MSTKMAD/battery-pack/02.HARDWARE/V2-ROVER R-1/04.PRODUCCION/SETI-BATCH-5_OCT2024/Release note Batch 5 Oct2024.docx

CAMBIOS EN LOS PCBs

DCDC

Se añaden las resistencias R21 y R22 que son las resistencias en serie para las líneas de SCLK Y SWDIO que en esta versión tienen función de comunicación con la máquina

Se añade C11 de 100nF en paralelo con la salida para tener un poco de capacidad de filtrado en alta frecuencia. El condensador entra perfectamente, por eso se incluye (no había ningún problema que solucionar).

U2 (driver MOSFET P de salida) se cambia por uno que tiene la misma capacidad que el anterior pero que en el evento de UVLO da un “1” en vez de un “0”, de forma que ya no tendremos el problema de que la salida se quede conectada cuando la batería se apaga.

CONECTORES

Se añaden las líneas de ID y DAT en la parte inferior de la placa.

Estas líneas están conectadas a SWDIO y SCLK (test points de la parte superior).

Se hace un cleanup general de la placa para quitar planos innecesarios.

Se eliminan (no entran) los pads suplentes de la salida que no se usaban

CPU

Se crean las líneas de comunicación DAT e ID con la máquina que se unen a las de SWCLK y SWDIO.

Se modifica el valor de R11 de 8k2 a 11k para bajar el umbral del LOW VOLTAGE de 3.1v a 2.4v.

Esta modificación se ha estado haciendo a mano en todas las placas durante la producción anterior.

El comparador prácticamente no se dispara nunca, pero al menos no da problemas.

Su uso queda un poco en entredicho ahora mismo pero lo mantenemos pq pensamos que “no molesta” y puede ser de ayuda.
