MSTKMAD/battery-pack/01.Documentation/01.Diseño/Documentacion Software/B2/Diagramas/B2/Troubleshotting Rover R-1.pdf

Contacto del Cliente

"Al dar salida, salta un error" | "No da salida" | "No se Enciende" | La tapa no cierra bien

"al dar salida, la bateria se reinicia"

Problemas

Fallo Mecanico

Cambio de la tapa por posible golpe o fallo de fabrica

Posibles: Conectores, Fallo Software, Watchdog Si no hay fallo por Undervoltage

Posible fallo Hardware: Faja Cables de Connectores

Mete la pila, hay carga de capacidad, pero no se enciende pulsando botones | Al meter la pila no se
| enciende la pantalla

Pedir Video

Fallo de Supervisor

Quitar supervisor de la placa CPU

Fallo relacionado
con la salida

Corriente o Potencia

UnderVoltage

Hay corto

Revisar cortocirucito
en el conector RCA

Todo Bien

Fallo detectado

Revisar la placa de conectores:
- Lineas de Vout+ y Vout-, por posible corto en la faja
- Comprobar que al cerrar el conector RCA no hace corto con los pines del transistor.
- Revisar ambos lados de la faja por fallos en el montaje.

Revisar DCDC:
- Posible fallo en el conector entre placas en la linea de sensado de corriente.

Alguna de las placas presenta problemas en el testeo

Todo parece
estar bien

Revisar las placas por separado en el

tester de placas

Solucionar el Error presente

Todo Bien

Todo bien

Encendar la salida y comprobar con el multimetro el RCA y las

lineas de la placa de conectores

Revision intensa
sin guia

Watchdog

Reprogramación | No | Si

Tiene Muelle?

Connectores Antiguos Planos

Poner Muelle

Posible fallo en
el Pin del cobre o
fallo en la faja.

No llega

Si llega

Abrir placa conectores. Meter pila Medir con el multimetro si la tension llega a la

placa de conectores

Fallo en el Pin

Cambiar Barril

Sin continuidad

Buena continuidad

Comprobar continuidad en la Faja

Fallo en la Faja

Cambiar Faja

Fallo en los testeos | Sin fallos en los testeos

Revisar las placas por separado en el

tester de placas

Solucionar el Error presente | Revision intensa sin guia
