MSTKMAD/battery-pack/01.Documentation/03. Produccion/RECONOCIMIENTO DE PRODUCCIONES HARDWARE DE FORMA VISUAL.docx

# RECONOCIMIENTO DE PRODUCCIONES HARDWARE DE FORMA VISUAL

## DCDC

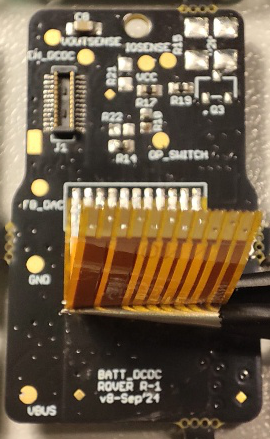
[picture p22: figure]
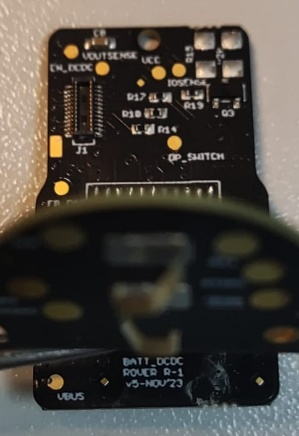
[picture p23: figure]
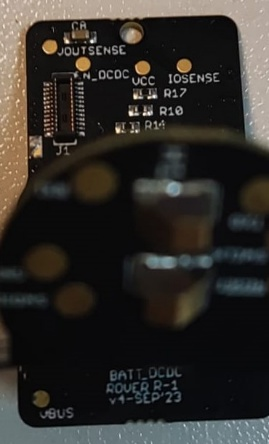
[picture p24: figure]
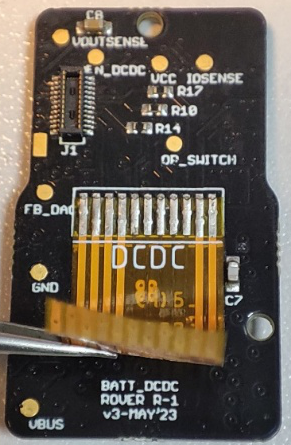
[picture p25: figure]
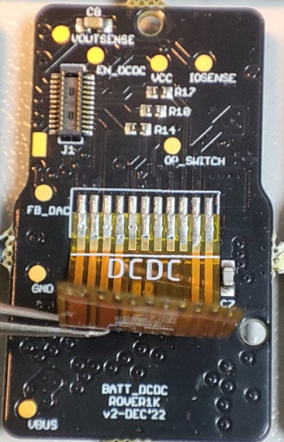
[picture p26: figure]

1. Comprobar serigrafia debajo de la faja:

PROD 1:

v2-DEC’22

PROD 2:

V3-MAY’23

PROD 3:

V4-SEP’23

PROD 4:

V5-NOV’23

PROD 5:

V8-Sep’24

## CPU

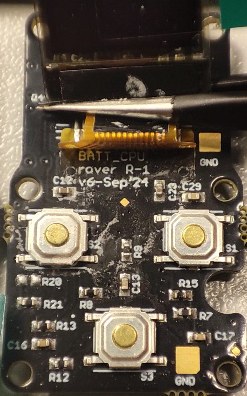
[picture p27: figure]
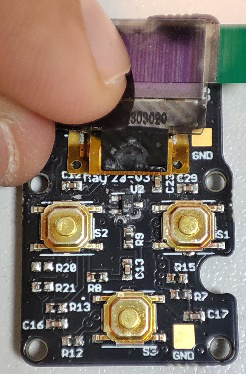
[picture p28: figure]
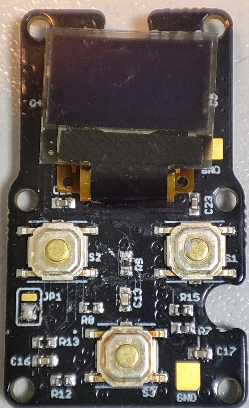
[picture p29: figure]

1. Mirar si tiene la serigrafia de v6-sep’24: a. Si tiene: Producción 5 V6-sep24 | 2. Mirar si tiene supervisor o no. a. Si tiene: Producción 2. May’23-v3 | 3. Si no tiene, Mirar si tiene SMD Superficial: a. Si tiene: Producción 1 Dec’22-v2

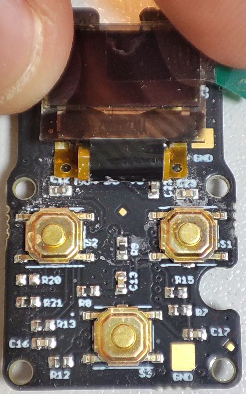
[picture p30: figure]
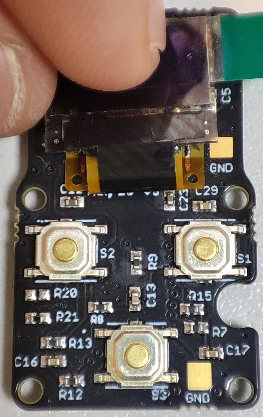
[picture p31: figure]

4. Si no tiene, mirar si tiene fiducidial rombo: Si tiene: Producción 4 Nov23-v5 | a. Si no tiene: Producción 3 May23-v3

# PRODUCCION 1

## DCDC

2º Serigrafia:

v2-DEC’22

1º Componente Q5:

3 patillas

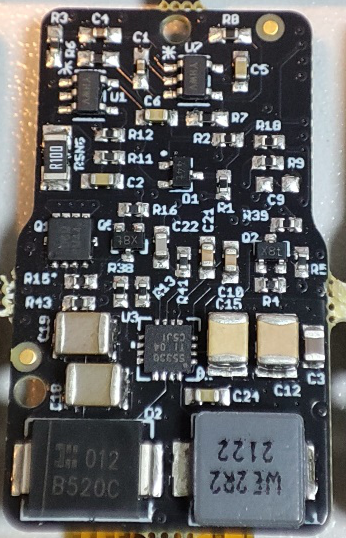
[picture p32: figure]
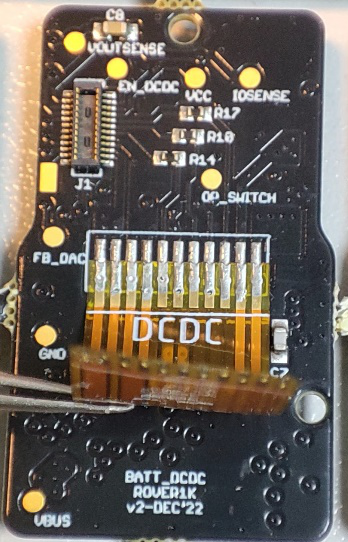
[picture p33: figure]

## CPU

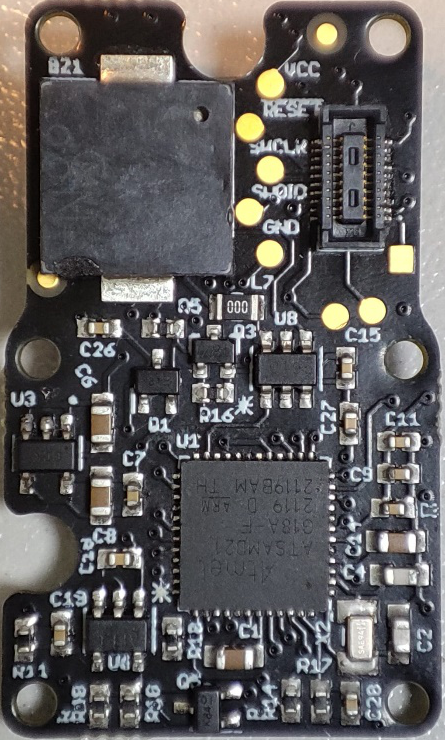
[picture p34: figure]
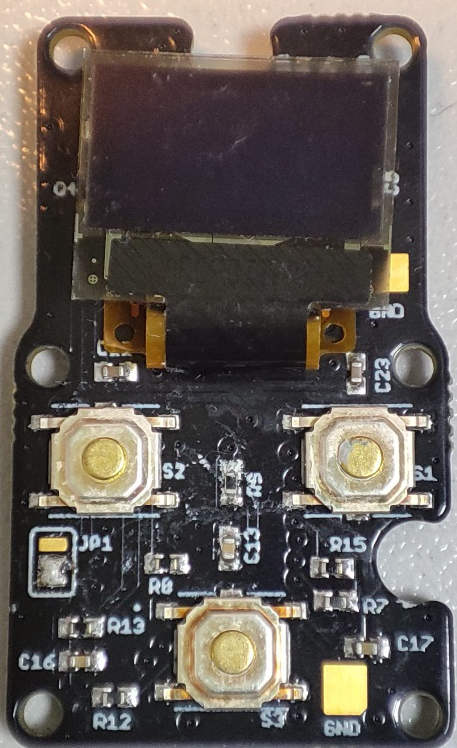
[picture p35: figure]

Ausencia de Jumper SMD

Q1 y Q3 vertical.

1º Jumpers SMD.

# PRODUCCION 2

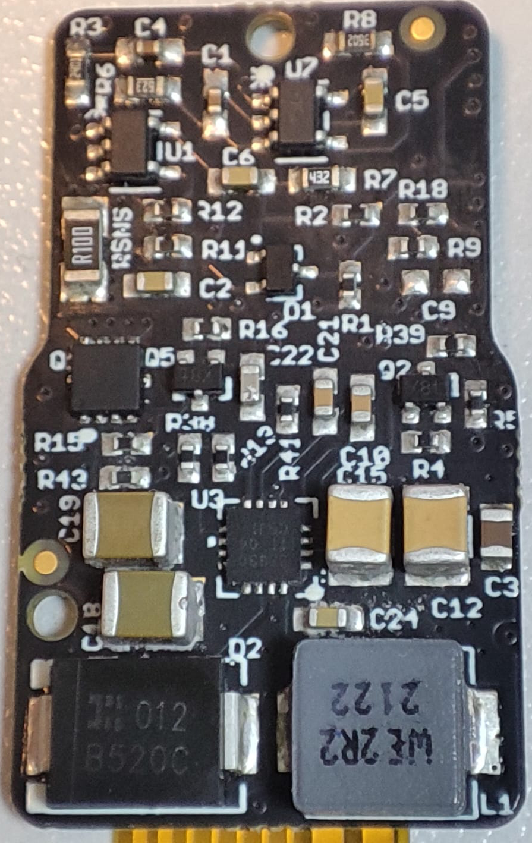
[picture p36: figure]
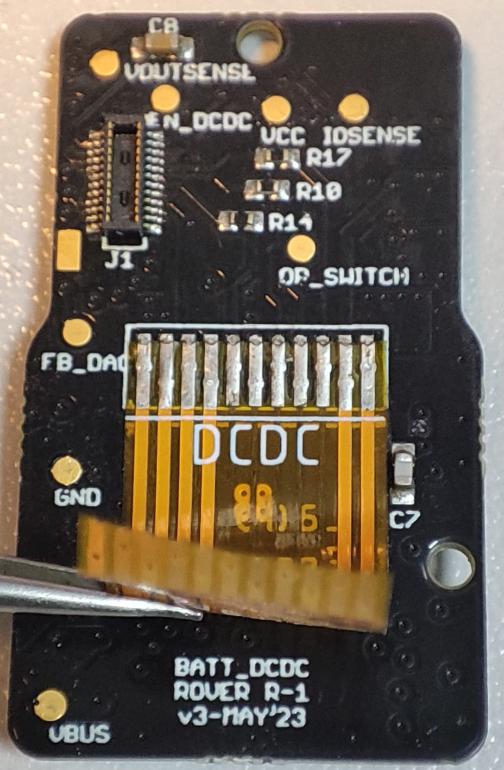
[picture p37: figure]

## DCDC

2º Serigrafia:

V3-MAY’23

1º Componente Q5:

3 patillas

## CPU

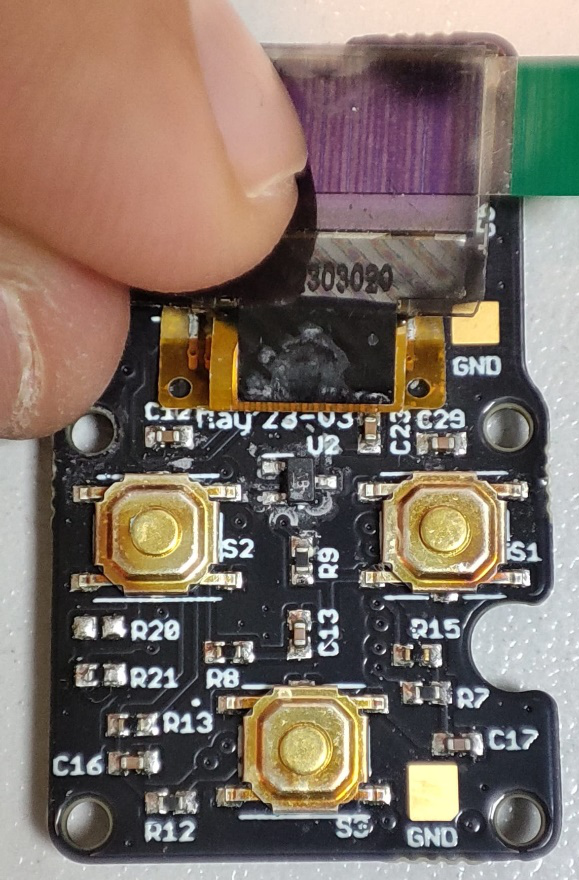
[picture p38: figure]
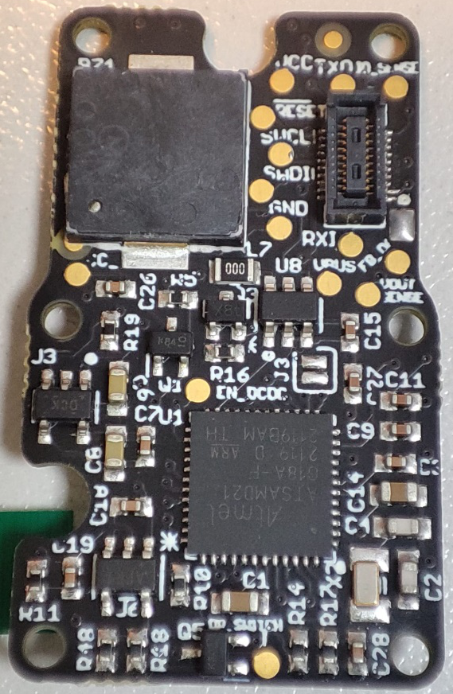
[picture p39: figure]

Supervisor

R20 y R21

Q1 y Q3 vertical.

JUMPER J3

# PRODUCCION 3

## DCDC

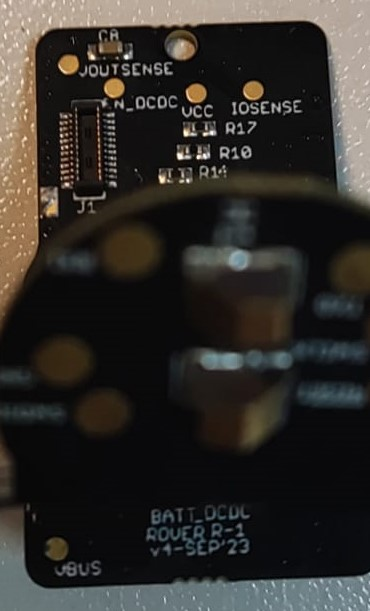
[picture p40: figure]
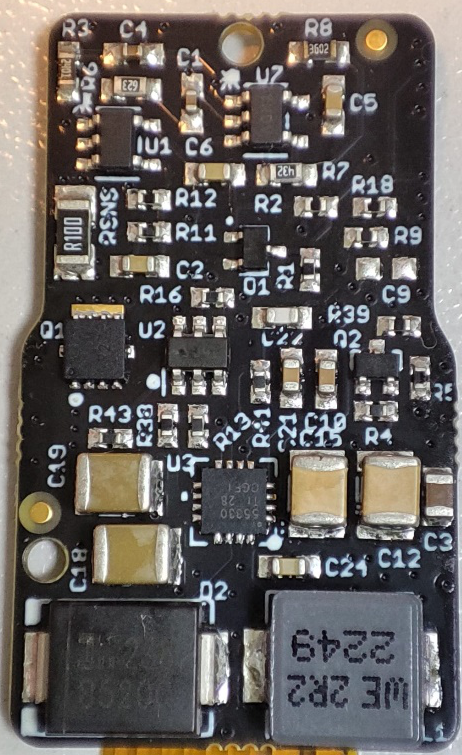
[picture p41: figure]

2º Serigrafia:

V4-SEP’23

1º Componente U2:

6 patillas

## CPU

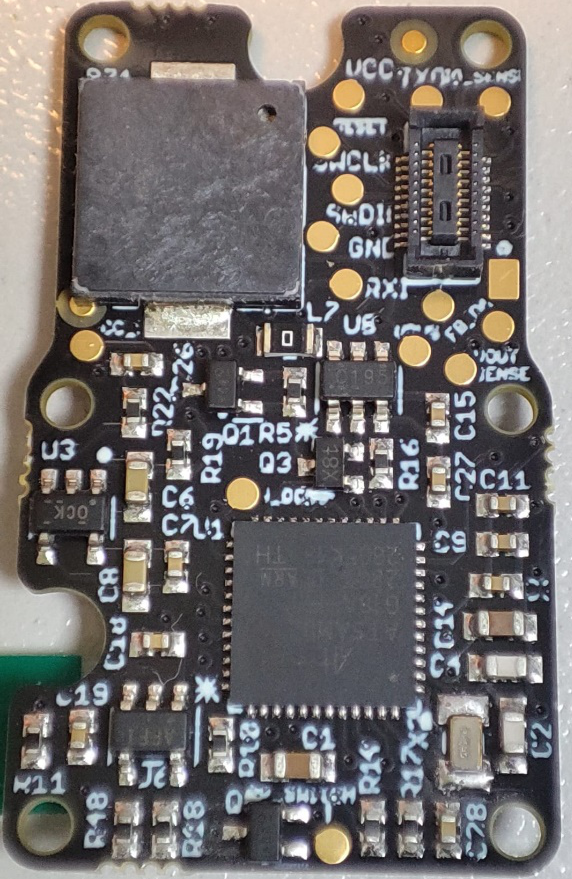
[picture p42: figure]
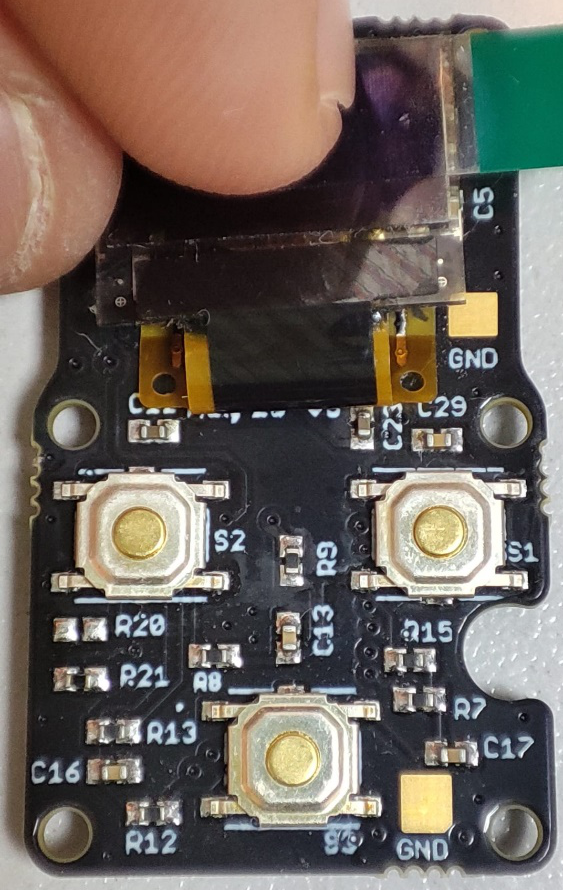
[picture p43: figure]

Q1 y Q3 Horizontal y Jumper J3 Ausente

Sin fiducial rombo

Ausencia de Supervisor

R20 y R21

# PRODUCCION 4

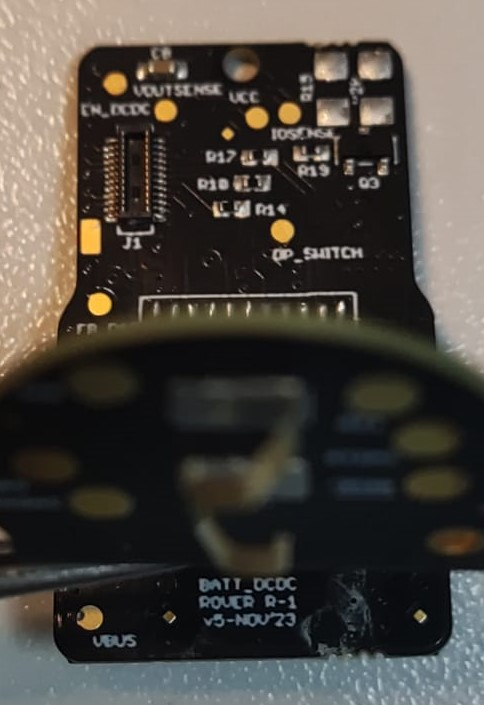
[picture p44: figure]
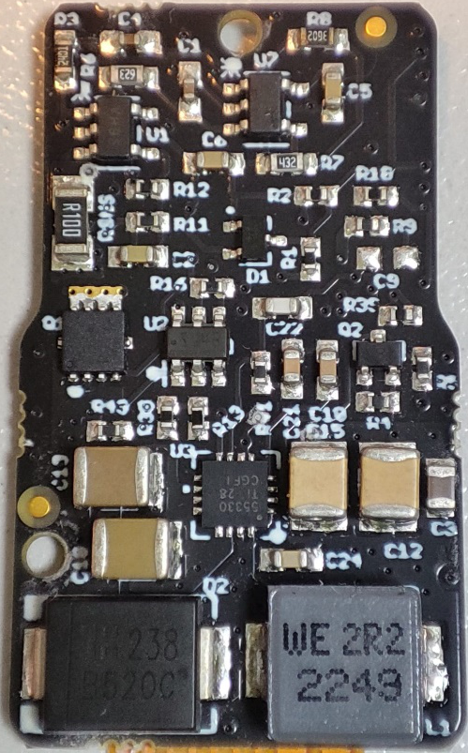
[picture p45: figure]

## DCDC

1º Resistencias R15 y R20 y Q3.

3º Serigrafia:

V5-NOV’23

2º Componente U2:

6 patillas

## CPU

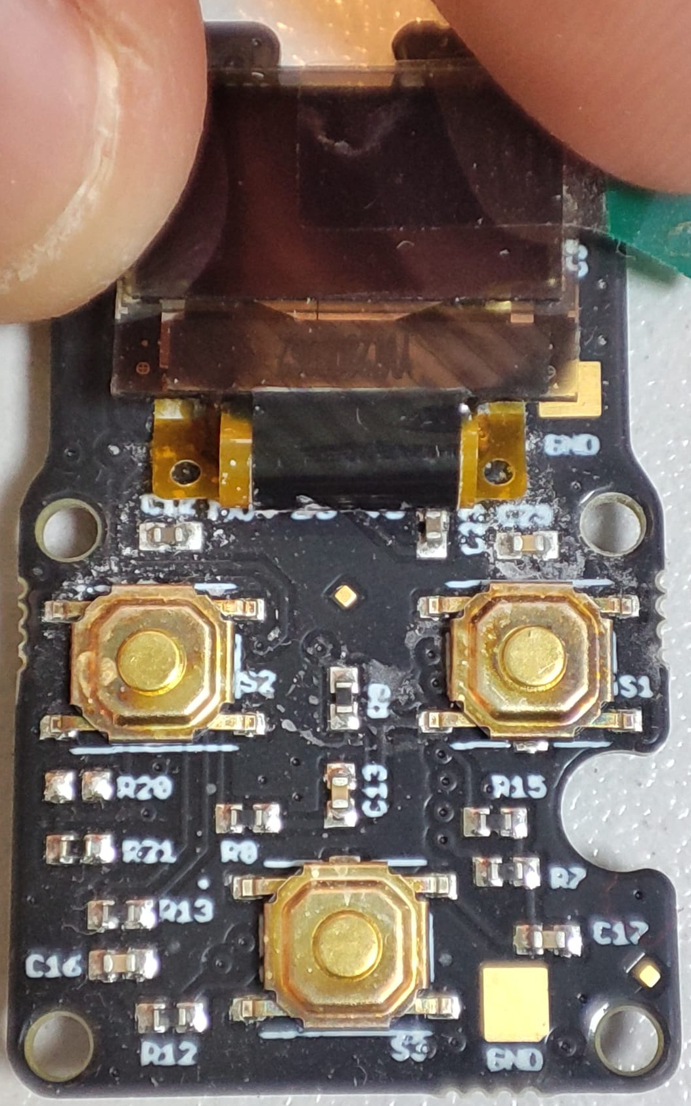
[picture p46: figure]
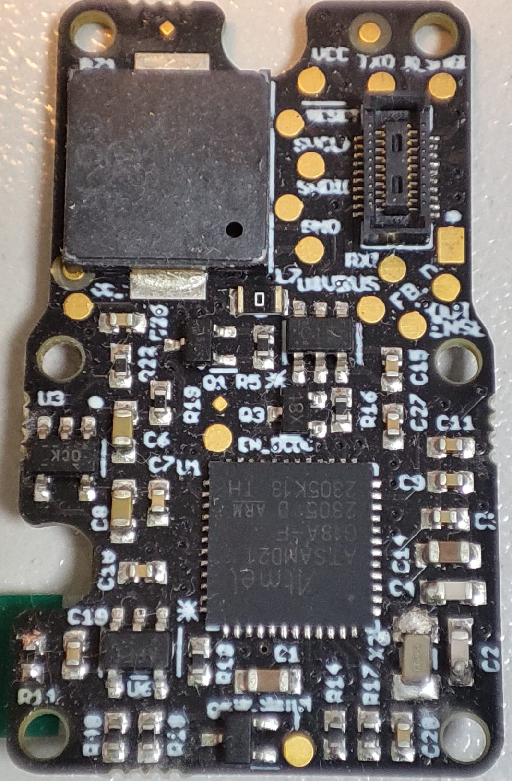
[picture p47: figure]

Q1 y Q3 Horizontal y Jumper J3 Ausente

CON fiducial rombo

Fiducial Rombo

R20 y R21

# PRODUCCION 4

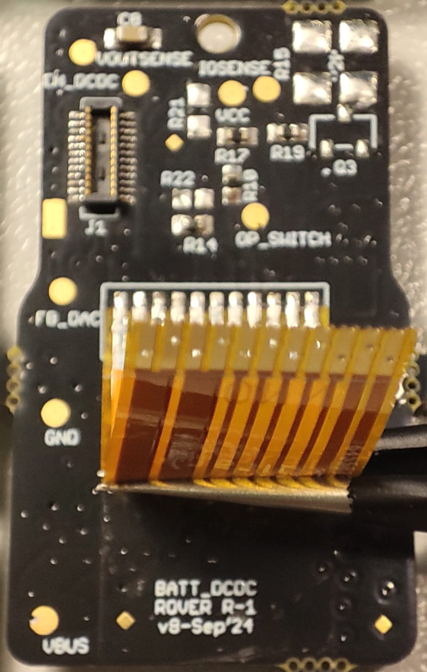
[picture p48: figure]
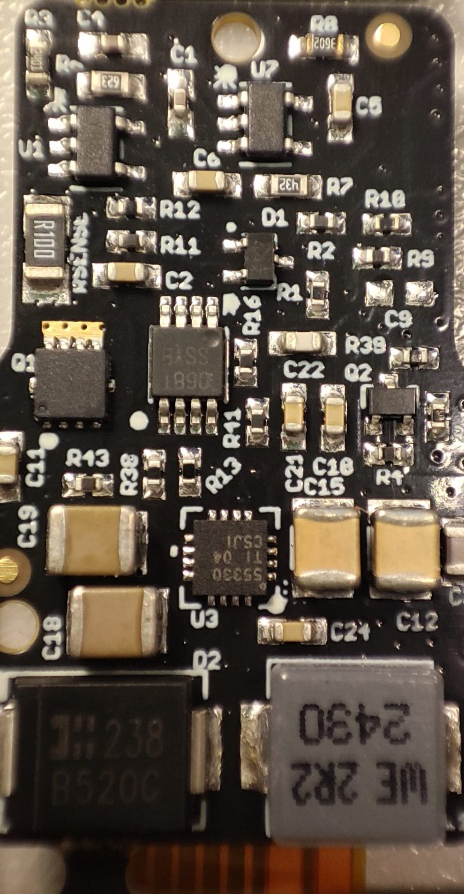
[picture p49: figure]

## DCDC

2º Nuevo componente

3º Serigrafia:

V8-Sep’24

1º Resistencias R21 y R22

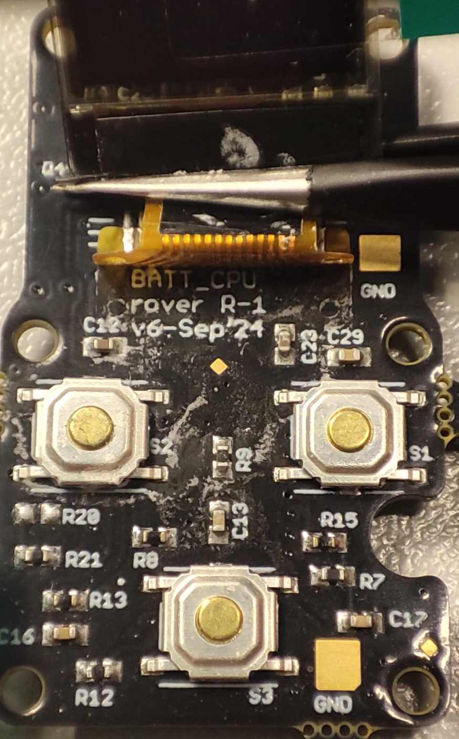
[picture p50: figure]

## CPU

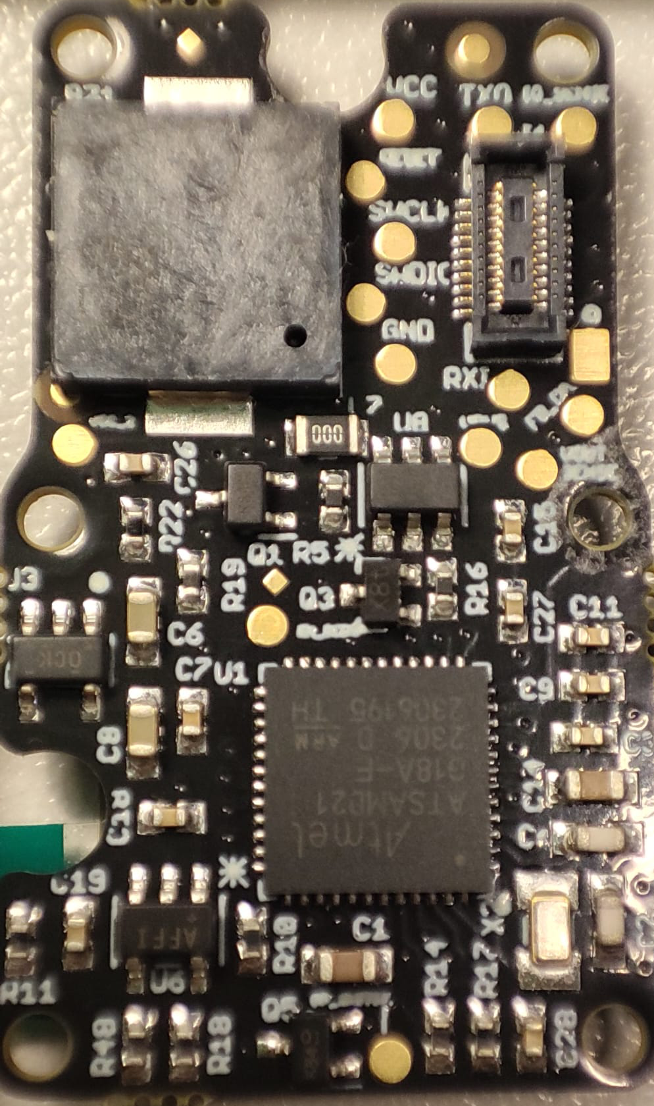
[picture p51: figure]

Serigrafia:

V6-Sep’24
