MSTKMAD/battery-pack/01.Documentation/03.Venus/PCB diana 3pin.pdf

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

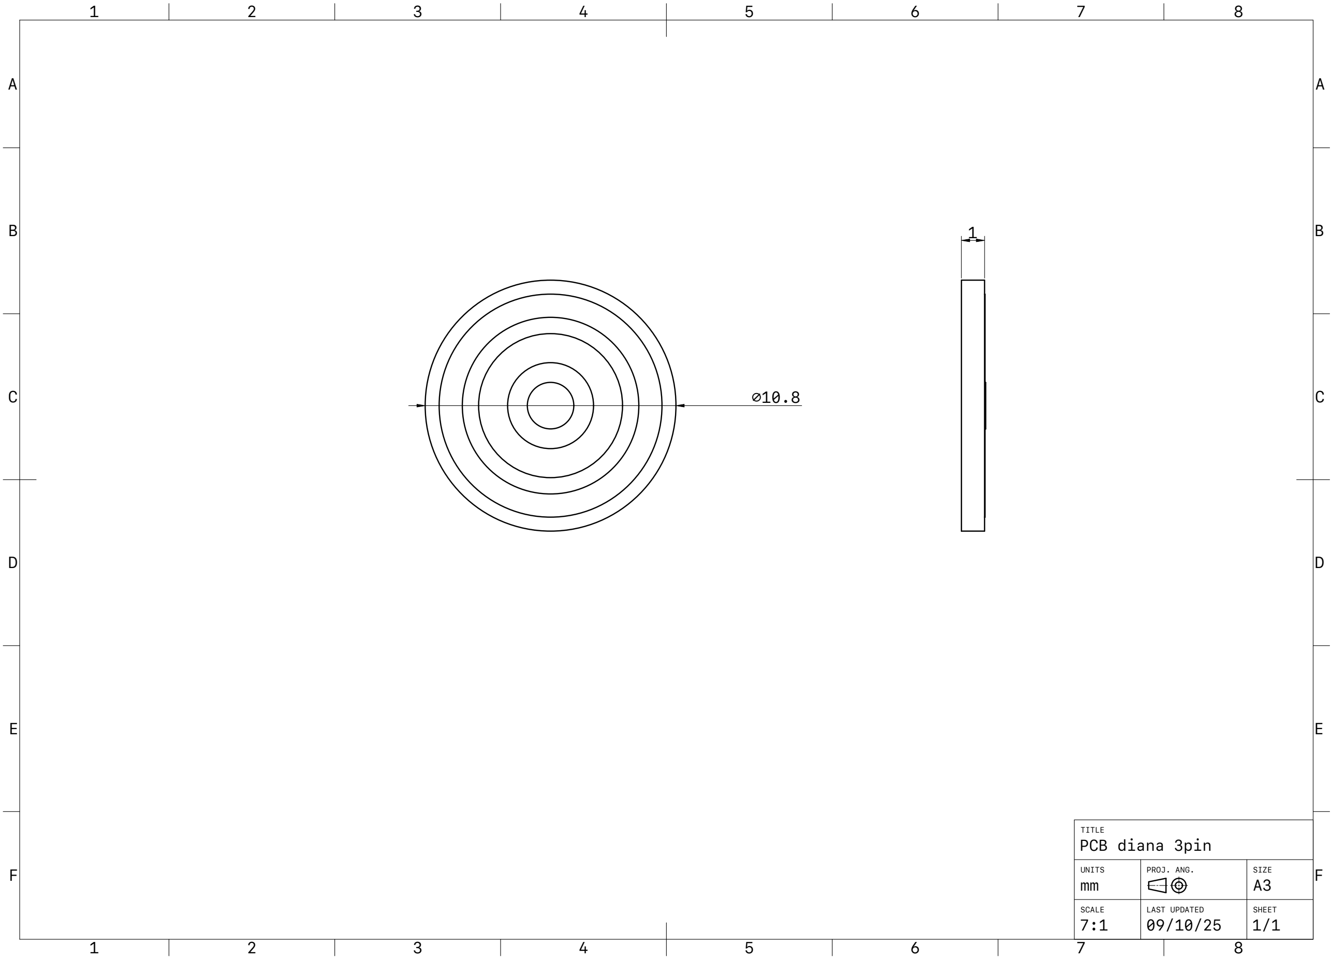
[picture p52: figure]
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
