MSTKMAD/battery-pack/01.Documentation/03. Produccion/Compatibilidad Producciones.pdf

Version | 1
Fecha | 08/02/2024
Modelo | Produccion 1 | Produccion 2 | Produccion 3 | Produccion 4
CPU | DCDC | CONECTORES | CPU | DCDC | CONECTORES | CPU | DCDC | CONECTORES | CPU | DCDC | CONECTORES

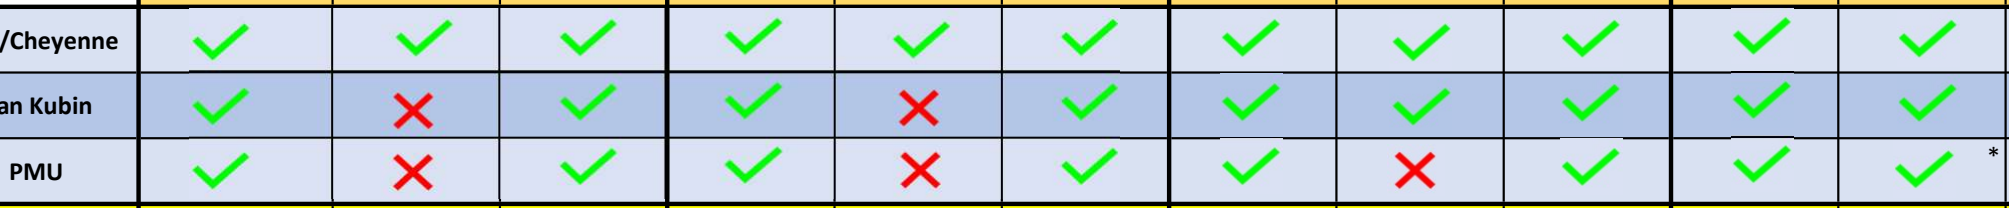
[picture p53: figure]
PMU

RCA/Cheyenne

Dan Kubin

Antes de Usar | - | - | - | Quitar Supervisor. R11 = 11k | - | - | R11 = 11k | | | R11 = 11k | * Res. Balastro R19,R20 = 20R
