MSTKMAD/battery-pack/01.Documentation/01.Diseño/DCDC Digital control DAC.xlsx

Sheet: Sheet1
r1 | 78000 | ohms
r2 | 8888 | ohms
vo | 12.01455356 | volts

Sheet: Sheet2
Vdac = (Vrer(1+(r1/R2))+Vref(R1/R3)-Vout))/R1/R3
 | OPCION 1 | OPCION 2 | OPCION 3
R1 | 27000 | 30000 | 20000
R2 | 7777 | 7500 | 3300
R3 | 4700 | 5600 | 4700
VREF | 1.229 | 1.229 | 1.229
VDAC | VOUT1 | VOUT2 | VOUT3
0 | 12.56 | 12.73 | 13.91 | 0
0.01 | 12.50 | 12.68 | 13.86
0.02 | 12.44 | 12.62 | 13.82
0.03 | 12.38 | 12.57 | 13.78
0.04 | 12.33 | 12.51 | 13.74
0.05 | 12.27 | 12.46 | 13.69
0.06 | 12.21 | 12.41 | 13.65
0.07 | 12.15 | 12.35 | 13.61 |  | POTENCIA MEDIA | 2 | W
0.08 | 12.10 | 12.30 | 13.57
0.09 | 12.04 | 12.25 | 13.52
0.1 | 11.98 | 12.19 | 13.48 |  | VOUT | RLOAD (Ohms)
0.11 | 11.92 | 12.14 | 13.44 |  | 5 | 12.5 | 5.5 | 12
0.12 | 11.87 | 12.09 | 13.40 |  | 6 | 18 | 6.5
0.13 | 11.81 | 12.03 | 13.35 |  | 7 | 24.5 | 7.5 | 25
0.14 | 11.75 | 11.98 | 13.31 |  | 8 | 32 | 8.5
0.15 | 11.69 | 11.93 | 13.27 |  | 9 | 40.5 | 9.5
0.16 | 11.64 | 11.87 | 13.23 |  | 10 | 50 | 10.5 | 50
0.17 | 11.58 | 11.82 | 13.18 |  | 11 | 60.5 | 11.5
0.18 | 11.52 | 11.76 | 13.14 |  | 12 | 72 | 12.5 | 75
0.19 | 11.46 | 11.71 | 13.10 |  | 13 | 84.5
0.2 | 11.41 | 11.66 | 13.06
0.21 | 11.35 | 11.60 | 13.01
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
