MSTKMAD/battery-pack/01.Documentation/01.Diseño/Tabla potencia-tiempo.xlsx

Sheet: Hoja1
 | Tamaño bateria | 750
 |  |  |  |  | Voltios
 |  |  |  |  | 5 | 6 | 7 | 8 | 9 | 10 | 11 | 12
Potencia |  |  | Puntos | 2 | 22.6 | 27.1 | 31.6 | 36.1 | 40.7 | 45.2 | 49.7 | 54.2
166 |  |  |  | 3 | 11.3 | 13.6 | 15.8 | 18.1 | 20.3 | 22.6 | 24.8 | 27.1
332 |  |  |  | 4 | 7.5 | 9.0 | 10.5 | 12.0 | 13.6 | 15.1 | 16.6 | 18.1
498 |  |  |  | 5 | 5.6 | 6.8 | 7.9 | 9.0 | 10.2 | 11.3 | 12.4 | 13.6
664 |  |  |  | 6 | 4.5 | 5.4 | 6.3 | 7.2 | 8.1 | 9.0 | 9.9 | 10.8
830 |  |  |  | 7 | 3.8 | 4.5 | 5.3 | 6.0 | 6.8 | 7.5 | 8.3 | 9.0
996 |  |  |  | 8 | 3.2 | 3.9 | 4.5 | 5.2 | 5.8 | 6.5 | 7.1 | 7.7
1162 |  |  |  | 9 | 2.8 | 3.4 | 4.0 | 4.5 | 5.1 | 5.6 | 6.2 | 6.8
1328 |  |  |  | 10 | 2.5 | 3.0 | 3.5 | 4.0 | 4.5 | 5.0 | 5.5 | 6.0
1494 |  |  |  | 11 | 2.3 | 2.7 | 3.2 | 3.6 | 4.1 | 4.5 | 5.0 | 5.4
1660 |  |  |  | 12 | 2.1 | 2.5 | 2.9 | 3.3 | 3.7 | 4.1 | 4.5 | 4.9
1826 |  |  |  | 13 | 1.9 | 2.3 | 2.6 | 3.0 | 3.4 | 3.8 | 4.1 | 4.5
1992 |  |  |  | 14 | 1.7 | 2.1 | 2.4 | 2.8 | 3.1 | 3.5 | 3.8 | 4.2
2158 |  |  |  | 15 | 1.6 | 1.9 | 2.3 | 2.6 | 2.9 | 3.2 | 3.5 | 3.9
2324 |  |  |  | 16 | 1.5 | 1.8 | 2.1 | 2.4 | 2.7 | 3.0 | 3.3 | 3.6
2490
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
