MSTKMAD/battery-pack/02.Hardware/V1-ROVER-2K/Cystals Oscillators Comparrations.xlsx

 | Device | Link
Pricipal | ECS-.327-12.5-12RR-TR | https://www.mouser.es/ProductDetail/ECS/ECS-327-125-12RR-TR?qs=9r4v7xj2Lnlp2XtvX%2FZgxw%3D%3D
Compatibles | ECS-.327-12.5-34R-TR | https://www.mouser.es/ProductDetail/ECS/ECS-327-125-34R-TR?qs=ROqe5v2kY6q0wRLiiEDEFg%3D%3D
 | ABS07L-32.768KHZ-T | https://www.digikey.es/product-detail/en/abracon-llc/ABS07L-32-768KHZ-T/535-12058-1-ND/3915230
 | ECS-.327-12.5-34R-C-TR | https://www.mouser.es/ProductDetail/ECS/ECS-327-125-34R-C-TR?qs=wYonFgBYHKkYEyAmetYxSA%3D%3D
 | ECS-.327-12.5-34RR-TR | https://www.mouser.es/ProductDetail/ECS/ECS-327-125-34RR-TR?qs=Mv7BduZupUjGc44CjLqHeQ%3D%3D
 | FC-135R 32.7680KF-A3 | https://www.mouser.es/ProductDetail/Epson-Timing/FC-135R-327680KF-A3?qs=%252B6g0mu59x7Ikj2WJHJ1dXg%3D%3D
 | FC-135R 32.7680KA-A3 | https://www.mouser.es/ProductDetail/Epson-Timing/FC-135R-327680KA-A3?qs=f9yNj16SXrIR19rZDPQCyw%3D%3D
 | FC-135R 32.7680KA-A5 | https://www.mouser.es/ProductDetail/Epson-Timing/FC-135R-327680KA-A5?qs=f9yNj16SXrIpmTWWgmodkw%3D%3D
 | FC-135R 32.7680KA-A | https://www.mouser.es/ProductDetail/Epson-Timing/FC-135R-327680KA-A?qs=f9yNj16SXrLC%2F%2FIy7zu66w%3D%3D
 | FC-135R 32.7680KA-A0 | https://www.mouser.es/ProductDetail/Epson-Timing/FC-135R-327680KA-A0?qs=f9yNj16SXrJRNSRyvSQAPQ%3D%3D
 | FC-135R 32.7680KA-AX | https://www.mouser.es/ProductDetail/Epson-Timing/FC-135R-327680KA-AX?qs=%252B6g0mu59x7KaFx%252BBZAnR4Q%3D%3D
 | FC-135R 32.7680KF-AX | https://www.mouser.es/ProductDetail/Epson-Timing/FC-135R-327680KF-AX?qs=%252B6g0mu59x7I1sVcj4Bjehg%3D%3D
 | FC-135R 32.7680KF-A0 | https://www.mouser.es/ProductDetail/Epson-Timing/FC-135R-327680KF-A0?qs=%252B6g0mu59x7JxJHKsPrDQmQ%3D%3D
