MSTKMAD/battery-pack/02.HARDWARE/V3-Rover Venus/01-PCB/CRADLE/Cradle v1/cradle_venus.pdf

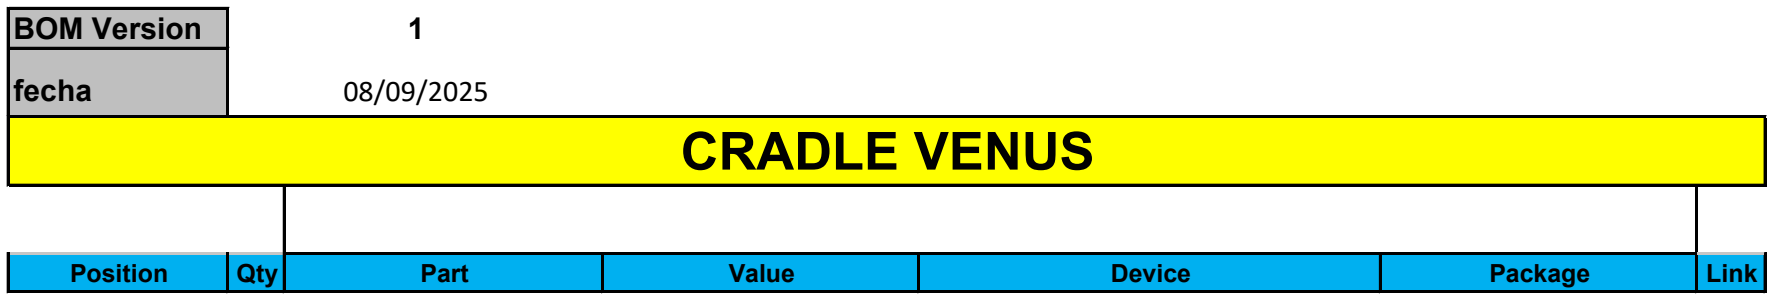
[picture p54: figure]
BOM Version; fecha; CRADLE VENUS

Position | Qty | Part | Value | Device | Package | Link
1 2 C1, C2 | 4.7u | C-EUC0805 | CAP-0805
2 3 C3, C4, C5 | 100n | C-EUC0805 | CAP-0805
3 1 C56 | 1uF 50V X7R | CAP0805 | CAP-0805
4 1 C57 | 100n 50v X7R/X5R | CAP0805 | CAP-0805
5 1 C6 | 47uF 6.3V | 4.7UF-6.3V-10%(0603)0603 | CAP-0603
6 1 C7 | 2.2u | 4.7UF-6.3V-10%(0603)0603 | CAP-0603
7 1 D1 | SMAJ24A | 3SMAJ5934B | DIOM4325X244N
| 8 1 IC1 | | MCP73831T-2ACI_OT | MCP73831T-2ACI_OT | SOT95P270X145-5N
9 6 IC2, IC4, IC5, IC6, IC7, IC8 WS2812B | WS2812B | WS2812B
| 10 1 IC3 | | ATTINY1616-SNR | ATTINY1616-SNR | SOIC127P1030X265-20N
| 11 1 J1 | | DX07S016JA1R1500 | DX07S016JA1R1500 | JAE_DX07S016JA1R1500
12 1 JP1 | JUMPER-SMT_3_NO_SILK JUMPER-SMT_3_NO_SILK | SMT-JUMPER_3_NO_SILK
13 1 Q5 | DMG3415U-7 | SSM3J338R,LF | SSM3J332RLFT
14 1 Q6 | 2N7002PW | MOSFET-NCHANNEL2N7002PW | SOT323
15 2 R1, R2 | 10K | RESISTOR0805 | CAP-0805
16 1 R18 | 100k | RESISTOR0805 | CAP-0805
17 1 R20 | 100R | RESISTOR0805 | CAP-0805
18 1 R21 | 100K | RESISTOR0805 | CAP-0805
19 2 R55, R56 | 5K1 | RESISTOR0805 | CAP-0805
20 1 U7 | AP2205-33W5-7 | AP2205-W5-7 | SOT95P282X145-5N
