MSTKMAD/battery-pack/04.MECHANICS/01.ROVER1K-MECH/VERSIONES/V3/faja12.pdf

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

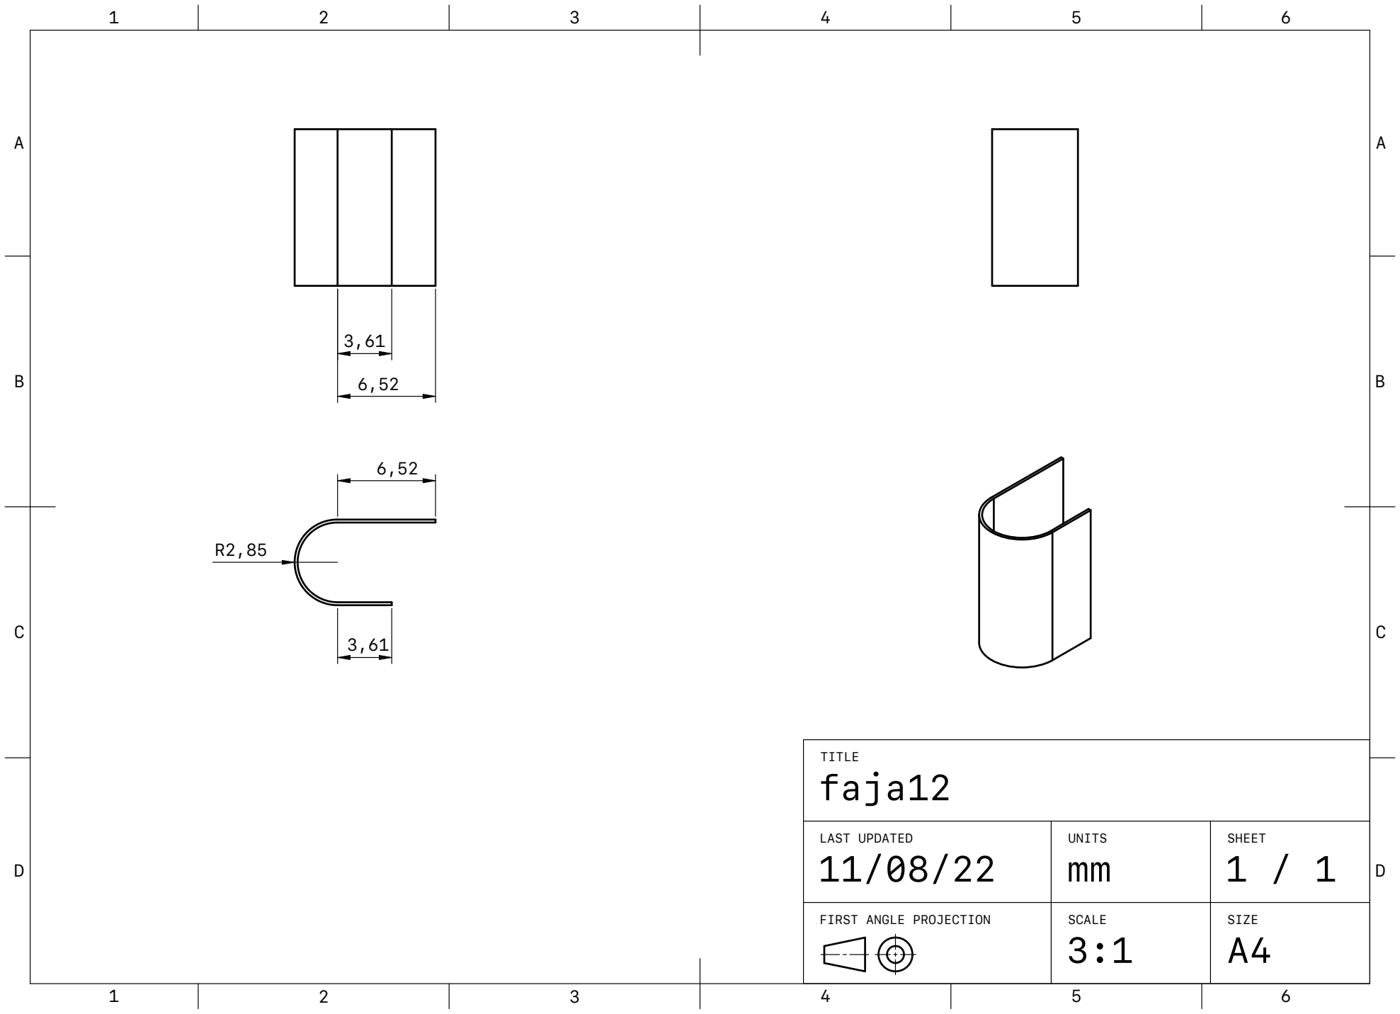
[picture p55: figure]
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
