MSTKMAD/battery-pack/01.Documentation/01.Diseño/Documentacion Software/B1/Diagrams/Battery/Diagrama de Contexto-Page-3.png

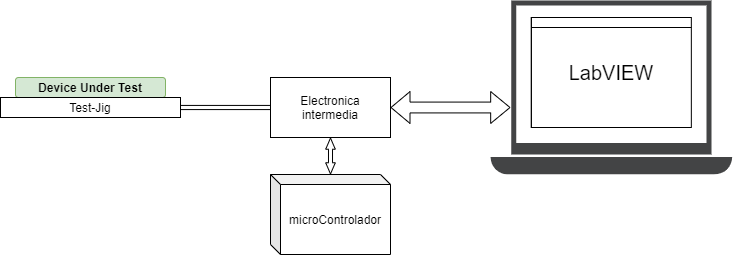
01.Documentation/01.Diseño/Documentacion Software/B1/Diagrams/Battery/Diagrama de Contexto-Page-3.png
