MSTKMAD/battery-pack/01.Documentation/01.Diseño/Documentacion Software/B1/Diagrams/Battery/Display/DisplayCap.png

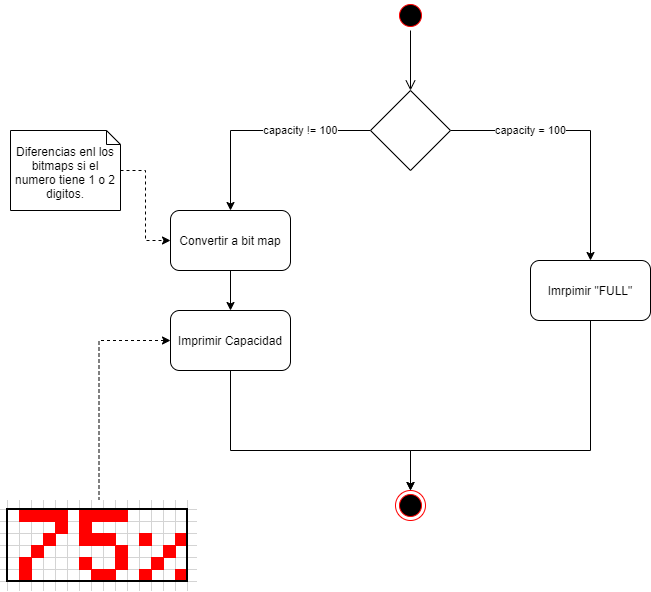
01.Documentation/01.Diseño/Documentacion Software/B1/Diagrams/Battery/Display/DisplayCap.png
