MSTKMAD/battery-pack/01.Documentation/01.Diseño/Documentacion Software/B1/Diagrams/Battery/Dpad images/Dpad.jpg

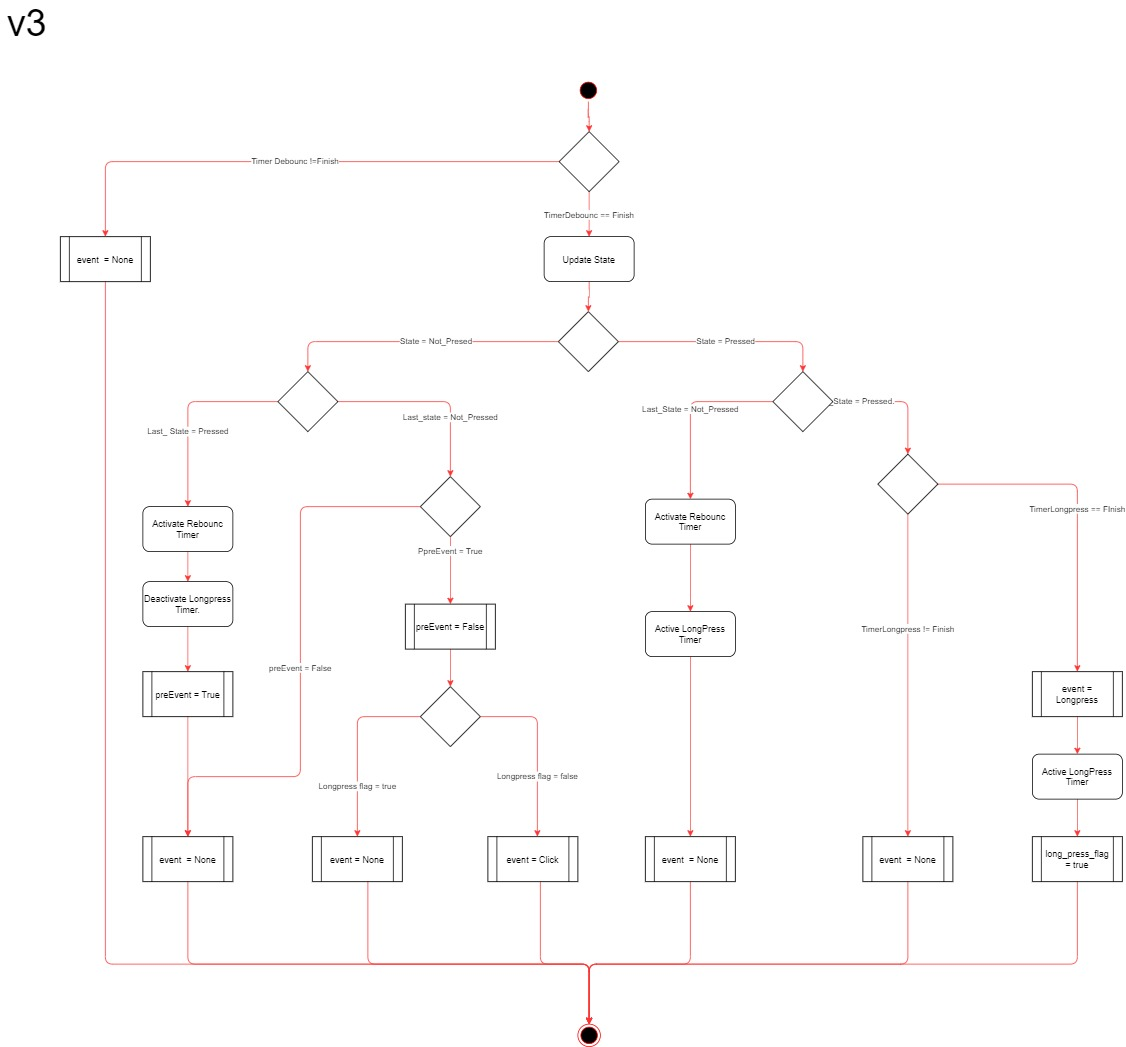
01.Documentation/01.Diseño/Documentacion Software/B1/Diagrams/Battery/Dpad images/Dpad.jpg
