MSTKMAD/battery-pack/01.Documentation/01.Diseño/Documentacion Software/B1/Diagrams/Battery/Dpad images/Dpad.png

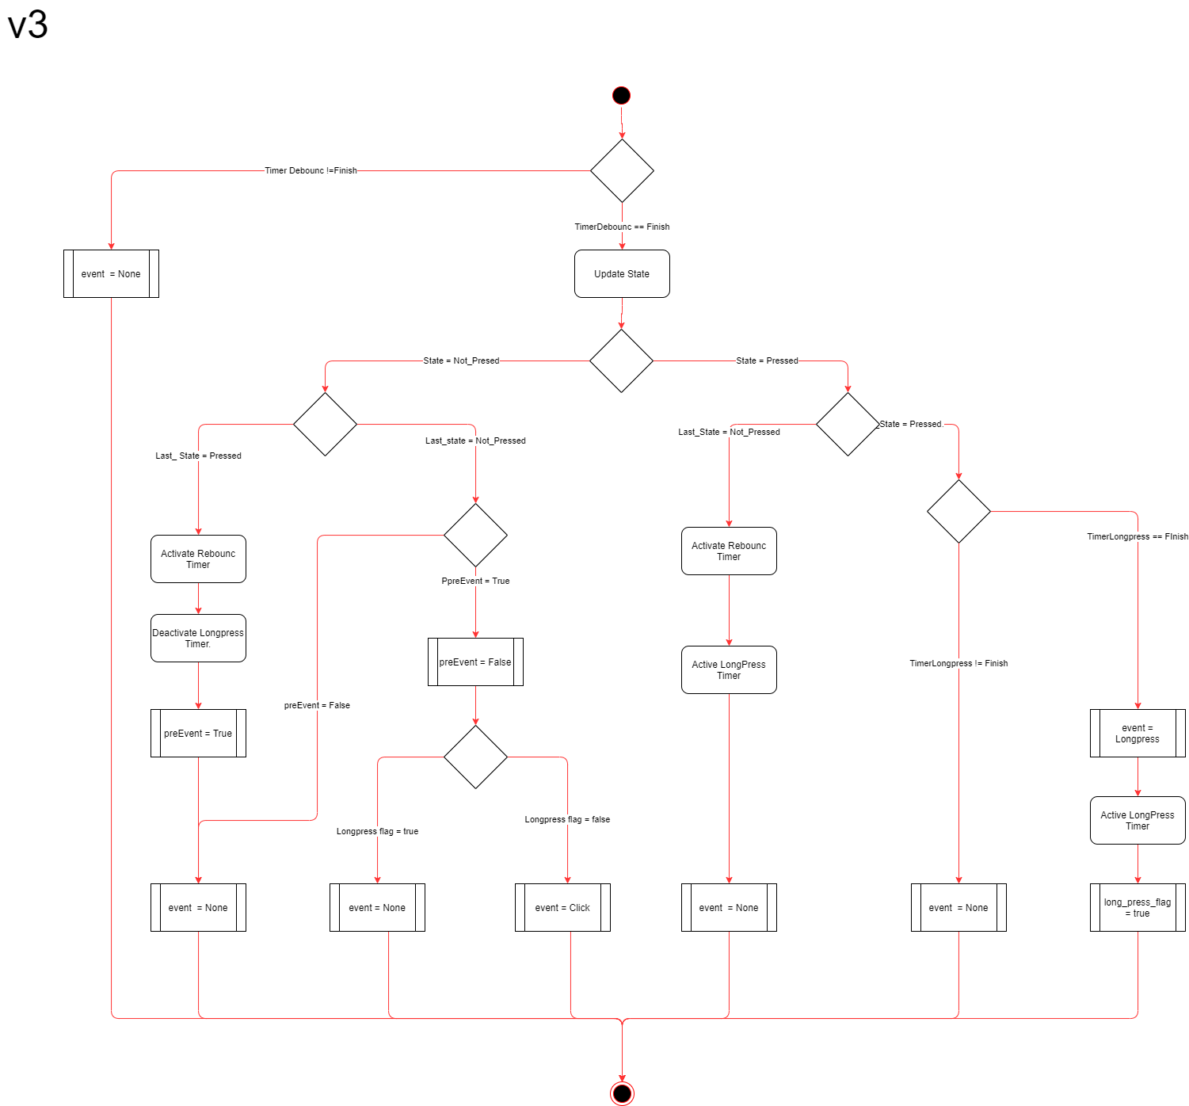
01.Documentation/01.Diseño/Documentacion Software/B1/Diagrams/Battery/Dpad images/Dpad.png
