MSTKMAD/battery-pack/01.Documentation/01.Diseño/Documentacion Software/B1/Diagrams/Battery/Integrations/B1-V15/B1-V15-BoostMonitor.jpg

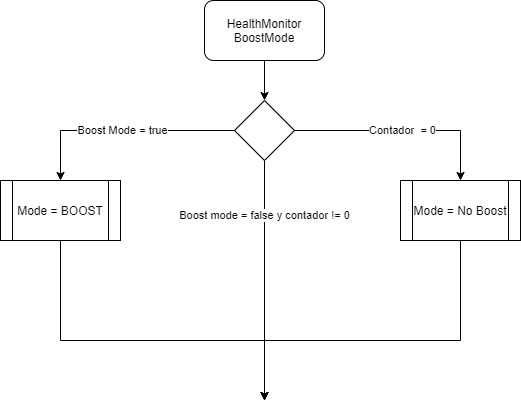
01.Documentation/01.Diseño/Documentacion Software/B1/Diagrams/Battery/Integrations/B1-V15/B1-V15-BoostMonitor.jpg
