MSTKMAD/battery-pack/01.Documentation/01.Diseño/Documentacion Software/B1/Resources/Imagenes/WhatsApp Image 2022-01-12 at 13.49.11.jpeg

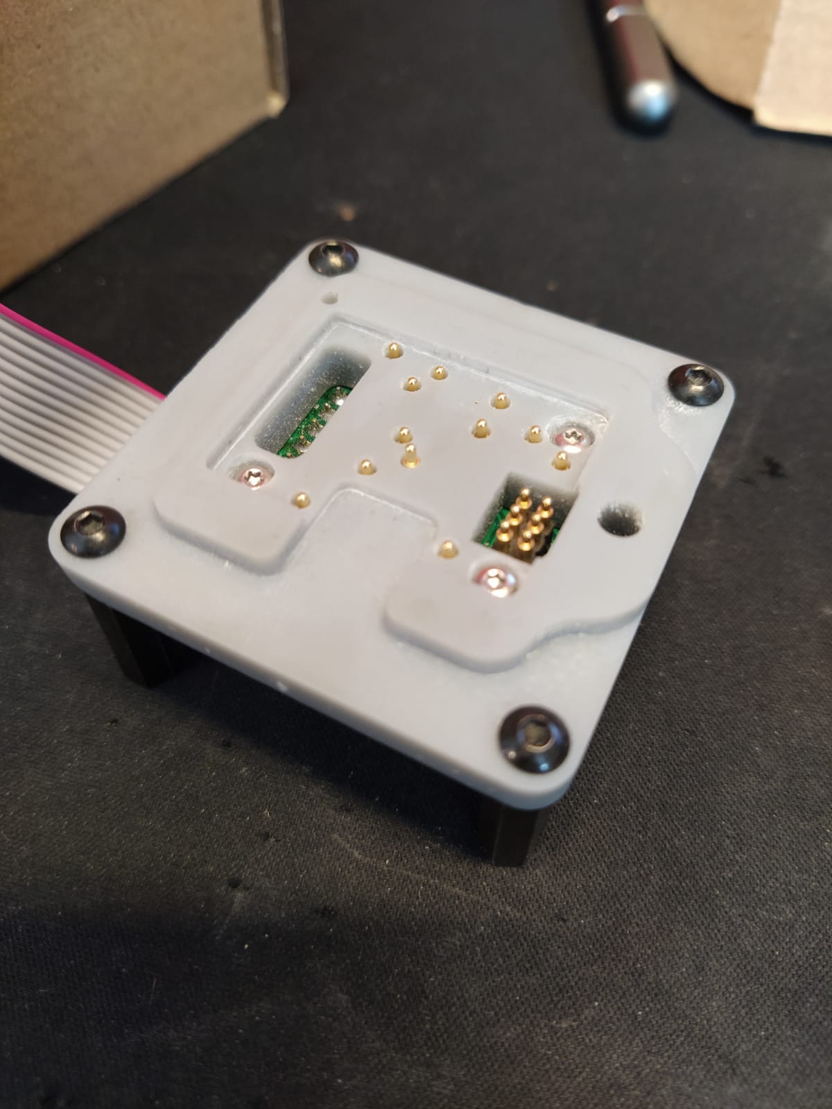
01.Documentation/01.Diseño/Documentacion Software/B1/Resources/Imagenes/WhatsApp Image 2022-01-12 at 13.49.11.jpeg
