MSTKMAD/battery-pack/01.Documentation/02.Averias/2023-Junio Trendy/Percetn Use.png

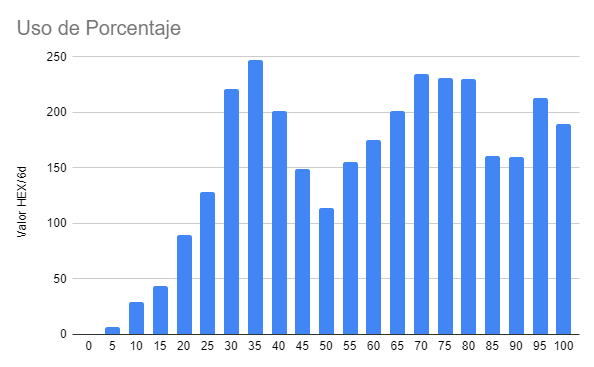
01.Documentation/02.Averias/2023-Junio Trendy/Percetn Use.png
