MSTKMAD/battery-pack/01.Documentation/03.Venus/adafruit_products_QTPy_sch.png

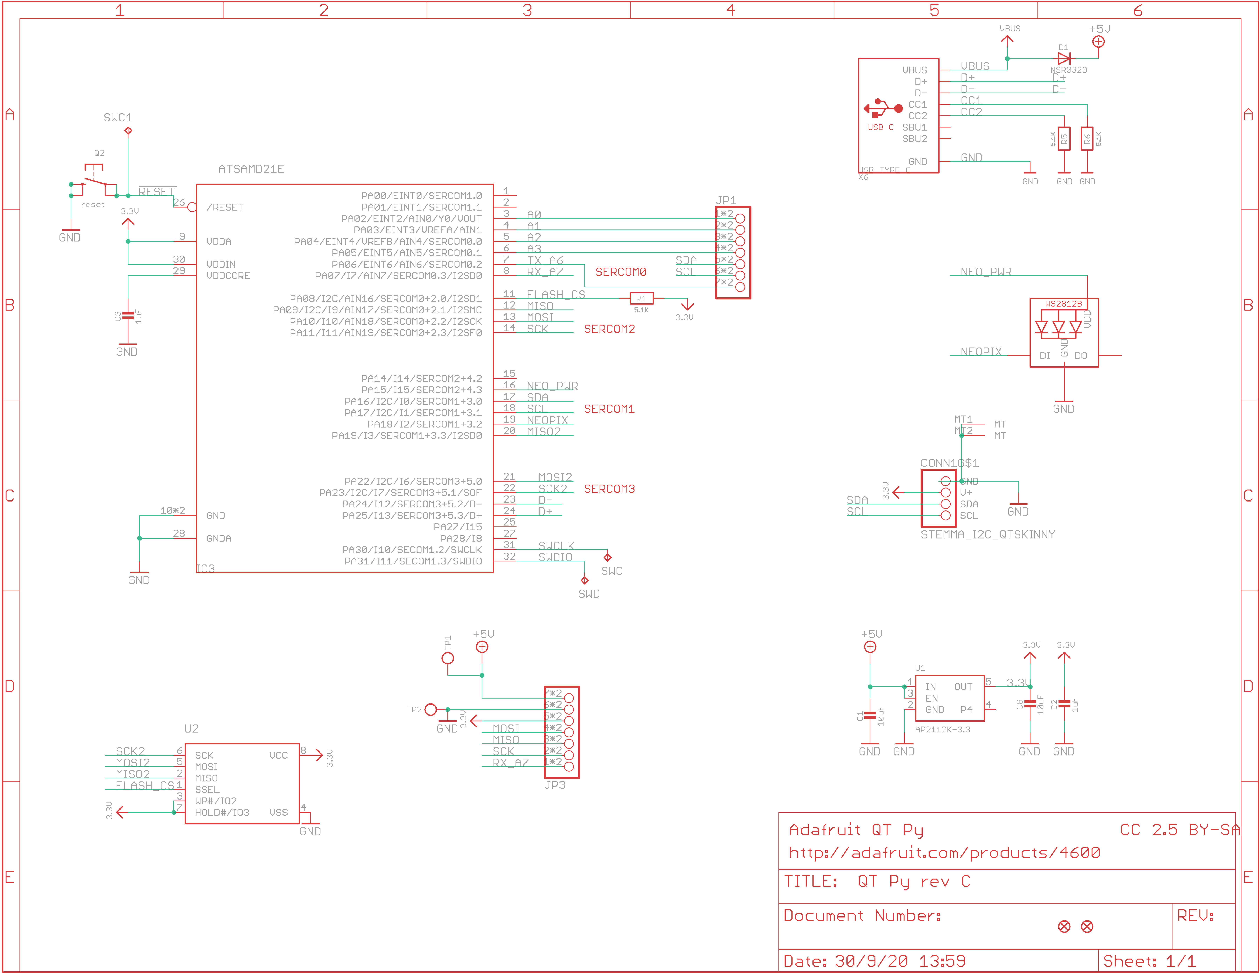
01.Documentation/03.Venus/adafruit_products_QTPy_sch.png
