MSTKMAD/battery-pack/01.Documentation/03.Venus/FB32989F000B773208DCBF2DFA11AB42.jpg

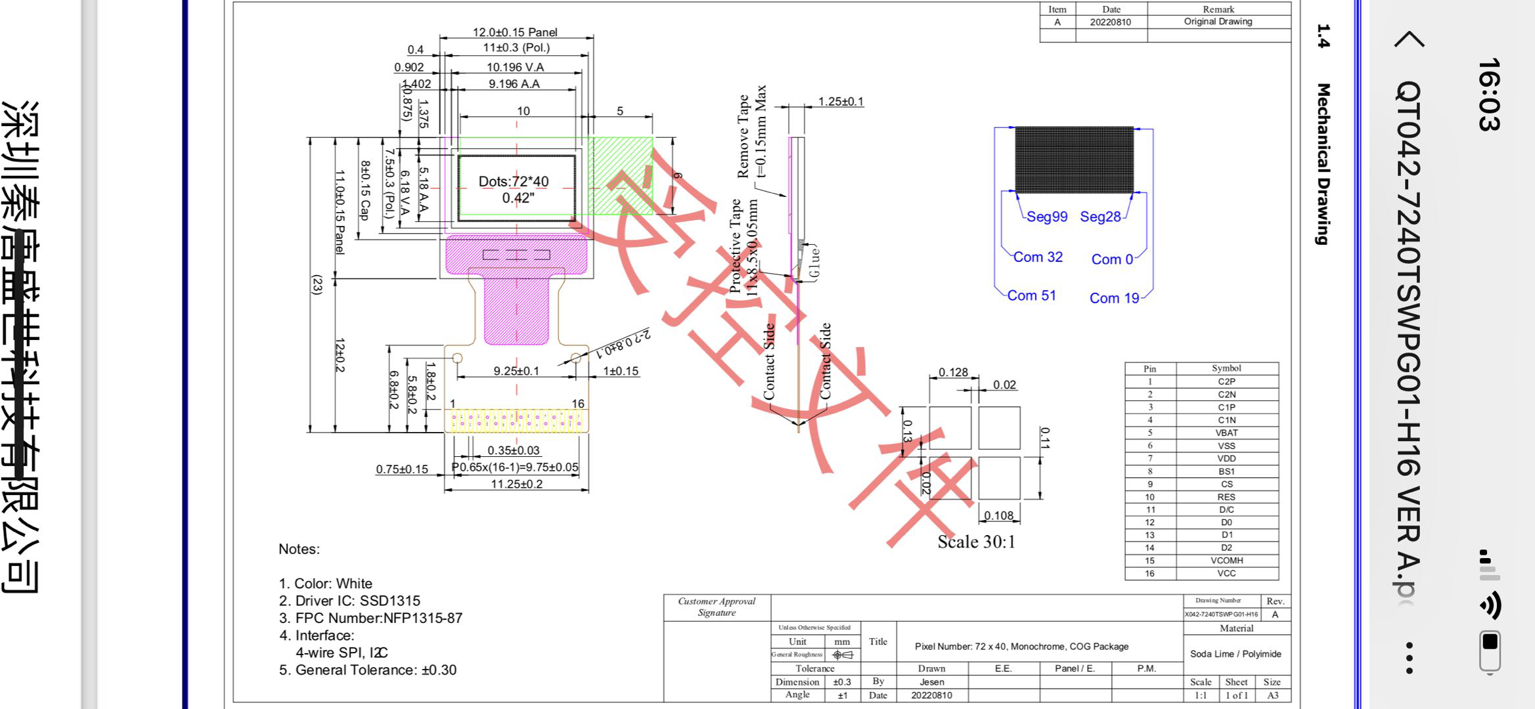
01.Documentation/03.Venus/FB32989F000B773208DCBF2DFA11AB42.jpg
