MSTKMAD/battery-pack/01.Documentation/03.Venus/SAMD21E_DevBoard_sch.png

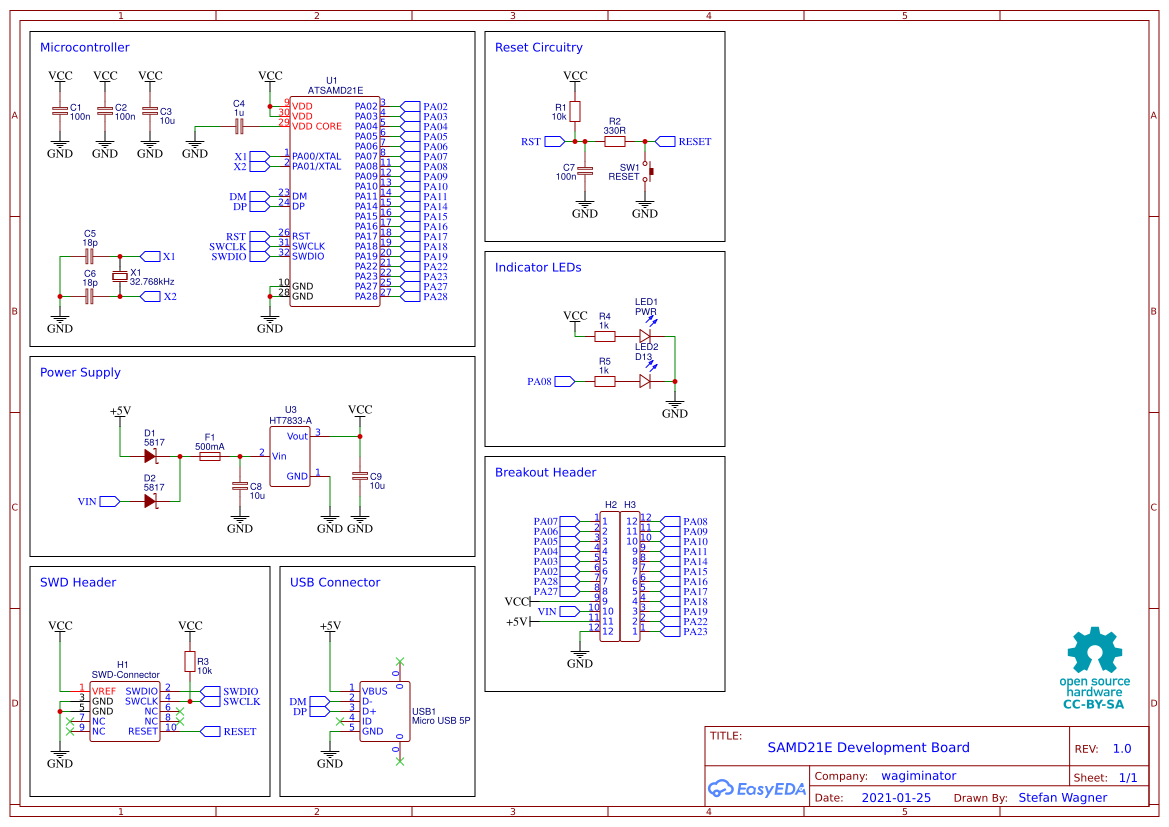
01.Documentation/03.Venus/SAMD21E_DevBoard_sch.png
