MSTKMAD/battery-pack/02.HARDWARE/V2-ROVER R-1/01.PCB/BATT_CPU/BATT_CPU.png

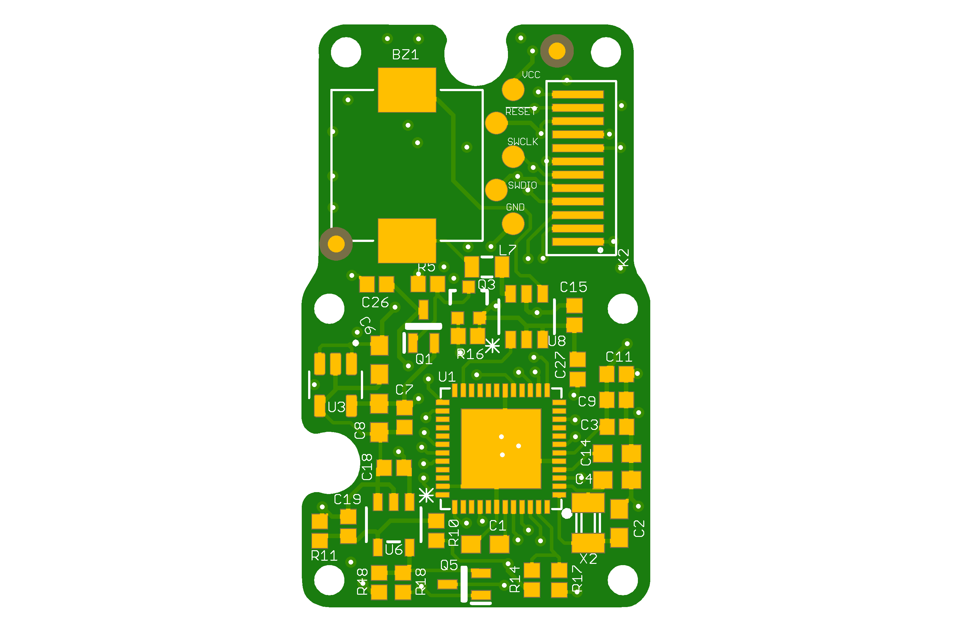
02.HARDWARE/V2-ROVER R-1/01.PCB/BATT_CPU/BATT_CPU.png
