MSTKMAD/battery-pack/02.HARDWARE/V2-ROVER R-1/01.PCB/BATT_DCDC/BATT_DCDC.png

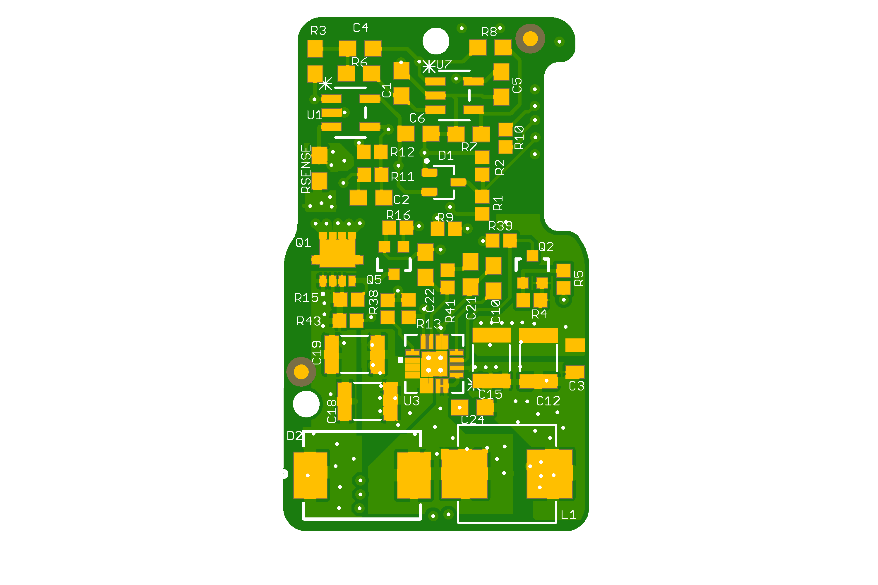
02.HARDWARE/V2-ROVER R-1/01.PCB/BATT_DCDC/BATT_DCDC.png
