MSTKMAD/battery-pack/02.HARDWARE/V2-ROVER R-1/01.PCB/BATT_FLEX8/BATT_FLEX8.png

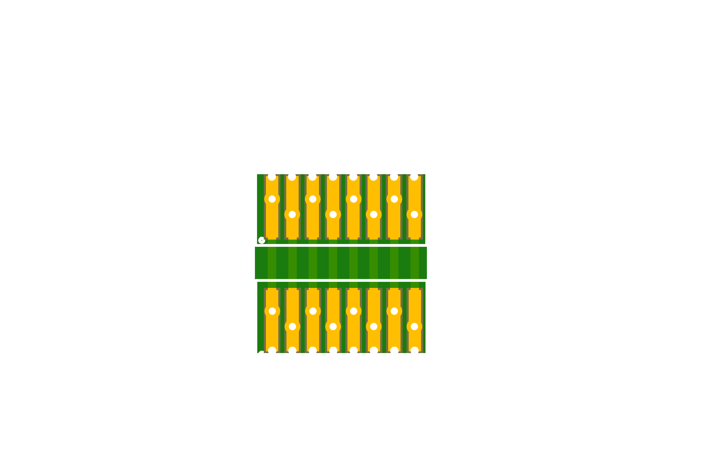
02.HARDWARE/V2-ROVER R-1/01.PCB/BATT_FLEX8/BATT_FLEX8.png
