MSTKMAD/battery-pack/02.HARDWARE/V2-ROVER R-1/01.PCB/BATT_FLEX12/BATT_FLEX12.png

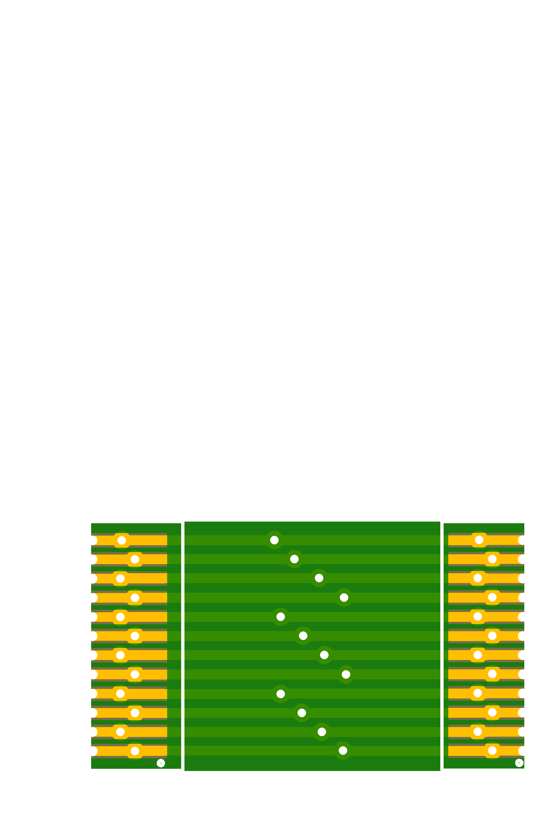
02.HARDWARE/V2-ROVER R-1/01.PCB/BATT_FLEX12/BATT_FLEX12.png
