MSTKMAD/battery-pack/02.Hardware/V1-ROVER-2K/BOMs/Cambios a la BOM.docx

Cambios a la BOM. v6-v8.

- La posición 5 cambia su cantidad de 2 a 1.
- La posición 11 cambia su valor de 10mR a 100mR.
- La posición 17 cambia su cantidad de 3 a 2.
- La posición 19 aumenta su cantidad de 4 a 6.
- La posición 25 cambia su cantidad de 3 a 0.
- La posición 31 cambia su cantidad de 4 a 2.
- La posición 33 cambia su cantidad de 1 a 2.
- Se añade la posición 67: Memoria EEPROM(AT24MAC602-STUM-T) SOT23-5, cantidad 2.
- Se añade la posición 68: Resistencia SMD-0402 de 150k, cantidad 2.
- Se añade la posición 69: Resistencia SMD-0402 de 47k, cantidad 1.
