MSTKMAD/battery-pack/02.Hardware/V1-ROVER-2K/BOMs/Battery/v8/CPU/CPU-MD.docx

Rover 2K CPU Card

DOCUMENT | : | Rover 2K. CPU card manufacturing documentation
SUMMARY | : | This document includes the manufacturing documentation for the Rover 2k CPU Card
REFERENCE | : | CPU
STATUS | : | Pending revision
DATE | : | 18/04/2022
LOCATION | : | \\01.Documentation\02.Fabricacion\CPU\CPU-MD.docx
FILE | : | CPU-MD.Docx

| AUTHOR | CHECKED BY | APPROVED BY
NAME | Javier Rodriguez
SIGNATURE
DATE

# Index

# Document History

Issue | Date | Change | Author
0.1 | 18/04/2022 | Creation | Javier Rodriguez

# Abbreviations

BOM | Bill Of Materials
PCB | Printed Circuit Board

# References

# 1 Introduction

This document describes the manufacturing documentation required to produce the CPU Card for the Rover 2k battery pack.

# 2 Current modification state

Current board modification state is: A.

The associated manufacturing documentation is indicated in following table:

Manufacturing document | Issue | File name | Location
Bill of materials | 6 | BATT_PCBS_BOM.xlsx | 01.Documentation\02.Fabricacion\CPU\BATT_PCBS_BOM.xlsx
PCB electric diagram | 5 | BATT_CPU.brd/.sch | 01.Documentation\02.Fabricacion\CPU\ BATT_CPU.brd/.sch
Assembly instructions | - | - | -
Test procedure

Printed copies of these documents are included in annexes in Acrobat Reader PDF format.

# 3 Previous modification states

Mod. state | Bill of materials | PCB | Assembly instructions | Test procedure

# 4 History of changes

Mod. state | Date | Changes

# 5 Annexes

Here are Included the printed copies of the manufacturing documents in file F0001-FILES.zip [1] for latest modification state:

- Bill of materials
- PCB Electric diagram and component layout
- Test procedure
- Test record sheet
- Assembly instructions

PROJECT: Rover 2K REF. : CPU PAGE : 3 of 6 DATE : 18/04/2022
