MSTKMAD/battery-pack/02.HARDWARE/V2-ROVER R-1/02.BOM/BATT_DCDC.xlsx

Sheet: BATT_DCDC
BOM Version | 15
fecha | 2025-09-24
 | BATT_DCDC_BOOM
Position | NEW | Assembly | Qty | Part | Value | Device | Package | Unit Price | Extended Price | Sustituto | Link
1 | NO |  | 2 | C1, C4 | 1.0uF, 16V, X7R | CAPACITOR | SMD 0402
2 | NO |  | 2 | C10,C21 | 47nF | CAPACITOR | SMD 0603
3 | NO |  | 2 | C12, C15 | 47uF 16V | CAPACITOR | SMD 1210
4 | NO |  | 2 | C18, C19 | 47uF 25V | CAPACITOR | SMD 1210
5 | NO |  | 6 | C2, C5, C6,C8 C24,C11 | 100nF, 25V, X7R o X5R | CAPACITOR | SMD 0603
6 | NO |  | DELETED | DELETED | DELETED | DELETED | DELETED | DELETED | DELETED |  | DELETED
7 | NO |  | 1 | C22 | 100pF, 25V, C0G | CAPACITOR | SMD 0603
8 | NO |  | DELETED | DELETED | DELETED | DELETED | DELETED | DELETED | DELETED |  | DELETED
9 | NO |  | 1 | C3 | 10uF, 12V, X7R | CAPACITOR | SMD 0805
10 | NO |  | 1 | D1 | BAT54SW,115 | DIODE | SOT323 |  |  |  | https://www.digikey.es/en/products/detail/nexperia-usa-inc/BAT54SW-115/763219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
11 | NO |  | 1 | D2 | B520C-13-F | DIODE | DO214 |  |  |  | https://www.digikey.es/en/products/detail/diodes-incorporated/B520C-13-F/806535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
12 | NO |  | 1 | L1 | 2.2uH - 74437346022 | INDUCTOR | 7.3 x 6.6 x 3.1mm |  |  |  | https://www.digikey.es/en/products/detail/würth-elektronik/74437346022/2790921?s=N4IgTCBcDaIOwBYEGY7IQNgAxggXQF8g
13 | NO |  | 1 | Q1 | NVTFS9D6P04M8LTAG | TRANSISTOR | 8-powerWDFN |  |  | RQ3G110ATTB | https://www.digikey.es/en/products/detail/onsemi/NVTFS9D6P04M8LTAG/11592842
14 | NO |  | 1 | Q2 | 2N7002PW | TRANSISTOR | SOT323
15 | NO |  | 1 | R1 | 169k | RESISTOR | SMD 0402
16 | NO |  | DELETED | DELETED | DELETED | DELETED | DELETED | DELETED | DELETED |  | DELETED
17 | NO |  | 1 | R11 | 5k1 | RESISTOR | SMD 0402
18 | NO |  | 1 | R12 | 8k2 | RESISTOR | SMD 0402
19 | NO |  | 1 | R13 | 7k5 | RESISTOR | SMD 0402
20 | NO |  | 1 | R2 | 39k | RESISTOR | SMD 0402
21 | NO |  | 1 | R3 | 2k4 | RESISTOR | SMD 0603
22 | NO |  | 2 | R38, R39 | 78k7 | RESISTOR | SMD 0402
23 | NO |  | 1 | R4 | 100k | RESISTOR | SMD 0402
24 | NO |  | 1 | R41 | 15k | RESISTOR | SMD 0402
25 | NO |  | 1 | R43 | 30k | RESISTOR | SMD 0402
26 | NO |  | 2 | R5, R19 | 33R | RESISTOR | SMD 0402
27 | NO |  | 1 | R6 | 62k | RESISTOR | SMD 0603
28 | NO |  | 1 | R8 | 36k | RESISTOR | SMD 0603
29 | NO |  | 1 | R9 | 5k6 | RESISTOR | SMD 0402
30 | NO |  | 1 | RSENSE | 100mR, 1%, 1/2W, 100ppm - KDV12FR100ET | RESISTOR | SMD 1206 |  |  |  | https://www.digikey.es/en/products/detail/ohmite/KDV12FR100ET/10476508
31 | NO |  | 2 | U1, U7 | MCP6071T-E/OT | INTEGRATED CIRCUIT | SOT-23-5 |  |  |  | https://www.digikey.es/en/products/detail/microchip-technology/MCP6071T-E-OT/2614948
32 | NO |  | 1 | U3 | TPS55330RTET | INTEGRATED CIRCUIT | 16-WFQFN |  |  |  | https://www.digikey.es/en/products/detail/texas-instruments/TPS55330RTET/4212800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
33 | NO |  | 1 | C7 | 220pF, 16V, C0G | CAPACITOR | SMD 0603
34 | NO |  | 1 | C9 | N.A | CAPACITOR | SMD 0603
35 | NO |  | 1 | R7 | 4k3 | RESISTOR | SMD 0603
36 | NO |  | 3 | R14,R17,R10 | 100R | RESISTOR | SMD 0402
37 | NO |  | 1 | R18 | 0R | RESISTOR | SMD 0402
38 | NO |  | 1 | J1 | DF40C-20DP-0.4V_51_ | CONNECTOR | DF40C-20DPA |  |  |  | https://www.digikey.es/es/products/detail/hirose-electric-co-ltd/DF40C-20DP-0-4V-51/1969479
39 | NO |  | 1 | U2 | LM5111-4MY/NOPB | INTEGRATED CIRCUIT | TSSOP, 8-MSOP |  |  |  | https://www.digikey.com/en/products/detail/texas-instruments/lm5111-4my-nopb/1836028
40 | NO |  | 1 | R16 | 10k | RESISTOR | SMD 0402
41 | YES |  | 1 | Q3 | DMN3023L-7 | DMN3023L-7 | SOT23-TO-236AB_NEX-L |  |  |  | https://www.digikey.es/en/products/detail/diodes-incorporated/DMN3023L-7/5453119
42 | NO | NO MONTAR | 0 | R15, R20 | 20R | RESISTOR | SMD 1206
43 | NO | NO MONTAR | 2 | R21,R22 | 4k3 | RESISTOR | SMD 0603

Sheet: _HISTORY
HISTORY
version | fecha | autor | cambios
1 | 2022-11-09 | JRC | Creacion
2 | 2022-11-15 | DGB | Añadida posicion Borrada pos8 y pasada a pos5 Corregido encapsulado de Q1 Encapsulado pos30 rsense corregido (antes 0402)
3 | 2022-12-27 | JRC | Se borra posicion 6 y se pasa a la posicion 2 Se añade el part C8 a la posicion 5. Se elimina el part R7 de la posicion 21. Se Cambia el valor de la posicion 24 de 56k2 a 15k. Se crea la posicion 33 con el part C7 y valor 220pF Se crea la poscion 34 con el part C9 y valor N.A Se crea la posicion 35 con el part R7 y valor 4k3 Se crea la posicion 36 con los part R14 y R17, y valor 100R Se crea la posicion 37 con los part R18 y valor 0R.
4 | 2023-01-05 | DGB | Corregido valor de C22 (100pf. antes 220pf). Corregido package D1
5 | 2023-02-01 | JRC | Se añade la posicion 38.
6 | 2023-05-16 | JRC | Las posiciones 21,27,28 y 35 cambian su Package a SMD 0603
7 | 2023-09-11 | JRC | Se crea la posicion 39 con el part U2. Se cambia el valor de R16 de 100k a 10k. Se disminuye la posicion 22 y se crea la posicion 40 con el part R16. Se elimina el part R15 de la posicion 22.
8 | 2023-09-25 | JRC | Se elimina el part Q5 de la posicion 14
9 | 2023-09-26 | DGB | Se actuliza la columna NEW
10 | 2023-11-09 | JRC | Se crea la posicion 41 con el part Q3 con el valor PMV20XNER Se crea la posicion 42 con los parts R15 y R20 con el valor 20R Se añade el part R19 a la posicion 26
11 | 2024-05-28 | JRC | Se cambia el part Q3 del PMV20XNER a DMN3023L-7
12 | 2024-09-10 | JRC | Se cambia el part U2, pos 39, del LM5114 al LM5111-4MY Se cambia el montaje del part Q3, pos 41, ya no se monta. Se añade a la posicion 35 el part R21 se cambia la cantidad de 1 a 2 Se elimina la posicion 8 con el part R10. Se añade a la posicion 36 el part R10. Aumenta la cantidad de 2 a 3.
13 | 2024-09-18 | JRC | Se añade a la posicion 35 el part R22 se cambia la cantidad de 2 a 3 Se añade a la posicion 5 el part C11 se cambia la cantidad de 5 a 6
14 | 2025-02-12 | JRC | Se añade la posicion 43 con los part 21 y R22 de valor 4k2 con NO MONTAR Se eliminan de la posicion 35 los par R21 y R22, se cambia la cantidad de 3 a 1
15 | 2025-09-24 | JRC | Se cambia el ensamblado de NO MONTAR a MONTAR del part Q3 de la posicion 41

Sheet: CONTACT INFO
Document property of:
EXINOM CORE SL
Calle Aranjuez, 513
28805
Alcala de Henares
Spain
mail | david@exinom.com
mobile | +34 603486681
