MSTKMAD/battery-pack/02.HARDWARE/V2-ROVER R-1/02.BOM/BATT_CPU.xlsx

Sheet: BATT_CPU
BOM Version
fecha | 1970-01-01
 |  | BATT_CPU_BOOM
Position | NEW | Qty | Part | Value | Device | Package | Link
1 | NO | 1 | BZ1 | PKMCS0909E4000-R1 | BUZZER | PKMCS0909 | https://www.digikey.es/es/products/detail/murata-electronics/PKMCS0909E4000-R1/4878400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
2 | NO | 3 | C1, C14, C20 | 2.2uF, 16V, X7R | CAPACITOR | SMD 0603
3 | NO | 2 | C12, C23 | 1.0uF, 16V, X7R | CAPACITOR | SMD 0402
4 | NO | 2 | C2, C4 | 22pF, 16V, C0G | CAPACITOR | SMD 0603
5 | NO | 2 | C21, C22 | 4.7uF, 16V, X7R | CAPACITOR | SMD 0603
6 | NO | 18 | C3, C5, C7, C9, C10, C11, C13, C15, C16, C17, C18, C19, C24, C25, C26, C27,C28,C29 | 100nF, 25V, X7R o X5R | CAPACITOR | SMD 0402
7 | NO | 1 | L7 | 0R | RESISTOR | SMD 0805
8 | NO | 3 | Q1, Q2, Q5 | BSS84W-7-F | TRANSISTOR | SOT323 | https://www.digikey.es/es/products/detail/diodes-incorporated/BSS84W-7-F/806539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
9 | NO | 2 | Q3, Q4 | 2N7002PW | TRANSISTOR | SOT323 | https://www.digikey.es/es/products/detail/nexperia-usa-inc/2N7002PW-115/2296328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
10 | NO | 3 | R1, R2, R6 | 4k7 | RESISTOR | SMD 0402
11 | NO | 1 | R10 | 120k | RESISTOR | SMD 0402
12 | YES | 1 | R11 | 11k | RESISTOR | SMD 0402
13 | NO | 1 | R17 | 150k | RESISTOR | SMD 0402
14 | NO | 1 | R3 | 560k | RESISTOR | SMD 0402
15 | NO | 4 | R4, R5, R14, R16 | 100k | RESISTOR | SMD 0402
16 | NO | 2 | R19,R18 | 10k | RESISTOR | SMD 0402
17 | NO | 0 | deleted | deleted
18 | NO | 3 | R7, R9, R12 | 2k2 | RESISTOR | SMD 0402
19 | NO | 3 | R8, R13, R15 | 100R | RESISTOR | SMD 0402
20 | NO | 3 | S1, S2, S3 | PTS526_SKG15_SMTR2_LFS | MOMENTARY SWITCH | PTS526SKG15SMTR2LFS | https://www.digikey.es/es/products/detail/c-k/PTS526-SKG15-SMTR2-LFS/10056628
21 | NO | 1 | U1 | ATSAMD21G18_QFN | INTEGRATED CIRCUIT | TQFN48_7MM
22 | NO | 1 | U3 | TPS78230DDCR | INTEGRATED CIRCUIT | SOT95P280X110-5N
23 | NO | 1 | U6 | MAX9062EUK+T | INTEGRATED CIRCUIT | SOT-753 | https://www.digikey.es/es/products/detail/analog-devices-inc-maxim-integrated/MAX9062EUK-T/1937837
24 | NO | 1 | U8 | SN74LVC1G19DBVR | INTEGRATED CIRCUIT | SOT23-6 | https://www.digikey.es/es/products/detail/texas-instruments/SN74LVC1G19DBVR/654738
25 | NO | 1 | X2 | 32768 HZ | CRYSTAL | XTAL3215
26 | NO | 1 | J1 | DF40C_2.0_-20DS-0.4V_51_ | CONNECTOR | DF40C2020DS04V51 | https://www.digikey.es/es/products/detail/hirose-electric-co-ltd/DF40C-2-0-20DS-0-4V-51/1967923
27 | NO | 0 | deleted | deleted | deleted | deleted | deleted
28 | NO | 2 | C6,C8 | 10uF, 10V, X5R | CAPACITOR | SMD 0603 | https://www.digikey.es/en/products/detail/samsung-electro-mechanics/CL10A106MP8NNNC/3887529
29 | NO | 1 | R21 | 0R | RESISTOR | SMD 0402
30 | NO | 1 | R20 | N.C | RESISTOR | SMD 0402
31 | NO | 1 | R48 | 1k | RESISTOR | SMD 0402
32 | YES | 1 | R22 | 7k5 | RESISTOR | SMD 0402

Sheet: _HISTORY
HISTORY
version | fecha | autor | cambios
1 | 2022-11-09 | JRC | Creacion
2 | 2022-11-15 | DGB | Añadida descripcion de componentes y numero de posicion
3 | 2022-12-23 | JRC | Se añade en la posicion 12 el part C28 aumentando la cantidad a 17
4 | 2023-01-05 | DGB | Se cambia L7 a resistencia 0R. Se añade voltaje y dielectrico de los condensadores. Se corrige encapsulado de pos14. Borrada pos17 se añade 1 a pos15
5 | 2023-02-01 | JRC | Se añade la posicion 26
6 | 2023-05-16 | JRC | Se añade R19 a la posicion 16. Se crea la poscion 27 añadiendo IC1.
7 | 2023-05-17 | JRC | Se crea la posicion 28 C6 y C8 cambian su valor de 2u2 a 10u se crea la posicion 29 con el part R20 Se crea la posicion 30 con el part R21 La posicion 6 aumenta en 1 con el part C29
8 | 2023-09-11 | JRC | Se cambia el valor de R48 de 10k a 1k. Se decrementa en 1 la cantidad de la posicion 15 a 4 y se aumenta en una la posicion 16 a 3 Se cambia el valor de R18 de 100k a 10k. Se crea la posicion 31 y se disminuye la poscion 16 a 2.
9 | 2023-09-25 | JRC | Se elimina el part U2 y por tanto, se elimina la posicion 27
 | 2023-09-26 | DGB | Se actualiza la columna de NEW para que SETI tenga los cambios actualizados contra la version anterior (7)
10 | 2024-09-05 | JRC | Se cambia el valor de R11 de 8k2 a 11k.
11 | 2024-11-15 | JRC | Se añade la posicion 32 con el part R22 de 7k5 con cantidad 1.

Sheet: CONTACT INFO
Document property of:
EXINOM CORE SL
Calle Aranjuez, 513
28805
Alcala de Henares
Spain
mail | david@exinom.com
mobile | +34 603486681
