MSTKMAD/battery-pack/02.HARDWARE/V2-ROVER R-1/02.BOM/CIRULO_PANEL.xlsx

Sheet: CIRULO PANEL
BOM VERSION | 2
 | CIRULO PANEL
Position | NEW | Qty | Part | Value | Device | Package | Unit Price | Extended Price | Link
1 |  | 1 | C1 | 100uF | CAPACITOR | CPOL-RADIAL-2.5MM-6.5MM
2 |  | 1 | C13 | 100n | CAPACITOR | SMD 0805
3 |  | 1 | D3 |  | DIODE | LED_3MM
4 |  | 1 | FUSE |  | FUSE | SMD 0805
5 |  | 1 | J1 | 302-S201 | CONNECTOR | SHDR20W66P254_2X10_3300X905X90
6 |  | 1 | J2 |  | CONNECTOR | 1X06
7 |  | 1 | JP1 |  | CONNECTOR | JP1
8 |  | 2 | JP2, JP4 |  | CONNECTOR | JP1
9 |  | 1 | Q1 | PJA3416AE_R1_00001 | TRANSISTOR | SOT23
10 |  | 1 | R40 | 220 | RESISTOR | SMD 0805
11 |  | 1 | U3 | ATE1D-5M3-10-Z | INTEGRATED CIRCUIT | SPDT05_ATE1D_9P5X8_NDC
12 |  | 1 | Z1 | MMSZ5231B-7-F | INTEGRATED CIRCUIT | SOD3716X145N

Sheet: _HISTORY
HISTORY
version | fecha | autor | cambios
1 | 2023-01-17 | JRC | Creacion
2 | 2023-01-24 | JRC | Valor de Condensadores
