MSTKMAD/battery-pack/02.Hardware/V1-ROVER-2K/BOMs/Tornilleria Bateria.xlsx

ID | Qty | Name | PCB DISPLAY | Chasis trasera | PCB Carcasa Inferior | PCB Input | Carcasa Inferior Bateria
1 | 8 | DIN 7985 M1.6x3 | 4 |  | 4
2 | 8 | Tornillo Avellanado DIN 965 A4 M1.6x8 |  | 4 |  |  | 4
3 | 4 | Tornillo Alomada DIN 7985 A4 M1.6x4 |  |  |  | 4
