MSTKMAD/battery-pack/02.Hardware/BOMs/History/BATT_PCBS_BOM.xlsx

Sheet: CPU BOOM
BOM Version | 1
 | BATT_CPU_BOOM
Position | Qty | Part | Value | Device | Package | Unit Price | Extended Price | Link | Assembly
1 | 1 | BZ1 | KMCS0909E4000-R1 | BUZZER | PKMCS0909 | 0.43965 | 0.43965 | https://www.digikey.es/product-detail/en/murata-electronics/PKMCS0909E4000-R1/490-9647-1-ND/4878401
2 | 9 | C3, C5, C7, C9, C11, C13, C15, C18, C19 | 0.1UF 25V X7R | CAPACITOR | SMD 0603 | 0.00457 | 0.04113 | https://www.digikey.es/product-detail/en/samsung-electro-mechanics/CL10B104KA8NNNC/1276-1006-1-ND/3889092
3 | 2 | C16, C17 | 1UF 25V X5R 0603 | CAPACITOR | SMD-0603 | 0.00719 | 0.01438 | https://www.digikey.es/product-detail/en/samsung-electro-mechanics/CL10A105KA8NNNC/1276-1102-1-ND/3889188
4 | 6 | C1, C14, C6, C8, C10, C12 | 2.2UF 25V X7R 0805 | CAPACITOR | SMD 0805 | 0.03526 | 0.21156 | https://www.digikey.es/product-detail/en/samsung-electro-mechanics/CL21B225KAFNFNE/1276-2953-1-ND/3891039
5 | 2 | C2, C4 | 22PF 50V C0G/NP0 0603 | CAPACITOR | SMD 0603 | 0.00876 | 0.01752 | https://www.digikey.es/product-detail/en/samsung-electro-mechanics/CL10C220JB81PNC/1276-2226-1-ND/3890312
6 | 4 | R6, R7, R8, R10 | 120k | RESISTOR | SMD 0402 |  | 0
7 | 1 | R9 | 5.6k | RESISTOR | SMD 0402 |  | 0
8 | 2 | R12, R15 | 2.4k | RESISTOR | SMD 0402 |  | 0
9 | 2 | R3, R4 | 100R | RESISTOR | SMD 0402 |  | 0
10 | 1 | R5 | 100k | RESISTOR | SMD 0402 |  | 0
11 | 2 | R1, R2 | 2k2 | RESISTOR | SMD 0402 |  | 0
12 | 1 | R45 | 330 | RESISTOR | SMD 0402 |  | 0
13 | 1 | R16 | 36k | RESISTOR | SMD 0402 |  | 0
14 | 1 | R13 | 62k | RESISTOR | SMD 0402 |  | 0
15 | 1 | R11 | 8.2k | RESISTOR | SMD 0402 |  | 0
16 | 1 | U1 | ATSAMD21G18_QFN | INTEGRATED CIRCUIT | TQFN48_7MM | 2.6408 | 2.6408 | https://www.digikey.es/product-detail/en/microchip-technology/ATSAMD21G18A-MFT/ATSAMD21G18A-MFTCT-ND/5119077
17 | 2 | U5,U6 | MAX9062EUK+T | INTEGRATED CIRCUIT | 21-0057F_MXM | 0.39683 | 0.79366 | https://www.digikey.es/product-detail/en/maxim-integrated/MAX9062EUK-T/MAX9062EUK-TCT-ND/2234693
18 | 1 | U7 | MCP6071T-E/OT | INTEGRATED CIRCUIT | SOT-23-5 | 0.3878 | 0.3878 | https://www.digikey.es/product-detail/en/microchip-technology/MCP6071T-E-OT/MCP6071T-E-OTCT-ND/2618481
19 | 1 | L7 | MMZ2012Y202BT000 | INDUCTOR | SMD 0603 | 0.02112 | 0.02112 | https://www.digikey.es/product-detail/en/tdk-corporation/MMZ2012Y202BT000/445-1561-1-ND/571891
20 | 1 | U8 | SN74LVC1G19DBVR | INTEGRATED CIRCUIT | DBV6 | 0.08784 | 0.08784 | https://www.digikey.es/product-detail/en/texas-instruments/SN74LVC1G19DBVR/296-16982-1-ND/654766
21 | 2 | U2,U3 | TPS78230DDCR | INTEGRATED CIRCUIT | SOT95P280X110-5N | 0.30223 | 0.60446 | https://www.digikey.es/product-detail/en/texas-instruments/TPS78230DDCR/296-24372-1-ND/2051750
22 | 1 | U4 | TS3USB221A | INTEGRATED CIRCUIT | QFN-10-RSE | 0.56488 | 0.56488 | https://www.digikey.es/product-detail/en/texas-instruments/TS3USB221AQRSERQ1/296-27719-1-ND/2356140
23 | 1 | X2 | XTAL-3.2X1.5 | OSCILLATOR | XTAL3215 | 0.57 | 0.57 | https://www.mouser.es/ProductDetail/ECS/ECS-327-125-12RR-TR?qs=9r4v7xj2Lnlp2XtvX%2FZgxw%3D%3D
Total |  |  |  |  |  |  | 6.3948

Sheet: DCDC_BOM
BOM Version | 1
 | BATT_DCDC_BOOM
Position | Qty | Part | Value | Device | Package | Unit Price | Extended Price | Link | Assembly
1 | 3 | C1,C2, C24 | 0.1UF 25V X7R | CAPACITOR | SMD 0603 | 0.00457 | 0.01371 | https://www.digikey.es/product-detail/en/samsung-electro-mechanics/CL10B104KA8NNNC/1276-1006-1-ND/3889092
2 | 2 | C10, C20 | 0.47UF 25V X7R | CAPACITOR | SMD 0603 | 0.001739 | 0.003478 | https://www.digikey.es/product-detail/en/samsung-electro-mechanics/CL10B474KA8NFNC/1276-2082-1-ND/3890168
3 | 3 | C11, C12, C15 | 47UF 16V X6S | CAPACITOR | SMD 1210 | 0.1906 | 0.5718 | https://www.digikey.es/product-detail/en/GRM32EC81C476KE15L/490-10531-2-ND/5027615/?itemSeq=358253695
4 | 4 | C16, C17, C18, C19 | 47UF 25V X5R | CAPACITOR | SMD 1210 | 0.38568 | 1.54272 | https://www.digikey.es/product-detail/en/C3216X5R1E476M160AC/445-8047-1-ND/2792164/?itemSeq=358252465
5 | 1 | C21 | 2.2nF | CAPACITOR | SMD 0603 | 0.00694 | 0.00694 | https://www.digikey.es/product-detail/en/CL10B222KB8NNNC/1276-1110-6-ND/3891624/?itemSeq=358255759
6 | 1 | C22 | 270PF | CAPACITOR | SMD 0603 | 0.00928 | 0.00928 | https://www.digikey.es/product-detail/en/CC0603KRX7R9BB271/311-1185-1-ND/372898/?itemSeq=358257069
7 | 1 | D2 | B520C-13-F | DIODE | DIOM7959X250N | 0.17315 | 0.17315 | https://www.digikey.es/product-detail/en/B520C-13-F/B520C-FDICT-ND/806565/?itemSeq=358257331
8 | 1 | K3 | FLEX8 | CONNECTOR | FLEX8 | - | - | -
9 | 1 | L1 | 2.2uH - 74437346022 | INDUCTOR | INDM7366X500 | 1.47 | 1.47 | https://www.digikey.es/product-detail/en/w%C3%BCrth-elektronik/74437346022/732-3372-1-ND/2790967
10 | 1 | Q1 | NVTFS9D6P04M8LTAG | TRANSISTOR | NVTFS5124PLTWG | 0.47992 | 0.47992 | https://www.digikey.es/product-detail/en/on-semiconductor/NVTFS9D6P04M8LTAG/488-NVTFS9D6P04M8LTAGCT-ND/11593208
11 | 2 | Q2, Q5 | 2N7002PW | TRANSISTOR | SOT323 | 0.03597 | 0.07194 | https://www.digikey.es/product-detail/en/2N7002PW%2c115/1727-4793-2-ND/2296328/?itemSeq=358257941
12 | 1 | R1 | 39k | RESISTOR | SMD 0402 | - | - | -
13 | 1 | R10 | 82k | RESISTOR | SMD 0402 | - | - | -
14 | 3 | R11, R13, R14 | 15k | RESISTOR | SMD 0402 | - | - | -
15 | 1 | R12 | 1k | RESISTOR | SMD 0402 | - | - | -
16 | 1 | R2 | 20k | RESISTOR | SMD 0402 | - | - | -
17 | 1 | R3 | 10k | RESISTOR | SMD 0402 | - | - | -
18 | 1 | R38 | 78k7 | RESISTOR | SMD 0402 | - | - | -
19 | 2 | R39, R40 | 78.7k | RESISTOR | SMD 0402 | - | - | -
20 | 3 | R4, R15, R16 | 470k | RESISTOR | SMD 0402 | - | - | -
21 | 1 | R41 | 56k2 | RESISTOR | SMD 0402 | - | - | -
22 | 1 | R43 | 78.7k | RESISTOR | SMD 0402 | - | - | -
23 | 2 | R5, R17 | 33 | RESISTOR | SMD 0402 | - | - | -
24 | 1 | R6 | 5k1 | RESISTOR | SMD 0402 | - | - | -
25 | 1 | R7 | 680k | RESISTOR | SMD 0402 | - | - | -
26 | 1 | R8 | 330k | RESISTOR | SMD 0402 | - | - | -
27 | 1 | R9 | 160k | RESISTOR | SMD 0402 | - | - | -
28 | 1 | RSENSE | 10mR | RESISTOR | SMD 0603 | 0.05544 | 0.05544
29 | 4 | TP1, TP2, TP3, TP4 | TESTPAD_TPSQTP15SQ | TESTPAD_TPSQTP15SQ | TESTPAD_TP15SQ | - | - | -
30 | 2 | U$34, U$35 | FIDUCIAL" | FIDUCIAL" | FIDUCIAL_1MM | - | - | -
31 | 1 | U1 | MCP6071T-E/OT | INTEGRATED CIRCUIT | SOT-23-5 | 0.3878 | 0.3878 | https://www.digikey.es/product-detail/en/MCP6071T-E%2fOT/MCP6071T-E%2fOTDKR-ND/2618488/?itemSeq=358258033
32 | 1 | U3 | TPS55330RTET | INTEGRATED CIRCUIT | RTE16_1P66X1P66_TEX | 1.7275 | 1.7275 | https://www.digikey.es/product-detail/en/texas-instruments/TPS55330RTET/296-36219-2-ND/4212800
33 | 1 | U7 | TPIC2810D | INTEGRATED CIRCUIT | SO16 | 0.54507 | 0.54507 | https://www.digikey.es/product-detail/en/texas-instruments/TPIC2810DR/296-46367-2-ND/1670586
Total |  |  |  |  |  |  | 7.058748

Sheet: INPUT BOOM
BOM Version | 1
 | BATT_INPUT_BOOM
Position | Qty | Part | Value | Device | Package | Unit Price | Extended Price | Link | Assembly
1 | 1 | C1 | 1UF 25V X5R 0603 | CAPACITOR | SMD-0603 | 0.00719 | 0.00719 | https://www.digikey.es/product-detail/en/samsung-electro-mechanics/CL10A105KA8NNNC/1276-1102-1-ND/3889188
2 | 2 | C2,C5 | 0.1UF 25V X7R 0603 | CAPACITOR | SMD-0603 | 0.00549 | 0.01098 | https://www.digikey.es/product-detail/en/CL10B104KA8NNNC/1276-1006-2-ND/3886664/?itemSeq=358395414
3 | 2 | C3,C23 | 10UF 16V X5R 0805 | CAPACITOR | SMD-0805 | 0.01677 | 0.03354 | https://www.digikey.es/product-detail/en/samsung-electro-mechanics/CL21A106KOQNNNG/1276-6455-1-ND/5958083
4 | 1 | D1 | GREEN | DIODE LED | 2-SMD, No Lead | 0.19017 | 0.19017 | https://www.digikey.es/product-detail/en/kingbright/APA3010ZGC-GX/754-1575-1-ND/2757964
5 | 2 | RAWBATT+,RAWBATT- | - | PAD-CONECTOR | SMD2,54-5,08 | - | - | -
6 | 5 | R6,R7,R11,R12,R17 | 10K | RESISTOR | SMD-0402 | - | - | -
7 | 1 | R5 | 1K | RESISTOR | SMD-0402 | - | - | -
8 | 1 | R1 | 1K1 | RESISTOR | SMD-0402 | - | - | -
9 | 1 | R2 | 220 | RESISTOR | SMD-0402 | - | - | -
10 | 1 | R4 | 2K2 | RESISTOR | SMD-0402 | - | - | -
11 | 1 | R20 | 330 | RESISTOR | SMD-0402 | - | - | -
12 | 2 | R8,R9 | 5K1 | RESISTOR | SMD-0402 | - | - | -
13 | 1 | R3 | 590 | RESISTOR | SMD-0402 | - | - | -
14 | 1 | J1 | 70AAJ-4-M0 | CONECTOR | SMD-0402 | 0.66451 | 0.66451 | https://www.digikey.es/product-detail/en/bourns-inc/70AAJ-4-M0G/70AAJ-4-M0GTR-ND/761020
15 | 1 | U5 | BQ24075 | INTEGRATED CIRCUIT | PVQFN-N16 | 0.88762 | 0.88762 | https://www.digikey.es/product-detail/en/texas-instruments/BQ24075TRGTR/296-25609-1-ND/2202275
16 | 2 | QD,QC | CSD16406Q3 | TRANSISTOR | DQG008A | 0.42502 | 0.85004 | https://www.digikey.es/product-detail/en/texas-instruments/CSD16406Q3/296-24251-1-ND/2038321
17 | 1 | J4 | DX07S016JA1R1500 | CONECTOR | JAE_DX07S016JA1R1500 | 0.8085 | 0.8085 | https://www.digikey.es/product-detail/en/jae-electronics/DX07S016JA1R1500/670-DX07S016JA1R1500CT-ND/11586676
18 | 1 | U9 | BQ29700DSER | INTEGRATED CIRCUIT | DSE006A | 0.1902 | 0.1902 | https://www.digikey.es/product-detail/en/texas-instruments/BQ29700DSER/296-43985-1-ND/5973209
Total |  |  |  |  |  |  | 3.64275

Sheet: DISPLAY BOOM
BOM Version | 1
 | BATT_DISPLAY_BOOM
Position | Qty | Part | Value | Device | Package | Unit Price | Extended Price | Link | Assembly
1 | 3 | C2, C3, C5 | 0.1UF 25V X7R 0603 | CAPACITOR | SMD-0603 | 0.00549 | 0.01647 | https://www.digikey.es/product-detail/en/CL10B104KA8NNNC/1276-1006-2-ND/3886664/?itemSeq=358395414
2 | 2 | C1, C4 | 10UF 16V X5R 0805 | CAPACITOR | SMD-0805 | 0.01677 | 0.03354 | https://www.digikey.es/product-detail/en/samsung-electro-mechanics/CL21A106KOQNNNG/1276-6455-1-ND/5958083
3 | 6 | R1, R2, R4, R6, R7, R8 | 10k | RESISTOR | SMD-0402 |  | 0
4 | 1 | U1 | IS31FL3731-SALS2 | INTEGRATED CIRCUIT | QFN28_4MM_0.4MM | 0.84575 | 0.84575 | https://www.digikey.es/products/en?keywords=IS31FL3731-SALS2
5 | 2 | S1, S2 | KXT311LHS | SWITCH | KXT311LHS | 0.09724 | 0.19448 | https://www.digikey.es/product-detail/en/c-k/KXT-311-LHS/CKN10777CT-ND/6599755
Total |  |  |  |  |  |  | 1.09024

Sheet: History
 | HISTORY
BOM version | PCB version | PBA version | Date | Author | Description
1 | 1 | 1 | 2020-03-10 | JRC | Creation

Sheet: CONTACT
Document property of:
EXINOM CORE SL
Calle Aranjuez, 513
28805
Alcala de Henares
Spain
mail | david@exinom.com
mobile | +34 603486681
