MSTKMAD/battery-pack/02.Hardware/BOMs/History/BATT_PCBS_BOM_V4.xlsx

Sheet: PANELs
 | BATT_BOM |  |  |  |  |  | CHASIS |  |  |  |  |  |  | Chasis/Panel: |  | 1 | BATTERY |  |  |  | Batteries/Panel: |  | 2 | Production Price (€/Panel): | 26.84 €
 |  |  |  |  |  |  |  |  |  |  |  |  |  | Total Cost (€/Chasis): |  | 18.96826 € |  |  |  |  | Total Cost (€/Battery): |  | 3.93384 €
 |  |  |  |  |  |  | CPU |  |  | DCDC |  |  | DISPLAY |  |  |  | INPUT |  |  | PUSHBUTTON
Position | Total Qty | Value | Device | Package | Unit Price | Links | Qty | Part | Pos | Qty2 | Part3 | Pos4 | Qty5 | Part6 | Pos7 | Part Price | Qty9 | Part10 | Pos11 | Qty12 | Part13 | Pos14 | Part Price2
1 | 2 | 22PF 50V C0G/NP0 | CAPACITOR | SMD 0603 | 0.00876 € | https://www.digikey.es/product-detail/en/samsung-electro-mechanics/CL10C220JB81PNC/1276-2226-1-ND/3890312 | 2 | C2, C4 | 5 | 0 | - | - | 0 | - | - | 0.01752 € | 0 | - | - | 0 | - | - | 0.00000 €
2 | 1 | 270PF | CAPACITOR | SMD 0603 | 0.00928 € | https://www.digikey.es/product-detail/en/CC0603KRX7R9BB271/311-1185-1-ND/372898/?itemSeq=358257069 | 0 | - | - | 1 | C22 | 6 | 0 | - | - | 0.00928 € | 0 | - | - | 0 | - | - | 0.00000 €
3 | 1 | 2.2nF | CAPACITOR | SMD 0603 | 0.00694 € | https://www.digikey.es/product-detail/en/CL10B222KB8NNNC/1276-1110-6-ND/3891624/?itemSeq=358255759 | 0 | - | - | 1 | C21 | 5 | 0 | - | - | 0.00694 € | 0 | - | - | 0 | - | - | 0.00000 €
4 | 21 | 0.1UF 25V X7R | CAPACITOR | SMD 0603 | 0.00457 € | https://www.digikey.es/product-detail/en/samsung-electro-mechanics/CL10B104KA8NNNC/1276-1006-1-ND/3889092 | 9 | C3, C5, C7, C9, C11, C13, C15, C18, C19 | 2 | 3 | C1,C2, C24 | 1 | 3 | C2, C3, C5 | 1 | 0.06855 € | 3 | C2,C5,C6 | 2 | 0 | - | - | 0.01371 €
5 | 2 | 0.47UF 25V X7R | CAPACITOR | SMD 0603 | 0.00174 € | https://www.digikey.es/product-detail/en/samsung-electro-mechanics/CL10B474KA8NFNC/1276-2082-1-ND/3890168 | 0 | - | - | 2 | C10, C20 | 2 | 0 | - | - | 0.00348 € | 0 | - | - | 0 | - | - | 0.00000 €
6 | 4 | 1UF 25V X5R | CAPACITOR | SMD-0603 | 0.00719 € | https://www.digikey.es/product-detail/en/samsung-electro-mechanics/CL10A105KA8NNNC/1276-1102-1-ND/3889188 | 2 | C16, C17 | 3 | 0 | - | - | 0 | - | - | 0.01438 € | 1 | C1 | 1 | 0 | - | - | 0.00719 €
7 | 6 | 2.2UF 25V X7R | CAPACITOR | SMD 0805 | 0.03526 € | https://www.digikey.es/product-detail/en/samsung-electro-mechanics/CL21B225KAFNFNE/1276-2953-1-ND/3891039 | 6 | C1, C14, C6, C8, C10, C12 | 4 | 0 | - | - | 0 | - | - | 0.21156 € | 0 | - | - | 0 | - | - | 0.00000 €
8 | 6 | 10UF 16V X5R | CAPACITOR | SMD-0805 | 0.01677 € | https://www.digikey.es/product-detail/en/samsung-electro-mechanics/CL21A106KOQNNNG/1276-6455-1-ND/5958083 | 0 | - | - | 0 | - | - | 2 | C1, C4 | 2 | 0.03354 € | 2 | C3,C23 | 3 | 0 | - | - | 0.03354 €
9 | 3 | 47UF 16V X6S | CAPACITOR | SMD 1210 | 0.15300 € | https://www.digikey.es/product-detail/en/GRM32EC81C476KE15L/490-10531-2-ND/5027615/?itemSeq=358253695 | 0 | - | - | 3 | C11, C12, C15 | 3 | 0 | - | - | 0.45900 € | 0 | - | - | 0 | - | - | 0.00000 €
10 | 4 | 47UF 25V X5R | CAPACITOR | SMD 1210 | 0.36700 € | https://www.digikey.es/product-detail/en/C3216X5R1E476M160AC/445-8047-1-ND/2792164/?itemSeq=358252465 | 0 | - | - | 4 | C16, C17, C18, C19 | 4 | 0 | - | - | 1.46800 € | 0 | - | - | 0 | - | - | 0.00000 €
11 | 1 | 10mR | RESISTOR | SMD 0603 | 0.05544 € |  | 0 | - | - | 1 | RSENSE | 26 | 0 | - | - | 0.05544 € | 0 | - | - | 0 | - | - | 0.00000 €
12 | 2 | 33 | RESISTOR | SMD 0402 |  | - | 0 | - | - | 2 | R5, R17 | 21 | 0 | - | - | 0.00000 € | 0 | - | - | 0 | - | - | 0.00000 €
13 | 2 | 100R | RESISTOR | SMD 0402 |  | - | 2 | R3, R4 | 9 | 0 | - | - | 0 | - | - | 0.00000 € | 0 | - | - | 0 | - | - | 0.00000 €
14 | 2 | 220 | RESISTOR | SMD-0402 |  | - | 0 | - | - | 0 | - | - | 0 | - | - | 0.00000 € | 1 | R2 | 8 | 0 | - | - | 0.00000 €
15 | 3 | 330 | RESISTOR | SMD 0402 |  | - | 1 | R45 | 12 | 0 | - | - | 0 | - | - | 0.00000 € | 1 | R20 | 10 | 0 | - | - | 0.00000 €
16 | 2 | 590 | RESISTOR | SMD-0402 |  | - | 0 | - | - | 0 | - | - | 0 | - | - | 0.00000 € | 1 | R3 | 12 | 0 | - | - | 0.00000 €
17 | 3 | 1k | RESISTOR | SMD-0402 |  | - | 0 | - | - | 1 | R12 | 15 | 0 | - | - | 0.00000 € | 1 | R5 | 6 | 0 | - | - | 0.00000 €
18 | 2 | 1k1 | RESISTOR | SMD-0402 |  | - | 0 | - | - | 0 | - | - | 0 | - | - | 0.00000 € | 1 | R1 | 7 | 0 | - | - | 0.00000 €
19 | 4 | 2k2 | RESISTOR | SMD-0402 |  | - | 2 | R1, R2 | 11 | 0 | - | - | 0 | - | - | 0.00000 € | 1 | R4 | 9 | 0 | - | - | 0.00000 €
20 | 2 | 2k4 | RESISTOR | SMD 0402 |  | - | 2 | R12, R15 | 8 | 0 | - | - | 0 | - | - | 0.00000 € | 0 | - | - | 0 | - | - | 0.00000 €
21 | 5 | 5k1 | RESISTOR | SMD 0402 |  | - | 0 | - | - | 1 | R6 | 22 | 0 | - | - | 0.00000 € | 2 | R8,R9 | 11 | 0 | - | - | 0.00000 €
22 | 1 | 5k6 | RESISTOR | SMD 0402 |  | - | 1 | R9 | 7 | 0 | - | - | 0 | - | - | 0.00000 € | 0 | - | - | 0 | - | - | 0.00000 €
23 | 1 | 8k2 | RESISTOR | SMD 0402 |  | - | 1 | R11 | 15 | 0 | - | - | 0 | - | - | 0.00000 € | 0 | - | - | 0 | - | - | 0.00000 €
24 | 19 | 10k | RESISTOR | SMD 0402 |  | - | 0 | - | - | 1 | R3 | 17 | 6 | R1, R2, R4, R6, R7, R8 | 3 | 0.00000 € | 5 | R6,R7,R11,R12,R17 | 5 | 1 | R1 | 2 | 0.00000 €
25 | 3 | 15k | RESISTOR | SMD 0402 |  | - | 0 | - | - | 3 | R11, R13, R14 | 14 | 0 | - | - | 0.00000 € | 0 | - | - | 0 | - | - | 0.00000 €
26 | 1 | 20k | RESISTOR | SMD 0402 |  | - | 0 | - | - | 1 | R2 | 16 | 0 | - | - | 0.00000 € | 0 | - | - | 0 | - | - | 0.00000 €
27 | 1 | 36k | RESISTOR | SMD 0402 |  | - | 1 | R16 | 13 | 0 | - | - | 0 | - | - | 0.00000 € | 0 | - | - | 0 | - | - | 0.00000 €
28 | 1 | 39k | RESISTOR | SMD 0402 |  | - | 0 | - | - | 1 | R1 | 12 | 0 | - | - | 0.00000 € | 0 | - | - | 0 | - | - | 0.00000 €
29 | 1 | 56k2 | RESISTOR | SMD 0402 |  | - | 0 | - | - | 1 | R41 | 20 | 0 | - | - | 0.00000 € | 0 | - | - | 0 | - | - | 0.00000 €
30 | 1 | 62k | RESISTOR | SMD 0402 |  | - | 1 | R13 | 14 | 0 | - | - | 0 | - | - | 0.00000 € | 0 | - | - | 0 | - | - | 0.00000 €
31 | 4 | 78k7 | RESISTOR | SMD 0402 |  | - | 0 | - | - | 4 | R39, R40,R43,R38 | 18 | 0 | - | - | 0.00000 € | 0 | - | - | 0 | - | - | 0.00000 €
32 | 1 | 82k | RESISTOR | SMD 0402 |  | - | 0 | - | - | 1 | R10 | 13 | 0 | - | - | 0.00000 € | 0 | - | - | 0 | - | - | 0.00000 €
33 | 1 | 100k | RESISTOR | SMD 0402 |  | - | 1 | R5 | 10 | 0 | - | - | 0 | - | - | 0.00000 € | 0 | - | - | 0 | - | - | 0.00000 €
34 | 4 | 120k | RESISTOR | SMD 0402 |  | - | 4 | R6, R7, R8, R10 | 6 | 0 | - | - | 0 | - | - | 0.00000 € | 0 | - | - | 0 | - | - | 0.00000 €
35 | 1 | 160k | RESISTOR | SMD 0402 |  | - | 0 | - | - | 1 | R9 | 25 | 0 | - | - | 0.00000 € | 0 | - | - | 0 | - | - | 0.00000 €
36 | 1 | 330k | RESISTOR | SMD 0402 |  | - | 0 | - | - | 1 | R8 | 24 | 0 | - | - | 0.00000 € | 0 | - | - | 0 | - | - | 0.00000 €
37 | 3 | 470k | RESISTOR | SMD 0402 |  | - | 0 | - | - | 3 | R4, R15, R16 | 19 | 0 | - | - | 0.00000 € | 0 | - | - | 0 | - | - | 0.00000 €
38 | 1 | 680k | RESISTOR | SMD 0402 |  | - | 0 | - | - | 1 | R7 | 23 | 0 | - | - | 0.00000 € | 0 | - | - | 0 | - | - | 0.00000 €
39 | 1 | KMCS0909E4000-R1 | BUZZER | PKMCS0909 | 0.43965 € | https://www.digikey.es/product-detail/en/murata-electronics/PKMCS0909E4000-R1/490-9647-1-ND/4878401 | 1 | BZ1 | 1 | 0 | - | - | 0 | - | - | 0.43965 € | 0 | - | - | 0 | - | - | 0.00000 €
40 | 1 | ATSAMD21G18_QFN | INTEGRATED CIRCUIT | TQFN48_7MM | 2.68000 € | https://www.digikey.es/product-detail/en/microchip-technology/ATSAMD21G18A-MFT/ATSAMD21G18A-MFTCT-ND/5119077 | 1 | U1 | 16 | 0 | - | - | 0 | - | - | 2.68000 € | 0 | - | - | 0 | - | - | 0.00000 €
41 | 2 | MAX9062EUK+T | INTEGRATED CIRCUIT | 21-0057F_MXM | 0.39683 € | https://www.digikey.es/product-detail/en/maxim-integrated/MAX9062EUK-T/MAX9062EUK-TCT-ND/2234693 | 2 | U5,U6 | 17 | 0 | - | - | 0 | - | - | 0.79366 € | 0 | - | - | 0 | - | - | 0.00000 €
42 | 1 | MCP6071T-E/OT | INTEGRATED CIRCUIT | SOT23-5 | 0.38780 € | https://www.digikey.es/product-detail/en/microchip-technology/MCP6071T-E-OT/MCP6071T-E-OTCT-ND/2618481 | 1 | U7 | 18 | 0 | - | - | 0 | - | - | 0.38780 € | 0 | - | - | 0 | - | - | 0.00000 €
43 | 3 | MMZ2012Y202BT000 | INDUCTOR | SMD 0603 | 0.02112 € | https://www.digikey.es/product-detail/en/tdk-corporation/MMZ2012Y202BT000/445-1561-1-ND/571891 | 1 | L7 | 19 | 0 | - | - | 0 | - | - | 0.02112 € | 1 | L1 | 18 | 0 | - | - | 0.02112 €
44 | 1 | SN74LVC1G19DBVR | INTEGRATED CIRCUIT | SOT23-6 | 0.08784 € | https://www.digikey.es/product-detail/en/texas-instruments/SN74LVC1G19DBVR/296-16982-1-ND/654766 | 1 | U8 | 20 | 0 | - | - | 0 | - | - | 0.08784 € | 0 | - | - | 0 | - | - | 0.00000 €
45 | 2 | TPS78230DDCR | INTEGRATED CIRCUIT | SOT23-5 | 0.30223 € | https://www.digikey.es/product-detail/en/texas-instruments/TPS78230DDCR/296-24372-1-ND/2051750 | 2 | U2,U3 | 21 | 0 | - | - | 0 | - | - | 0.60446 € | 0 | - | - | 0 | - | - | 0.00000 €
46 | 1 | TS3USB221A | INTEGRATED CIRCUIT | 10-UFQFN | 0.56488 € | https://www.digikey.es/product-detail/en/texas-instruments/TS3USB221AQRSERQ1/296-27719-1-ND/2356140 | 1 | U4 | 22 | 0 | - | - | 0 | - | - | 0.56488 € | 0 | - | - | 0 | - | - | 0.00000 €
47 | 1 | XTAL-3.2X1.5 | OSCILLATOR | XTAL3215 | 0.57000 € | https://www.mouser.es/ProductDetail/ECS/ECS-327-125-12RR-TR?qs=9r4v7xj2Lnlp2XtvX%2FZgxw%3D%3D | 1 | X2 | 23 | 0 | - | - | 0 | - | - | 0.57000 € | 0 | - | - | 0 | - | - | 0.00000 €
48 | 1 | B520C-13-F | DIODE | DIOM7959X250N | 0.17315 € | https://www.digikey.es/product-detail/en/B520C-13-F/B520C-FDICT-ND/806565/?itemSeq=358257331 | 0 | - | - | 1 | D2 | 7 | 0 | - | - | 0.17315 € | 0 | - | - | 0 | - | - | 0.00000 €
49 | 1 | 2.2uH - 74437346022 | INDUCTOR | INDM7366X500 | 1.13000 € | https://www.mouser.es/ProductDetail/Wurth-Elektronik/74437346022 | 0 | - | - | 1 | L1 | 9 | 0 | - | - | 1.13000 € | 0 | - | - | 0 | - | - | 0.00000 €
50 | 1 | NVTFS9D6P04M8LTAG | TRANSISTOR | 8-PowerWDFN | 0.47992 € | https://www.digikey.es/product-detail/en/on-semiconductor/NVTFS9D6P04M8LTAG/488-NVTFS9D6P04M8LTAGCT-ND/11593208 | 0 | - | - | 1 | Q1 | 10 | 0 | - | - | 0.47992 € | 0 | - | - | 0 | - | - | 0.00000 €
51 | 2 | 2N7002PW | TRANSISTOR | SOT323 | 0.03597 € | https://www.digikey.es/product-detail/en/2N7002PW%2c115/1727-4793-2-ND/2296328/?itemSeq=358257941 | 0 | - | - | 2 | Q2, Q5 | 11 | 0 | - | - | 0.07194 € | 0 | - | - | 0 | - | - | 0.00000 €
52 | 1 | MCP6071T-E/OT | INTEGRATED CIRCUIT | SOT-23-5 | 0.38780 € | https://www.digikey.es/product-detail/en/MCP6071T-E%2fOT/MCP6071T-E%2fOTDKR-ND/2618488/?itemSeq=358258033 | 0 | - | - | 1 | U1 | 29 | 0 | - | - | 0.38780 € | 0 | - | - | 0 | - | - | 0.00000 €
53 | 1 | TPS55330RTET | INTEGRATED CIRCUIT | RTE16_1P66X1P66_TEX | 1.72750 € | https://www.digikey.es/product-detail/en/texas-instruments/TPS55330RTET/296-36219-2-ND/4212800 | 0 | - | - | 1 | U3 | 30 | 0 | - | - | 1.72750 € | 0 | - | - | 0 | - | - | 0.00000 €
54 | 1 | TPIC2810D | INTEGRATED CIRCUIT | SO16 | 0.54507 € | https://www.digikey.es/product-detail/en/texas-instruments/TPIC2810DR/296-46367-2-ND/1670586 | 0 | - | - | 1 | U7 | 31 | 0 | - | - | 0.54507 € | 0 | - | - | 0 | - | - | 0.00000 €
55 | 1 | IS31FL3731-QFLS2-TR | INTEGRATED CIRCUIT | 28-WFQFN Exposed Pad | 0.67000 € | https://www.digikey.es/product-detail/en/lumissil-microsystems/IS31FL3731-QFLS2-TR/706-1219-1-ND/4286442 | 0 | - | - | 0 | - | - | 1 | U1 | 4 | 0.67000 € | 0 | - | - | 0 | - | - | 0.00000 €
56 | 4 | KXT311LHS | SWITCH | KXT311LHS | 0.09724 € | https://www.digikey.es/product-detail/en/c-k/KXT-311-LHS/CKN10777CT-ND/6599755 | 0 | - | - | 0 | - | - | 2 | S1, S2 | 5 | 0.19448 € | 0 | - | - | 1 | S1 | 3 | 0.09724 €
57 | 90 | LED WHITE CLEAR | DIODE LED | CHIPLED_0402_NOOUTLINE | 0.03197 € | https://www.tme.eu/es/details/rf-wu0402ds-dd-b/leds-smd-blancos/refond/ | 0 | - | - | 0 | - | - | 90 | C1-3, C1-4, C1-5, C1-6, C1-7, C1-8,C2-3, C2-4, C2-5, C2-6, C2-7, C2-8, C2-9, C2-10, C2-11, C2-12, C2-13, C2-14, C3-3, C3-4, C3-5, C3-6, C3-7, C3-8, C3-9, C3-10, C3-11, C3-12, C3-13, C3-14, C4-3, C4-4, C4-5, C4-6, C4-7, C4-8, C4-9, C4-10, C4-11, C4-12, C4-13, C4-14, C5-3, C5-4, C5-5, C5-6, C5-7, C5-8, C5-9, C5-10, C5-11, C5-12, C5-13, C5-14, C6-3, C6-4, C6-5, C6-6, C6-7, C6-8, C6-9, C6-10, C6-11, C6-12, C6-13, C6-14, C7-3, C7-4, C7-5, C7-6, C7-7, C7-8, C7-9, C7-10, C7-11, C7-12, C7-13, C7-14,C8-3, C8-4, C8-5, C8-6, C8-7, C8-8, C8-9, C8-10, C8-11, C8-12, C8-13, C8-14 | 6 | 2.87730 € | 0 | - | - | 0 | - | - | 0.00000 €
58 | 2 | 70AAJ-4-M0 | CONECTOR | SMD-0402 | 0.66451 € | https://www.digikey.es/product-detail/en/bourns-inc/70AAJ-4-M0G/70AAJ-4-M0GTR-ND/761020 | 0 | - | - | 0 | - | - | 0 | - | - | 0.00000 € | 1 | J1 | 13 | 0 | - | - | 0.66451 €
59 | 2 | BQ24075 | INTEGRATED CIRCUIT | PVQFN-N16 | 0.88762 € | https://www.digikey.es/product-detail/en/texas-instruments/BQ24075TRGTR/296-25609-1-ND/2202275 | 0 | - | - | 0 | - | - | 0 | - | - | 0.00000 € | 1 | U5 | 14 | 0 | - | - | 0.88762 €
60 | 4 | CSD16406Q3 | TRANSISTOR | 8-PowerTDFN | 0.42502 € | https://www.digikey.es/product-detail/en/texas-instruments/CSD16406Q3/296-24251-1-ND/2038321 | 0 | - | - | 0 | - | - | 0 | - | - | 0.00000 € | 2 | QD,QC | 15 | 0 | - | - | 0.85004 €
61 | 2 | DX07S016JA1R1500 | CONECTOR | JAE_DX07S016JA1R1500 | 0.80850 € | https://www.digikey.es/product-detail/en/jae-electronics/DX07S016JA1R1500/670-DX07S016JA1R1500CT-ND/11586676 | 0 | - | - | 0 | - | - | 0 | - | - | 0.00000 € | 1 | J4 | 16 | 0 | - | - | 0.80850 €
62 | 2 | BQ29700DSER | INTEGRATED CIRCUIT | 6-WFDFN | 0.19020 € | https://www.digikey.es/product-detail/en/texas-instruments/BQ29700DSER/296-43985-1-ND/5973209 | 0 | - | - | 0 | - | - | 0 | - | - | 0.00000 € | 1 | U9 | 17 | 0 | - | - | 0.19020 €
63 | 5 | LED YELLOW CLEAR | DIODE LED | CHIPLED_0402_NOOUTLINE | 0.15200 € | https://eu.mouser.com/ProductDetail/Wurth-Elektronik/150040YS73240?qs=8Aam6%252B7C6HFi%252BY4Pboxj6w%3D%3D | 0 | - | - | 0 | - | - | 5 | C8-2,C8-15,C7-15,C6-15,C2-15,C7-2 | 8 | 0.76000 € | 0 | - | - | 0 | - | - | 0.00000 €
64 | 3 | LED RED CLEAR | DIODE LED | CHIPLED_0402_NOOUTLINE | 0.13000 € | https://eu.mouser.com/ProductDetail/Wurth-Elektronik/150040RS73240?qs=8Aam6%252B7C6HGMiInmnlrBiw%3D%3D | 0 | - | - | 0 | - | - | 3 | C5-15,C4-15,C3-15, | 9 | 0.39000 € | 0 | - | - | 0 | - | - | 0.00000 €
65 | 7 | LED GREEN CLEAR | DIODE LED | CHIPLED_0402_NOOUTLINE | 0.15200 € | https://eu.mouser.com/ProductDetail/Wurth-Elektronik/150040VS73240?qs=8Aam6%252B7C6HEhyesRm%252BQyFQ%3D%3D | 0 | - | - | 0 | - | - | 7 | C1-2,C2-2,C3-2,C4-2,C5-2,C6-2, | 7 | 1.06400 € | 0 | - | - | 0 | - | - | 0.00000 €
66 | 2 | APA3010ZGC-GX | DIODE LED | 2-SMD, No Lead | 0.19017 € | https://www.digikey.es/product-detail/en/kingbright/APA3010ZGC-GX/754-1575-1-ND/2757964 | 0 | - | - | 0 | - | - | 0 | - | - | 0.00000 € | 0 | - | - | 1 | D1 | 1 | 0.19017 €
67 | 2 | AT24C16D-STUM-T | FLASH MEMORY | SOT23-5 | 0.17000 € | https://www.digikey.es/product-detail/en/microchip-technology/AT24C16D-STUM-T/AT24C16D-STUM-TCT-ND/5055821 | 0 | - | - | 0 | - | - | 0 | - | - | 0.00000 € | 1 | 0 | 19 | 0 | - | - | 0.17000 €
68 | 0 |  |  |  |  |  | 0 | - | - | 0 | - | - | 0 | - | - | 0.00000 € | 0 | - | - | 0 | - | - | 0.00000 €
69 | 0 |  |  |  |  |  | 0 | - | - | 0 | - | - | 0 | - | - | 0.00000 € | 0 | - | - | 0 | - | - | 0.00000 €
70 | 0 |  |  |  |  |  | 0 | - | - | 0 | - | - | 0 | - | - | 0.00000 € | 0 | - | - | 0 | - | - | 0.00000 €
71 | 0 |  |  |  |  |  | 0 | - | - | 0 | - | - | 0 | - | - | 0.00000 € | 0 | - | - | 0 | - | - | 0.00000 €
72 | 0 |  |  |  |  |  | 0 | - | - | 0 | - | - | 0 | - | - | 0.00000 € | 0 | - | - | 0 | - | - | 0.00000 €
73 | 0 |  |  |  |  |  | 0 | - | - | 0 | - | - | 0 | - | - | 0.00000 € | 0 | - | - | 0 | - | - | 0.00000 €
74 | 0 |  |  |  |  |  | 0 | - | - | 0 | - | - | 0 | - | - | 0.00000 € | 0 | - | - | 0 | - | - | 0.00000 €
75 | 0 |  |  |  |  |  | 0 | - | - | 0 | - | - | 0 | - | - | 0.00000 € | 0 | - | - | 0 | - | - | 0.00000 €
76 | 0 |  |  |  |  |  | 0 | - | - | 0 | - | - | 0 | - | - | 0.00000 € | 0 | - | - | 0 | - | - | 0.00000 €
77 | 0 |  |  |  |  |  | 0 | - | - | 0 | - | - | 0 | - | - | 0.00000 € | 0 | - | - | 0 | - | - | 0.00000 €
78 | 0 |  |  |  |  |  | 0 | - | - | 0 | - | - | 0 | - | - | 0.00000 € | 0 | - | - | 0 | - | - | 0.00000 €
79 | 0 |  |  |  |  |  | 0 | - | - | 0 | - | - | 0 | - | - | 0.00000 € | 0 | - | - | 0 | - | - | 0.00000 €
80 | 0 |  |  |  |  |  | 0 | - | - | 0 | - | - | 0 | - | - | 0.00000 € | 0 | - | - | 0 | - | - | 0.00000 €
81 | 0 |  |  |  |  |  | 0 | - | - | 0 | - | - | 0 | - | - | 0.00000 € | 0 | - | - | 0 | - | - | 0.00000 €
82 | 0 |  |  |  |  |  | 0 | - | - | 0 | - | - | 0 | - | - | 0.00000 € | 0 | - | - | 0 | - | - | 0.00000 €
83 | 0 |  |  |  |  |  | 0 | - | - | 0 | - | - | 0 | - | - | 0.00000 € | 0 | - | - | 0 | - | - | 0.00000 €
84 | 0 |  |  |  |  |  | 0 | - | - | 0 | - | - | 0 | - | - | 0.00000 € | 0 | - | - | 0 | - | - | 0.00000 €
85 | 0 |  |  |  |  |  | 0 | - | - | 0 | - | - | 0 | - | - | 0.00000 € | 0 | - | - | 0 | - | - | 0.00000 €
86 | 0 |  |  |  |  |  | 0 | - | - | 0 | - | - | 0 | - | - | 0.00000 € | 0 | - | - | 0 | - | - | 0.00000 €
87 | 0 |  |  |  |  |  | 0 | - | - | 0 | - | - | 0 | - | - | 0.00000 € | 0 | - | - | 0 | - | - | 0.00000 €
88 | 0 |  |  |  |  |  | 0 | - | - | 0 | - | - | 0 | - | - | 0.00000 € | 0 | - | - | 0 | - | - | 0.00000 €
89 | 0 |  |  |  |  |  | 0 | - | - | 0 | - | - | 0 | - | - | 0.00000 € | 0 | - | - | 0 | - | - | 0.00000 €
90 | 0 |  |  |  |  |  | 0 | - | - | 0 | - | - | 0 | - | - | 0.00000 € | 0 | - | - | 0 | - | - | 0.00000 €
91 | 0 |  |  |  |  |  | 0 | - | - | 0 | - | - | 0 | - | - | 0.00000 € | 0 | - | - | 0 | - | - | 0.00000 €
92 | 0 |  |  |  |  |  | 0 | - | - | 0 | - | - | 0 | - | - | 0.00000 € | 0 | - | - | 0 | - | - | 0.00000 €
93 | 0 |  |  |  |  |  | 0 | - | - | 0 | - | - | 0 | - | - | 0.00000 € | 0 | - | - | 0 | - | - | 0.00000 €
94 | 0 |  |  |  |  |  | 0 | - | - | 0 | - | - | 0 | - | - | 0.00000 € | 0 | - | - | 0 | - | - | 0.00000 €

Sheet: CPU BOM
BOM Version | 1
 | BATT_CPU_BOOM
Position | Qty | Part | Value | Device | Package | Unit Price | Extended Price | Link | Assembly
1 | 1 | BZ1 | KMCS0909E4000-R1 | BUZZER | PKMCS0909 | 0.43965 | 0.43965 | https://www.digikey.es/product-detail/en/murata-electronics/PKMCS0909E4000-R1/490-9647-1-ND/4878401
2 | 9 | C3, C5, C7, C9, C11, C13, C15, C18, C19 | 0.1UF 25V X7R | CAPACITOR | SMD 0603 | 0.00457 | 0.04113 | https://www.digikey.es/product-detail/en/samsung-electro-mechanics/CL10B104KA8NNNC/1276-1006-1-ND/3889092
3 | 2 | C16, C17 | 1UF 25V X5R | CAPACITOR | SMD-0603 | 0.00719 | 0.01438 | https://www.digikey.es/product-detail/en/samsung-electro-mechanics/CL10A105KA8NNNC/1276-1102-1-ND/3889188
4 | 6 | C1, C14, C6, C8, C10, C12 | 2.2UF 25V X7R | CAPACITOR | SMD 0805 | 0.03526 | 0.21156 | https://www.digikey.es/product-detail/en/samsung-electro-mechanics/CL21B225KAFNFNE/1276-2953-1-ND/3891039
5 | 2 | C2, C4 | 22PF 50V C0G/NP0 | CAPACITOR | SMD 0603 | 0.00876 | 0.01752 | https://www.digikey.es/product-detail/en/samsung-electro-mechanics/CL10C220JB81PNC/1276-2226-1-ND/3890312
6 | 4 | R6, R7, R8, R10 | 120k | RESISTOR | SMD 0402 |  | 0 | -
7 | 1 | R9 | 5k6 | RESISTOR | SMD 0402 |  | 0 | -
8 | 2 | R12, R15 | 2k4 | RESISTOR | SMD 0402 |  | 0 | -
9 | 2 | R3, R4 | 100R | RESISTOR | SMD 0402 |  | 0 | -
10 | 1 | R5 | 100k | RESISTOR | SMD 0402 |  | 0 | -
11 | 2 | R1, R2 | 2k2 | RESISTOR | SMD 0402 |  | 0 | -
12 | 1 | R45 | 330 | RESISTOR | SMD 0402 |  | 0 | -
13 | 1 | R16 | 36k | RESISTOR | SMD 0402 |  | 0 | -
14 | 1 | R13 | 62k | RESISTOR | SMD 0402 |  | 0 | -
15 | 1 | R11 | 8k2 | RESISTOR | SMD 0402 |  | 0 | -
16 | 1 | U1 | ATSAMD21G18_QFN | INTEGRATED CIRCUIT | TQFN48_7MM | 2.68 | 2.68 | https://www.digikey.es/product-detail/en/microchip-technology/ATSAMD21G18A-MFT/ATSAMD21G18A-MFTCT-ND/5119077
17 | 2 | U5,U6 | MAX9062EUK+T | INTEGRATED CIRCUIT | 21-0057F_MXM | 0.39683 | 0.79366 | https://www.digikey.es/product-detail/en/maxim-integrated/MAX9062EUK-T/MAX9062EUK-TCT-ND/2234693
18 | 1 | U7 | MCP6071T-E/OT | INTEGRATED CIRCUIT | SOT23-5 | 0.3878 | 0.3878 | https://www.digikey.es/product-detail/en/microchip-technology/MCP6071T-E-OT/MCP6071T-E-OTCT-ND/2618481
19 | 1 | L7 | MMZ2012Y202BT000 | INDUCTOR | SMD 0603 | 0.02112 | 0.02112 | https://www.digikey.es/product-detail/en/tdk-corporation/MMZ2012Y202BT000/445-1561-1-ND/571891
20 | 1 | U8 | SN74LVC1G19DBVR | INTEGRATED CIRCUIT | SOT23-6 | 0.08784 | 0.08784 | https://www.digikey.es/product-detail/en/texas-instruments/SN74LVC1G19DBVR/296-16982-1-ND/654766
21 | 2 | U2,U3 | TPS78230DDCR | INTEGRATED CIRCUIT | SOT23-5 | 0.30223 | 0.60446 | https://www.digikey.es/product-detail/en/texas-instruments/TPS78230DDCR/296-24372-1-ND/2051750
22 | 1 | U4 | TS3USB221A | INTEGRATED CIRCUIT | 10-UFQFN | 0.56488 | 0.56488 | https://www.digikey.es/product-detail/en/texas-instruments/TS3USB221AQRSERQ1/296-27719-1-ND/2356140
23 | 1 | X2 | XTAL-3.2X1.5 | OSCILLATOR | XTAL3215 | 0.57 | 0.57 | https://www.mouser.es/ProductDetail/ECS/ECS-327-125-12RR-TR?qs=9r4v7xj2Lnlp2XtvX%2FZgxw%3D%3D
Total |  |  |  |  |  |  | 6.434

Sheet: DCDC_BOM
BOM Version | 1
 | BATT_DCDC_BOOM
Position | Qty | Part | Value | Device | Package | Unit Price | Extended Price | Link | Assembly
1 | 3 | C1,C2, C24 | 0.1UF 25V X7R | CAPACITOR | SMD 0603 | 0.00457 | 0.01371 | https://www.digikey.es/product-detail/en/samsung-electro-mechanics/CL10B104KA8NNNC/1276-1006-1-ND/3889092
2 | 2 | C10, C20 | 0.47UF 25V X7R | CAPACITOR | SMD 0603 | 0.001739 | 0.003478 | https://www.digikey.es/product-detail/en/samsung-electro-mechanics/CL10B474KA8NFNC/1276-2082-1-ND/3890168
3 | 3 | C11, C12, C15 | 47UF 16V X6S | CAPACITOR | SMD 1210 | 0.153 | 0.459 | https://www.digikey.es/product-detail/en/GRM32EC81C476KE15L/490-10531-2-ND/5027615/?itemSeq=358253695
4 | 4 | C16, C17, C18, C19 | 47UF 25V X5R | CAPACITOR | SMD 1210 | 0.367 | 1.468 | https://www.digikey.es/product-detail/en/C3216X5R1E476M160AC/445-8047-1-ND/2792164/?itemSeq=358252465
5 | 1 | C21 | 2.2nF | CAPACITOR | SMD 0603 | 0.00694 | 0.00694 | https://www.digikey.es/product-detail/en/CL10B222KB8NNNC/1276-1110-6-ND/3891624/?itemSeq=358255759
6 | 1 | C22 | 270PF | CAPACITOR | SMD 0603 | 0.00928 | 0.00928 | https://www.digikey.es/product-detail/en/CC0603KRX7R9BB271/311-1185-1-ND/372898/?itemSeq=358257069
7 | 1 | D2 | B520C-13-F | DIODE | DIOM7959X250N | 0.17315 | 0.17315 | https://www.digikey.es/product-detail/en/B520C-13-F/B520C-FDICT-ND/806565/?itemSeq=358257331
8 | 1 | K3 | FLEX8 | CONNECTOR | FLEX8 | - | - | - | NO
9 | 1 | L1 | 2.2uH - 74437346022 | INDUCTOR | INDM7366X500 | 1.13 | 1.13 | https://www.mouser.es/ProductDetail/Wurth-Elektronik/74437346022
10 | 1 | Q1 | NVTFS9D6P04M8LTAG | TRANSISTOR | 8-PowerWDFN | 0.47992 | 0.47992 | https://www.digikey.es/product-detail/en/on-semiconductor/NVTFS9D6P04M8LTAG/488-NVTFS9D6P04M8LTAGCT-ND/11593208
11 | 2 | Q2, Q5 | 2N7002PW | TRANSISTOR | SOT323 | 0.03597 | 0.07194 | https://www.digikey.es/product-detail/en/2N7002PW%2c115/1727-4793-2-ND/2296328/?itemSeq=358257941
12 | 1 | R1 | 39k | RESISTOR | SMD 0402 | - | - | -
13 | 1 | R10 | 82k | RESISTOR | SMD 0402 | - | - | -
14 | 3 | R11, R13, R14 | 15k | RESISTOR | SMD 0402 | - | - | -
15 | 1 | R12 | 1k | RESISTOR | SMD 0402 | - | - | -
16 | 1 | R2 | 20k | RESISTOR | SMD 0402 | - | - | -
17 | 1 | R3 | 10k | RESISTOR | SMD 0402 | - | - | -
18 | 4 | R39, R40,R43,R38 | 78k7 | RESISTOR | SMD 0402 | - | - | -
19 | 3 | R4, R15, R16 | 470k | RESISTOR | SMD 0402 | - | - | -
20 | 1 | R41 | 56k2 | RESISTOR | SMD 0402 | - | - | -
21 | 2 | R5, R17 | 33 | RESISTOR | SMD 0402 | - | - | -
22 | 1 | R6 | 5k1 | RESISTOR | SMD 0402 | - | - | -
23 | 1 | R7 | 680k | RESISTOR | SMD 0402 | - | - | -
24 | 1 | R8 | 330k | RESISTOR | SMD 0402 | - | - | -
25 | 1 | R9 | 160k | RESISTOR | SMD 0402 | - | - | -
26 | 1 | RSENSE | 10mR | RESISTOR | SMD 0603 | 0.05544 | 0.05544 | 0
27 | 4 | TP1, TP2, TP3, TP4 | TESTPAD_TPSQTP15SQ | TESTPAD_TPSQTP15SQ | TESTPAD_TP15SQ | - | - | - | NO
28 | 2 | U$34, U$35 | FIDUCIAL" | FIDUCIAL" | FIDUCIAL_1MM | - | - | - | NO
29 | 1 | U1 | MCP6071T-E/OT | INTEGRATED CIRCUIT | SOT-23-5 | 0.3878 | 0.3878 | https://www.digikey.es/product-detail/en/MCP6071T-E%2fOT/MCP6071T-E%2fOTDKR-ND/2618488/?itemSeq=358258033
30 | 1 | U3 | TPS55330RTET | INTEGRATED CIRCUIT | RTE16_1P66X1P66_TEX | 1.7275 | 1.7275 | https://www.digikey.es/product-detail/en/texas-instruments/TPS55330RTET/296-36219-2-ND/4212800
31 | 1 | U7 | TPIC2810D | INTEGRATED CIRCUIT | SO16 | 0.54507 | 0.54507 | https://www.digikey.es/product-detail/en/texas-instruments/TPIC2810DR/296-46367-2-ND/1670586
Total |  |  |  |  |  |  | 6.531228

Sheet: DISPLAY BOM
BOM Version | 1
 | BATT_DISPLAY_BOOM
Position | Qty | Part | Value | Device | Package | Unit Price | Extended Price | Link | Assembly
1 | 3 | C2, C3, C5 | 0.1UF 25V X7R | CAPACITOR | SMD-0603 | 0.00457 | 0.01371 | https://www.digikey.es/product-detail/en/samsung-electro-mechanics/CL10B104KA8NNNC/1276-1006-1-ND/3889092
2 | 2 | C1, C4 | 10UF 16V X5R | CAPACITOR | SMD-0805 | 0.01677 | 0.03354 | https://www.digikey.es/product-detail/en/samsung-electro-mechanics/CL21A106KOQNNNG/1276-6455-1-ND/5958083
3 | 6 | R1, R2, R4, R6, R7, R8 | 10k | RESISTOR | SMD-0402 |  | 0 | -
4 | 1 | U1 | IS31FL3731-QFLS2-TR | INTEGRATED CIRCUIT | 28-WFQFN Exposed Pad | 0.67 | 0.67 | https://www.digikey.es/product-detail/en/lumissil-microsystems/IS31FL3731-QFLS2-TR/706-1219-1-ND/4286442
5 | 2 | S1, S2 | KXT311LHS | SWITCH | KXT311LHS | 0.09724 | 0.19448 | https://www.digikey.es/product-detail/en/c-k/KXT-311-LHS/CKN10777CT-ND/6599755
6 | 90 | C1-3, C1-4, C1-5, C1-6, C1-7, C1-8,C2-3, C2-4, C2-5, C2-6, C2-7, C2-8, C2-9, C2-10, C2-11, C2-12, C2-13, C2-14, C3-3, C3-4, C3-5, C3-6, C3-7, C3-8, C3-9, C3-10, C3-11, C3-12, C3-13, C3-14, C4-3, C4-4, C4-5, C4-6, C4-7, C4-8, C4-9, C4-10, C4-11, C4-12, C4-13, C4-14, C5-3, C5-4, C5-5, C5-6, C5-7, C5-8, C5-9, C5-10, C5-11, C5-12, C5-13, C5-14, C6-3, C6-4, C6-5, C6-6, C6-7, C6-8, C6-9, C6-10, C6-11, C6-12, C6-13, C6-14, C7-3, C7-4, C7-5, C7-6, C7-7, C7-8, C7-9, C7-10, C7-11, C7-12, C7-13, C7-14,C8-3, C8-4, C8-5, C8-6, C8-7, C8-8, C8-9, C8-10, C8-11, C8-12, C8-13, C8-14 | LED WHITE CLEAR | DIODE LED | CHIPLED_0402_NOOUTLINE | 0.03197 | 2.8773 | https://www.tme.eu/es/details/rf-wu0402ds-dd-b/leds-smd-blancos/refond/
7 | 7 | C1-2,C2-2,C3-2,C4-2,C5-2,C6-2, | LED GREEN CLEAR | DIODE LED | CHIPLED_0402_NOOUTLINE | 0.152 | 1.064 | https://eu.mouser.com/ProductDetail/Wurth-Elektronik/150040VS73240?qs=8Aam6%252B7C6HEhyesRm%252BQyFQ%3D%3D
8 | 5 | C8-2,C8-15,C7-15,C6-15,C2-15,C7-2 | LED YELLOW CLEAR | DIODE LED | CHIPLED_0402_NOOUTLINE | 0.152 | 0.76 | https://eu.mouser.com/ProductDetail/Wurth-Elektronik/150040YS73240?qs=8Aam6%252B7C6HFi%252BY4Pboxj6w%3D%3D
9 | 3 | C5-15,C4-15,C3-15, | LED RED CLEAR | DIODE LED | CHIPLED_0402_NOOUTLINE | 0.13 | 0.39 | https://eu.mouser.com/ProductDetail/Wurth-Elektronik/150040RS73240?qs=8Aam6%252B7C6HGMiInmnlrBiw%3D%3D
Total |  |  |  |  |  |  | 6.00303

Sheet: INPUT BOM
BOM Version | 1
 | BATT_INPUT_BOOM
Position | Qty | Part | Value | Device | Package | Unit Price | Extended Price | Link | Assembly
1 | 1 | C1 | 1UF 25V X5R | CAPACITOR | SMD-0603 | 0.00719 | 0.00719 | https://www.digikey.es/product-detail/en/samsung-electro-mechanics/CL10A105KA8NNNC/1276-1102-1-ND/3889188
2 | 3 | C2,C5,C6 | 0.1UF 25V X7R | CAPACITOR | SMD-0603 | 0.00457 | 0.01371 | https://www.digikey.es/product-detail/en/samsung-electro-mechanics/CL10B104KA8NNNC/1276-1006-1-ND/3889092
3 | 2 | C3,C23 | 10UF 16V X5R | CAPACITOR | SMD-0805 | 0.01677 | 0.03354 | https://www.digikey.es/product-detail/en/samsung-electro-mechanics/CL21A106KOQNNNG/1276-6455-1-ND/5958083
4 | 2 | RAWBATT+,RAWBATT- | - | PAD-CONECTOR | SMD2,54-5,08 |  | 0 | - | NO
5 | 5 | R6,R7,R11,R12,R17 | 10k | RESISTOR | SMD-0402 |  | 0 | -
6 | 1 | R5 | 1k | RESISTOR | SMD-0402 |  | 0 | -
7 | 1 | R1 | 1k1 | RESISTOR | SMD-0402 |  | 0 | -
8 | 1 | R2 | 220 | RESISTOR | SMD-0402 |  | 0 | -
9 | 1 | R4 | 2k2 | RESISTOR | SMD-0402 |  | 0 | -
10 | 1 | R20 | 330 | RESISTOR | SMD-0402 |  | 0 | -
11 | 2 | R8,R9 | 5k1 | RESISTOR | SMD-0402 |  | 0 | -
12 | 1 | R3 | 590 | RESISTOR | SMD-0402 |  | 0 | -
13 | 1 | J1 | 70AAJ-4-M0 | CONECTOR | SMD-0402 | 0.66451 | 0.66451 | https://www.digikey.es/product-detail/en/bourns-inc/70AAJ-4-M0G/70AAJ-4-M0GTR-ND/761020
14 | 1 | U5 | BQ24075 | INTEGRATED CIRCUIT | PVQFN-N16 | 0.88762 | 0.88762 | https://www.digikey.es/product-detail/en/texas-instruments/BQ24075TRGTR/296-25609-1-ND/2202275
15 | 2 | QD,QC | CSD16406Q3 | TRANSISTOR | 8-PowerTDFN | 0.42502 | 0.85004 | https://www.digikey.es/product-detail/en/texas-instruments/CSD16406Q3/296-24251-1-ND/2038321
16 | 1 | J4 | DX07S016JA1R1500 | CONECTOR | JAE_DX07S016JA1R1500 | 0.8085 | 0.8085 | https://www.digikey.es/product-detail/en/jae-electronics/DX07S016JA1R1500/670-DX07S016JA1R1500CT-ND/11586676
17 | 1 | U9 | BQ29700DSER | INTEGRATED CIRCUIT | 6-WFDFN | 0.1902 | 0.1902 | https://www.digikey.es/product-detail/en/texas-instruments/BQ29700DSER/296-43985-1-ND/5973209
18 | 1 | L1 | MMZ2012Y202BT000 | INDUCTOR | SMD 0603 | 0.02112 | 0.02112 | https://www.digikey.es/product-detail/en/tdk-corporation/MMZ2012Y202BT000/445-1561-1-ND/571891
19 | 1 |  | AT24C16D-STUM-T | FLASH MEMORY | SOT23-5 | 0.17 | 0.17 | https://www.digikey.es/product-detail/en/microchip-technology/AT24C16D-STUM-T/AT24C16D-STUM-TCT-ND/5055821
Total |  |  |  |  |  |  | 3.64643

Sheet: PUSHBUTTON
BOM Version | 1
 | BATT_PUSHBUTTON_BOOM
Position | Qty | Part | Value | Device | Package | Unit Price | Extended Price | Link | Assembly
1 | 1 | D1 | APA3010ZGC-GX | DIODE LED | 2-SMD, No Lead | 0.19017 | 0.19017 | https://www.digikey.es/product-detail/en/kingbright/APA3010ZGC-GX/754-1575-1-ND/2757964
2 | 1 | R1 | 10k | RESISTOR | SMD-0402 |  | 0 | -
3 | 1 | S1 | KXT311LHS | SWITCH | KXT311LHS | 0.09724 | 0.09724 | https://www.digikey.es/product-detail/en/c-k/KXT-311-LHS/CKN10777CT-ND/6599755
Total |  |  |  |  |  |  | 0.28741

Sheet: History
 | HISTORY
BOM version | PCB version | PBA version | Date | Author | Description
1 | 1 | 1 | 2020-03-10 | JRC | Creation
2 | 1 | 1 | 5 abr | DGB | Corrections
3 | 1 | 1 | 2021-04-06 | JRC | PANELs sheet
4 | 1 | 1 | 2021-04-07 | JRC | Componentes en imput y en pushbutton. Corregido cantidades por PCB

Sheet: CONTACT
Document property of:
EXINOM CORE SL
Calle Aranjuez, 513
28805
Alcala de Henares
Spain
mail | david@exinom.com
mobile | +34 603486681
