MSTKMAD/battery-pack/02.Hardware/BOMs/History/Battery_BOM_Components(DISTRIBUTORS)_v6.xlsx

 | BATT_BOM
Position | Total Qty | Value | Device | Package | Unit Price | Links
1 | 2 | 22PF 50V C0G/NP0 | CAPACITOR | SMD 0603 | 0.00876 € | https://www.digikey.es/product-detail/en/samsung-electro-mechanics/CL10C220JB81PNC/1276-2226-1-ND/3890312
2 | 1 | 270PF | CAPACITOR | SMD 0603 | 0.00928 € | https://www.digikey.es/product-detail/en/CC0603KRX7R9BB271/311-1185-1-ND/372898/?itemSeq=358257069
3 | 1 | 2.2nF | CAPACITOR | SMD 0603 | 0.00694 € | https://www.digikey.es/product-detail/en/CL10B222KB8NNNC/1276-1110-6-ND/3891624/?itemSeq=358255759
4 | 21 | 0.1UF 25V X7R | CAPACITOR | SMD 0603 | 0.00457 € | https://www.digikey.es/product-detail/en/samsung-electro-mechanics/CL10B104KA8NNNC/1276-1006-1-ND/3889092
5 | 2 | 0.47UF 25V X7R | CAPACITOR | SMD 0603 | 0.00174 € | https://www.digikey.es/product-detail/en/samsung-electro-mechanics/CL10B474KA8NFNC/1276-2082-1-ND/3890168
6 | 4 | 1UF 25V X5R | CAPACITOR | SMD-0603 | 0.00719 € | https://www.digikey.es/product-detail/en/samsung-electro-mechanics/CL10A105KA8NNNC/1276-1102-1-ND/3889188
7 | 6 | 2.2UF 25V X7R | CAPACITOR | SMD 0805 | 0.03526 € | https://www.digikey.es/product-detail/en/samsung-electro-mechanics/CL21B225KAFNFNE/1276-2953-1-ND/3891039
8 | 6 | 10UF 16V X5R | CAPACITOR | SMD-0805 | 0.01677 € | https://www.digikey.es/product-detail/en/samsung-electro-mechanics/CL21A106KOQNNNG/1276-6455-1-ND/5958083
9 | 3 | 47UF 16V X6S | CAPACITOR | SMD 1210 | 0.15300 € | https://www.digikey.es/product-detail/en/GRM32EC81C476KE15L/490-10531-2-ND/5027615/?itemSeq=358253695
10 | 4 | 47UF 25V X5R | CAPACITOR | SMD 1210 | 0.36700 € | https://www.digikey.es/product-detail/en/C3216X5R1E476M160AC/445-8047-1-ND/2792164/?itemSeq=358252465
11 | 1 | 10mR | RESISTOR | SMD 0603 |  | -
12 | 2 | 33 | RESISTOR | SMD 0402 |  | -
13 | 2 | 100R | RESISTOR | SMD 0402 |  | -
14 | 2 | 220 | RESISTOR | SMD-0402 |  | -
15 | 3 | 330 | RESISTOR | SMD 0402 |  | -
16 | 2 | 590 | RESISTOR | SMD-0402 |  | -
17 | 3 | 1k | RESISTOR | SMD-0402 |  | -
18 | 2 | 1k1 | RESISTOR | SMD-0402 |  | -
19 | 4 | 2k2 | RESISTOR | SMD-0402 |  | -
20 | 2 | 2k4 | RESISTOR | SMD 0402 |  | -
21 | 5 | 5k1 | RESISTOR | SMD 0402 |  | -
22 | 1 | 5k6 | RESISTOR | SMD 0402 |  | -
23 | 1 | 8k2 | RESISTOR | SMD 0402 |  | -
24 | 19 | 10k | RESISTOR | SMD 0402 |  | -
25 | 3 | 15k | RESISTOR | SMD 0402 |  | -
26 | 1 | 20k | RESISTOR | SMD 0402 |  | -
27 | 1 | 36k | RESISTOR | SMD 0402 |  | -
28 | 1 | 39k | RESISTOR | SMD 0402 |  | -
29 | 1 | 56k2 | RESISTOR | SMD 0402 |  | -
30 | 1 | 62k | RESISTOR | SMD 0402 |  | -
31 | 4 | 78k7 | RESISTOR | SMD 0402 |  | -
32 | 1 | 82k | RESISTOR | SMD 0402 |  | -
33 | 1 | 100k | RESISTOR | SMD 0402 |  | -
34 | 4 | 120k | RESISTOR | SMD 0402 |  | -
35 | 1 | 160k | RESISTOR | SMD 0402 |  | -
36 | 1 | 330k | RESISTOR | SMD 0402 |  | -
37 | 3 | 470k | RESISTOR | SMD 0402 |  | -
38 | 1 | 680k | RESISTOR | SMD 0402 |  | -
39 | 1 | KMCS0909E4000-R1 | BUZZER | PKMCS0909 | 0.43965 € | https://www.digikey.es/product-detail/en/murata-electronics/PKMCS0909E4000-R1/490-9647-1-ND/4878401
40 | 1 | ATSAMD21G18_QFN | INTEGRATED CIRCUIT | TQFN48_7MM | 2.68000 € | https://www.digikey.es/product-detail/en/microchip-technology/ATSAMD21G18A-MFT/ATSAMD21G18A-MFTCT-ND/5119077
41 | 2 | MAX9062EUK+T | INTEGRATED CIRCUIT | 21-0057F_MXM | 0.39683 € | https://www.digikey.es/product-detail/en/maxim-integrated/MAX9062EUK-T/MAX9062EUK-TCT-ND/2234693
42 | 1 | MCP6071T-E/OT | INTEGRATED CIRCUIT | SOT23-5 | 0.38780 € | https://www.digikey.es/product-detail/en/microchip-technology/MCP6071T-E-OT/MCP6071T-E-OTCT-ND/2618481
43 | 3 | MMZ2012Y202BT000 | INDUCTOR | SMD 0603 | 0.02112 € | https://www.digikey.es/product-detail/en/tdk-corporation/MMZ2012Y202BT000/445-1561-1-ND/571891
44 | 1 | SN74LVC1G19DBVR | INTEGRATED CIRCUIT | SOT23-6 | 0.08784 € | https://www.digikey.es/product-detail/en/texas-instruments/SN74LVC1G19DBVR/296-16982-1-ND/654766
45 | 2 | TPS78230DDCR | INTEGRATED CIRCUIT | SOT23-5 | 0.30223 € | https://www.digikey.es/product-detail/en/texas-instruments/TPS78230DDCR/296-24372-1-ND/2051750
46 | 1 | TS3USB221A | INTEGRATED CIRCUIT | 10-UFQFN | 0.56488 € | https://www.digikey.es/product-detail/en/texas-instruments/TS3USB221AQRSERQ1/296-27719-1-ND/2356140
47 | 1 | XTAL-3.2X1.5 | OSCILLATOR | XTAL3215 | 0.57000 € | https://www.mouser.es/ProductDetail/ECS/ECS-327-125-12RR-TR?qs=9r4v7xj2Lnlp2XtvX%2FZgxw%3D%3D
48 | 1 | B520C-13-F | DIODE | DIOM7959X250N | 0.17315 € | https://www.digikey.es/product-detail/en/B520C-13-F/B520C-FDICT-ND/806565/?itemSeq=358257331
49 | 1 | 2.2uH - 74437346022 | INDUCTOR | INDM7366X500 | 1.13000 € | https://www.mouser.es/ProductDetail/Wurth-Elektronik/74437346022
50 | 1 | NVTFS9D6P04M8LTAG | TRANSISTOR | 8-PowerWDFN | 0.47992 € | https://www.digikey.es/product-detail/en/on-semiconductor/NVTFS9D6P04M8LTAG/488-NVTFS9D6P04M8LTAGCT-ND/11593208
51 | 2 | 2N7002PW | TRANSISTOR | SOT323 | 0.03597 € | https://www.digikey.es/product-detail/en/2N7002PW%2c115/1727-4793-2-ND/2296328/?itemSeq=358257941
52 | 1 | MCP6071T-E/OT | INTEGRATED CIRCUIT | SOT-23-5 | 0.38780 € | https://www.digikey.es/product-detail/en/MCP6071T-E%2fOT/MCP6071T-E%2fOTDKR-ND/2618488/?itemSeq=358258033
53 | 1 | TPS55330RTET | INTEGRATED CIRCUIT | RTE16_1P66X1P66_TEX | 1.72750 € | https://www.digikey.es/product-detail/en/texas-instruments/TPS55330RTET/296-36219-2-ND/4212800
54 | 1 | TPIC2810D | INTEGRATED CIRCUIT | SO16 | 0.54507 € | https://www.digikey.es/product-detail/en/texas-instruments/TPIC2810DR/296-46367-2-ND/1670586
55 | 1 | IS31FL3731-QFLS2-TR | INTEGRATED CIRCUIT | 28-WFQFN Exposed Pad | 0.67000 € | https://www.digikey.es/product-detail/en/lumissil-microsystems/IS31FL3731-QFLS2-TR/706-1219-1-ND/4286442
56 | 4 | KXT311LHS | SWITCH | KXT311LHS | 0.09724 € | https://www.digikey.es/product-detail/en/c-k/KXT-311-LHS/CKN10777CT-ND/6599755
57 | 90 | LED WHITE CLEAR | DIODE LED | CHIPLED_0402_NOOUTLINE | 0.03197 € | https://www.tme.eu/es/details/rf-wu0402ds-dd-b/leds-smd-blancos/refond/
58 | 2 | 70AAJ-4-M0 | CONECTOR | SMD-0402 | 0.66451 € | https://www.digikey.es/product-detail/en/bourns-inc/70AAJ-4-M0G/70AAJ-4-M0GTR-ND/761020
59 | 2 | BQ24075 | INTEGRATED CIRCUIT | PVQFN-N16 | 0.88762 € | https://www.digikey.es/product-detail/en/texas-instruments/BQ24075TRGTR/296-25609-1-ND/2202275
60 | 4 | CSD16406Q3 | TRANSISTOR | 8-PowerTDFN | 0.42502 € | https://www.digikey.es/product-detail/en/texas-instruments/CSD16406Q3/296-24251-1-ND/2038321
61 | 2 | DX07S016JA1R1500 | CONECTOR | JAE_DX07S016JA1R1500 | 0.80850 € | https://www.digikey.es/product-detail/en/jae-electronics/DX07S016JA1R1500/670-DX07S016JA1R1500CT-ND/11586676
62 | 2 | BQ29700DSER | INTEGRATED CIRCUIT | 6-WFDFN | 0.19020 € | https://www.digikey.es/product-detail/en/texas-instruments/BQ29700DSER/296-43985-1-ND/5973209
63 | 5 | LED YELLOW CLEAR | DIODE LED | CHIPLED_0402_NOOUTLINE | 0.15200 € | https://eu.mouser.com/ProductDetail/Wurth-Elektronik/150040YS73240?qs=8Aam6%252B7C6HFi%252BY4Pboxj6w%3D%3D
64 | 3 | LED RED CLEAR | DIODE LED | CHIPLED_0402_NOOUTLINE | 0.13000 € | https://eu.mouser.com/ProductDetail/Wurth-Elektronik/150040RS73240?qs=8Aam6%252B7C6HGMiInmnlrBiw%3D%3D
65 | 7 | LED GREEN CLEAR | DIODE LED | CHIPLED_0402_NOOUTLINE | 0.15200 € | https://eu.mouser.com/ProductDetail/Wurth-Elektronik/150040VS73240?qs=8Aam6%252B7C6HEhyesRm%252BQyFQ%3D%3D
66 | 2 | APA3010ZGC-GX | DIODE LED | 2-SMD, No Lead | 0.19017 € | https://www.digikey.es/product-detail/en/kingbright/APA3010ZGC-GX/754-1575-1-ND/2757964
67 | 2 | AT24C16D-STUM-T | FLASH MEMORY | SOT23-5 | 0.17000 € | https://www.digikey.es/product-detail/en/microchip-technology/AT24C16D-STUM-T/AT24C16D-STUM-TCT-ND/5055821
