MSTKMAD/battery-pack/02.Hardware/V1-ROVER-2K/BOMs/BOOSTDCDC_BATT_BOM_v4.xlsx

Sheet: BOM
BOM Version | 4
 | BOOST DCDC BATTERY
Position | Qty | Part | Value | Device | Package | Assembly
1 | 1 | L1 | 2.2uH | INDUCTOR | INDM7366X500 | YES
2 | 1 | C12 | 1.0uF - 25 V - 10% | CAPACITOR | 1206-CAP | YES
3 | 3 | C5, C11, C25 | 100n - 25V - 10% | CAPACITOR | SMD 0805 | YES
4 | 2 | C21, C24 | 100n -25V - 10% | CAPACITOR | SMD 0805 | YES
5 | 1 | C6 | 1uF - 25 V - 10% | CAPACITOR | SMD 0805 | YES
6 | 1 | C22 | 270p - 25 V - 10% | CAPACITOR | SMD 0805 | YES
7 | 1 | C9 | 470n - 25 V - 10% | CAPACITOR | SMD 0805 | YES
8 | 2 | C10, C20 | 47n - 25 V - 10% | CAPACITOR | SMD 0805 | YES
9 | 3 | C3, C13, C23 | 10uF - 25 V - 10 % | CAPACITOR | SMD 0805 | YES
10 | 1 | U4 | AP2205-W5-33Y | INTEGRATED CIRCUIT | SOT95P282X145-5N | YES
11 | 1 | D2 | B520C-13-F | DIODE | DIOM7959X250N | YES
12 | 1 | U5 | BQ24075 | INTEGRATED CIRCUIT | PVQFN-N16 | YES
13 | 1 | U3 | BQ27441-G1 | INTEGRATED CIRCUIT | PDSO-N12 | YES
14 | 3 | C1, C27, C44 | 100n - 25 V - 10 % | CAPACITOR | SMD 0805 | YES
15 | 2 | C4, C72 | N.C. | CAPACITOR | SMD 0805 | NO
16 | 2 | C7, C8 | 4.7uF - 25 V - 10% | CAPACITOR | SMD 0805 | YES
17 | 1 | D3 | GREEN | DIODE | LED_3MM | NO
18 | 1 | D1 | BLUE | DIODE | LED-0603 | YES
19 | 1 | D4 | RED | DIODE | LED-0603 | YES
20 | 2 | U2, U6 | MAX9938TEUK+T (G=25) | INTEGRATED CIRCUIT | SOT95P280X145-5N | YES
21 | 1 | U11 | MCP6L02SN | INTEGRATED CIRCUIT | SOIC 8 | YES
22 | 2 | Q2, Q4 | 2N7002PW | TRANSISTOR | SOT323 | YES
23 | 1 | J3 | PJRAN1X1U01X | CONNECTOR | PJRAN1X1U01X | NO
24 | 1 | BZ1 | PKMCS0909E4000-R1 | BUZZER | PKMCS0909 | YES
25 | 1 | R41 | 1.87k | RESISTOR | SMD 0805 | YES
26 | 3 | R29, R31, R46 | 10k | RESISTOR | SMD 0805 | YES
27 | 1 | R9 | 150k | RESISTOR | SMD 0805 | YES
28 | 3 | R3, R11, R12 | 1M | RESISTOR | SMD 0805 | YES
29 | 2 | R17, R45 | 330R | RESISTOR | SMD 0805 | YES
30 | 2 | R5, R33 | 33R | RESISTOR | SMD 0805 | YES
31 | 2 | R8, R27 | 39k | RESISTOR | SMD 0805 | YES
32 | 2 | R4, R32 | 470k | RESISTOR | SMD 0805 | YES
33 | 2 | R21, R22 | 4k7 | RESISTOR | SMD 0805 | YES
34 | 1 | R26 | 75k | RESISTOR | SMD 0805 | YES
35 | 4 | R38, R39, R40, R43 | 78.7k | RESISTOR | SMD 0805 | YES
36 | 4 | RTMR, R_ILIM, R_ISET, R_TS | N.C | RESISTOR | SMD 0805 | NO
37 | 1 | R51 | 1.1k | RESISTOR | SMD 0805 | YES
38 | 1 | R71 | 100k | RESISTOR | SMD 0805 | YES
39 | 4 | R1, R2, R53, R70 | 10k | RESISTOR | SMD 0805 | YES
40 | 1 | R20 | 11k | RESISTOR | SMD 0805 | YES
41 | 2 | R10, R47 | 180R | RESISTOR | SMD 0805 | YES
42 | 1 | R34 | 180k | RESISTOR | SMD 0805 | YES
43 | 1 | R30 | 1k4 | RESISTOR | SMD 0805 | YES
44 | 1 | R48 | 1k | RESISTOR | SMD 0805 | YES
45 | 1 | R24 | 200R | RESISTOR | SMD 0805 | YES
46 | 1 | R37 | 22k | RESISTOR | SMD 0805 | YES
47 | 1 | R25 | 2k8 | RESISTOR | SMD 0805 | YES
48 | 1 | R7 | 330k | RESISTOR | SMD 0805 | YES
49 | 1 | R42 | 3k3 | RESISTOR | SMD 0805 | YES
50 | 1 | R36 | 43k | RESISTOR | SMD 0805 | YES
51 | 1 | R49 | 590R | RESISTOR | SMD 0805 | YES
52 | 1 | R23 | 5k6 | RESISTOR | SMD 0805 | YES
53 | 1 | R6 | 82k | RESISTOR | SMD 0805 | YES
54 | 1 | R35 | 91k | RESISTOR | SMD 0805 | YES
55 | 1 | L7 | MMZ2012Y202BT000 | INDUCTOR | SMD 0805 | NO
56 | 1 | U8 | SN74LVC1G19DBVR | INTEGRATED CIRCUIT | DBV6 | YES
57 | 1 | U7 | TPIC2810D | INTEGRATED CIRCUIT | SOIC 16 | YES
58 | 1 | U1 | TPS55330RTET | INTEGRATED CIRCUIT | RTE16_1P66X1P66_TEX | YES
59 | 3 | C2, C14, C15, | 47uF - 16 V - 10% | CAPACITOR | SMD 1210 | YES
60 | 2 | R15, R16 | 0.01R | RESISTOR | SMD 1206 | YES
61 | 4 | C16, C17, C18, C19 | 47uF - 25 V - 10% | CAPACITOR | SMD 1210 | YES

Sheet: History
 | HISTORY
BOM version | PCB version | PBA version | Date | Author | Description
1 | 1 | 1 | 2020-09-16 | JRC | Creation
2 | 1 | 1 | 2020-09-16 | DGB | Review
3 | 1 | 1 | 2020-09-18 | JRC | Modification: Added pos61 with new voltage value for capacitors C16, C17, C18, C19

Sheet: Contact Info
Document property of:
EXINOM CORE SL
Calle Aranjuez, 513
28805
Alcala de Henares
Spain
mail | david@exinom.com
mobile | +34 603486681
