MSTKMAD/battery-pack/02.HARDWARE/V2-ROVER R-1/04.PRODUCCION/SETI-BATCH-5_OCT2024/02-BOM/BATT_CONNECTOR.xlsx

Sheet: BATT_CONNECTOR
BOM Version | VERSION | 5
 | BATT_CONNECTOR_BOOM
Position | NEW | Qty | Part | Value | Device | Package | Sustitutive | Link
1 | NO | 1 | Q1 | DMG3415U-7 | Transistor | SOT23-3 |  | https://www.digikey.es/en/products/detail/diodes-incorporated/DMG3415U-7/2052768
2 | NO | 2 | H1, H2 | S1761-42R | Contact |  |  | https://www.digikey.es/es/products/detail/harwin-inc/S1761-42R/2264460?s=N4IgTCBcDaIMoEYDsA2BBaALGASiAugL5A
3 | NO | 1 | D1 | SM2T18A | Transil | DO-216AA | SMF16A (https://www.digikey.es/en/products/detail/littelfuse-inc/SMF16A/3672398) | https://www.digikey.es/es/products/detail/stmicroelectronics/SM2T18A/1039058?s=N4IgTCBcDaIMoFkwBUCMAOAgiAugXyA

Sheet: _HISTORY
HISTORY
version | fecha | autor | cambios
1 | 2022-11-09 | JRC | Creacion
2 | 2022-11-15 | DGB | Añadida descripcion de componentes y numero de posicion
3 | 5-ENE-23 | DGB | Se cambia Q1. Actualizado package de D1
4 | 2023-09-26 | DGB | Se actualiza columna NEW para nueva produccion SETI
5 | 2023-11-15 | DGB | Se añade sustitutivo en pos 3

Sheet: CONTACT INFO
Document property of:
EXINOM CORE SL
Calle Aranjuez, 513
28805
Alcala de Henares
Spain
mail | david@exinom.com
mobile | +34 603486681
