MSTKMAD/battery-pack/02.HARDWARE/V2-ROVER R-1/02.BOM/TEST_CPU.xlsx

Sheet: TEST_CPU
BOM VERSION | 2
 | TEST CPU
Position | NEW | Qty | Part | Value | Device | Package | Unit Price | Extended Price | Link
1 |  | 9 | C1, C2, C3, C4, C5, C8, C9, C10, C11 | 100n | CAPACITOR | SMD-0805
2 |  | 1 | C13 | 10u | CAPACITOR | SMD-0805
3 |  | 1 | C6 | 1.0uF | CAPACITOR | SMD-0805
4 |  | 1 | C7 | 4.7uF | CAPACITOR | SMD-0805
5 |  | 1 | D3 |  | DIODE LED | LED_3MM
6 |  | 1 | DISPLAY | Display | OLED_LCD | OLED_LCD
7 |  | 1 | J1 |  | CONNECTOR | 2X10
8 |  | 1 | J2 | 302-S201 | CONNECTOR | SHDR20W66P254_2X10_3300X905X90
9 |  | 1 | J3 | DF40C-20DP-0.4V_51_ | CONNECTOR | DF40C-20DPA
10 |  | 2 | JP1, JP2 | JUMPER-SMT_2_NC_PASTE_SILK | JUMPER-SMT_2_NC_PASTE_SILK | SMT-JUMPER_2_NC_PASTE_SILK
11 |  | 2 | Q4, Q5 | 2N7002PW | TRANSISTOR | SOT323
12 |  | 2 | R1, R3 | 1k2 | RESISTOR | SMD-0805
13 |  | 7 | R11, R12, R13, R14, R16, R28, R30 | 51k | RESISTOR | SMD-0805
14 |  | 1 | R15 | 120 | RESISTOR | SMD-0805
15 |  | 2 | R17, R18 | 51 | RESISTOR | SMD-0805
16 |  | 1 | R19 | 910k | RESISTOR | SMD-0805
17 |  | 2 | R2, R4 | 1k | RESISTOR | SMD-0805
18 |  | 5 | R20, R21, R22, R24, R29 | 33 | RESISTOR | SMD-0805
19 |  | 1 | R23 | 180k | RESISTOR | SMD-0805
20 |  | 1 | R25 | 68k | RESISTOR | SMD-0805
21 |  | 1 | R26 | 430k | RESISTOR | SMD-0805
22 |  | 1 | R27 | N:C | RESISTOR | SMD-0805
23 |  | 1 | R40 | 360 | RESISTOR | SMD-0805
24 |  | 3 | R5, R7, R9 | 2k2 | RESISTOR | SMD-0805
25 |  | 3 | R6, R8, R10 | 150 | RESISTOR | SMD-0805
26 |  | 1 | R66 | 10k | RESISTOR | SMD-0805
27 |  | 3 | S3, S4, S5 | MOMENTARY-SWITCH-SPST-SMD-5.2MM | SWITCH | TACTILE_SWITCH_SMD_5.2MM
28 |  | 1 | U1 | MCP1825T-ADJE/DCSOT-223_5MC_MCH-M | INTEGRATED CIRCUIT | SOT-223_5MC_MCH-M
29 |  | 1 | U3 | ATE1D-5M3-10-Z | INTEGRATED CIRCUIT | SPDT05_ATE1D_9P5X8_NDC
30 |  | 1 | U4 |  | INTEGRATED CIRCUIT | RPI_PICO_TH

Sheet: _HISTORY
HISTORY
version | fecha | autor | cambios
1 | 2023-01-17 | JRC | Creacion
2 | 2023-01-24 | JRC | Asiganacion de valores a componentes pasivos
