MSTKMAD/battery-pack/02.HARDWARE/V2-ROVER R-1/02.BOM/TEST_DCDC.xlsx

Sheet: TEST_DCDC
BOM VERSION | 2
 | TEST DCDC
Position | NEW | Qty | Part | Value | Device | Package | Unit Price | Extended Price | Link
1 |  | 6 | C1, C2, C3, C4, C5, C13 | 100n | CAPACITOR | SMD-0805
2 |  | 3 | D1, D2, D4 | 250mA/100V | DIODE | SOD-323
3 |  | 2 | D3, D5 |  | DIODE LED | LED_3MM
4 |  | 1 | DISPLAY | Display | DISPLAY | OLED_LCD
5 |  | 1 | J1 | FEMALE 2x3 | CONNECTOR | 2X3
6 |  | 3 | J2, J3, J4 | OSTVN03A150 | CONNECTOR | OSTVN03A150
7 |  | 1 | J5 | ACJS-MHDR | CONNECTOR | CONN_MHDR_AMP
8 |  | 4 | J6, J7, J8, J9 |  | CONNECTOR | 1X02
9 |  | 1 | JP1 | JUMPER-SMT_3_1-NC_PASTE_SILK | JUMPER-SMT_3_1-NC_PASTE_SILK | SMT-JUMPER_3_1-NC_PASTE_SILK
10 |  | 3 | Q1, Q2, Q3 | PJA3416AE_R1_00001 | TRANSISTOR | SOT23_PJA3416_PNJ
11 |  | 1 | Q4 | 310mA/60V/1.6Î© | TRANSISTOR | SOT323
12 |  | 2 | R1, R66 | 10k | RESISTOR | SMD-0805
13 |  | 3 | R11, R13, R15 | 47 | RESISTOR | SMD-0805
14 |  | 3 | R12, R14, R16 | 51k | RESISTOR | SMD-0805
15 |  | 5 | R2, R3, R5, R7, R9 | 2k2 | RESISTOR | SMD-0805
16 |  | 5 | R20, R21, R22, R24, R29 | 33 | RESISTOR | SMD-0805
17 |  | 2 | R4, R40 | 360 | RESISTOR | SMD-0805
18 |  | 3 | R6, R8, R10 | 150 | RESISTOR | SMD-0805
19 |  | 3 | S3, S4, S5 | MOMENTARY-SWITCH-SPST-SMD-5.2MM | SWITCH | TACTILE_SWITCH_SMD_5.2MM
 |  | 1 | U1 | MCP4725 | INTEGRATED CIRCUIT | SOT23-6
 |  | 1 | U3 | ATE1D-5M3-10-Z | INTEGRATED CIRCUIT | SPDT05_ATE1D_9P5X8_NDC
 |  | 1 | U4 |  | INTEGRATED CIRCUIT | RPI_PICO_TH
 |  | 1 | Z1 | BZT52C3V6-7-F | DIODE | SOD3716X135N

Sheet: _HISTORY
HISTORY
version | fecha | autor | cambios
1 | 2023-01-17 | JRC | Creacion
2 | 2023-01-24 | JRC | Asignacion de valores de componentes pasivos

Sheet: CONTACT INFO
Document property of:
EXINOM CORE SL
Calle Aranjuez, 513
28805
Alcala de Henares
Spain
mail | david@exinom.com
mobile | +34 603486681
