MSTKMAD/battery-pack/02.Hardware/V1-ROVER-2K/Battery PCBs/SHIELD_TEST_INPUT/BOM/SHIELD_TEST_INPUT.xlsx

Qty | Value | Device | Package | Parts
1 |  | CONN_04 | 1X04 | J1
2 |  | LED0603 | LED-0603 | D1, D4
1 | 0.010 | RESISTOR1206 | 1206 | R12
1 | 0.1uF | 0.1UF-0603-25V-(+80/-20%) | 603 | C5
1 | 100 | RESISTOR0805 | 805 | R1
1 | 10K | RESISTOR0805-RES | 805 | R4
2 | 10k | RESISTOR0805 | 805 | R7, R10
1 | 10uF | CAP1206 | 1206 | C43
4 | 1N4148WSF-7 | 1N4148WSF-7 | SOD323F_DIO | CR1, CR2, CR3, CR4
2 | 250mA/100V | DIODE-BAS16J | SOD-323 | D2, D3
2 | 2N7002PW | MOSFET-NCHANNEL2N7002PW | SOT323 | Q2, Q5
2 | 330 | RESISTOR0805 | 805 | R5, R6
1 | 470 | RESISTOR0805 | 805 | R2
2 | 5k1 | RESISTOR0805 | 805 | R8, R9
1 | ARDUINO_UNO_R3_SHIELDBASIC | ARDUINO_UNO_R3_SHIELDBASIC | UNO_R3_SHIELD | B1
1 | DX07S016JA1R1500 | DX07S016JA1R1500 | JAE_DX07S016JA1R1500 | J2
2 | G5V-1-T90_DC5 | G5V-1-T90_DC5 | RELAY_G5V-1_OMR | K1, K3
1 | MAX9938FEUK+T | MAX9938FEUK+T | SOT95P280X145-5N | U4
2 | TEST-POINT2 | TEST-POINT2 | PAD.02X.02 | BATT+, BATT-
