MSTKMAD/battery-pack/02.HARDWARE/V2-ROVER R-1/01.PCB/BATT_PCB_CHEYENNE_JACK/GERBER/pcbway order 4-11.png

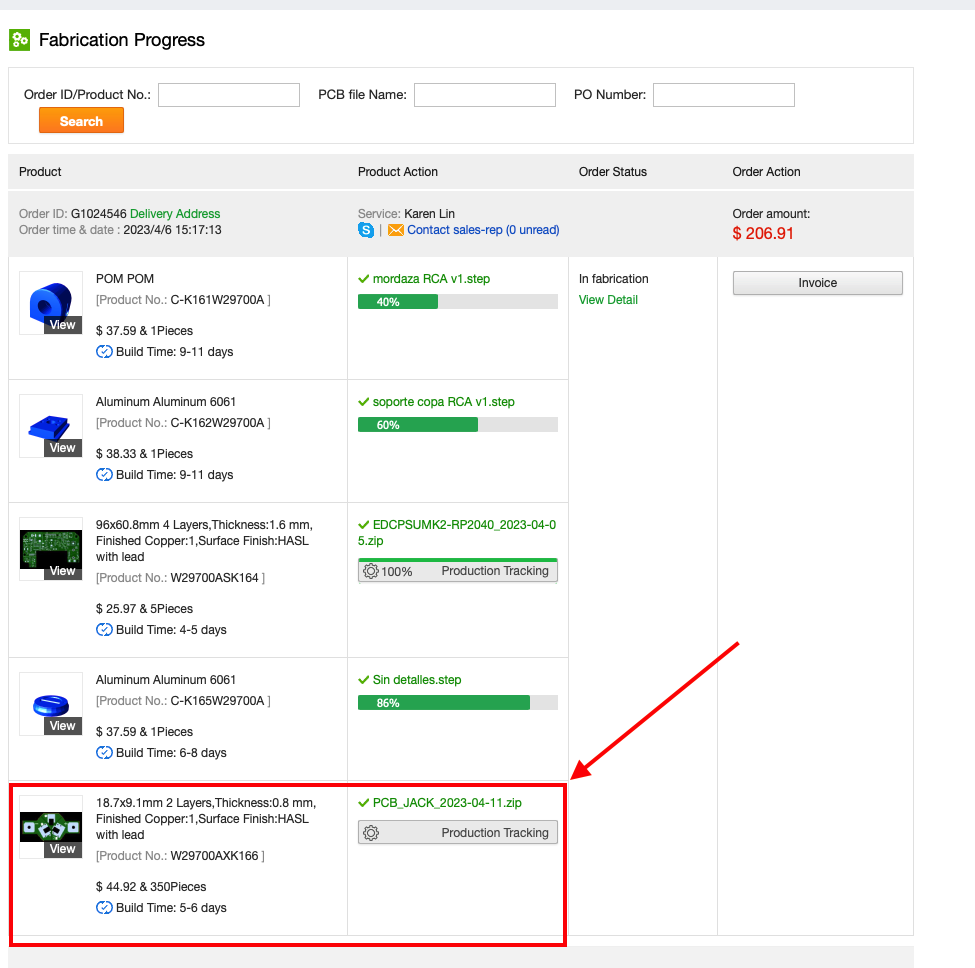
02.HARDWARE/V2-ROVER R-1/01.PCB/BATT_PCB_CHEYENNE_JACK/GERBER/pcbway order 4-11.png
