MSTKMAD/battery-pack/01.Documentation/03.Venus/PCB diana 3pin.dxf

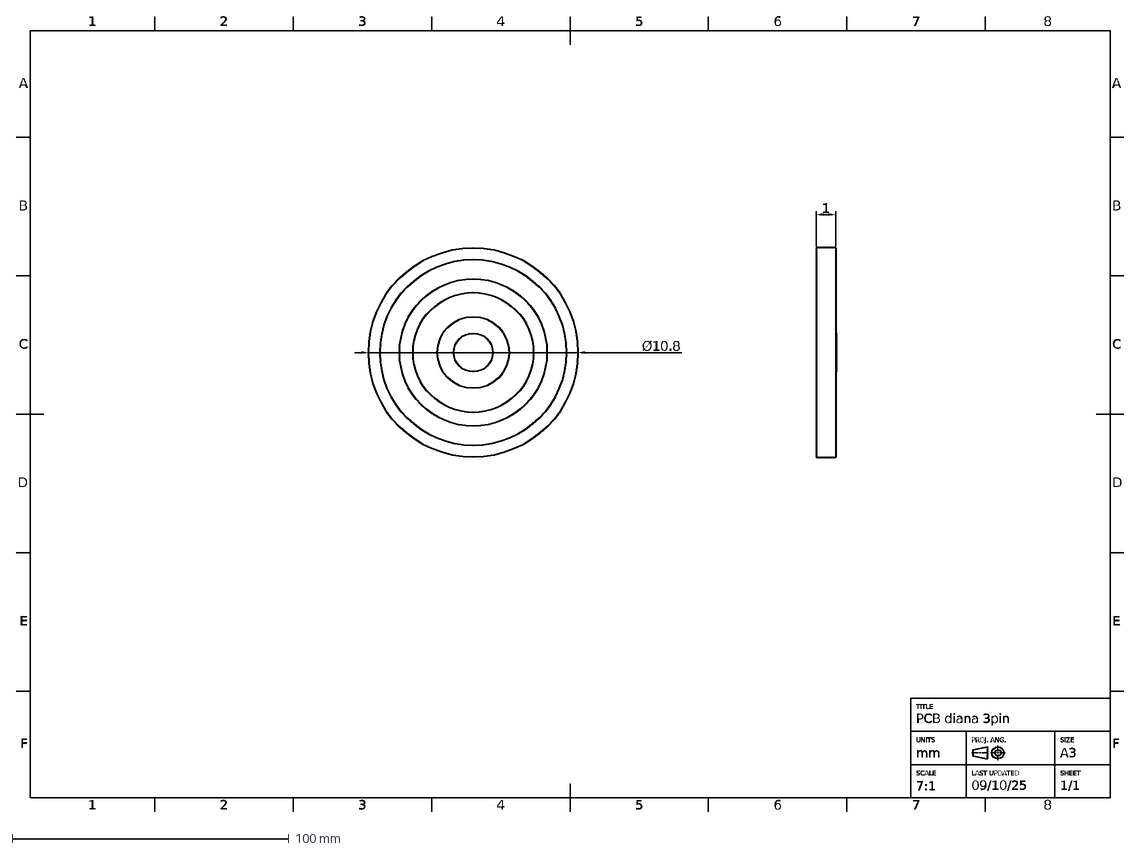
[picture p133: CAD file, 2025-09-29]
01.Documentation/03.Venus/PCB diana 3pin.dxf
1
Ø10.8
2
3
4
5
6
7
8
F
E
D
C
B
A
TITLE
PCB diana 3pin
UNITS
mm
PROJ. ANG.
SIZE
A3
SCALE
7:1
LAST UPDATED
09/10/25
SHEET
1/1
