MSTKMAD/battery-pack/02.Hardware/V1-ROVER-2K/DXF/faja bateria_des.dxf

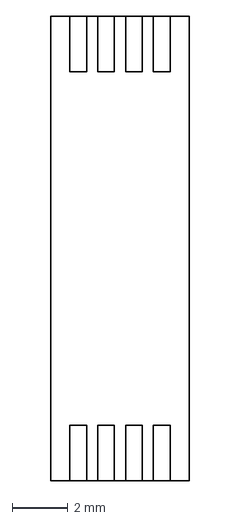
[picture p134: CAD file, 2022-04-11]
02.Hardware/V1-ROVER-2K/DXF/faja bateria_des.dxf
5.00 x 16.7 mm
