MSTKMAD/battery-pack/02.HARDWARE/V2-ROVER R-1/01.PCB/DANKUBIN_MODEL/BATT_CONNECTOR_INVERSOR/clipcord finger v3.dxf

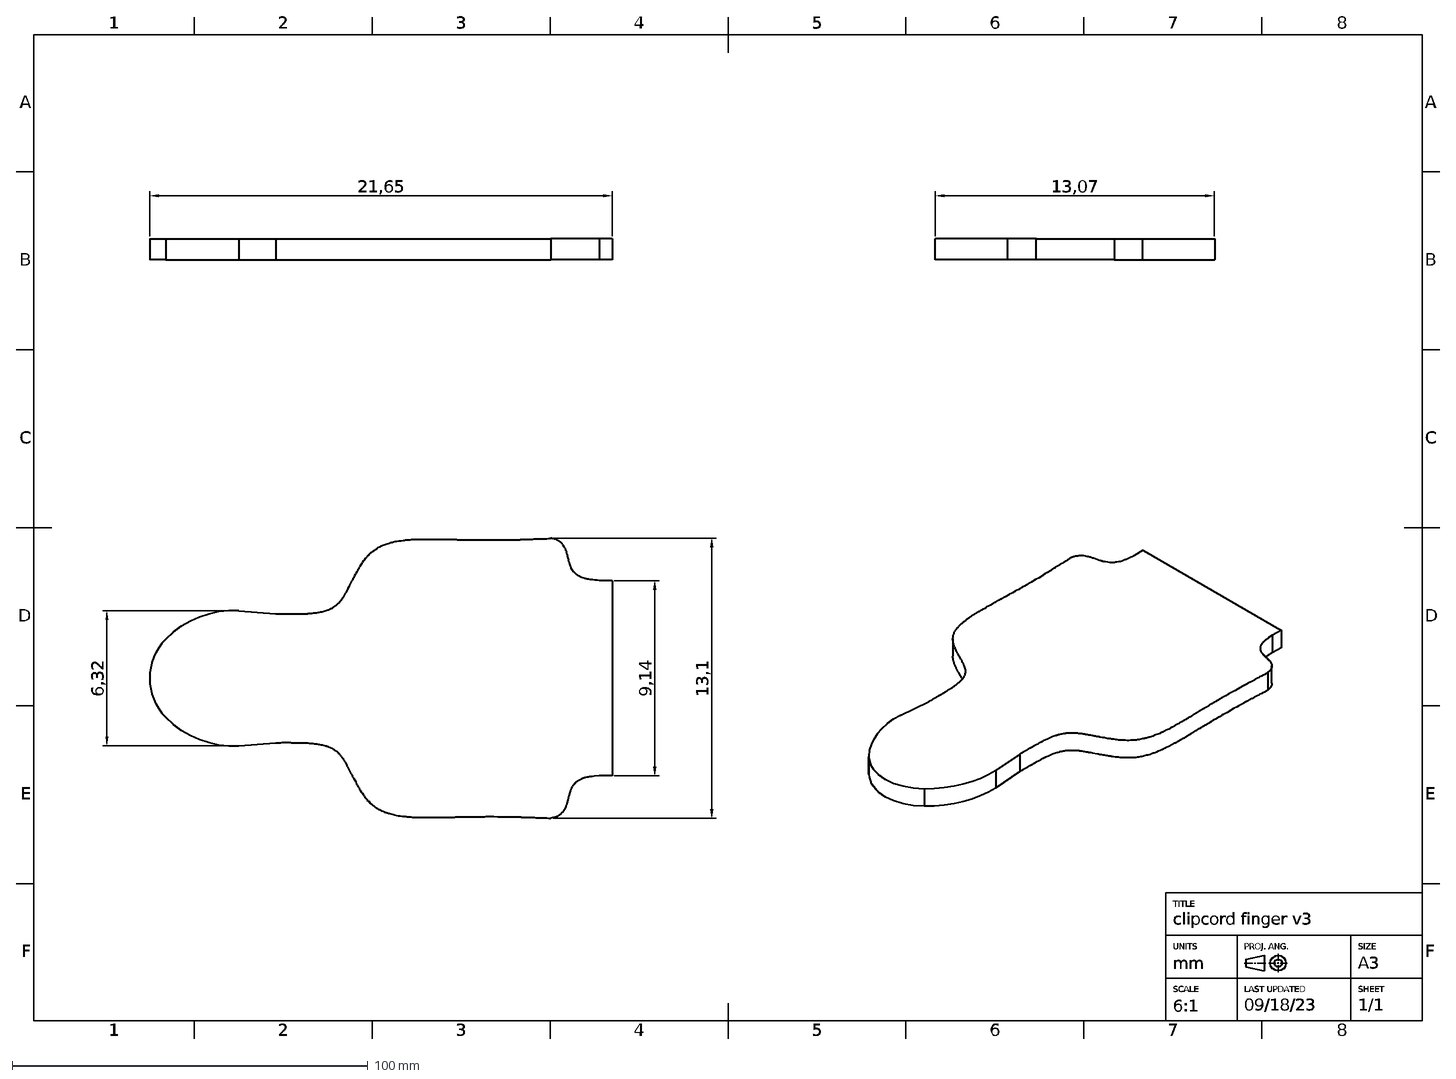
[picture p135: CAD file, 2023-09-19]
02.HARDWARE/V2-ROVER R-1/01.PCB/DANKUBIN_MODEL/BATT_CONNECTOR_INVERSOR/clipcord finger v3.dxf
21,65
13,07
6,32
13,1
9,14
1
2
3
4
5
6
7
8
F
E
D
C
B
A
TITLE
clipcord finger v3
UNITS
mm
PROJ. ANG.
SIZE
A3
SCALE
6:1
LAST UPDATED
09/18/23
SHEET
1/1
