MSTKMAD/battery-pack/02.HARDWARE/V2-ROVER R-1/01.PCB/UNIVERSAL_MODEL/PCB FK CONN/PCB FK v5.dxf

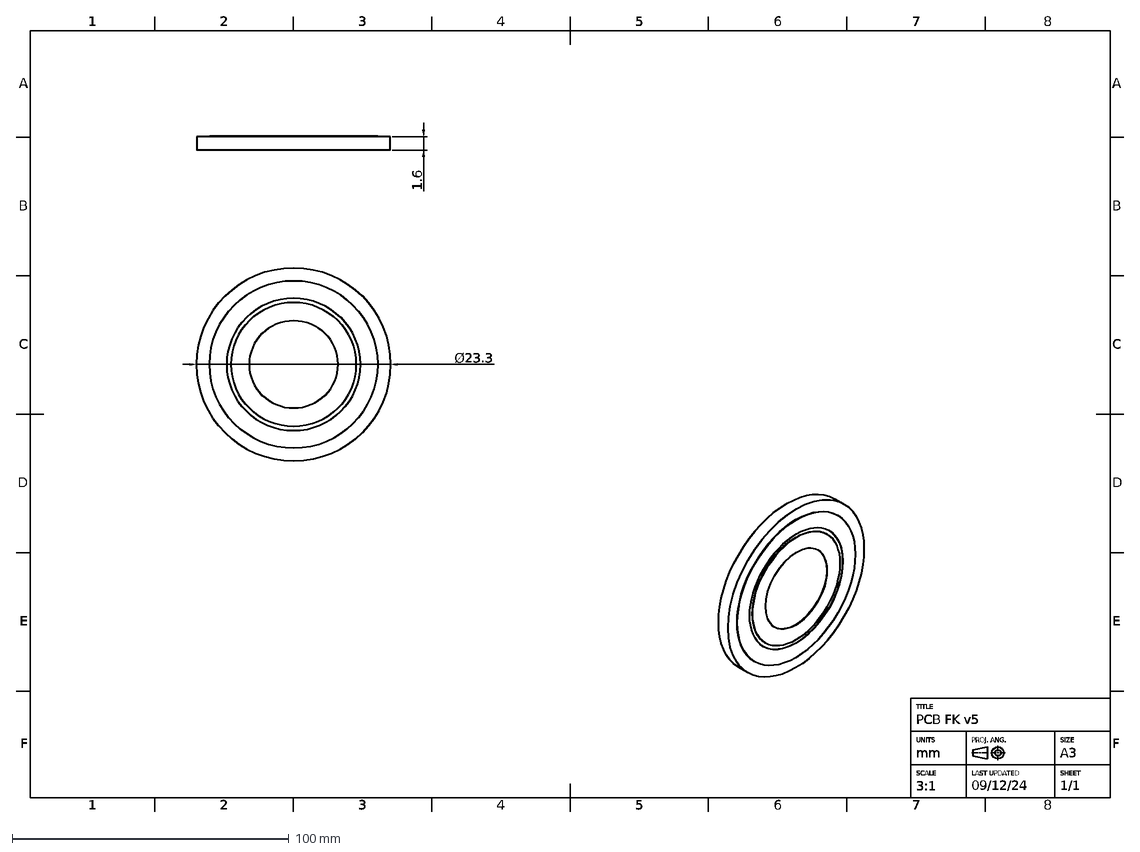
[picture p136: CAD file, 2025-02-12]
02.HARDWARE/V2-ROVER R-1/01.PCB/UNIVERSAL_MODEL/PCB FK CONN/PCB FK v5.dxf
Ø23.3
1.6
1
2
3
4
5
6
7
8
F
E
D
C
B
A
TITLE
PCB FK v5
UNITS
mm
PROJ. ANG.
SIZE
A3
SCALE
3:1
LAST UPDATED
09/12/24
SHEET
1/1
