MSTKMAD/battery-pack/02.HARDWARE/V2-ROVER R-1/01.PCB/UNIVERSAL_MODEL/PCB POGO/pcb pogo.dxf

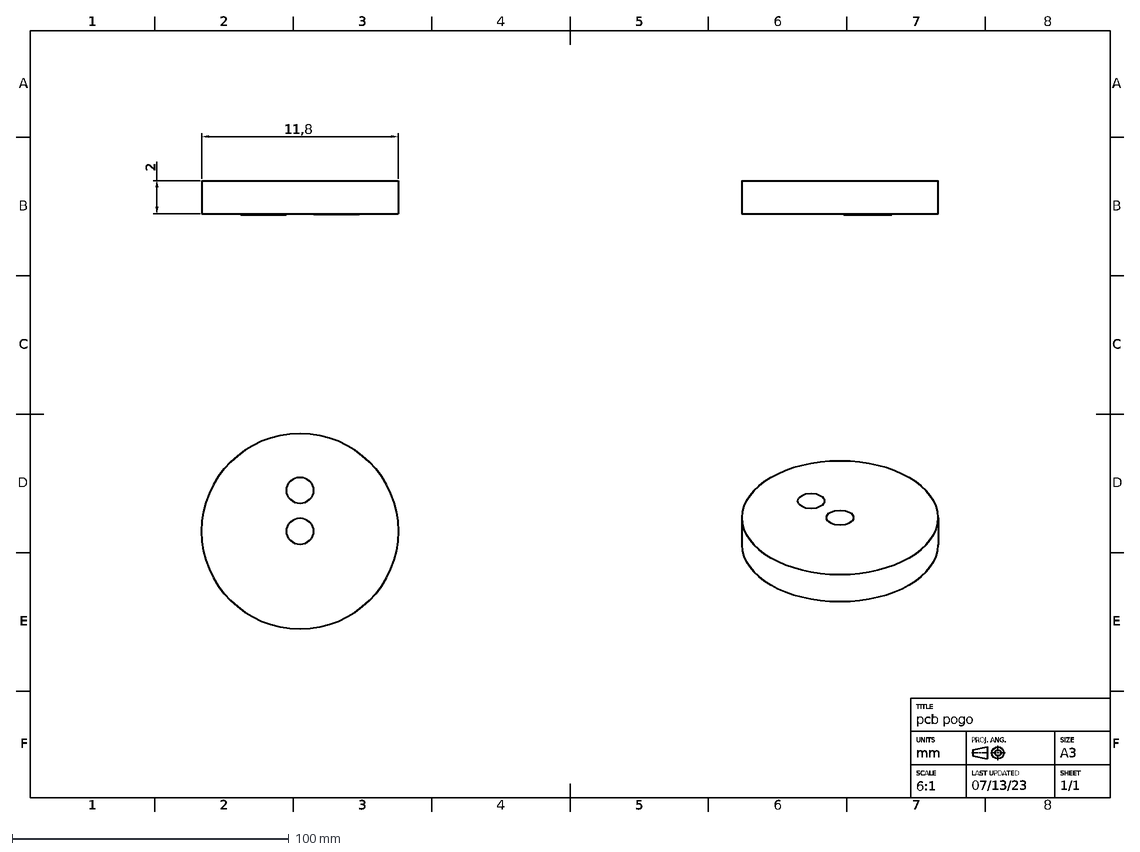
[picture p137: CAD file, 2023-08-21]
02.HARDWARE/V2-ROVER R-1/01.PCB/UNIVERSAL_MODEL/PCB POGO/pcb pogo.dxf
2
11,8
1
3
4
5
6
7
8
F
E
D
C
B
A
TITLE
pcb pogo
UNITS
mm
PROJ. ANG.
SIZE
A3
SCALE
6:1
LAST UPDATED
07/13/23
SHEET
1/1
