MSTKMAD/battery-pack/02.HARDWARE/V2-ROVER R-1/03.TESTBOARDS/BATT_PINZA_DCDC/BATT_PINZA_DCDC_bot.dxf

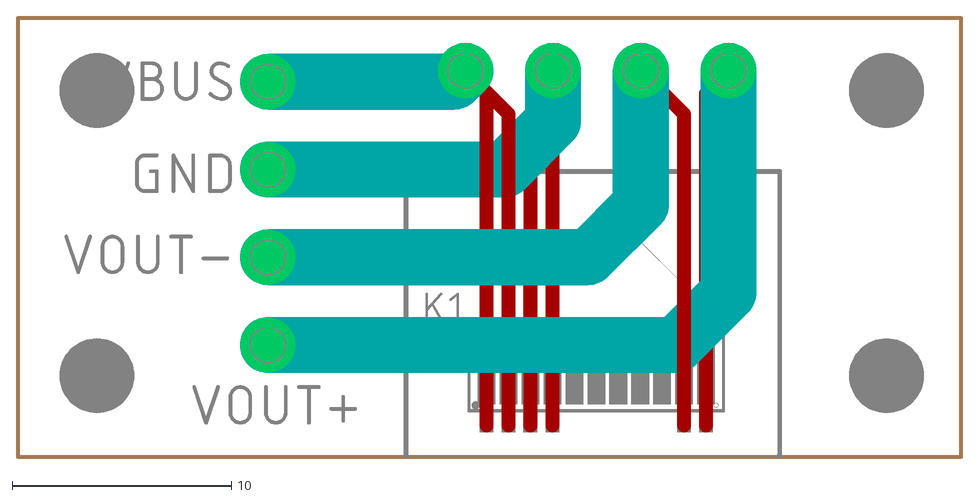
[picture p138: CAD file, 2023-08-25]
02.HARDWARE/V2-ROVER R-1/03.TESTBOARDS/BATT_PINZA_DCDC/BATT_PINZA_DCDC_bot.dxf
43.2 x 20.2
