MSTKMAD/battery-pack/02.HARDWARE/V3-Rover Venus/01-PCB/BATT_CPU/Venus.dxf

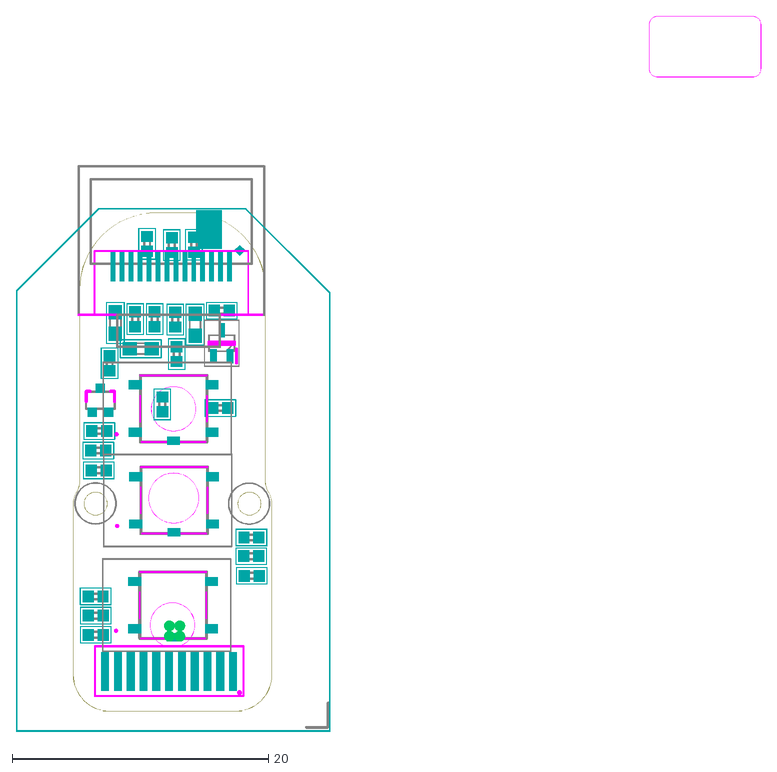
[picture p139: CAD file, 2025-09-29]
02.HARDWARE/V3-Rover Venus/01-PCB/BATT_CPU/Venus.dxf
58.2 x 55.9
