MSTKMAD/battery-pack/04.MECHANICS/01.ROVER1K-MECH/CLIPS/THUNDER/CLIP THUNDER INCL-3.stp

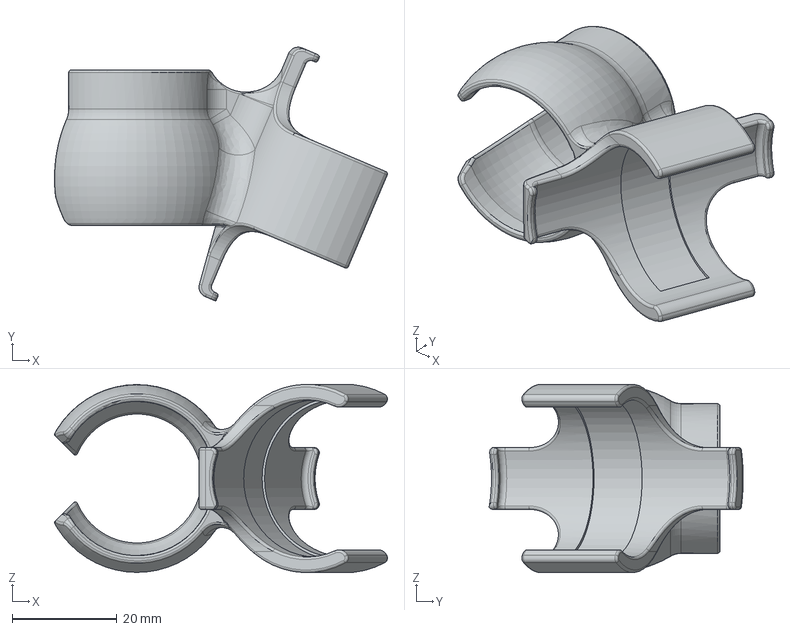
[picture p140: CAD file, 2023-05-17]
04.MECHANICS/01.ROVER1K-MECH/CLIPS/THUNDER/CLIP THUNDER INCL-3.stp
63.6 x 48.5 x 36.0 mm
