MSTKMAD/battery-pack/04.MECHANICS/01.ROVER1K-MECH/ROVER_U-1/anillo acero.dxf

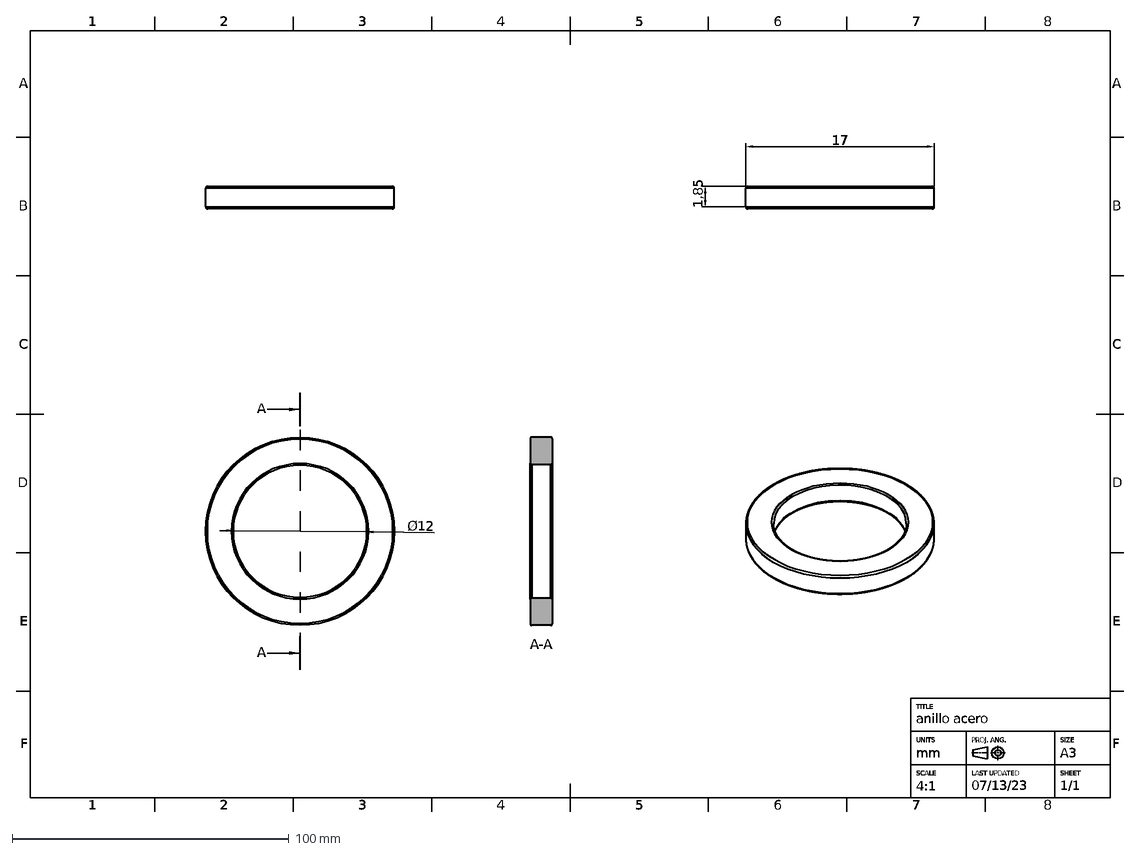
[picture p141: CAD file, 2023-08-21]
04.MECHANICS/01.ROVER1K-MECH/ROVER_U-1/anillo acero.dxf
17
1,85
Ø12
A
A-A
1
2
3
4
5
6
7
8
F
E
D
C
B
TITLE
anillo acero
UNITS
mm
PROJ. ANG.
SIZE
A3
SCALE
4:1
LAST UPDATED
07/13/23
SHEET
1/1
