MSTKMAD/battery-pack/04.MECHANICS/01.ROVER1K-MECH/UTILES FABRICACION/UTIL-GRABADO TAPA/V2.2/Util tapa v2.2.stl

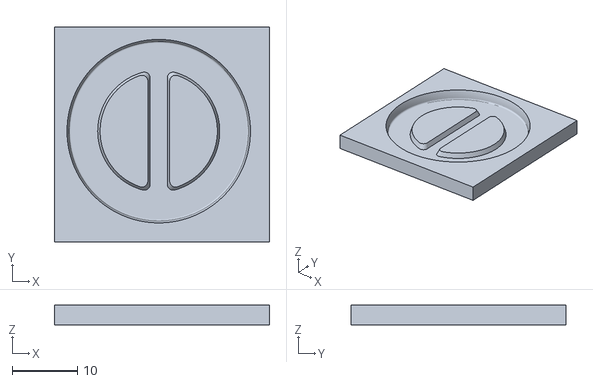
[picture p142: CAD file, 2023-08-21]
04.MECHANICS/01.ROVER1K-MECH/UTILES FABRICACION/UTIL-GRABADO TAPA/V2.2/Util tapa v2.2.stl
33.0 x 33.0 x 3.00
