MSTKMAD/battery-pack/04.MECHANICS/01.ROVER1K-MECH/VERSIONES/V6.2/Barril v6.2(ERRONEO).step

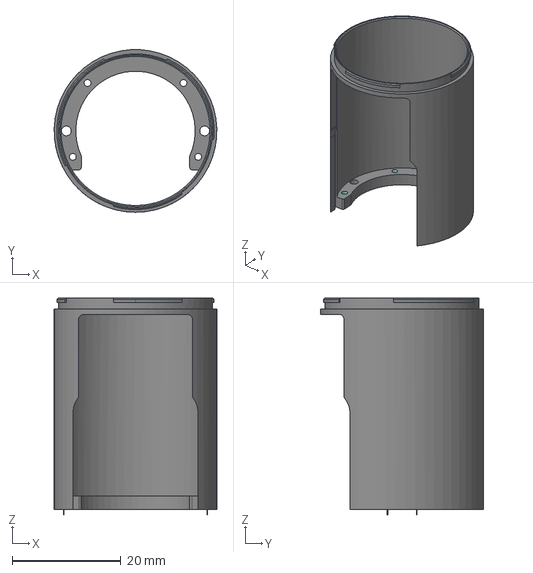
[picture p143: CAD file, 2025-02-12]
04.MECHANICS/01.ROVER1K-MECH/VERSIONES/V6.2/Barril v6.2(ERRONEO).step
30.0 x 30.0 x 40.0 mm
