MSTKMAD/battery-pack/04.MECHANICS/02.CLIP_THUNDER/HISTORY/V1/Clip Thunder solid 2.step

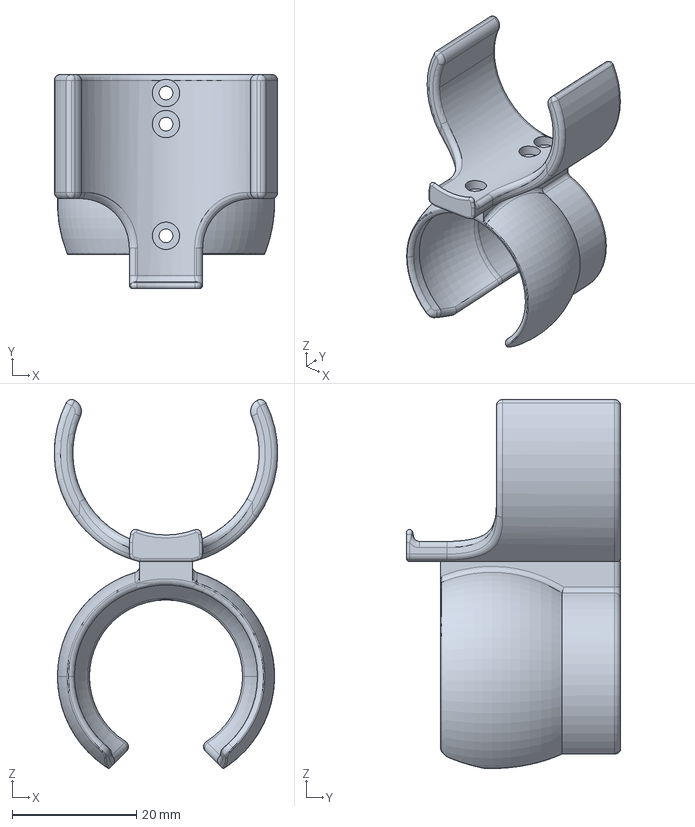
[picture p144: CAD file, 2023-02-09]
04.MECHANICS/02.CLIP_THUNDER/HISTORY/V1/Clip Thunder solid 2.step
36.0 x 34.5 x 59.4 mm
CLIP ROVER
CLIP THUNDER
