MSTKMAD/battery-pack/04.MECHANICS/03.POGOPIN_BED_DCDC/TEST DC-DC ROVER R1.stp

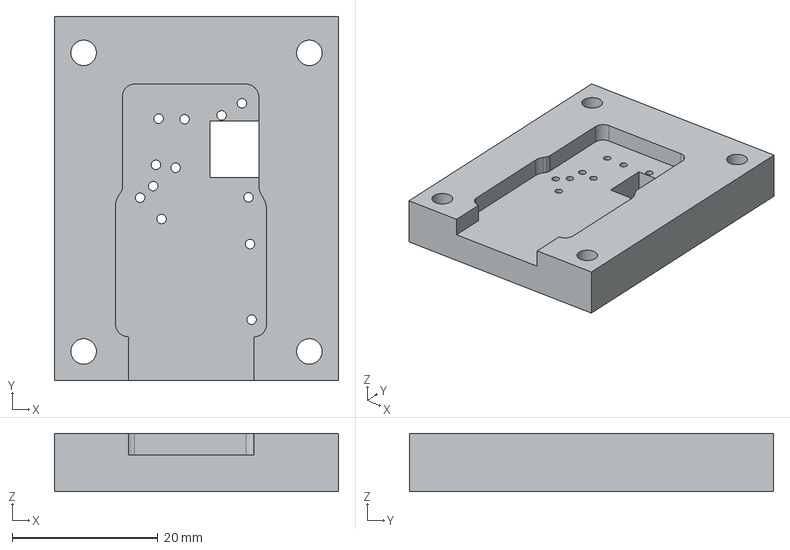
[picture p145: CAD file, 2023-02-09]
04.MECHANICS/03.POGOPIN_BED_DCDC/TEST DC-DC ROVER R1.stp
39.0 x 50.0 x 8.00 mm
