MSTKMAD/battery-pack/02.Hardware/V1-ROVER-2K/DXF/BATT_CPU_V2.dxf

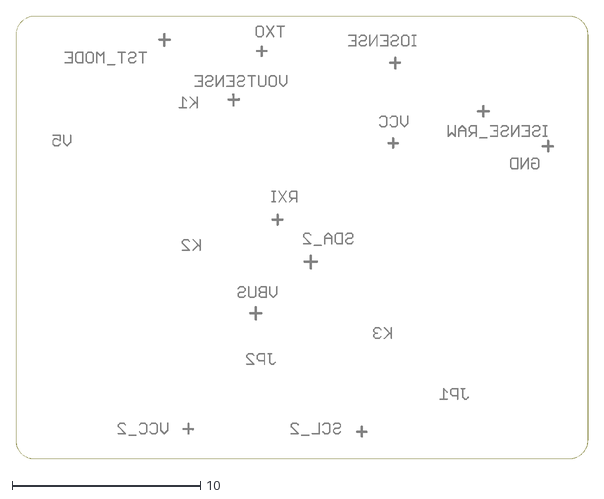
[picture p146: CAD file, 2022-04-11]
02.Hardware/V1-ROVER-2K/DXF/BATT_CPU_V2.dxf
30.4 x 23.5
