MSTKMAD/battery-pack/02.HARDWARE/V2-ROVER R-1/03.TESTBOARDS/BATT_PINZA_DCDC/BATT_PINZA_DCDC_top.dxf

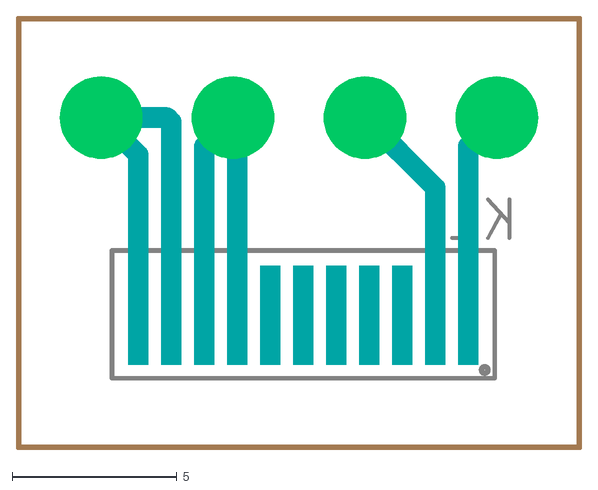
[picture p147: CAD file, 2023-08-25]
02.HARDWARE/V2-ROVER R-1/03.TESTBOARDS/BATT_PINZA_DCDC/BATT_PINZA_DCDC_top.dxf
17.2 x 13.2
