MSTKMAD/battery-pack/02.HARDWARE/V2-ROVER R-1/05.CLIPCORD/Clipcord BOT/Clipcord BOT.dxf

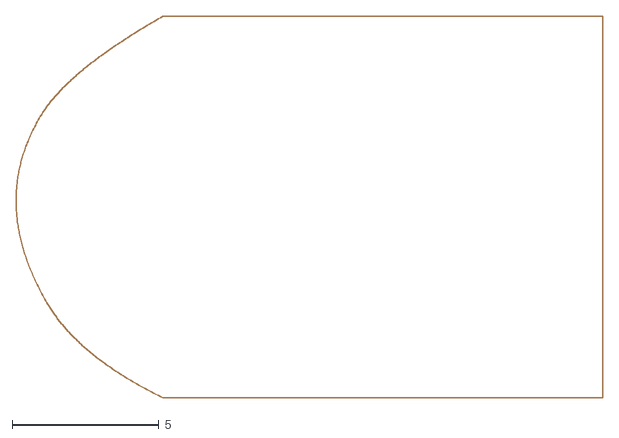
[picture p148: CAD file, 2023-08-24]
02.HARDWARE/V2-ROVER R-1/05.CLIPCORD/Clipcord BOT/Clipcord BOT.dxf
20.0 x 13.0
