MSTKMAD/battery-pack/04.MECHANICS/01.ROVER1K-MECH/CLIPS/THUNDER/CLIP THUNDER INCL-2.stp

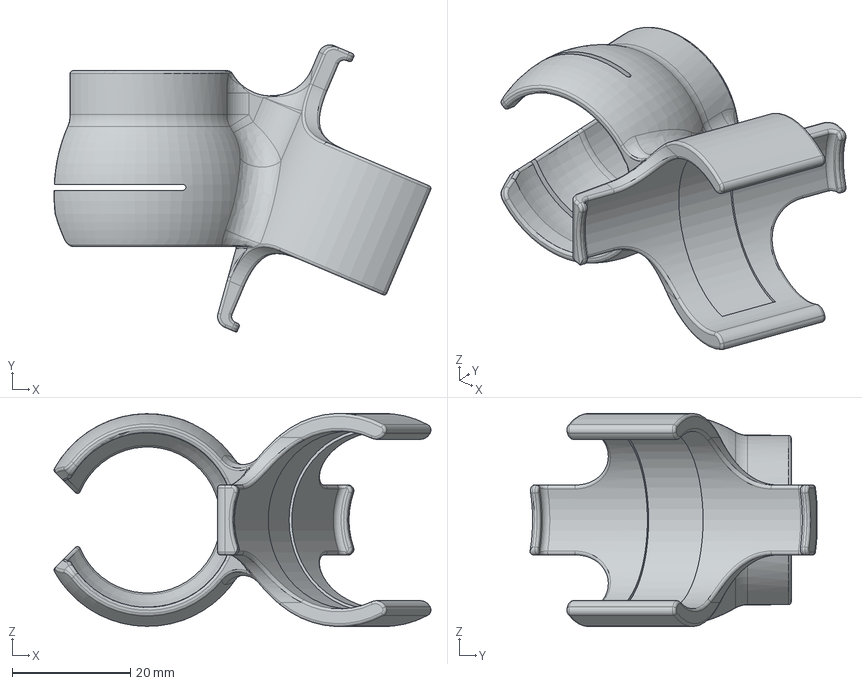
[picture p150: CAD file, 2023-05-17]
04.MECHANICS/01.ROVER1K-MECH/CLIPS/THUNDER/CLIP THUNDER INCL-2.stp
63.7 x 48.5 x 36.0 mm
