MSTKMAD/battery-pack/04.MECHANICS/01.ROVER1K-MECH/ROVER_U-1/copa RCA universal v1.step

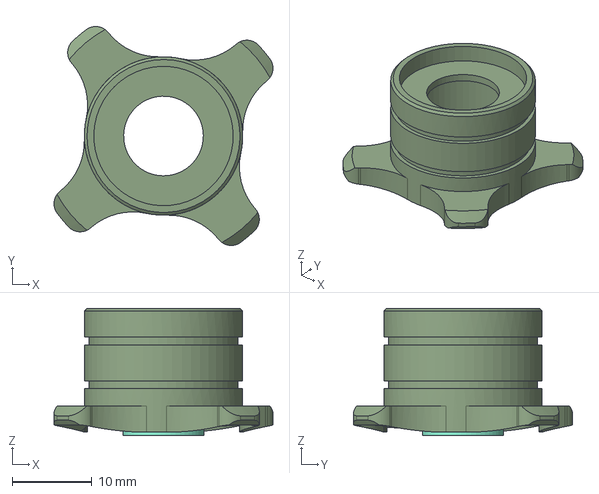
[picture p151: CAD file, 2023-08-21]
04.MECHANICS/01.ROVER1K-MECH/ROVER_U-1/copa RCA universal v1.step
27.5 x 27.5 x 16.0 mm
