MSTKMAD/battery-pack/02.Hardware/V1-ROVER-2K/DXF/Faja pequeña_des.dxf

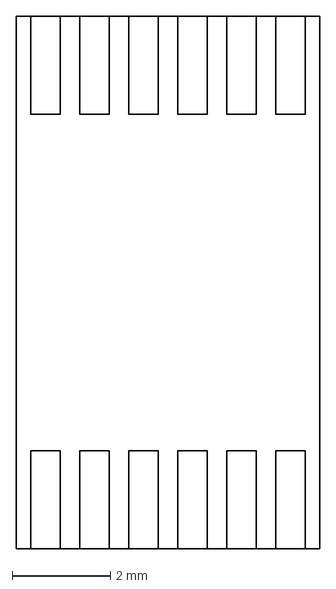
[picture p152: CAD file, 2022-04-11]
02.Hardware/V1-ROVER-2K/DXF/Faja pequeña_des.dxf
6.20 x 10.9 mm
