MSTKMAD/battery-pack/02.HARDWARE/V2-ROVER R-1/05.CLIPCORD/Clipcord BOT/clipcord.dxf

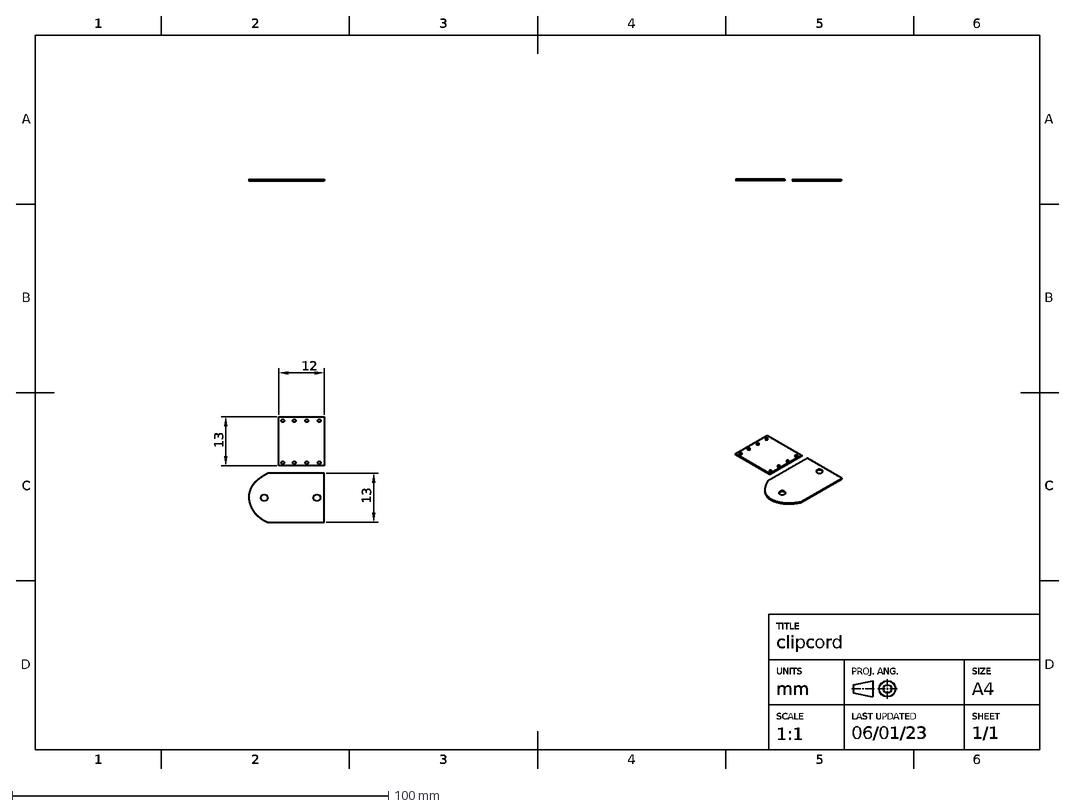
[picture p153: CAD file, 2023-06-01]
02.HARDWARE/V2-ROVER R-1/05.CLIPCORD/Clipcord BOT/clipcord.dxf
12
13
TITLE
clipcord
UNITS
mm
PROJ. ANG.
SIZE
A4
SCALE
1:1
LAST UPDATED
06/01/23
SHEET
1/1
1
2
3
4
5
6
D
C
B
A
