MSTKMAD/battery-pack/04.MECHANICS/01.ROVER1K-MECH/CLIPS/THUNDER/CLIP THUNDER INCL-1.stp

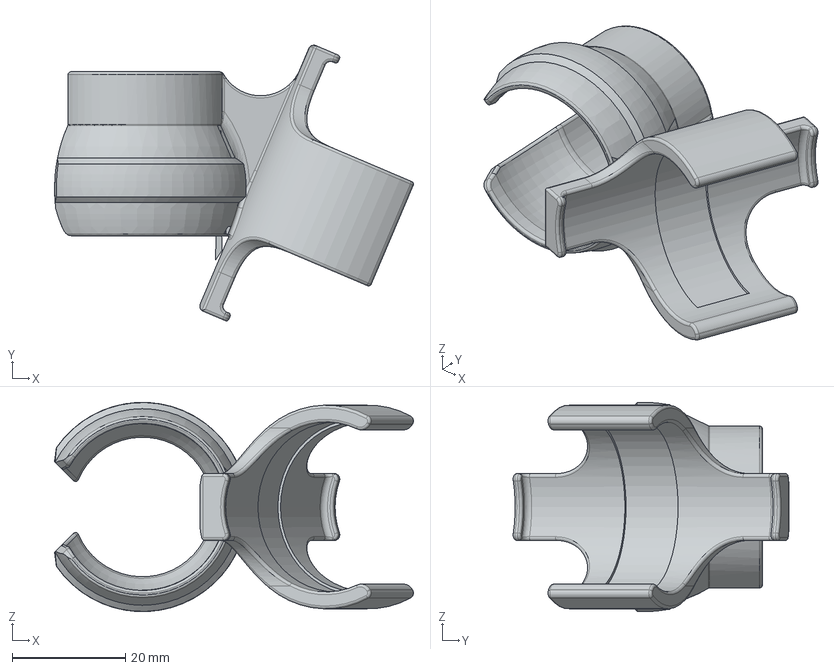
[picture p154: CAD file, 2023-02-09]
04.MECHANICS/01.ROVER1K-MECH/CLIPS/THUNDER/CLIP THUNDER INCL-1.stp
63.4 x 48.7 x 36.9 mm
