MSTKMAD/battery-pack/04.MECHANICS/01.ROVER1K-MECH/ROVER_U-1/tapa v7.step

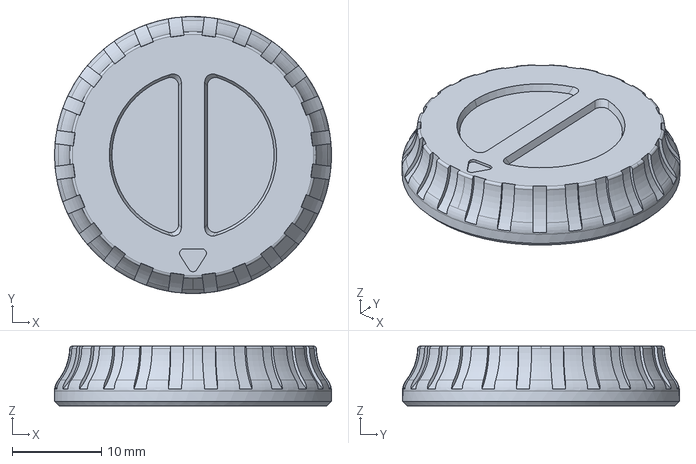
[picture p155: CAD file, 2023-08-21]
04.MECHANICS/01.ROVER1K-MECH/ROVER_U-1/tapa v7.step
31.0 x 31.0 x 6.70 mm
