MSTKMAD/battery-pack/02.Hardware/V1-ROVER-2K/DXF/banda grande_des.dxf

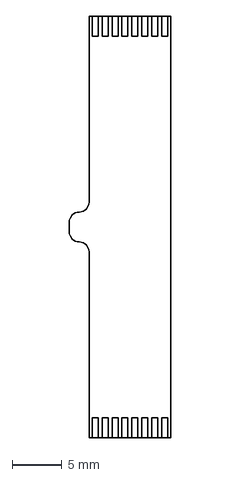
[picture p156: CAD file, 2022-04-11]
02.Hardware/V1-ROVER-2K/DXF/banda grande_des.dxf
10.2 x 42.3 mm
