MSTKMAD/battery-pack/04.MECHANICS/01.ROVER1K-MECH/ROVER_U-1/ring pcb.dxf

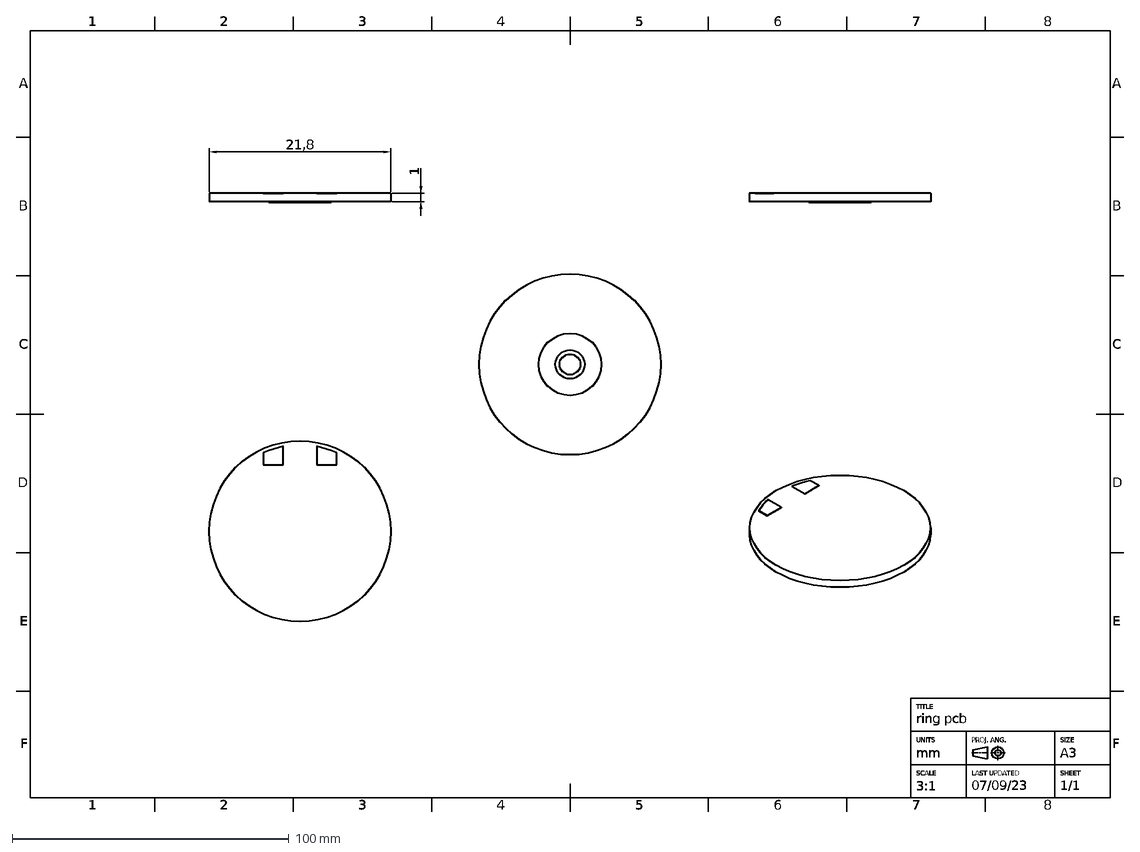
[picture p157: CAD file, 2023-08-21]
04.MECHANICS/01.ROVER1K-MECH/ROVER_U-1/ring pcb.dxf
1
21,8
2
3
4
5
6
7
8
F
E
D
C
B
A
TITLE
ring pcb
UNITS
mm
PROJ. ANG.
SIZE
A3
SCALE
3:1
LAST UPDATED
07/09/23
SHEET
1/1
