MSTKMAD/battery-pack/02.Hardware/V1-ROVER-2K/DXF/ft231x-breakout-v11.dxf

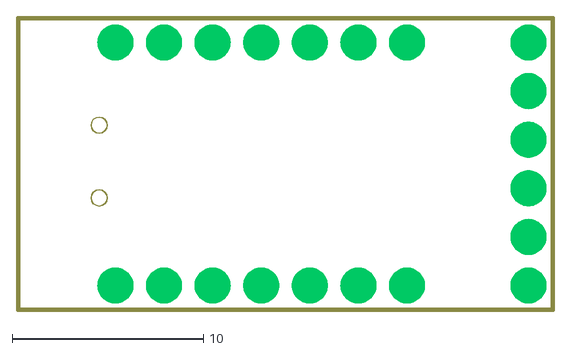
[picture p158: CAD file, 2022-04-11]
02.Hardware/V1-ROVER-2K/DXF/ft231x-breakout-v11.dxf
28.1 x 15.4
