MSTKMAD/battery-pack/04.MECHANICS/01.ROVER1K-MECH/ROVER_U-1/copa bishop v1.step

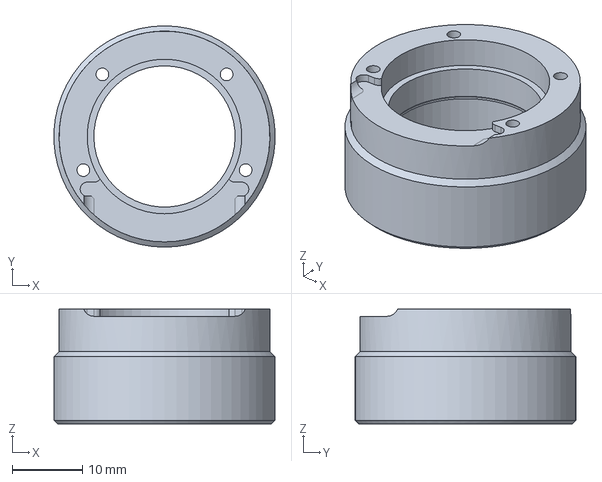
[picture p159: CAD file, 2023-08-21]
04.MECHANICS/01.ROVER1K-MECH/ROVER_U-1/copa bishop v1.step
31.5 x 31.5 x 16.3 mm
