MSTKMAD/battery-pack/04.MECHANICS/01.ROVER1K-MECH/ROVER_U-1/copa 3.5 universal v1.step

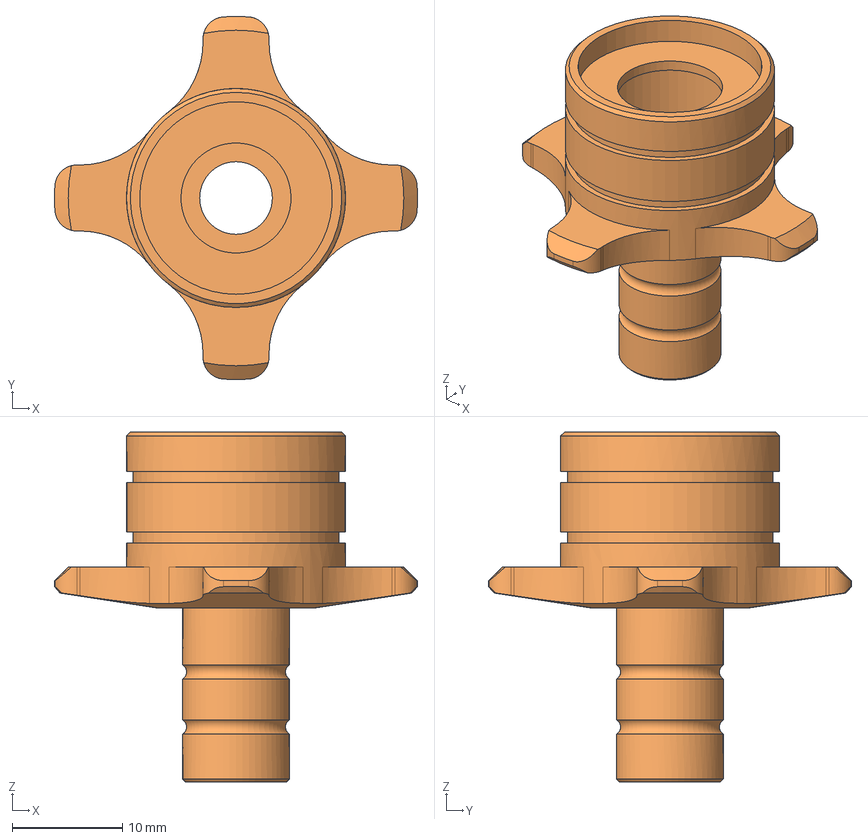
[picture p160: CAD file, 2023-08-21]
04.MECHANICS/01.ROVER1K-MECH/ROVER_U-1/copa 3.5 universal v1.step
33.0 x 33.0 x 31.8 mm
