MSTKMAD/battery-pack/(list of files, cad)

Other CAD files:
02.HARDWARE/V2-ROVER R-1/01.PCB/UNIVERSAL_MODEL/PCB FK CONN/pcb fk v1.dxf
02.HARDWARE/V3-Rover Venus/01-PCB/CRADLE/Cradle v1/PCB con leds CRADLE VENUS.dxf
04.MECHANICS/01.ROVER1K-MECH/CLIPS/DANKUBIN/Clip dankubin v1.step
04.MECHANICS/01.ROVER1K-MECH/VERSIONES/V2/0. ROVER-1K_v2.stp
04.MECHANICS/01.ROVER1K-MECH/VERSIONES/V2/DCDC board.dxf
04.MECHANICS/01.ROVER1K-MECH/VERSIONES/V2/panel v2.stl
04.MECHANICS/01.ROVER1K-MECH/VERSIONES/V2/pcb cpu.dxf
04.MECHANICS/01.ROVER1K-MECH/VERSIONES/V2/porta v2.stl
04.MECHANICS/01.ROVER1K-MECH/VERSIONES/V2/tapabot v2.stl
04.MECHANICS/01.ROVER1K-MECH/VERSIONES/V2/tapatop v2.stl
04.MECHANICS/01.ROVER1K-MECH/VERSIONES/V3/0. ROVER-1K_v2_MINI JACK.stp
04.MECHANICS/01.ROVER1K-MECH/VERSIONES/V3/0. ROVER-1K_v2_RCA-3.stp
04.MECHANICS/01.ROVER1K-MECH/VERSIONES/V3/EX-RV1K-02 BASTIDOR DE ELECTRONICA_31-10.stp
04.MECHANICS/01.ROVER1K-MECH/VERSIONES/V3/EX-RV1K-16 FAJA CPU.dxf
04.MECHANICS/01.ROVER1K-MECH/VERSIONES/V3/PCB DCDC v3 2.dxf
04.MECHANICS/01.ROVER1K-MECH/VERSIONES/V3/barril v3.step
04.MECHANICS/01.ROVER1K-MECH/VERSIONES/V3/boton v3.step
04.MECHANICS/01.ROVER1K-MECH/VERSIONES/V3/copper contact.step
04.MECHANICS/01.ROVER1K-MECH/VERSIONES/V3/overlay v3.dxf
04.MECHANICS/01.ROVER1K-MECH/VERSIONES/V3/panel v3.step
04.MECHANICS/01.ROVER1K-MECH/VERSIONES/V3/porta v3.step
04.MECHANICS/01.ROVER1K-MECH/VERSIONES/V3/tapabot v3.step
04.MECHANICS/01.ROVER1K-MECH/VERSIONES/V3/tapabotjack v3.step
04.MECHANICS/01.ROVER1K-MECH/VERSIONES/V3/tapatop v3.step
04.MECHANICS/01.ROVER1K-MECH/VERSIONES/V4/Entrega joseluis/Lunes 5 diciembre v4/ASM TEST_BATT.stp
04.MECHANICS/01.ROVER1K-MECH/VERSIONES/V4/Entrega joseluis/Lunes 5 diciembre v4/EX-RV1K-14 TAPA CONECTOR 3.5.stp
04.MECHANICS/01.ROVER1K-MECH/VERSIONES/V4/barril v4.step
04.MECHANICS/01.ROVER1K-MECH/VERSIONES/V4/copper contact v4.step
04.MECHANICS/01.ROVER1K-MECH/VERSIONES/V4/overlay v4.dxf
04.MECHANICS/01.ROVER1K-MECH/VERSIONES/V4/overlay v4.step
04.MECHANICS/01.ROVER1K-MECH/VERSIONES/V4/panel v4.step
04.MECHANICS/01.ROVER1K-MECH/VERSIONES/V4/porta v4.1.2.step
04.MECHANICS/01.ROVER1K-MECH/VERSIONES/V4/porta v4.step
04.MECHANICS/01.ROVER1K-MECH/VERSIONES/V4/tapa v4.step
04.MECHANICS/01.ROVER1K-MECH/VERSIONES/V4/tapabot v4.step
04.MECHANICS/01.ROVER1K-MECH/VERSIONES/V4/tapabotjack v4.step
04.MECHANICS/01.ROVER1K-MECH/VERSIONES/V5/panel v4.12.5.step
04.MECHANICS/01.ROVER1K-MECH/VERSIONES/V6.1/Barril v6.step
04.MECHANICS/01.ROVER1K-MECH/VERSIONES/V6.1/Copa rca v5.step
04.MECHANICS/01.ROVER1K-MECH/VERSIONES/V6.1/Entrega Joseluis/EX-RV1K-14_v6 COPA 3.5.stp
04.MECHANICS/01.ROVER1K-MECH/VERSIONES/V6.1/Entrega Joseluis/tapa V6.step
04.MECHANICS/01.ROVER1K-MECH/VERSIONES/V6.1/Overlay v6.step
04.MECHANICS/01.ROVER1K-MECH/VERSIONES/V6.1/boton rojo bateria v1.stp
04.MECHANICS/01.ROVER1K-MECH/VERSIONES/V6.1/boton v4.step
04.MECHANICS/01.ROVER1K-MECH/VERSIONES/V6.1/copa 3.5 v6.step
04.MECHANICS/01.ROVER1K-MECH/VERSIONES/V6.1/copa 3.5 v6.stp
04.MECHANICS/01.ROVER1K-MECH/VERSIONES/V6.1/overlay v6.dxf
04.MECHANICS/01.ROVER1K-MECH/VERSIONES/V6.1/panel v4.12.5.step
04.MECHANICS/01.ROVER1K-MECH/VERSIONES/V6.1/porta V6.step
04.MECHANICS/01.ROVER1K-MECH/VERSIONES/V6.1/tapa v6.1.step
