MSTKMAD/battery-pack/01.Documentation/03. Produccion/Tutoriales/Tutorial programación CPU.docx

# Tutorial Programación

# Y

# Testeo placa PCB CPU ROVER R-1

# 1 Preparacion Entrono JFlash

## 1.1 Project

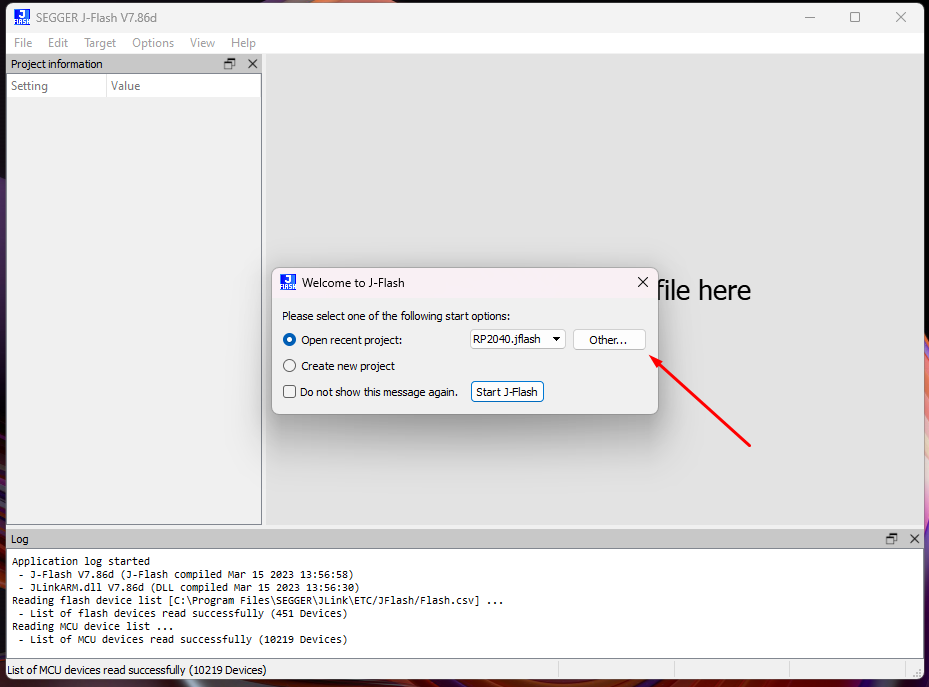
[picture p179: figure]

se abre el programa:

Seleccionamos el archivo en la carpeta de producción con la estension .jflash correspondiente al proyecto a programar en este caso SAMD21.jflash

## 1.2 Settings

En la pantalla vamos a Options>Project Settings.

En la ventana que se nos abre la configuración debe ser la siguiente:

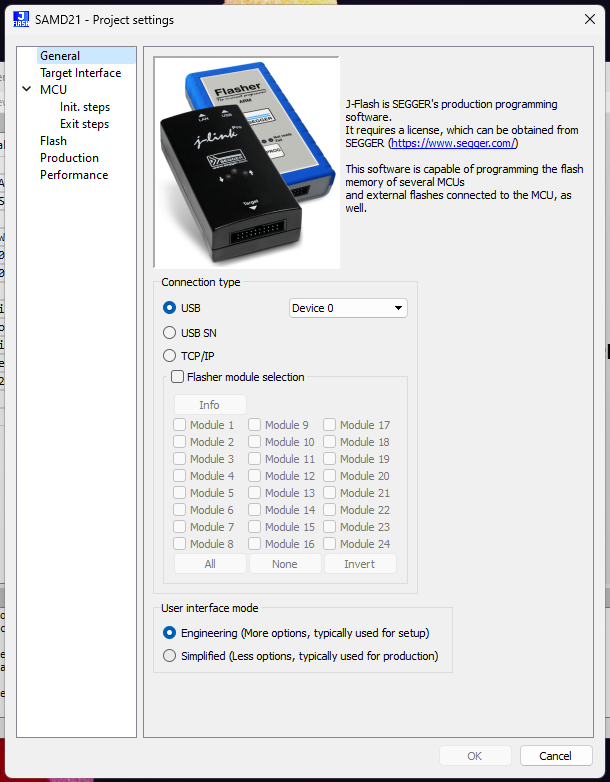
[picture p180: figure]

- General:

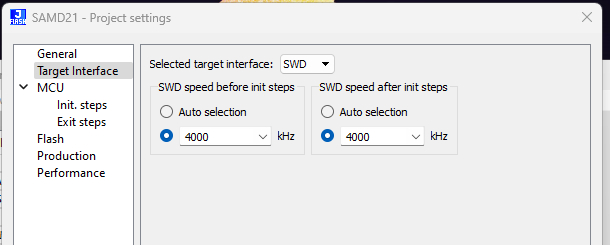
[picture p181: figure]

- Target Interface:

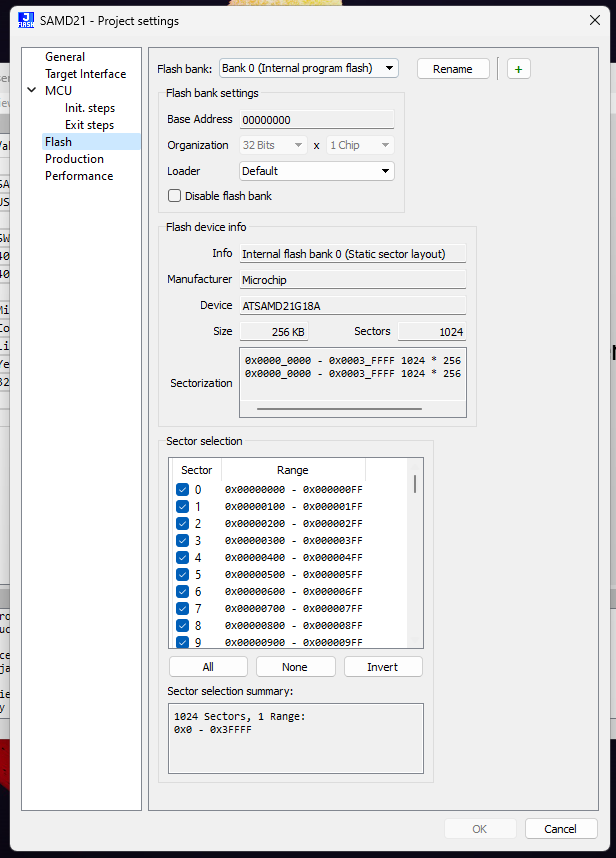
[picture p182: figure]

- Flash:

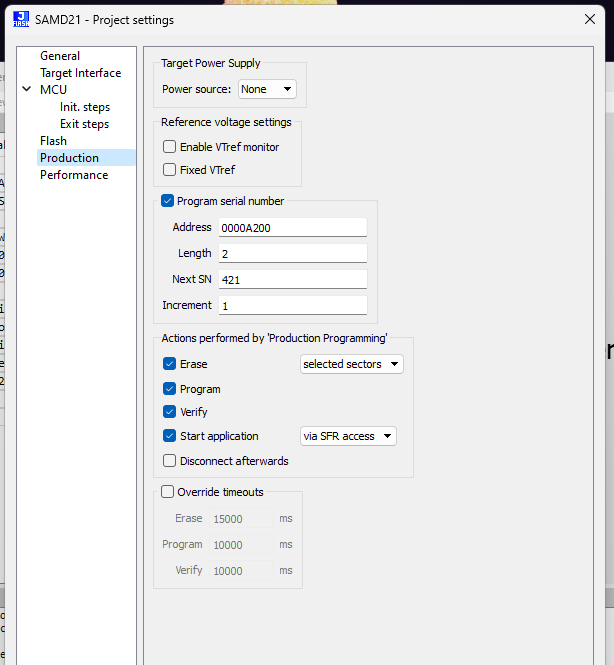
[picture p183: figure]

- Production:

Aquí es importante que:

1. Address sea el valor “0x0000AB00”.(A día de 31/05/23)
2. En la carpeta de producción se encuentren 2 archivos :

Estos archivos almacenan los números de serie y el índice del numero de serie a grabar.

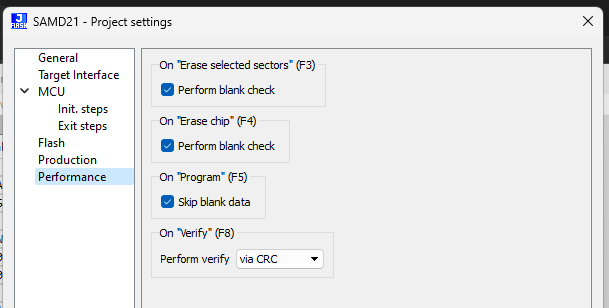
[picture p184: figure]

- Performance:

## 1.3 HEX File.

Desde la pantalla principal Seleccionamos el fichero a programar, File>Open Data File y seleccionamos el archivo de la carpeta de producción con terminación .hex.

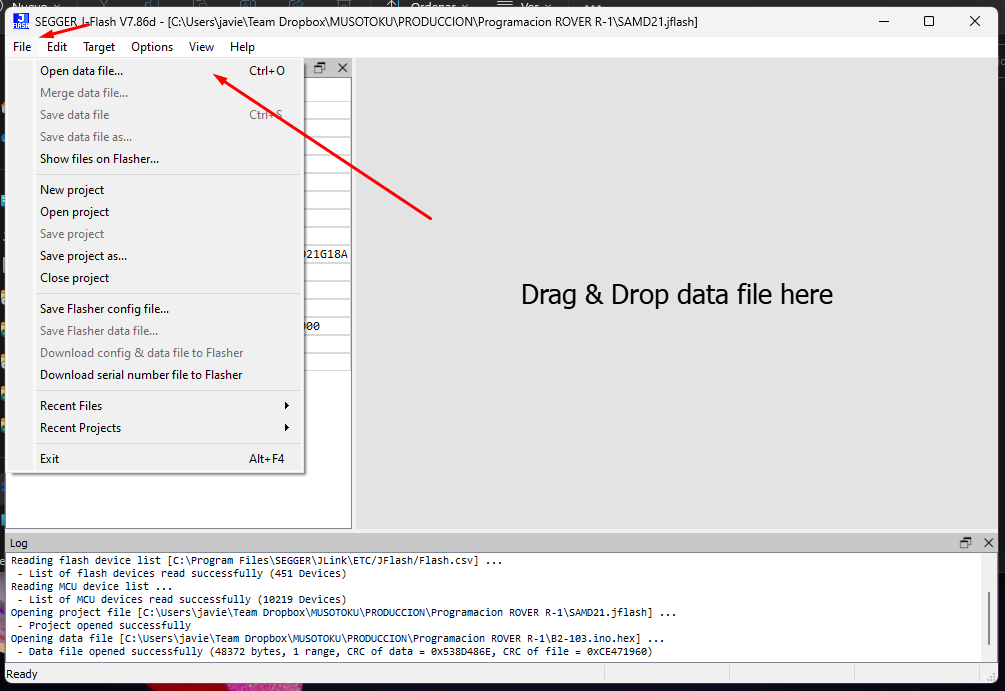
[picture p185: figure]

# 2 Preparación Equipo de Pruebas

## 2.1 Materiales:

- Jlink

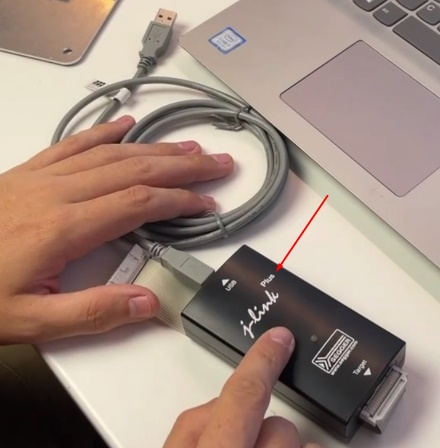
[picture p186: figure]

Es importante que el Jlink sea Plus o Ultra. Ya que son los que tienen las funciones de Programación Industrial necesaria.

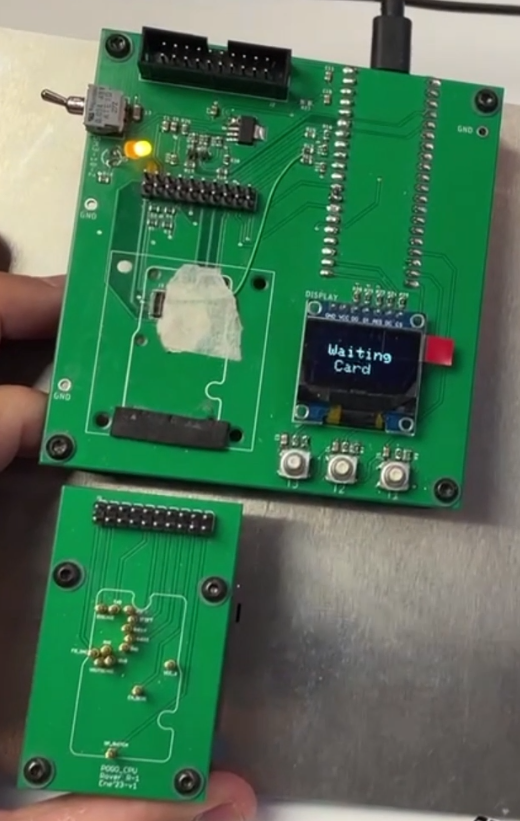
[picture p187: figure]

- Placa de testeo CPU y cable de alimentación micro-USB.
- Ordenador con acceso a internet y al excel de logeo y el programa JFlash (v7.86d o superior) instalado.

## 2.2 Montaje:

1. Conectamos el cable de micro USB a la placa de testo por la parte superior. Deberemos ver como se enciende el led de la placa y la pantalla.

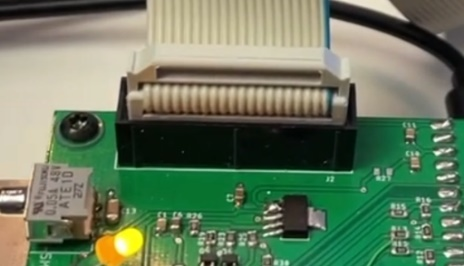
[picture p188: figure]

2. Conectamos el Jlink a la placa de testeo con el conector JTAG cuadrado.

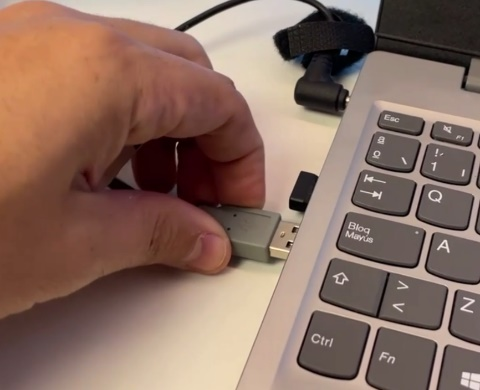
[picture p189: figure]

3. Conectamos el Jlink al ordenador por el USB.
4. Abrir JFlash y seleccionar el proyecto SAMD21.jflash de la carpeta de producción.

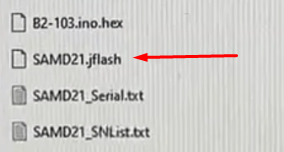
[picture p190: figure]

5. Abrir Excel de producción.

https://docs.google.com/spreadsheets/d/1nmxFNNJF1sEjIJP-lsE_f3bz0QkjVBnmdywyW32gJZo/edit?usp=sharing

## 2.3 Excel Logeo:

El Excel de Logeo esta formado por 5 columnas:

- Nº Serie: Numero de serie de la placa.
- I: Valor del sensado de corriente.
- V: Valor del sensado de Voltage
- EN/OUT: Error en alguno punto del T2
- DAC: Error en el T3

En cada test que se realice a la placa será imprescindible rellenar las casillas de Nº Serie, I y V.

- En caso de que en alguno de los test haya un error, se indicara en la casilla correspondiente. Si no hay error se dejará en blanco.

# 3 Proceso de Testeo

## 3.1 Conexión de la placa.

Existen 2 posibilidad de conexión de las placas CPU a la placa de testeo.

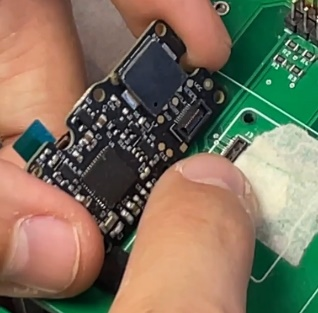
[picture p191: figure]
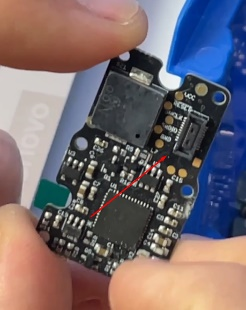
[picture p192: figure]

1. Conector integrado.

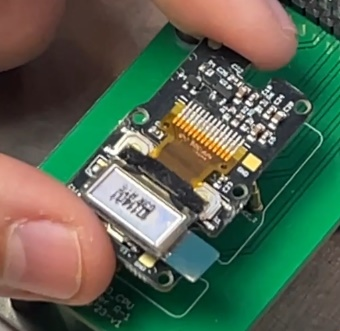
[picture p193: figure]
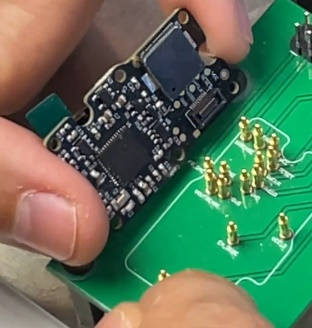
[picture p194: figure]

2. Pogo pines.

Por defecto se usará la opción 1.

## 3.2 Programación

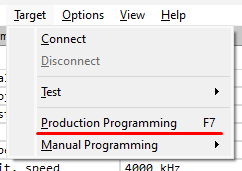
[picture p195: figure]

1. Con la placa conectada y el fichero .hex seleccionado en el JFlash. Buscamos la opción de Production Programming o se puede usar el atajo de F7 (dependiendo del ordenador a lo mejor es necesario pulsar las teclas Fn+F7).

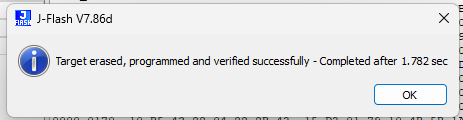
[picture p196: figure]

- Si la programación va BIEN saldrá el mensaje:

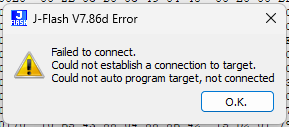
[picture p197: figure]

- Si la programación va MAL saldrá el mensaje:

*En este caso, consultar la sección de Troubleshotting.

## 3.3 Test 1. Número de Serie.

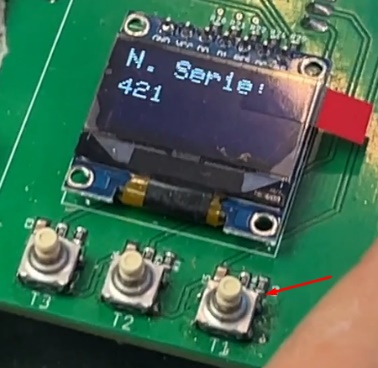
[picture p198: figure]

1. Pulsamos el botón T1.
2. Esperamos a que aparezca el Nº Serie.
3. Este valor tiene que ser consecutivo al que se encuentra en el Excel de testeo.

## 3.4 Test 2. En/Op

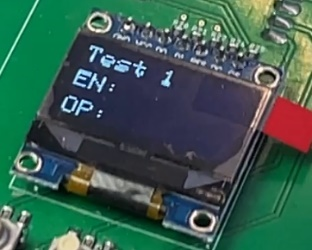
[picture p199: figure]

1. Pulsar el botón T2.

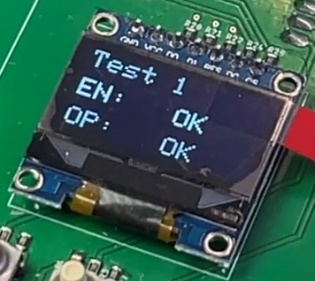
[picture p200: figure]

2. Esperar entorno a 30 segundos a que aparezca en ambos valores “OK”.

## 3.5 Test 3.DAC

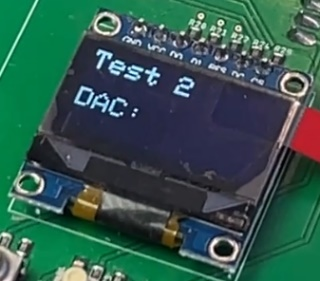
[picture p201: figure]

1. Pulsar el pulsador T3.

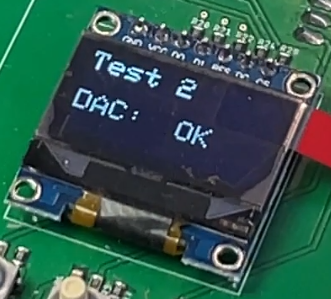
[picture p202: figure]

2. Esperar entorno a 30 segundos a que aparezca “OK”.

## 3.6 Valores de Sensado.

En la pantalla de la placa de la cpu aparecerán 2 valores: I e V.

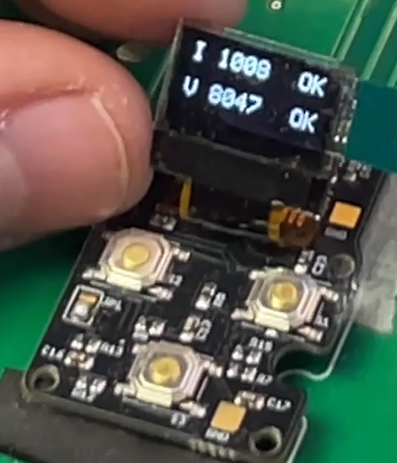
[picture p203: figure]

Si los valores se encuentran dentro de los márgenes esperados, aparecerá un “OK” al lado de cada valor.

## 3.7 Validación/Marcaje de Errores

Al terminar la prueba es necesario apuntar 3 valores en el excel Test CPU.

# Anexo 1: Número de Serie.

El guardar el numero de serie va ligado a la posición de memoria donde se aloja y se consulta ese dato. Ese dato es necesario para la configuración del JFlash.

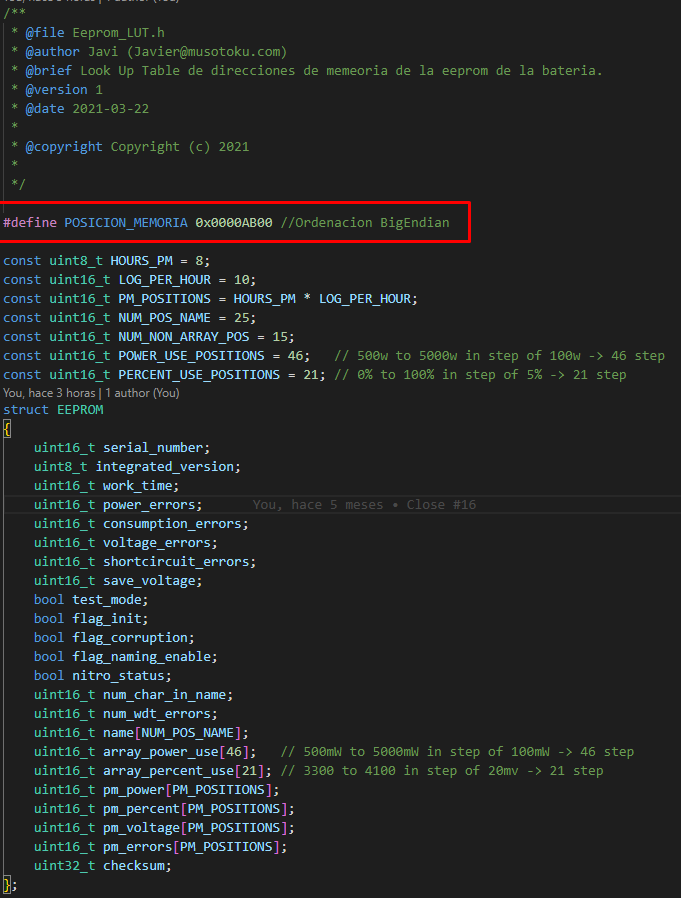
[picture p204: figure]

El valor de posición se encuentra en el archivo “EEPROM_LUT.h” con el Path “..\01.Rover\03.Firmware\LIBRARIES\0010-LOGGING\Eeprom_LUT.h”

En este caso del ejemplo seria 0x0000AB00.

Este dato se coloca en los Project Settings del programa JFlash:

# 1 Listado de Numero de Serie.

Para el grabado del numero de serie el JFlash necesita 2 archivos.

- SAMD21_SNList.txt: Listado de los números de serie a grabar. Este listado tiene un formato concreto y es que es un formato Hexadecimal BigEndian. Hexademical quiere decir que los dígitos van del 0 al F (0 al 15). Van en parejas de dígitos, y las posiciones con mayor carga se escriben a la derecha, al contrario que de normal.

Un ejemplo de esto serian los siguientes:

Valor Hexadecimal BiggEndian | Valor Decimal.
05 | 5
0A | 10
19 | 25
6701 | 361

(Bigg Endiand) 0x6701 = 0x01 67 (Little Endiand) = 361 Decimal

- SAMD21_Serial.txt: Este archivo almacena un valor que indica el índice de la lista de números de serie próximo que va a ser grabado. El dato está en formato decimal.

# 4 Troubleshotting

## 4.1 Fallo en el Test 1. No sale el Nº de Serie.

Realizamos la programación, el JFLASH me indica que se realizo correctamente, pero en la pantalla de la tarjeta de testeo, no aparece el numero de serie.

Este problema indica un fallo en la tarjeta CPU que se esta programando.

1. Desacoplar la tarjeta CPU.
2. Volver a colocarla poniendo mucha atención a que este bien colocada.
3. Probar a programar de nuevo.
4. En caso de que aparezca el numero de serie, es posible que no se el correspondiente a la lista. (Consultar Fallo “Numero de Serie No consecutivo. No se corresponde con el del Excel.”)

En caso de que no aparezca, separar la tarjeta indicando el fallo ( Ej: 2.1) En una etiqueta pegada a la tarjeta.

## 4.2 Fallo en el Test 2. Ambas o algún valor no aparece OK.

En caso de que no aparezca, separar la tarjeta indicando el fallo en una etiqueta pegada a la tarjeta. Indicando el Nº de serie y el fallo.

2.2.a Si es la señal EN la que no aparece el OK.

2.2.b Si es la señal OP la que no aparece el OK.

2.2.c Si no aparece en ninguna de las señales el OK.

EJ: 456-2.2c

Adicionalmente se toma nota en el excel de logeo, indicando el error en la casilla correspondiente. Ejemplo:

Se continua con el test 3 por comprobar si también da fallo o no.

## 4.3 Fallo en el Test 3. No aparece OK.

En caso de que no aparezca, separar la tarjeta indicando el fallo en una etiqueta pegada a la tarjeta. (2.3)

Adicionalmente se toma nota en el Excel de logeo, indicando el error en la casilla correspondiente. Ejemplo:

## 4.4 Fallo en los valores del display de la CPU.

Alguno de los valores se sale de los márgenes de tolerancia y en la pantalla aparece la palabra BAD.

En este caso, se apuntan lo valores en el excel y se separa la tarjeta indicando el error:

2.4.a Si es la señal I la que aparece con el BAD.

2.4.b Si es la señal V la que aparece con el BAD.

2.4.c Si es en ambas señales que aparecen con el BAD.

## 4.5 Fallo en JFLASH al programar.

- Le doy a programar y me salta el error de programación en el JFlash y no programa la placa.

El fallo puede deberse a varios factores.

  - El JTAG no esta conectado al ordenador o a la placa de test.
  - La placa de test no está alimentada. El cable de alimentación micro USB no esta enchufado o no alimenta correctamente. Revisar el led dela placa que asegura que la placa esta alimentada.
  - La tarjeta CPU tiene algún error. Para esto, lo mejor es probar con otra tarjeta, si con esta funciona, volver a probar con la que daba error inicialmente y si continua sin programarse se separa para una reparación o supervisión mas exhaustiva.

## 4.6 Numero de Serie No consecutivo. No se corresponde con el del Excel.

- El numero de serie grabado, no se corresponde con el que debería ser según el Excel.

Posiblemente se hayan hecho más de una grabación para una misma tarjeta. Para solucionarlo:

1. Buscamos el archivo que almacena el índice de los números de serie

“…\Team Dropbox\MUSOTOKU\PRODUCCION\Programacion ROVER R-1\SAMD21_Serial.txt”

2. Abrimos el archivo y sustituimos el numero que aparece en el archivo por el número de serie que continua a la lista de Excel.
3. Cerramos el archivo, guardando los cambios efectuamos.

## 4.7 Error de Numero de serie

- En el Jflash me salta un error relacionado con el número de serie como este:

Este error nos indica que es posible que los numero de serie se hayan acabado. Nos apuntamos el numero que aparece al comienzo del mensaje (En el ejemplo, SN = 555)

1. Abrir el archivo:

“…\Team Dropbox\MUSOTOKU\PRODUCCION\Programacion ROVER R-1\SAMD21_Serial.txt”

2. En el nos encontraremos todos los numero se serie usados hasta ahora, nos desplazaremos hasta abajo del todo.
3. Miraremos cual es el último número de serie y lo comparemos con el numero obtenido en el error. Normalmente, el número del error será superior o igual al ultimo número del archivo (Recordar que tenemos que pasar el numero del archivo que esta codificado en Hexadecimal BiggEndian, a Decimal. Consultar el Anexo 1 en caso de duda).
4. Abriremos el archivo :

“…\Team Dropbox\MUSOTOKU\PRODUCCION\Programacion ROVER R-1\SAMD21_Serial.txt”

5. Sustituiremos el numero que aparece, por el ultimo numero del numero de serie de la lista y le sumaremos 1.
6. Añadiremos números de serie.
  a. Abrimos el excel de Generación de números de Serie (https://docs.google.com/spreadsheets/d/1xAZUIYiMgajz9gN9YHIjz4N_0fOC8txkc5JpDvOxcPs/edit?usp=sharing).
  b. Introducimos en la consulta, el ultimo numero de serie del listado, en la consulta de número de serie:

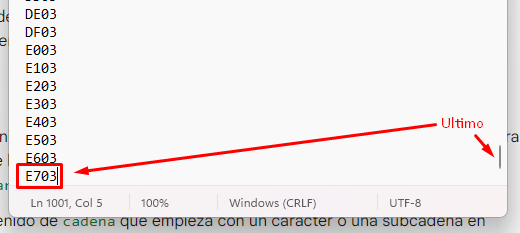
[picture p205: figure]

  c. Miramos el Decimal que nos arroja, en este caso el 999.
  d. Buscamos en la lista el numero Decimal +1, en este caso 1000.

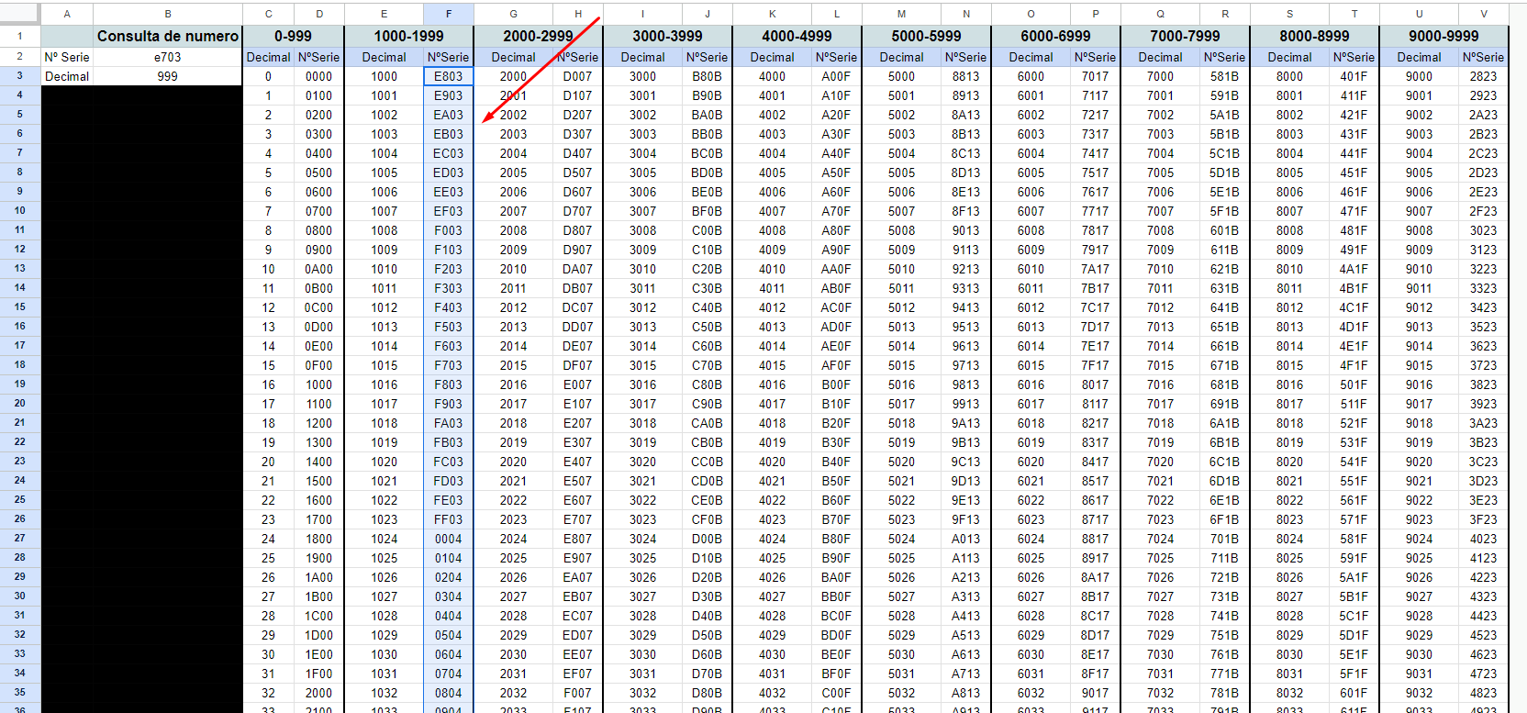
[picture p206: figure]

  e. Seleccionamos la columna Nº Serie, desde el numero hasta el final de la columna.
  f. Pulsamos Ctrl+V, o click derecho copiar.
  g. Abrimos el archivo del listado de números de serie, SAMD21_SN_list.
  h. Nos vamos al final del archivo y clickamos a la derecha del ultimo numero y pulsamos Enter para generar un salto de linea.
  i. Pulsamos Ctrl+C, o click derecho Pegar.
  j. Con esto abremos pegado los números de serie.
  k. Salimos del archivo guardando los cambios efectuados.
