MSTKMAD/battery-pack/01.Documentation/01.Diseño/Documentacion Software/B1/Diagrams/Battery/Logging/Diagnostic-PrintDiagnosticData.jpg

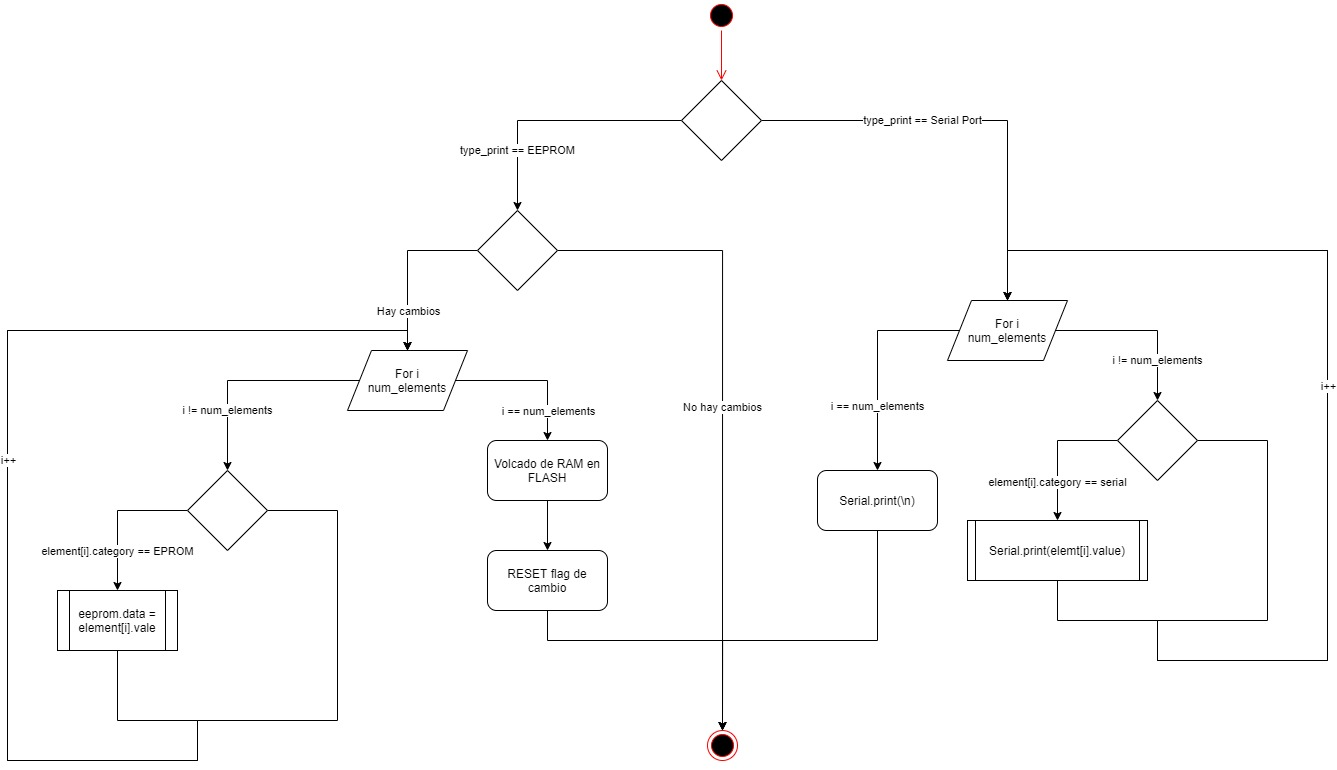
01.Documentation/01.Diseño/Documentacion Software/B1/Diagrams/Battery/Logging/Diagnostic-PrintDiagnosticData.jpg
