MSTKMAD/battery-pack/01.Documentation/04.Tests/Test 500 primeras placas DCDC.docx

8 de marzo de 2023

# Test Placa DCDC.

Testeo de 480 unidades del pcb “DCDC”.

ERRORES:

1. Fallo en el soldado de R3 → Efecto Manhatan (la resistencia solo esta soldada en un extremo, el otro extremo flota)

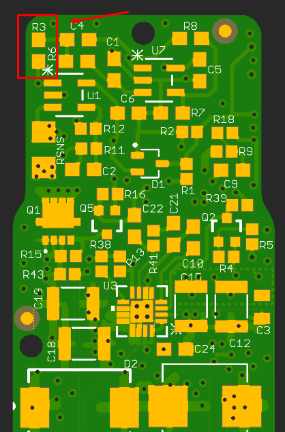
[picture p209: figure]

- Ubicación:

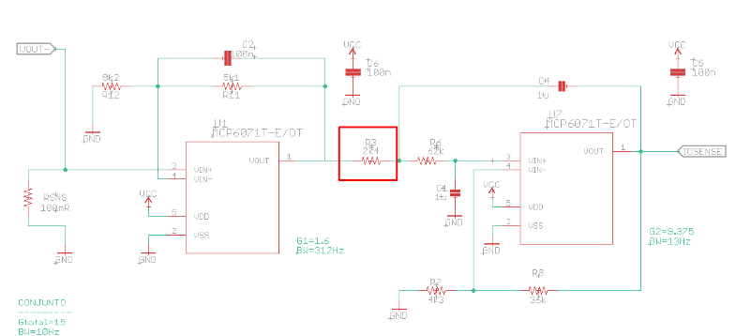
[picture p210: figure]

- Detección:
- inspección visual: Se detecta que R3 no se encuentra correctamente soldado.

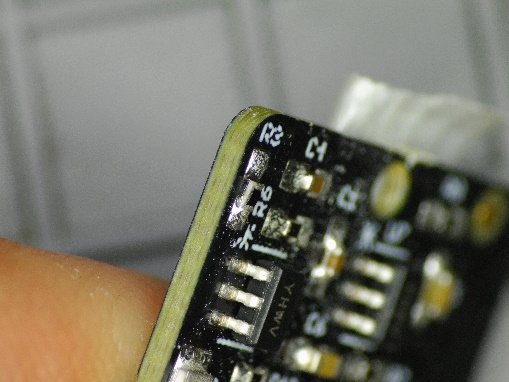
[picture p211: figure]
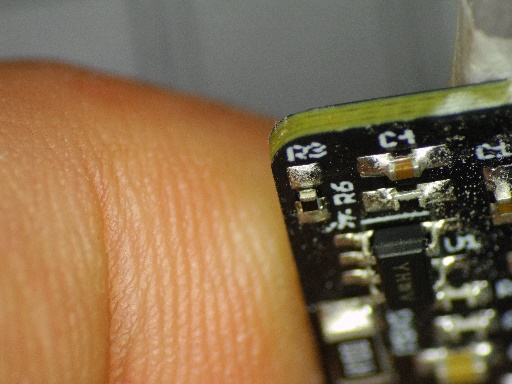
[picture p212: figure]

#116

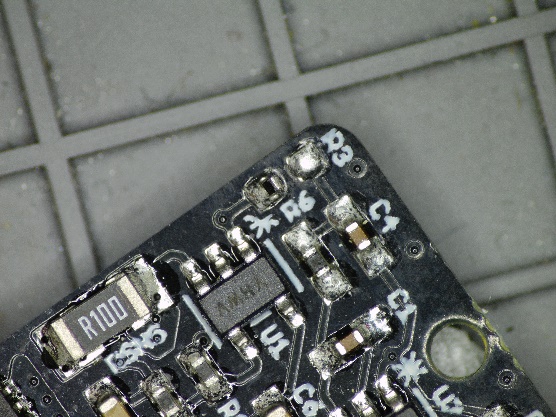
[picture p213: figure]
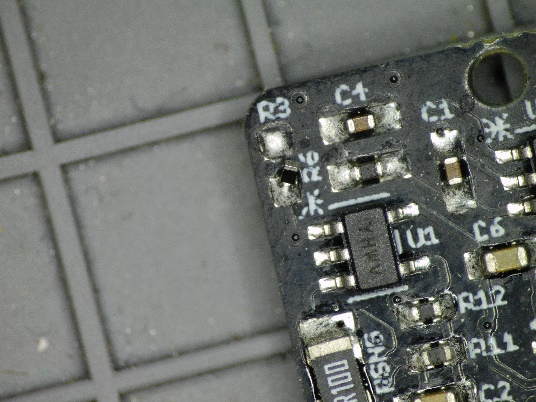
[picture p214: figure]

#122

#124

- Valores en el Test 3:

El fallo no conlleva riesgo para la placa.
Al estar rota la cadena del sensado de corriente. Los valores arrojados oscilan alrededor de 1090.

- Fallo en el soldado de C1. Efecto Manhatan (un extremo soldado y el otro flota)

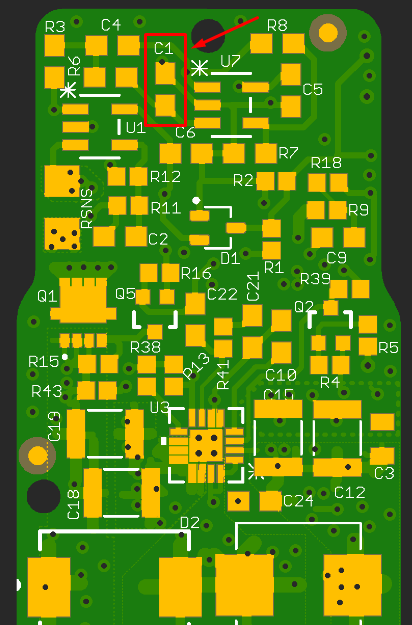
[picture p215: figure]
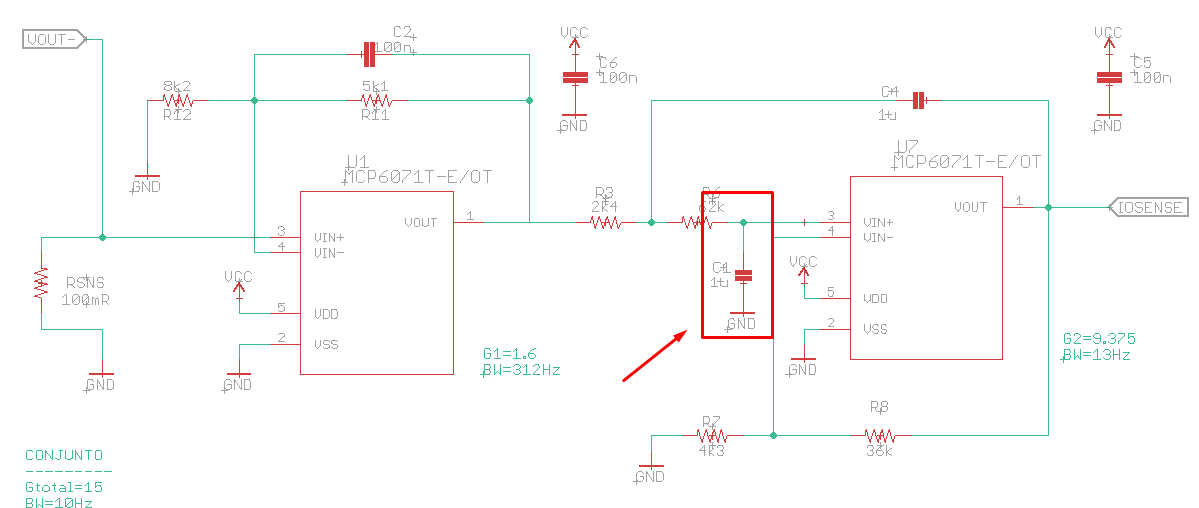
[picture p216: figure]

- ubicación:
- Detección:

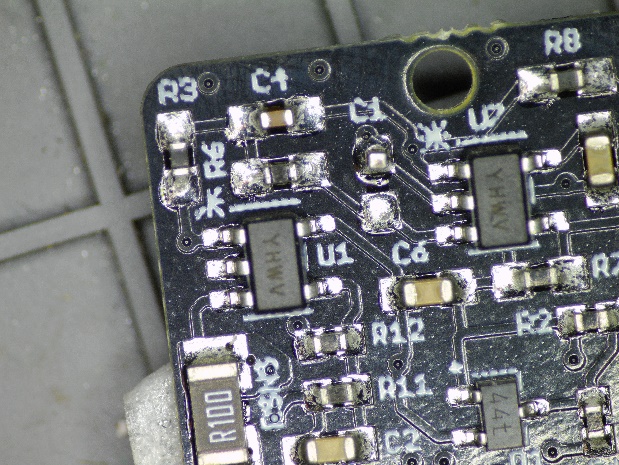
[picture p217: figure]

  - Inspeccion Visual:

#140

  - Valores en el Test 3:

El fallo no conlleva riesgo para la placa
Al estar en presente en el filtrado de corriente, interfiere en la medida de corriente. En el test de 1W presenta una medida entorno a los 700mA (200 es lo esperado)

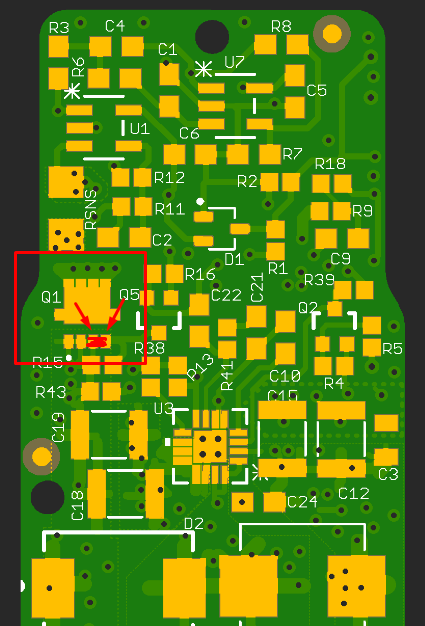
[picture p218: figure]

- Fallo en el soldado del Transistor de Salida. Corto-circuito entre los pines del puerta y fuente.

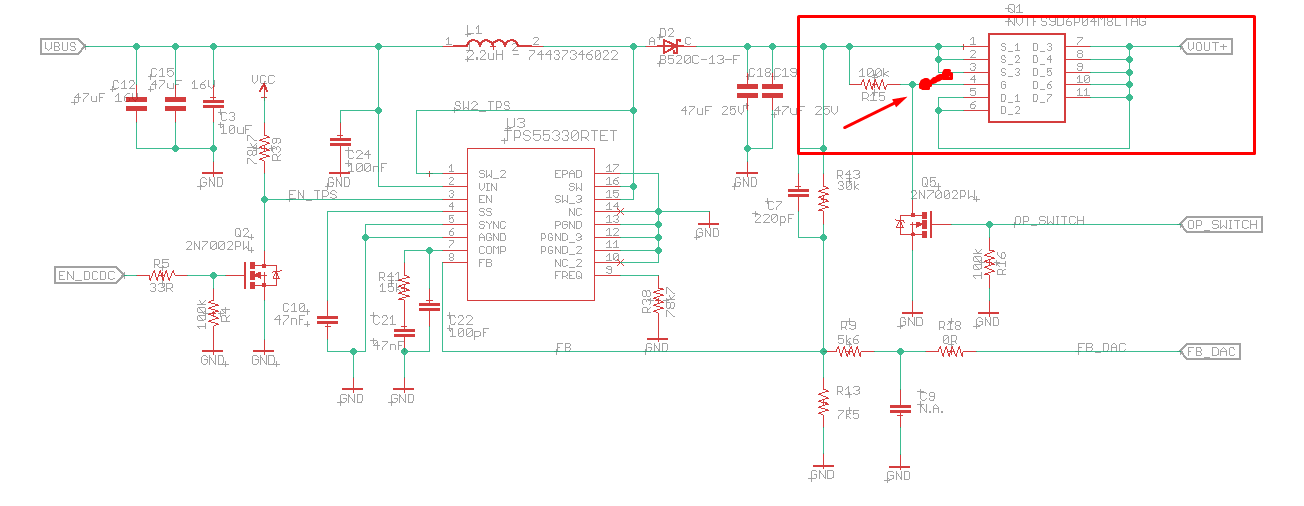
[picture p219: figure]

- Ubicación:
- Detección:

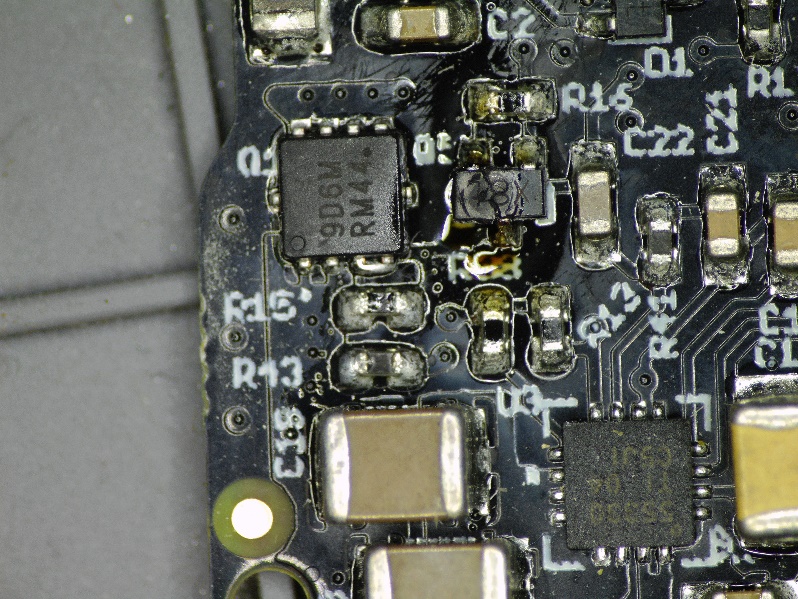
[picture p220: figure]

  - inspección Visual:

#111

  - Efectos:

El fallo conlleva riesgo para la placa.
El cortocircuito provoca que toda la tensión cae sobre el transistor de la señal de OP_SWITCH, provocando que se queme y se destruya, provocando calor y humo.

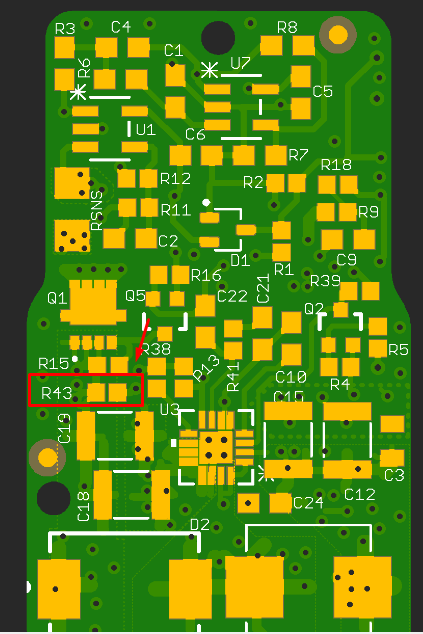
[picture p221: figure]

- Ausencia de R43:

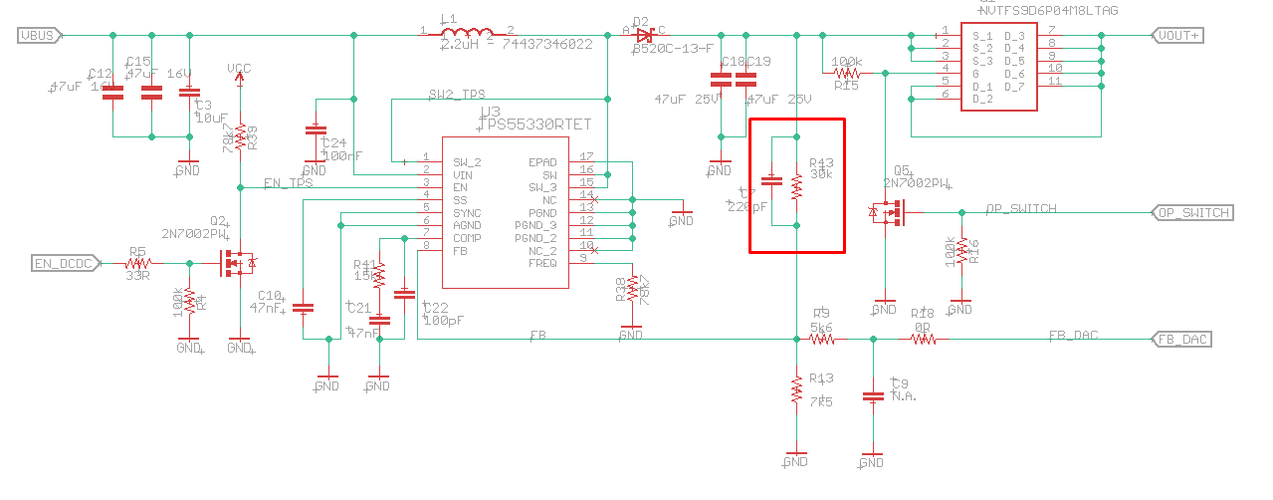
[picture p222: figure]

- Ubicación:
- Detección:

El fallo conlleva riesgo para la placa

  - Por Inspección Visual
  - Test 1. No pasa el test porque se fija una tensión para probar el OPSWITCH y el ENABLE. Además se puede detectar una subida de temperatura ya que el DCDC está en lazo abierto y la bobina se calienta.

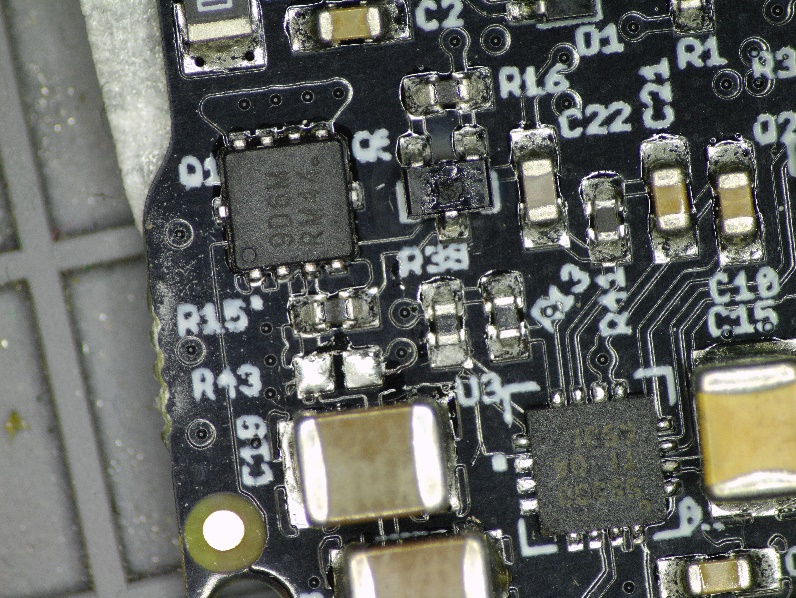
[picture p223: figure]

#40

- Ausencia de Rsense:

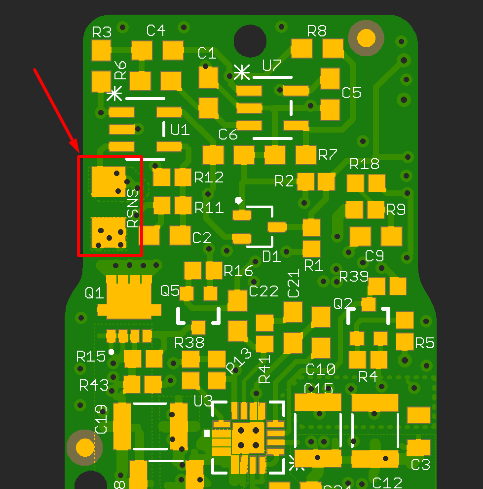
[picture p224: figure]
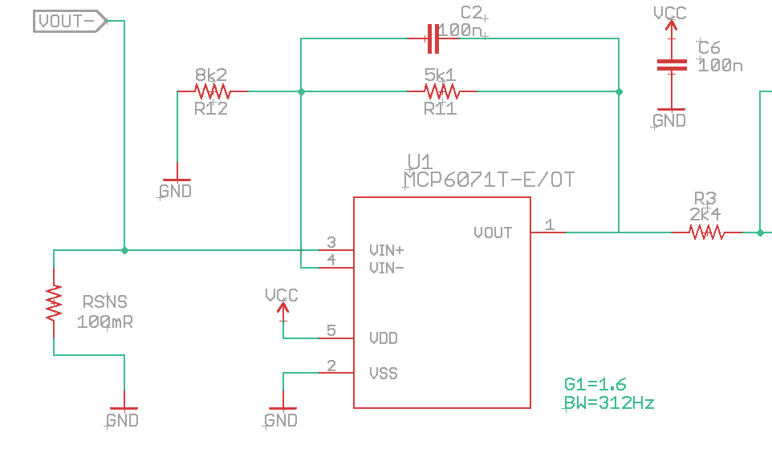
[picture p225: figure]

- Ubicacion:
- Detección:

El fallo conlleva riesgo para la placa

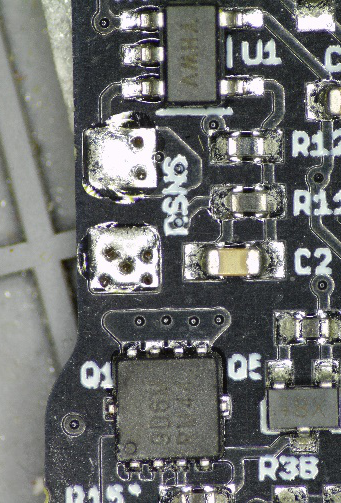
[picture p226: figure]
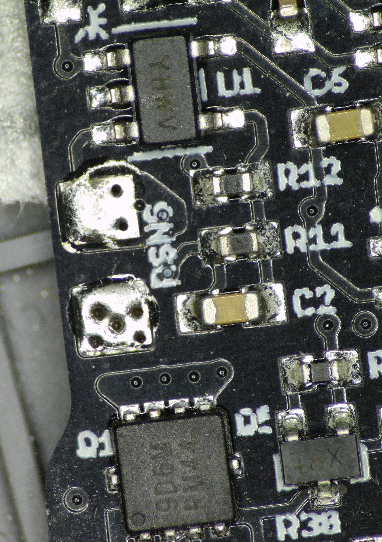
[picture p227: figure]
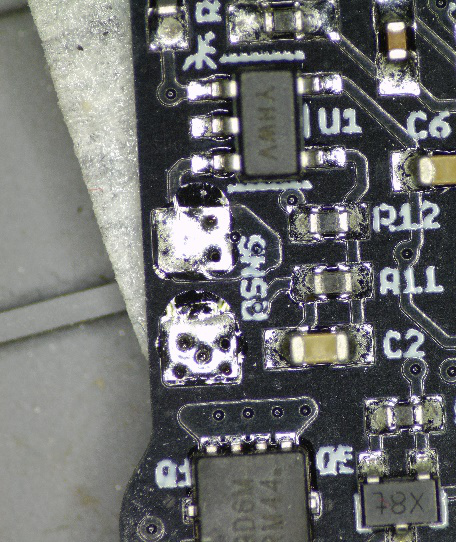
[picture p228: figure]
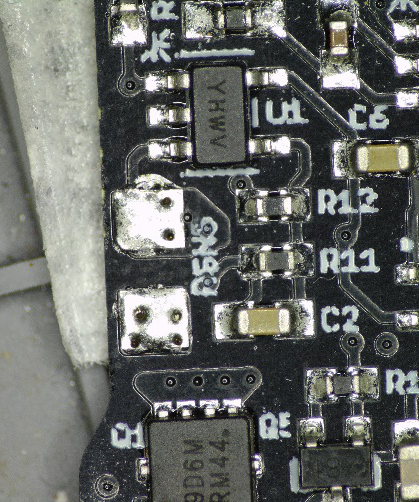
[picture p229: figure]
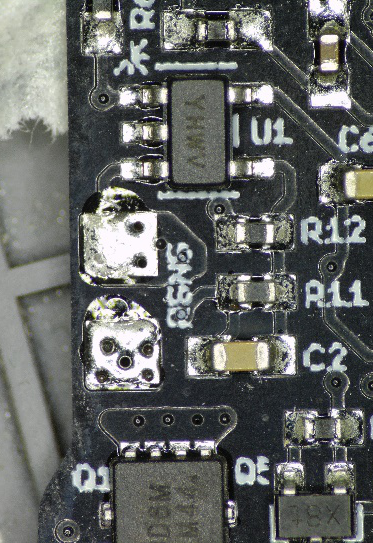
[picture p230: figure]

- inspección visual.

# 379, 381, 383, 384, 391

- Ausencia de U1:

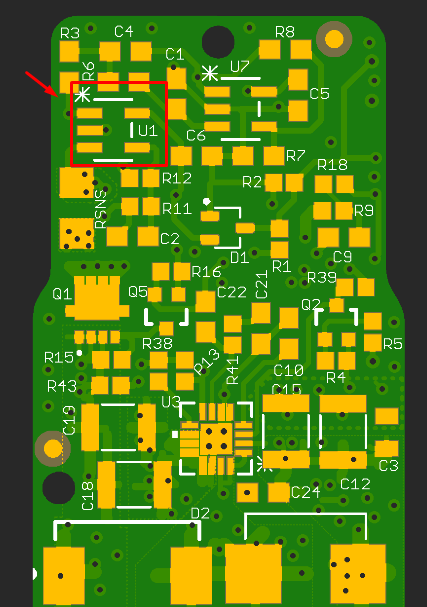
[picture p231: figure]
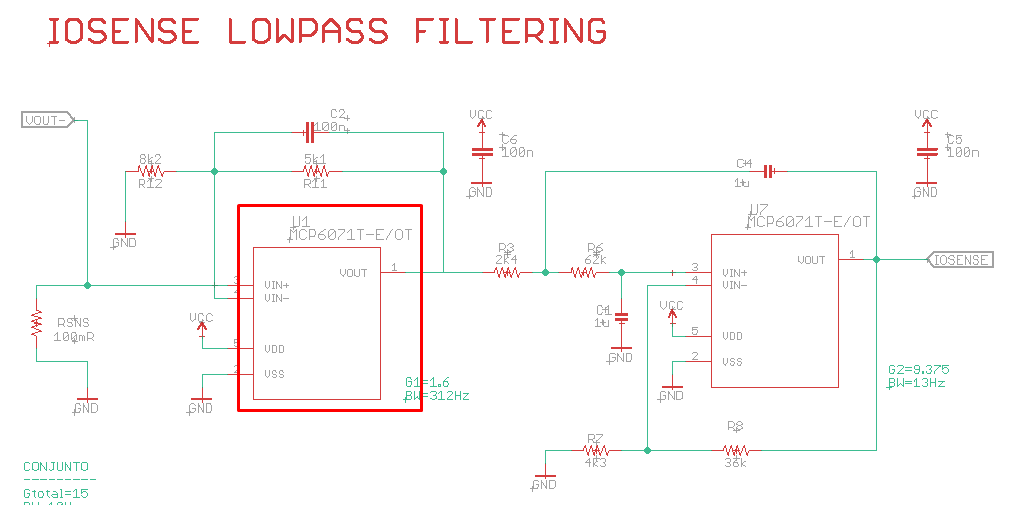
[picture p232: figure]

- Ubicación:
- Detección:

El fallo No conlleva riesgo para la placa

- Inspección visual.

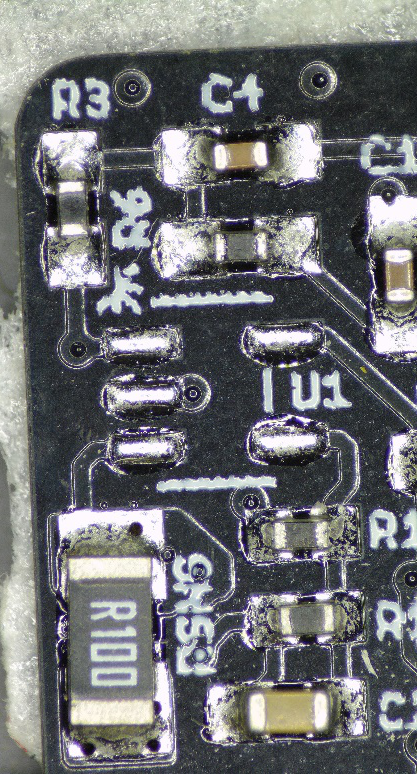
[picture p233: figure]

# 440

# Conclusiones.

Para prevenir los fallos destructivos se decide incluir un criterio adicional en el test 1 (op switch, enable) y test 2 (escalera de voltaje).

Durante ambos tests la corriente deberá permanecer por debajo de un umbral de protección ya que es son pruebas que se realiza sin carga. De esta manera, si se detecta una subida de la corriente, indicaría un error en el circuito de la tarjeta.
