MSTKMAD/battery-pack/01.Documentation/03. Produccion/Tutoriales/Test Procedure Batt Connector.docx

# Test Procedure Batt Connector.

# 1 Materiales necesarios:

- Multímetro con capacidad para diodo.

# 2 Funcionalidades que testear:

- Control de polaridad:

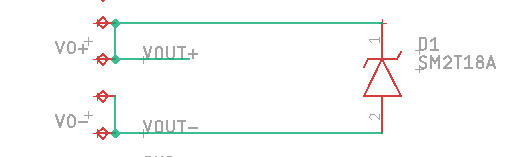
[picture p235: figure]

  - Entrada:

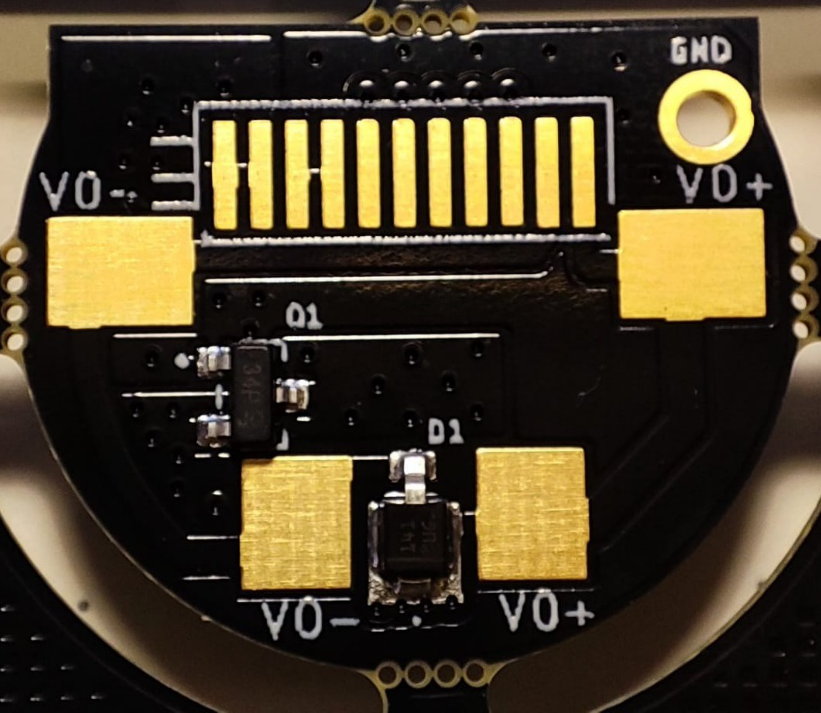
[picture p236: figure]

En el multímetro tiene que aparecer:

0.6v

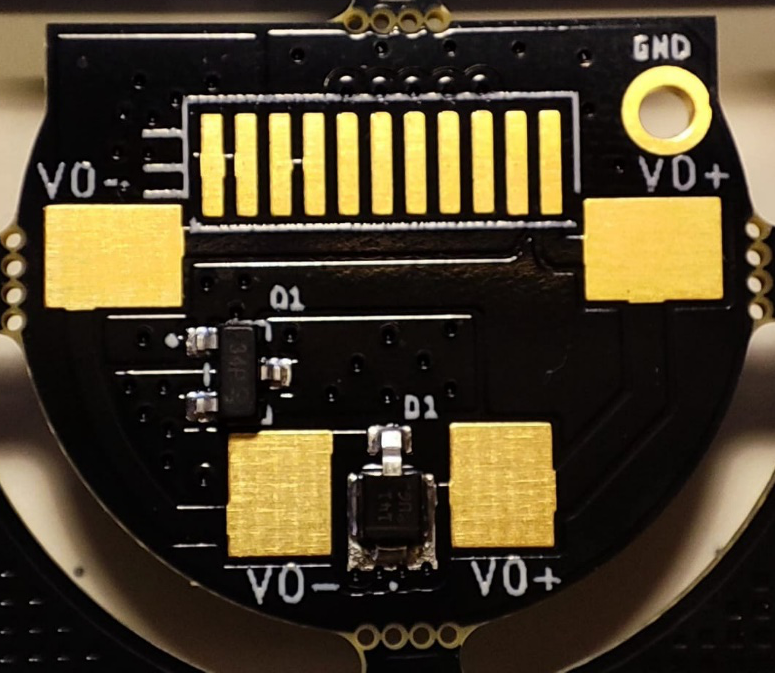
[picture p237: figure]
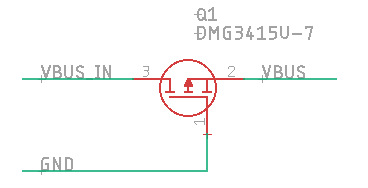
[picture p238: figure]

  - Salida:

En el multímetro tiene que aparecer:

0.3-0.4v
