MSTKMAD/battery-pack/04.MECHANICS/03.POGOPIN_BED_DCDC/TEST DC-DC ROVER R1_3D.pdf

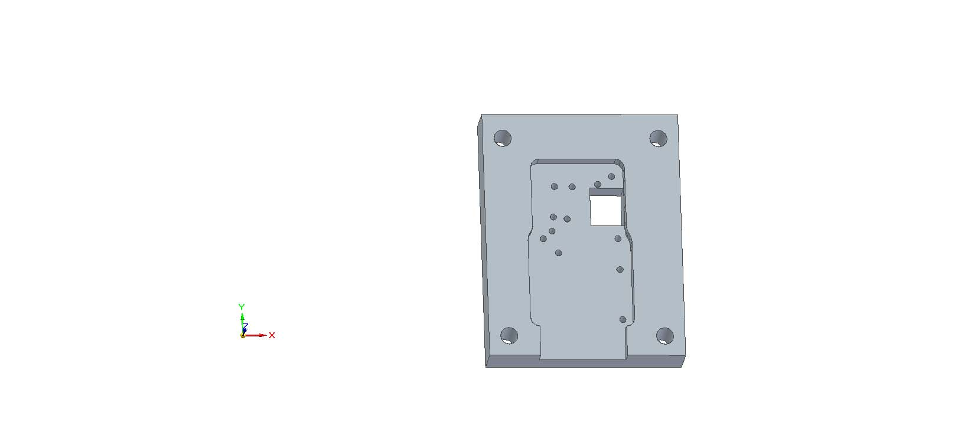
[picture p239: figure]
