MSTKMAD/battery-pack/01.Documentation/01.Diseño/Calibracion DAC.xlsx

Sheet: 120-1420
Vout Max | 120 |  | DAC FS | 3000 | V
Vout Min | 50 |  | DAC resolution | 1024 | bits
Vdac Vmax | 120 | mV | DAC Vmax | 41
Vdac Vmin | 1420 | mV | DAC Vmin | 485
Vout teorica | DAC count | Voltaje DAC Teorico | Vout teorico (mV) | Vout medido (mV) | Diff
50 | 485 | 1420.898438 | 5000 | 5092 | 92
51 | 479 | 1403.320312 | 5100 | 5190 | 90
52 | 472 | 1382.8125 | 5200 | 5283 | 83
53 | 466 | 1365.234375 | 5300 | 5393 | 93
54 | 460 | 1347.65625 | 5400 | 5488 | 88
55 | 453 | 1327.148438 | 5500 | 5582 | 82
56 | 447 | 1309.570312 | 5600 | 5694 | 94
57 | 441 | 1291.992188 | 5700 | 5788 | 88
58 | 434 | 1271.484375 | 5800 | 5882 | 82
59 | 428 | 1253.90625 | 5900 | 5995 | 95
60 | 422 | 1236.328125 | 6000 | 6088 | 88
61 | 415 | 1215.820312 | 6100 | 6184 | 84
62 | 409 | 1198.242188 | 6200 | 6294 | 94
63 | 403 | 1180.664062 | 6300 | 6388 | 88
64 | 396 | 1160.15625 | 6400 | 6483 | 83
65 | 390 | 1142.578125 | 6500 | 6594 | 94
66 | 384 | 1125 | 6600 | 6689 | 89
67 | 377 | 1104.492188 | 6700 | 6783 | 83
68 | 371 | 1086.914062 | 6800 | 6894 | 94
69 | 364 | 1066.40625 | 6900 | 6989 | 89
70 | 358 | 1048.828125 | 7000 | 7085 | 85
71 | 352 | 1031.25 | 7100 | 7197 | 97
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
