MSTKMAD/battery-pack/01.Documentation/04.Tests/TESTBATTERYEXFAN.xlsx

Column1 | Column2 | Column3 | Column4 | Column5 | Column6 | Column7
4093 | -608 | 199 | 0 | 608 | 4102 | 94
4091 | -608 | 199 | 0 | 608 | 4086 | 92 | Seg | 7438
4089 | -609 | 199 | 0 | 609 | 4072 | 91 | Horas | 2.066111111
4087 | -612 | 199 | 0 | 612 | 4063 | 90 | Current Avg | 518.6597204
4085 | -615 | 199 | 0 | 615 | 4048 | 88 | Capacidad | 1071.608611
4084 | -615 | 199 | 0 | 615 | 4037 | 87
4082 | -615 | 199 | 0 | 615 | 4026 | 85
4081 | -615 | 199 | 0 | 615 | 4018 | 85
4080 | -613 | 199 | 0 | 613 | 4008 | 83
4078 | -614 | 199 | 0 | 614 | 3998 | 82
4078 | -615 | 199 | 0 | 615 | 3991 | 81
4076 | -615 | 199 | 0 | 615 | 3981 | 80
4075 | -615 | 199 | 0 | 615 | 3971 | 79
4075 | -615 | 199 | 0 | 615 | 3963 | 78
4073 | -615 | 199 | 0 | 615 | 3953 | 77
4073 | -615 | 199 | 0 | 615 | 3943 | 76
4072 | -615 | 199 | 0 | 615 | 3932 | 75
4071 | -615 | 199 | 0 | 615 | 3925 | 74
4070 | -615 | 199 | 0 | 615 | 3915 | 73
4069 | -616 | 199 | 0 | 616 | 3906 | 72
4069 | -615 | 199 | 0 | 615 | 3899 | 71
4068 | -615 | 199 | 0 | 615 | 3889 | 70
4067 | -616 | 199 | 0 | 616 | 3880 | 69
4066 | -616 | 199 | 0 | 616 | 3873 | 68
4066 | -616 | 199 | 0 | 616 | 3864 | 67
4065 | -616 | 199 | 0 | 616 | 3854 | 66
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
