MSTKMAD/battery-pack/02.Hardware/V1-ROVER-2K/TEST/Chargers and Gauge/0ohm CC retries.png

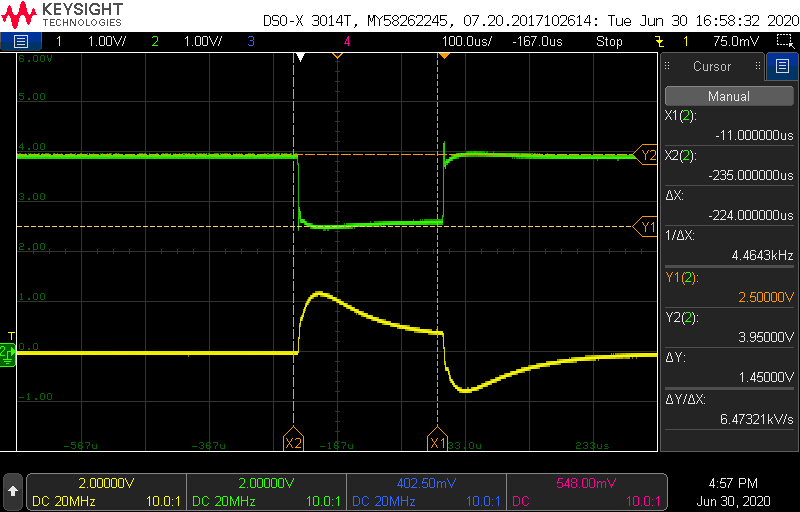
02.Hardware/V1-ROVER-2K/TEST/Chargers and Gauge/0ohm CC retries.png
