MSTKMAD/battery-pack/02.Hardware/V1-ROVER-2K/TEST/Chargers and Gauge/reintento 0.5ohm CC.png

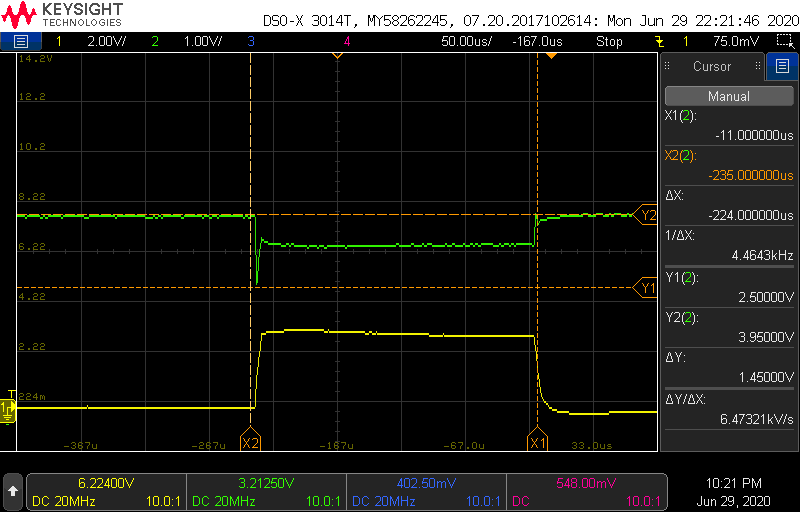
02.Hardware/V1-ROVER-2K/TEST/Chargers and Gauge/reintento 0.5ohm CC.png
