MSTKMAD/battery-pack/02.Hardware/V1-ROVER-2K/TEST/Chargers and Gauge/reintentos 0.5ohm cc.png

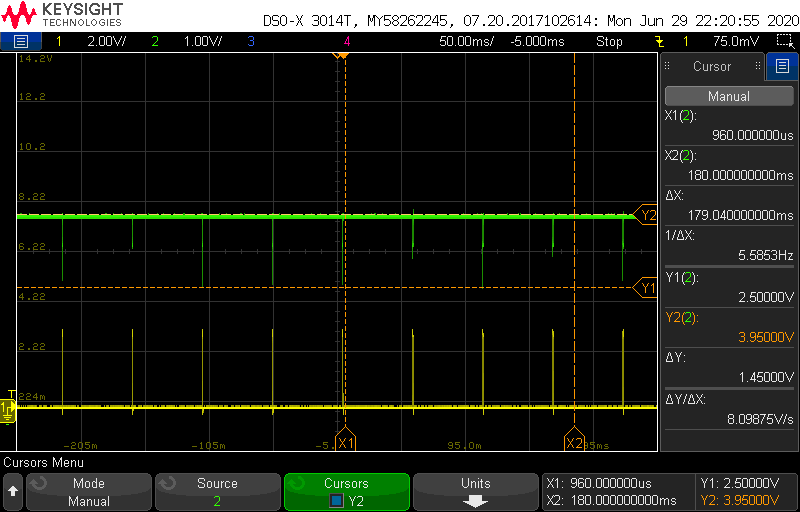
02.Hardware/V1-ROVER-2K/TEST/Chargers and Gauge/reintentos 0.5ohm cc.png
