MSTKMAD/battery-pack/01.Documentation/01.Diseño/Documentacion Software/B2/Diagnostico de los cambios ocasionados en la versión 201 de la Dan Kubin Rover R-1.docx

Diagnostico de los cambios ocasionados en la versión 201 de la Dan Kubin Rover R-1. Dichos cambios son extrapolables a la versión 121 de la Rover R-1 RCA y Cheyenne.

El objetivo es diseñar un protocolo de arranque SIN NITRO que sea funcional con porcentajes de batería bajos (<20%) con máquinas brushless como la Bishop Wand.

Escenario BASE:

Arranque abrupto, se pasa de 0 al voltaje objetivo:

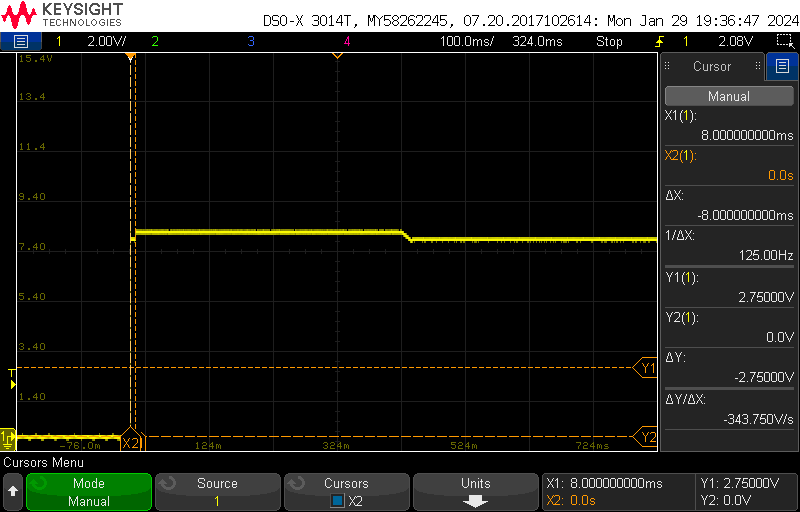
[picture p253: figure]

A) Se observa un ligera caída a mitad de imagen debido a que la foto se captura con la batería en vacio, y por tanto el modo boost se desactiva pasado un tiempo.
B) Hay 8 ms inciiales en los que el voltaje es algo menos.(parece que el modo boost estuviera desasctivado.

Escenario 1:

Rampa de 10 etapas desde 5v al voltaje objetivo.

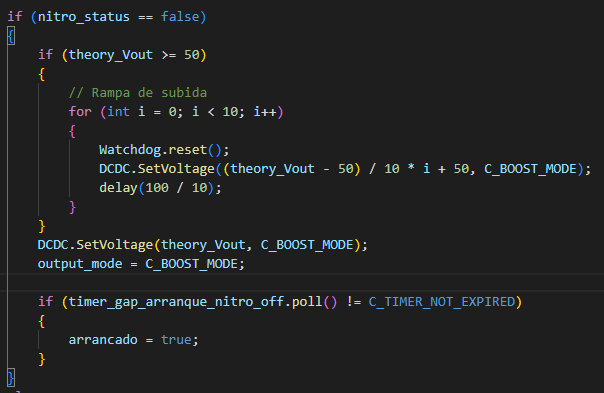
[picture p254: figure]

Se obtiene la siguiente imagen:

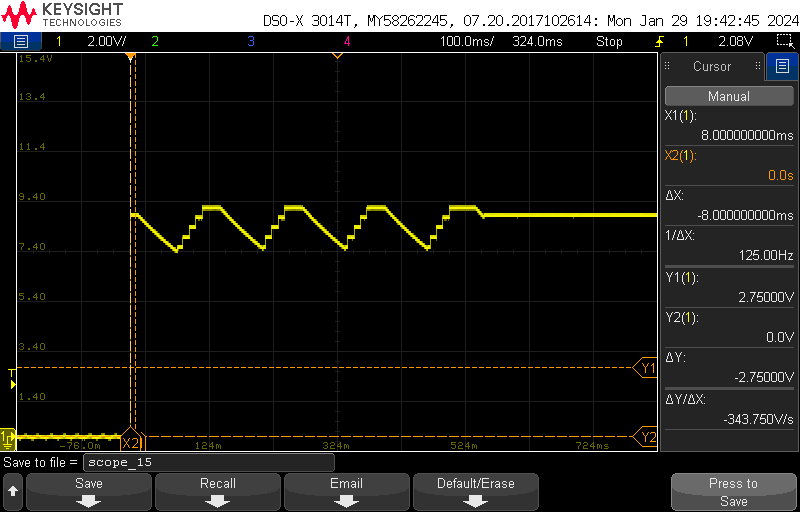
[picture p255: figure]

a) El voltaje comienza en el voltaje objetivo en vez de 5 voltios.
b) Lo mas preocupante es la repetición de la rampa durante aproximadamente 550 ms.

Se revisa el código buscando suprimir la repetición de 500ms.

Esta espera se debe a esta espera activa:

El “timer_gap_arranque_nitro_off”, surge como una espera análoga a la generada en el arranque de NITRO, para dejar el motor libre de las protecciones deurante un tiempo suponinedo algún pico extraño de corriente o algúna fluctuación del voltaje y evitar así, posibles activaciones en falso de las protecciones.

Sin embargo, esta espera activa junto con la pendiente provoca una situación indeseada, asique se decide suprimir dicha espera y esta es la curva obtenida

8v de salida

Carga: Power Wand.

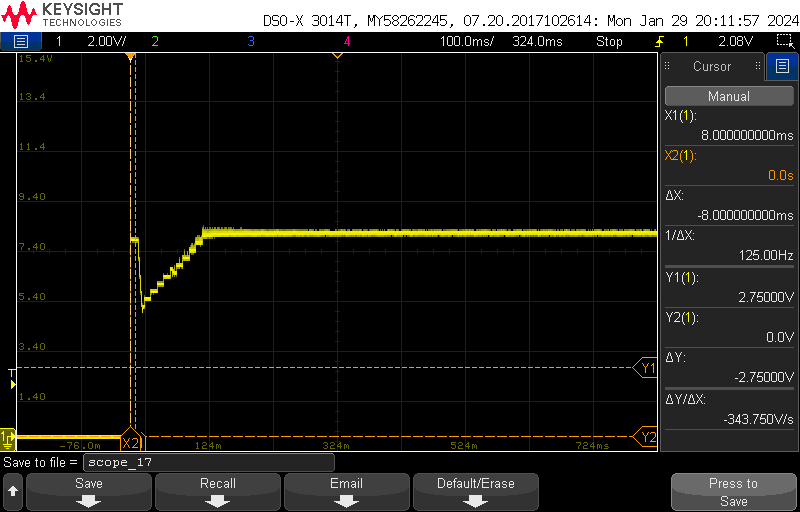
[picture p256: figure]

A) Se consigue solucionar la repetición de la escalera.
B) Continuamos observando que la escalera no comienza en 5v. Sino que empieza en el voltaje objetivo (8v en este caso) y baja para realizar la escalera.

Es posible que el ciclo de programa provoque la siguiente casuistica:

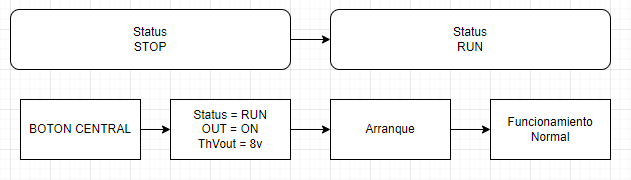
[picture p257: figure]
Diagrama

En el momento que se Activa la Salida y antes de que empiece el Arranque, el voltaje de salida es del Voltaje teórico. Esto podría parecer que serian pocas instrucciones hasta que empiece el arranque y por lo tanto no fuese perceptible, pero la realidad esque tiene un efecto negativo en el protocolo de arranque obejetivo.

Se supedita la activación de la salida a que el arranque haya tenido lugar:

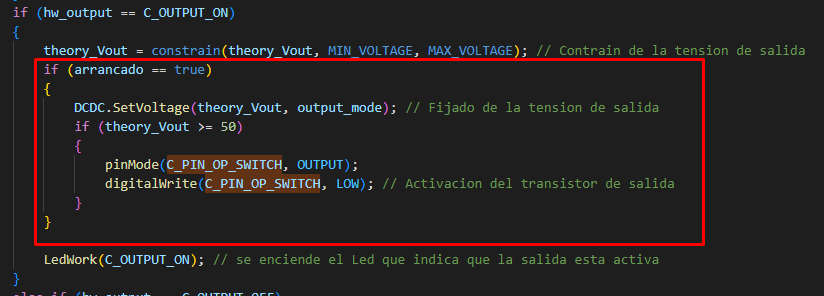
[picture p258: figure]

Esta es la forma de onda de la salida obtenida:

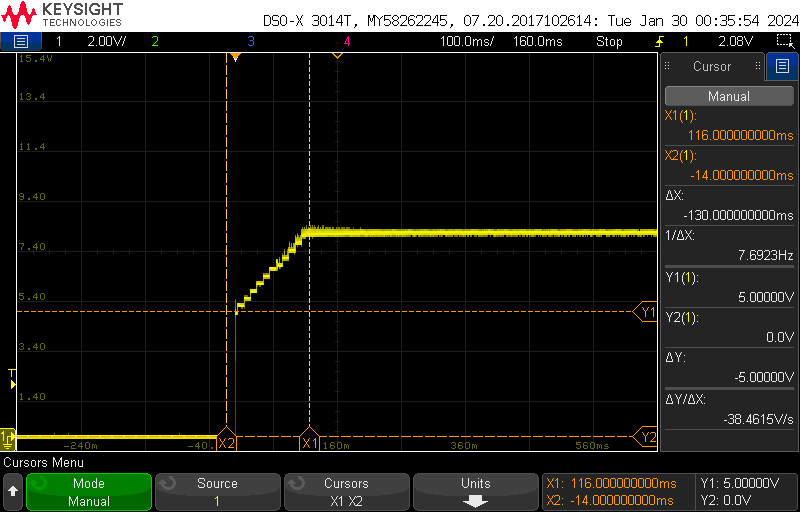
[picture p259: figure]

La Salida cumple con la forma deseada.

Escenario 2:

Fase inicial de Vout = Vbus durante 130ms, + Rampa de 10 etapas desde 5v al voltaje objetivo.

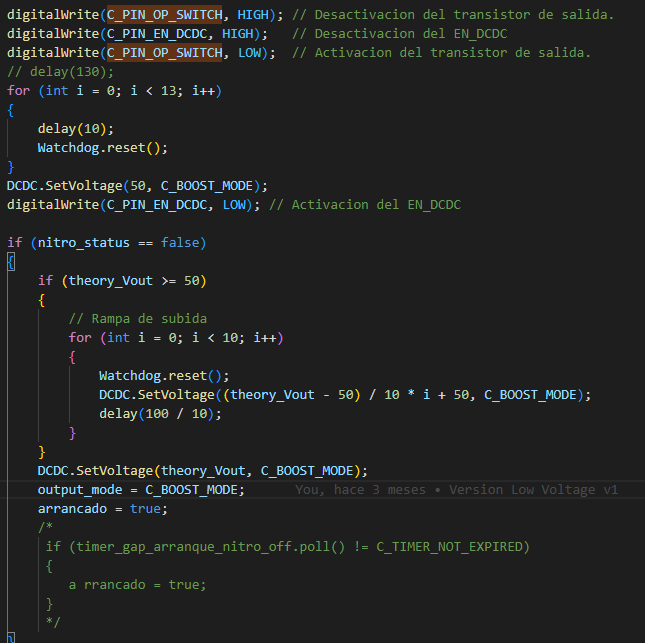
[picture p260: figure]

La salida Obtenida es la siguiente:

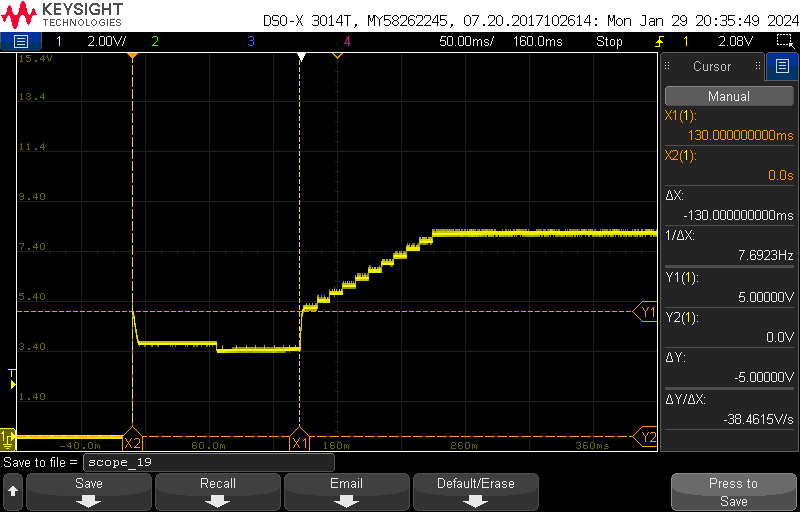
[picture p261: figure]
