MSTKMAD/battery-pack/02.HARDWARE/V2-ROVER R-1/04.PRODUCCION/SETI-BATCH-4_NOV2023/CAMBIOS EN LOS PCBs.docx

CAMBIOS EN LOS PCBs

Nuevas aperturas BOTTOM

- R15, R20 → SMD1206
- Q3 → SOT23

Añadidos fiduciles en ROMBO

3 en total en la parte inferior (no tenía antes)

Cara TOP

No hay cambios en cara TOP

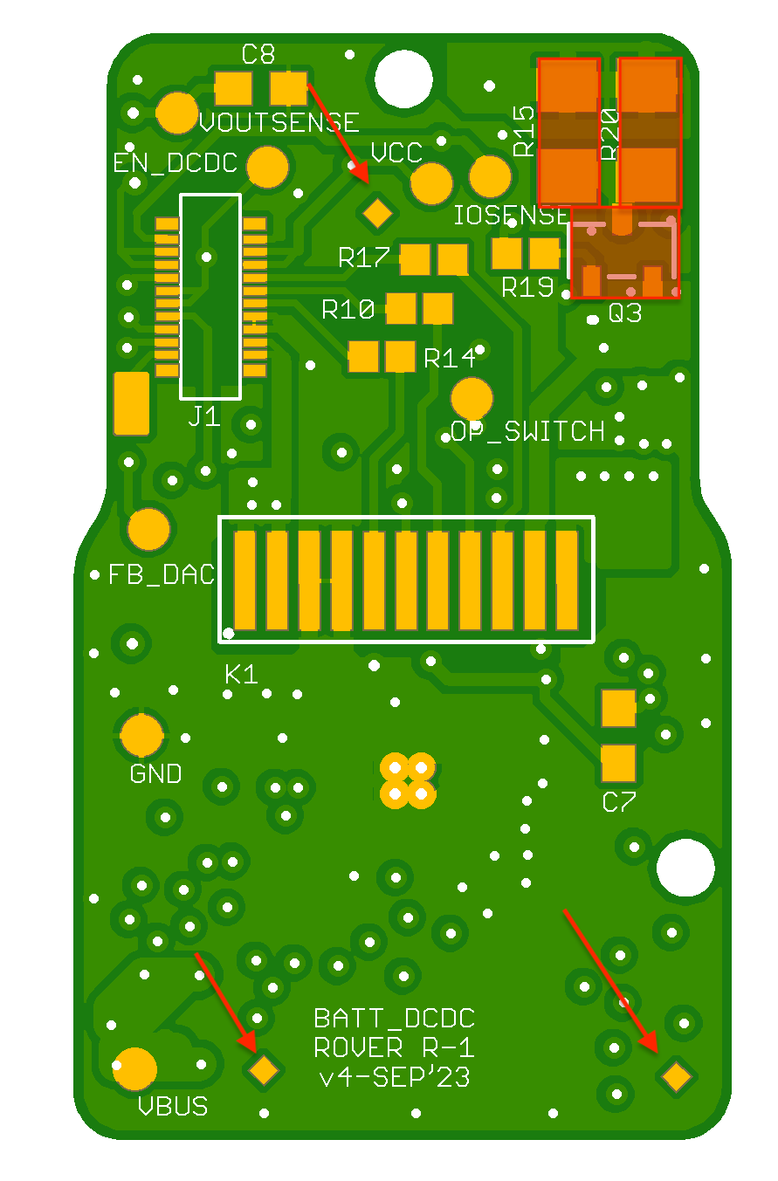
[picture p262: figure]

Nuevas aperturas

- D1 en cara BOTTOM → se abre un poco el landing de uno de los pads para que entre mejor el nuevo diodo que habéis encontrado para sustituir al anterior.

Añadidos fiduciles en ROMBO

2+2 en total en la parte superior e inferior (no tenía antes)

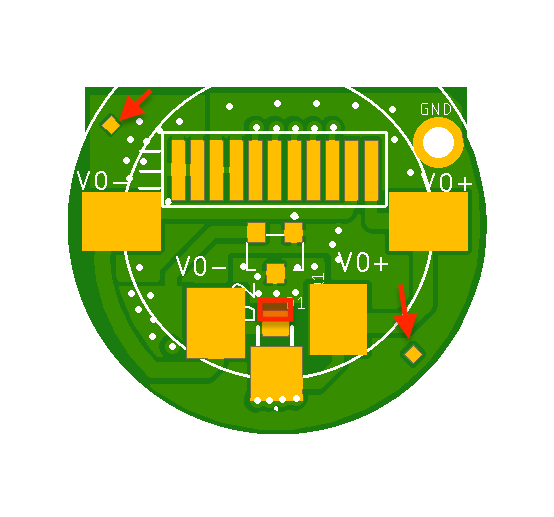
[picture p263: figure]
