MSTKMAD/battery-pack/02.Hardware/V1-ROVER-2K/Battery PCBs/BATT_CPU/Changes/Cambios CPU v4-v5.docx

# Cambios CPU.

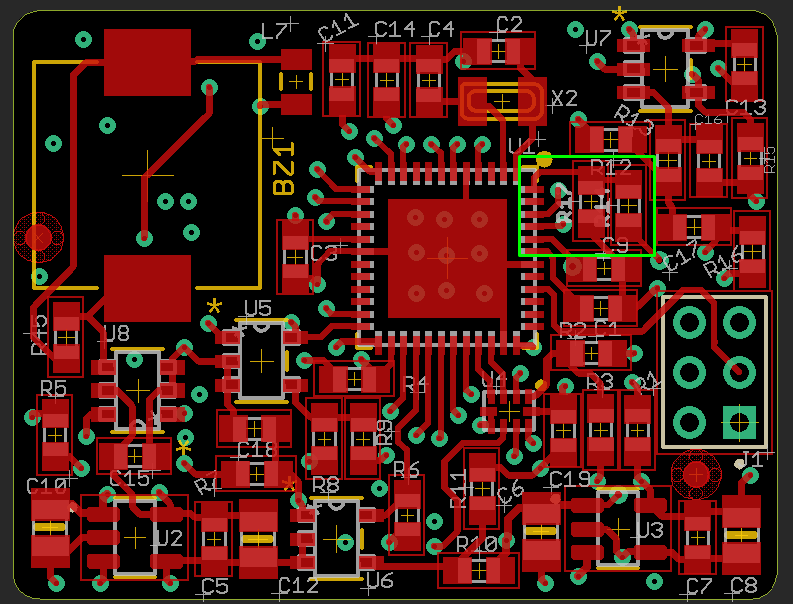
[picture p264: figure]

- Soldar divisor resistivo

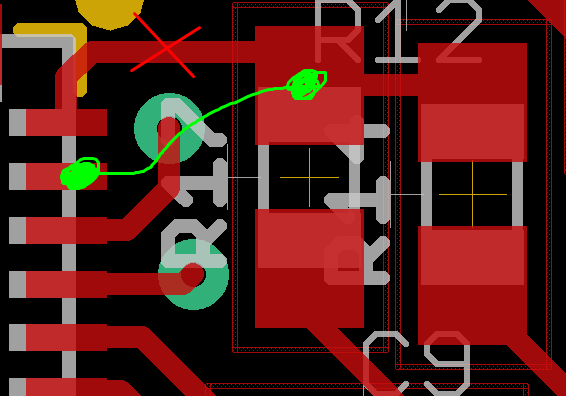
[picture p265: figure]

R14 = 100 k

R17 = 150 k

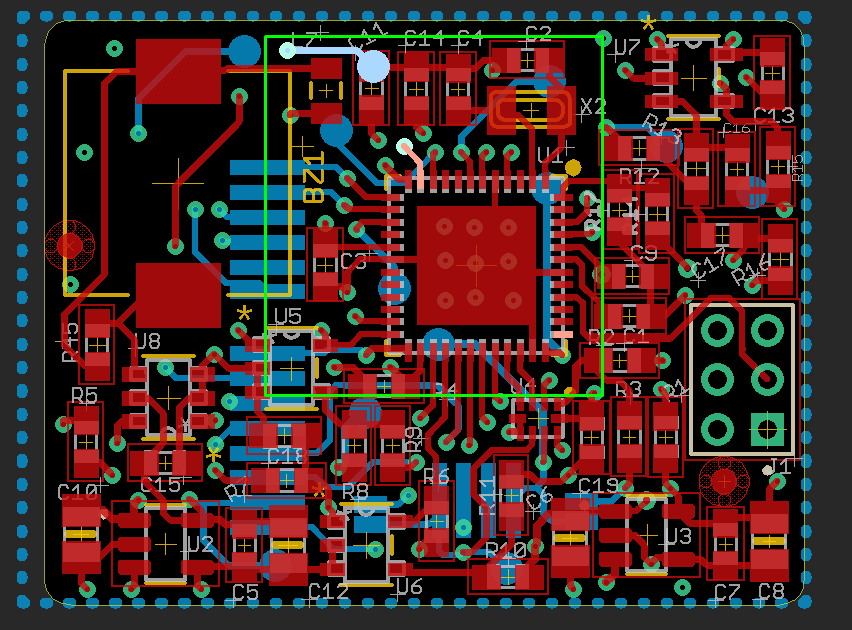
[picture p266: figure]

- Cambio del serial port

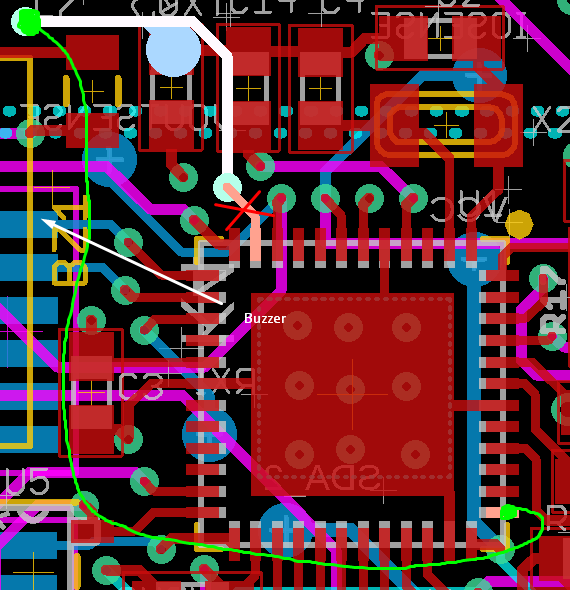
[picture p267: figure]
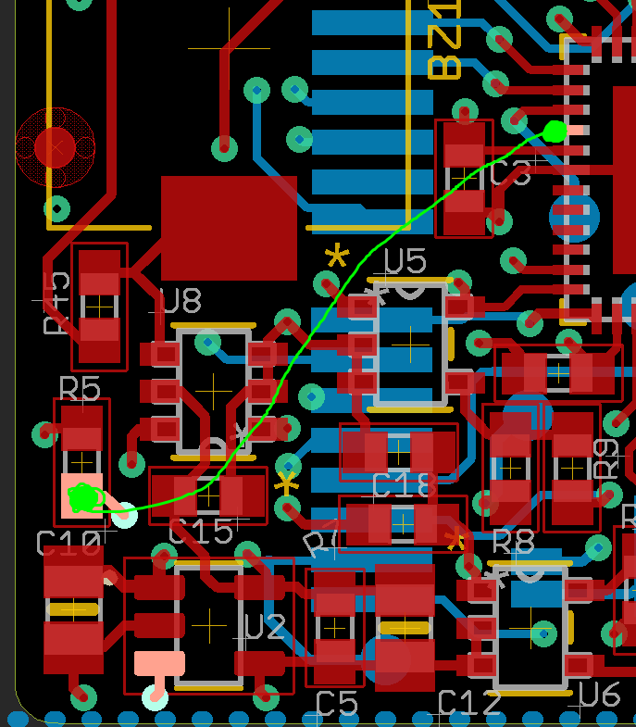
[picture p268: figure]
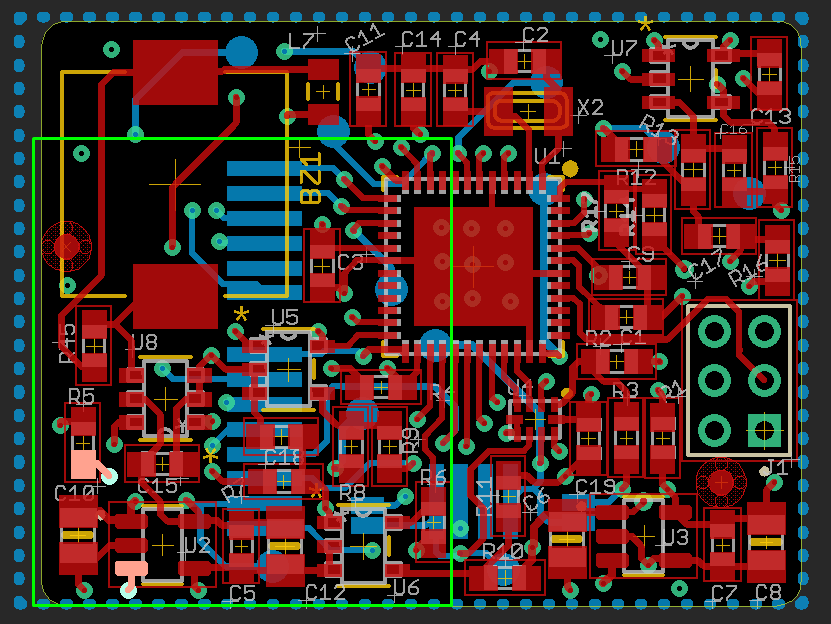
[picture p269: figure]

- Conectar el enable Vcc_2
