MSTKMAD/battery-pack/02.HARDWARE/V3-Rover Venus/01-PCB/BATT_CPU/HISTORY/V2/BATT_CPU_History.rtf

BATT_DCDC

VERSION | DATE | CHANGE | AUTHOR
1 | 16 nov 2022 | 1er prototipo montado por SETI Noviembre | DGB
2 | 28 dic 2022 | 1 producción 500 uds SETI | DGB
