MSTKMAD/battery-pack/02.HARDWARE/V3-Rover Venus/01-PCB/BATT_DCDC/HISTORY/V2/BATT_DCDC_History.rtf

BATT_DCDC

VERSION | DATE | CHANGE | AUTHOR
1 | 16 nov 2022 | 1er prototipo montado por SETI Noviembre | DGB
2 | 28 dic 2022 | 1ra produccion enviada a SETI | DGB
