MSTKMAD/battery-pack/04.MECHANICS/01.ROVER1K-MECH/VERSIONES/V5/V5-History.rtf

ROVER R1 RCA
———————————

———————
VERSION 5
———————
8 Feb 2023
———————

CAMBIOS
———————
- Se cambia la copa (tapabot) para que sea compatible con el conector de amphenol en vez de con el de
switchcraft. Ahora va roscado en vez de llevar la tuerca
- Se modifican los taladros del panel a 1.25 para que vayan roscados los tornillos de 1.6
- Se añaden la tornillería de todo el modelo
