MSTKMAD/battery-pack/04.MECHANICS/01.ROVER1K-MECH/VERSIONES/V6.1/V6-History.rtf

ROVER R1 - V6
———————————

———————
VERSION 5
———————
8 Feb 2023
———————

CAMBIOS
———————

- TAPA: Se cambia el sistema a giro de 90º y superior con dibujo de raya en vez de Y. En un ppio lleva dos imanes y lleva un rayado especial, pero quitamos el rayado porque con la silicona no hace falta y de los dos imanes volvemos a pasar al iman inicial de .5x.1” (v6.1)
- BARRIL: Se adecuan las pestañas para la nueva tapa
- COPA RCA: Ya estaba modificada en la V5. Tiene rosca para ser compatible con el conector de amphenol
- COPA 3.5: Se aumenta la profundidad del hueco para las juntas tóricas (mejora para que no se salgan). Tb se baja un poco la altura del tope del conector para que el PCB baje un poco más y pueda soldarse mejor
- PORTA: se aumenta el espacio para manipular el pogopin y se elimina el roscado de 1.6mm inferior. Se le quita el iman
