MSTKMAD/battery-pack/01.Documentation/02.Averias/2023-Junio Trendy/Post Mortem.png

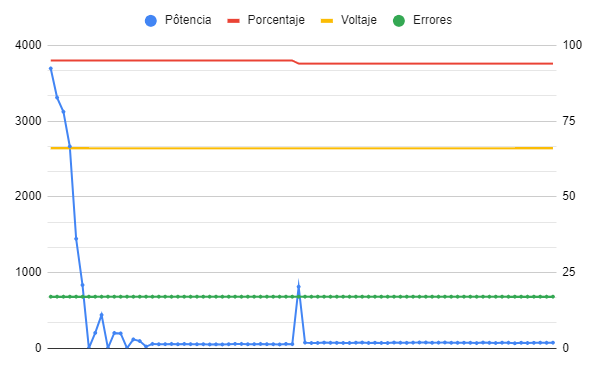
01.Documentation/02.Averias/2023-Junio Trendy/Post Mortem.png
