MSTKMAD/battery-pack/(threads)

Thread 13 (2023-01-11):

deteccion de Modo test a traves del puerto Serie.

Jmusotoku, 2023-01-11:
Para el proceso de testeo durante la produccion, es necesario que el dispositivo entre en modo Test donde se comprueben las distintas fncionalidades.

Ante la ausencia de una entrada hardware, se requiere que se haga por medio del puerto serie, de manera que el codigo una vez se ejecute se quede esperando un comando por el puerto serie que haga que entre en ese modo Test.

Una vez pasado el conjunto de test, se registrara en una variable eeprom que impida que el dispositivo se quede esperando nunca mas.

Closed 2023-05-02.

Thread 24 (2023-01-24):

Colocar ubicacion en JFLASH del numero de serie.

Jmusotoku, 2023-01-24:
Durante la programación la posición del numero de serie ira cambiando por eso antes del reléase es necesario modificar dicha posición y ajustar ala tamaño del fichero generado.

Closed 2023-04-25.

Thread 26 (2023-01-27):

Botones UP/DOWN no deben chorrearse

david-reo, 2023-01-27:
El primer lote de Wenext viene con los botones chorreados.
En la hoja de EXCEL se indicaba que  no debían de chorrearse, pero en la documentacion (drawing PDF) no está especificado que no deba de hacerse.
Se añadirá en la documentación como nota aclaratoria ya que el resto de piezas van todas chorreadas

Closed 2023-05-16.

Thread 27 (2023-01-27):

Imán de Cierre de la tapa superior

david-reo, 2023-01-27:
El imán de la tapa es muy grande en diámetro
Esto tiene el inconveniente de que la zona de "tapa cerrada" no tiene una posición completamente fija, sino que hay al menos 5º de variación en su estado de reposo.

**solucion**
Usar un imán del mismo espesor pero de un diámetro similar al que se encuentra en el barril, de esta manera se logrará colimar mucho mas el haz magnético de forma que no va a quedar tanto margen de colocación

Closed 2023-05-16.

Thread 28 (2023-01-27):

Tapa de cierre roza al girar

david-reo, 2023-01-27:
La tapa de cierre, por su diseño, roza en sus pestañas con el labio del barril.
Este efecto se aprecia cuando hay algo de presión hacia arriba (lo cual estará siempre presente que haya una batería insertada).
Hay que buscar una forma de minimizar este efecto con algún ángulo o bien otra forma en las pestañas.

david-reo, 2023-05-16:
no hay posibilidad de cambiar el diseño del labio.
se cierra por no tener solucion

Closed 2023-05-16.

Thread 30 (2023-01-30):

Fallo en el Enable del LDO Ajustable del Tester CPU.

Jmusotoku, 2023-01-30:
El enable del LDO Ajustable se encuentra conectado a las raspberry pi y es independiente de la tensión de entrada.
de tal manera que si durante el funcionamiento cortamos la tensión de entrada con el switch, la salida no va a 0.
Esto se debe a que internamente el integrado MCP1825 realiza un "by-pass" entre el pin de SHDWN y la tensión de entrada, es decir los 3,3v que hay en el enable son transferidos al pin de entrada con una pequeña caida, provocando que el LDO siga funcionando.

Closed 2024-04-23.

Thread 40 (2023-03-03):

En el arranque de la bateria se produce un escalon de voltaje despues del NITRO (booster)

david-reo, 2023-03-03:
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

### **Problema**
En algunos (no todos) los arranques de la Wand se nota que después del NITRO hay otra subida de voltaje.
Sucede sobre todo a voltajes bajos, aunque no siempre. Por ejemplo, a 6.8V y por debajo sucede muy a menudo.
### Explicación
Este escalón se corresponde con el booster de 0.5V que se inyecta cuando hay más de 50mA medidos a la salida
Seguramente este retraso se debe a un "lag" producido por un filtrado muy fuerte de la corriente.
### Solución
El filtrado de la corriente debe de ser más ágil para no producir problemas como este.

Closed 2023-03-21.

Thread 41 (2023-03-09):

Tolerancia en los test de la testboard-dcdc

Jmusotoku, 2023-03-09:
Tras realizar el testeo de 150 tarjetas DCDC (aprox).
Se obtienen las siguientes medidas de tension y corriente:
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

Por lo tento se decide, de manera cautelar, aumentar la tolerancia de las medidas buenas a  -10% y 20%.

Closed 2023-04-25.

Thread 44 (2023-03-17):

Ajuste del ciclo de programa a las protecciones.

Jmusotoku, 2023-03-17:
Es necesario revisar el ciclo de programa  y modificar las protecciones.
las protecciones van a en función del ciclo de programa ya que es este tiempo en el que se sensa y compara.

Closed 2023-04-25.

Thread 45 (2023-03-21):

El  sistema no se "despeirta" tras 2 rutinas de apagado por idle.

Jmusotoku, 2023-03-21:
Problema.
El sistema no responde en el estado Sleep tras 2 ciclos de apagado pro IDLE.

Recrear.

1. Se deja el sistema encendendido hasta que se apague por el contador de IDLE.
2. Una vez apagado se vuelve a encender.
3. Y se deja que se apague nuevamente por inactividad por el timer de IDLE. SIN INTERACCIONAR NADA MAS.
4. En este momento no es posible encenderlo de nuevo.

Closed 2023-03-21.

Thread 47 (2023-04-17):

Quitar imán pequeño del porta-bateria

david-reo, 2023-04-17:
En el nuevo modelo de tapa solo se giran 90º con lo cual la idea del iman retenedor ya no tiene sentido, no hace falta.
Hay que quitar el imán del diseño mecánico.

Closed 2023-05-16.

Thread 48 (2023-04-17):

Quitar roscado del porta al barril

david-reo, 2023-04-17:
Se ha visto que el roscado en el porta que lo une al barril no resulta efectivo.
Resulta más fuerte el hacer un taladro sin roscar de 1.2mm y hacer la rosca sobre el plastico segun se mete el tornillo.

david-reo, 2023-05-16:
Cerrado con commit dc5d60225a26ce1635df0b334700edb19ba699da
version v6.1 de mecanica para segunda produccion

Thread 49 (2023-04-23):

La Flash de usuario del SAMD se borra si el arranque (colocacion de la pila) tiene rebotes

david-reo, 2023-04-23:
El problema se detecta al programar el ROVER con el cirulo. Los contactos "falsos" que va haciendo el pogopin de alimentacion provocan la generacion de un ciclo de brown-out (BOD) y por tanto la memoria flash se borra automaticamente.
Al borrarse la memoria flash se pierden los datos de datalogging además del naming.
Inicialmente también se perdía la configuración del modo test, es decir, la CPU arrancaba en el modo de test puesto que el flag de test pasado también se borraba al estar en flash.
Esto esta solucionado con una rutina de atención al BOD donde se "setea" este flag artificialmente. Pero el resto de memoria flash queda perdida.
**Propuesta 1 (SW)**
Para solucionarlo habrá que buscar alguna forma de atender la excepción que  se produce en el programa que probablemente sea el acceso a alguna posición de memoria prohibida.
**Propuesta 2 (HW)**
Otra forma de hacer más resiliente a la aplicación sería poniendo un filtrado en el ENABLE del LDO de entrada que tirase la alimentación si la entrada no cumple con un rango mínimo.

_Posible solución_
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

Jmusotoku, 2023-05-05:
Se investigado la opcion de modificar los registros relaacionados con el BOD33, ya sea la accion que se lleva a cabo (interrupcion, reset o nada) pero no se ve manera loable de realizarlo por codigo.

A nivel de HW se ha desarrollado un par de propuestas que, utilizando la entrada del enable del LDO, conseguiríamos mitigar parte de los rebotes. Sin embargo no se solucionaría el error.

De momento, se decide continuar sin modificar ni el codigo ni el HW. Queda pendiente para futuras versiones el introducir el circuito en el enable.

Jmusotoku, 2023-05-17:
Vamos a utilizar un supervisor de tension que permita tirar y mantener el RESET cuando se produzca una variacion de la tension de entrada.

Se decide utilizar el supervisor [MIC803-26D3VC3-TR](https://www.digikey.es/es/products/detail/microchip-technology/MIC803-26D3VC3-TR/2566974). Umbral de deteccion a 2,63v ya que el umbral del BOD es 1,7v

david-reo, 2023-05-18:
cerrado con 488914ff1120286cc4a865663586fdd4ac63ae6d

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
Captura del test con supervisor de 2.6V y treset = 100ms. El que se ha elegido es de 200ms

david-reo, 2023-05-18:
Documento con toda la explicacion y solucion
[Problema de Flash borrado con inserciones de bateria - BOD - Brown….pdf](https://github.com/MSTKMAD/battery-pack/files/11509909/Problema.de.Flash.borrado.con.inserciones.de.bateria.-.BOD.-.Brown.pdf)

Thread 51 (2023-04-25):

Eliminacion de la Calibracion del ADC

Jmusotoku, 2023-04-25:
Por hereancia, se produce un ajuste de la calibracion del ADC.

Tras revisarlo hemos descubierto que la calibracion es muy leve y que eliminarla no deberia suponer ningun cambio en el sensado.

Correcion aplicada previamente:

_analogReadCorrection(12, 2055);_

Si se establece el valor de GAINCORR en 2055, el valor se convertiría a binario como 100000000011 (12 bits). El bit más significativo es 1, lo que indica un valor negativo, y los bits restantes representan la parte fraccional de la corrección de ganancia. El valor de 2055 en binario representa una corrección de ganancia de -0.125 (en decimal), ya que los bits fraccionales corresponden al valor 1/8 (0.125 en decimal).

Por otro lado, si se establece el valor de OFFSETCORR en 12 (decimal), el valor se convertiría a binario como 000000000110 (12 bits), lo que representa un valor positivo en formato de complemento a dos. Este valor representa la cantidad que se suma o resta al valor de la conversión del ADC para corregir el error de offset. En este caso, se restaría 12 del valor de conversión.

Closed 2023-04-25.

Thread 52 (2023-04-26):

El canal del cable del porta para  el pogo pin es complejo de manipular

david-reo, 2023-04-26:
Introducir el pogopin con el cable soldado y el loctite es una tarea que requiere demasiada manipulación y es proclive a un error de montaje (sobre todo con el loctite).

**Solucion propuesta**
Agrandar la parte de más despejada del canal donde tiene que entrar el pin.
Esta modificacion no empeora el enrutado del cable y tampoco encarece el mecanizado.

david-reo, 2023-05-16:
Cerrado con commit dc5d60225a26ce1635df0b334700edb19ba699da
version v6.1 de mecanica para segunda produccion

Closed 2023-05-16.

Thread 53 (2023-05-02):

La salida es continua de 3.9 nada mas montarse.

Jmusotoku, 2023-05-02:
DESCRIPCION:
La salida de una batería nada mas salir del modo test de programación es permanentemente 3.9v (posiblemente el valor del voltaje de la pila que este introducida.
Al retirar la pila y volverla a introducir, se soluciona el problema.

Jmusotoku, 2023-05-02:
Al analizar el código se descubre que tras salir del modo test inicial, no hay ninguna sentencia que controla el estado en el que los pines de OP_:SWITCH, EN_DCDC o el DAC se quedan.
Debido a esto, hay un 50% de posibilidades que las señales se queden a nivel bajo/alto.,
Además, en todo el programa no se vuelve a actuar sobre el pin del enable de DCDC. El control de desactivación del dcdc se realiza mediante la desconexión de la alimentacion de Vcc2, ya que a la entrada del DCDC sirve de pull up.
Por ello, si a la salida del modo test el enable se queda a nivel alto, el dcdc se queda permanentemente desactivado hasta que se quita y pone la bateria provocando una reinicializacion de los pines.

Jmusotoku, 2023-05-02:
Finalmente se decide controlar el estado del que se sale del test para que evitar que  las señales salgan en un estado no controlado que pueda producir mas errores

Closed 2023-05-02.

Thread 54 (2023-05-02):

El sistema de cerrado de tapa es complicado y no funciona como se esperaba

david-reo, 2023-05-02:
**Problema 1**
La idea de que los imanes conseguían que la tapa girase casi sola al cerrarse y además quedara fijada en el punto en el que los imanes se enfrentan NO ha funcionado.
El motivo es que el rozamiento del pogopin y el muelle de los contactos de batería inferiores hace que la tapa quede muy rígida.
**Problema 2**
Si giramos la tapa en el sentido horario para cerrar (que sería el natural) al pasar por las pestañas que están a las 3:00 la tapa se levanta. La sensación es muy mala.
**Problema 3**
Cada vez que las pestañas macho pasan por un canal hembra la tapa se atranca.

**Solución**
Hay que cambiar el sistema de tapa para  que tenga las siguientes características
1. debe de cerrar a 90º de giro
2. las pestañas tienen que ser más grandes para  permitir un mejor "enhebrado" de tapa-barril
3. el cierre debe de tener un tope a los 90º que no permita girar mas
4. el sentido de cierre debe de ser horario. el sentido de apertura antihorario
5. La tapa debe de tener una flecha para  ver el punto de apertura-cierre

david-reo, 2023-05-16:
Cerrado con commit dc5d60225a26ce1635df0b334700edb19ba699da
version v6.1 de mecanica para segunda produccion

Thread 56 (2023-05-10):

Cambio del pogo-pin de GND en el portapilas

david-reo, 2023-05-10:
Buscamos una alternativa más económica al pogo-pin que se está usando actualmente.
Encontramos una alternativa en ALIEXPRESS a 24 céntimos con mucha similitud.
Habría que cambiar no obstante la mecánica para  que fuera posible utilizarlo.

### Comparativa de dimensiones entre el nuevo y el original
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

Closed 2024-04-23.

Thread 57 (2023-05-12):

Calibracion del Fondo de escala de la medida de Tension de entrada

Jmusotoku, 2023-05-12:
ras comprobar que el cargador solo carga a 4,1v (por algún error). al introducir las baterías nos fijamos que únicamente alcanza el 97%.

Para subsanar este fallo es necesario bajar el umbral del 100% a una tensión por debajo de 4,1v. De tal manera que al introducir la celda completamente cargada, la batería marque un 100%, correspondiéndose con lo que en usuario cabria esperar ver.

Closed 2023-05-12.

Thread 58 (2023-05-15):

Fallo de prioridad en la activacion de alarmas ante un error.

Jmusotoku, 2023-05-15:
Al producirse un consumo elevado, la tension de entrada cae por debajo del umbral de aviso de Low batterie con la asalida activada.

Actualemente, no esta controlado la determiacion del orden de avisos que se deben atender al no reconocer la causa de esa caida de tension.
Durante la fase de testeo de produccion se somete a la bateria a situacion de estres  que validen las protecciones de corriente y de potencia. En algunos casos antes de que salte el error se activa la alarma por bateria baja. Este hecho puede producir un error de comprension en el usuario. Que la bateria este baja es una falsa imagen ya que el hecho es que el voltaje cae debido a alas altas cargas a las que se somete la bateria durante estas pruebas.

El comortamiento deseado, seri que cuando se producen situacion de Sobrepotencia/Sobre corriente, no salte el aviso por bateria baja.

Closed 2023-05-16.

Thread 59 (2023-05-16):

JUMPER JP1 no se suelda bien en produccion

david-reo, 2023-05-16:
El jumper JP1 es un jumper de gota de estaño.
Como la capa de stencil que dejan en producción es muy pequeña este jumper no se suelda y tienen que hacerlo a mano.

***Solucion***
Pasar el jumper a dos resistencias de 0R.
Solo se montara una de ellas, la que va al DAC (este es el diseño actual)

david-reo, 2023-05-18:
cerrado con 488914ff1120286cc4a865663586fdd4ac63ae6d

Thread 62 (2023-05-17):

Montaje de CPU mal en la primera produccion de SETI por serigrafia dudosa

david-reo, 2023-05-17:
El punto que marca el pin 1 en la serigrafia de la CPU (U1) queda tapado por la CPU y además da la mala suerte de que el pin 1 de U6 tiene la marca justo coincidiendo con una esquina de U1 lo que hace parecer que ese es el pin 1.
Toda la producción de SETI se ha montado mal.
Hay que poner un punto MAS claro para  que no haya duda de cual es el pin 1 de U1

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
_aqui se ve como el pin 1 de U6 se confunde con el de U1_

david-reo, 2023-05-18:
cerrado con 488914ff1120286cc4a865663586fdd4ac63ae6d

Closed 2023-05-18.

Thread 63 (2023-05-17):

La tension VCC cae unos 200mV cuando se activa VCC_2

david-reo, 2023-05-17:
Hemos visto durante las pruebas del BOD que la tensión VCC cae en un pico de 500us cuando activa la pantalla, es decir, cuando activa VCC_2.
La panatalla tiene unos 10uF de capacidad, lo que hace un pequeño "cortocircuito" al LDO.

**Solucion**
La propuesta es cambiar los condensadores  C2 y C8 de 2.2 uF a 10uF.
Con estos condensadores hemos visto que efectivamente baja unas 10 veces el efecto.
Lo hemos hecho en dos fases: 1º el de salida y luego el de entrada. Ambos tienen efecto positivo y apreciable.
Se ha comprobado que el LDO (ambas opciones) son compatibles con condensadores en la salida de mayor valor.

david-reo, 2023-05-18:
cerrado con 488914ff1120286cc4a865663586fdd4ac63ae6d

Closed 2023-05-18.

Thread 64 (2023-05-17):

Resistencias de DCDC board tubmstoning (o efecto Manhatan) R3,R6,R7,R8 salen volando en produccion SETI

david-reo, 2023-05-17:
Se descubre que el footprint es de 0603 pero estamos montando 0402.
Esta es la causa del problema.
Hay que cambiar la BOM para pasarlos a 0603

Closed 2024-04-23.

Thread 65 (2023-05-17):

RSENSE de board DCDC NO se suelda en produccion SETI

david-reo, 2023-05-17:
Alguans unidades tienen la resistencia sin soldar bien y otras directamente no esta la resistencia.
El problema es que hay vias en el pad de soldadura que hace que el estaño fluya hacia abajo dejando el pad sin estaño para  que se suelde la resistencia

Closed 2023-05-18.

Thread 66 (2023-06-01):

Transistor MOSFET-P Q1 Fuera de stock

david-reo, 2023-06-01:
Q1 es el transistor de "switch" de salida que está fuera de stock.

Solución
Encontramos un sustitutivo que encaja perfectamente con todos los requisitos
packaging
pinout

- VGS
- VDS
- IDS
- RDS

**original --> NVTFS9D6P04M8L**
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

**susititutivo --> RQ3G110AT**
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

Thread 67 (2023-06-20):

Post Mortem con valores 0 en presencia de error.

Jmusotoku, 2023-06-20:
Ahora mismo el post mortem por error, se logea en el estado ERROR esto supone que la salida ha sido cortada y el dato de potencia/voltaje/corriente causante del fallo se sobrescribe y se pierde.

Se recoloca este logeo de post mortem al momento en el cual el error es detectado, almacenando así el valor causante de dicho error

Thread 68 (2023-07-28):

Modificacion Panel -- Mejor ajuste en al barril

david-reo, 2023-07-28:
El nuevo pedido de Jim Tarsmetal esta mostrando que queda espacio entre el panel y el barril de aluminio.
He comprobado los valores con el pie de rey y están bien.
He comprobado los valores del antiguo panel, que  hicimos por alibaba y resulta que es más grande, por eso ajustaba mejor.

### La propuesta
Aumentar las paredes en 75um por cada lado (dcha e izq, visto en vertical).
Este espacio podría ganarse extra dentro para  que los PCBs fueran más sueltos
O también podría ser simplemente un engrosamiento de pared sin modificar nada en el interior

Closed 2024-04-23.

Thread 69 (2023-07-28):

Modificacion Panel - Mejor acoplamiento conectores de PCBs

david-reo, 2023-07-28:
Se han encontrado fallos en la producción en las que no funcionaba la batería una vez montada.
Al desmontar el PCB superior del PCB inferior se ha solucionado el problema.

Esto puede ser debido a que el conector que hay entre ambas placas no encaje perfectamente o quede un poco alto y por eso no hay un contacto perfecto.

Una posibilidad para solucionar este problema es bajar la distancia que hay entre ambos PCBs por debajo del espacio que necesita el conector que hay entre ambas.
Este conector tiene 2 mm y actualmente el espacio que se deja entre ambos PCBs es de 1,9 mm
En teoría ya hay un margen suficiente, pero podríamos dejar 100 micras menos para asegurarlo más todavía.

Esto no debería causar ningún problema al montaje.

Closed 2024-04-23.

Thread 70 (2023-08-01):

Ausencia de Pads de Pogopins de la señal de VOUT +/- en la placa DCDC

Jmusotoku, 2023-08-01:
Debido a un fallo de organización. Los pads para pogopins de las señales de VOUT+ y VOUT - no están en la placa DCDC.

Es necesario implementar una forma de asegurar una conexión limpia y estable con esas señales durante el proceso de testeo de la placa DCDC.

Jmusotoku, 2023-09-19:
Se cierrra por obsolescencia al no usarse lo pads y quitarse en las proximas versiones

Closed 2023-09-19.

Thread 71 (2023-08-02):

PCB DCDC - Mejorar footprint de Q1

david-reo, 2023-08-02:
Aquí queda poco estaño y tengo dudas de que esté bien soldado.
Quizás convendría alargar el pad para  que cogiera mejor el estaño
Revisarlo de nuevo en placas DCDC de esta última producción

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

Closed 2024-04-23.

Thread 72 (2023-09-11):

Modificacion para modelo Low Voltaje/Dan Kubin/PMU

Jmusotoku, 2023-09-11:
Los requisitos de diseño requieren del uso de una señal PWM.
El diseño actual no responde correctamente y es necesario sustituir el transistor Q5 por un driver de Mosfet. (LM5114).
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

Dicho cambio viene con una modificación de los valores de las resistencias del circuito:
- DCDC : R16 100k -> 10k
- CPU: R18 100k -> 10k ,  R48 10k -> 1k

Closed 2024-04-23.

Thread 73 (2023-09-19):

Eliminacion de supervisor e inclusion de un divisor de tension a modod de proteccion en el Enable del LDO de VCC

Jmusotoku, 2023-09-19:
Los resultados de los test con el Supervisor de tensión y con el secuenciador no son óptimos, por lo tanto se deciden retirar del diseño y en su lugar se decide colocar un divisor de tensión resistivo a la entra da del LDO de VCC.

De esta manera cunado la tensión caiga mucho ( valor en torno a los 1,5v) el LDO se desactive protegiendo al  micro de un posible reset por BOD.

Closed 2024-04-23.

Thread 74 (2024-02-13):

PCB Anillo se llena de estaño en cara vista

david-reo, 2024-02-13:
Al soldar el anillo a la arandela fluye el estaño por las vías y contamina la cara de oro vista.

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

david-reo, 2024-02-13:
Cerrado en a257e74eff8393339f62e7080bbf62ae3094b7e3

Thread 75 (2024-02-27):

PCB pogo necesita cambios de tamaño y mejoras para montaje

david-reo, 2024-02-27:
En PCBWAY nos indican que para hacer la copa FK hay que hacer cambios de tamaño.
Esto afecta al tamaño del PCB pogo que ahora tiene que ser 1mm más pequeño en diámetro.

Durante el montaje también nos damos cuenta de que hay dos mejoras importantes que hacer:

1. disminuir el diámetro del taladro de los pines para  que queden mas justos
2. añadir una zona de cobre en bottom para poder soldar los pines desde atrás aplicando el soldador a una buena zona de cobre.

Hay que tener cuidado con el imán de anillo para que no toque esta zona.

Thread 76 (2024-02-29):

Jack connector choca con labio de la mecanica en Universal

david-reo, 2024-02-29:
El labio de la copa en la ROVER universal choca con los pines de los cables por debajo.
Hay que moverlos hacia el borde exterior para  que no toquen.
Tambien hay un problema termico porque  al soldar los pines del conector se calienta el cobre y se desueldan los cables.
Habría que crear un thermal relief para  evitar que esto suceda.

Thread 77 (2024-03-14):

Cambio del diametro de la placa Pogo Universal

Jmusotoku, 2024-03-14:
Fue necesario el cambio del diámetro inicial por temas de l diseño de José Luis.

Tras reparar el error que cometió Jose Luis, se vuelve al tamaño original

Thread 78 (2024-04-10):

Fallo del Naming con nombres de masiado largos.

Jmusotoku, 2024-04-10:
Observación:

Cuando el nombre guardado en el naming es demasiado largo, se observa que la batería se reinicia por WTD.

Diagnostico:

En la revisión de la librería, en la función ShowName() se interactúa con el array donde se almacena localmente el nombre. Esta manipulación incluye la inserción de espacio antes y después del nombre. Esto provoca un desbordamiento de la longitud del array en los caso en los que el nombre almacenado sea mayor de 8 caracteres. En el desbordamiento el puntero de programa se pierde y termina saltando el WTD.

Solución:
Se aumenta el tamaño del array de almacenamiento del naming y se fija un limite de caracteres máximo para el nombre almacenado. Este limite se fija en 15 y el array se hace de 50 posiciones.

Closed 2024-04-23.

Thread 79 (2024-04-17):

Sonido agudo proveniente de la ROVER PMU

Jmusotoku, 2024-04-17:
OBSERVACIONES:
Tras realizar la golden unit de la Rover PMU se la enviamos a una clienta y el feedback recibido es que la maquina funciona bien pero el ruido que proviene de la maquina es demasiado incomodo y que seria necesario quitarlo para poder trabajar adecuadamente con la bateria.

DIAGNOSTICO:
El ruido se debe a que la PWM esta genera a una frecuencia audible. Para poder quitar el sonido es necesario aumentar la PWM a frecuencias pro encima del rango audible (20KHz aprox).

Thread 80 (2024-05-10):

La solnova 2.0 tiene un sistem que hace que las cheyenne no funcionen.

Jmusotoku, 2024-05-10:
OBSERVACIONES
Cheyenne saca un modelo de la solnova 2.0. Este modelo lleva un tipo de mecanica entorno al motor distinto debido a que tiene como 2 modes de funcionamiento. Continuo y "power". En uno de los dos modos, la ROVER R-1 no es capaz de encenderla y entra como en una realimentacion continua que no termina estabilizandose. Adicionalemnte, si el voltaje se sube y baja de voltio en voltio entorno a los 7-8 voltios vuelve a desestabilizarse.

DIAGNOSTICO
Es posible que l PID montado entorno al motor para ese modo, es muy sensible a cambios bruscos de voltaje y esto produce que durante el encendido del nitro o el cambio de voltio en voltio.

Jmusotoku, 2024-06-05:
Tras recibir una reparacion de un cliente es necesario re abrir el issue.
Se percibe que se ha solucionado el problema frente al cambio rapido de voltio en voltio.
Sin embargo, el arranque siue siendo un problema. Entorno a los 7-8v casi cualquier arranque produce que la maquina se desestabilice.

Actualmente, la salida sin nitro es una subida vertical sin rampas ni esperas. El nitro es el mismo que en el resto de modelos.

Jmusotoku, 2024-06-05:
SOLUCION:
Se decide modificar el NITRO para el modelo de Cheyenne.
Se observa que el efecto de esta desestabilizcion se produce menos o casi nada cuanto mas subes el voltaje.
Por lo tanto se establece una forma de NITRO de la siguiente forma.
- Subida rapida a 12v.
- Espera activa entorno a 500 ms.
- Rampa de bajada hasta el valor deseado, respetando el Slew Rate que presenta la maquina.

Closed 2024-05-13.

Thread 81 (2024-05-13):

El modelo cheyenne aun tiene incorporado el WatchDog en su codigo

Jmusotoku, 2024-05-13:
OBSERVACION:
Al revisar el codigo de la Cheyenne en el momento de su release, se detecta que el watchdog aun sigue presente en el codigo.

DIAGNOSTICO:
Hay que quitar todas las lineas de codigo correspondiente al watchdog para prevenir cualquier mal funcionamiento.

Thread 82 (2024-05-28):

Explosión y quemado de resistencia R9 y Q3

Jmusotoku, 2024-05-28:
OBSERVACION
Una reparación de una Rover Dan Kubin llega con los síntomas siguientes: Descarga excesiva cuando la batería esta apagada con la pila introducida y con la batería encendida pero sin dar salida.

DIAGNOSTICO
Se conecta la batería a una fuente de alimentación y se comprueba que efectivamente el consumo de la batería es bastante superior (150mA) al esperado (20mA).
Se debugea hasta aislar el problema en la tarjeta DCDC.
A través de la placa de testeo de producción se identifica el problema con el circuito de salda, concretamente con la señal del OP_SWITCH.
Se plantea la posibilidad de que la resistencia R9 este mal. Se comprueba que no, aunque tiene un valor un tanto superior.
Lo siguiente en comprobar es el transistor Q3, el cual presenta cortocircuito entre la Gate y el Source.
Se comprueba que el transistor tiene una Vgs Max de 12v. Esto produce que en algunas ocasiones estemos operando el transistor por encima de sus limites ya que a 12v la salida es de 12,3v.

Se determina como fallo de diseño.

SOLUCION
Sustituir el transistor por otro con una Vgs mayor pero con características parecidas.
Elección:  [DMN3023L-7](https://www.digikey.es/en/products/detail/diodes-incorporated/DMN3023L-7/5453119)

Alternativas:
[DMN3028LQ-7](https://www.digikey.es/en/products/detail/diodes-incorporated/DMN3028LQ-7/14563115)
[DMN3404L-7](https://www.digikey.es/en/products/detail/diodes-incorporated/DMN3404L-7/2052774)

Closed 2024-05-28.

Thread 83 (2024-05-29):

La bateria da salida estando apagada.

Jmusotoku, 2024-05-29:
OBSERVACION
Un cliente se queda de que su batería "se enciende" cuando la tiene apagada y activa su maquina bishop.

DIAGNOSTICO
Al recibirla comprobamos que es cierto, una vez apagada la batería al cabo de unos segundos comienza a dar salida (3,3v aprox) posiblemente el valor de la tensión de la celda de litio.

Tras comprobar el circuito, comprobamos que el controlador del mosfet tiene un protocolo de Undervoltage Lock Out a 3,4 v aproximadamente. Esto provoca que cuando el VDD (tensión de salida, Vout) esta por debajo de dicho umbral, el controlador de mosfet fija su salida a 0 v y por lo tanto dispara el mosfet de salida.

SOLUCION 1:
Sustituir el controlador por un circuito push-pull que permita la conmutación y no conlleve dicho problema.
NO FUNCIONA: El diseño tiene errores a la hora de conmutar el transistor superior P.
Se descarta la solución.

SOLUCION 2:
El momento en el que se produce el error, es durante el apagado o "Sleep" de la batería. En este momento, se desconecta la alimentación de Vcc2, alimentación que sirve de pullup del DCDC y lo mantiene encendido. Al desconectarse la alimentación, el DCDC se apaga y provoca que la tensión de la celda sea la que se observa en Vout. Cuando la tensión de la celda es baja, es decir se encuentra descargada, es cuando se produce el UVLO del controlador de Mosfet y se cierra el transistor de salida, provocando el encendido de una maquina como la bishop si esta se encuentra conectada. Por lo tanto se decide suprimir la desactivación de la alimentación Vcc2 siempre que en el momento del apagado, se detecte que la tensión de la batería es baja. Solo se hace en este punto para evitar que la batería se descargue debido al consumo pasivo del sistema en el momento de "Sleep" con Vcc2 activada.

Closed 2024-09-17.

Thread 85 (2024-09-03):

Conflicto en la atención a error con el aviso de low battery,

Jmusotoku, 2024-09-03:
OBSERVACION:
Durante las pruebas de detección de cortocircuito franco, se observa que el aviso por la caída de la tensión de entrada se ejecuta antes de la atención al error y por tanto se introduce un delay indeseado durante el cual el error persiste.

DIAGNOSTICO:
Se observa que la alarma solo muestra el aviso de LOW Battery sin mostrar el porcentaje, lo que deja claro que parte del código esta involucrada. La correspondiente al medidor de batería cunado la salida esta activa por si acaso la tensión de entrada cayese por debajo de las 3,2v, dar un aviso de batería baja. El error al tardar 0.5s en activarse, es posible que el timer de 1000ms terminase en algún punto intermedio y por lo tanto saltase antes el aviso que la atención al error.

SOLUCION:
Se decide implementar un Monitor de la tensión de entrada, con rampa de subida igual a rampa de bajada, con un tiempo de activación mínimo de 60s.

Closed 2024-09-17.

Thread 86 (2024-09-05):

Salto del compardor en arranques de alguna maquinas.

Jmusotoku, 2024-09-05:
OBSERVACION:
Al iniciar algunas maquinas, se percibe como el voltaje oscila al comienzo.

DIAGNOSTICO:
Al medir la variacion de la tension de entrada al encender determinadas maquinas se observa que la tension chopea.
Este chopeo se observa que viene del transistor de salida. Siguiendo la señal, se descarta un efecto software.
Debido a la carga que supone, la tension de entrada cae por debajo de 3,1v y por lo tanto el comparador salta tirando el transistor de salida, produciendo un chopeo hasta que se estabiliza la tension de entrada.

SOLUCION:
Se decide cambiar el umbral del comparador de 3,1v a 2,4v. R11= 8k2 -> R11= 11k

Closed 2024-09-17.

Thread 88 (2025-02-06):

No tenemos Corte de la salida por tension de entrada.

Jmusotoku, 2025-02-06:
Hemos detectado que mientras la batria este dando salida, y el comportamiento sea normal (sin sobre corrientes ni undervoltage), la logica no cortará la salida aunque la tension de entrada (debida a la descarga de la bateria) baje por debajo de 3v.

El comportamiento real, es que la bateria continuara funcionando (con los avisos pertienentes de bateria baja) hasta que la tension de entrada no sea suficiente para manter el sistema. Los posible escenarios son los siguientes:
* La tension de entrada ce por debajo de un umbral de funcionamiento de la CPU normal, provocando algun fallo en el hardware (ENABLE DEL DCDC, OP SWITICH, etc) provocando el corte de la salida y por tanto un UNDERVOLTAJE, que cortaria la salida, permitiendo entrar ala rutina de EMPTY BATTERY e impidiendo el funcioanmiento,.
* La tension de entrada cae por debajo del umbral de funcioanmiento de la CPU y esta se apaga directamente.
* El DCDC no es capaz de entregar suficiene potencia y por tanto la aguja se queda encasquillada. El consumo sube mucho pero no lo suficiente como para hacer saltar una proteccion, y la descarga de la pila se aceelera pero el sistema se mantiene en este punto hasta que una de las opciones anteriores salte.
