MSTKMAD/battery-pack/01.Documentation/01.Diseño/Documentacion Software/B1/Diagrams/Battery/Diagrama de Distribucion.pdf

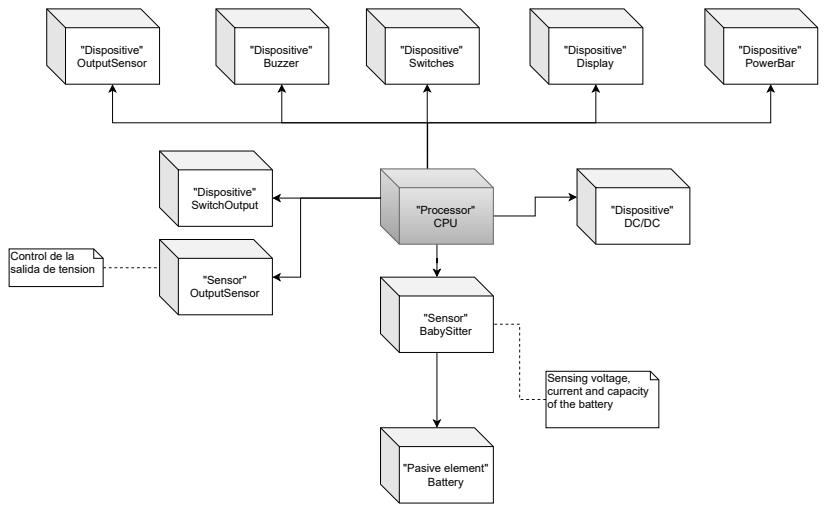
[picture p271: page 1]
"Processor" CPU; "Dispositive" Switches; "Sensor" BabySitter; "Sensor" OutputSensor; "Pasive element" Battery; "Dispositive" DC/DC; "Dispositive" Display; "Dispositive" Buzzer; "Dispositive" OutputSensor; "Dispositive" PowerBar; "Dispositive" SwitchOutput

Control de la
salida de tension

Sensing voltage,
current and capacity
of the battery
