MSTKMAD/battery-pack/04.MECHANICS/01.ROVER1K-MECH/ROVER_U-1/copa 3.5 universal.pdf

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

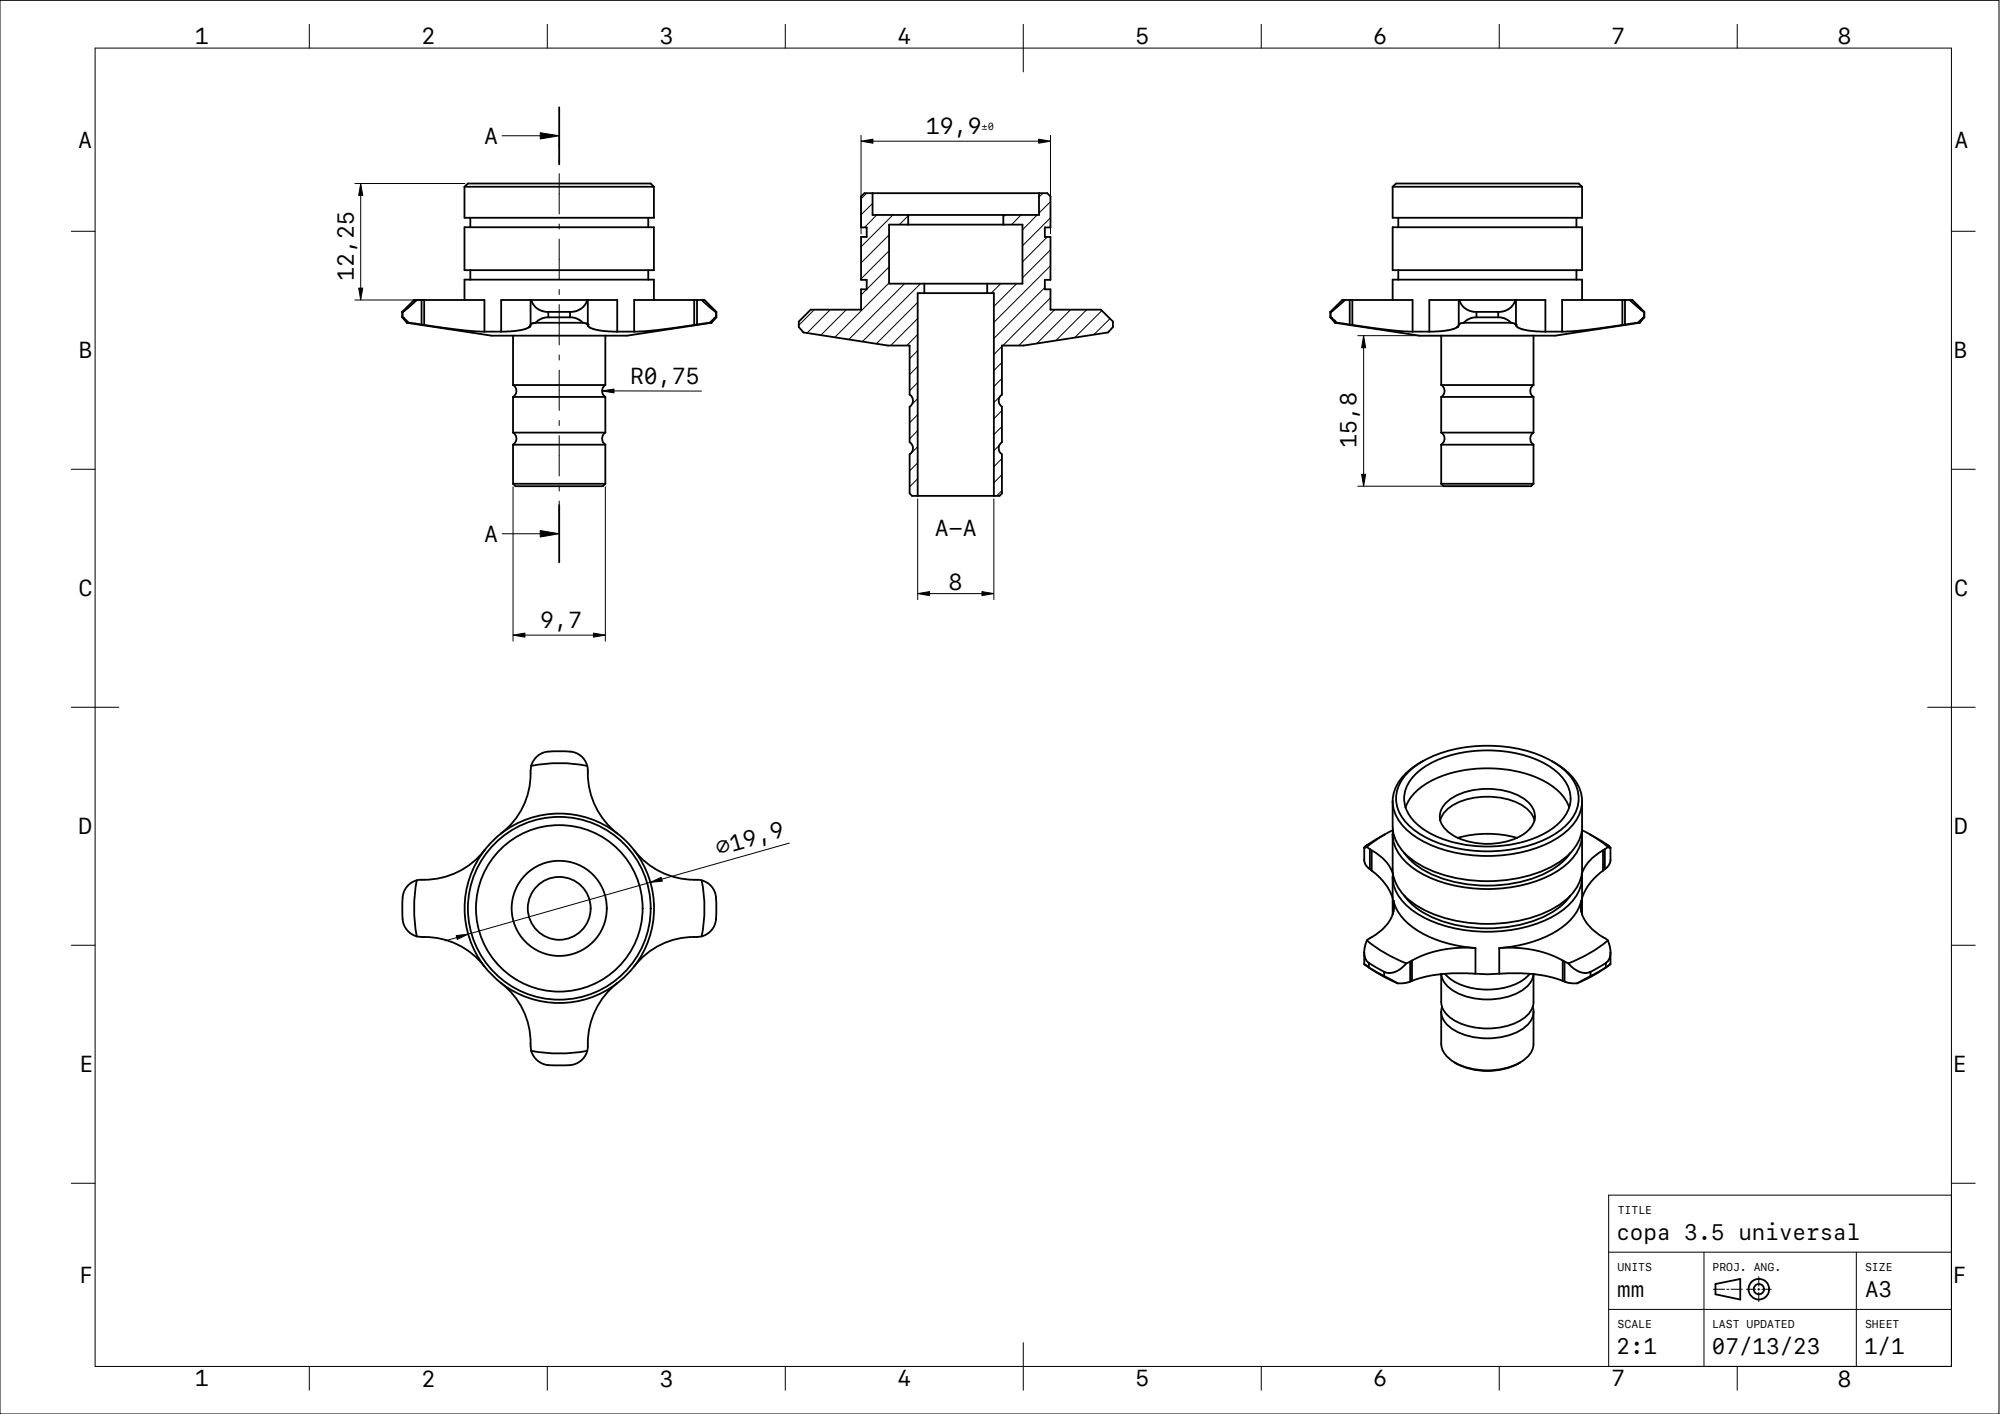
[picture p272: page 1]
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
