MSTKMAD/battery-pack/04.MECHANICS/01.ROVER1K-MECH/VERSIONES/V5/Copa rca v5 Amphenol.pdf

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

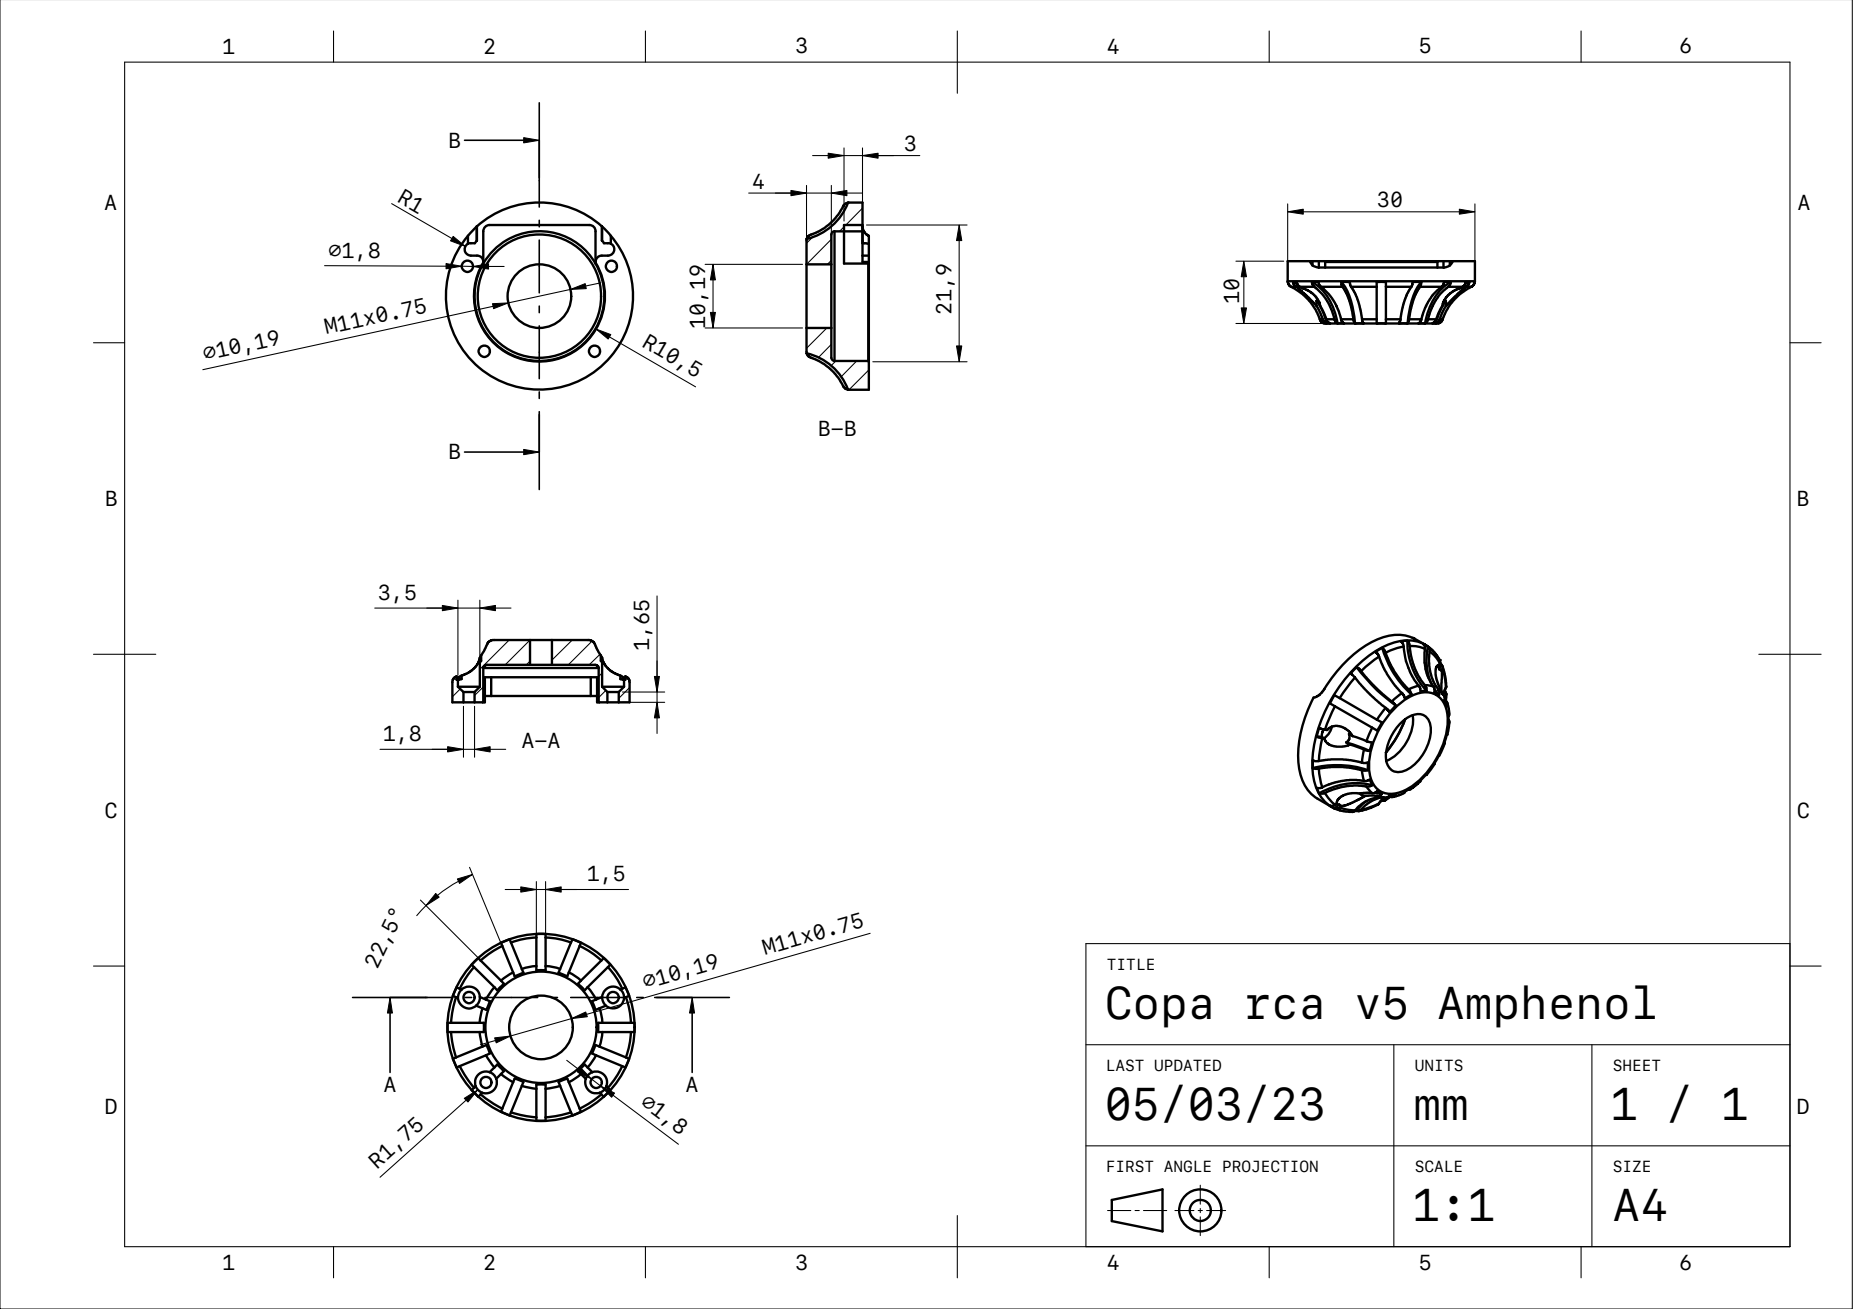
[picture p278: page 1]
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
