MSTKMAD/battery-pack/04.MECHANICS/01.ROVER1K-MECH/VERSIONES/V5/panel v4.12.5.pdf

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

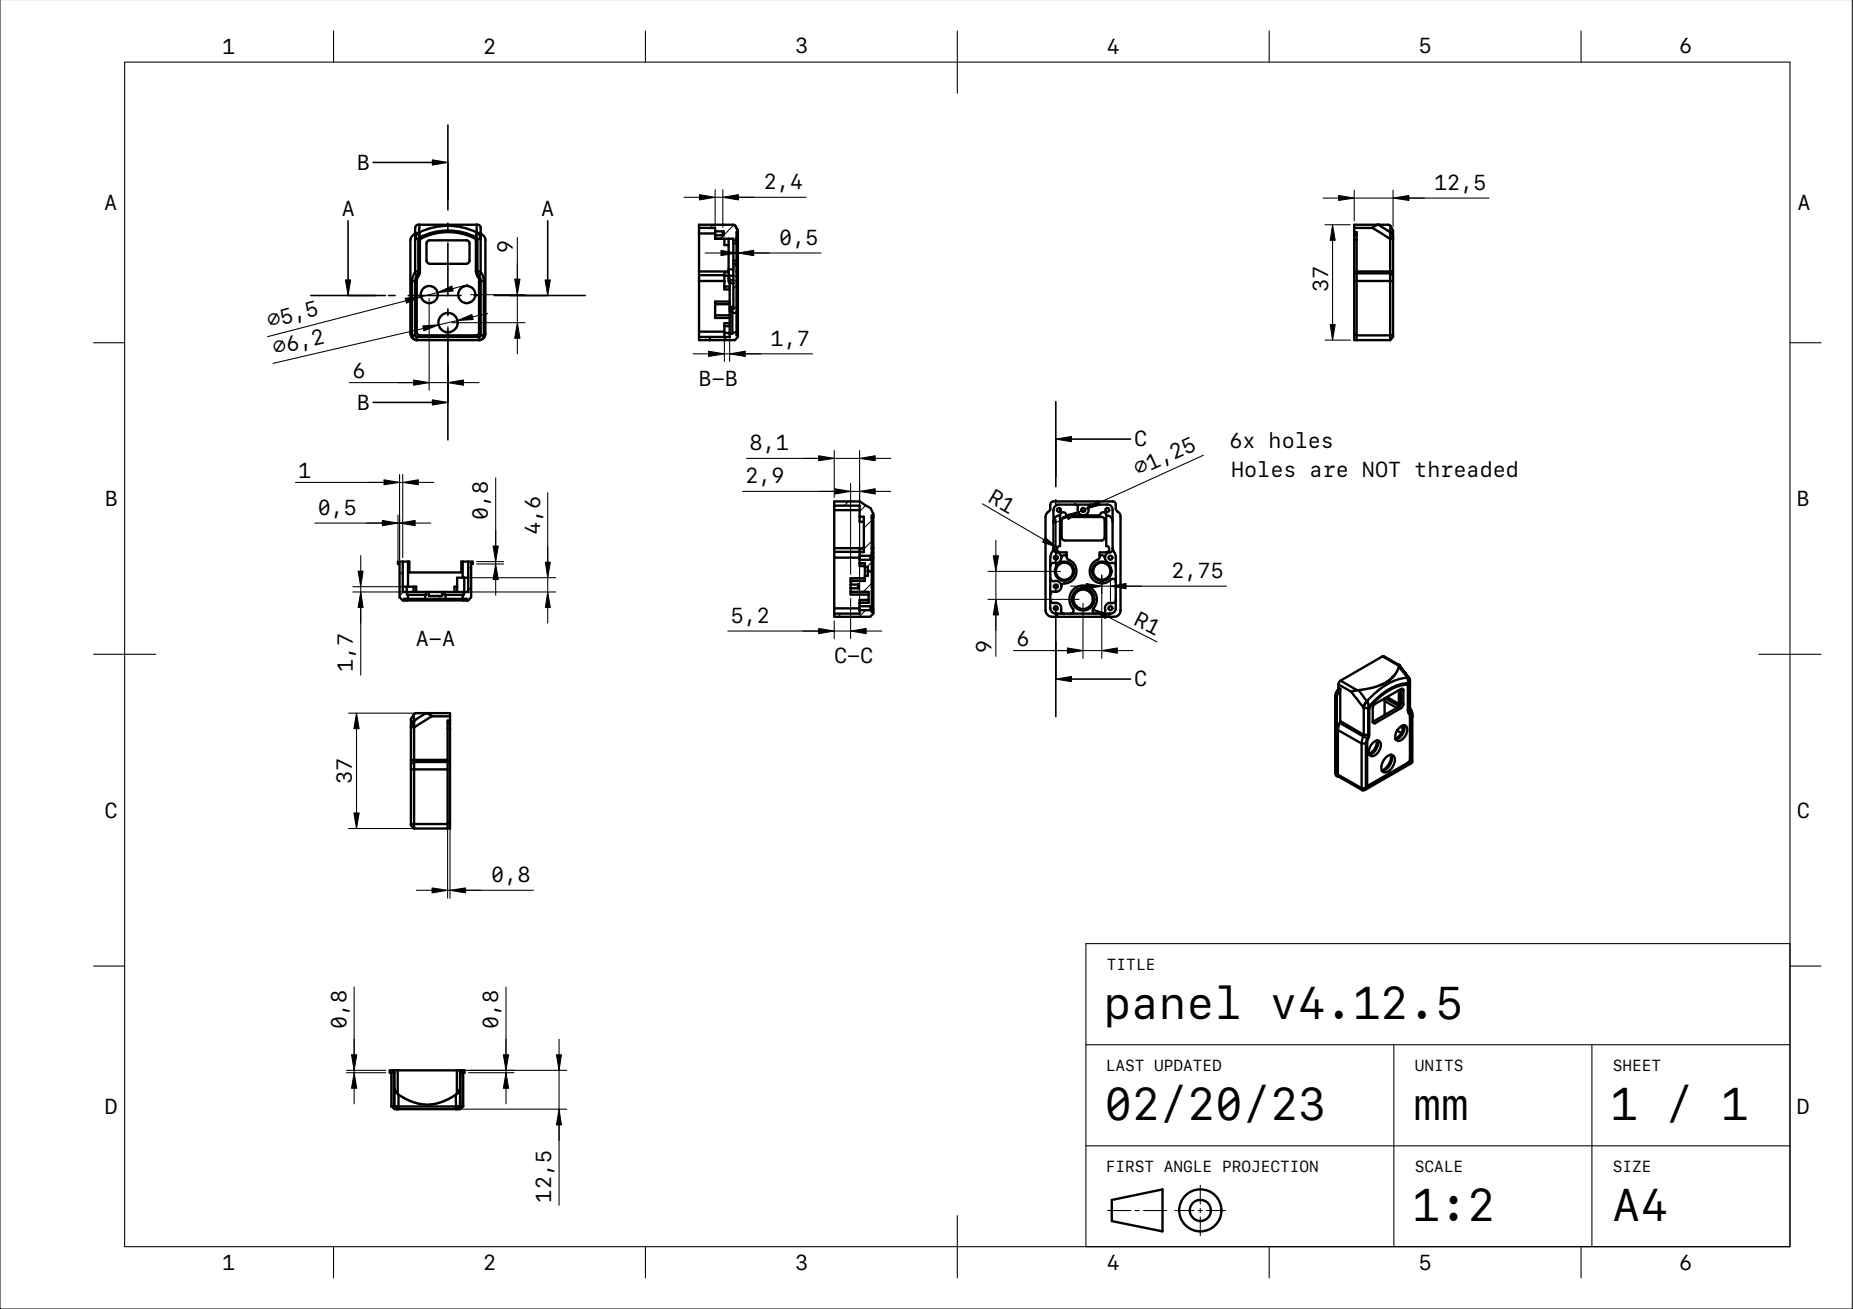
[picture p279: page 1]
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
