MSTKMAD/battery-pack/04.MECHANICS/01.ROVER1K-MECH/VERSIONES/V6.1/boton rojo bateria v1.pdf

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

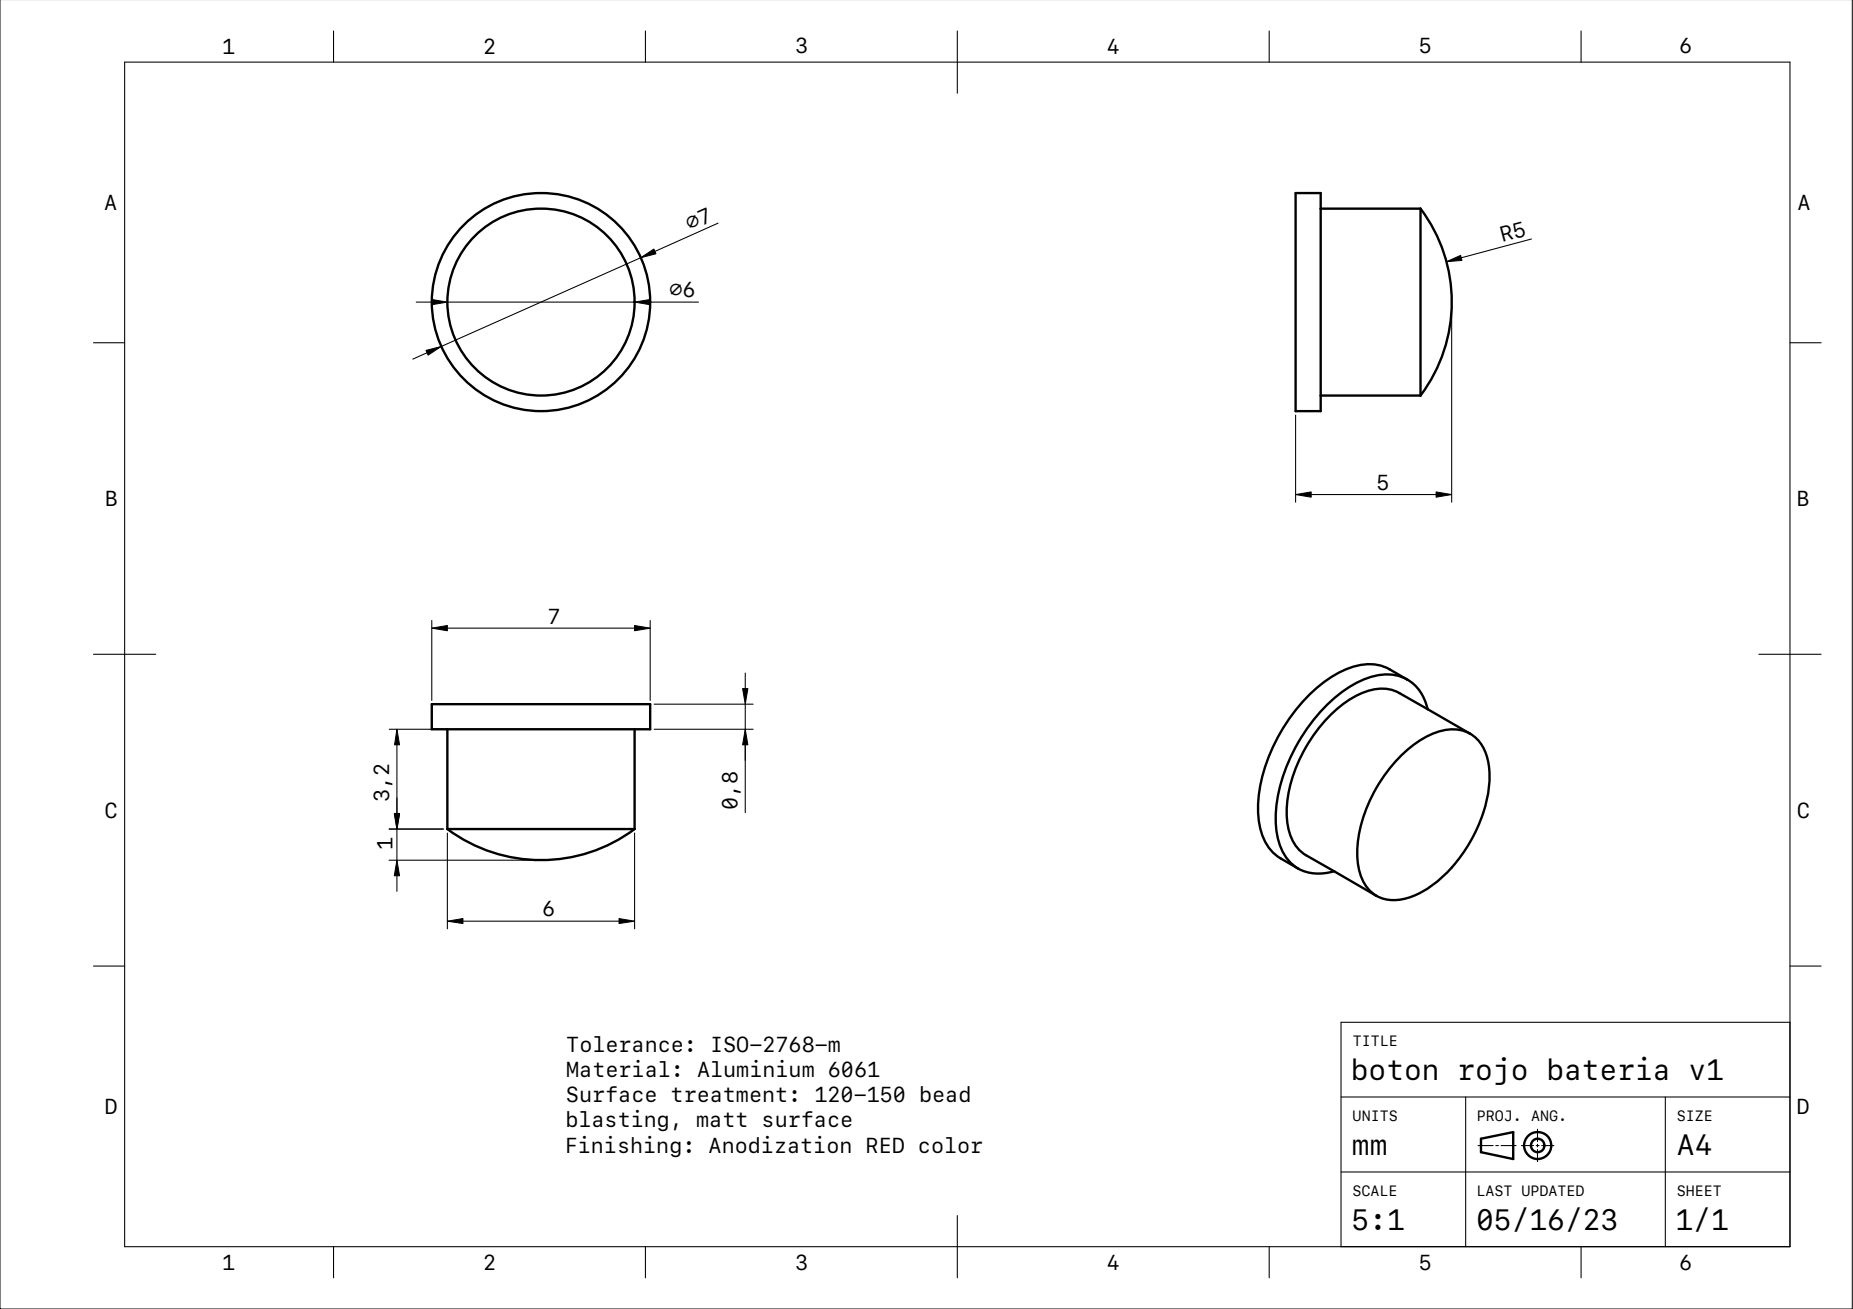
[picture p281: page 1]

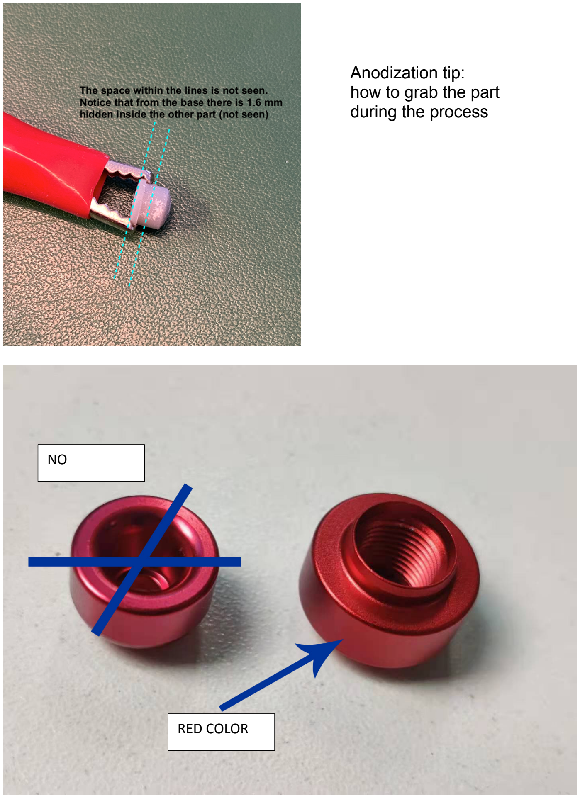
[picture p282: page 2]

RED COLOR

NO
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
