MSTKMAD/battery-pack/04.MECHANICS/01.ROVER1K-MECH/VERSIONES/V3/PCB CPU.pdf

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

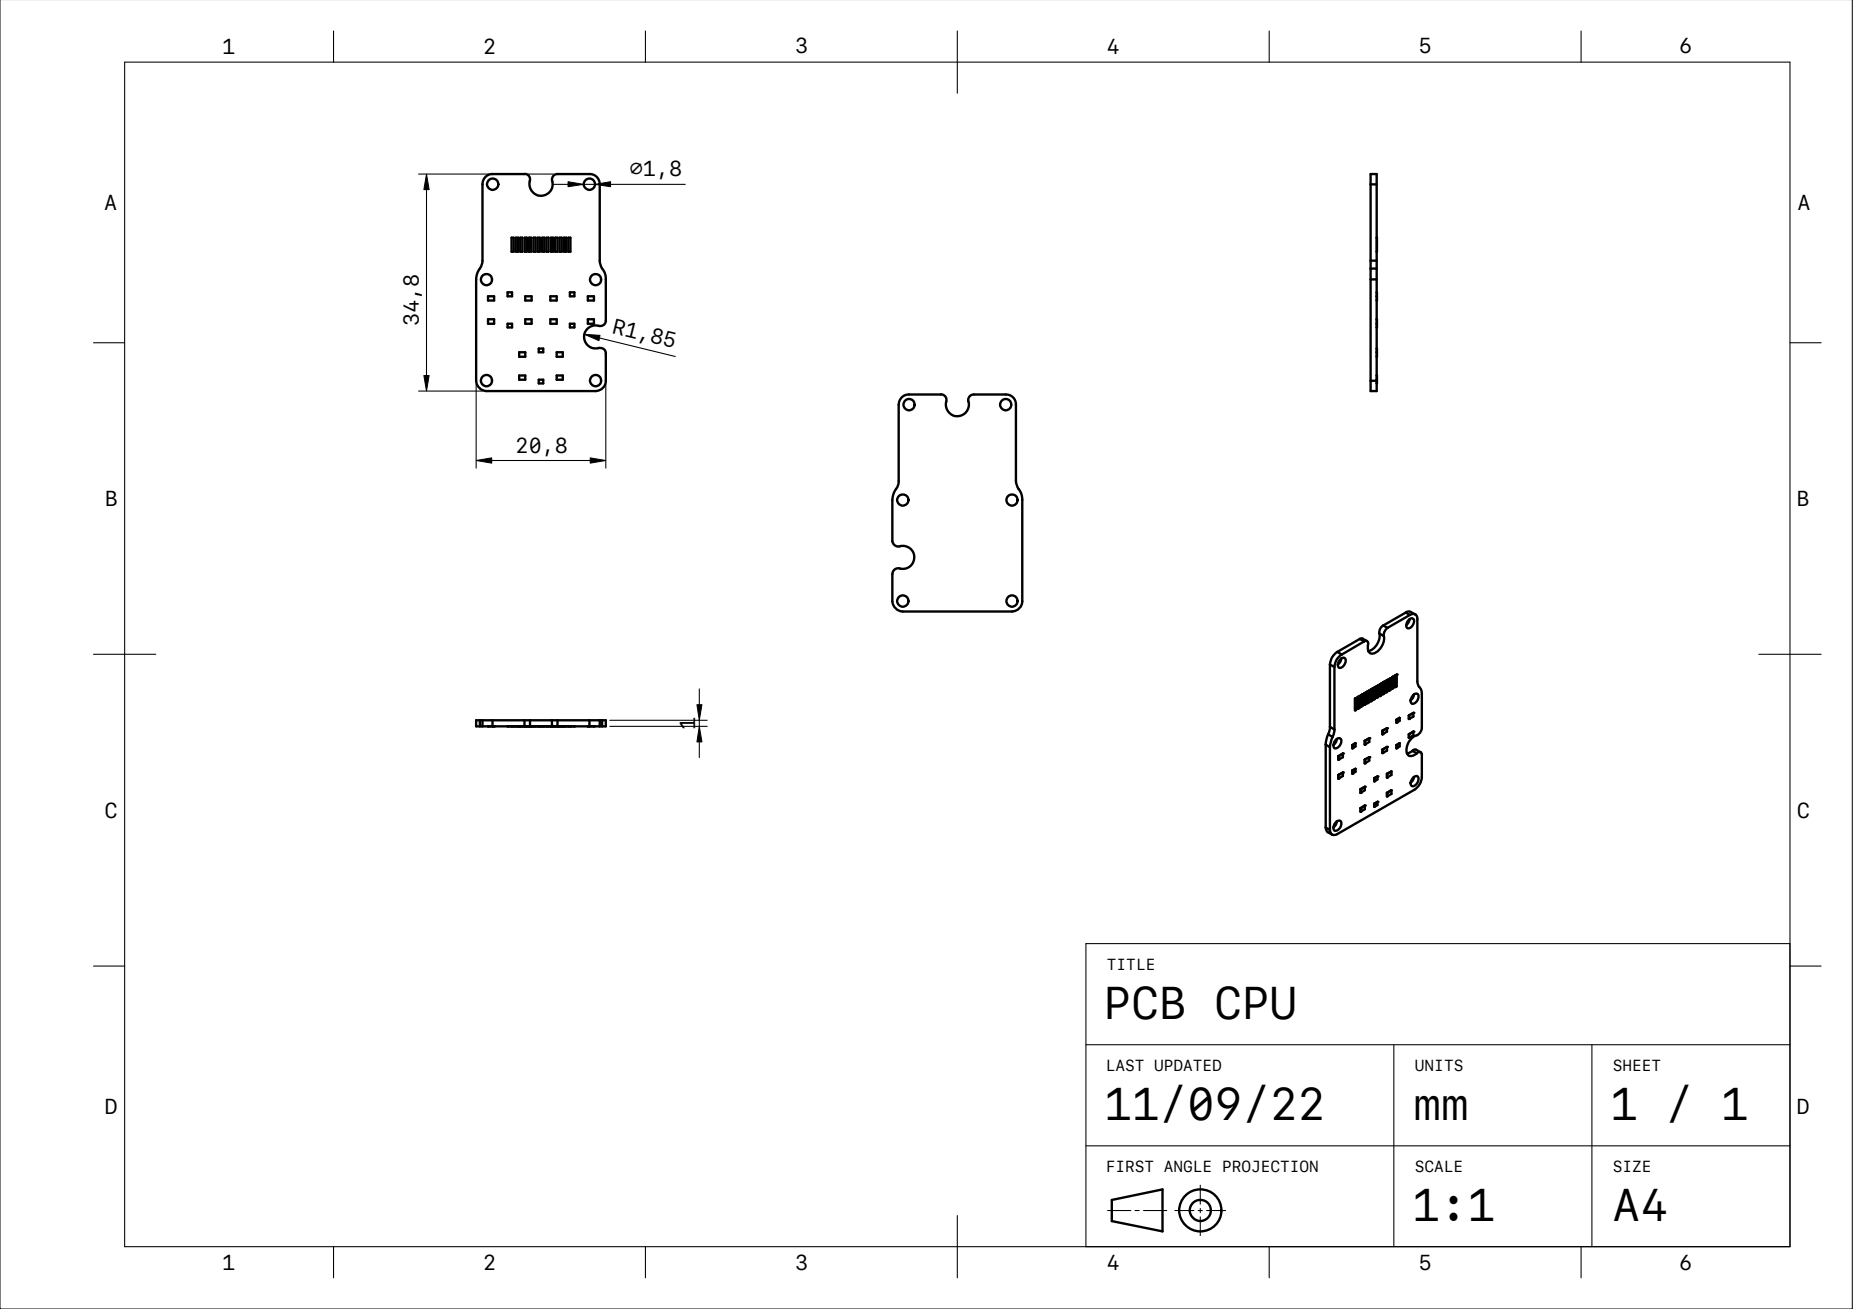
[picture p299: page 1]
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
