MSTKMAD/battery-pack/04.MECHANICS/01.ROVER1K-MECH/VERSIONES/V2/tapatop v2.pdf

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

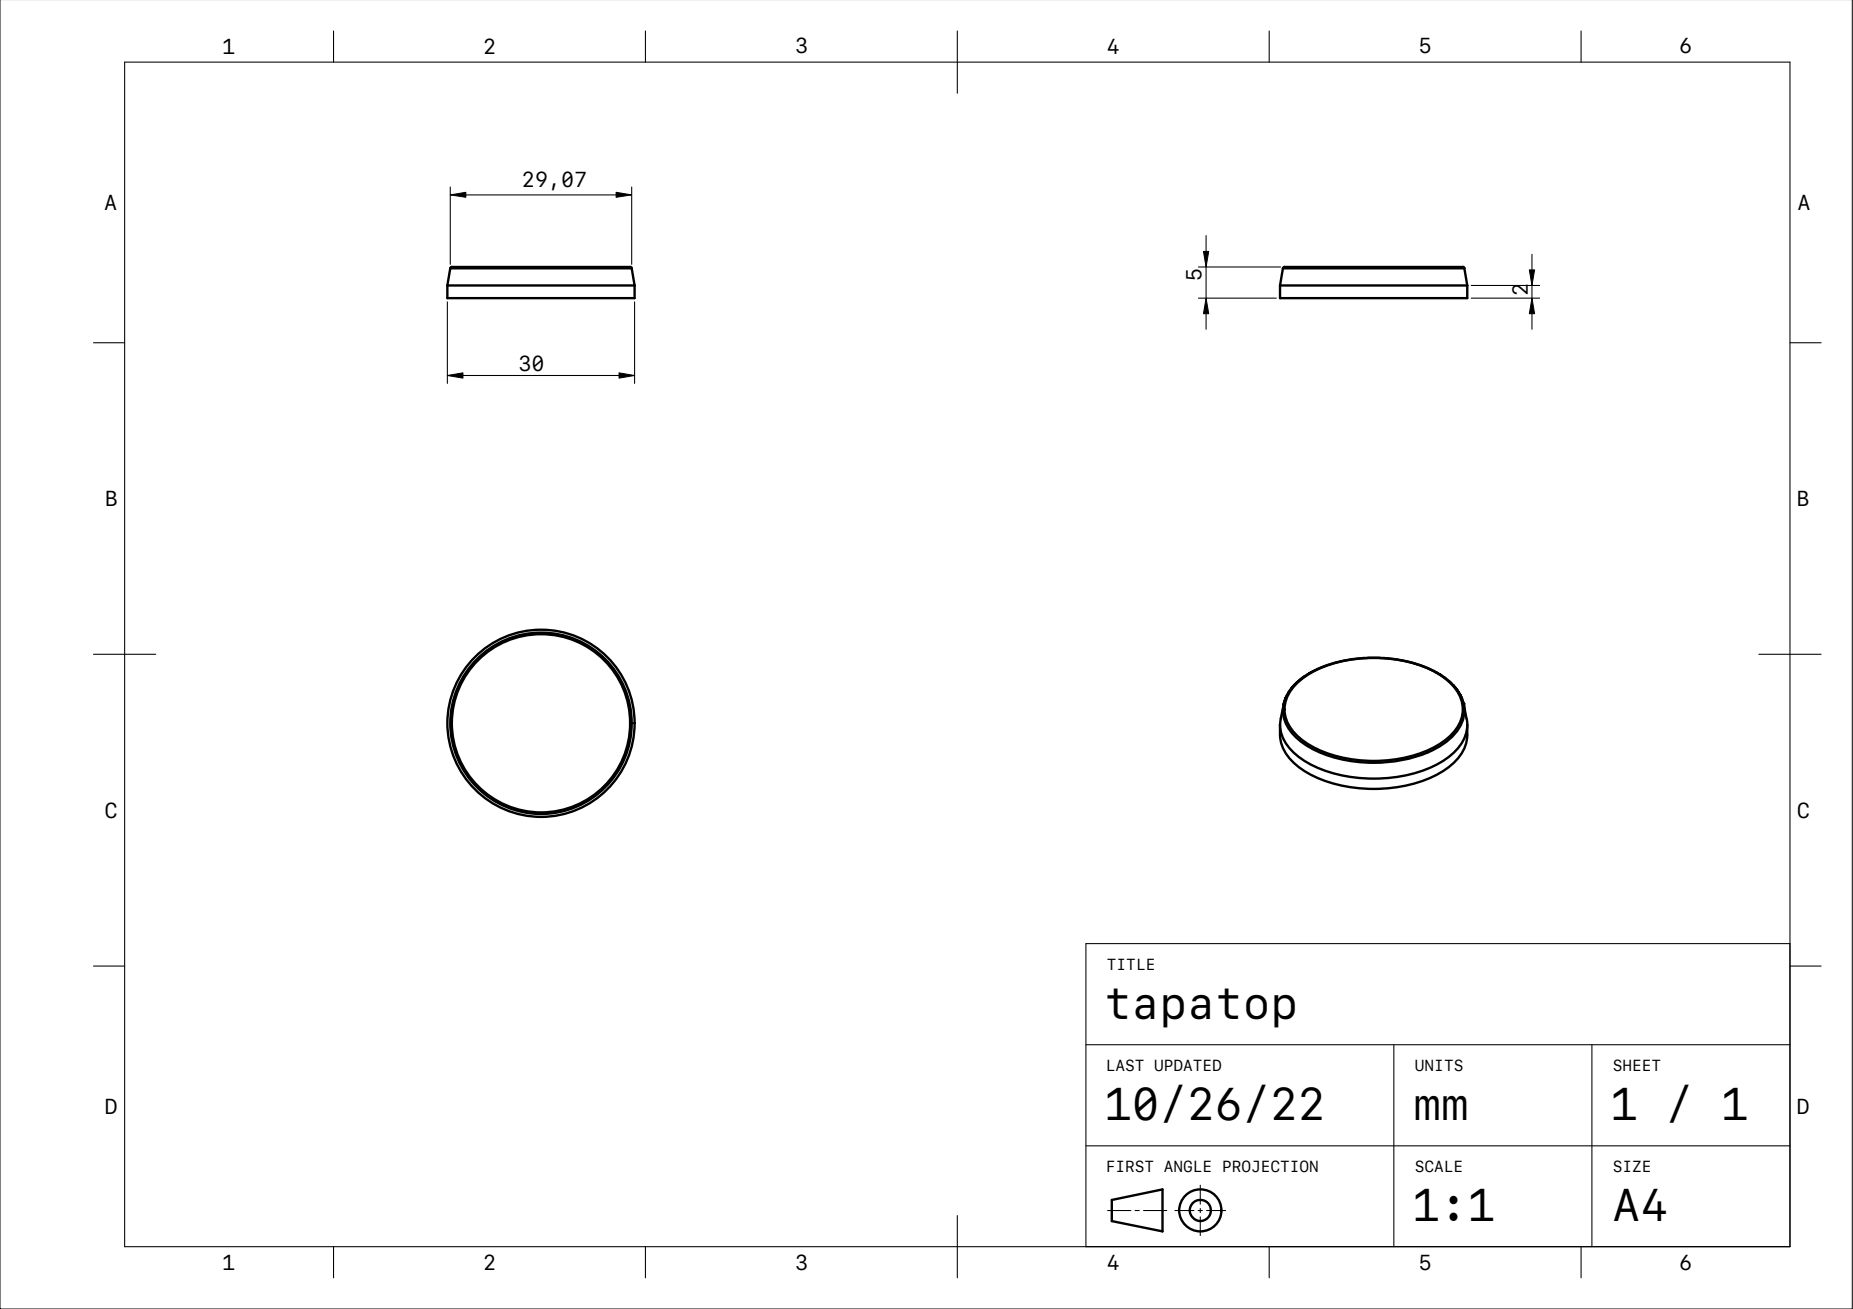
[picture p313: page 1]
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
