MSTKMAD/battery-pack/02.HARDWARE/V3-Rover Venus/01-PCB/CRADLE/Cradle v1/PCB con leds CRADLE VENUS.pdf

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

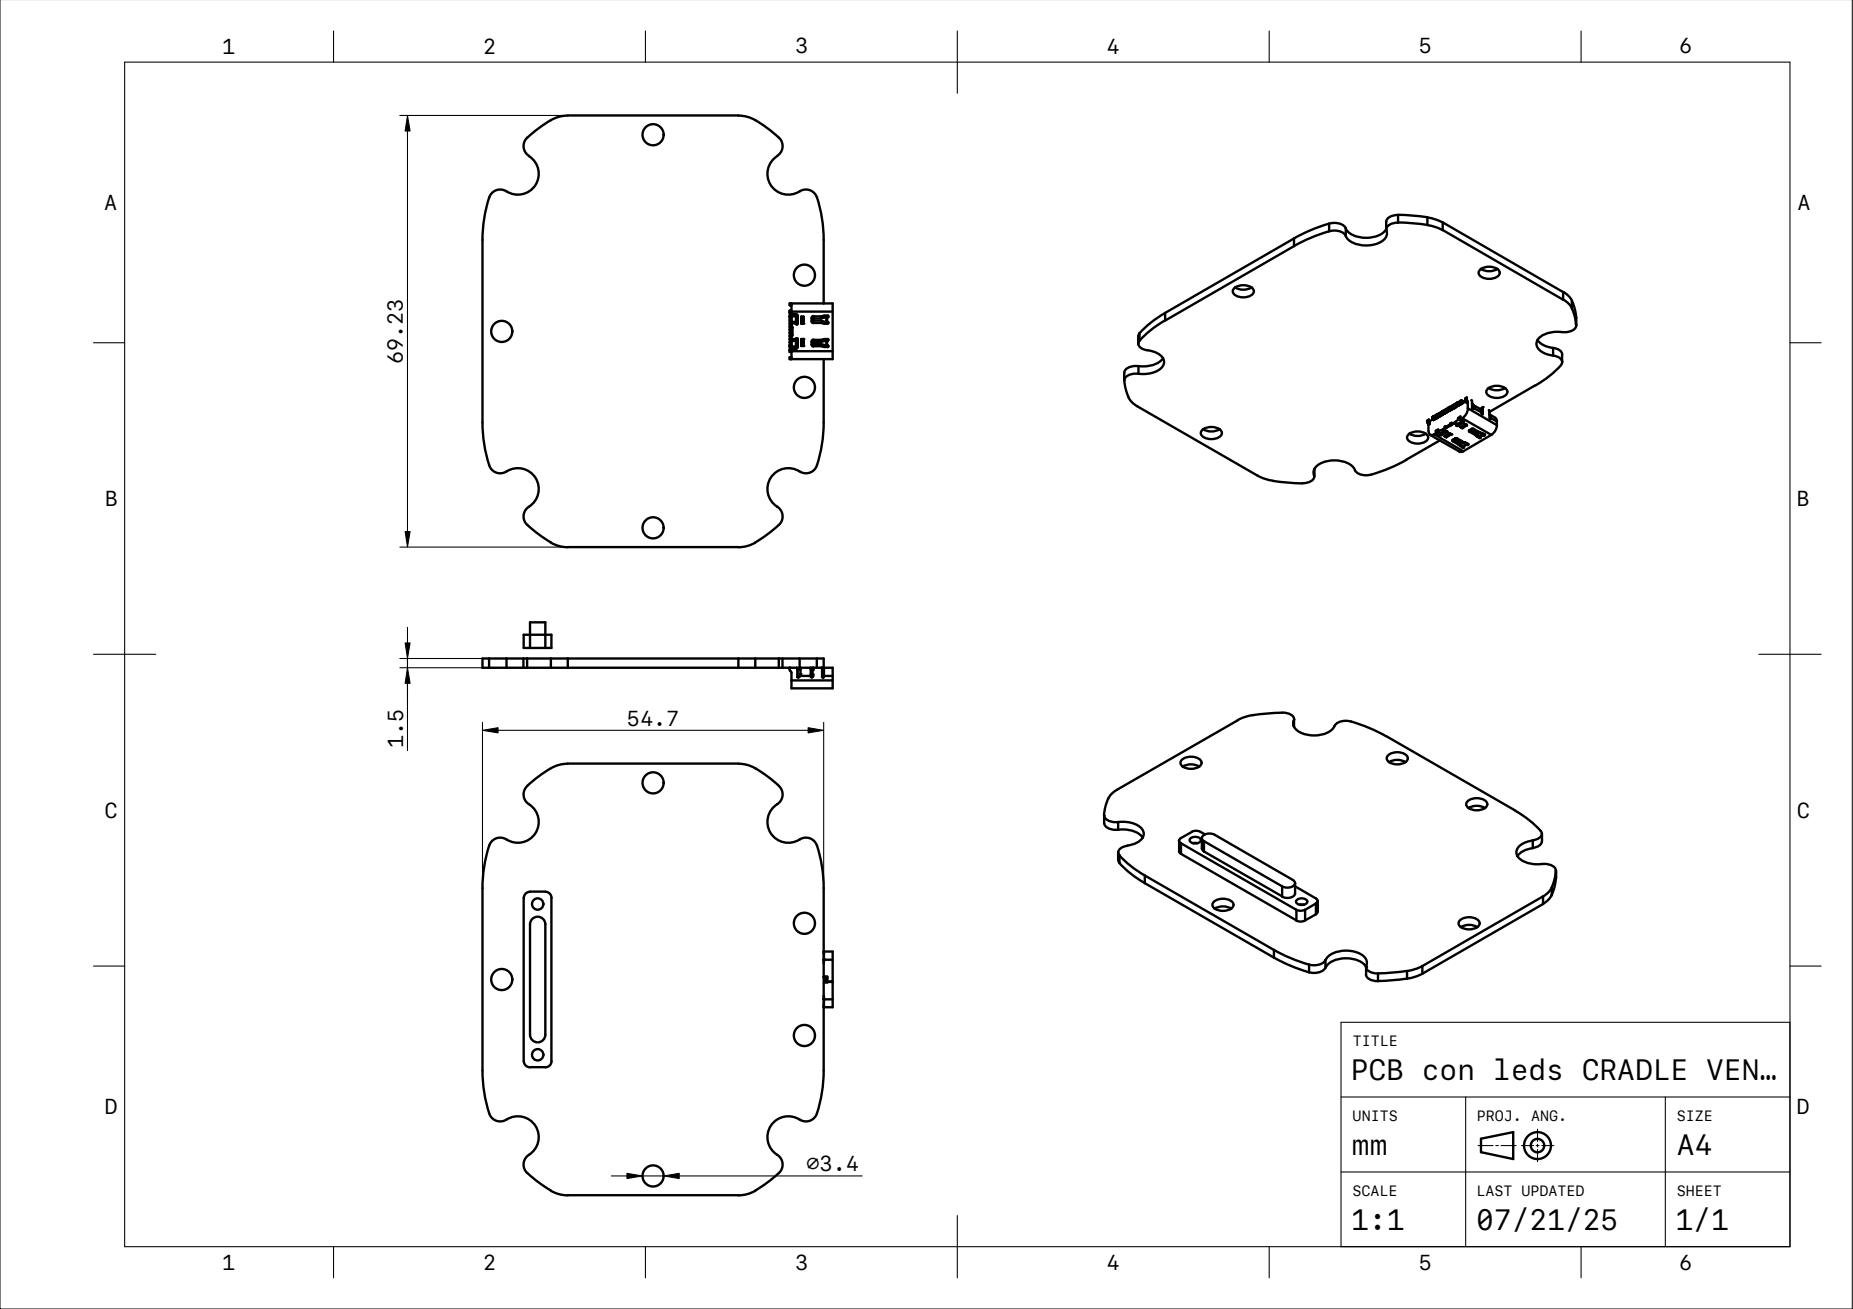
[picture p314: page 1]
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
