MSTKMAD/battery-pack/02.HARDWARE/V3-Rover Venus/01-PCB/CRADLE/Cradle v2/cradle_venus.brd

## EAGLE design 02.HARDWARE/V3-Rover Venus/01-PCB/CRADLE/Cradle v2/cradle_venus.brd (2026-01-16)

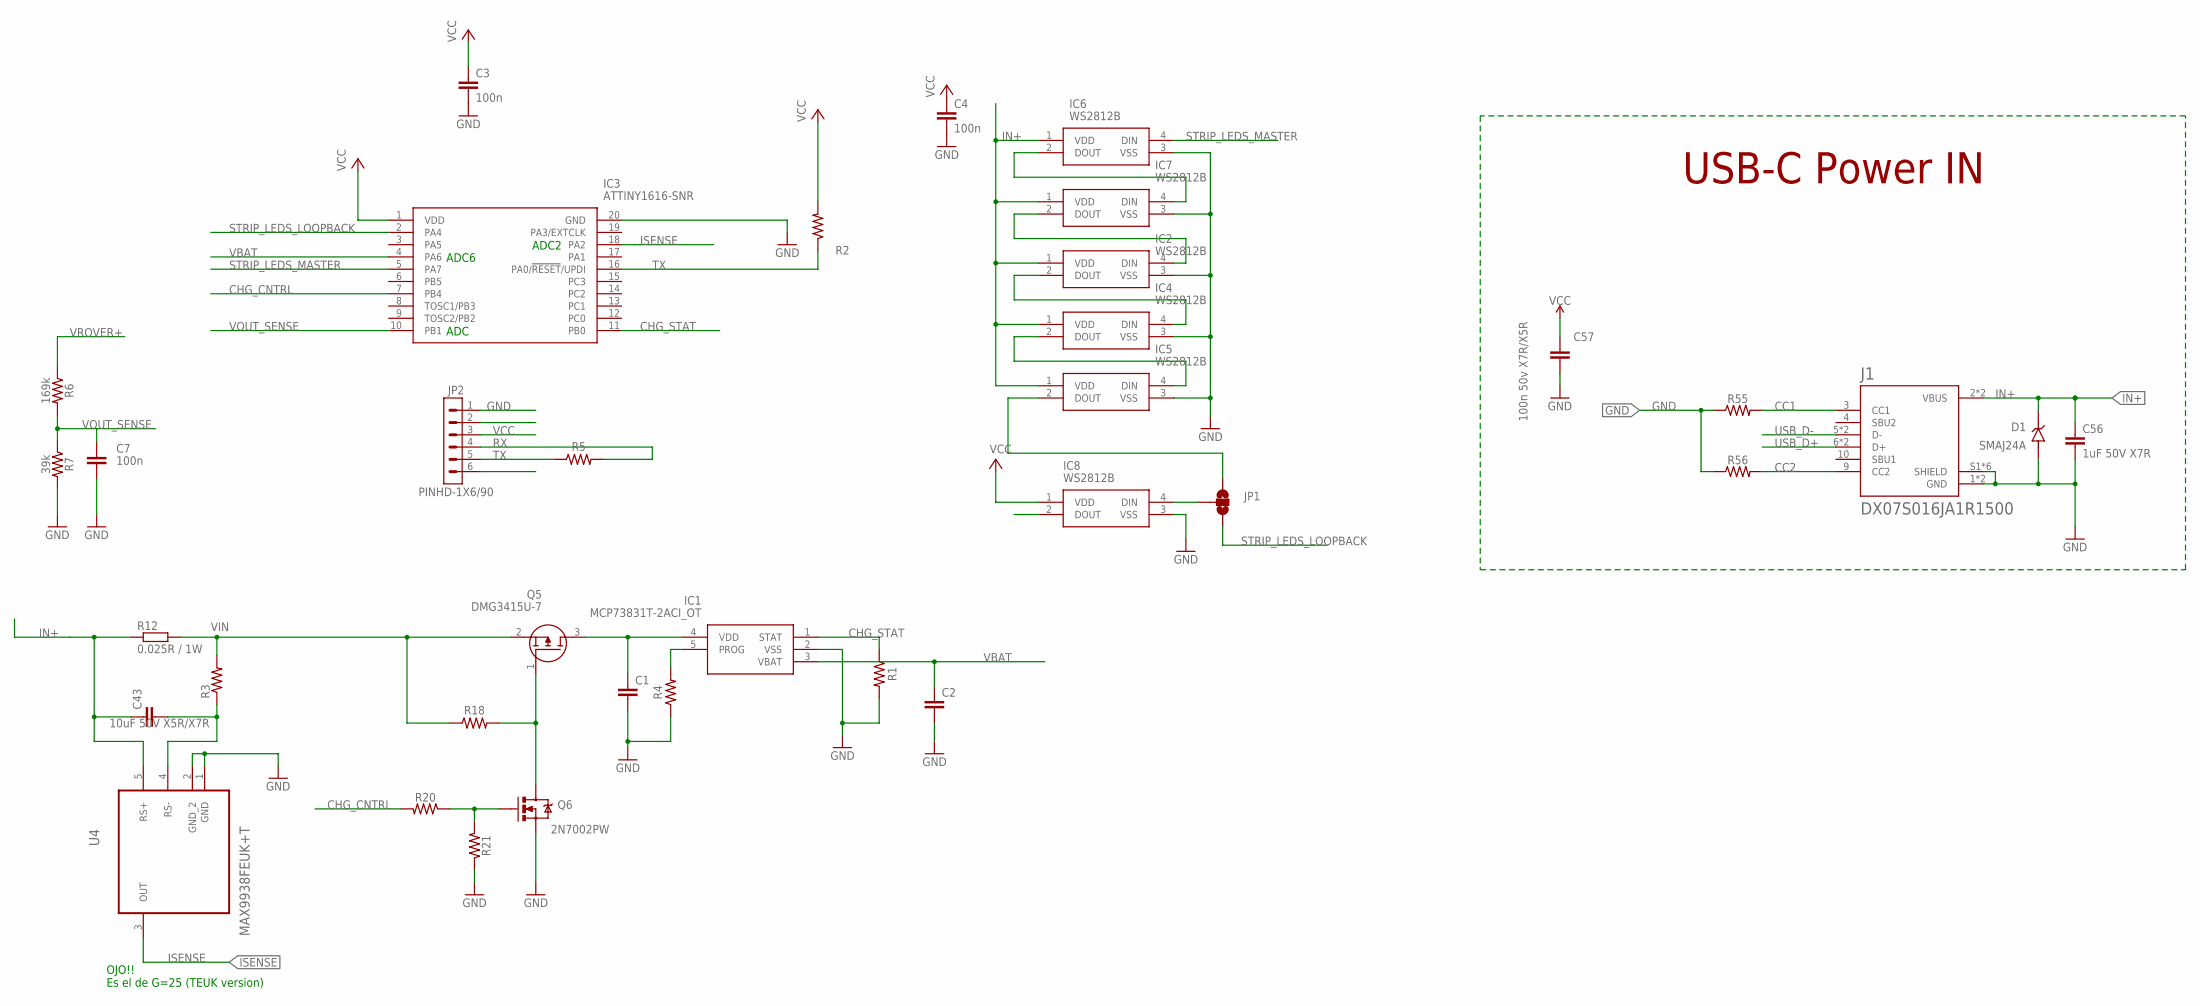
[picture p316: schematic cradle_venus.sch]

Parts:
C1, C2: C-EUC0805; C0805
C3, C4: 100n; C0805
C7: 100n; 0603
C43: 10uF 50V X5R/X7R; 1206
C56: 1uF 50V X7R; 0805
C57: 100n 50v X7R/X5R; 0805
D1: SMAJ24A; DIOM4325X244N
IC1: MCP73831T-2ACI_OT; SOT95P270X145-5N
IC2, IC4, IC5, IC6, IC7, IC8: WS2812B
IC3: ATTINY1616-SNR; SOIC127P1030X265-20N
J1: DX07S016JA1R1500; JAE_DX07S016JA1R1500
JP1: JUMPER-SMT_3_NO_SILK; SMT-JUMPER_3_NO_SILK
JP2: PINHD-1X6/90; 1X06/90
Q5: DMG3415U-7; SSM3J332RLFT
Q6: 2N7002PW; SOT323
R1, R2, R3, R4, R5, R18, R20, R21, R55, R56: 0805
R6: 169k; 0603
R7: 39k; 0603
R12: 0.025R / 1W; R2512
U4: MAX9938FEUK+T; SOT95P280X145-5N

Connections:
CC1: J1.3 (CC1), R55.2
CC2: J1.9 (CC2), R56.2
CHG_CNTRL: IC3.7 (PB4), R20.2
CHG_STAT: IC1.1 (STAT), IC3.11 (PB0), R1.1
GND: C1.2, C2.2, C3.2, C4.2, C7.2, C56.2, C57.2, D1.A, IC1.2 (VSS), IC2.3 (VSS), IC3.20 (GND), IC4.3 (VSS), IC5.3 (VSS), IC6.3 (VSS), IC7.3 (VSS), IC8.3 (VSS), J1.1 (GND), J1.12 (GND), J1.S1 (SHIELD), J1.S2 (SHIELD), J1.S3 (SHIELD), J1.S4 (SHIELD), J1.S5 (SHIELD), J1.S6 (SHIELD), JP2.1, Q6.2 (S), R1.2, R4.1, R7.2, R21.1, R55.1, R56.1, U4.1 (GND), U4.2 (GND_2)
IN+: C3.1, C4.1, C43.1, C56.1, C57.1, D1.C (K), IC2.1 (VDD), IC3.1 (VDD), IC4.1 (VDD), IC5.1 (VDD), IC6.1 (VDD), IC7.1 (VDD), IC8.1 (VDD), J1.2 (VBUS), J1.11 (VBUS), R2.2, R12.1, U4.5 (RS+)
ISENSE: IC3.18 (PA2), U4.3 (OUT)
unnamed: C1.1, IC1.4 (VDD), Q5.3 (D)
unnamed: IC6.2 (DOUT), IC7.4 (DIN)
unnamed: C43.2, R3.1, U4.4 (RS-)
unnamed: IC2.2 (DOUT), IC4.4 (DIN)
unnamed: IC4.2 (DOUT), IC5.4 (DIN)
unnamed: Q6.1 (G), R20.1, R21.2
unnamed: IC2.4 (DIN), IC7.2 (DOUT)
unnamed: IC8.4 (DIN), JP1.2
unnamed: IC5.2 (DOUT), JP1.1
unnamed: Q5.1 (G), Q6.3 (D), R18.2
unnamed: IC1.5 (PROG), R4.2
RX: JP2.4, R5.2
STRIP_LEDS_LOOPBACK: IC3.2 (PA4), JP1.3
STRIP_LEDS_MASTER: IC3.5 (PA7), IC6.4 (DIN)
TX: IC3.16 (PA0/!RESET!/UPDI), JP2.5, R2.1, R5.1
USB_D+: J1.6 (D+), J1.7 (D+)
USB_D-: J1.5 (D-), J1.8 (D-)
VBAT: C2.1, IC1.3 (VBAT), IC3.4 (PA6)
VCC: JP2.3
VIN: Q5.2 (S), R3.2, R12.2, R18.1
VOUT_SENSE: C7.1, IC3.10 (PB1), R6.2, R7.1
VROVER+: R6.1

Notes on the sheet:
USB-C Power IN
OJO!! Es el de G=25 (TEUK version)
ADC2
ADC
ADC6

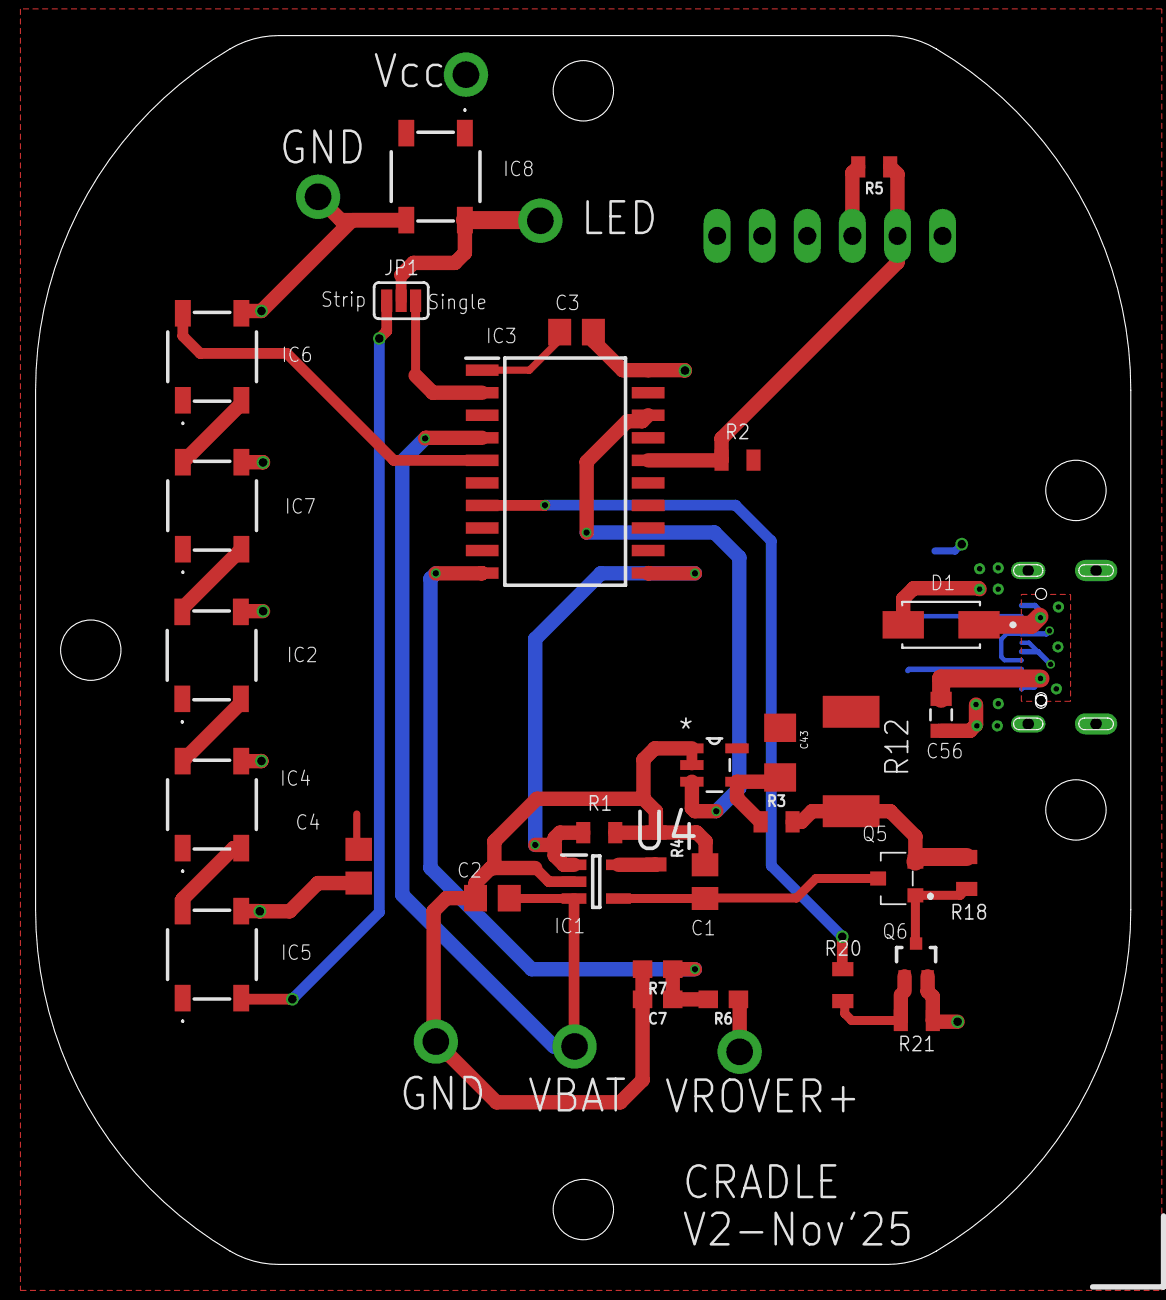
[picture p317: board cradle_venus.brd from above]

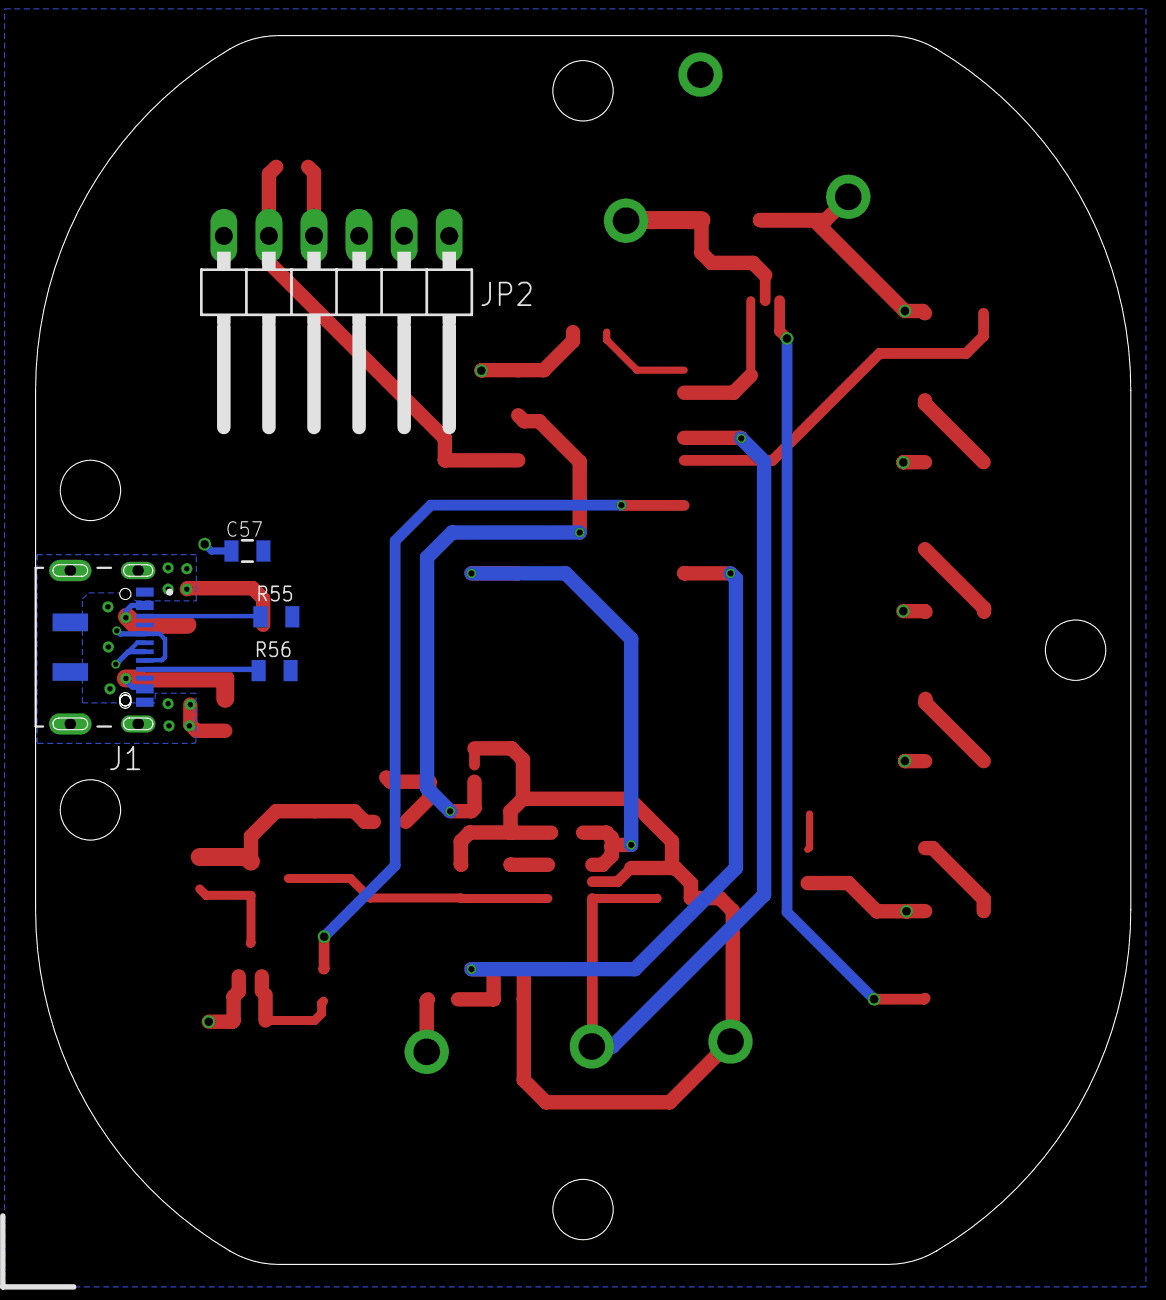
[picture p318: board cradle_venus.brd from below]

Board: 2 copper layers, 61.7 x 69.2 mm, 36 parts (5 on the bottom side), 27 nets.
