MSTKMAD/battery-pack/02.HARDWARE/V4-Grip/GRIP-MOTHER/Grip-Mother.brd

## EAGLE design 02.HARDWARE/V4-Grip/GRIP-MOTHER/Grip-Mother.brd (2026-01-16)

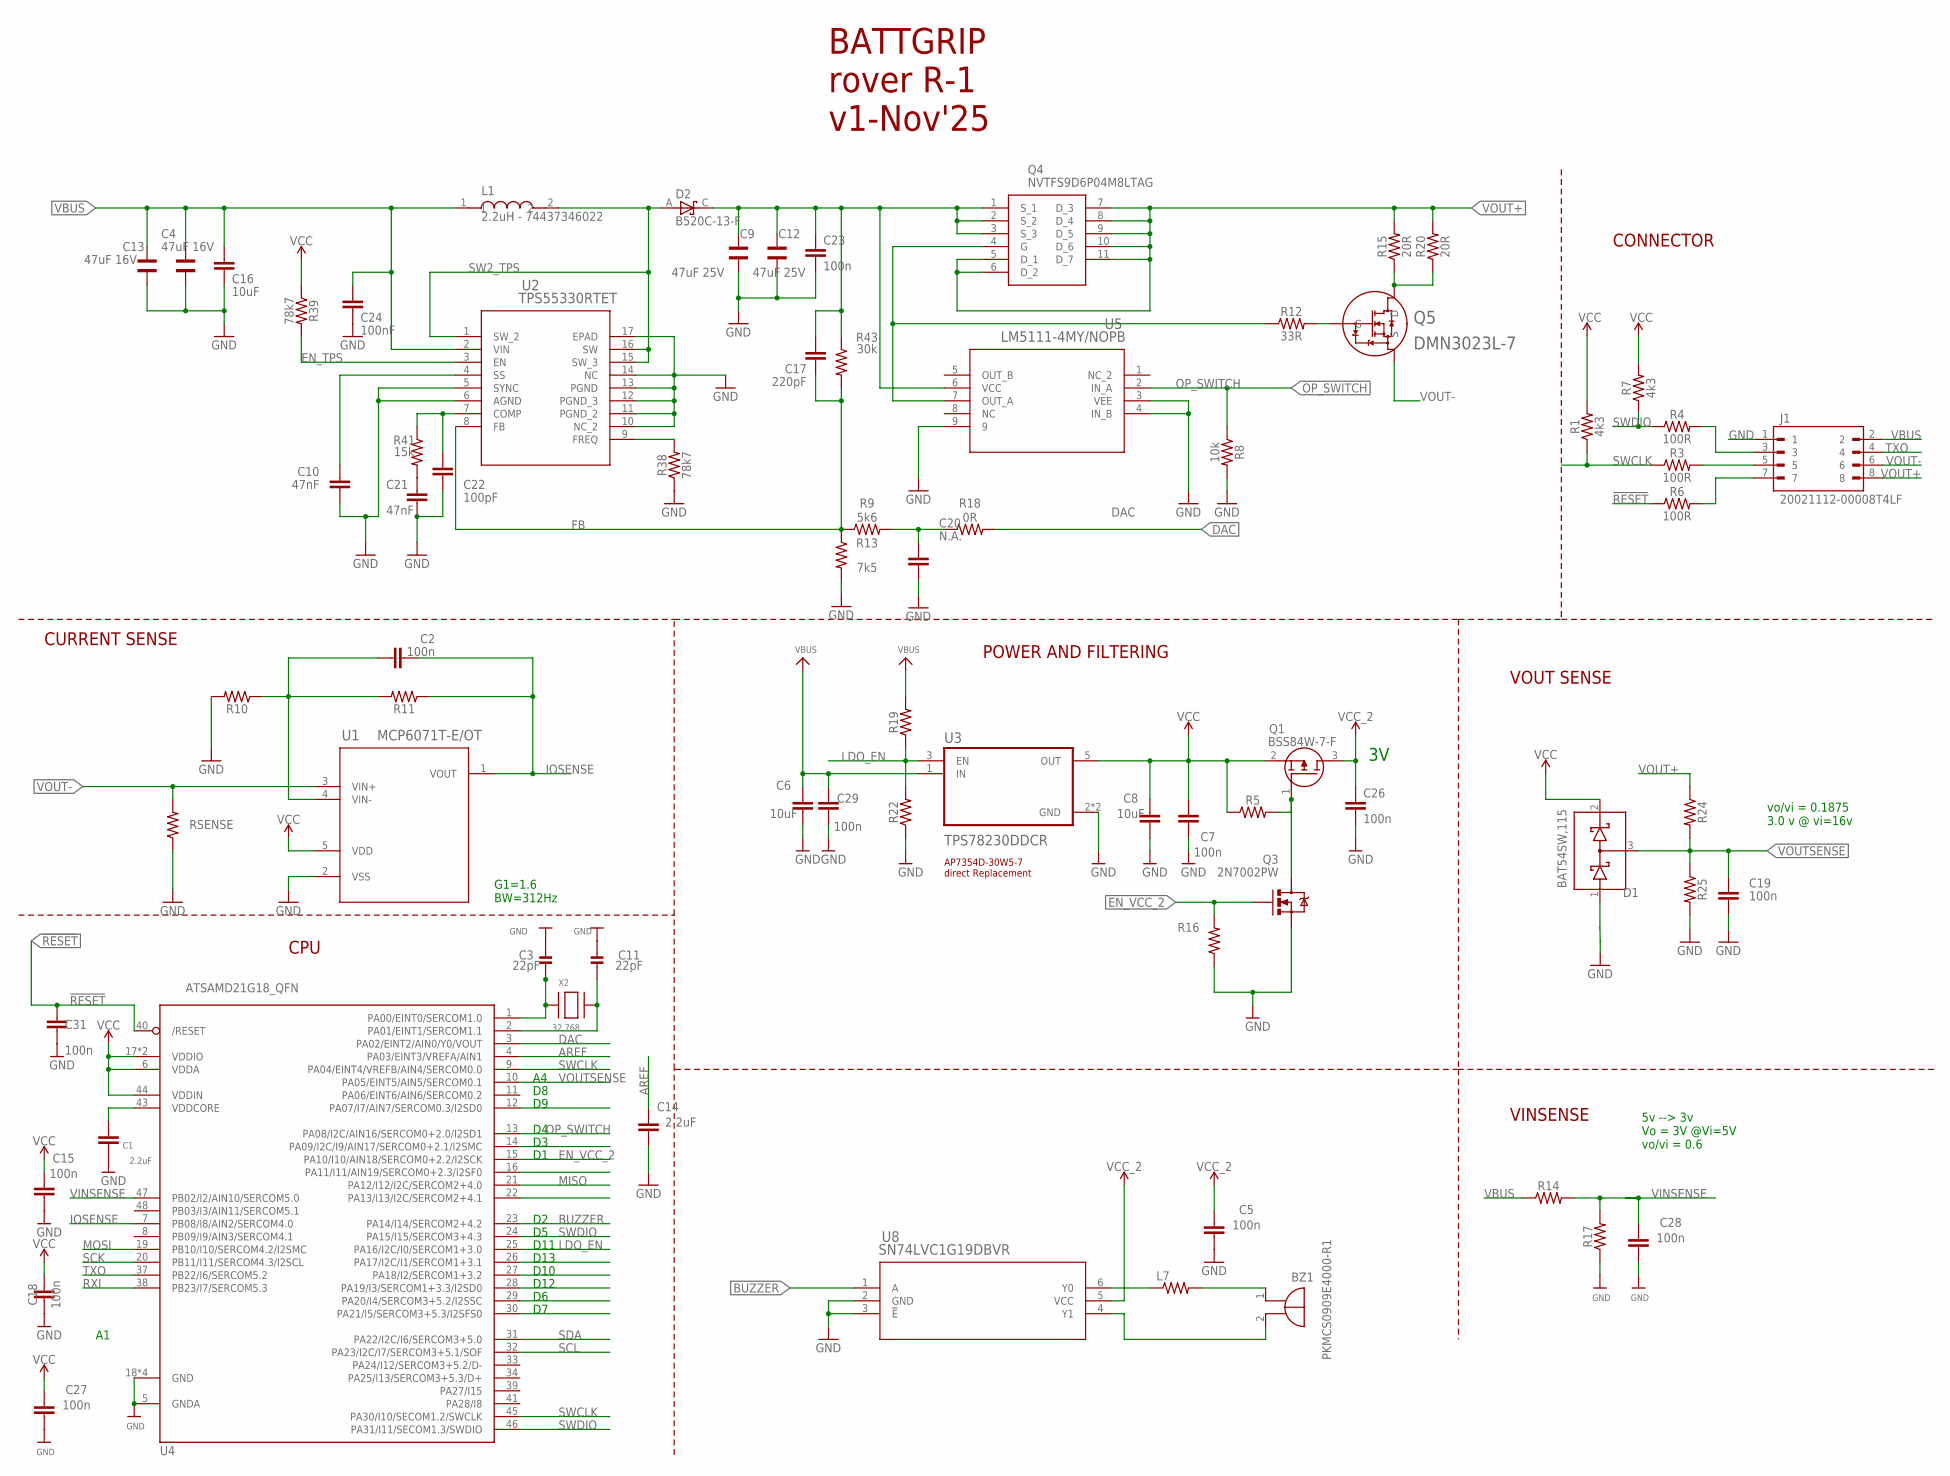
[picture p319: schematic Grip-Mother.sch]

Parts:
BZ1: PKMCS0909E4000-R1; PKMCS0909
C1, C14: 2.2uF; 0603
C2, C19, C23: 100n; 0603
C3, C11: 22pF; 0603-NO
C4, C13: 47uF 16V; WCAP-CSGP_1210
C5, C7, C15, C18, C26, C27, C28, C29, C31: 100n; 0402
C6, C8: 10uF; 0603
C9, C12: 47uF 25V; WCAP-CSGP_1210
C10, C21: 47nF; 0603
C16: 10uF; 0805
C17: 220pF; 0603
C20: N.A.; 0603
C22: 100pF; 0603
C24: 100nF; 0603
D1: BAT54SW,115; SOT65P210X110-3N
D2: B520C-13-F; DIOM7959X250N
J1: 20021112-00008T4LF; AMPHENOL_20021112-00008T4LF
L1: 2.2uH - 74437346022; INDM7366X500
L7: MMZ2012Y202BT000; 0805
Q1: BSS84W-7-F; SOT65P222X110-3N
Q3: 2N7002PW; SOT323
Q4: NVTFS9D6P04M8LTAG; NVTFS5124PLTWG
Q5: DMN3023L-7; SOT23-TO-236AB_NEX-L
R1, R7: 4k3; 0402
R3, R4, R6: 100R; 0402
R5, R10, R11, R14, R16, R17, R19, R22, R24, R25: 0402
R8: 10k; 0402
R9: 5k6; 0402
R12: 33R; 0402
R13: 7k5; 0402
R15, R20: 20R; 1206
R18: 0R; 0402
R38, R39: 78k7; 0402
R41: 15k; 0402
R43: 30k; 0402
RSENSE: 1206
U1: MCP6071T-E/OT; SOT-23-5_MC_MCH
U2: TPS55330RTET; RTE16_1P66X1P66_TEX
U3: TPS78230DDCR; SOT95P280X110-5N
U4: ATSAMD21G18_QFN; TQFN48_7MM
U5: LM5111-4MY/NOPB; MUY08A
U8: SN74LVC1G19DBVR; DBV6
X2: 32.768; XTAL3215

Connections:
!RESET: C31.1, R6.1, U4.40 (/RESET)
AREF: C14.1, U4.4 (PA03/EINT3/VREFA/AIN1)
BUZZER: U4.23 (PA14/I14/SERCOM2+4.2), U8.1 (A)
COMP_TPS: C22.2, R41.1, U2.7 (COMP)
DAC: R18.2, U4.3 (PA02/EINT2/AIN0/Y0/VOUT)
EN_TPS: R39.2, U2.3 (EN)
EN_VCC_2: Q3.1 (G), R16.2, U4.15 (PA10/I10/AIN18/SERCOM0+2.2/I2SCK)
FB: C17.1, R9.1, R13.1, R43.2, U2.8 (FB)
FREQ_TPS: R38.2, U2.9 (FREQ)
GND: C1.2, C3.2, C4.1, C5.2, C6.2, C7.2, C8.2, C9.1, C10.2, C11.2, C12.1, C13.1, C14.2, C15.2, C16.1, C18.2, C19.2, C20.2, C21.1, C22.1, C23.2, C24.1, C26.2, C27.2, C28.2, C29.2, C31.2, D1.1 (A), J1.1, Q3.2 (S), R8.2, R10.2, R13.2, R16.1, R17.1, R22.1, R25.2, R38.1, RSENSE.1, U1.2 (VSS), U2.5 (SYNC), U2.6 (AGND), U2.10 (NC_2), U2.11 (PGND_2), U2.12 (PGND_3), U2.13 (PGND), U2.14 (NC), U2.17 (EPAD), U3.2 (GND), U3.4 (GND), U4.5 (GNDA), U4.18 (GND), U4.35 (GND), U4.42 (GND), U4.THERMAL (GND), U5.3 (VEE), U5.4 (IN_B), U5.9, U8.2 (GND), U8.3 (!E)
IOSENSE: C2.1, R11.1, U1.1 (VOUT), U4.7 (PB08/I8/AIN2/SERCOM4.0)
LDO_EN: R19.1, R22.2, U3.3 (EN), U4.25 (PA16/I2C/I0/SERCOM1+3.0)
MISO: U4.21 (PA12/I12/I2C/SERCOM2+4.0)
MOSI: U4.19 (PB10/I10/SERCOM4.2/I2SMC)
unnamed: Q4.4 (G), R12.1, U5.7 (OUT_A)
unnamed: J1.7, R6.2
unnamed: J1.5, R3.2
unnamed: C2.2, R10.1, R11.2, U1.4 (VIN-)
unnamed: Q1.1 (G), Q3.3 (D), R5.2
unnamed: Q5.3 (D), R15.1, R20.1
unnamed: C3.1, U4.1 (PA00/EINT0/SERCOM1.0), X2.P$1
unnamed: C11.1, U4.2 (PA01/EINT1/SERCOM1.1), X2.P$2
unnamed: J1.3, R4.2
unnamed: C20.1, R9.2, R18.1
unnamed: Q5.1 (G), R12.2
unnamed: L7.1, U8.6 (Y0)
unnamed: BZ1.1 (+), L7.2
unnamed: BZ1.2 (-), U8.4 (Y1)
unnamed: C10.1, U2.4 (SS)
unnamed: C21.2, R41.2
OP_SWITCH: R8.1, U4.13 (PA08/I2C/AIN16/SERCOM0+2.0/I2SD1), U5.2 (IN_A)
RXI: U4.38 (PB23/I7/SERCOM5.3)
SCK: U4.20 (PB11/I11/SERCOM4.3/I2SCL)
SCL: U4.32 (PA23/I2C/I7/SERCOM3+5.1/SOF)
SDA: U4.31 (PA22/I2C/I6/SERCOM3+5.0)
SW2_TPS: D2.A, L1.2, U2.1 (SW_2), U2.15 (SW_3), U2.16 (SW)
SWCLK: R1.1, R3.1, U4.9 (PA04/EINT4/VREFB/AIN4/SERCOM0.0), U4.45 (PA30/I10/SECOM1.2/SWCLK)
SWDIO: R4.1, R7.1, U4.24 (PA15/I15/SERCOM3+4.3), U4.46 (PA31/I11/SECOM1.3/SWDIO)
TXO: J1.4, U4.37 (PB22/I6/SERCOM5.2)
VBUS: C4.2, C6.1, C13.2, C16.2, C24.2, C29.1, J1.2, L1.1, R14.1, R19.2, U2.2 (VIN), U3.1 (IN)
VCC: C7.1, C8.1, C15.1, C18.1, C27.1, D1.2 (C), Q1.2 (S), R1.2, R5.1, R7.2, R39.1, U1.5 (VDD), U3.5 (OUT), U4.6 (VDDA), U4.17 (VDDIO), U4.36 (VDDIO), U4.44 (VDDIN)
VCC_2: C5.1, C26.1, Q1.3 (D), U8.5 (VCC)
VDDCORE1: C1.1, U4.43 (VDDCORE)
VINSENSE: C28.1, R14.2, R17.2, U4.47 (PB02/I2/AIN10/SERCOM5.0)
VOUT+: J1.8, Q4.5 (D_1), Q4.6 (D_2), Q4.7 (D_3), Q4.8 (D_4), Q4.9 (D_5), Q4.10 (D_6), Q4.11 (D_7), R15.2, R20.2, R24.1
VOUT-: J1.6, Q5.2 (S), RSENSE.2, U1.3 (VIN+)
VOUTSENSE: C19.1, D1.3 (A-C), R24.2, R25.1, U4.10 (PA05/EINT5/AIN5/SERCOM0.1)
VSOURCE: C9.2, C12.2, C17.2, C23.1, D2.C, Q4.1 (S_1), Q4.2 (S_2), Q4.3 (S_3), R43.1, U5.6 (VCC)

Notes on the sheet:
POWER AND FILTERING
AP7354D-30W5-7 direct Replacement
CURRENT SENSE
5v --> 3v Vo = 3V @Vi=5V vo/vi = 0.6
BATTGRIP rover R-1 v1-Nov'25
VINSENSE
G1=1.6 BW=312Hz
vo/vi = 0.1875 3.0 v @ vi=16v
CONNECTOR
D10
CPU
D13
D11
D12
VOUT SENSE

Board: 4 copper layers, 73 parts (43 on the bottom side), 42 nets, no tracks yet.
