MSTKMAD/battery-pack/02.HARDWARE/V3-Rover Venus/01-PCB/BATT_DCDC/ForVenus.brd

## EAGLE design 02.HARDWARE/V3-Rover Venus/01-PCB/BATT_DCDC/ForVenus.brd (2025-02-12)

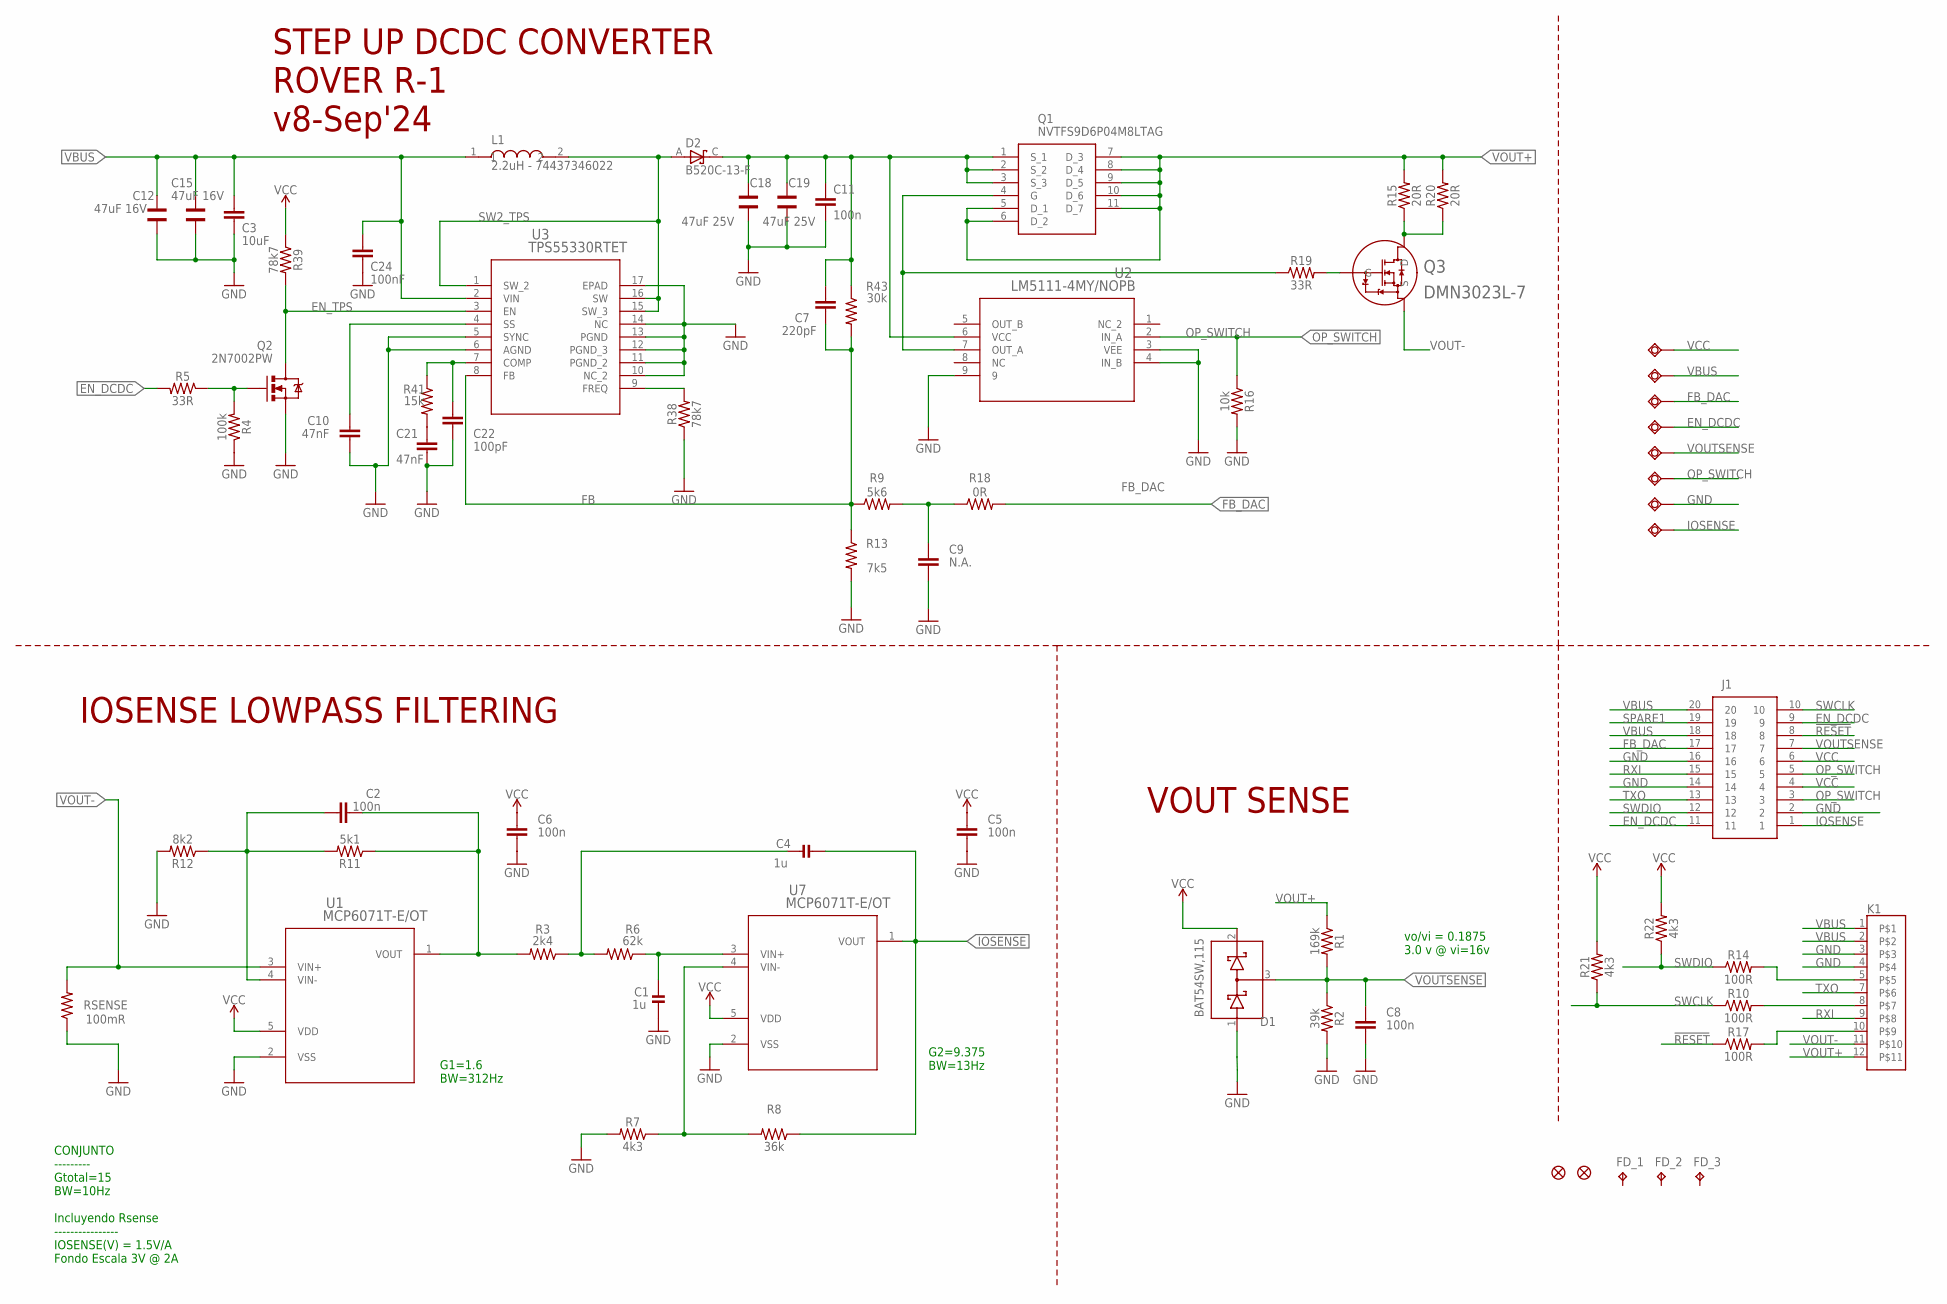
[picture p320: schematic ForVenus.sch]

Parts:
C1, C4: 1u; 0603-NO
C2, C5, C6, C8, C11: 100n; 0603
C3: 10uF; 0805
C7: 220pF; 0603
C9: N.A.; 0603
C10, C21: 47nF; 0603
C12, C15: 47uF 16V; WCAP-CSGP_1210
C18, C19: 47uF 25V; WCAP-CSGP_1210
C22: 100pF; 0603
C24: 100nF; 0603
D1: BAT54SW,115; SOT65P210X110-3N
D2: B520C-13-F; DIOM7959X250N
EN_DCDC: TESTPAD_TPSQB1,27; TESTPAD_B1,27
FB_DAC: TESTPAD_TPSQB1,27; TESTPAD_B1,27
FD_1, FD_2, FD_3: FD_1; TP06SQ
GND: TESTPAD_TPSQB1,27; TESTPAD_B1,27
IOSENSE: TESTPAD_TPSQB1,27; TESTPAD_B1,27
J1: DF40C-20DP-0.4V_51_; DF40C-20DPA
K1: FLEX11
L1: 2.2uH - 74437346022; INDM7366X500
OP_SWITCH: TESTPAD_TPSQB1,27; TESTPAD_B1,27
Q1: NVTFS9D6P04M8LTAG; NVTFS5124PLTWG
Q2: 2N7002PW; SOT323
Q3: DMN3023L-7; SOT23-TO-236AB_NEX-L
R1: 169k; 0402
R2: 39k; 0402
R3: 2k4; 0603
R4: 100k; 0402
R5, R19: 33R; 0402
R6: 62k; 0603
R7, R21: 4k3; 0603
R8: 36k; 0603
R9: 5k6; 0402
R10, R14, R17: 100R; 0402
R11: 5k1; 0402
R12: 8k2; 0402
R13: 7k5; 0402
R15, R20: 20R; 1206
R16: 10k; 0402
R18: 0R; 0402
R22: 4k3; 0402
R38, R39: 78k7; 0402
R41: 15k; 0402
R43: 30k; 0402
RSENSE: 100mR; 1206
U1, U7: MCP6071T-E/OT; SOT-23-5_MC_MCH
U2: LM5111-4MY/NOPB; MUY08A
U3: TPS55330RTET; RTE16_1P66X1P66_TEX
U$1, U$2: FIDUCIAL""; FIDUCIAL_1MM
VBUS: TESTPAD_TPSQB1,27; TESTPAD_B1,27
VCC: TESTPAD_TPSQB1,27; TESTPAD_B1,27
VOUTSENSE: TESTPAD_TPSQB1,27; TESTPAD_B1,27

Connections:
!RESET: J1.8, R17.1
COMP_TPS: C22.2, R41.1, U3.7 (COMP)
EN_DCDC: EN_DCDC.TP, J1.9, J1.11, R5.2
EN_TPS: Q2.3 (D), R39.2, U3.3 (EN)
FB: C7.1, R9.1, R13.1, R43.2, U3.8 (FB)
FB_DAC: FB_DAC.TP, J1.17, R18.2
FREQ_TPS: R38.2, U3.9 (FREQ)
GND: C1.2, C3.1, C5.2, C6.2, C8.2, C9.2, C10.2, C11.2, C12.1, C15.1, C18.1, C19.1, C21.1, C22.1, C24.1, D1.1 (A), GND.TP, J1.2, J1.14, J1.16, K1.3, K1.4, Q2.2 (S), R2.2, R4.1, R7.2, R12.2, R13.2, R16.2, R38.1, RSENSE.1, U1.2 (VSS), U2.3 (VEE), U2.4 (IN_B), U2.9, U3.5 (SYNC), U3.6 (AGND), U3.10 (NC_2), U3.11 (PGND_2), U3.12 (PGND_3), U3.13 (PGND), U3.14 (NC), U3.17 (EPAD), U7.2 (VSS)
IOSENSE: C4.2, IOSENSE.TP, J1.1, R8.1, U7.1 (VOUT)
ISENSE_RAW: C2.1, R3.2, R11.1, U1.1 (VOUT)
unnamed: C2.2, R11.2, R12.1, U1.4 (VIN-)
unnamed: R7.1, R8.2, U7.4 (VIN-)
unnamed: C4.1, R3.1, R6.2
unnamed: Q2.1 (G), R4.2, R5.1
unnamed: C1.1, R6.1, U7.3 (VIN+)
unnamed: K1.8, R10.2
unnamed: Q3.3 (D), R15.1, R20.1
unnamed: Q1.4 (G), R19.1, U2.7 (OUT_A)
unnamed: K1.10, R17.2
unnamed: K1.5, R14.2
unnamed: C9.1, R9.2, R18.1
unnamed: Q3.1 (G), R19.2
unnamed: C10.1, U3.4 (SS)
unnamed: C21.2, R41.2
OP_SWITCH: J1.3, J1.5, OP_SWITCH.TP, R16.1, U2.2 (IN_A)
RXI: J1.15, K1.9
SPARE1: J1.19
SW2_TPS: D2.A, L1.2, U3.1 (SW_2), U3.15 (SW_3), U3.16 (SW)
SWCLK: J1.10, R10.1, R21.1
SWDIO: J1.12, R14.1, R22.1
TXO: J1.13, K1.7
VBUS: C3.2, C12.2, C15.2, C24.2, J1.18, J1.20, K1.1, K1.2, L1.1, U3.2 (VIN), VBUS.TP
VCC: C5.1, C6.1, D1.2 (C), J1.4, J1.6, R21.2, R22.2, R39.1, U1.5 (VDD), U7.5 (VDD), VCC.TP
VOUT+: K1.12, Q1.5 (D_1), Q1.6 (D_2), Q1.7 (D_3), Q1.8 (D_4), Q1.9 (D_5), Q1.10 (D_6), Q1.11 (D_7), R1.1, R15.2, R20.2
VOUT-: K1.11, Q3.2 (S), RSENSE.2, U1.3 (VIN+)
VOUTSENSE: C8.1, D1.3 (A-C), J1.7, R1.2, R2.1, VOUTSENSE.TP
VSOURCE: C7.2, C11.1, C18.2, C19.2, D2.C, Q1.1 (S_1), Q1.2 (S_2), Q1.3 (S_3), R43.1, U2.6 (VCC)

Notes on the sheet:
vo/vi = 0.1875 3.0 v @ vi=16v
VOUT SENSE
G2=9.375 BW=13Hz
IOSENSE LOWPASS FILTERING
STEP UP DCDC CONVERTER ROVER R-1 v8-Sep'24
G1=1.6 BW=312Hz
CONJUNTO --------- Gtotal=15 BW=10Hz Incluyendo Rsense ---------------- IOSENSE(V) = 1.5V/A Fondo Escala 3V @ 2A

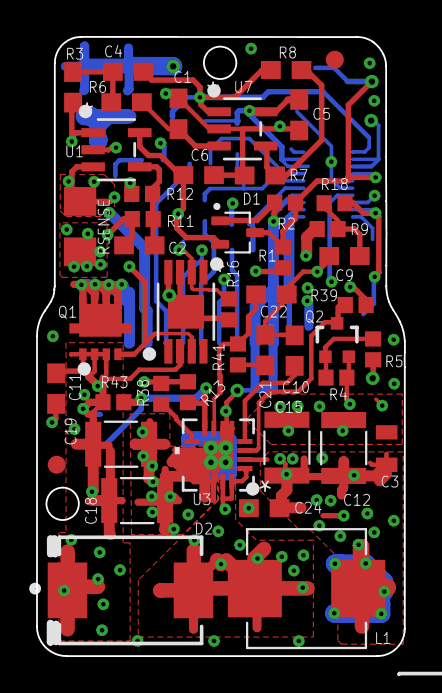
[picture p321: board ForVenus.brd from above]

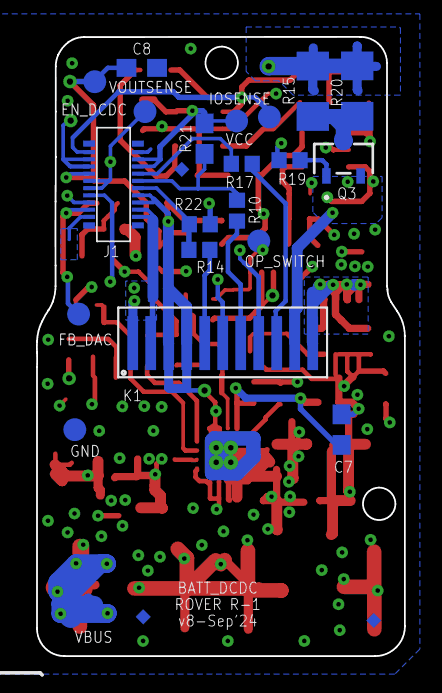
[picture p322: board ForVenus.brd from below]

Board: 4 copper layers, 20.4 x 34.4 mm, 70 parts (24 on the bottom side), 36 nets.
