MSTKMAD/battery-pack/02.HARDWARE/V3-Rover Venus/01-PCB/BATT_CPU/Venus.brd

## EAGLE design 02.HARDWARE/V3-Rover Venus/01-PCB/BATT_CPU/Venus.brd (2025-09-29)

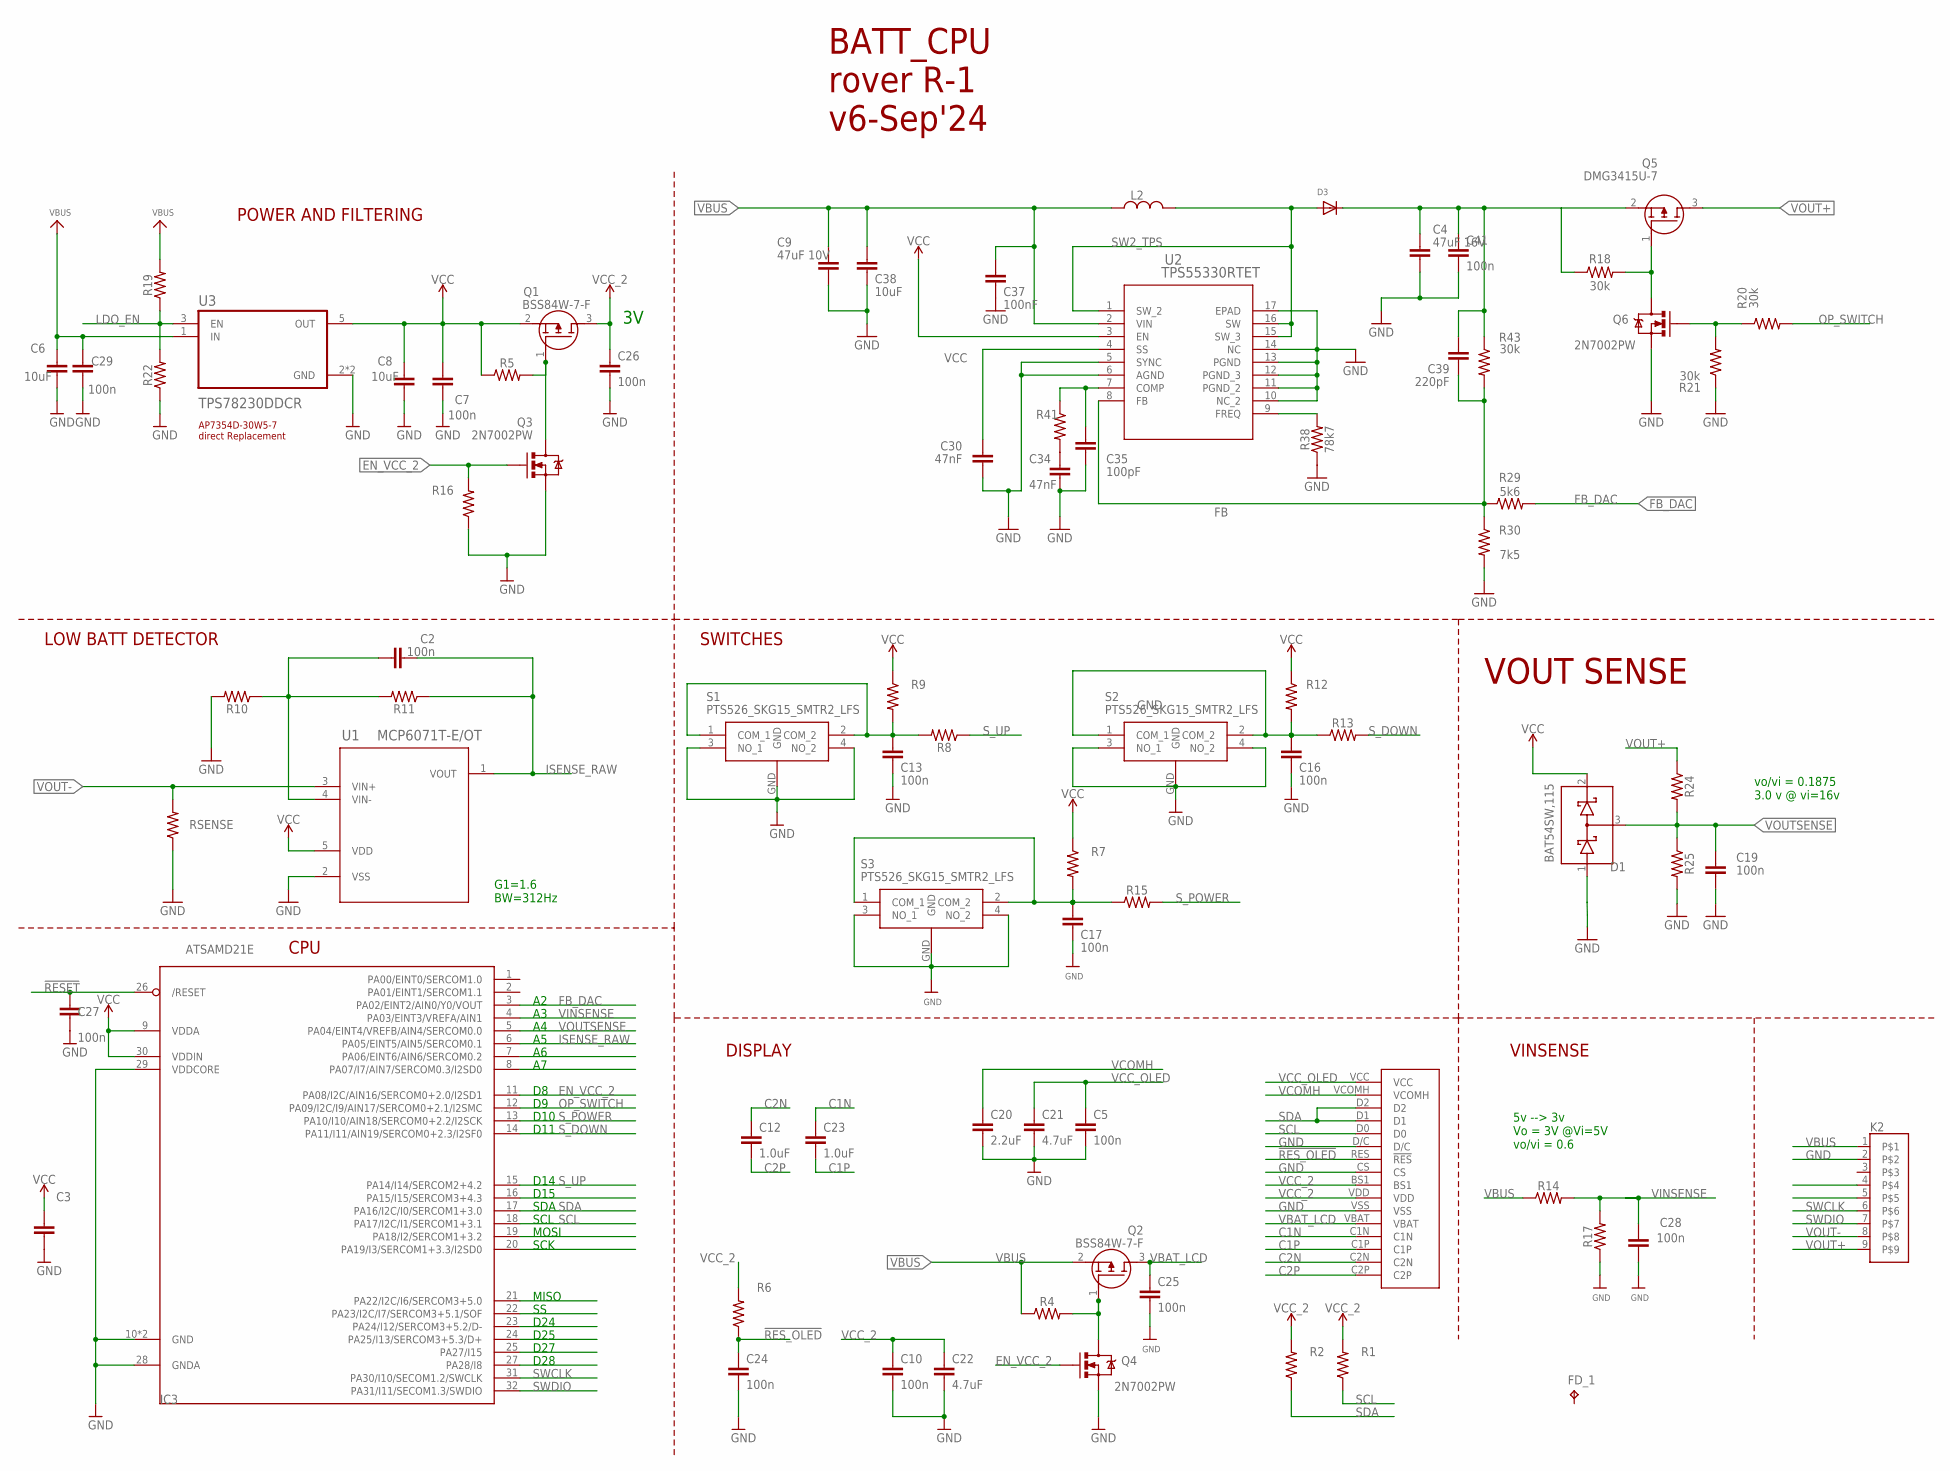
[picture p323: schematic Venus.sch]

Parts:
C2, C19, C41: 100n; 0603
C3, C5, C7, C10, C13, C16, C17, C24, C25, C26, C27, C28, C29: 100n; 0402
C4: 47uF 16V; CAPC3216X135
C6, C8: 10uF; 0603
C9: 47uF 10V; CAPC2012X110
C12, C23: 1.0uF; 0402
C20: 2.2uF; 0603
C21, C22: 4.7uF; 0603
C30, C34: 47nF; 0603
C35: 100pF; 0603
C37: 100nF; 0603
C38: 10uF; 0805
C39: 220pF; 0603
D1: BAT54SW,115; SOT65P210X110-3N
D3: DIODESOD-123; SOD-123
FD_1: FD_1; TP06SQ
IC3: ATSAMD21E; QFN32_5MM
K2: FLEX9_2MM
L2: L_CHIP-1206(3216-METRIC); INDC3216X190
Q1, Q2: BSS84W-7-F; SOT65P222X110-3N
Q3, Q4, Q6: 2N7002PW; SOT323
Q5: DMG3415U-7; SSM3J332RLFT
R1, R2, R4, R5, R6, R7, R8, R9, R10, R11, R12, R13, R14, R15, R16, R17, R19, R22, R24, R25, R41: 0402
R18, R20, R21, R43: 30k; 0402
R29: 5k6; 0402
R30: 7k5; 0402
R38: 78k7; 0402
RSENSE: 1206
S1, S2, S3: PTS526_SKG15_SMTR2_LFS; PTS526SKG15SMTR2LFS
U1: MCP6071T-E/OT; SOT-23-5_MC_MCH
U2: TPS55330RTET; RTE16_1P66X1P66_TEX
U3: TPS78230DDCR; SOT95P280X110-5N
U$30: 72X40_OLED; LCD_16_PINS

Connections:
!RESET: C27.1, IC3.26 (/RESET)
!RES_OLED: C24.1, R6.1, U$30.RES (!RES)
C1N: C23.1, U$30.C1N
C1P: C23.2, U$30.C1P
C2N: C12.1, U$30.C2N
C2P: C12.2, U$30.C2P
COMP_TPS: C35.2, R41.1, U2.7 (COMP)
EN_VCC_2: IC3.11 (PA08/I2C/AIN16/SERCOM0+2.0/I2SD1), Q3.1 (G), Q4.1 (G), R16.2
FB: C39.1, R29.1, R30.1, R43.2, U2.8 (FB)
FB_DAC: IC3.3 (PA02/EINT2/AIN0/Y0/VOUT), R29.2
FREQ_TPS: R38.2, U2.9 (FREQ)
GND: C3.2, C4.2, C5.2, C6.2, C7.2, C8.2, C9.2, C10.2, C13.2, C16.2, C17.2, C19.2, C20.2, C21.2, C22.2, C24.2, C25.2, C26.2, C27.2, C28.2, C29.2, C30.2, C34.1, C35.1, C37.1, C38.1, C41.2, D1.1 (A), IC3.10 (GND), IC3.28 (GNDA), IC3.29 (VDDCORE), IC3.33 (GND), K2.2, Q3.2 (S), Q4.2 (S), Q6.2 (S), R10.2, R16.1, R17.1, R21.1, R22.1, R25.2, R30.2, R38.1, RSENSE.1, S1.3 (NO_1), S1.4 (NO_2), S1.GND, S2.3 (NO_1), S2.4 (NO_2), S2.GND, S3.3 (NO_1), S3.4 (NO_2), S3.GND, U1.2 (VSS), U2.5 (SYNC), U2.6 (AGND), U2.10 (NC_2), U2.11 (PGND_2), U2.12 (PGND_3), U2.13 (PGND), U2.14 (NC), U2.17 (EPAD), U3.2 (GND), U3.4 (GND), U$30.CS, U$30.D/C, U$30.VSS
ISENSE_RAW: C2.1, IC3.6 (PA05/EINT5/AIN5/SERCOM0.1), R11.1, U1.1 (VOUT)
LDO_EN: R19.1, R22.2, U3.3 (EN)
unnamed: C17.1, R7.2, R15.1, S3.1 (COM_1), S3.2 (COM_2)
unnamed: C13.1, R8.2, R9.2, S1.1 (COM_1), S1.2 (COM_2)
unnamed: C16.1, R12.2, R13.1, S2.1 (COM_1), S2.2 (COM_2)
unnamed: Q2.1 (G), Q4.3 (D), R4.2
unnamed: C2.2, R10.1, R11.2, U1.4 (VIN-)
unnamed: Q1.1 (G), Q3.3 (D), R5.2
unnamed: Q6.1 (G), R20.1, R21.2
unnamed: Q5.1 (G), Q6.3 (D), R18.2
unnamed: C30.1, U2.4 (SS)
unnamed: C34.2, R41.2
OP_SWITCH: IC3.12 (PA09/I2C/I9/AIN17/SERCOM0+2.1/I2SMC), R20.2
SCL: IC3.18 (PA17/I2C/I1/SERCOM1+3.1), R1.1, U$30.D0
SDA: IC3.17 (PA16/I2C/I0/SERCOM1+3.0), R2.1, U$30.D1, U$30.D2
SW2_TPS: D3.A, L2.2, U2.1 (SW_2), U2.15 (SW_3), U2.16 (SW)
SWCLK: IC3.31 (PA30/I10/SECOM1.2/SWCLK), K2.6
SWDIO: IC3.32 (PA31/I11/SECOM1.3/SWDIO), K2.7
S_DOWN: IC3.14 (PA11/I11/AIN19/SERCOM0+2.3/I2SF0), R13.2
S_POWER: IC3.13 (PA10/I10/AIN18/SERCOM0+2.2/I2SCK), R15.2
S_UP: IC3.15 (PA14/I14/SERCOM2+4.2), R8.1
VBAT_LCD: C25.1, Q2.3 (D), U$30.VBAT
VBUS: C6.1, C9.1, C29.1, C37.2, C38.2, K2.1, L2.1, Q2.2 (S), R4.1, R14.1, R19.2, U2.2 (VIN), U3.1 (IN)
VCC: C3.1, C7.1, C8.1, D1.2 (C), IC3.9 (VDDA), IC3.30 (VDDIN), Q1.2 (S), R5.1, R7.1, R9.1, R12.1, U1.5 (VDD), U2.3 (EN), U3.5 (OUT)
VCC_2: C10.1, C22.1, C26.1, Q1.3 (D), R1.2, R2.2, R6.2, U$30.BS1, U$30.VDD
VCC_OLED: C5.1, C21.1, U$30.VCC
VCOMH: C20.1, U$30.VCOMH
VINSENSE: C28.1, IC3.4 (PA03/EINT3/VREFA/AIN1), R14.2, R17.2
VOUT+: K2.9, Q5.3 (D), R24.1
VOUT-: K2.8, RSENSE.2, U1.3 (VIN+)
VOUTSENSE: C19.1, D1.3 (A-C), IC3.5 (PA04/EINT4/VREFB/AIN4/SERCOM0.0), R24.2, R25.1
VSOURCE: C4.1, C39.2, C41.1, D3.C, Q5.2 (S), R18.1, R43.1

Notes on the sheet:
POWER AND FILTERING
AP7354D-30W5-7 direct Replacement
LOW BATT DETECTOR
CPU
D15
5v --> 3v Vo = 3V @Vi=5V vo/vi = 0.6
BATT_CPU rover R-1 v6-Sep'24
DISPLAY
SWITCHES
VINSENSE
G1=1.6 BW=312Hz
vo/vi = 0.1875 3.0 v @ vi=16v
VOUT SENSE
SDA
SCL
MOSI
SCK
D14
MISO
D24
D25
D27
D28
D10
D11
