MSTKMAD/battery-pack/02.HARDWARE/V3-Rover Venus/01-PCB/BATT_CPU/Venus.brd

## EAGLE design 02.HARDWARE/V3-Rover Venus/01-PCB/BATT_CPU/Venus.brd (continued)

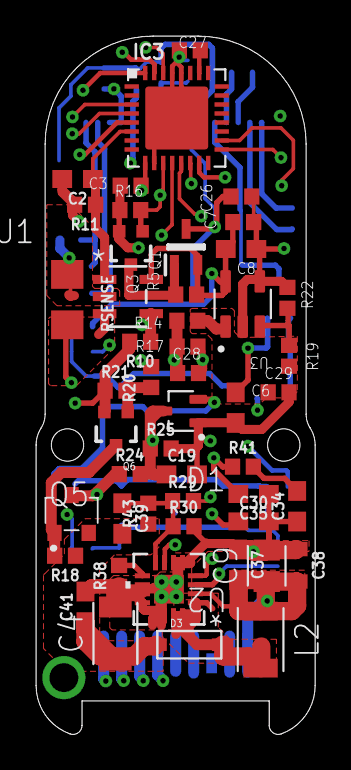
[picture p324: board Venus.brd from above]

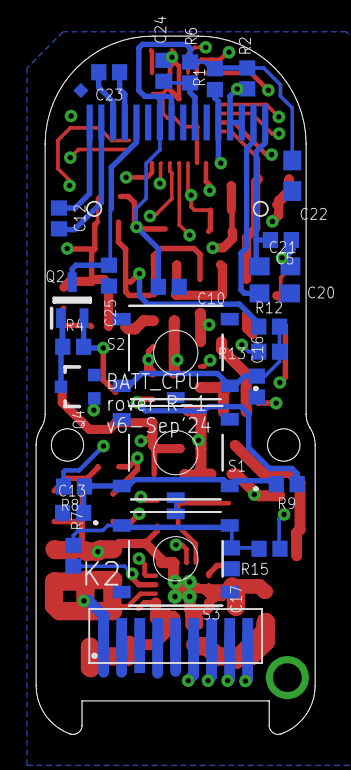
[picture p325: board Venus.brd from below]

Board: 4 copper layers, 15.5 x 38.8 mm, 79 parts (30 on the bottom side), 44 nets.
