MSTKMAD/battery-pack/02.HARDWARE/V3-Rover Venus/01-PCB/BATT_FLEX9/BATT_FLEX9.brd

## EAGLE design 02.HARDWARE/V3-Rover Venus/01-PCB/BATT_FLEX9/BATT_FLEX9.brd (2025-09-29)

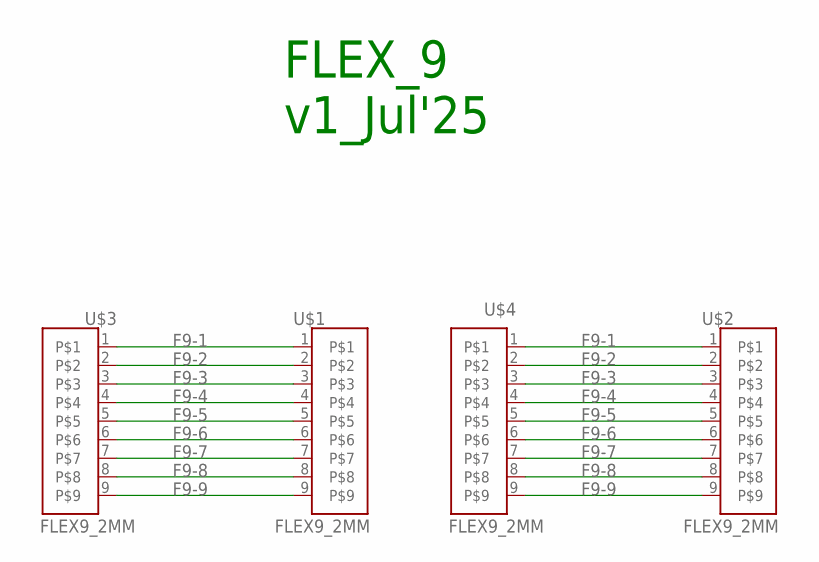
[picture p326: schematic BATT_FLEX9.sch]

Parts:
U$1, U$2, U$3, U$4: FLEX9_2MM

Connections:
F9-1: U$1.1, U$2.1, U$3.1, U$4.1
F9-2: U$1.2, U$2.2, U$3.2, U$4.2
F9-3: U$1.3, U$2.3, U$3.3, U$4.3
F9-4: U$1.4, U$2.4, U$3.4, U$4.4
F9-5: U$1.5, U$2.5, U$3.5, U$4.5
F9-6: U$1.6, U$2.6, U$3.6, U$4.6
F9-7: U$1.7, U$2.7, U$3.7, U$4.7
F9-8: U$1.8, U$2.8, U$3.8, U$4.8
F9-9: U$1.9, U$2.9, U$3.9, U$4.9

Notes on the sheet:
FLEX_9 v1_Jul'25

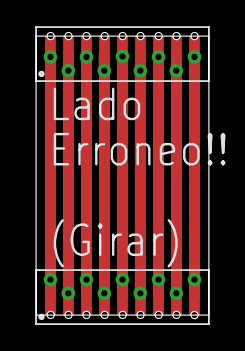
[picture p327: board BATT_FLEX9.brd from above]

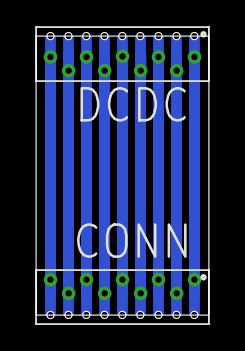
[picture p328: board BATT_FLEX9.brd from below]

Board: 2 copper layers, 9.6 x 15.5 mm, 4 parts (2 on the bottom side), 9 nets.
