MSTKMAD/battery-pack/02.HARDWARE/V3-Rover Venus/01-PCB/BATT-CONNECTOR/BATT_CONNECTOR.brd

## EAGLE design 02.HARDWARE/V3-Rover Venus/01-PCB/BATT-CONNECTOR/BATT_CONNECTOR.brd (2025-09-29)

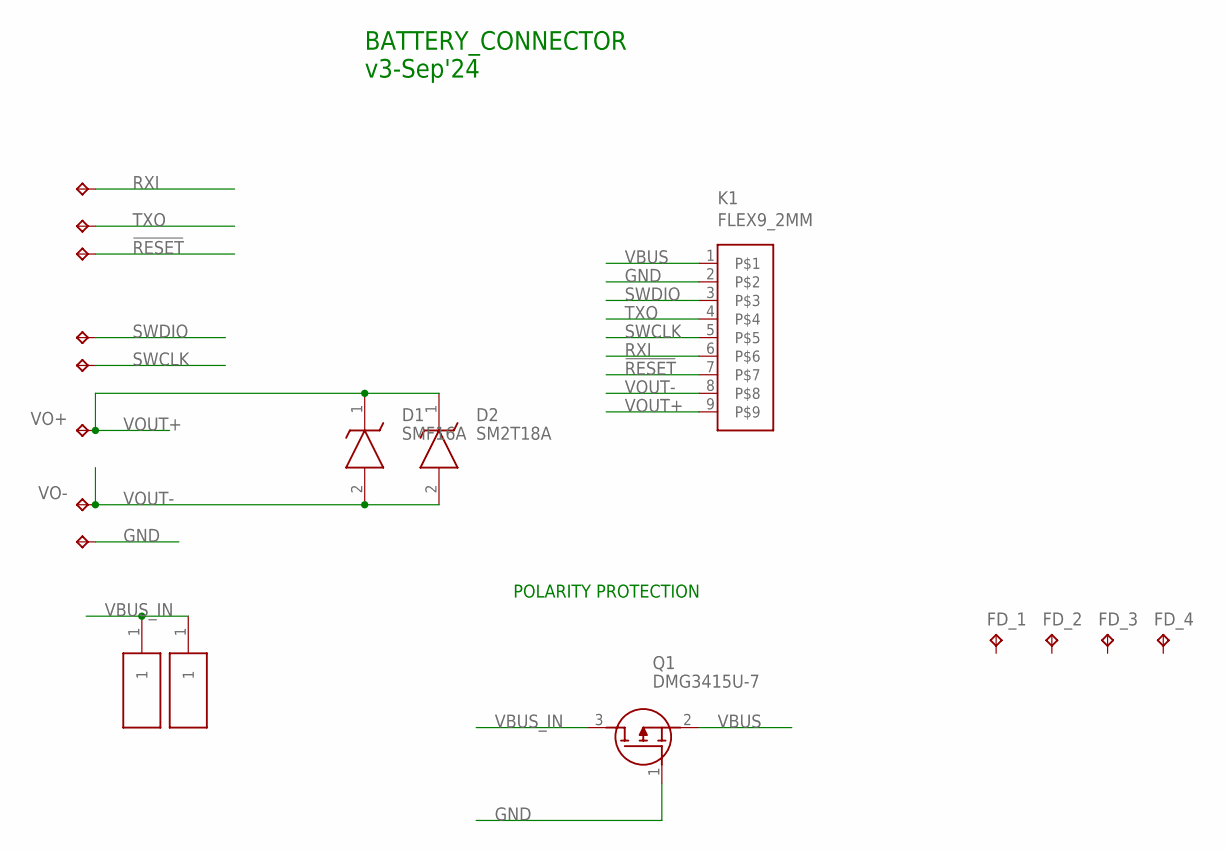
[picture p329: schematic BATT_CONNECTOR.sch]

Parts:
!RESET: TPB2,54; B2,54
D1: SMF16A; SODFL3618X110N
D2: SM2T18A
FD_1, FD_2, FD_3, FD_4: FD_1; TP06SQ
GND: TPB2,54; B2,54
H1, H2: S1761-42R; S176142R
K1: FLEX9_2MM
Q1: DMG3415U-7; SSM3J332RLFT
RXI: TPB2,54; B2,54
SWCLK: TPB2,54; B2,54
SWDIO: TPB2,54; B2,54
TXO: TPB2,54; B2,54
VO+: TPB2,54; B2,54
VO-: TPB2,54; B2,54

Connections:
!RESET: !RESET.TP, K1.7
GND: GND.TP, K1.2, Q1.1 (G)
RXI: K1.6, RXI.TP
SWCLK: K1.5, SWCLK.TP
SWDIO: K1.3, SWDIO.TP
TXO: K1.4, TXO.TP
VBUS: K1.1, Q1.2 (S)
VBUS_IN: H1.1, H2.1, Q1.3 (D)
VOUT+: D1.1 (K), D2.1 (K), K1.9, VO+.TP
VOUT-: D1.2 (A), D2.2 (A), K1.8, VO-.TP

Notes on the sheet:
POLARITY PROTECTION
BATTERY_CONNECTOR v3-Sep'24

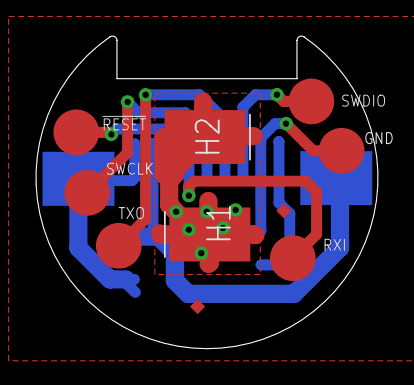
[picture p330: board 02.HARDWARE/V3-Rover Venus/01-PCB/BATT-CONNECTOR/BATT_CONNECTOR.brd from above]

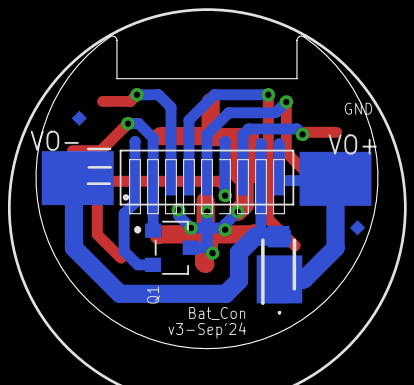
[picture p331: board 02.HARDWARE/V3-Rover Venus/01-PCB/BATT-CONNECTOR/BATT_CONNECTOR.brd from below]

Board: 4 copper layers, 19.0 x 17.4 mm, 18 parts (8 on the bottom side), 10 nets.
