MSTKMAD/battery-pack/02.HARDWARE/V3-Rover Venus/01-PCB/BATT_CPU/HISTORY/V1/BATT_CPU.brd

## EAGLE design 02.HARDWARE/V3-Rover Venus/01-PCB/BATT_CPU/HISTORY/V1/BATT_CPU.brd (2022-11-09, an earlier design)

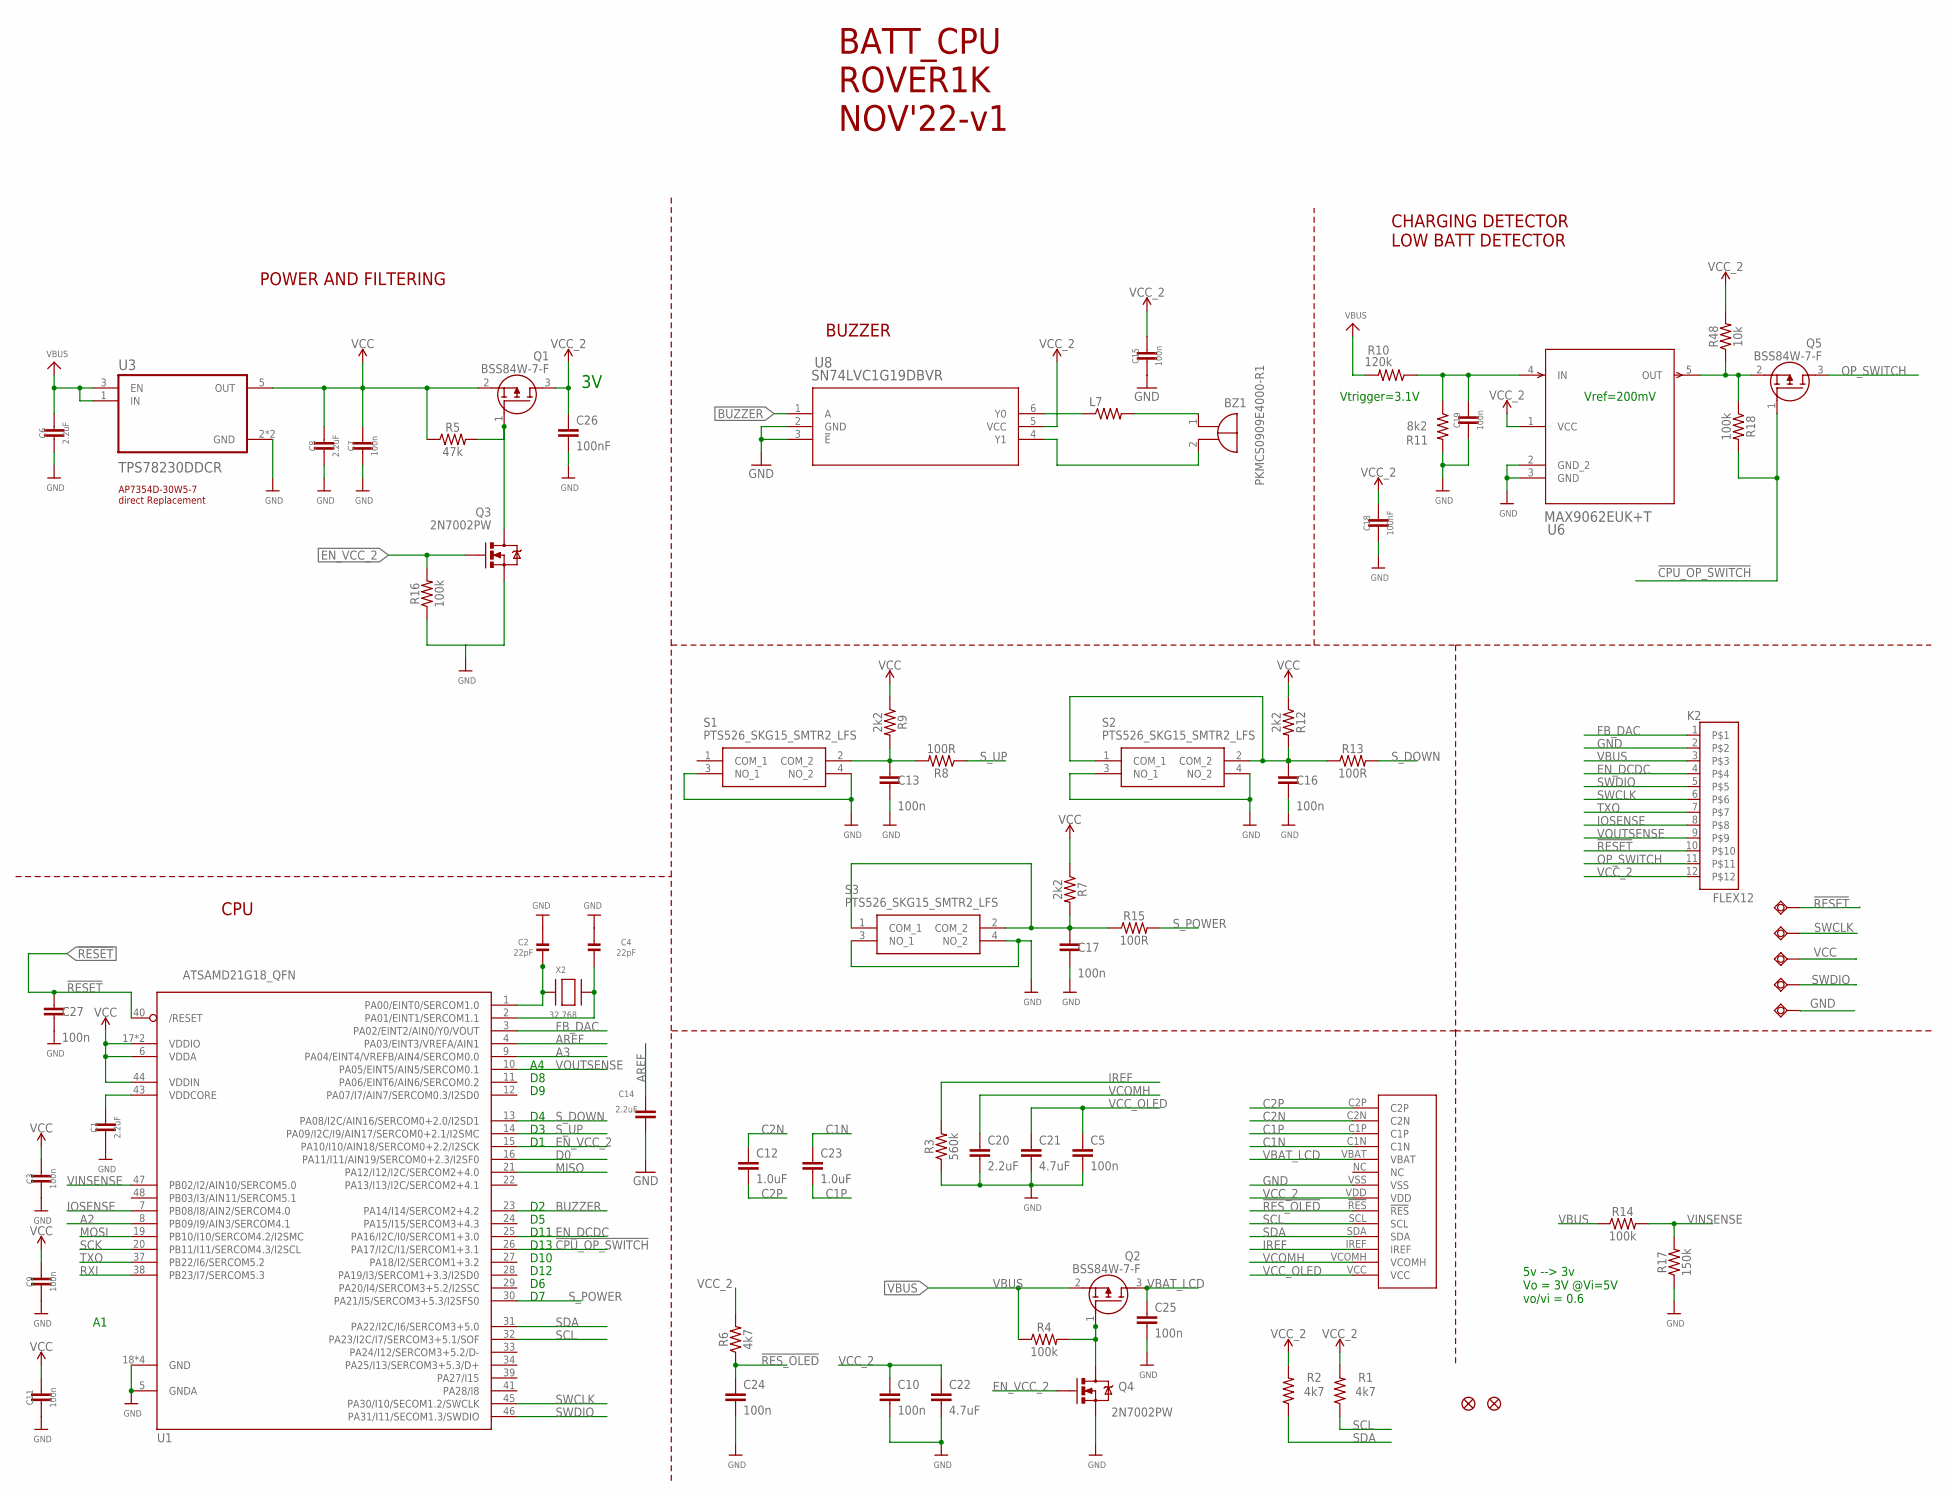
[picture p332: schematic BATT_CPU.sch]

Parts:
BZ1: PKMCS0909E4000-R1; PKMCS0909
C1, C6, C8, C14, C20: 2.2uF; 0603
C2, C4: 22pF; 0603-NO
C3, C5, C7, C9, C10, C11, C13, C15, C16, C17, C19, C24, C25, C27: 100n; 0402
C12, C23: 1.0uF; 0402
C18, C26: 100nF; 0402
C21, C22: 4.7uF; 0603
K2: FLEX12; FLEX6
L7: MMZ2012Y202BT000; 0805
Q1, Q2, Q5: BSS84W-7-F; SOT65P222X110-3N
Q3, Q4: 2N7002PW; SOT323
R1, R2, R6: 4k7; 0402
R3: 560k; 0402
R4, R14, R16, R18: 100k; 0402
R5: 47k; 0402
R7, R9, R12: 2k2; 0402
R8, R13, R15: 100R; 0402
R10: 120k; 0402
R11: 8k2; 0402
R17: 150k; 0402
R48: 10k; 0402
S1, S2, S3: PTS526_SKG15_SMTR2_LFS; PTS526SKG15SMTR2LFS
U1: ATSAMD21G18_QFN; TQFN48_7MM
U3: TPS78230DDCR; SOT95P280X110-5N
U6: MAX9062EUK+T; 21-0057F_MXM
U8: SN74LVC1G19DBVR; DBV6
U$30: 64X32_OLED_049; LCD_14_PINS
U$34, U$35: FIDUCIAL""; FIDUCIAL_1MM
VBUS, VBUS1, VBUS2, VBUS3, VBUS4: TESTPAD_TPSQB1,27; TESTPAD_B1,27
X2: 32.768; XTAL3215

Connections:
!CPU_OP_SWITCH: Q5.1 (G), R18.2, U1.26 (PA17/I2C/I1/SERCOM1+3.1)
!RESET: C27.1, K2.10, U1.40 (/RESET), VBUS1.TP
!RES_OLED: C24.1, R6.1, U$30.!RES
A2: U1.8 (PB09/I9/AIN3/SERCOM4.1)
A3: U1.9 (PA04/EINT4/VREFB/AIN4/SERCOM0.0)
AREF: C14.1, U1.4 (PA03/EINT3/VREFA/AIN1)
BUZZER: U1.23 (PA14/I14/SERCOM2+4.2), U8.1 (A)
C1N: C23.1, U$30.C1N
C1P: C23.2, U$30.C1P
C2N: C12.1, U$30.C2N
C2P: C12.2, U$30.C2P
D0: U1.16 (PA11/I11/AIN19/SERCOM0+2.3/I2SF0)
EN_DCDC: K2.4, U1.25 (PA16/I2C/I0/SERCOM1+3.0)
EN_VCC_2: Q3.1 (G), Q4.1 (G), R16.2, U1.15 (PA10/I10/AIN18/SERCOM0+2.2/I2SCK)
FB_DAC: K2.1, U1.3 (PA02/EINT2/AIN0/Y0/VOUT)
GND: C1.2, C2.2, C3.2, C4.2, C5.2, C6.2, C7.2, C8.2, C9.2, C10.2, C11.2, C13.2, C14.2, C15.2, C16.2, C17.2, C18.2, C19.2, C20.2, C21.2, C22.2, C24.2, C25.2, C26.2, C27.2, K2.2, Q3.2 (S), Q4.2 (S), R3.1, R11.2, R16.1, R17.1, S1.3 (NO_1), S1.4 (NO_2), S2.3 (NO_1), S2.4 (NO_2), S3.3 (NO_1), S3.4 (NO_2), U1.5 (GNDA), U1.18 (GND), U1.35 (GND), U1.42 (GND), U1.THERMAL (GND), U3.2 (GND), U3.4 (GND), U6.2 (GND_2), U6.3 (GND), U8.2 (GND), U8.3 (!E), U$30.VSS, VBUS4.TP
IOSENSE: K2.8, U1.7 (PB08/I8/AIN2/SERCOM4.0)
IREF: R3.2, U$30.IREF
MISO: U1.21 (PA12/I12/I2C/SERCOM2+4.0)
MOSI: U1.19 (PB10/I10/SERCOM4.2/I2SMC)
unnamed: C17.1, R7.2, R15.1, S3.1 (COM_1), S3.2 (COM_2)
unnamed: C13.1, R8.2, R9.2, S1.2 (COM_2)
unnamed: C16.1, R12.2, R13.1, S2.1 (COM_1), S2.2 (COM_2)
unnamed: Q2.1 (G), Q4.3 (D), R4.2
unnamed: C2.1, U1.1 (PA00/EINT0/SERCOM1.0), X2.P$1
unnamed: Q1.1 (G), Q3.3 (D), R5.2
unnamed: C4.1, U1.2 (PA01/EINT1/SERCOM1.1), X2.P$2
unnamed: C19.1, R10.1, R11.1, U6.4 (IN)
unnamed: Q5.2 (S), R18.1, R48.1, U6.5 (OUT)
unnamed: L7.1, U8.6 (Y0)
unnamed: BZ1.1 (+), L7.2
unnamed: BZ1.2 (-), U8.4 (Y1)
OP_SWITCH: K2.11, Q5.3 (D)
RXI: U1.38 (PB23/I7/SERCOM5.3)
SCK: U1.20 (PB11/I11/SERCOM4.3/I2SCL)
SCL: R1.1, U1.32 (PA23/I2C/I7/SERCOM3+5.1/SOF), U$30.SCL
SDA: R2.1, U1.31 (PA22/I2C/I6/SERCOM3+5.0), U$30.SDA
SWCLK: K2.6, U1.45 (PA30/I10/SECOM1.2/SWCLK), VBUS2.TP
SWDIO: K2.5, U1.46 (PA31/I11/SECOM1.3/SWDIO), VBUS3.TP
S_DOWN: R13.2, U1.13 (PA08/I2C/AIN16/SERCOM0+2.0/I2SD1)
S_POWER: R15.2, U1.30 (PA21/I5/SERCOM3+5.3/I2SFS0)
S_UP: R8.1, U1.14 (PA09/I2C/I9/AIN17/SERCOM0+2.1/I2SMC)
TXO: K2.7, U1.37 (PB22/I6/SERCOM5.2)
VBAT_LCD: C25.1, Q2.3 (D), U$30.VBAT
VBUS: C6.1, K2.3, Q2.2 (S), R4.1, R10.2, R14.1, U3.1 (IN), U3.3 (EN)
VCC: C3.1, C7.1, C8.1, C9.1, C11.1, Q1.2 (S), R5.1, R7.1, R9.1, R12.1, R48.2, U1.6 (VDDA), U1.17 (VDDIO), U1.36 (VDDIO), U1.44 (VDDIN), U3.5 (OUT), VBUS.TP
VCC_2: C10.1, C15.1, C18.1, C22.1, C26.1, K2.12, Q1.3 (D), R1.2, R2.2, R6.2, U6.1 (VCC), U8.5 (VCC), U$30.VDD
VCC_OLED: C5.1, C21.1, U$30.VCC
VCOMH: C20.1, U$30.VCOMH
VDDCORE: C1.1, U1.43 (VDDCORE)
VINSENSE: R14.2, R17.2, U1.47 (PB02/I2/AIN10/SERCOM5.0)
VOUTSENSE: K2.9, U1.10 (PA05/EINT5/AIN5/SERCOM0.1)

Notes on the sheet:
POWER AND FILTERING
BUZZER
AP7354D-30W5-7 direct Replacement
D10
CHARGING DETECTOR LOW BATT DETECTOR
CPU
Vref=200mV
Vtrigger=3.1V
D13
D11
D12
5v --> 3v Vo = 3V @Vi=5V vo/vi = 0.6
BATT_CPU ROVER1K NOV'22-v1

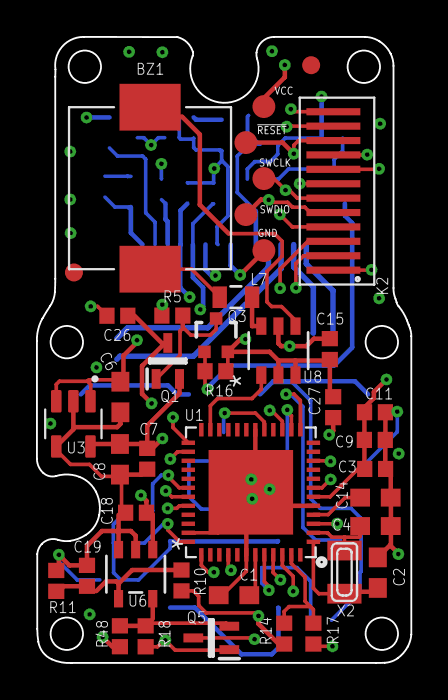
[picture p333: board BATT_CPU.brd from above]

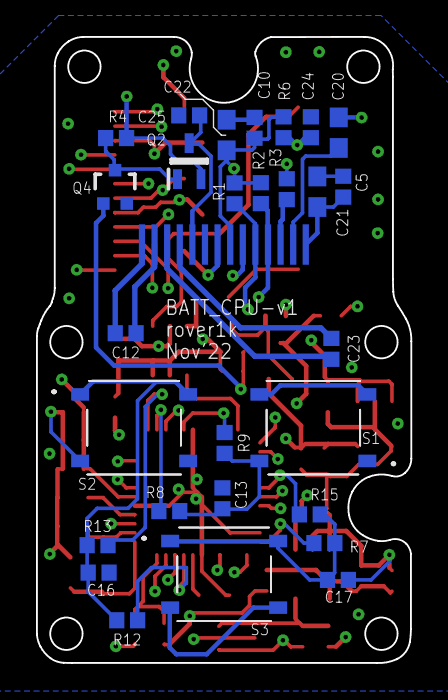
[picture p334: board BATT_CPU.brd from below]

Board: 4 copper layers, 20.8 x 34.8 mm, 70 parts (29 on the bottom side), 45 nets.
