MSTKMAD/battery-pack/02.HARDWARE/V3-Rover Venus/01-PCB/BATT_DCDC/HISTORY/V1/BATT_DCDC.brd

## EAGLE design 02.HARDWARE/V3-Rover Venus/01-PCB/BATT_DCDC/HISTORY/V1/BATT_DCDC.brd (2022-11-08, an earlier design)

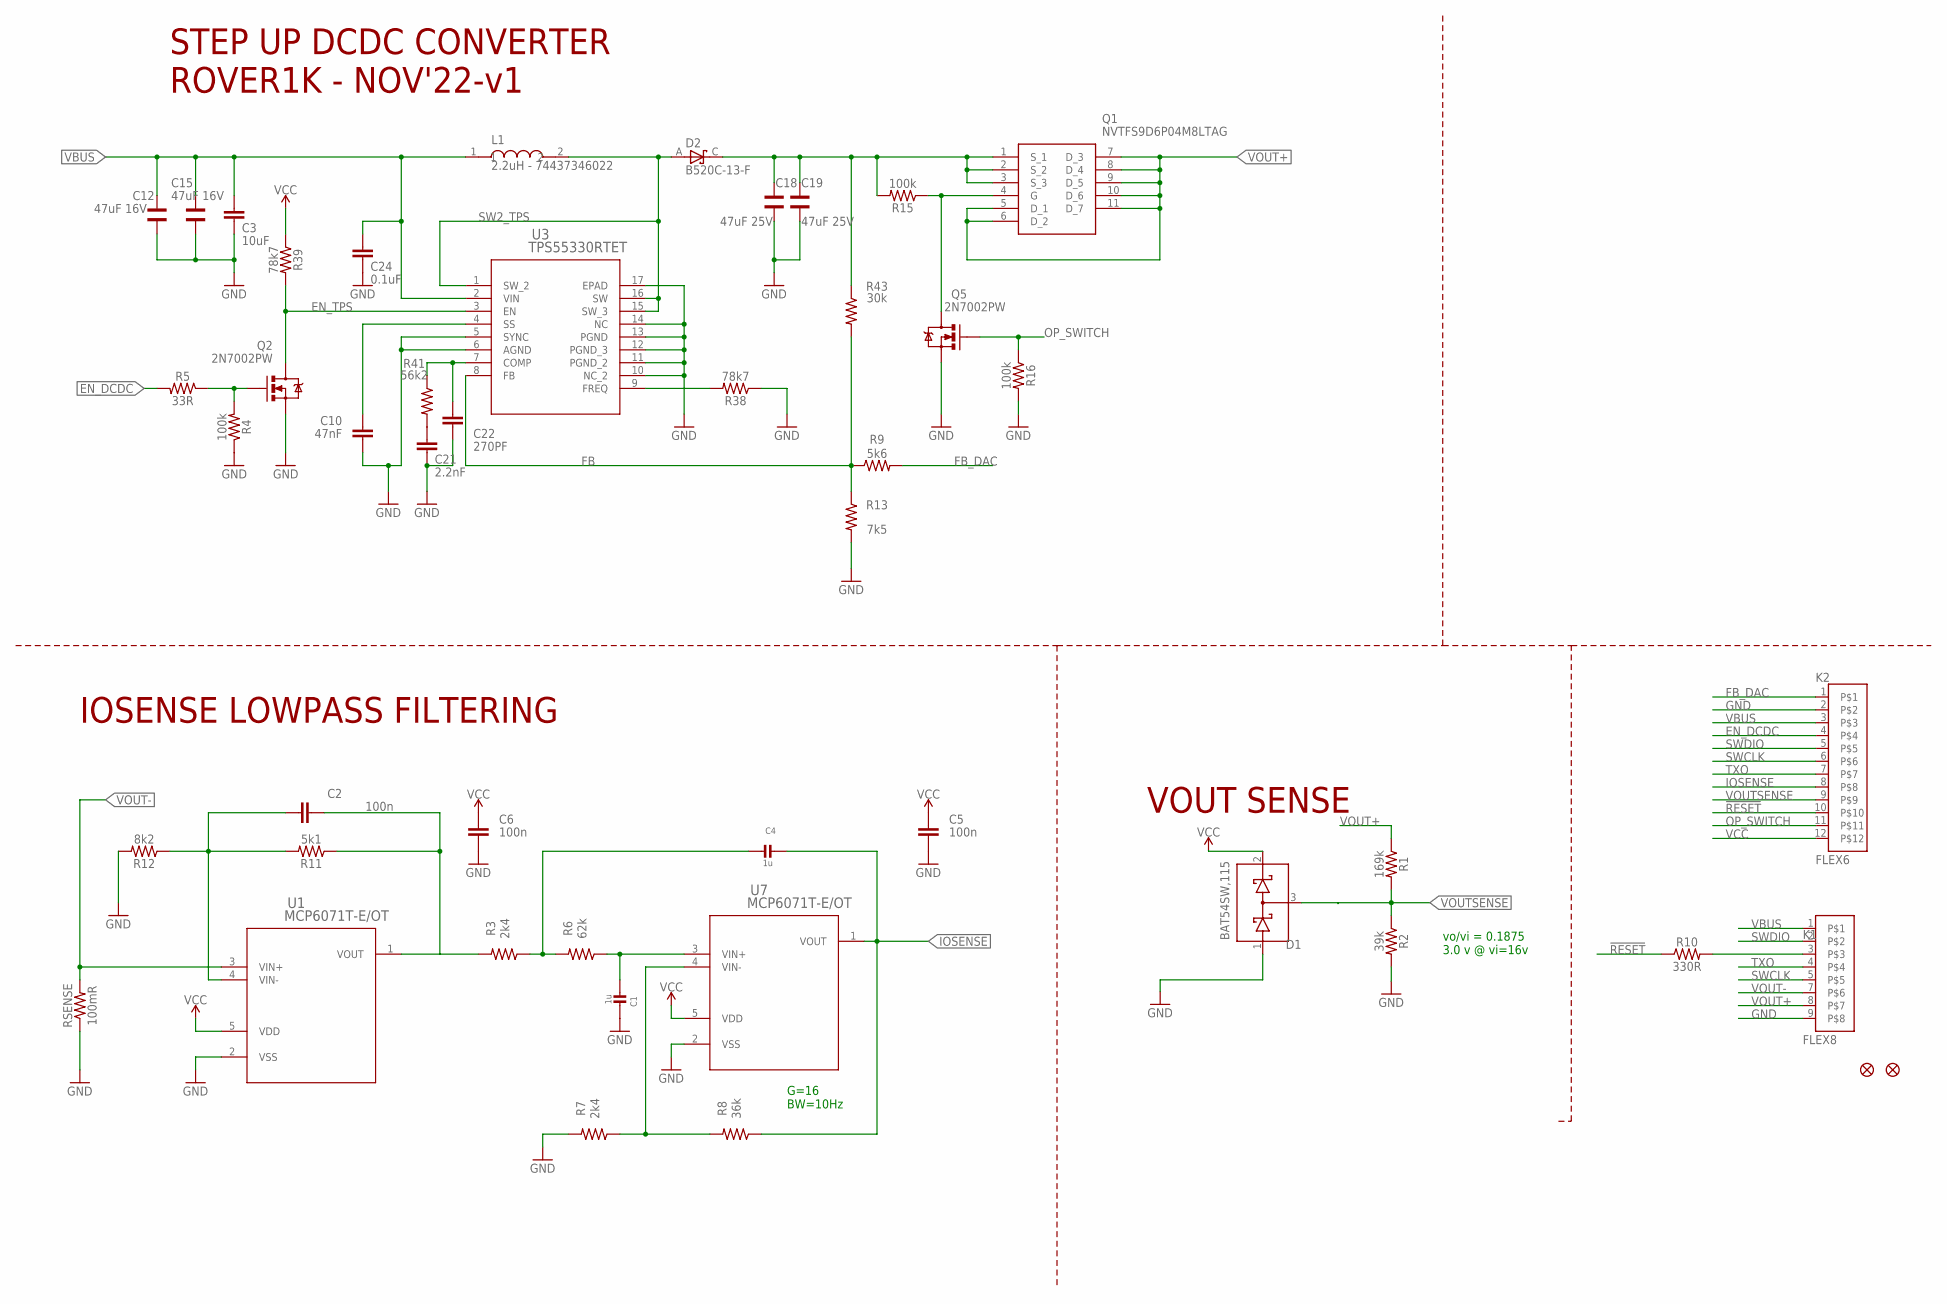
[picture p335: schematic BATT_DCDC.sch]

Parts:
C1, C4: 1u; 0603-NO
C2, C5, C6: 100n; 0603
C3: 10uF; 0805
C10: 47nF; 0603
C12, C15: 47uF 16V; WCAP-CSGP_1210
C18, C19: 47uF 25V; WCAP-CSGP_1210
C21: 2.2nF; 0603
C22: 270PF; 0603
C24: 0.1uF; 0603
D1: BAT54SW,115; SOT65P210X110-3N
D2: B520C-13-F; DIOM7959X250N
K1: FLEX8
K2: FLEX6
L1: 2.2uH - 74437346022; INDM7366X500
Q1: NVTFS9D6P04M8LTAG; NVTFS5124PLTWG
Q2, Q5: 2N7002PW; SOT323
R1: 169k; 0402
R2: 39k; 0402
R3, R7: 2k4; 0603
R4, R15, R16: 100k; 0402
R5: 33R; 0402
R6: 62k; 0603
R8: 36k; 0603
R9: 5k6; 0402
R10: 330R; 0402
R11: 5k1; 0402
R12: 8k2; 0402
R13: 7k5; 0402
R38, R39: 78k7; 0402
R41: 56k2; 0402
R43: 30k; 0402
RSENSE: 100mR; 0603
U1, U7: MCP6071T-E/OT; SOT-23-5_MC_MCH
U3: TPS55330RTET; RTE16_1P66X1P66_TEX
U$1, U$2: FIDUCIAL""; FIDUCIAL_1MM

Connections:
!RESET: K2.10, R10.1
COMP_TPS: C22.2, R41.1, U3.7 (COMP)
EN_DCDC: K2.4, R5.2
EN_TPS: Q2.3 (D), R39.2, U3.3 (EN)
FB: R9.1, R13.1, R43.2, U3.8 (FB)
FB_DAC: K2.1, R9.2
FREQ_TPS: R38.2, U3.9 (FREQ)
GND: C1.2, C3.1, C5.2, C6.2, C10.2, C12.1, C15.1, C18.1, C19.1, C21.1, C22.1, C24.1, D1.1 (A), K1.9, K2.2, Q2.2 (S), Q5.2 (S), R2.2, R4.1, R7.2, R12.2, R13.2, R16.2, R38.1, RSENSE.1, U1.2 (VSS), U3.5 (SYNC), U3.6 (AGND), U3.10 (NC_2), U3.11 (PGND_2), U3.12 (PGND_3), U3.13 (PGND), U3.14 (NC), U3.17 (EPAD), U7.2 (VSS)
IOSENSE: C4.2, K2.8, R8.1, U7.1 (VOUT)
ISENSE_RAW: C2.1, R3.2, R11.1, U1.1 (VOUT)
unnamed: C2.2, R11.2, R12.1, U1.4 (VIN-)
unnamed: R7.1, R8.2, U7.4 (VIN-)
unnamed: C4.1, R3.1, R6.2
unnamed: Q2.1 (G), R4.2, R5.1
unnamed: C1.1, R6.1, U7.3 (VIN+)
unnamed: K1.3, R10.2
unnamed: Q1.4 (G), Q5.3 (D), R15.1
unnamed: C10.1, U3.4 (SS)
unnamed: C21.2, R41.2
OP_SWITCH: K2.11, Q5.1 (G), R16.1
SW2_TPS: D2.A, L1.2, U3.1 (SW_2), U3.15 (SW_3), U3.16 (SW)
SWCLK: K1.5, K2.6
SWDIO: K1.2, K2.5
TXO: K1.4, K2.7
VBUS: C3.2, C12.2, C15.2, C24.2, K1.1, K2.3, L1.1, U3.2 (VIN)
VCC: C5.1, C6.1, D1.2 (C), K2.12, R39.1, U1.5 (VDD), U7.5 (VDD)
VOUT+: K1.8, Q1.5 (D_1), Q1.6 (D_2), Q1.7 (D_3), Q1.8 (D_4), Q1.9 (D_5), Q1.10 (D_6), Q1.11 (D_7), R1.1
VOUT-: K1.7, RSENSE.2, U1.3 (VIN+)
VOUTSENSE: D1.3 (A-C), K2.9, R1.2, R2.1
VSOURCE: C18.2, C19.2, D2.C, Q1.1 (S_1), Q1.2 (S_2), Q1.3 (S_3), R15.2, R43.1

Notes on the sheet:
vo/vi = 0.1875 3.0 v @ vi=16v
VOUT SENSE
G=16 BW=10Hz
IOSENSE LOWPASS FILTERING
STEP UP DCDC CONVERTER ROVER1K - NOV'22-v1

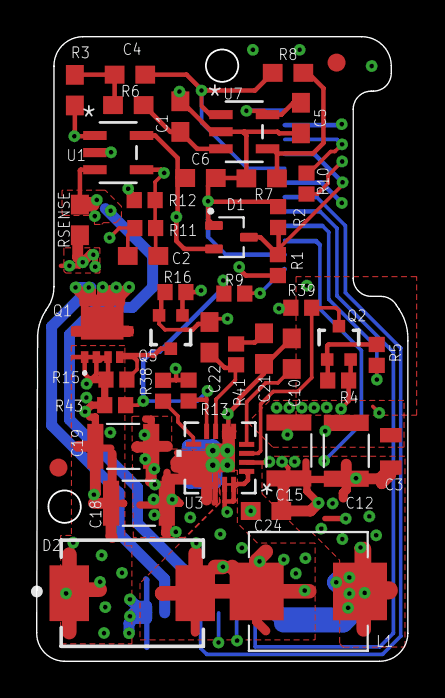
[picture p336: board BATT_DCDC.brd from above]

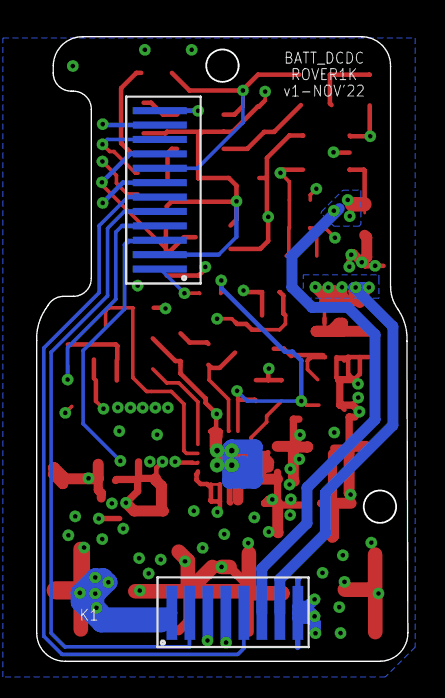
[picture p337: board BATT_DCDC.brd from below]

Board: 4 copper layers, 20.6 x 34.7 mm, 47 parts (2 on the bottom side), 30 nets.
