MSTKMAD/battery-pack/02.HARDWARE/V2-ROVER R-1/05.CLIPCORD/Testboard cables/Testboard_Cables.brd

## EAGLE design 02.HARDWARE/V2-ROVER R-1/05.CLIPCORD/Testboard cables/Testboard_Cables.brd (2025-02-12)

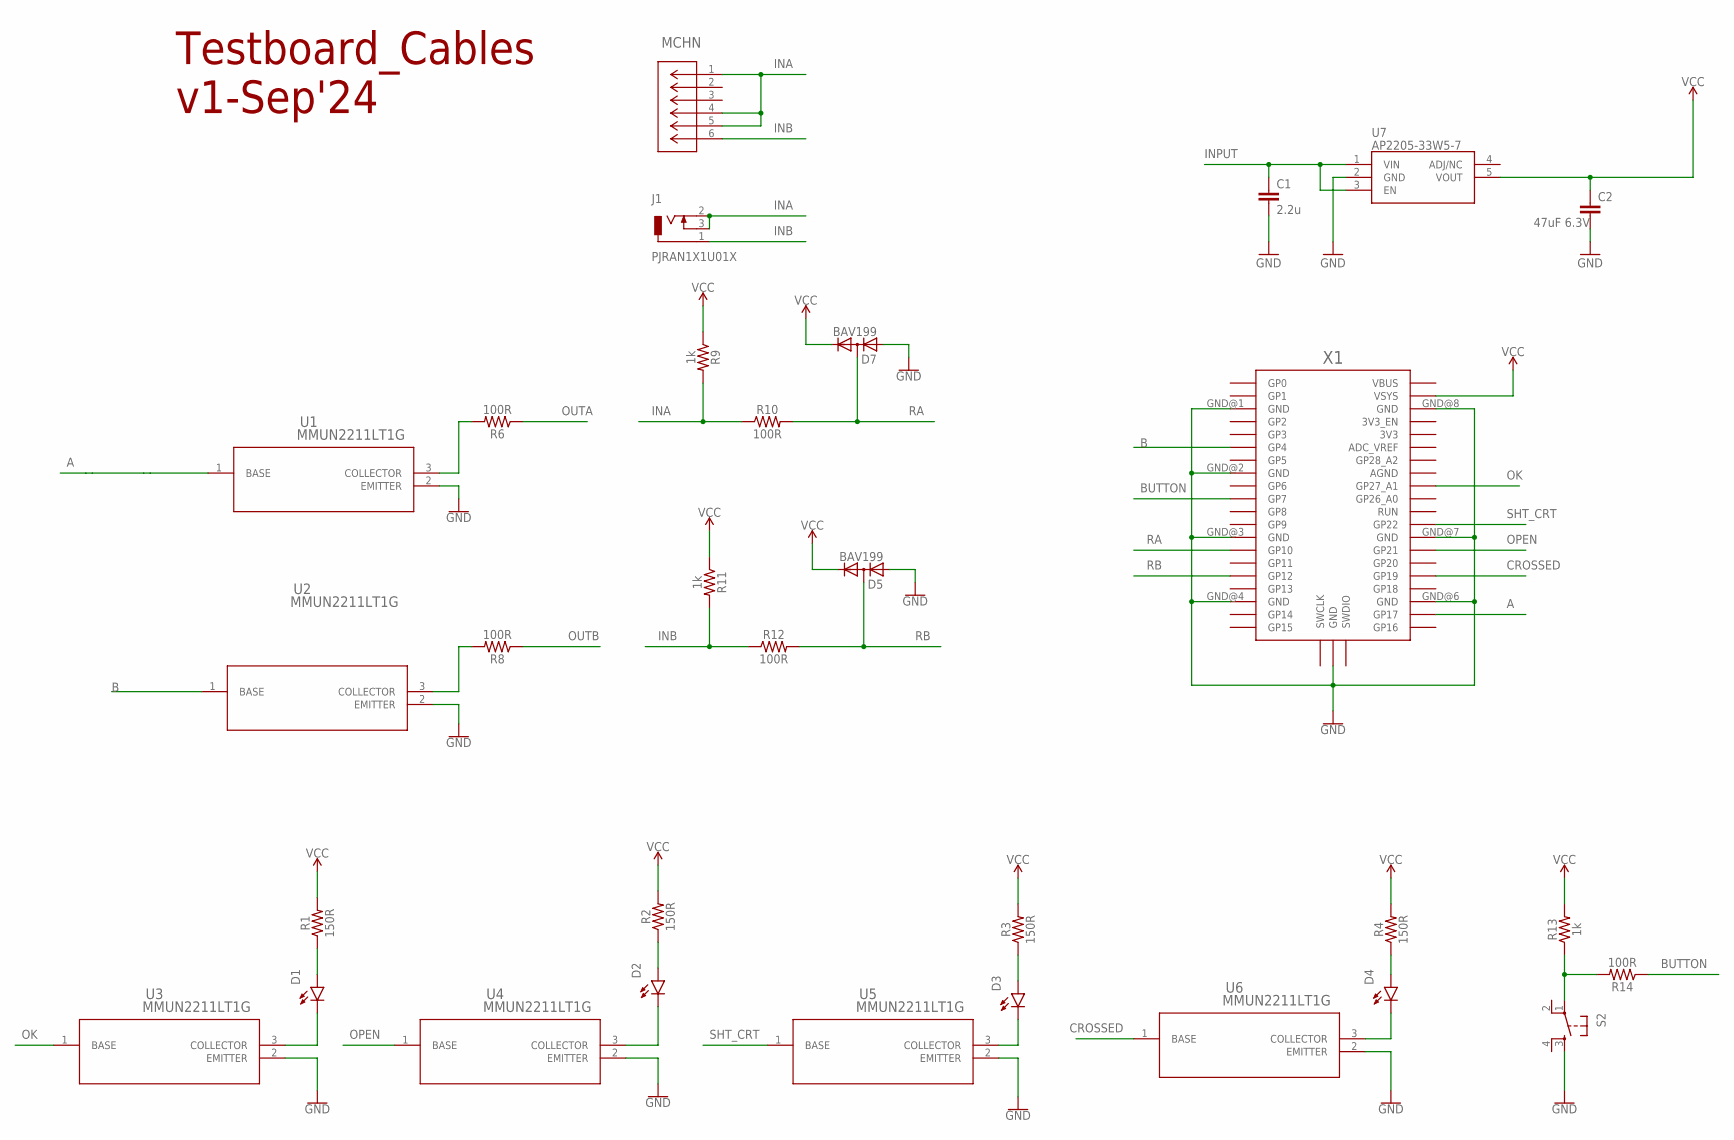
[picture p338: schematic Testboard_Cables.sch]

Parts:
C1: 2.2u; 0603-CAP
C2: 47uF 6.3V; 0603-CAP
D1, D2, D3, D4: LED3MM; LED_3MM
D5, D7: BAV199; SOT23
J1: PJRAN1X1U01X
MCHN: ACJS-MHDR; CONN_MHDR_AMP
R1, R2, R3, R4: 150R; 1206
R6, R8, R10, R12, R14: 100R; 1206
R9, R11, R13: 1k; 1206
S2: TAC_SWITCH_KSC931G-SMD; TAC_SW_SMD_KSC931G
U1, U2, U3, U4, U5, U6: MMUN2211LT1G; SOT-23-3_1P4X3P040_ONS
U7: AP2205-33W5-7; SOT95P282X145-5N
X1: RPI_PICO_IG-TH; RPI_PICO_TH

Connections:
A: U1.1 (BASE), X1.GP17
B: U2.1 (BASE), X1.GP4
BUTTON: R14.1, X1.GP7
CROSSED: U6.1 (BASE), X1.GP19
GND: C1.2, C2.2, D5.1 (A), D7.1 (A), S2.3, U1.2 (EMITTER), U2.2 (EMITTER), U3.2 (EMITTER), U4.2 (EMITTER), U5.2 (EMITTER), U6.2 (EMITTER), U7.2 (GND), X1.GND@1 (GND), X1.GND@2 (GND), X1.GND@3 (GND), X1.GND@4 (GND), X1.GND@5 (GND), X1.GND@6 (GND), X1.GND@7 (GND), X1.GND@8 (GND)
INA: J1.2, J1.3, MCHN.1, MCHN.4, MCHN.5, R9.2, R10.1
INB: J1.1, MCHN.6, R11.2, R12.1
INPUT: C1.1, U7.1 (VIN), U7.3 (EN)
unnamed: D1.K (C), U3.3 (COLLECTOR)
unnamed: D1.A, R1.1
unnamed: R13.1, R14.2, S2.1
unnamed: D2.K (C), U4.3 (COLLECTOR)
unnamed: D2.A, R2.1
unnamed: D3.K (C), U5.3 (COLLECTOR)
unnamed: D3.A, R3.1
unnamed: D4.K (C), U6.3 (COLLECTOR)
unnamed: D4.A, R4.1
unnamed: R6.2, U1.3 (COLLECTOR)
unnamed: R8.2, U2.3 (COLLECTOR)
OK: U3.1 (BASE), X1.GP27_A1
OPEN: U4.1 (BASE), X1.GP21
OUTA: R6.1
OUTB: R8.1
RA: D7.3 (AC), R10.2, X1.GP10
RB: D5.3 (AC), R12.2, X1.GP12
SHT_CRT: U5.1 (BASE), X1.GP22
VCC: C2.1, D5.2 (C), D7.2 (C), R1.2, R2.2, R3.2, R4.2, R9.1, R11.1, R13.2, U7.5 (VOUT), X1.VSYS

Notes on the sheet:
Testboard_Cables v1-Sep'24

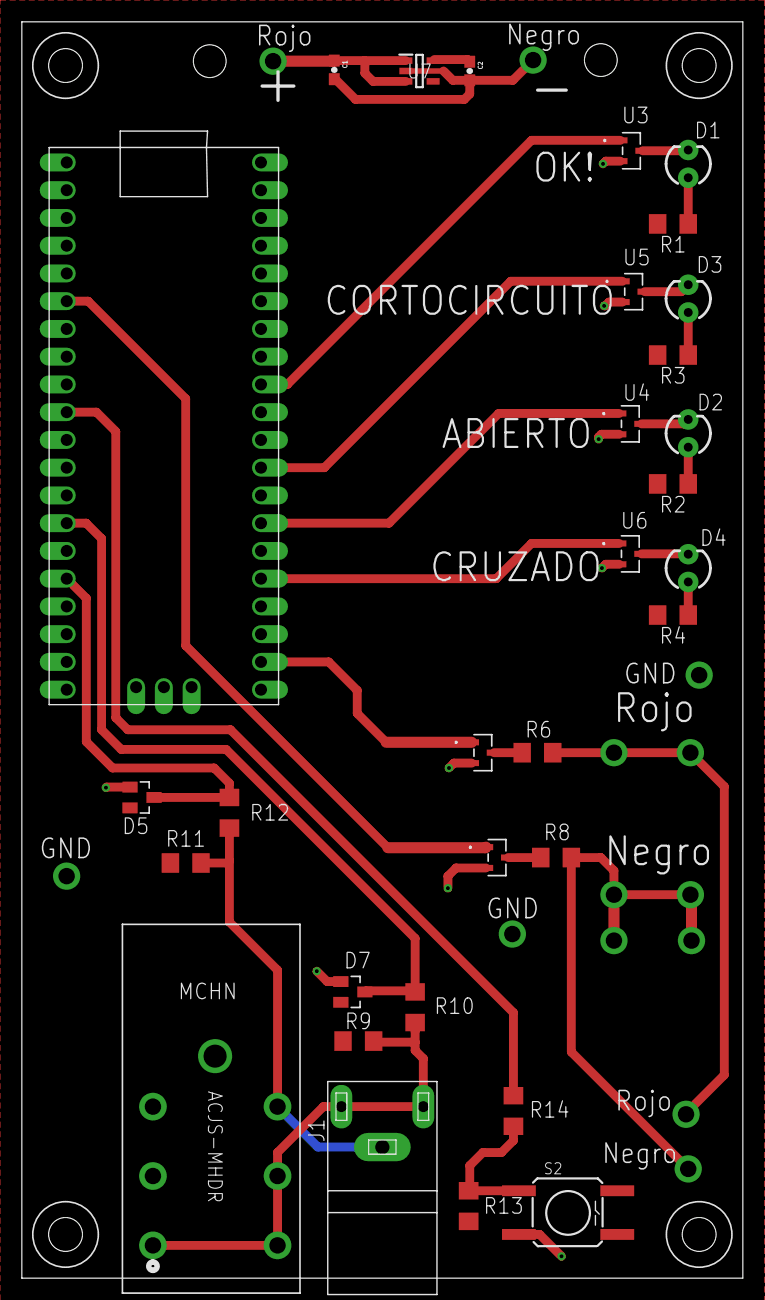
[picture p339: board Testboard_Cables.brd from above]

Board: 2 copper layers, 66.0 x 115.0 mm, 31 parts (0 on the bottom side), 25 nets.
