MSTKMAD/battery-pack/02.HARDWARE/V2-ROVER R-1/04.PRODUCCION/SETI-BATCH-5_OCT2024/04-EAGLE_FILES/BATT_CONNECTOR.brd

## EAGLE design 02.HARDWARE/V2-ROVER R-1/04.PRODUCCION/SETI-BATCH-5_OCT2024/04-EAGLE_FILES/BATT_CONNECTOR.brd (2025-02-12)

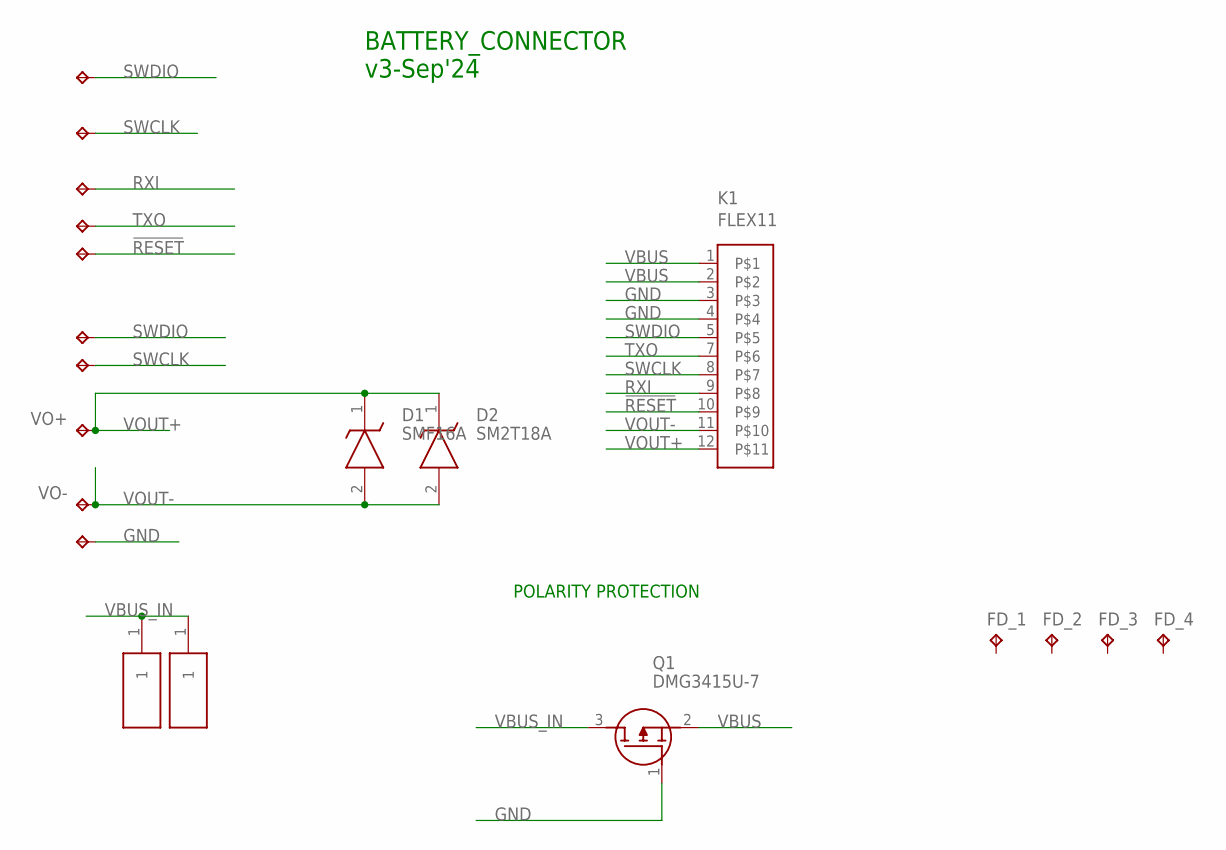
[picture p340: schematic BATT_CONNECTOR.sch]

Parts:
!RESET: TPB2,54; B2,54
D1: SMF16A; SODFL3618X110N
D2: SM2T18A
DAT: TPB2,54; B2,54
FD_1, FD_2, FD_3, FD_4: FD_1; TP06SQ
GND: TPB2,54; B2,54
H1, H2: S1761-42R; S176142R
ID: TPB2,54; B2,54
K1: FLEX11
Q1: DMG3415U-7; SSM3J332RLFT
RXI: TPB2,54; B2,54
SWCLK: TPB2,54; B2,54
SWDIO: TPB2,54; B2,54
TXO: TPB2,54; B2,54
VO+: TPB2,54; B2,54
VO-: TPB2,54; B2,54

Connections:
!RESET: !RESET.TP, K1.10
GND: GND.TP, K1.3, K1.4, Q1.1 (G)
RXI: K1.9, RXI.TP
SWCLK: ID.TP, K1.8, SWCLK.TP
SWDIO: DAT.TP, K1.5, SWDIO.TP
TXO: K1.7, TXO.TP
VBUS: K1.1, K1.2, Q1.2 (S)
VBUS_IN: H1.1, H2.1, Q1.3 (D)
VOUT+: D1.1 (K), D2.1 (K), K1.12, VO+.TP
VOUT-: D1.2 (A), D2.2 (A), K1.11, VO-.TP

Notes on the sheet:
POLARITY PROTECTION
BATTERY_CONNECTOR v3-Sep'24

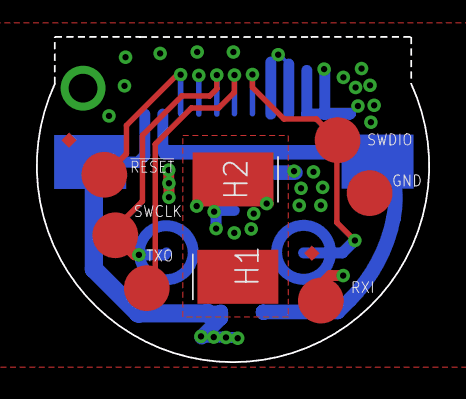
[picture p341: board 02.HARDWARE/V2-ROVER R-1/04.PRODUCCION/SETI-BATCH-5_OCT2024/04-EAGLE_… from above]

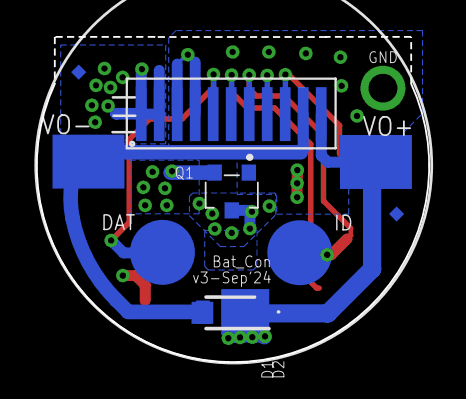
[picture p342: board 02.HARDWARE/V2-ROVER R-1/04.PRODUCCION/SETI-BATCH-5_OCT2024/04-EAGLE_… from below]

Board: 4 copper layers, 21.8 x 18.1 mm, 20 parts (10 on the bottom side), 10 nets.
