MSTKMAD/battery-pack/02.HARDWARE/V2-ROVER R-1/03.TESTBOARDS/POGO_DCDC/POGO_DCDC.brd

## EAGLE design 02.HARDWARE/V2-ROVER R-1/03.TESTBOARDS/POGO_DCDC/POGO_DCDC.brd (2023-02-27, an earlier design)

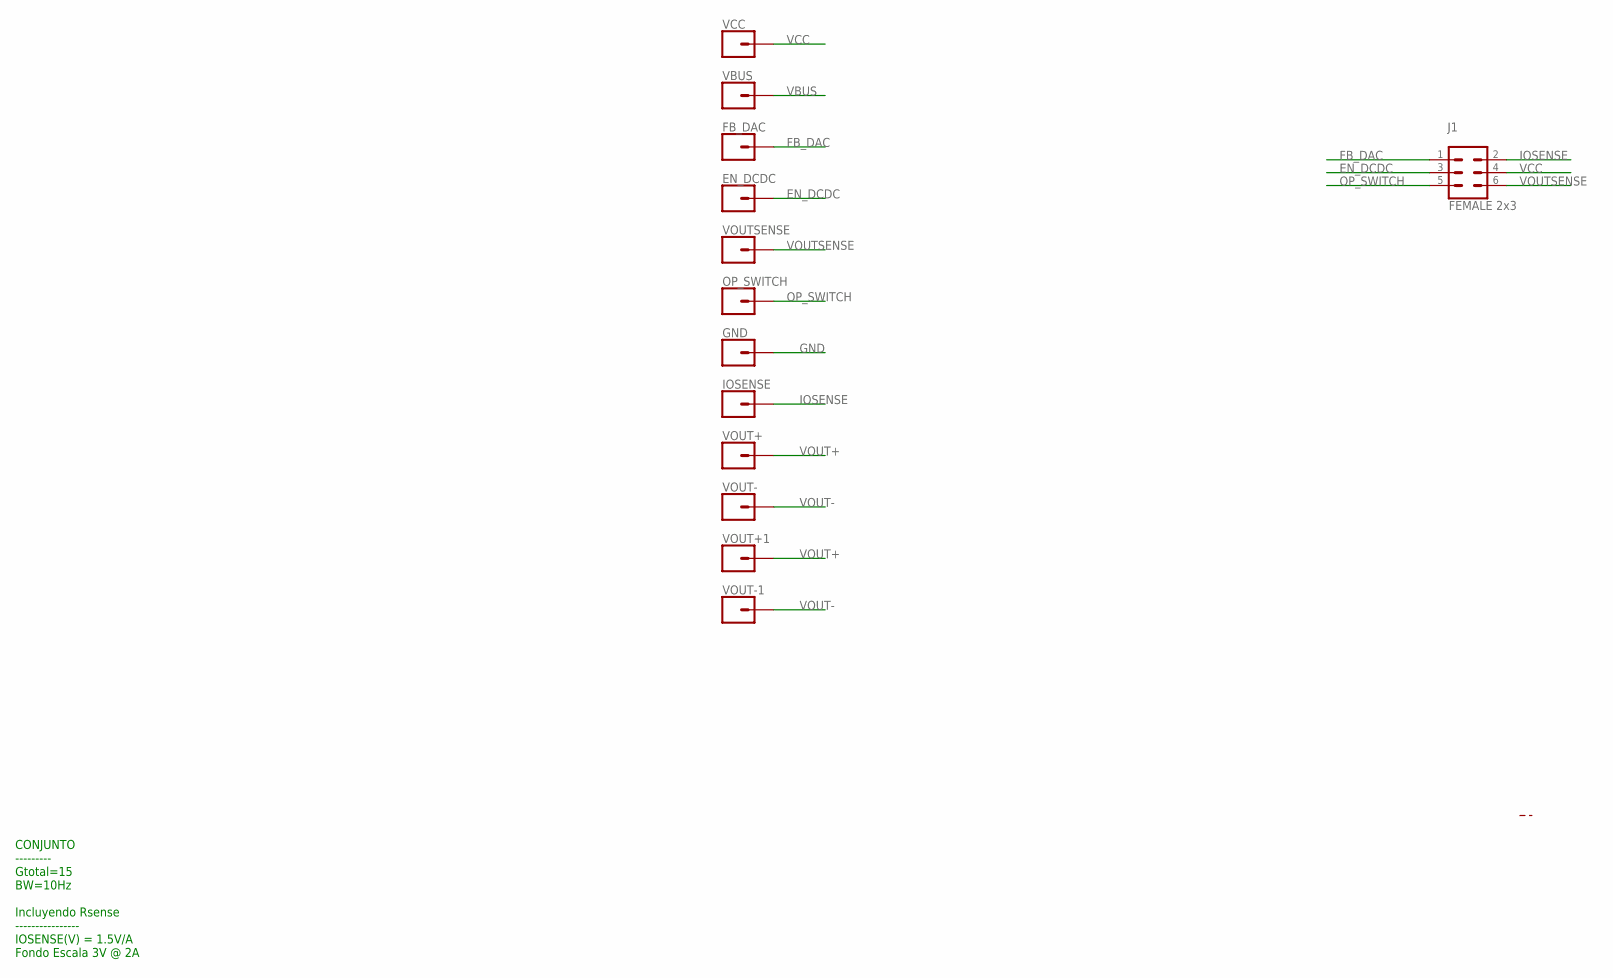
[picture p343: schematic POGO_DCDC.sch]

Parts:
EN_DCDC: CONN_01POGOPIN_HOLE_LARGE; 1X01_POGOPIN_HOLE_0.061_DIA
FB_DAC: CONN_01POGOPIN_HOLE_LARGE; 1X01_POGOPIN_HOLE_0.061_DIA
GND: CONN_01POGOPIN_HOLE_LARGE; 1X01_POGOPIN_HOLE_0.061_DIA
IOSENSE: CONN_01POGOPIN_HOLE_LARGE; 1X01_POGOPIN_HOLE_0.061_DIA
J1: FEMALE 2x3; 2X3
OP_SWITCH: CONN_01POGOPIN_HOLE_LARGE; 1X01_POGOPIN_HOLE_0.061_DIA
VBUS: CONN_01POGOPIN_HOLE_LARGE; 1X01_POGOPIN_HOLE_0.061_DIA
VCC: CONN_01POGOPIN_HOLE_LARGE; 1X01_POGOPIN_HOLE_0.061_DIA
VOUT+, VOUT+1: CONN_01POGOPIN_HOLE_LARGE; 1X01_POGOPIN_HOLE_0.061_DIA
VOUT-, VOUT-1: CONN_01POGOPIN_HOLE_LARGE; 1X01_POGOPIN_HOLE_0.061_DIA
VOUTSENSE: CONN_01POGOPIN_HOLE_LARGE; 1X01_POGOPIN_HOLE_0.061_DIA

Connections:
EN_DCDC: EN_DCDC.2, J1.3
FB_DAC: FB_DAC.2, J1.1
GND: GND.2
IOSENSE: IOSENSE.2, J1.2
OP_SWITCH: J1.5, OP_SWITCH.2
VBUS: VBUS.2
VCC: J1.4, VCC.2
VOUT+: VOUT+.2, VOUT+1.2
VOUT-: VOUT-.2, VOUT-1.2
VOUTSENSE: J1.6, VOUTSENSE.2

Notes on the sheet:
CONJUNTO --------- Gtotal=15 BW=10Hz Incluyendo Rsense ---------------- IOSENSE(V) = 1.5V/A Fondo Escala 3V @ 2A
