MSTKMAD/battery-pack/02.HARDWARE/V2-ROVER R-1/03.TESTBOARDS/POGO_DCDC/POGO_DCDC.brd

## EAGLE design 02.HARDWARE/V2-ROVER R-1/03.TESTBOARDS/POGO_DCDC/POGO_DCDC.brd (continued)

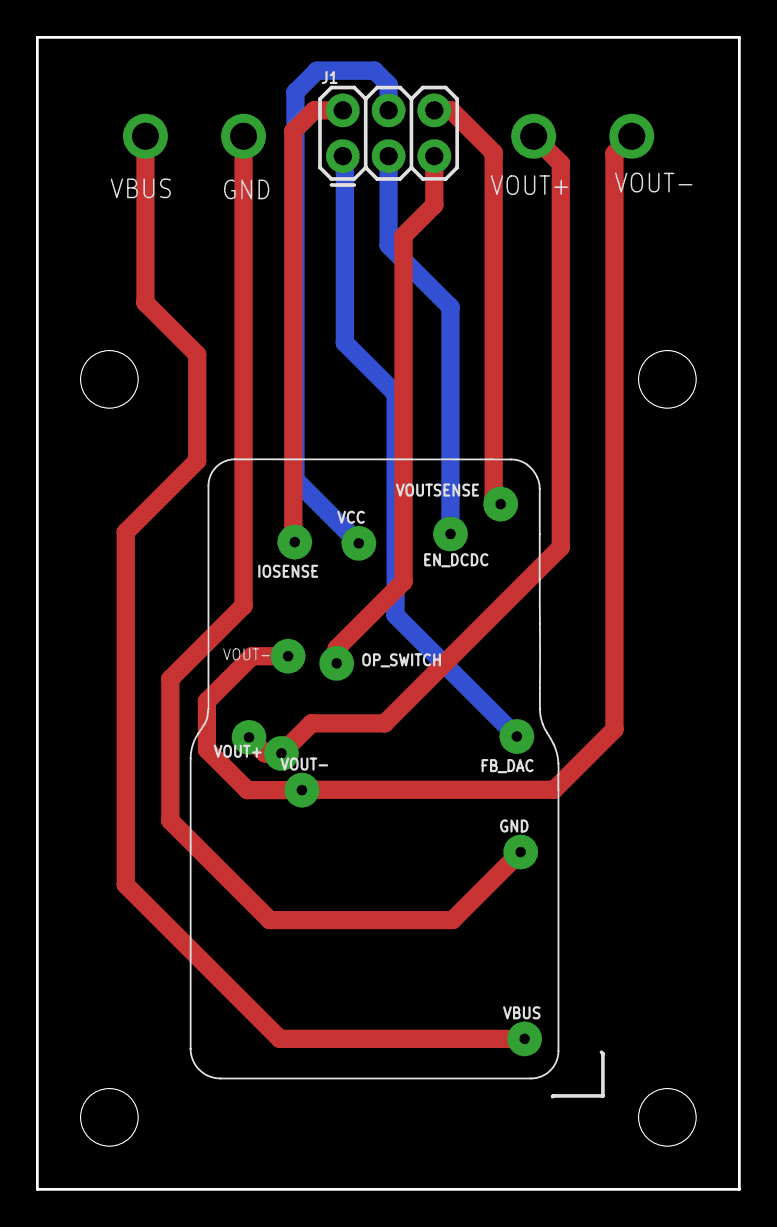
[picture p344: board POGO_DCDC.brd from above]

Board: 2 copper layers, 39.0 x 64.0 mm, 13 parts (0 on the bottom side), 8 nets.
