MSTKMAD/battery-pack/02.HARDWARE/V2-ROVER R-1/03.TESTBOARDS/TEST_CPU/TEST_CPU.brd

## EAGLE design 02.HARDWARE/V2-ROVER R-1/03.TESTBOARDS/TEST_CPU/TEST_CPU.brd (2023-01-24)

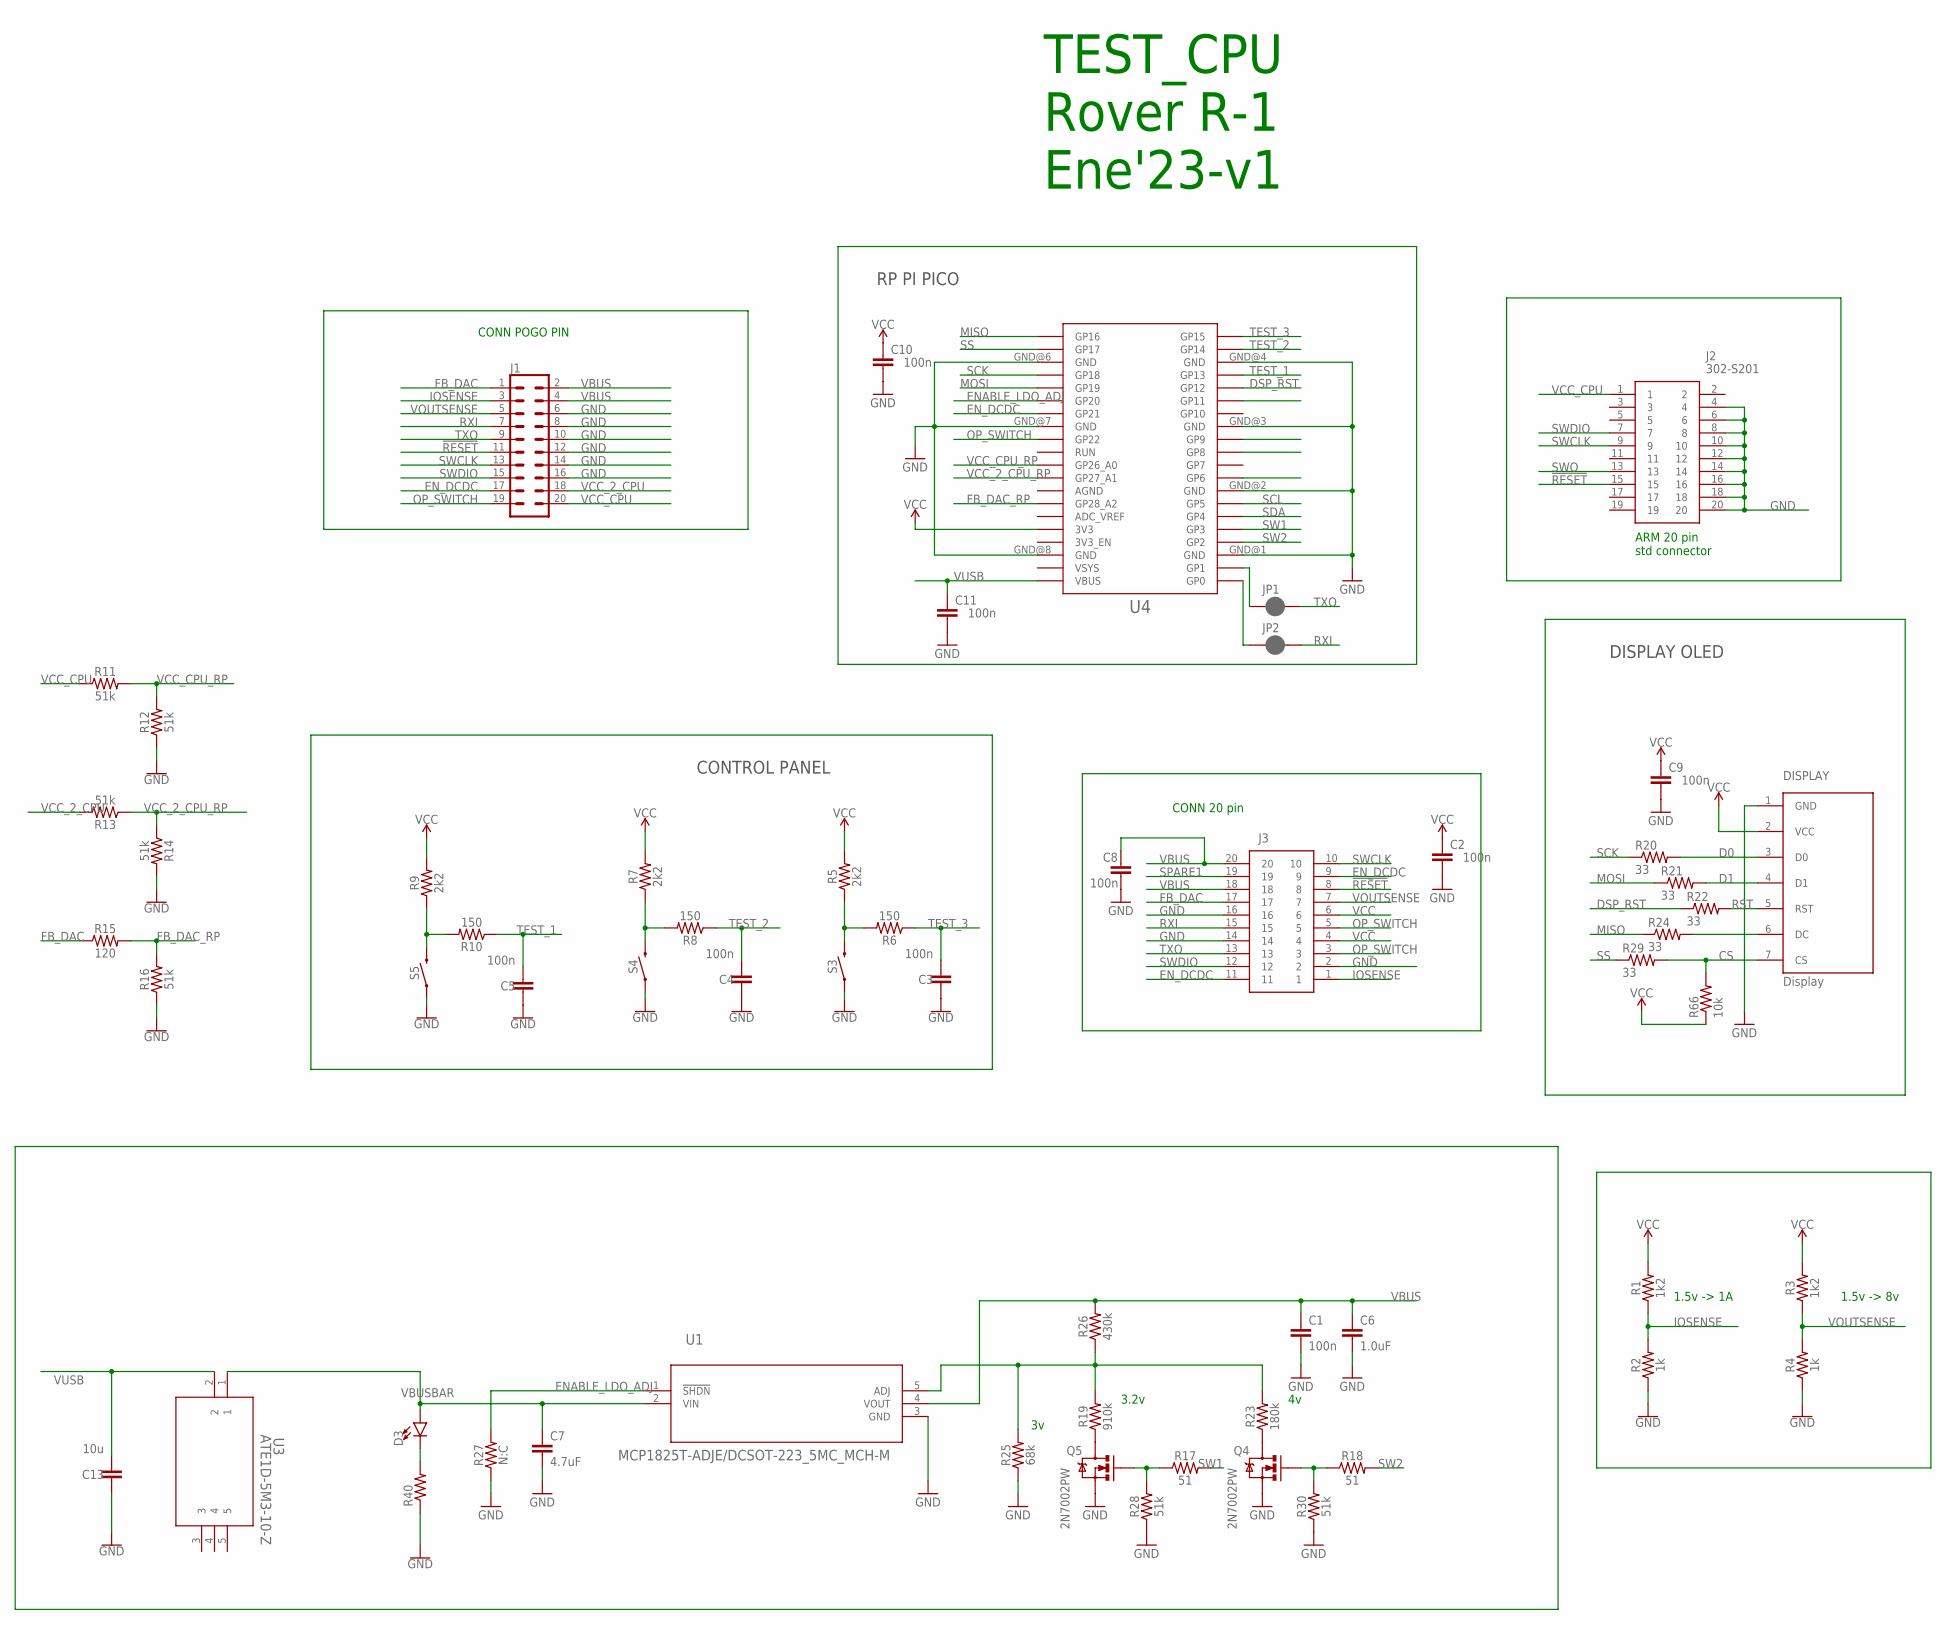
[picture p345: schematic TEST_CPU.sch]

Parts:
C1, C2, C3, C4, C5, C8, C9, C10, C11: 100n; 0805
C6: 1.0uF; 0805
C7: 4.7uF; 0805
C13: 10u; 0805
D3: LED3MM; LED_3MM
DISPLAY: Display; OLED_LCD
J1: CONN_10X2; 2X10
J2: 302-S201; SHDR20W66P254_2X10_3300X905X90
J3: DF40C-20DP-0.4V_51_; DF40C-20DPA
JP1, JP2: JUMPER-SMT_2_NC_PASTE_SILK; SMT-JUMPER_2_NC_PASTE_SILK
Q4, Q5: 2N7002PW; SOT323
R1, R3: 1k2; 0805
R2, R4: 1k; 0805
R5, R7, R9: 2k2; 0805
R6, R8, R10: 150; 0805
R11, R12, R13, R14, R16, R28, R30: 51k; 0805
R15: 120; 0805
R17, R18: 51; 0805
R19: 910k; 0805
R20, R21, R22, R24, R29: 33; 0805
R23: 180k; 0805
R25: 68k; 0805
R26: 430k; 0805
R27: N:C; 0805
R40: 360; 0805
R66: 10k; 0805
S3, S4, S5: MOMENTARY-SWITCH-SPST-SMD-5.2MM; TACTILE_SWITCH_SMD_5.2MM
U1: MCP1825T-ADJE/DCSOT-223_5MC_MCH-M; SOT-223_5MC_MCH-M
U3: ATE1D-5M3-10-Z; SPDT05_ATE1D_9P5X8_NDC
U4: RPI_PICO_IG-TH; RPI_PICO_TH

Connections:
!RESET: J1.11, J2.15, J3.8
CS: DISPLAY.7 (CS), R29.2, R66.2
D0: DISPLAY.3 (D0), R20.2
D1: DISPLAY.4 (D1), R21.2
DSP_RST: R22.1, U4.GP12
ENABLE_LDO_ADJ: R27.2, U1.1 (!SHDN), U4.GP20
EN_DCDC: J1.17, J3.9, J3.11, U4.GP21
FB_DAC: J1.1, J3.17, R15.1
FB_DAC_RP: R15.2, R16.2, U4.GP28_A2
GND: C1.2, C2.2, C3.1, C4.1, C5.1, C6.2, C7.2, C8.2, C9.2, C10.2, C11.2, C13.1, DISPLAY.1 (GND), J1.6, J1.8, J1.10, J1.12, J1.14, J1.16, J2.4, J2.6, J2.8, J2.10, J2.12, J2.14, J2.16, J2.18, J2.20, J3.2, J3.14, J3.16, Q4.2 (S), Q5.2 (S), R2.1, R4.1, R12.1, R14.2, R16.1, R25.1, R27.1, R28.1, R30.1, R40.1, S3.1, S4.1, S5.1, U1.3 (GND), U4.GND@1 (GND), U4.GND@2 (GND), U4.GND@3 (GND), U4.GND@4 (GND), U4.GND@6 (GND), U4.GND@7 (GND), U4.GND@8 (GND)
IOSENSE: J1.3, J3.1, R1.1, R2.2
MISO: R24.1, U4.GP16
MOSI: R21.1, U4.GP19
unnamed: R5.1, R6.2, S3.3 (2)
unnamed: R7.1, R8.2, S4.3 (2)
unnamed: JP1.1, U4.GP1
unnamed: R9.1, R10.2, S5.3 (2)
unnamed: JP2.1, U4.GP0
unnamed: DISPLAY.6 (DC), R24.2
unnamed: R19.2, R23.2, R25.2, R26.1, U1.5 (ADJ)
unnamed: Q5.1 (G), R17.1, R28.2
unnamed: D3.K (C), R40.2
unnamed: Q5.3 (D), R19.1
unnamed: Q4.1 (G), R18.1, R30.2
unnamed: Q4.3 (D), R23.1
OP_SWITCH: J1.19, J3.3, J3.5, U4.GP22
RST: DISPLAY.5 (RST), R22.2
RXI: J1.7, J3.15, JP2.2
SCK: R20.1, U4.GP18
SCL: U4.GP5
SDA: U4.GP4
SPARE1: J3.19
SS: R29.1, U4.GP17
SW1: R17.2, U4.GP3
SW2: R18.2, U4.GP2
SWCLK: J1.13, J2.9, J3.10
SWDIO: J1.15, J2.7, J3.12
SWO: J2.13
TEST_1: C5.2, R10.1, U4.GP13
TEST_2: C4.2, R8.1, U4.GP14
TEST_3: C3.2, R6.1, U4.GP15
TXO: J1.9, J3.13, JP1.2
VBUS: C1.1, C6.1, C8.1, J1.2, J1.4, J3.18, J3.20, R26.2, U1.4 (VOUT)
VBUSBAR: C7.1, D3.A, U1.2 (VIN), U3.1
VCC: C2.1, C9.1, C10.1, DISPLAY.2 (VCC), J3.4, J3.6, R1.2, R3.2, R5.2, R7.2, R9.2, R66.1, U4.3V3
VCC_2_CPU: J1.18, R13.2
VCC_2_CPU_RP: R13.1, R14.1, U4.GP27_A1
VCC_CPU: J1.20, J2.1, R11.1
VCC_CPU_RP: R11.2, R12.2, U4.GP26_A0
VOUTSENSE: J1.5, J3.7, R3.1, R4.2
VUSB: C11.1, C13.2, U3.2, U4.VBUS

Notes on the sheet:
TEST_CPU Rover R-1 Ene'23-v1
CONTROL PANEL
DISPLAY OLED
RP PI PICO
ARM 20 pin std connector
CONN 20 pin
CONN POGO PIN
1.5v -> 1A
1.5v -> 8v
3.2v

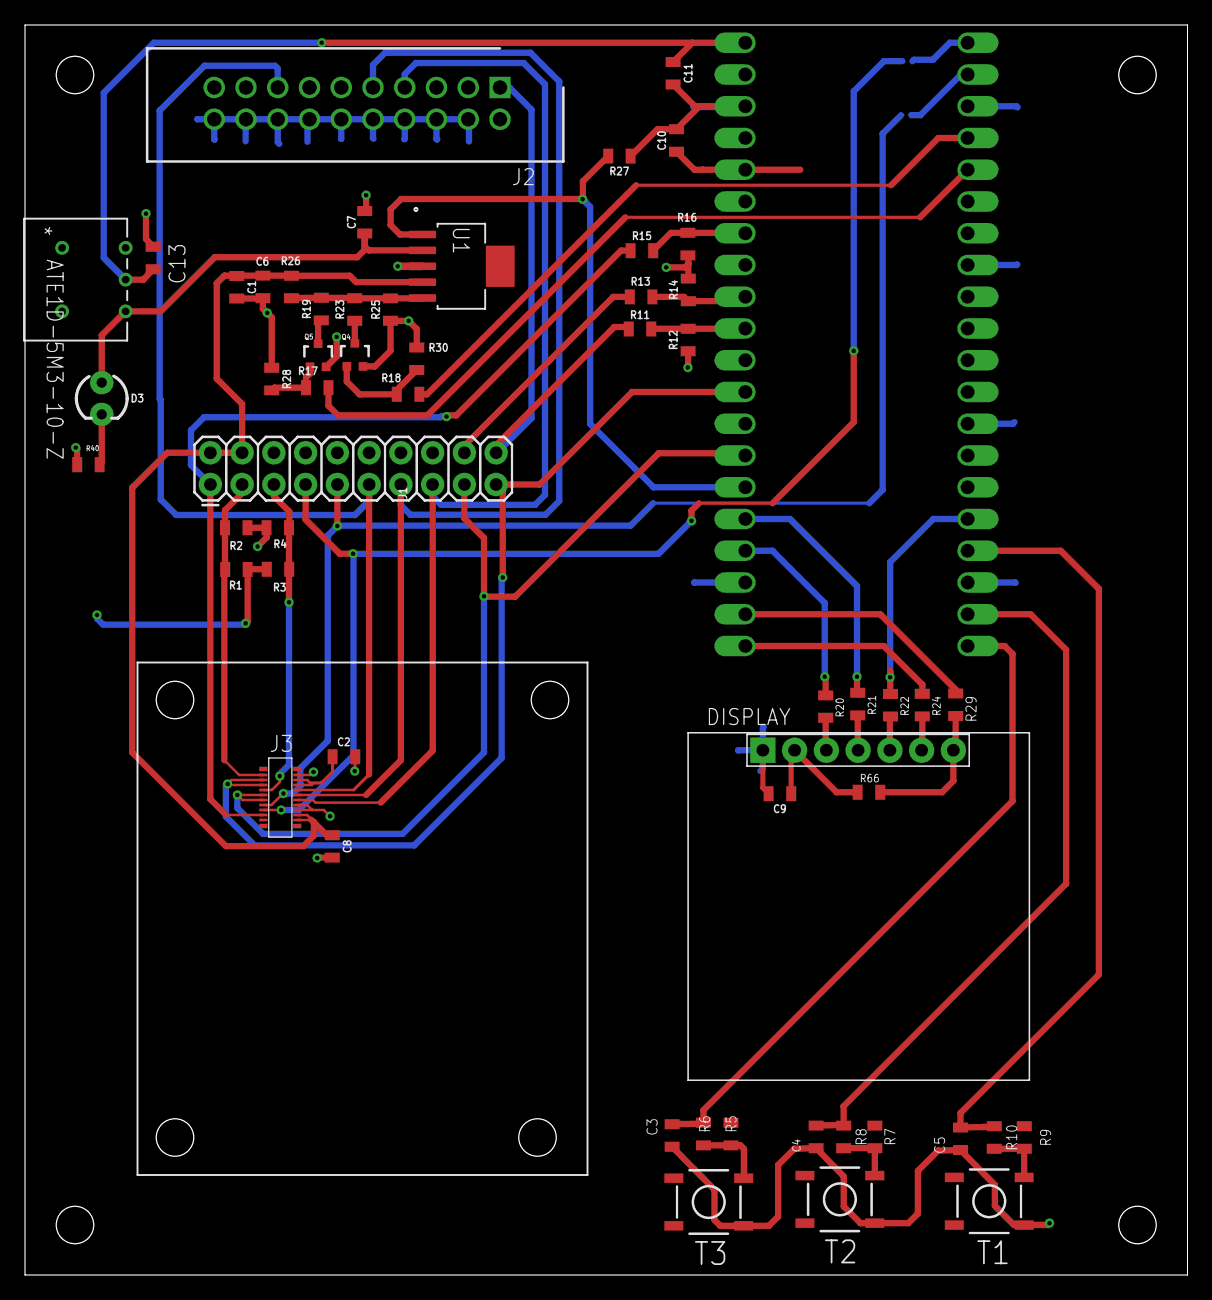
[picture p346: board TEST_CPU.brd from above]

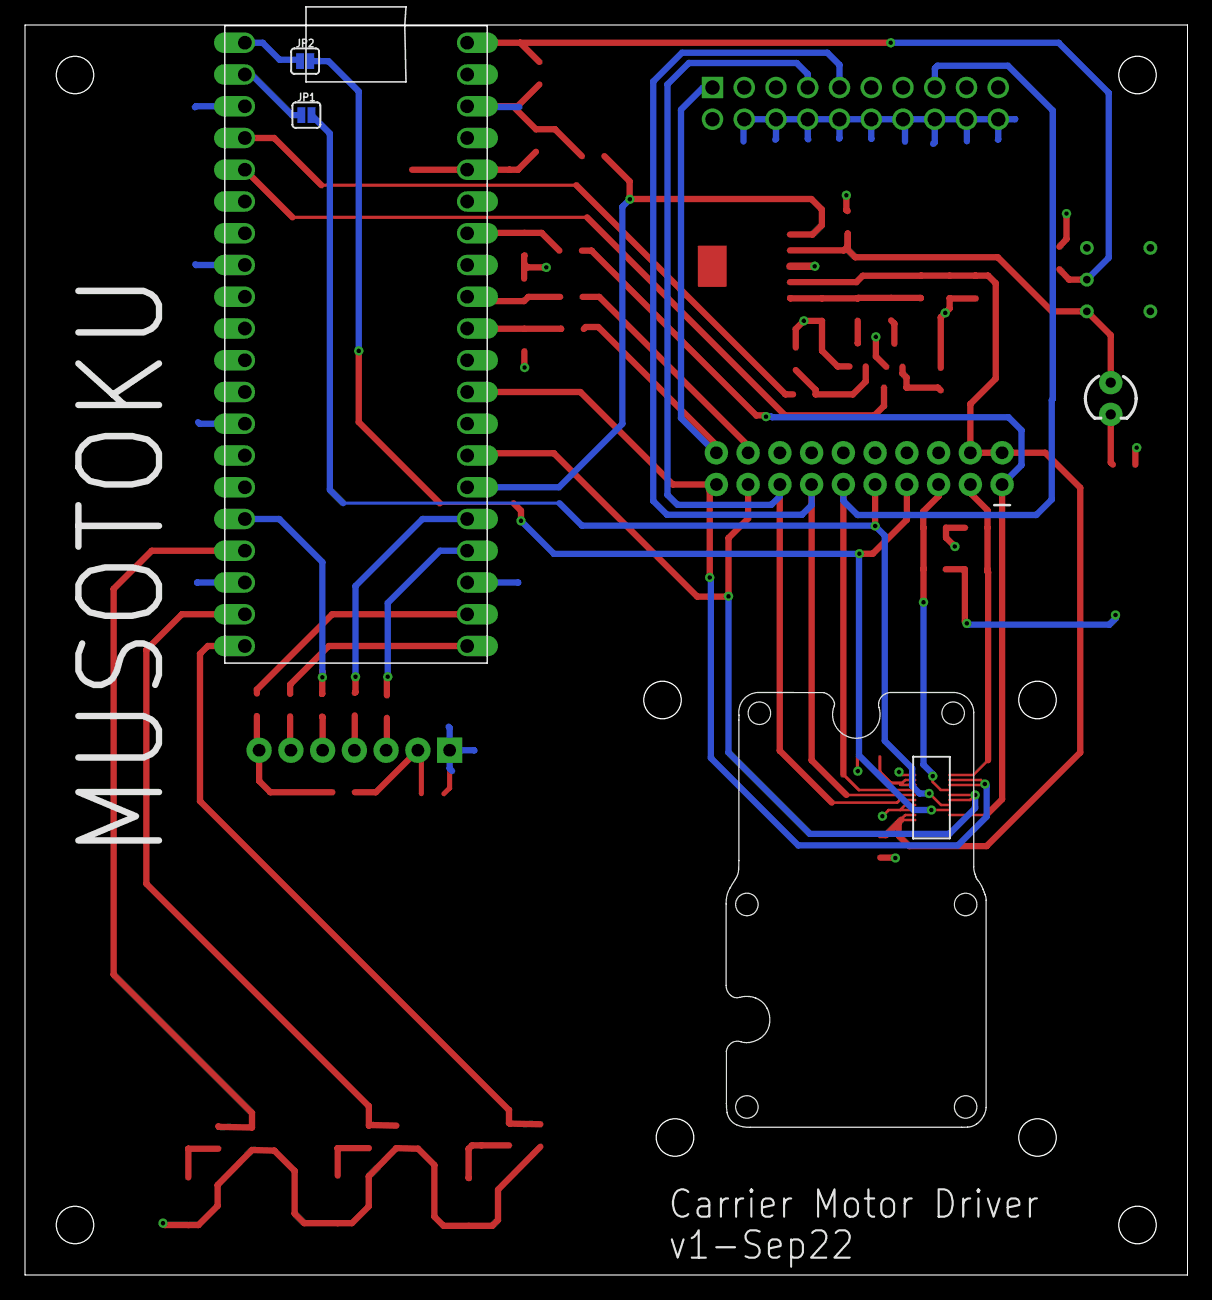
[picture p347: board TEST_CPU.brd from below]

Board: 2 copper layers, 93.0 x 100.0 mm, 59 parts (3 on the bottom side), 47 nets.
