MSTKMAD/battery-pack/02.HARDWARE/V2-ROVER R-1/03.TESTBOARDS/TEST_DCDC/TEST_DCDC.brd

## EAGLE design 02.HARDWARE/V2-ROVER R-1/03.TESTBOARDS/TEST_DCDC/TEST_DCDC.brd (2023-01-24)

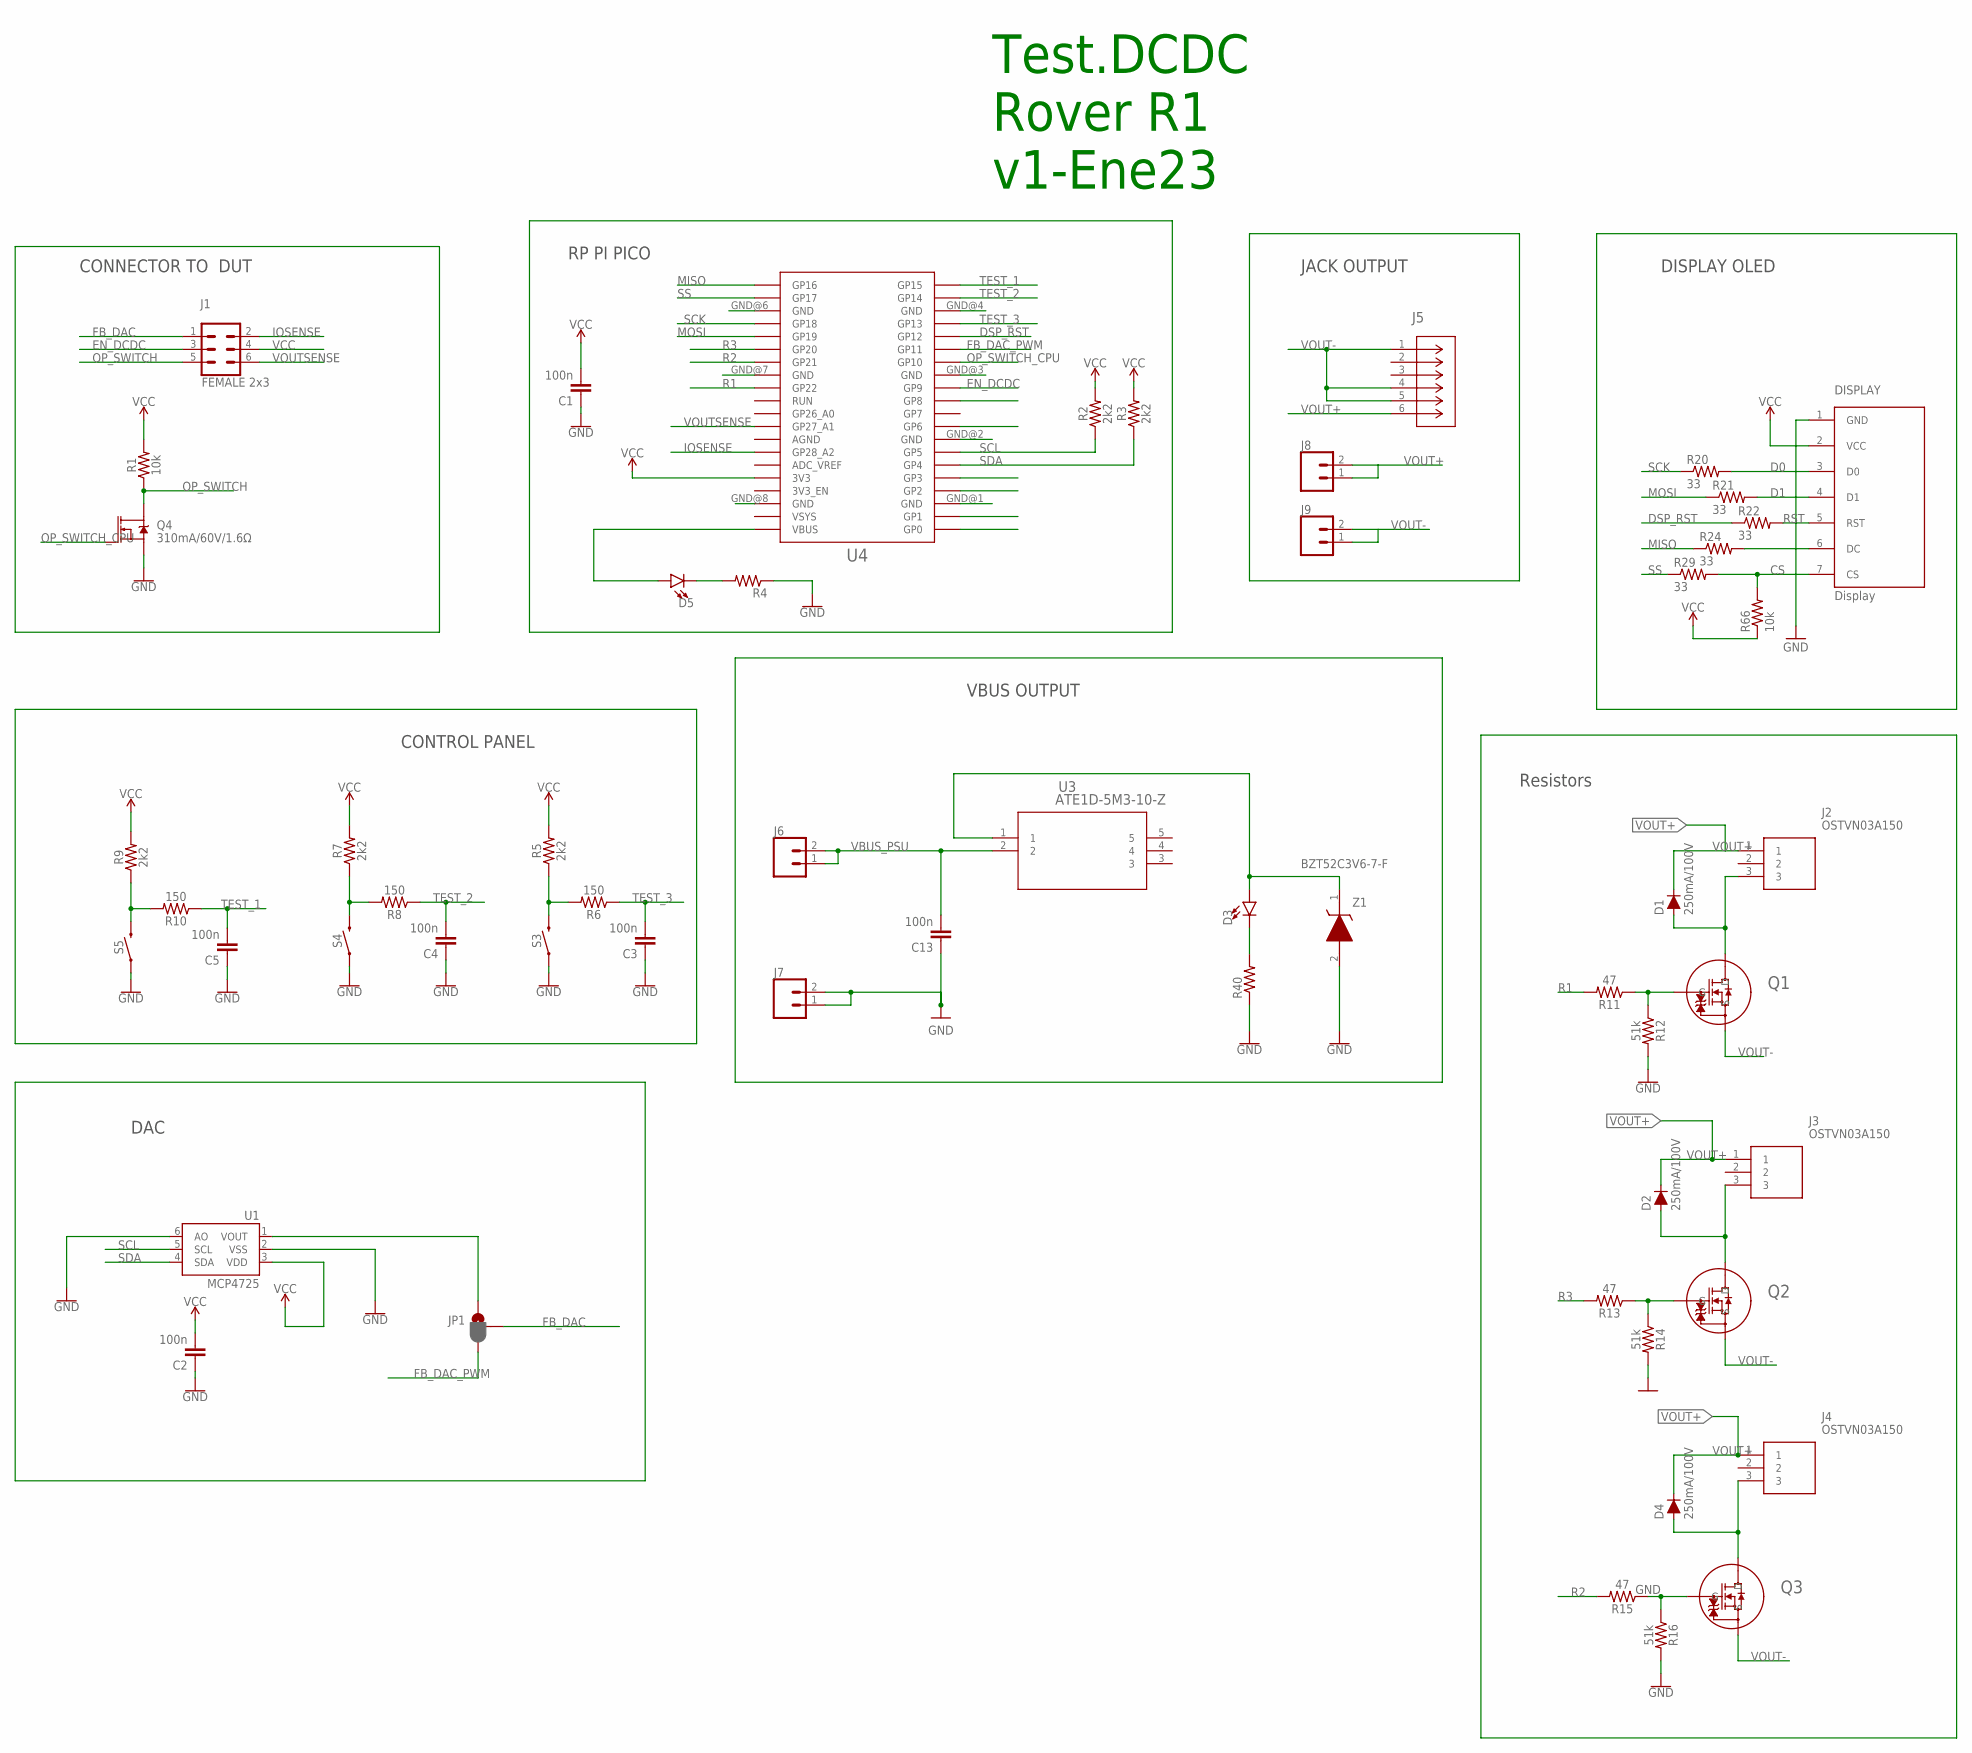
[picture p351: schematic TEST_DCDC.sch]

Parts:
C1, C2, C3, C4, C5, C13: 100n; C0805
D1, D2, D4: 250mA/100V; SOD-323
D3, D5: LED3MM; LED_3MM
DISPLAY: Display; OLED_LCD
J1: FEMALE 2x3; 2X3
J2, J3, J4: OSTVN03A150
J5: ACJS-MHDR; CONN_MHDR_AMP
J6, J7, J8, J9: CONN_02; 1X02
JP1: JUMPER-SMT_3_1-NC_PASTE_SILK; SMT-JUMPER_3_1-NC_PASTE_SILK
Q1, Q2, Q3: PJA3416AE_R1_00001; SOT23_PJA3416_PNJ
Q4: 310mA/60V/1.6Ω; SOT323
R1, R66: 10k; 0805
R2, R3, R5, R7, R9: 2k2; 0805
R4, R40: 360; 0805
R6, R8, R10: 150; 0805
R11, R13, R15: 47; 0805
R12, R14, R16: 51k; 0805
R20, R21, R22, R24, R29: 33; 0805
S3, S4, S5: MOMENTARY-SWITCH-SPST-SMD-5.2MM; TACTILE_SWITCH_SMD_5.2MM
U1: MCP4725; SOT23-6
U3: ATE1D-5M3-10-Z; SPDT05_ATE1D_9P5X8_NDC
U4: RPI_PICO_IG-TH; RPI_PICO_TH
Z1: BZT52C3V6-7-F; SOD3716X135N

Connections:
CS: DISPLAY.7 (CS), R29.2, R66.2
D0: DISPLAY.3 (D0), R20.2
D1: DISPLAY.4 (D1), R21.2
DSP_RST: R22.1, U4.GP12
EN_DCDC: J1.3, U4.GP9
FB_DAC: J1.1, JP1.2
FB_DAC_PWM: JP1.3, U4.GP11
GND: C1.1, C2.1, C3.1, C4.1, C5.1, C13.1, DISPLAY.1 (GND), J7.1, J7.2, Q4.2 (S), R4.1, R12.2, R14.2, R16.2, R40.1, S3.1, S4.1, S5.1, U1.2 (VSS), U1.6 (AO), U4.GND@1 (GND), U4.GND@2 (GND), U4.GND@3 (GND), U4.GND@4 (GND), U4.GND@6 (GND), U4.GND@7 (GND), U4.GND@8 (GND), Z1.2 (A)
IOSENSE: J1.2, U4.GP28_A2
MISO: R24.1, U4.GP16
MOSI: R21.1, U4.GP19
unnamed: D4.A, J4.3, Q3.3 (D)
unnamed: D2.A, J3.3, Q2.3 (D)
unnamed: R5.1, R6.2, S3.3 (2)
unnamed: R7.1, R8.2, S4.3 (2)
unnamed: R9.1, R10.2, S5.3 (2)
unnamed: DISPLAY.6 (DC), R24.2
unnamed: JP1.1, U1.1 (VOUT)
unnamed: Q1.1 (G), R11.1, R12.1
unnamed: D1.A, J2.3, Q1.3 (D)
unnamed: Q2.1 (G), R13.1, R14.1
unnamed: D5.K (C), R4.2
unnamed: D5.A, U4.VBUS
unnamed: D3.K (C), R40.2
unnamed: Q3.1 (G), R15.1, R16.1
OP_SWITCH: J1.5, Q4.3 (D), R1.1
OP_SWITCH_CPU: Q4.1 (G), U4.GP10
R1: R11.2, U4.GP22
R2: R15.2, U4.GP21
R3: R13.2, U4.GP20
RST: DISPLAY.5 (RST), R22.2
SCK: R20.1, U4.GP18
SCL: R2.1, U1.5 (SCL), U4.GP5
SDA: R3.1, U1.4 (SDA), U4.GP4
SS: R29.1, U4.GP17
TEST_1: C5.2, R10.1, U4.GP15
TEST_2: C4.2, R8.1, U4.GP14
TEST_3: C3.2, R6.1, U4.GP13
VBUS: D3.A, U3.1, Z1.1 (K)
VBUS_PSU: C13.2, J6.1, J6.2, U3.2
VCC: C1.2, C2.2, DISPLAY.2 (VCC), J1.4, R1.2, R2.2, R3.2, R5.2, R7.2, R9.2, R66.1, U1.3 (VDD), U4.3V3
VOUT+: D1.C, D2.C, D4.C, J2.1, J3.1, J4.1, J5.6, J8.1, J8.2
VOUT-: J5.1, J5.4, J5.5, J9.1, J9.2, Q1.2 (S), Q2.2 (S), Q3.2 (S)
VOUTSENSE: J1.6, U4.GP27_A1

Notes on the sheet:
Test.DCDC Rover R1 v1-Ene23
CONTROL PANEL
VBUS OUTPUT
Resistors
DISPLAY OLED
RP PI PICO
DAC
CONNECTOR TO DUT
JACK OUTPUT

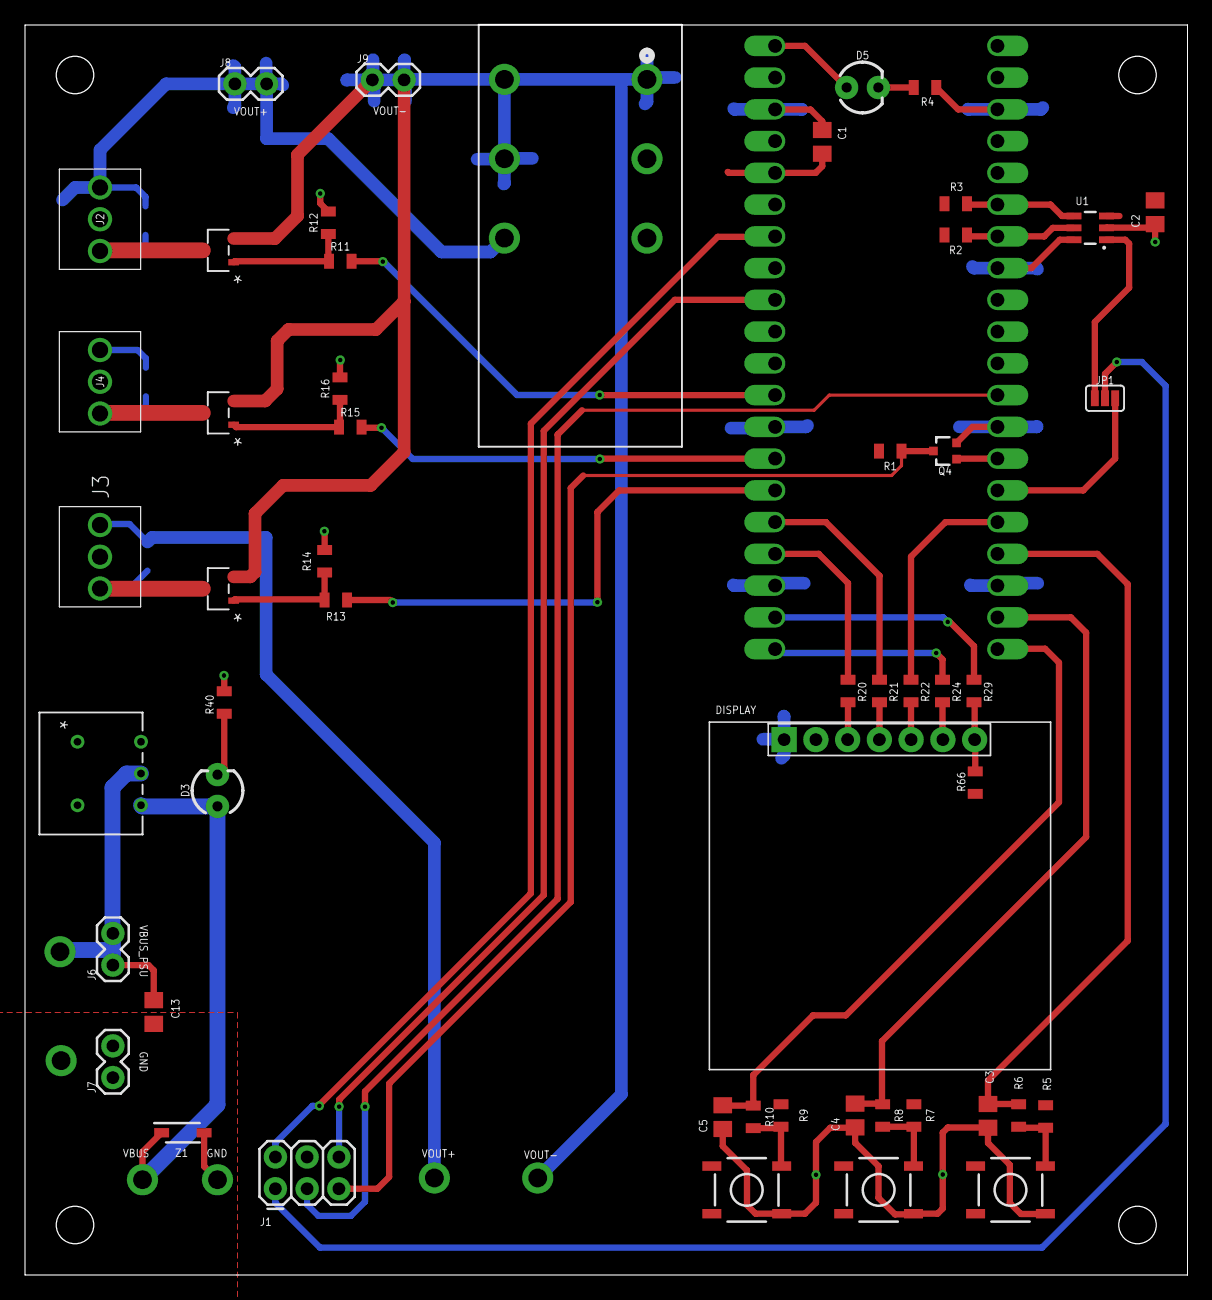
[picture p352: board TEST_DCDC.brd from above]

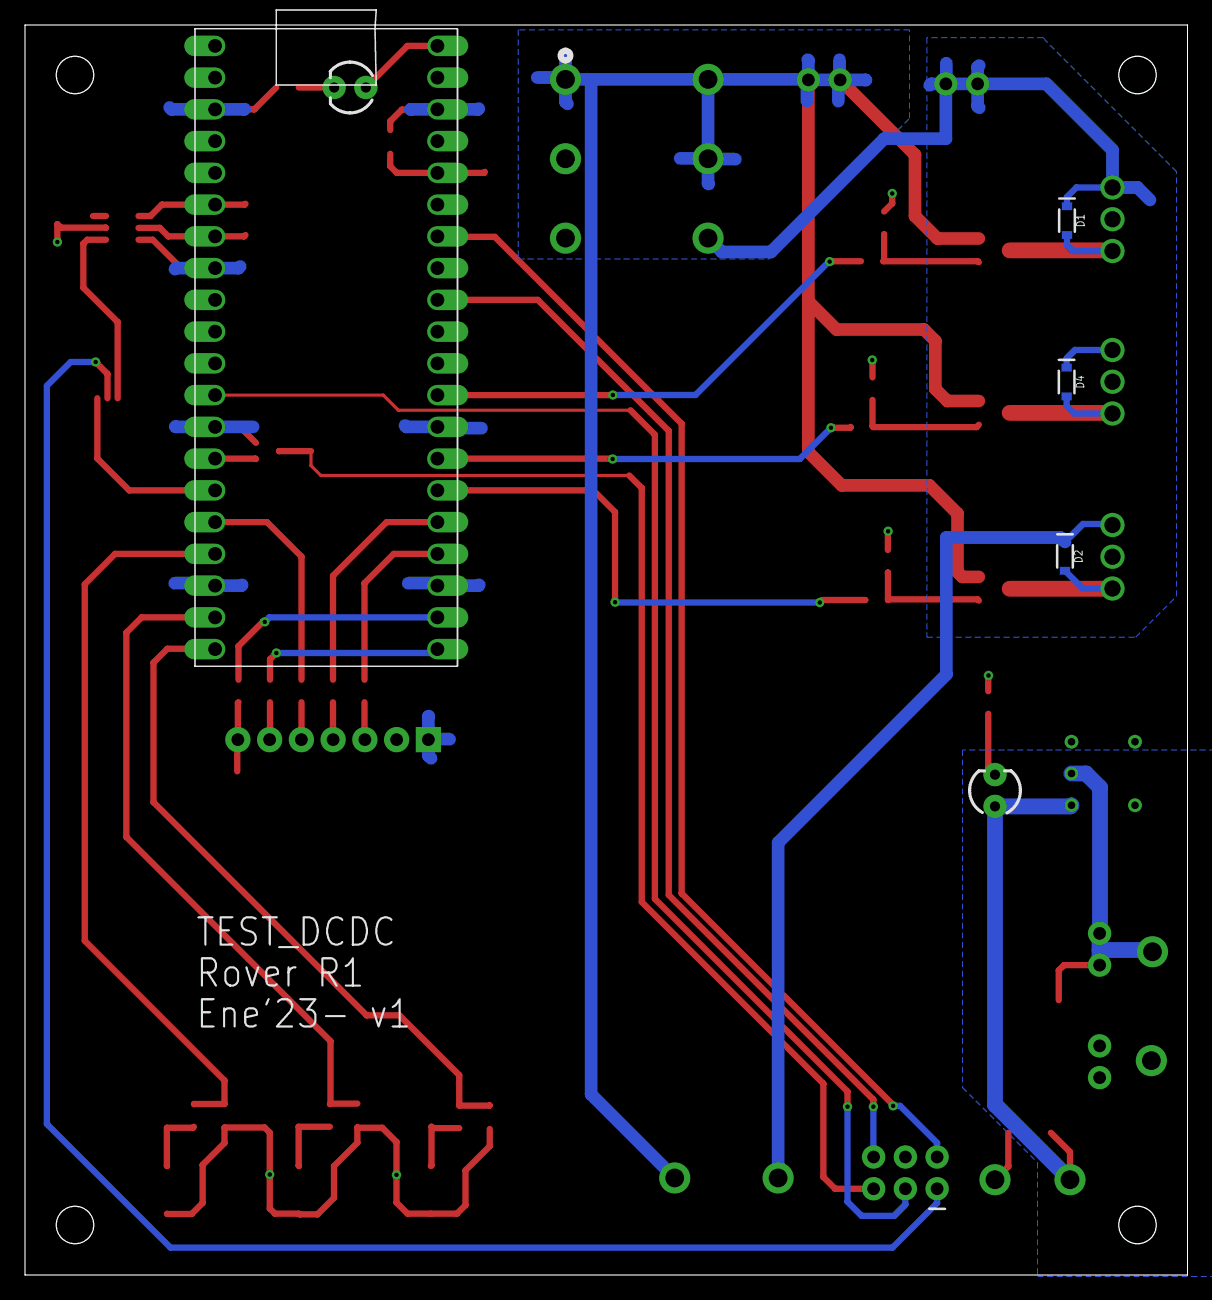
[picture p353: board TEST_DCDC.brd from below]

Board: 2 copper layers, 93.0 x 100.0 mm, 56 parts (4 on the bottom side), 44 nets.
