MSTKMAD/battery-pack/02.HARDWARE/V2-ROVER R-1/01.PCB/BATT_FLEX8/BATT_FLEX8.brd

## EAGLE design 02.HARDWARE/V2-ROVER R-1/01.PCB/BATT_FLEX8/BATT_FLEX8.brd (2022-11-09)

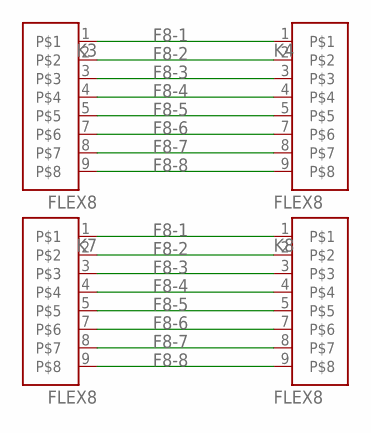
[picture p354: schematic BATT_FLEX8.sch]

Parts:
K3, K4, K7, K8: FLEX8

Connections:
F8-1: K3.1, K4.1, K7.1, K8.1
F8-2: K3.2, K4.2, K7.2, K8.2
F8-3: K3.3, K4.3, K7.3, K8.3
F8-4: K3.4, K4.4, K7.4, K8.4
F8-5: K3.5, K4.5, K7.5, K8.5
F8-6: K3.7, K4.7, K7.7, K8.7
F8-7: K3.8, K4.8, K7.8, K8.8
F8-8: K3.9, K4.9, K7.9, K8.9

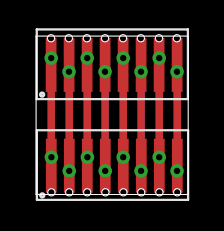
[picture p355: board BATT_FLEX8.brd from above]

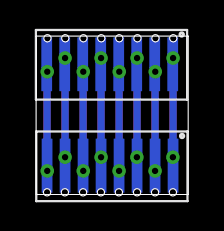
[picture p356: board BATT_FLEX8.brd from below]

Board: 2 copper layers, 8.4 x 8.8 mm, 4 parts (2 on the bottom side), 8 nets.
