MSTKMAD/battery-pack/02.HARDWARE/V2-ROVER R-1/03.TESTBOARDS/TEST_CPU/HISTORY/PROG_CPU/BATT_CPUPROG.brd

## EAGLE design 02.HARDWARE/V2-ROVER R-1/03.TESTBOARDS/TEST_CPU/HISTORY/PROG_CPU/BATT_CPUPROG.brd (2022-11-14)

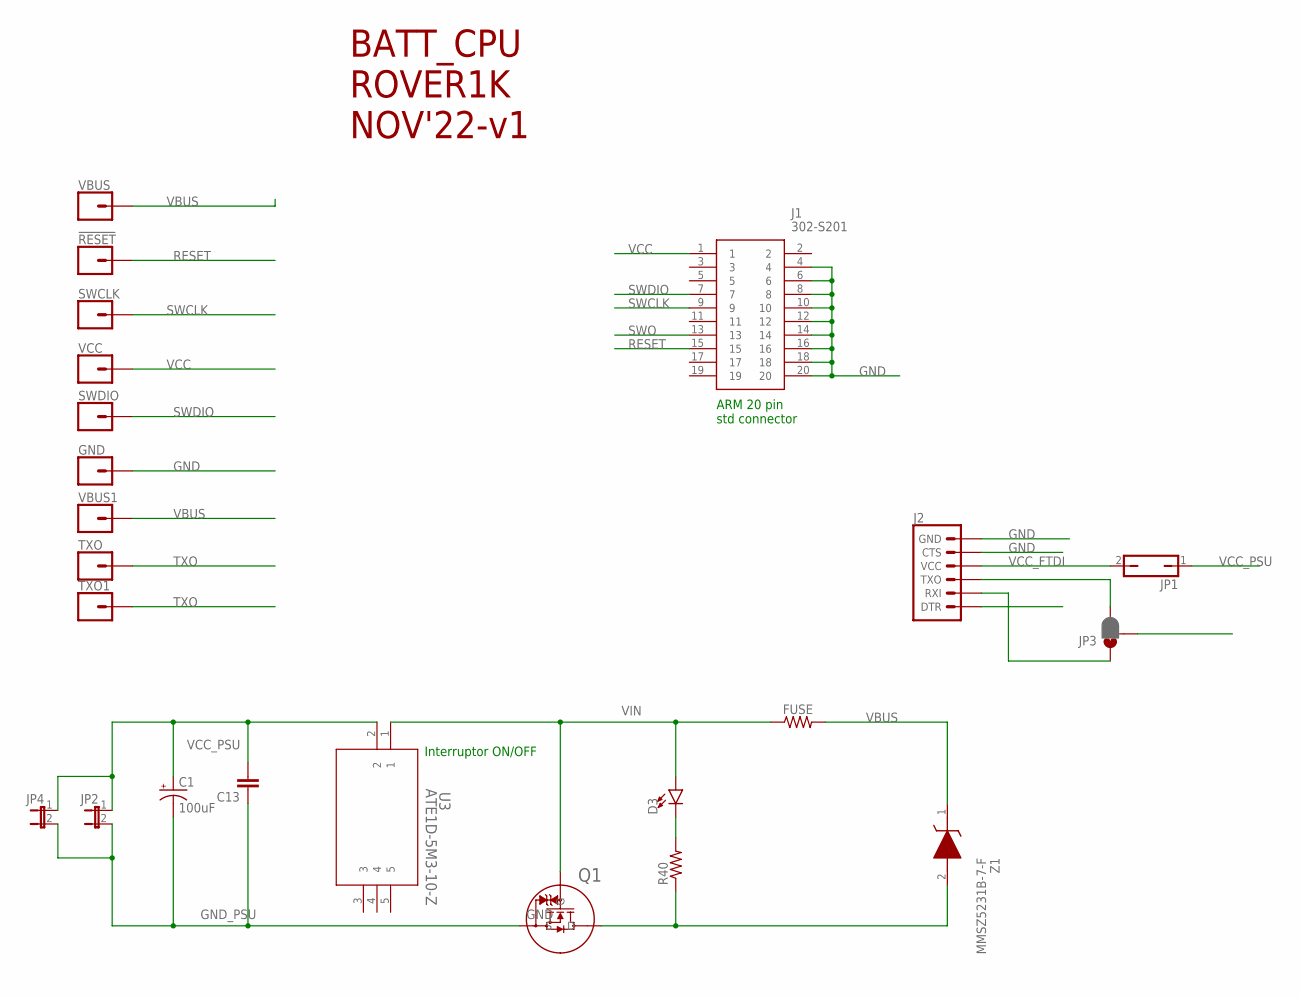
[picture p357: schematic BATT_CPUPROG.sch]

Parts:
!RESET: CONN_01POGOPIN_HOLE_LARGE; 1X01_POGOPIN_HOLE_0.061_DIA
C1: 100uF; CPOL-RADIAL-2.5MM-6.5MM
C13: C-EUC0805; C0805
D3: LED3MM; LED_3MM
FUSE: 0805
GND: CONN_01POGOPIN_HOLE_LARGE; 1X01_POGOPIN_HOLE_0.061_DIA
J1: 302-S201; SHDR20W66P254_2X10_3300X905X90
J2: 6_PIN_SERIAL_TARGET; 1X06
JP1: JP1Q; JP1
JP2, JP4: JP1E; JP1
JP3: JUMPER-SMT_3_1-NC_PASTE_NO-SILK; SMT-JUMPER_3_1-NC_PASTE_NO-SILK
Q1: PJA3416AE_R1_00001; SOT23_PJA3416_PNJ
R40: 10K; 0805
SWCLK: CONN_01POGOPIN_HOLE_LARGE; 1X01_POGOPIN_HOLE_0.061_DIA
SWDIO: CONN_01POGOPIN_HOLE_LARGE; 1X01_POGOPIN_HOLE_0.061_DIA
TXO, TXO1: CONN_01POGOPIN_HOLE_LARGE; 1X01_POGOPIN_HOLE_0.061_DIA
U3: ATE1D-5M3-10-Z; SPDT05_ATE1D_9P5X8_NDC
VBUS, VBUS1: CONN_01POGOPIN_HOLE_LARGE; 1X01_POGOPIN_HOLE_0.061_DIA
VCC: CONN_01POGOPIN_HOLE_LARGE; 1X01_POGOPIN_HOLE_0.061_DIA
Z1: MMSZ5231B-7-F; SOD3716X145N

Connections:
GND: GND.2, J1.4, J1.6, J1.8, J1.10, J1.12, J1.14, J1.16, J1.18, J1.20, J2.5 (CTS), J2.6 (GND), Q1.3 (D), R40.1, Z1.2 (A)
GND_PSU: C1.2 (-), C13.1, JP2.2, JP4.2, Q1.2 (S)
unnamed: J2.2 (RXI), JP3.1
unnamed: J2.3 (TXO), JP3.3
unnamed: D3.K (C), R40.2
RESET: !RESET.2, J1.15
SWCLK: J1.9, SWCLK.2
SWDIO: J1.7, SWDIO.2
SWO: J1.13
TXO: JP3.2, TXO.2, TXO1.2
VBUS: FUSE.2, VBUS.2, VBUS1.2, Z1.1 (K)
VCC: J1.1, VCC.2
VCC_FTDI: J2.4 (VCC), JP1.2
VCC_PSU: C1.1 (+), C13.2, JP1.1, JP2.1, JP4.1, U3.2
VIN: D3.A, FUSE.1, Q1.1 (G), U3.1

Notes on the sheet:
BATT_CPU ROVER1K NOV'22-v1
ARM 20 pin std connector
Interruptor ON/OFF

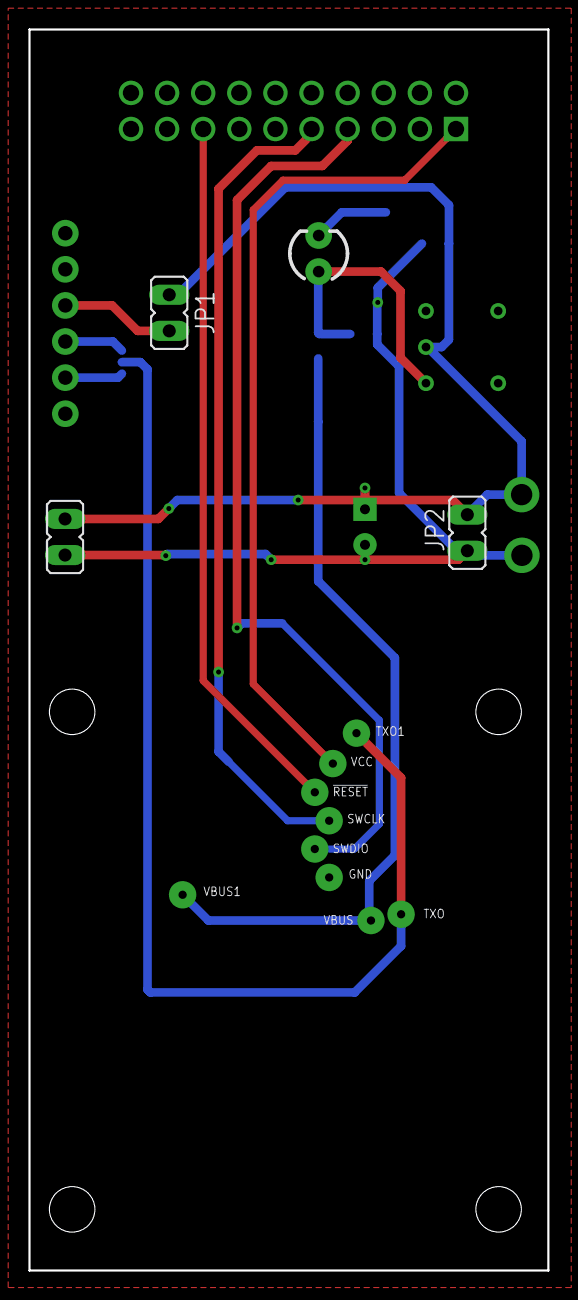
[picture p358: board BATT_CPUPROG.brd from above]

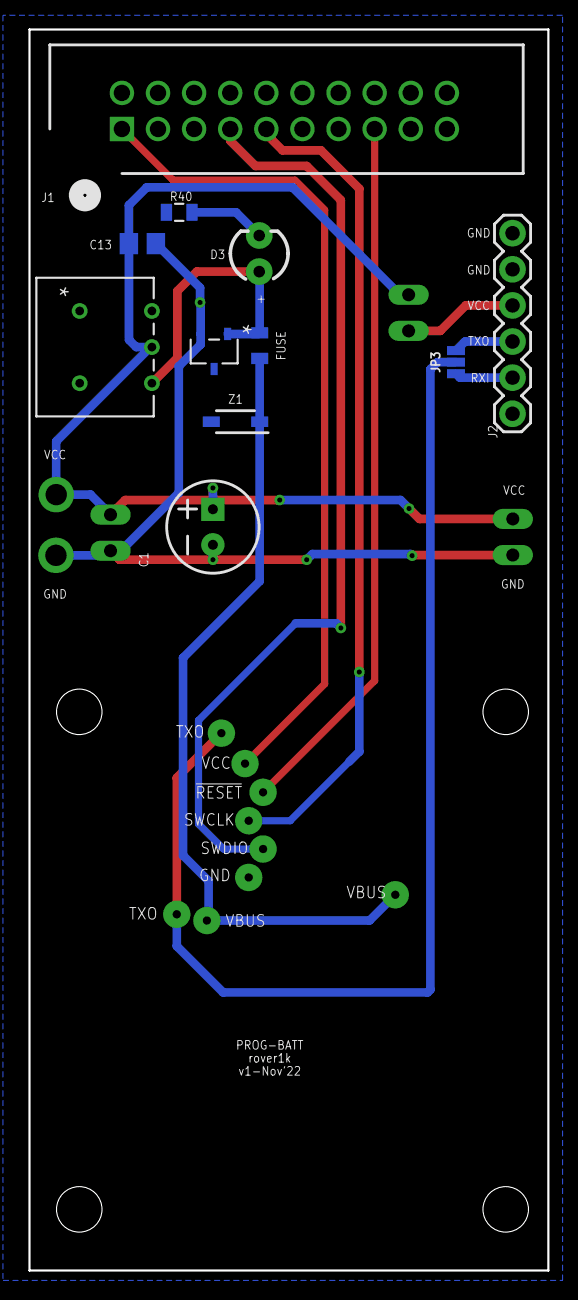
[picture p359: board BATT_CPUPROG.brd from below]

Board: 2 copper layers, 36.5 x 87.3 mm, 23 parts (11 on the bottom side), 14 nets.
