MSTKMAD/battery-pack/02.HARDWARE/V2-ROVER-1K/01.PCB/BATT_FLEX/BATT_FLEXX.sch

## EAGLE design 02.HARDWARE/V2-ROVER-1K/01.PCB/BATT_FLEX/BATT_FLEXX.sch (2022-11-09)

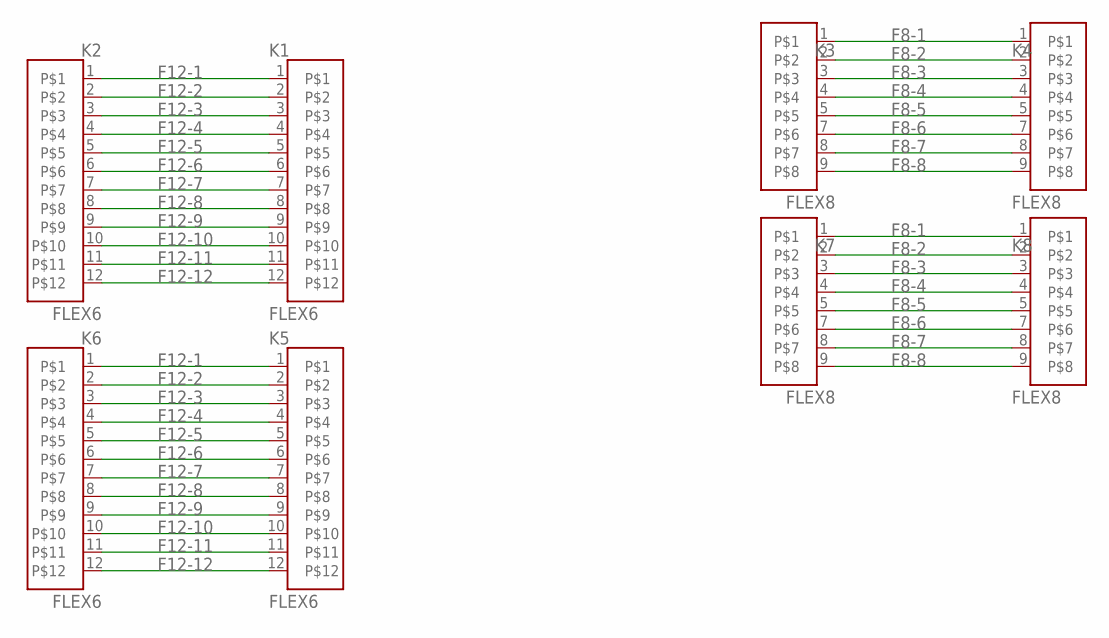
[picture p360: schematic BATT_FLEXX.sch]

Parts:
K1, K2, K5, K6: FLEX6
K3, K4, K7, K8: FLEX8

Connections:
F8-1: K3.1, K4.1, K7.1, K8.1
F8-2: K3.2, K4.2, K7.2, K8.2
F8-3: K3.3, K4.3, K7.3, K8.3
F8-4: K3.4, K4.4, K7.4, K8.4
F8-5: K3.5, K4.5, K7.5, K8.5
F8-6: K3.7, K4.7, K7.7, K8.7
F8-7: K3.8, K4.8, K7.8, K8.8
F8-8: K3.9, K4.9, K7.9, K8.9
F12-1: K1.1, K2.1, K5.1, K6.1
F12-2: K1.2, K2.2, K5.2, K6.2
F12-3: K1.3, K2.3, K5.3, K6.3
F12-4: K1.4, K2.4, K5.4, K6.4
F12-5: K1.5, K2.5, K5.5, K6.5
F12-6: K1.6, K2.6, K5.6, K6.6
F12-7: K1.7, K2.7, K5.7, K6.7
F12-8: K1.8, K2.8, K5.8, K6.8
F12-9: K1.9, K2.9, K5.9, K6.9
F12-10: K1.10, K2.10, K5.10, K6.10
F12-11: K1.11, K2.11, K5.11, K6.11
F12-12: K1.12, K2.12, K5.12, K6.12
