MSTKMAD/battery-pack/02.Hardware/V1-ROVER-2K/Battery PCBs/BATT_BUTTONS/BATT_BUTTONS.sch

## EAGLE design 02.Hardware/V1-ROVER-2K/Battery PCBs/BATT_BUTTONS/BATT_BUTTONS.sch (2022-09-29)

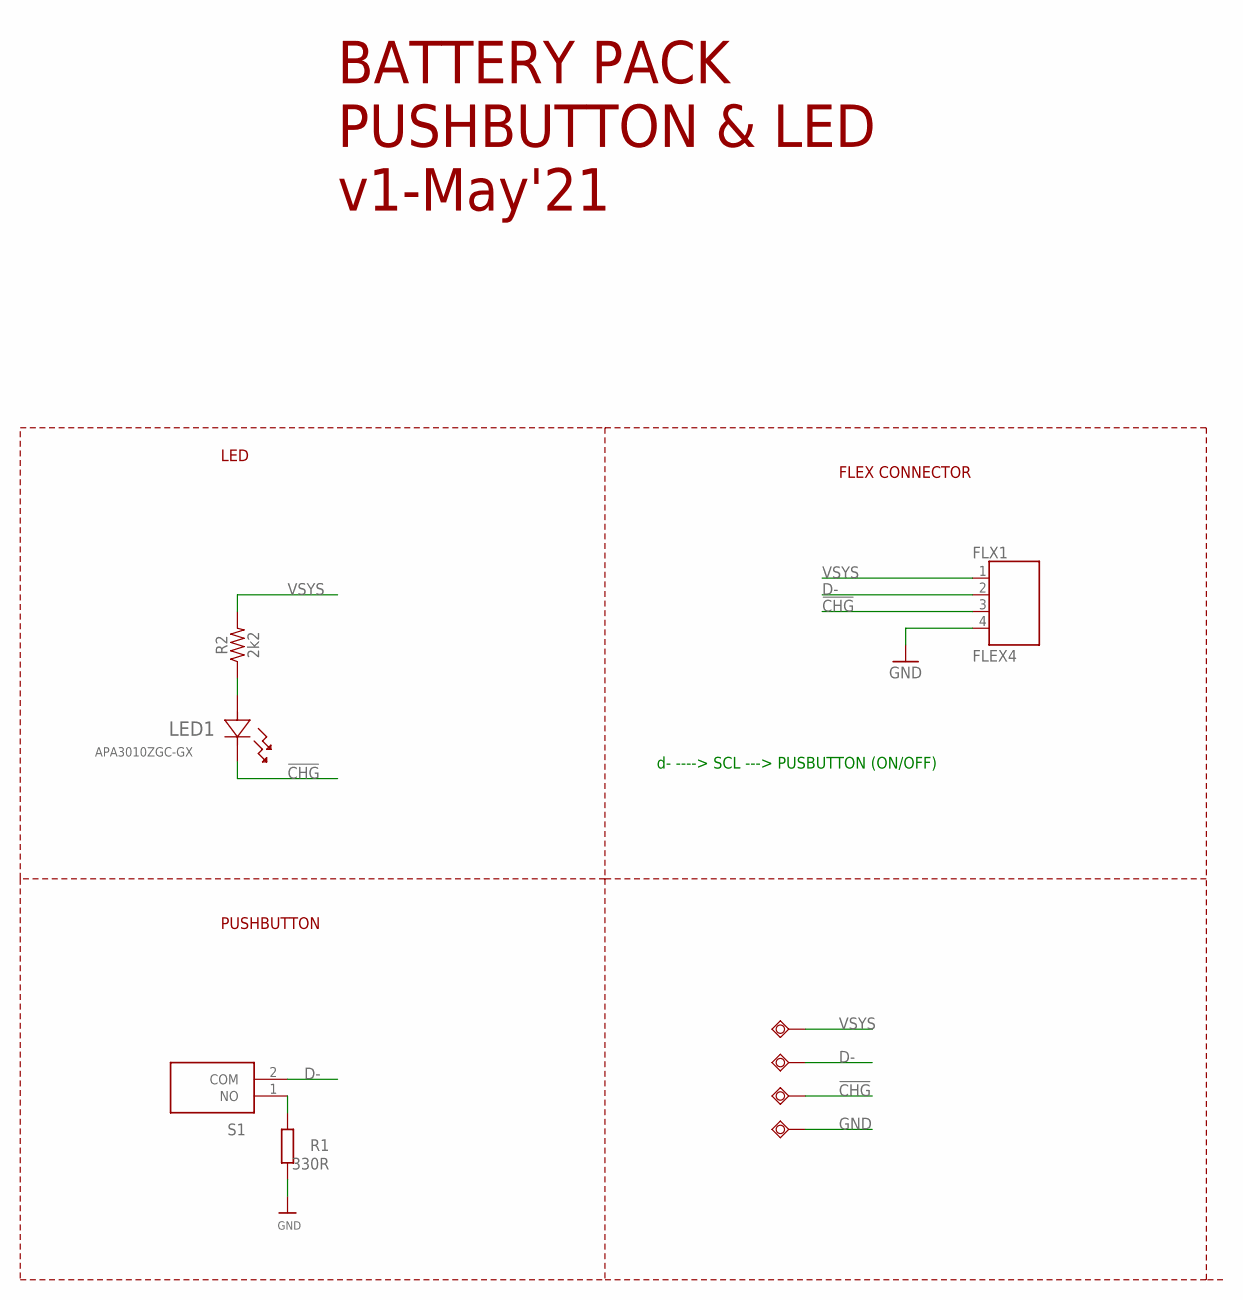
[picture p362: schematic BATT_BUTTONS.sch]

Parts:
!CHG: TESTPAD_TPSQB1,27; TESTPAD_B1,27
D-: TESTPAD_TPSQB1,27; TESTPAD_B1,27
FLX1: FLEX4
GND: TESTPAD_TPSQB1,27; TESTPAD_B1,27
LED1: APA3010ZGC-GX; LED_APA3010SRCPRV-GX_KNB
R1: 330R; R0603
R2: 2k2; 0402
S1: KXT311LHS
VSYS: TESTPAD_TPSQB1,27; TESTPAD_B1,27

Connections:
!CHG!: !CHG.TP, FLX1.3, LED1.1
D-: D-.TP, FLX1.2, S1.2 (COM)
GND: FLX1.4, GND.TP, R1.1
unnamed: R1.2, S1.1 (NO)
unnamed: LED1.2, R2.1
VSYS: FLX1.1, R2.2, VSYS.TP

Notes on the sheet:
BATTERY PACK PUSHBUTTON & LED v1-May'21
LED
d- ----> SCL ---> PUSBUTTON (ON/OFF)
FLEX CONNECTOR
PUSHBUTTON
