MSTKMAD/battery-pack/02.Hardware/V1-ROVER-2K/Battery PCBs/BATT_CONN/BATT_CONN.sch

## EAGLE design 02.Hardware/V1-ROVER-2K/Battery PCBs/BATT_CONN/BATT_CONN.sch (2022-04-21)

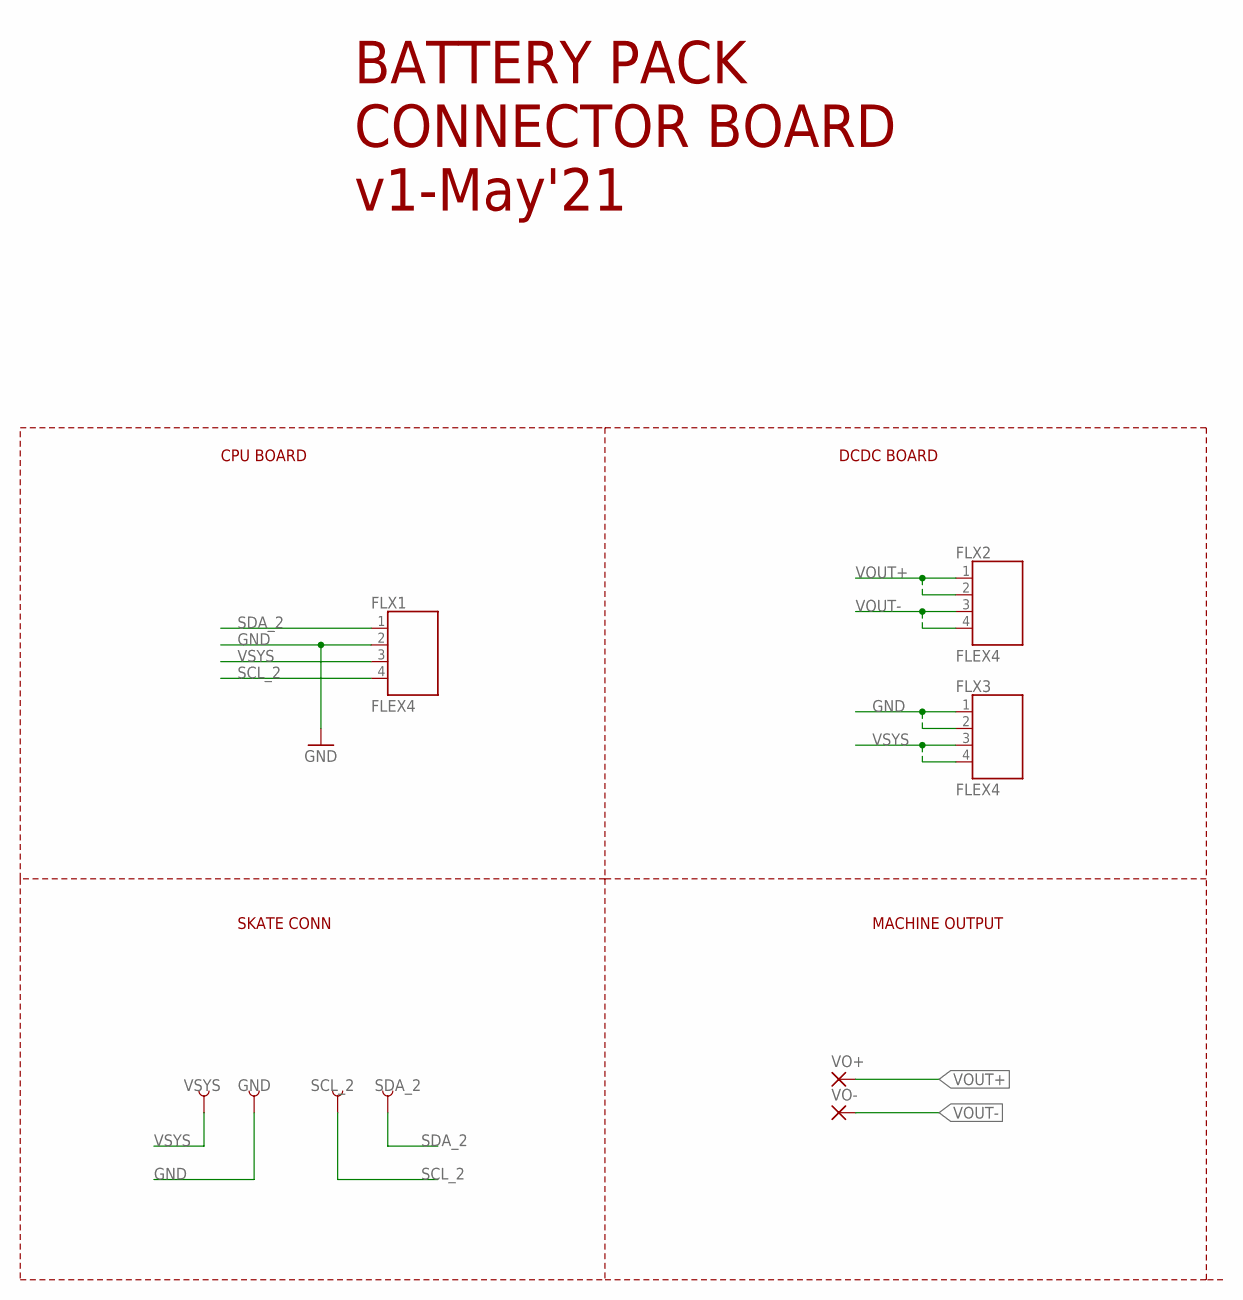
[picture p363: schematic BATT_CONN.sch]

Parts:
FLX1, FLX2, FLX3: FLEX4
GND: TEST-POINT3; PAD.03X.03
SCL_2: TEST-POINT3; PAD.03X.03
SDA_2: TEST-POINT3; PAD.03X.03
VO+: SMD5; SMD2,54-5,08
VO-: SMD5; SMD2,54-5,08
VSYS: TEST-POINT3; PAD.03X.03

Connections:
GND: FLX1.2, FLX3.1, FLX3.2, GND.P$1
SCL_2: FLX1.4, SCL_2.P$1
SDA_2: FLX1.1, SDA_2.P$1
VOUT+: FLX2.1, FLX2.2, VO+.1
VOUT-: FLX2.3, FLX2.4, VO-.1
VSYS: FLX1.3, FLX3.3, FLX3.4, VSYS.P$1

Notes on the sheet:
BATTERY PACK CONNECTOR BOARD v1-May'21
CPU BOARD
DCDC BOARD
SKATE CONN
MACHINE OUTPUT
