MSTKMAD/battery-pack/02.Hardware/V1-ROVER-2K/Battery PCBs/BATT_DISP/BATT_DISP.sch

## EAGLE design 02.Hardware/V1-ROVER-2K/Battery PCBs/BATT_DISP/BATT_DISP.sch (2022-09-29)

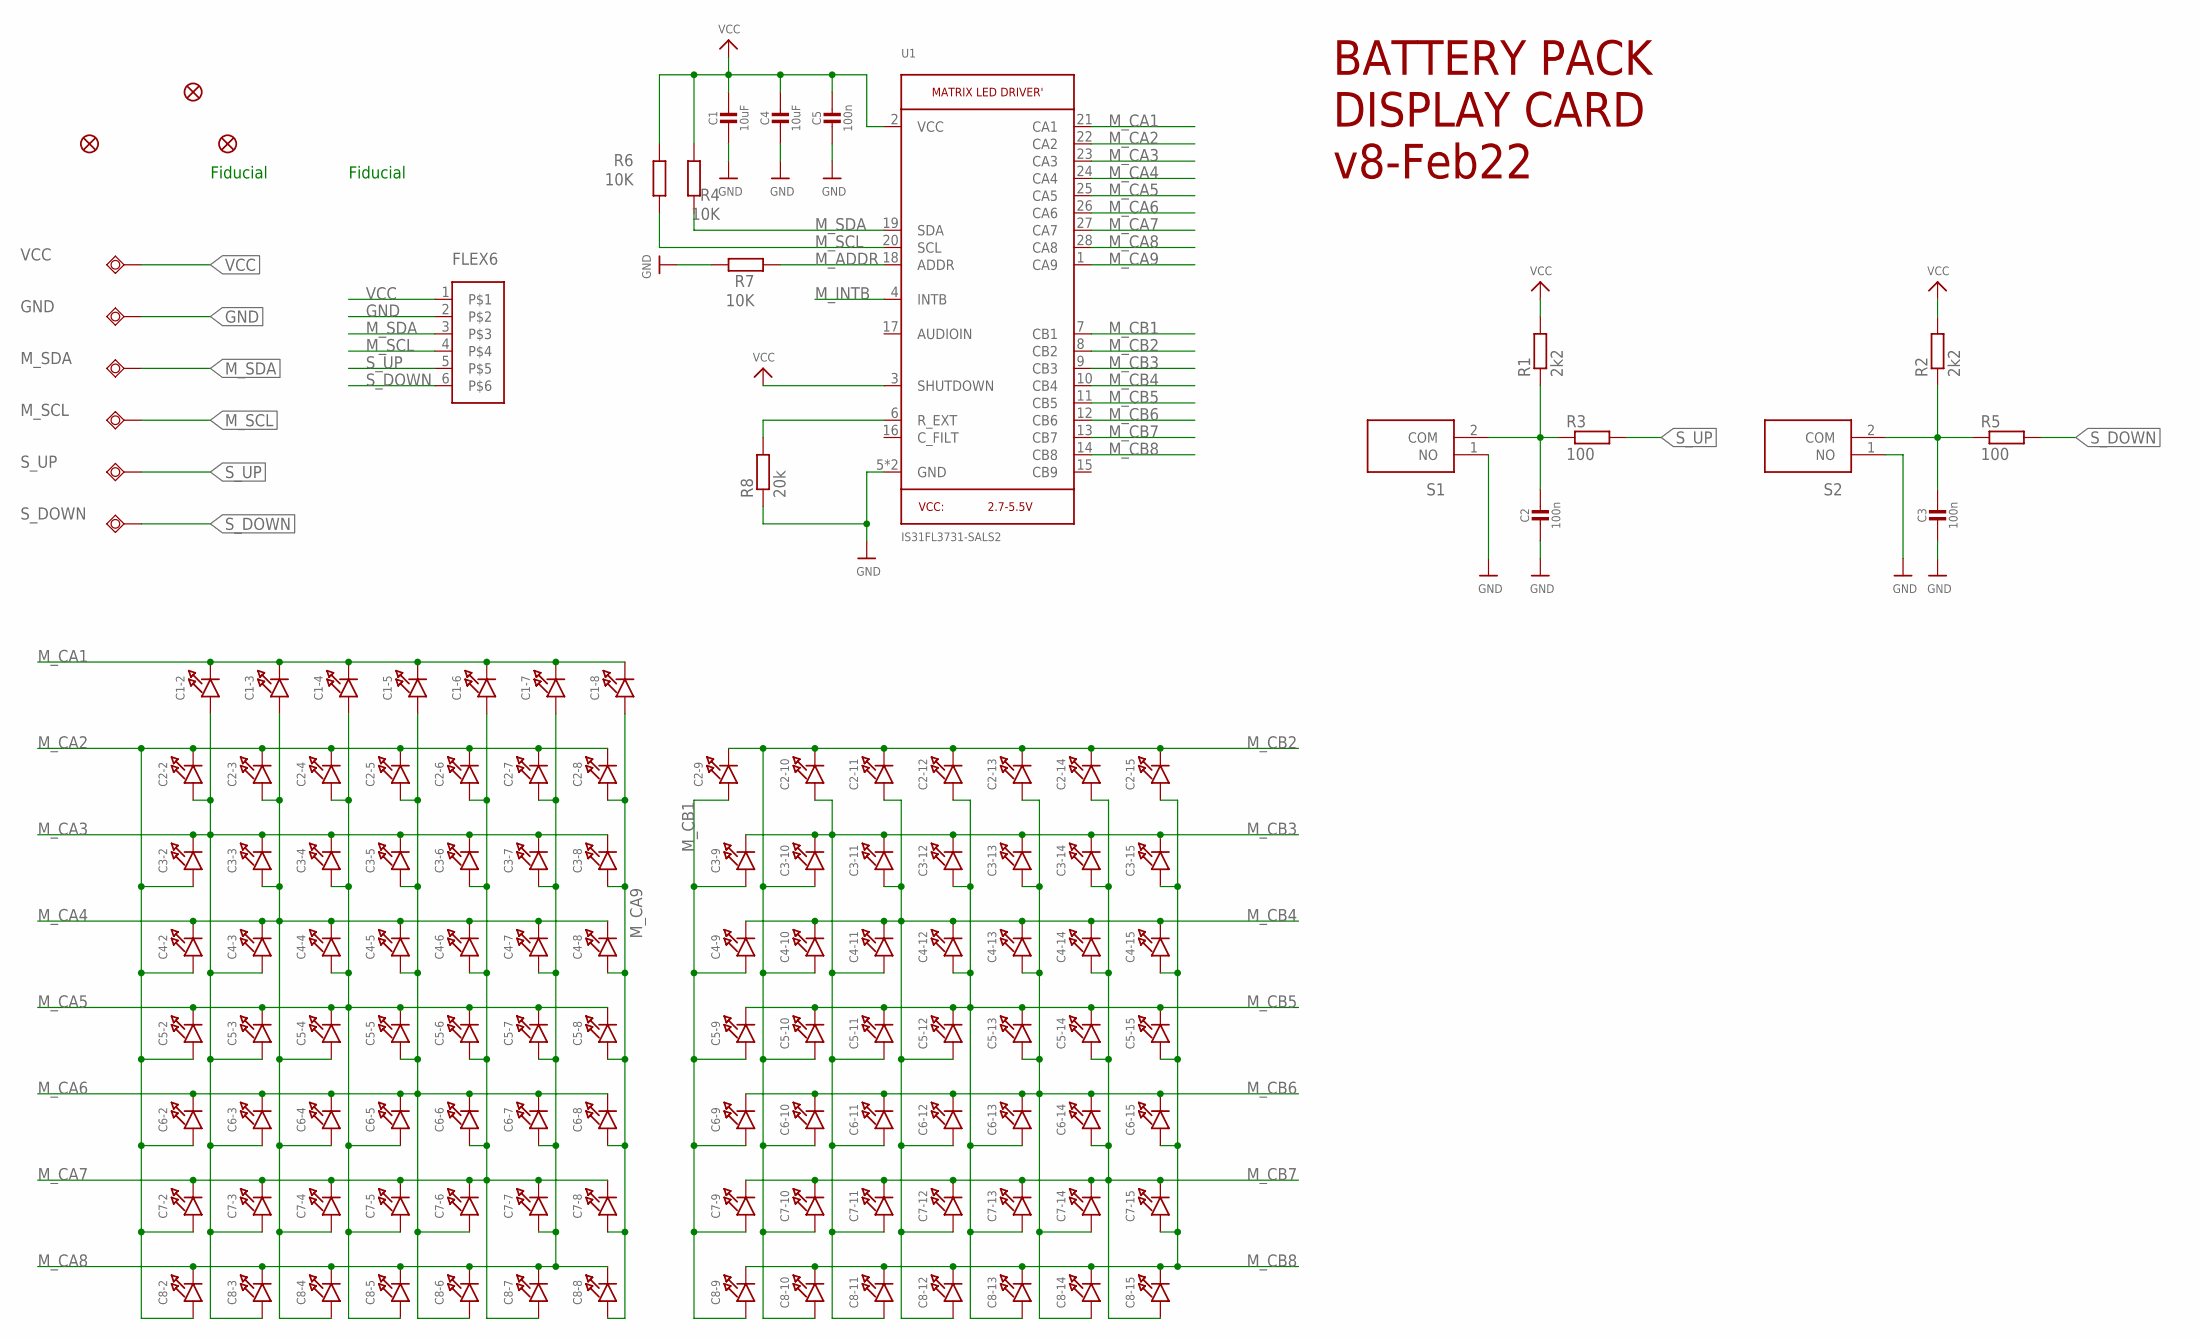
[picture p364: schematic BATT_DISP.sch]

Parts:
C1, C4: 10uF; 0805-NO
C1-2, C1-3, C1-4, C1-5, C1-6, C1-7, C1-8, C2-2, C2-3, C2-4, C2-5, C2-6, C2-7, C2-8, C2-9, C2-10, C2-11, C2-12, C2-13, C2-14, C2-15, C3-2, C3-3, C3-4, C3-5, C3-6, C3-7, C3-8, C3-9, C3-10, C3-11, C3-12, C3-13, C3-14, C3-15, C4-2, C4-3, C4-4, C4-5, C4-6, C4-7, C4-8, C4-9, C4-10, C4-11, C4-12, C4-13, C4-14, C4-15, C5-2, C5-3, C5-4, C5-5, C5-6, C5-7, C5-8, C5-9, C5-10, C5-11, C5-12, C5-13, C5-14, C5-15, C6-2, C6-3, C6-4, C6-5, C6-6, C6-7, C6-8, C6-9, C6-10, C6-11, C6-12, C6-13, C6-14, C6-15, C7-2, C7-3, C7-4, C7-5, C7-6, C7-7, C7-8, C7-9, C7-10, C7-11, C7-12, C7-13, C7-14, C7-15, C8-2, C8-3, C8-4, C8-5, C8-6, C8-7, C8-8, C8-9, C8-10, C8-11, C8-12, C8-13, C8-14, C8-15: LED0402_NOOUTLINE; CHIPLED_0402_NOOUTLINE
C2, C3, C5: 100n; 0805-NO
FD1: FIDUCIALUFIDUCIAL; FIDUCIAL-MICRO
FD2, FD3: FIDUCIAL""; FIDUCIAL_1MM
GND: TESTPAD_TPSQB1,27; TESTPAD_B1,27
K1: FLEX6
M_SCL: TESTPAD_TPSQB1,27; TESTPAD_B1,27
M_SDA: TESTPAD_TPSQB1,27; TESTPAD_B1,27
R1, R2: 2k2; R0603
R3, R5: 100; R0603
R4, R6, R7: 10K; R0603
R8: 20k; R0603
S1, S2: KXT311LHS
S_DOWN: TESTPAD_TPSQB1,27; TESTPAD_B1,27
S_UP: TESTPAD_TPSQB1,27; TESTPAD_B1,27
U1: IS31FL3731-SALS2; QFN28_4MM_0.4MM
VCC: TESTPAD_TPSQB1,27; TESTPAD_B1,27

Connections:
GND: C1.2, C2.2, C3.2, C4.2, C5.2, GND.TP, K1.2, R7.2, R8.1, S1.1 (NO), S2.1 (NO), U1.5 (GND)
M_ADDR: R7.1, U1.18 (ADDR)
M_CA1: C1-2.C, C1-3.C, C1-4.C, C1-5.C, C1-6.C, C1-7.C, C1-8.C, U1.21 (CA1)
M_CA2: C2-2.C, C2-3.C, C2-4.C, C2-5.C, C2-6.C, C2-7.C, C2-8.C, C3-2.A, C4-2.A, C5-2.A, C6-2.A, C7-2.A, C8-2.A, U1.22 (CA2)
M_CA3: C1-2.A, C2-2.A, C3-2.C, C3-3.C, C3-4.C, C3-5.C, C3-6.C, C3-7.C, C3-8.C, C4-3.A, C5-3.A, C6-3.A, C7-3.A, C8-3.A, U1.23 (CA3)
M_CA4: C1-3.A, C2-3.A, C3-3.A, C4-2.C, C4-3.C, C4-4.C, C4-5.C, C4-6.C, C4-7.C, C4-8.C, C5-4.A, C6-4.A, C7-4.A, C8-4.A, U1.24 (CA4)
M_CA5: C1-4.A, C2-4.A, C3-4.A, C4-4.A, C5-2.C, C5-3.C, C5-4.C, C5-5.C, C5-6.C, C5-7.C, C5-8.C, C6-5.A, C7-5.A, C8-5.A, U1.25 (CA5)
M_CA6: C1-5.A, C2-5.A, C3-5.A, C4-5.A, C5-5.A, C6-2.C, C6-3.C, C6-4.C, C6-5.C, C6-6.C, C6-7.C, C6-8.C, C7-6.A, C8-6.A, U1.26 (CA6)
M_CA7: C1-6.A, C2-6.A, C3-6.A, C4-6.A, C5-6.A, C6-6.A, C7-2.C, C7-3.C, C7-4.C, C7-5.C, C7-6.C, C7-7.C, C7-8.C, C8-7.A, U1.27 (CA7)
M_CA8: C1-7.A, C2-7.A, C3-7.A, C4-7.A, C5-7.A, C6-7.A, C7-7.A, C8-2.C, C8-3.C, C8-4.C, C8-5.C, C8-6.C, C8-7.C, C8-8.C, U1.28 (CA8)
M_CA9: C1-8.A, C2-8.A, C3-8.A, C4-8.A, C5-8.A, C6-8.A, C7-8.A, C8-8.A, U1.1 (CA9)
M_CB1: C2-9.A, C3-9.A, C4-9.A, C5-9.A, C6-9.A, C7-9.A, C8-9.A, U1.7 (CB1)
M_CB2: C2-9.C, C2-10.C, C2-11.C, C2-12.C, C2-13.C, C2-14.C, C2-15.C, C3-10.A, C4-10.A, C5-10.A, C6-10.A, C7-10.A, C8-10.A, U1.8 (CB2)
M_CB3: C2-10.A, C3-9.C, C3-10.C, C3-11.C, C3-12.C, C3-13.C, C3-14.C, C3-15.C, C4-11.A, C5-11.A, C6-11.A, C7-11.A, C8-11.A, U1.9 (CB3)
M_CB4: C2-11.A, C3-11.A, C4-9.C, C4-10.C, C4-11.C, C4-12.C, C4-13.C, C4-14.C, C4-15.C, C5-12.A, C6-12.A, C7-12.A, C8-12.A, U1.10 (CB4)
M_CB5: C2-12.A, C3-12.A, C4-12.A, C5-9.C, C5-10.C, C5-11.C, C5-12.C, C5-13.C, C5-14.C, C5-15.C, C6-13.A, C7-13.A, C8-13.A, U1.11 (CB5)
M_CB6: C2-13.A, C3-13.A, C4-13.A, C5-13.A, C6-9.C, C6-10.C, C6-11.C, C6-12.C, C6-13.C, C6-14.C, C6-15.C, C7-14.A, C8-14.A, U1.12 (CB6)
M_CB7: C2-14.A, C3-14.A, C4-14.A, C5-14.A, C6-14.A, C7-9.C, C7-10.C, C7-11.C, C7-12.C, C7-13.C, C7-14.C, C7-15.C, C8-15.A, U1.13 (CB7)
M_CB8: C2-15.A, C3-15.A, C4-15.A, C5-15.A, C6-15.A, C7-15.A, C8-9.C, C8-10.C, C8-11.C, C8-12.C, C8-13.C, C8-14.C, C8-15.C, U1.14 (CB8)
M_INTB: U1.4 (INTB)
M_SCL: K1.4, M_SCL.TP, R6.1, U1.20 (SCL)
M_SDA: K1.3, M_SDA.TP, R4.1, U1.19 (SDA)
unnamed: C3.1, R2.1, R5.1, S2.2 (COM)
unnamed: C2.1, R1.1, R3.1, S1.2 (COM)
R_EXT: R8.2, U1.6 (R_EXT)
S_DOWN: K1.6, R5.2, S_DOWN.TP
S_UP: K1.5, R3.2, S_UP.TP
VCC: C1.1, C4.1, C5.1, K1.1, R1.2, R2.2, R4.2, R6.2, U1.2 (VCC), U1.3 (SHUTDOWN), VCC.TP

Notes on the sheet:
Fiducial
BATTERY PACK DISPLAY CARD v8-Feb22
