MSTKMAD/battery-pack/02.Hardware/V1-ROVER-2K/Battery PCBs/BATT_INPUT/BATT_INPUT.sch

## EAGLE design 02.Hardware/V1-ROVER-2K/Battery PCBs/BATT_INPUT/BATT_INPUT.sch (2022-09-29)

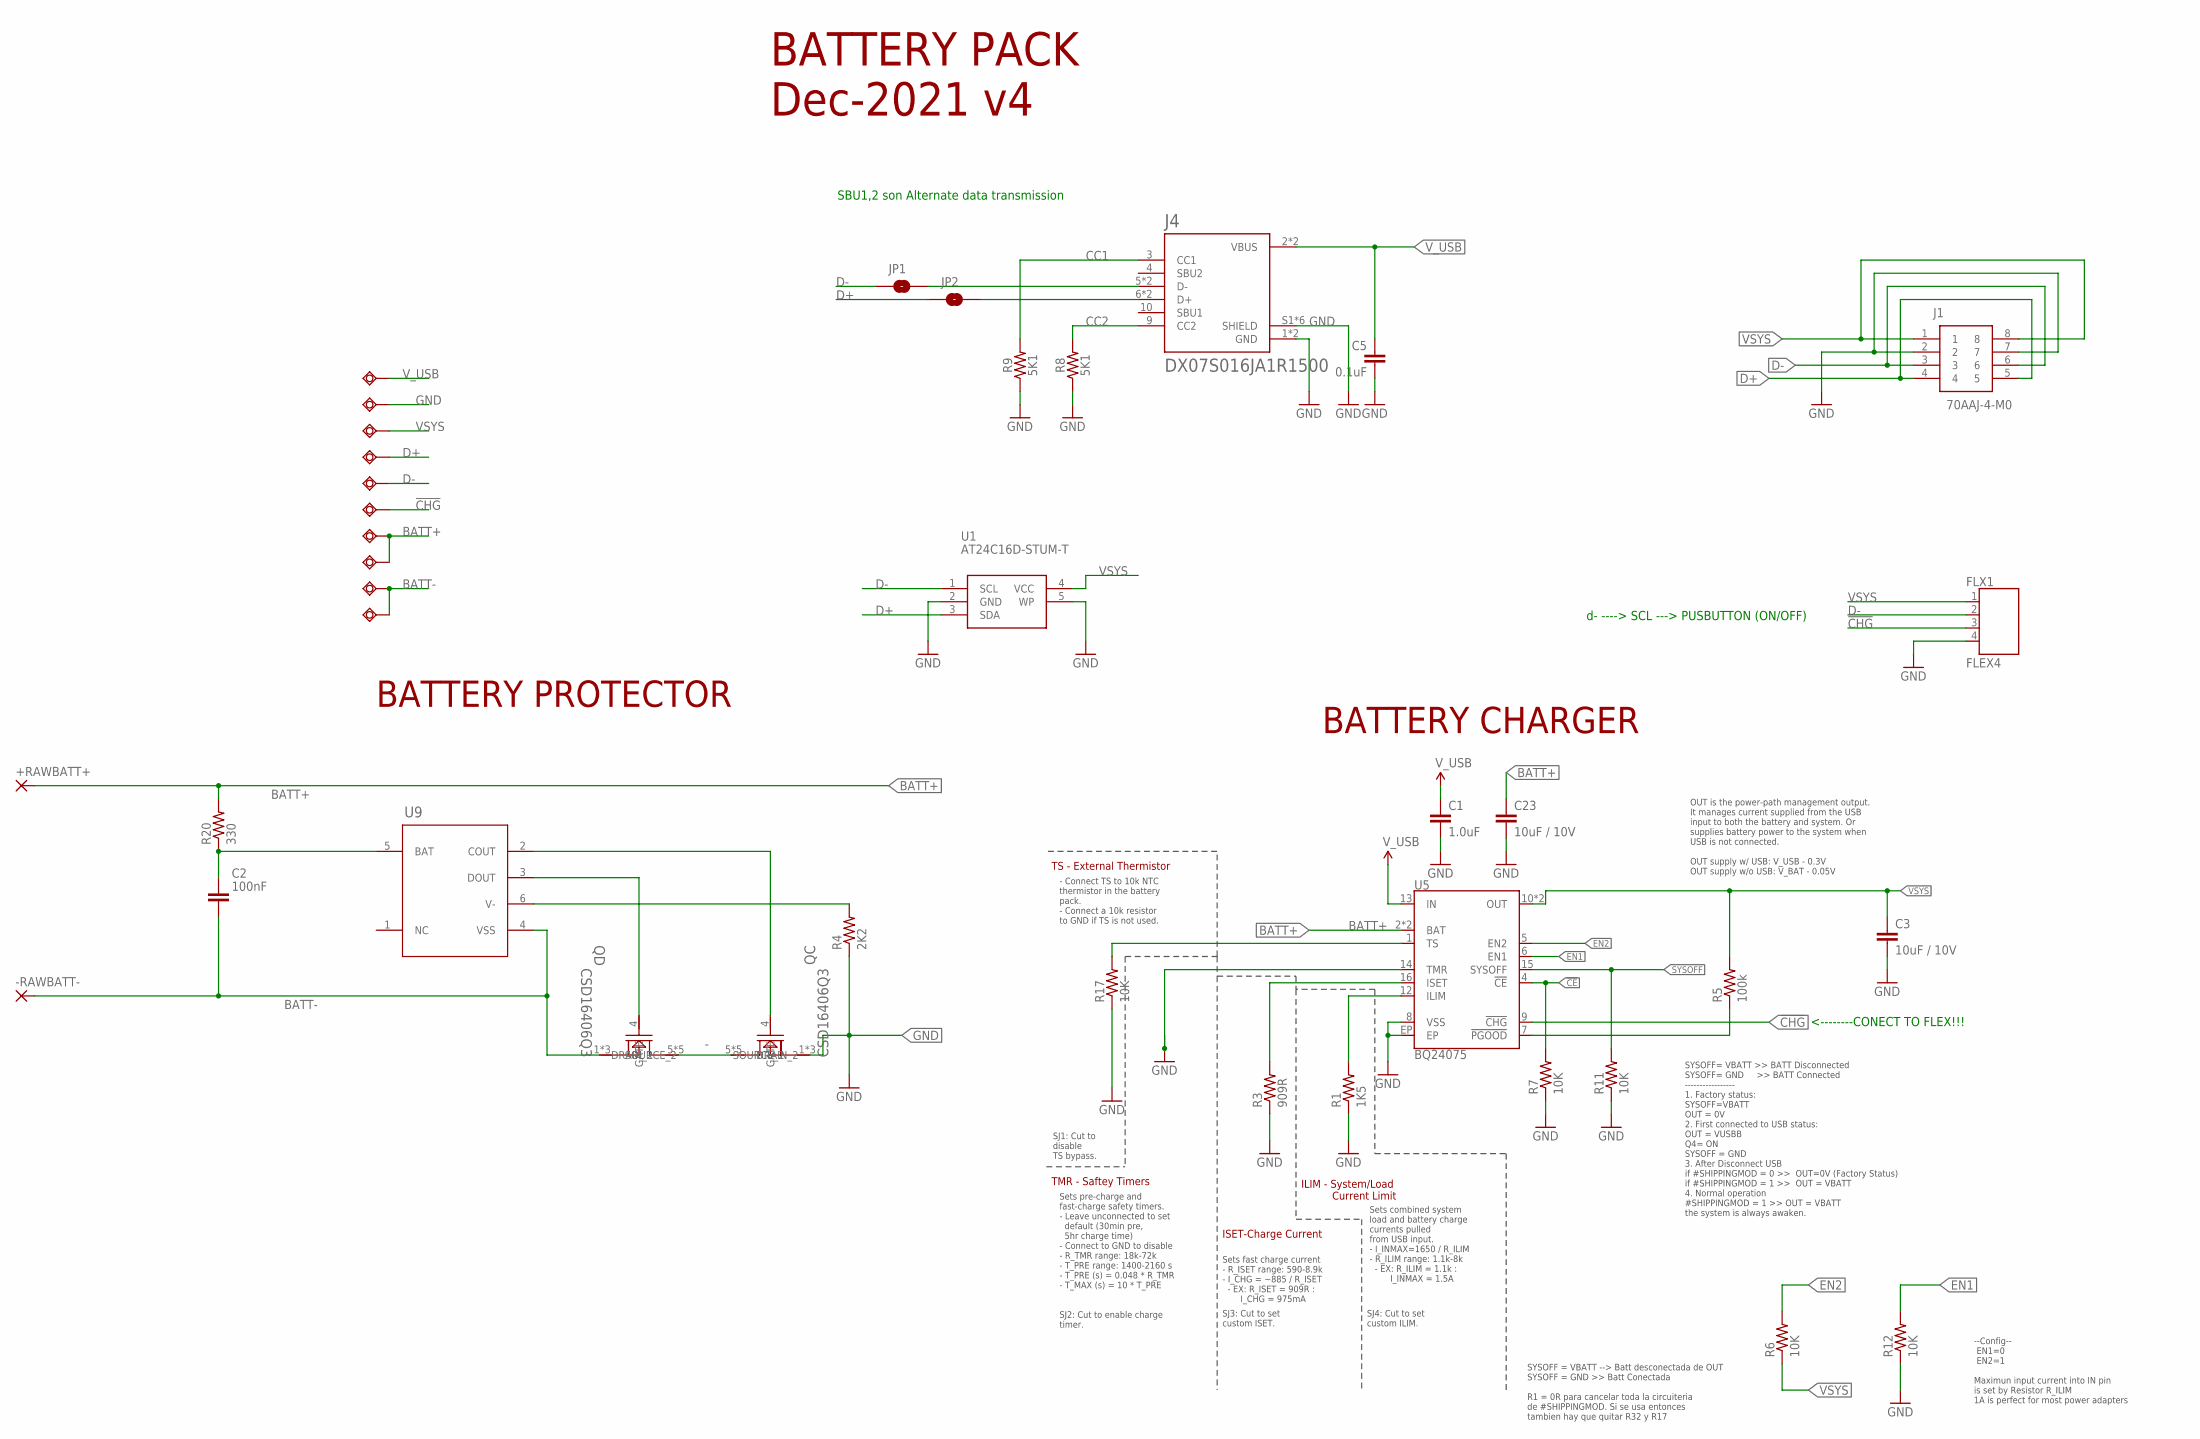
[picture p365: schematic BATT_INPUT.sch]

Parts:
!CHG!: TESTPAD_TPSQB1,27; TESTPAD_B1,27
+RAWBATT+: SMD5; SMD2,54-5,08
-RAWBATT-: SMD5; SMD2,54-5,08
BATT+1, BATT+2: TESTPAD_TPSQB1,27; TESTPAD_B1,27
BATT-1, BATT-2: TESTPAD_TPSQB1,27; TESTPAD_B1,27
C1: 1.0uF; 0603
C2: 100nF; CAPC1608X85
C3, C23: 10uF / 10V; 0805-CAP
C5: 0.1uF; 0603
D+: TESTPAD_TPSQB1,27; TESTPAD_B1,27
D-: TESTPAD_TPSQB1,27; TESTPAD_B1,27
FLX1: FLEX4
GND: TESTPAD_TPSQB1,27; TESTPAD_B1,27
J1: 70AAJ-4-M0; 70AAJ4M0
J4: DX07S016JA1R1500; JAE_DX07S016JA1R1500
JP1, JP2: JUMPER-SMT_2_NO_SILK; SMT-JUMPER_2_NO_SILK
QC: CSD16406Q3; DQG0008A
QD: CSD16406Q3; DQG0008A
R1: 1K5; 0402
R3: 909R; 0402
R4: 2K2; 0402
R5: 100k; 0402
R6, R7, R11, R12, R17: 10K; 0402
R8, R9: 5K1; 0402
R20: 330; 0402
U1: AT24C16D-STUM-T; SOT95P280X100-5N
U5: BQ24075; PVQFN-N16
U9: BQ29700DSER; DSE0006A
VSYS: TESTPAD_TPSQB1,27; TESTPAD_B1,27
V_USB: TESTPAD_TPSQB1,27; TESTPAD_B1,27

Connections:
!CE!: R7.2, U5.4 (!CE!)
!CHG!: !CHG!.TP, FLX1.3, U5.9 (!CHG!)
-: QC.5 (DRAIN_2), QD.5 (DRAIN_2)
BATT+: +RAWBATT+.1, BATT+1.TP, BATT+2.TP, C23.1, R20.2, U5.2 (BAT)
BATT-: -RAWBATT-.1, BATT-1.TP, BATT-2.TP, C2.2, QD.1 (SOURCE_2), U9.4 (VSS)
CC1: J4.3 (CC1), R9.2
CC2: J4.9 (CC2), R8.2
D+: D+.TP, J1.4, J1.5, JP2.1, U1.3 (SDA)
D-: D-.TP, FLX1.2, J1.3, J1.6, JP1.1, U1.1 (SCL)
EN1: R12.2, U5.6 (EN1)
EN2: R6.2, U5.5 (EN2)
GND: C1.2, C3.2, C5.2, C23.2, FLX1.4, GND.TP, J1.2, J1.7, J4.1 (GND), J4.S1 (SHIELD), QC.1 (SOURCE_2), R1.1, R3.1, R4.1, R7.1, R8.1, R9.1, R11.1, R12.1, R17.1, U1.2 (GND), U1.5 (WP), U5.8 (VSS), U5.14 (TMR), U5.EP
ILIM: R1.2, U5.12 (ILIM)
ISET: R3.2, U5.16 (ISET)
unnamed: R5.1, U5.7 (!PGOOD!)
unnamed: J4.5 (D-), JP1.2
unnamed: J4.6 (D+), JP2.2
unnamed: C2.1, R20.1, U9.5 (BAT)
unnamed: R4.2, U9.6 (V-)
unnamed: QC.4 (GATE), U9.2 (COUT)
unnamed: QD.4 (GATE), U9.3 (DOUT)
SYSOFF: R11.2, U5.15 (SYSOFF)
TS1: R17.2, U5.1 (TS)
VSYS: C3.1, FLX1.1, J1.1, J1.8, R5.2, R6.1, U1.4 (VCC), U5.10 (OUT), VSYS.TP
V_USB: C1.1, C5.1, J4.2 (VBUS), U5.13 (IN), V_USB.TP

Notes on the sheet:
BATTERY PACK Dec-2021 v4
Sets fast charge current - R_ISET range: 590-8.9k - I_CHG = ~885 / R_ISET - EX: R_ISET = 909R : I_CHG = 975mA
Sets combined system load and battery charge currents pulled from USB input. - I_INMAX=1650 / R_ILIM - R_ILIM range: 1.1k-8k - EX: R_ILIM = 1.1k : I_INMAX = 1.5A
SJ1: Cut to disable TS bypass.
SJ3: Cut to set custom ISET.
SJ4: Cut to set custom ILIM.
ILIM - System/Load Current Limit
ISET-Charge Current
TMR - Saftey Timers
Sets pre-charge and fast-charge safety timers. - Leave unconnected to set default (30min pre, 5hr charge time) - Connect to GND to disable - R_TMR range: 18k-72k - T_PRE range: 1400-2160 s - T_PRE (s) = 0.048 * R_TMR - T_MAX (s) = 10 * T_PRE
SJ2: Cut to enable charge timer.
TS - External Thermistor
- Connect TS to 10k NTC thermistor in the battery pack. - Connect a 10k resistor to GND if TS is not used.
OUT is the power-path management output. It manages current supplied from the USB input to both the battery and system. Or supplies battery power to the system when USB is not connected. OUT supply w/ USB: V_USB - 0.3V OUT supply w/o USB: V_BAT - 0.05V
SYSOFF= VBATT >> BATT Disconnected SYSOFF= GND >> BATT Connected ----------------- 1. Factory status: SYSOFF=VBATT OUT = 0V 2. First connected to USB status: OUT = VUSBB Q4= ON SYSOFF = GND 3. After Disconnect USB if #SHIPPINGMOD = 0 >> OUT=0V (Factory Status) if #SHIPPINGMOD = 1 >> OUT = VBATT 4. 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
SYSOFF = VBATT --> Batt desconectada de OUT SYSOFF = GND >> Batt Conectada R1 = 0R para cancelar toda la circuiteria de #SHIPPINGMOD. Si se usa entonces tambien hay que quitar R32 y R17
--Config-- EN1=0 EN2=1 Maximun input current into IN pin is set by Resistor R_ILIM 1A is perfect for most power adapters
BATTERY PROTECTOR
BATTERY CHARGER
<--------CONECT TO FLEX!!!
d- ----> SCL ---> PUSBUTTON (ON/OFF)
SBU1,2 son Alternate data transmission
