MSTKMAD/battery-pack/02.Hardware/V1-ROVER-2K/Battery PCBs/BOOSTDCDC_BATT/BOOSTDCDC_BATT.sch

## EAGLE design 02.Hardware/V1-ROVER-2K/Battery PCBs/BOOSTDCDC_BATT/BOOSTDCDC_BATT.sch (2022-04-11)

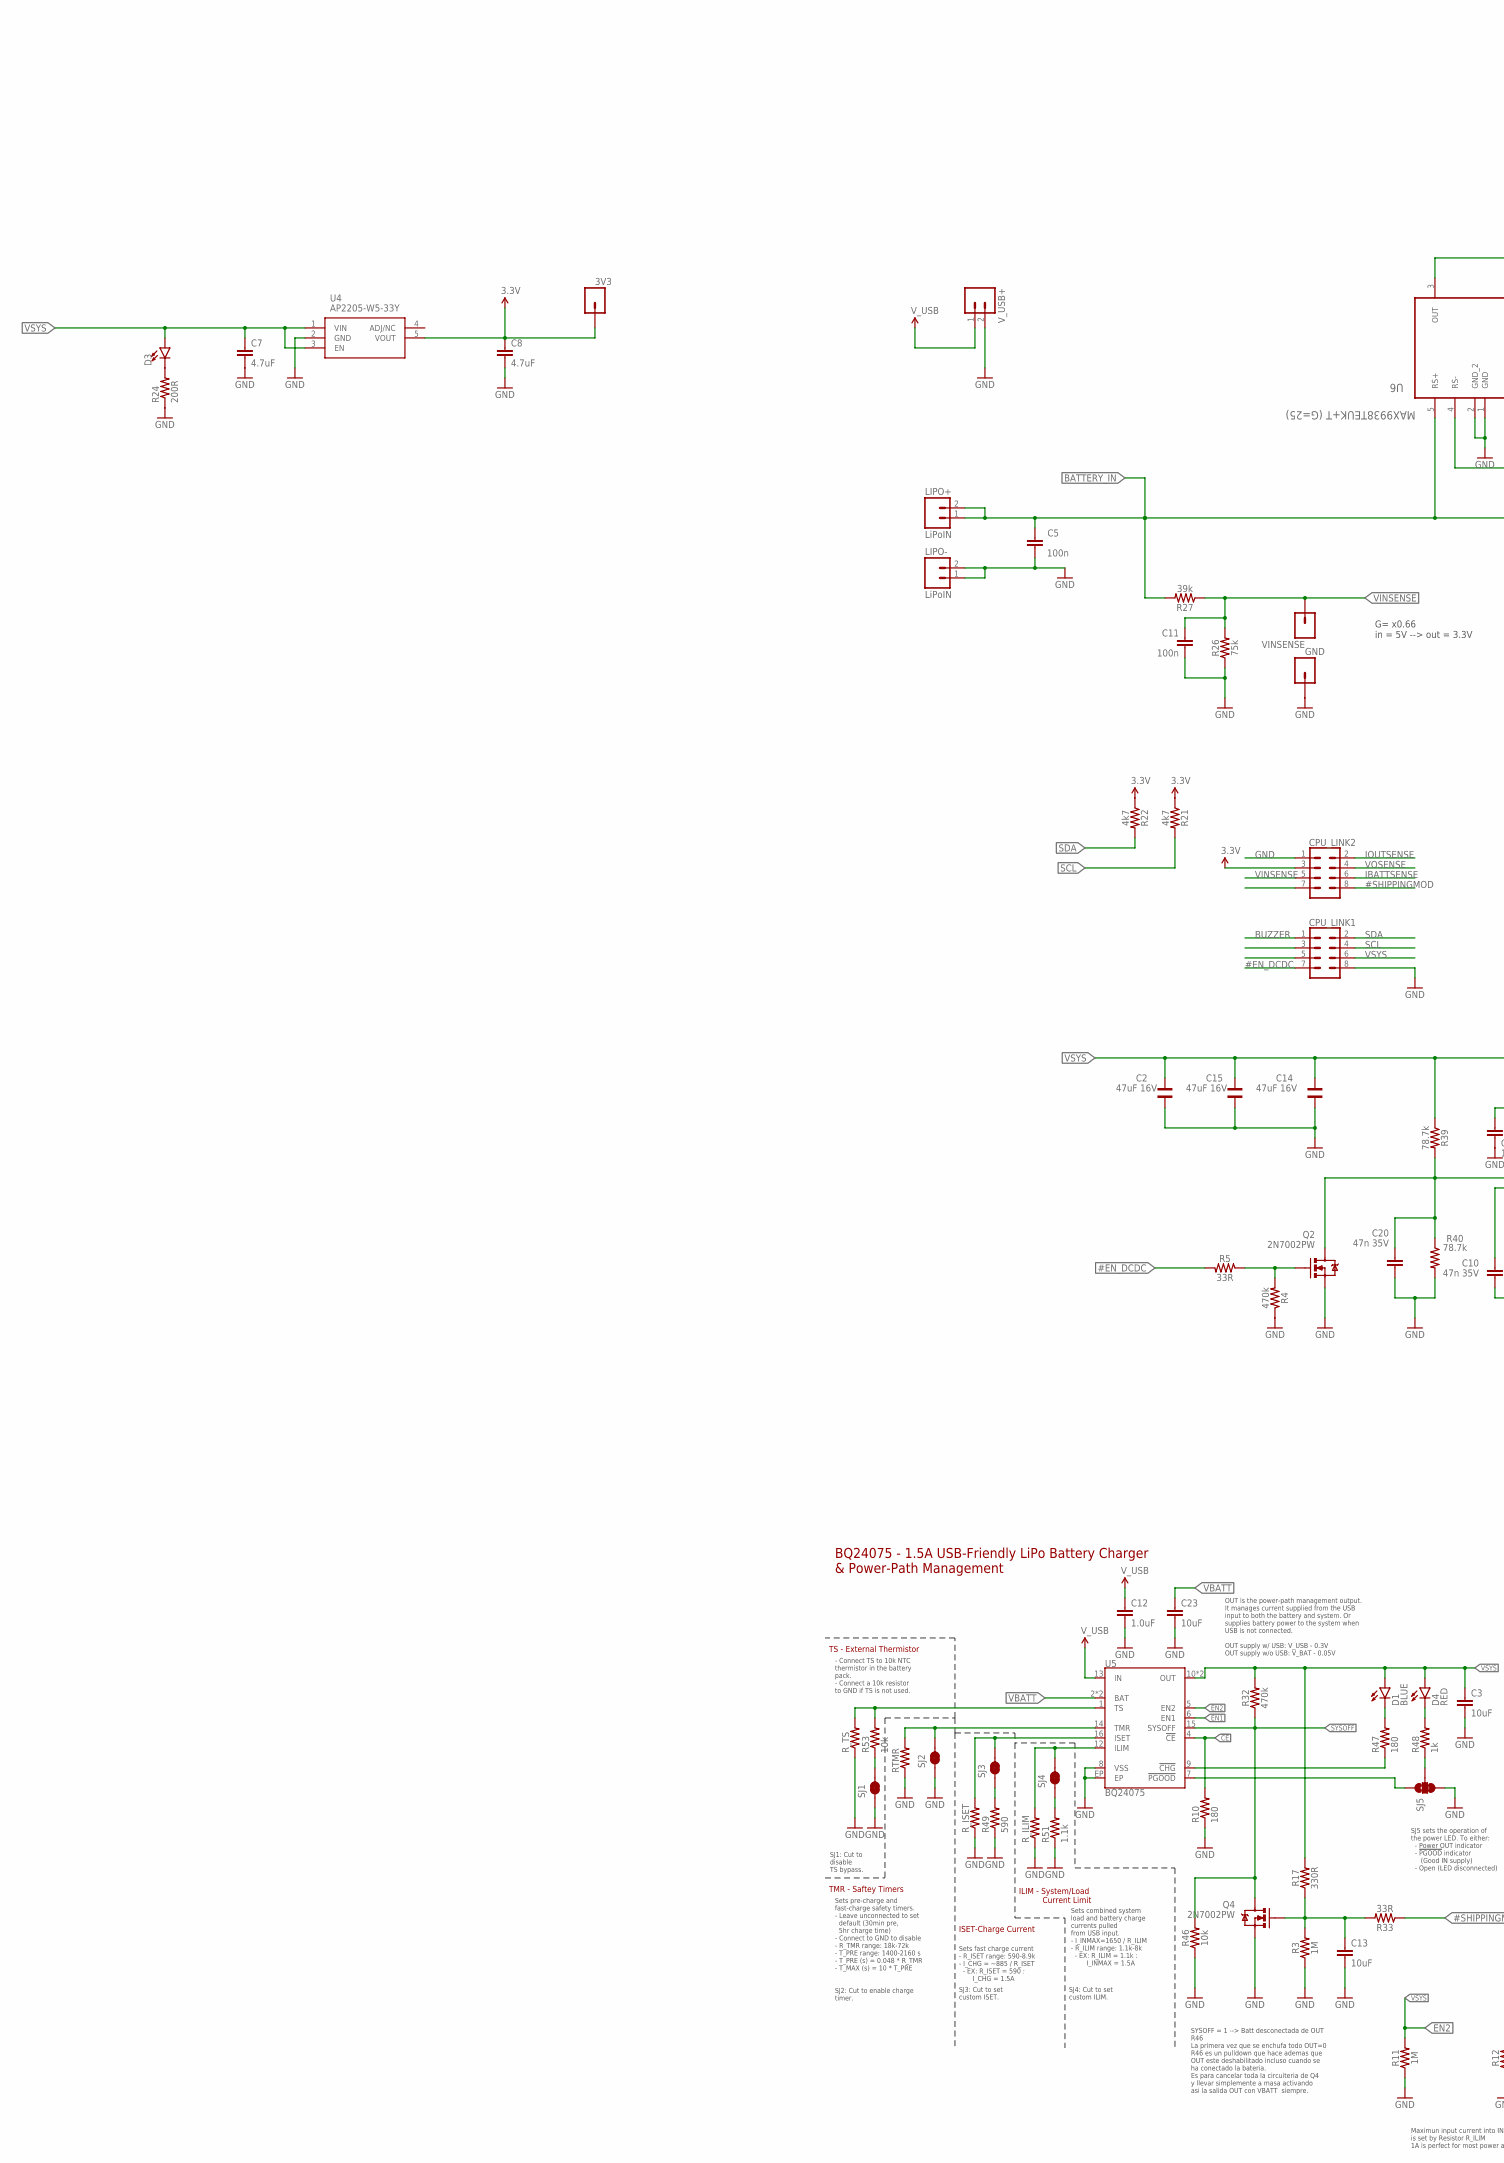
[picture p366: schematic BOOSTDCDC_BATT.sch, part in row 1, column 1]

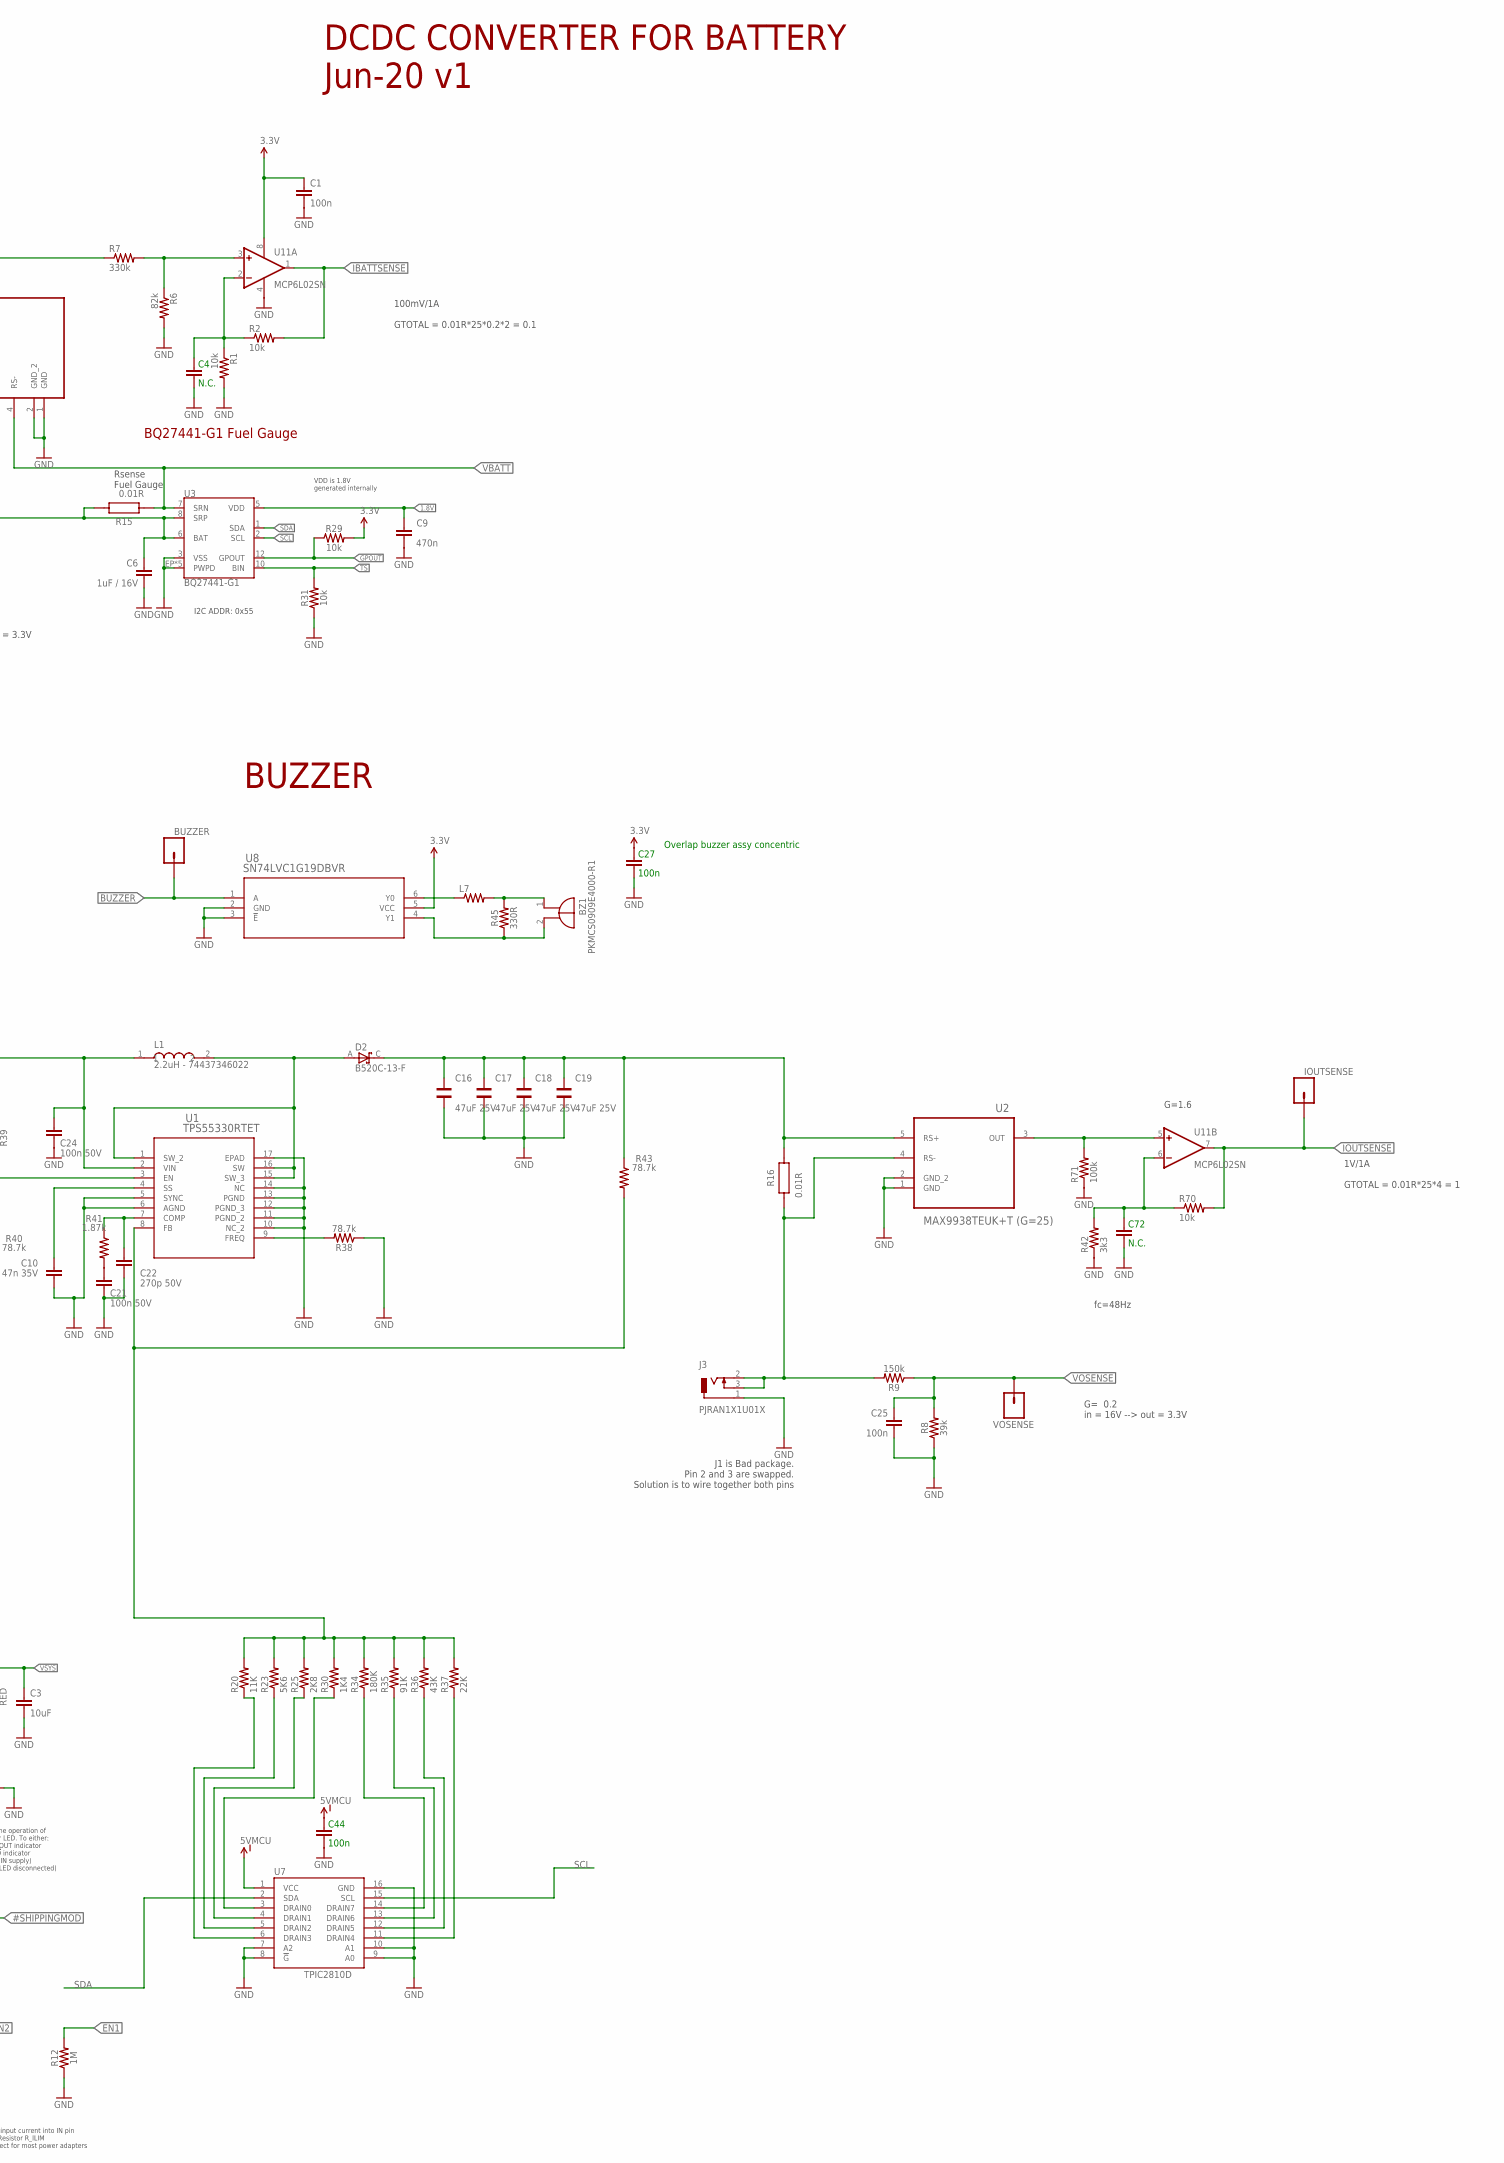
[picture p367: schematic BOOSTDCDC_BATT.sch, part in row 1, column 2]

Parts:
3V3: M01PTH_2MM; 1X01_2MM
BUZZER: M01PTH_2MM; 1X01_2MM
BZ1: PKMCS0909E4000-R1; PKMCS0909
C1, C27, C44: 100n; 0805
C2, C14, C15: 47uF 16V; WCAP-CSGP_1210
C3, C13, C23: 10uF; 0805-CAP
C4, C72: N.C.; 0805
C5, C11, C25: 100n; 0805@1
C6: 1uF / 16V; 0805@1
C7, C8: 4.7uF; 0805
C9: 470n; 0805@1
C10, C20: 47n 35V; 0805@1
C12: 1.0uF; 1206-CAP
C16, C17, C18, C19: 47uF 25V; WCAP-CSGP_1210
C21, C24: 100n 50V; 0805@1
C22: 270p 50V; 0805@1
CPU_LINK1, CPU_LINK2: CONN_04X2; 2X4
D1: BLUE; LED-0603
D2: B520C-13-F; DIOM7959X250N
D3: LED3MM; LED_3MM
D4: RED; LED-0603
GND: M01PTH_2MM; 1X01_2MM
IOUTSENSE: M01PTH_2MM; 1X01_2MM
J3: PJRAN1X1U01X
L1: 2.2uH - 74437346022; INDM7366X500
L7: MMZ2012Y202BT000; 0805
LIPO+: LiPoIN; 1X02
LIPO-: LiPoIN; 1X02
Q2, Q4: 2N7002PW; SOT323
R1, R2, R29, R31, R46, R53, R70: 10k; 0805
R3, R11, R12: 1M; 0805
R4, R32: 470k; 0805
R5, R33: 33R; 0805
R6: 82k; 0805
R7: 330k; 0805
R8, R27: 39k; 0805
R9: 150k; 0805
R10, R47: 180; 0805
R15, R16: 0.01R; WRIS-KWKH_0612
R17, R45: 330R; 0805
R20: 11K; 0805
R21, R22: 4k7; 0805
R23: 5K6; 0805
R24: 200R; 0805
R25: 2K8; 0805
R26: 75k; 0805
R30: 1K4; 0805
R34: 180K; 0805
R35: 91K; 0805
R36: 43K; 0805
R37: 22K; 0805
R38, R39, R40, R43: 78.7k; 0805
R41: 1.87k; 0805
R42: 3k3; 0805
R48: 1k; 0805
R49: 590; 0805
R51: 1.1k; 0805
R71: 100k; 0805
RTMR: RESISTOR0805-RES; 0805
R_ILIM: RESISTOR0805-RES; 0805
R_ISET: RESISTOR0805-RES; 0805
R_TS: RESISTOR0805-RES; 0805
SJ1, SJ2, SJ3, SJ4: JUMPER-PAD-2-NC_BY_TRACE; PAD-JUMPER-2-NC_BY_TRACE_YES_SILK
SJ5: JUMPER-PAD-3-2OF3_NC_BY_TRACE_SMALL; PAD-JUMPER-3-2OF3_NC_BY_TRACE_YES_SILK_FULL_BOX
U1: TPS55330RTET; RTE16_1P66X1P66_TEX
U2, U6: MAX9938TEUK+T (G=25); SOT95P280X145-5N
U3: BQ27441-G1; PDSO-N12
U4: AP2205-W5-33Y; SOT95P282X145-5N
U5: BQ24075; PVQFN-N16
U7: TPIC2810D; SO16
U8: SN74LVC1G19DBVR; DBV6
U11: MCP6L02SN; SO08
VINSENSE: M01PTH_2MM; 1X01_2MM
VOSENSE: M01PTH_2MM; 1X01_2MM
V_USB+: M02PTH; 1X02

Connections:
1.8V: C9.1, U3.5 (VDD)
3.3V: 3V3.1, C1.1, C8.1, C27.2, CPU_LINK2.3, R21.1, R22.1, R29.2, U4.5 (VOUT), U8.5 (VCC), U11.8 (V+)
!CE!: R10.2, U5.4 (!CE!)
!CHG!: R47.1, U5.9 (!CHG!)
!PGOOD!: SJ5.1, U5.7 (!PGOOD!)
#EN_DCDC: CPU_LINK1.7, R5.2
#SHIPPINGMOD: CPU_LINK2.8, R33.1
BATTERY_IN: C5.1, C6.1, LIPO+.1, LIPO+.2, R15.2, R27.2, U3.6 (BAT), U3.8 (SRP), U6.5 (RS+)
BUZZER: BUZZER.1, CPU_LINK1.1, U8.1 (A)
EN1: R12.2, U5.6 (EN1)
EN2: R11.2, U5.5 (EN2)
GND: C1.2, C2.1, C3.2, C4.1, C5.2, C6.2, C7.2, C8.2, C9.2, C10.2, C11.2, C12.2, C13.2, C14.1, C15.1, C16.1, C17.1, C18.1, C19.1, C20.2, C21.1, C22.1, C23.2, C24.1, C25.2, C27.1, C44.1, C72.1, CPU_LINK1.8, CPU_LINK2.1, GND.1, J3.1, LIPO-.1, LIPO-.2, Q2.2 (S), Q4.2 (S), R1.2, R3.1, R4.1, R6.2, R8.1, R10.1, R11.1, R12.1, R24.1, R26.1, R31.1, R38.1, R40.2, R42.1, R46.1, R49.1, R51.1, R71.1, RTMR.1, R_ILIM.1, R_ISET.1, R_TS.1, SJ1.1, SJ2.1, SJ5.3, U1.5 (SYNC), U1.6 (AGND), U1.10 (NC_2), U1.11 (PGND_2), U1.12 (PGND_3), U1.13 (PGND), U1.14 (NC), U1.17 (EPAD), U2.1 (GND), U2.2 (GND_2), U3.3 (VSS), U3.EP (PWPD), U4.2 (GND), U5.8 (VSS), U5.EP, U6.1 (GND), U6.2 (GND_2), U7.7 (A2), U7.8 (!G), U7.9 (A0), U7.10 (A1), U7.16 (GND), U8.2 (GND), U8.3 (!E), U11.4 (V-), V_USB+.2
GPOUT: R29.1, U3.12 (GPOUT)
IBATTSENSE: CPU_LINK2.6, R2.2, U11.1 (OUT)
ILIM: R_ILIM.2, SJ4.2, U5.12 (ILIM)
IOUTSENSE: CPU_LINK2.2, IOUTSENSE.1, R70.2, U11.7 (OUT)
ISET: R_ISET.2, SJ3.2, U5.16 (ISET)
unnamed: D4.C, R48.2
unnamed: Q2.1 (G), R4.2, R5.1
unnamed: D1.C, R47.2
unnamed: R53.1, SJ1.2
unnamed: R71.2, U2.3 (OUT), U11.5 (+IN)
unnamed: R51.2, SJ4.1
unnamed: C4.2, R1.1, R2.1, U11.2 (-IN)
unnamed: R6.1, R7.2, U11.3 (+IN)
unnamed: J3.2, J3.3, R9.2, R16.1, U2.4 (RS-)
unnamed: R49.2, SJ3.1
unnamed: R48.1, SJ5.2
unnamed: R20.1, U7.6 (DRAIN3)
unnamed: L7.1, U8.6 (Y0)
unnamed: D3.K (C), R24.2
unnamed: BZ1.1 (+), L7.2, R45.2
unnamed: R23.1, U7.5 (DRAIN2)
unnamed: BZ1.2 (-), R45.1, U8.4 (Y1)
unnamed: C13.1, Q4.1 (G), R3.2, R17.1, R33.2
unnamed: R25.1, U7.4 (DRAIN1)
unnamed: R30.1, U7.3 (DRAIN0)
unnamed: R34.1, U7.14 (DRAIN7)
unnamed: R35.1, U7.13 (DRAIN6)
unnamed: R36.1, U7.12 (DRAIN5)
unnamed: R37.1, U7.11 (DRAIN4)
unnamed: C10.1, U1.4 (SS)
unnamed: D2.A, L1.2, U1.1 (SW_2), U1.15 (SW_3), U1.16 (SW)
unnamed: R38.2, U1.9 (FREQ)
unnamed: C20.1, Q2.3 (D), R39.2, R40.1, U1.3 (EN)
unnamed: C21.2, R41.2
unnamed: C22.2, R41.1, U1.7 (COMP)
unnamed: R20.2, R23.2, R25.2, R30.2, R34.2, R35.2, R36.2, R37.2, R43.2, U1.8 (FB)
unnamed: R7.1, U6.3 (OUT)
unnamed: C72.2, R42.2, R70.1, U11.6 (-IN)
SCL: CPU_LINK1.4, R21.2, U3.2 (SCL), U7.15 (SCL)
SDA: CPU_LINK1.2, R22.2, U3.1 (SDA), U7.2 (SDA)
SYSOFF: Q4.3 (D), R32.1, R46.2, U5.15 (SYSOFF)
TMR: RTMR.2, SJ2.2, U5.14 (TMR)
TS: R31.2, U3.10 (BIN)
TS1: R53.2, R_TS.2, U5.1 (TS)
VBATT: C23.1, R15.1, U3.7 (SRN), U5.2 (BAT), U6.4 (RS-)
VCC-ISO: C44.2, U7.1 (VCC)
VINSENSE: C11.1, CPU_LINK2.5, R26.2, R27.1, VINSENSE.1
VOSENSE: C25.1, CPU_LINK2.4, R8.2, R9.1, VOSENSE.1
VSOURCE: C16.2, C17.2, C18.2, C19.2, D2.C, R16.2, R43.1, U2.5 (RS+)
VSYS: C2.2, C3.1, C7.1, C14.2, C15.2, C24.2, CPU_LINK1.6, D1.A, D3.A, D4.A, L1.1, R17.2, R32.2, R39.1, U1.2 (VIN), U4.1 (VIN), U4.3 (EN), U5.10 (OUT)
V_USB: C12.1, U5.13 (IN), V_USB+.1

Notes on the sheet:
1V/1A GTOTAL = 0.01R*25*4 = 1
J1 is Bad package. Pin 2 and 3 are swapped. Solution is to wire together both pins
G= x0.66 in = 5V --> out = 3.3V
fc=48Hz
G=1.6
BQ27441-G1 Fuel Gauge
VDD is 1.8V generated internally
I2C ADDR: 0x55
Rsense Fuel Gauge
DCDC CONVERTER FOR BATTERY Jun-20 v1
Sets fast charge current - R_ISET range: 590-8.9k - I_CHG = ~885 / R_ISET - EX: R_ISET = 590 : I_CHG = 1.5A
Sets combined system load and battery charge currents pulled from USB input. - I_INMAX=1650 / R_ILIM - R_ILIM range: 1.1k-8k - EX: R_ILIM = 1.1k : I_INMAX = 1.5A
BQ24075 - 1.5A USB-Friendly LiPo Battery Charger & Power-Path Management
SJ1: Cut to disable TS bypass.
SJ3: Cut to set custom ISET.
SJ4: Cut to set custom ILIM.
ILIM - System/Load Current Limit
ISET-Charge Current
TMR - Saftey Timers
Sets pre-charge and fast-charge safety timers. - Leave unconnected to set default (30min pre, 5hr charge time) - Connect to GND to disable - R_TMR range: 18k-72k - T_PRE range: 1400-2160 s - T_PRE (s) = 0.048 * R_TMR - T_MAX (s) = 10 * T_PRE
SJ2: Cut to enable charge timer.
TS - External Thermistor
- Connect TS to 10k NTC thermistor in the battery pack. - Connect a 10k resistor to GND if TS is not used.
OUT is the power-path management output. It manages current supplied from the USB input to both the battery and system. Or supplies battery power to the system when USB is not connected. OUT supply w/ USB: V_USB - 0.3V OUT supply w/o USB: V_BAT - 0.05V
SJ5 sets the operation of the power LED. To either: - Power OUT indicator - !PGOOD! indicator (Good IN supply) - Open (LED disconnected)
Overlap buzzer assy concentric
BUZZER
SYSOFF = 1 --> Batt desconectada de OUT R46 La primera vez que se enchufa todo OUT=0 R46 es un pulldown que hace ademas que OUT este deshabilitado incluso cuando se ha conectado la bateria. Es para cancelar toda la circuiteria de Q4 y llevar simplemente a masa activando asi la salida OUT con VBATT 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
G= 0.2 in = 16V --> out = 3.3V
Maximun input current into IN pin is set by Resistor R_ILIM 1A is perfect for most power adapters
100mV/1A GTOTAL = 0.01R*25*0.2*2 = 0.1
