MSTKMAD/battery-pack/02.Hardware/V1-ROVER-2K/Battery PCBs/BQ2970/BQ2970_circuit.sch

## EAGLE design 02.Hardware/V1-ROVER-2K/Battery PCBs/BQ2970/BQ2970_circuit.sch (2022-04-11)

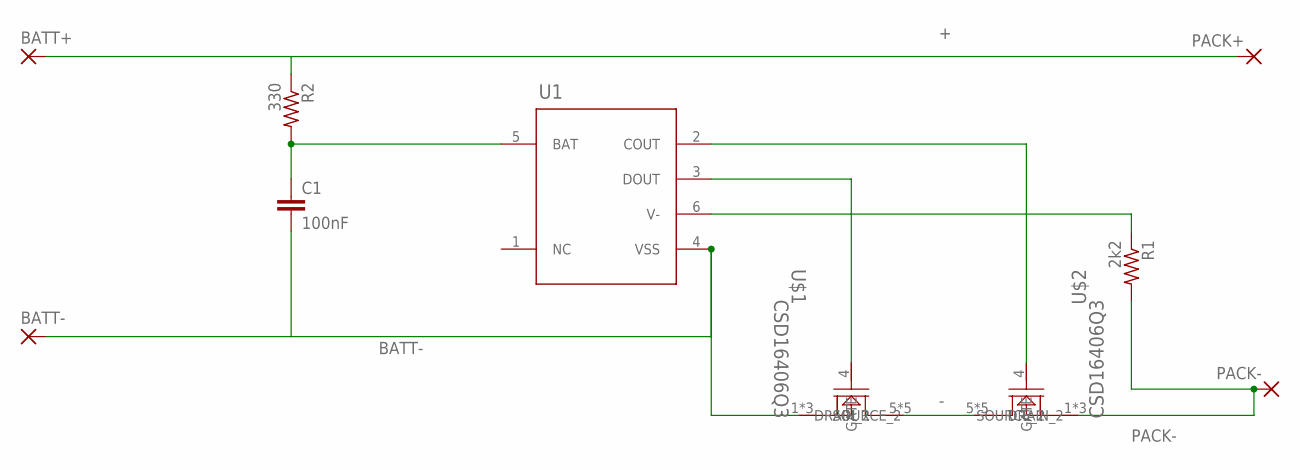
[picture p368: schematic BQ2970_circuit.sch]

Parts:
BATT+: SMD5; SMD2,54-5,08
BATT-: SMD5; SMD2,54-5,08
C1: 100nF; C0805
PACK+: SMD5; SMD2,54-5,08
PACK-: SMD5; SMD2,54-5,08
R1: 2k2; R0805
R2: 330; R0805
U1: Value; DSE0006A
U$1, U$2: CSD16406Q3; DQG0008A

Connections:
+: BATT+.1, PACK+.1, R2.1
-: U$1.5 (DRAIN_2), U$2.5 (DRAIN_2)
BATT-: BATT-.1, C1.2, U1.4 (VSS), U$1.1 (SOURCE_2)
unnamed: C1.1, R2.2, U1.5 (BAT)
unnamed: R1.1, U1.6 (V-)
unnamed: U1.2 (COUT), U$2.4 (GATE)
unnamed: U1.3 (DOUT), U$1.4 (GATE)
PACK-: PACK-.1, R1.2, U$2.1 (SOURCE_2)
