MSTKMAD/battery-pack/02.Hardware/V1-ROVER-2K/Battery PCBs/FLEX_CONN/FLEX_CONN.sch

## EAGLE design 02.Hardware/V1-ROVER-2K/Battery PCBs/FLEX_CONN/FLEX_CONN.sch (2022-04-11)

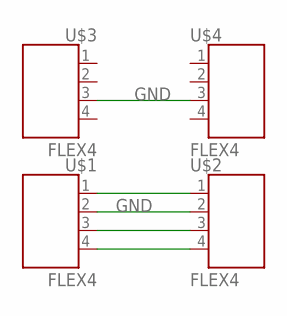
[picture p370: schematic FLEX_CONN.sch]

Parts:
U$1, U$2, U$3, U$4: FLEX4

Connections:
GND: U$1.2, U$2.2, U$3.3, U$4.3
unnamed: U$1.1, U$2.1
unnamed: U$1.3, U$2.3
unnamed: U$1.4, U$2.4
