MSTKMAD/battery-pack/02.Hardware/V1-ROVER-2K/Battery PCBs/FLEX_DCDC/FLEX_DCDC.sch

## EAGLE design 02.Hardware/V1-ROVER-2K/Battery PCBs/FLEX_DCDC/FLEX_DCDC.sch (2022-04-11)

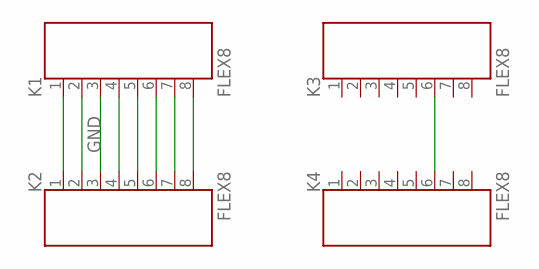
[picture p371: schematic FLEX_DCDC.sch]

Parts:
K1, K2, K3, K4: FLEX8

Connections:
GND: K1.3, K2.3, K3.6, K4.6
unnamed: K1.1, K2.1
unnamed: K1.2, K2.2
unnamed: K1.4, K2.4
unnamed: K1.5, K2.5
unnamed: K1.6, K2.6
unnamed: K1.7, K2.7
unnamed: K1.8, K2.8
