MSTKMAD/battery-pack/02.Hardware/V1-ROVER-2K/Battery PCBs/FLEX_DISPLAY/FLEX_DISPLAY.sch

## EAGLE design 02.Hardware/V1-ROVER-2K/Battery PCBs/FLEX_DISPLAY/FLEX_DISPLAY.sch (2022-04-11)

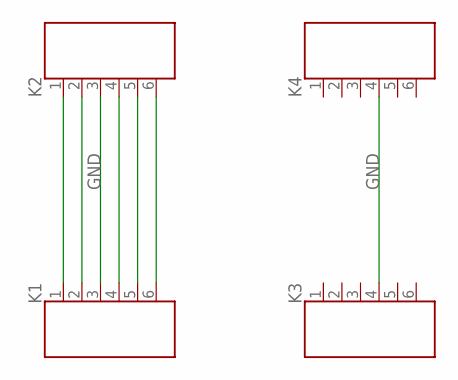
[picture p372: schematic FLEX_DISPLAY.sch]

Parts:
K1, K2, K3, K4: FLEX6

Connections:
GND: K1.3, K2.3, K3.4, K4.4
unnamed: K1.1, K2.1
unnamed: K1.2, K2.2
unnamed: K1.4, K2.4
unnamed: K1.5, K2.5
unnamed: K1.6, K2.6
