MSTKMAD/battery-pack/02.Hardware/V1-ROVER-2K/Battery PCBs/SHIELD_TEST_CPU/Load_Testbed_V3.sch

## EAGLE design 02.Hardware/V1-ROVER-2K/Battery PCBs/SHIELD_TEST_CPU/Load_Testbed_V3.sch (2022-04-11)

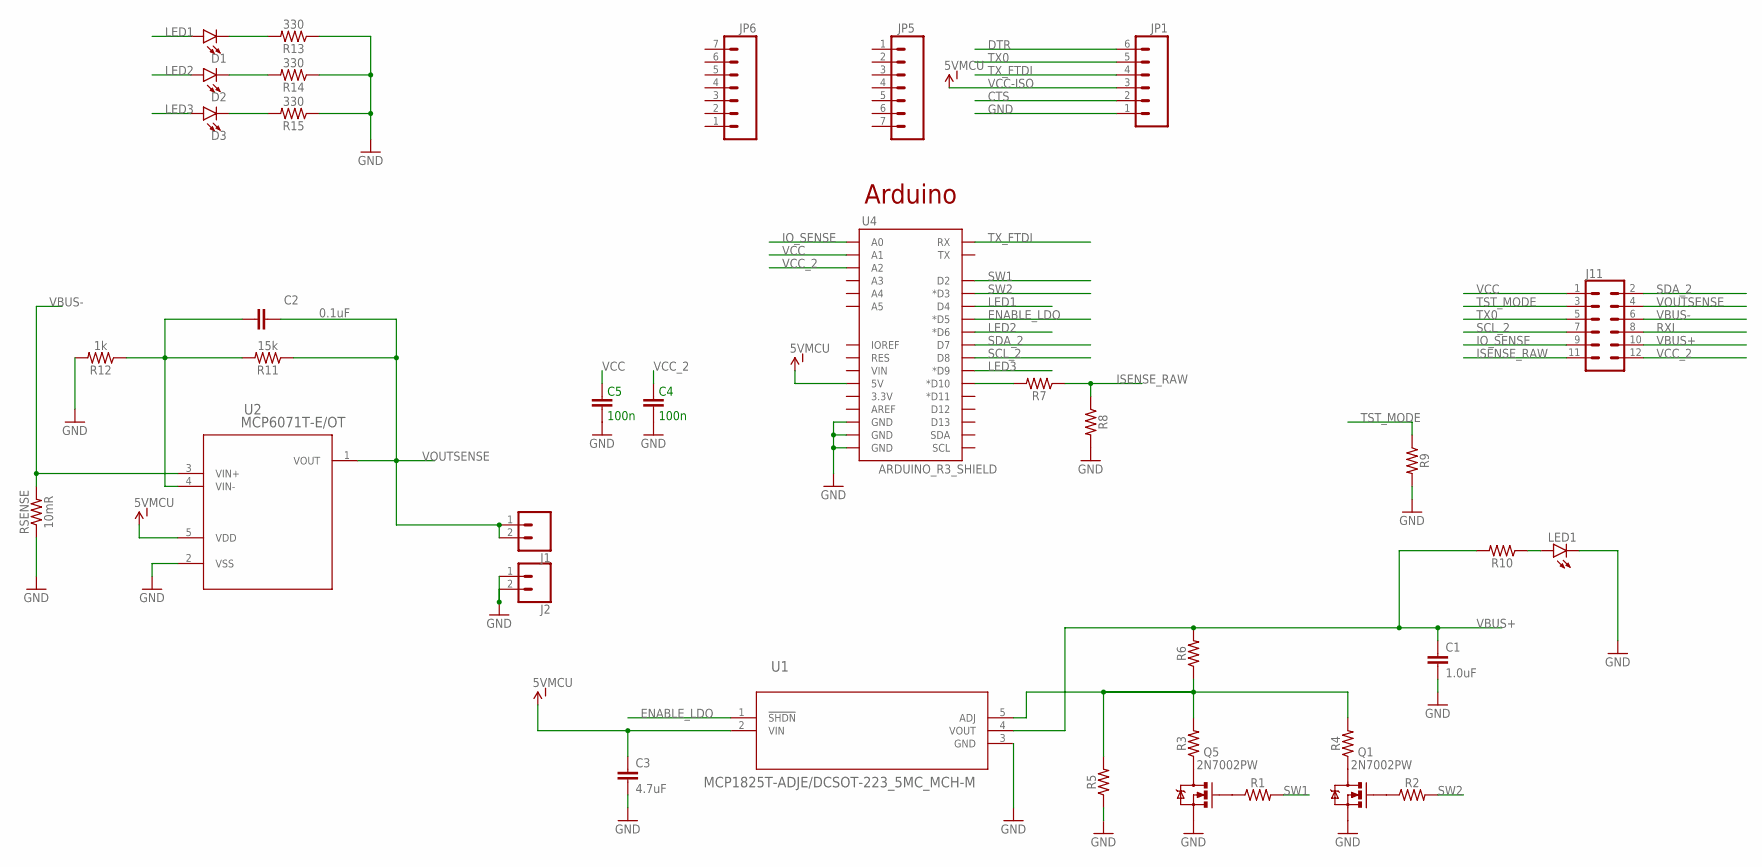
[picture p373: schematic Load_Testbed_V3.sch]

Parts:
C1: 1.0uF; 0805
C2: 0.1uF; 0603
C3: 4.7uF; 0603
C4, C5: 100n; 0805
D1, D2, D3: LED1206; LED-1206
J1, J2: CONN_02; 1X02
J11: 2X6 FEMALE; 2X6
JP1: M06NO_SILK_FEMALE_PTH; 1X06_NO_SILK
JP5, JP6: M07NO_SILK; 1X07_NO_SILK
LED1: LED3MM
Q1, Q5: 2N7002PW; SOT323
R1, R2, R3, R4, R5, R6, R7, R8, R9, R10: 0805
R11: 15k; 0402
R12: 1k; 0402
R13, R14, R15: 330; 0805
RSENSE: 10mR; 0603
U1: MCP1825T-ADJE/DCSOT-223_5MC_MCH-M; SOT-223_5MC_MCH-M
U2: MCP6071T-E/OT; SOT-23-5_MC_MCH
U4: ARDUINO_R3_SHIELD; UNO_R3_SHIELD

Connections:
CTS: JP1.2
DTR: JP1.6
ENABLE_LDO: U1.1 (!SHDN), U4.D5 (*D5)
GND: C1.2, C3.2, C4.1, C5.1, J2.1, J2.2, JP1.1, LED1.K (C), Q1.2 (S), Q5.2 (S), R5.1, R8.2, R9.2, R12.2, R13.1, R14.1, R15.1, RSENSE.1, U1.3 (GND), U2.2 (VSS), U4.GND@0 (GND), U4.GND@1 (GND), U4.GND@2 (GND)
IO_SENSE: J11.9, U4.A0
ISENSE_RAW: J11.11, R7.1, R8.1
LED1: D1.A, U4.D4
LED2: D2.A, U4.D6 (*D6)
LED3: D3.A, U4.D9 (*D9)
unnamed: C2.2, R11.2, R12.1, U2.4 (VIN-)
unnamed: Q5.1 (G), R1.1
unnamed: Q1.1 (G), R2.1
unnamed: Q5.3 (D), R3.1
unnamed: Q1.3 (D), R4.1
unnamed: LED1.A, R10.1
unnamed: R3.2, R4.2, R5.2, R6.1, U1.5 (ADJ)
unnamed: D1.C, R13.2
unnamed: D2.C, R14.2
unnamed: D3.C, R15.2
unnamed: R7.2, U4.D10 (*D10)
RXI: J11.8
SCL_2: J11.7, U4.D8
SDA_2: J11.2, U4.D7
SW1: R1.2, U4.D2
SW2: R2.2, U4.D3 (*D3)
TST_MODE: J11.3, R9.1
TX0: J11.5, JP1.5
TX_FTDI: JP1.4, U4.RX
VBUS+: C1.1, J11.10, R6.2, R10.2, U1.4 (VOUT)
VBUS-: J11.6, RSENSE.2, U2.3 (VIN+)
VCC: C5.2, J11.1, U4.A1
VCC-ISO: C3.1, JP1.3, U1.2 (VIN), U2.5 (VDD), U4.5V
VCC_2: C4.2, J11.12, U4.A2
VOUTSENSE: C2.1, J1.1, J1.2, J11.4, R11.1, U2.1 (VOUT)

Notes on the sheet:
Arduino
