MSTKMAD/battery-pack/02.Hardware/V1-ROVER-2K/Battery PCBs/SHIELD_TEST_DCDC/Shield_Testbed_DCDC.sch

## EAGLE design 02.Hardware/V1-ROVER-2K/Battery PCBs/SHIELD_TEST_DCDC/Shield_Testbed_DCDC.sch (2022-04-11)

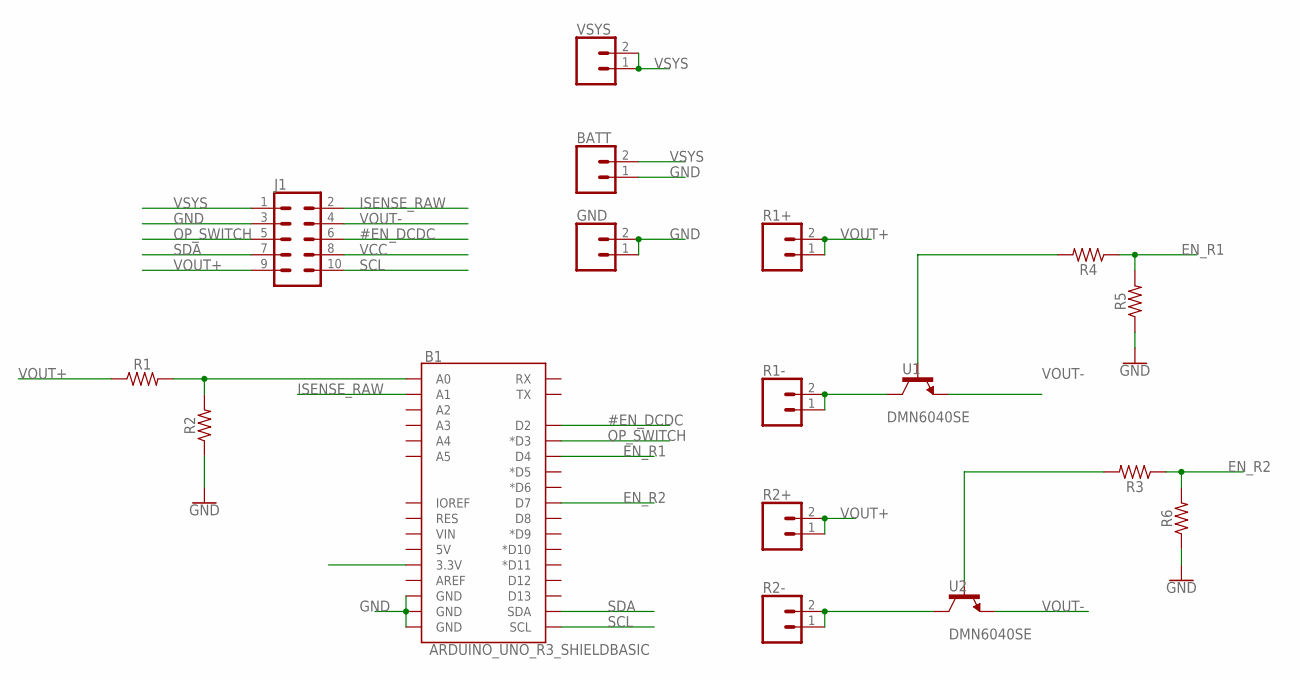
[picture p374: schematic Shield_Testbed_DCDC.sch]

Parts:
B1: ARDUINO_UNO_R3_SHIELDBASIC; UNO_R3_SHIELD
BATT: CONN_02; 1X02
GND: CONN_02; 1X02
J1: CONN_05X2PTH; 2X5
R1, R2, R3, R4, R5, R6: 0805
R1+, R1-, R2+, R2-: CONN_02; 1X02
U1, U2: DMN6040SE; SOT-223_3P7X6P7_ONS
VSYS: CONN_02; 1X02

Connections:
#EN_DCDC: B1.D2, J1.6
EN_R1: B1.D4, R4.1, R5.2
EN_R2: B1.D7, R3.1, R6.2
GND: B1.GND@0 (GND), B1.GND@1 (GND), B1.GND@2 (GND), BATT.1, GND.1, GND.2, J1.3, R2.1, R5.1, R6.1
ISENSE_RAW: B1.A1, J1.2
unnamed: B1.A0, R1.2, R2.2
unnamed: R3.2, U2.1 (G)
unnamed: R4.2, U1.1 (G)
OP_SWITCH: B1.D3 (*D3), J1.5
R1-: R1-.1, R1-.2, U1.2 (D)
R2-: R2-.1, R2-.2, U2.2 (D)
SCL: B1.SCL, J1.10
SDA: B1.SDA, J1.7
VCC: B1.3.3V, J1.8
VOUT+: J1.9, R1.1, R1+.1, R1+.2, R2+.1, R2+.2
VOUT-: J1.4, U1.3 (S), U2.3 (S)
VSYS: BATT.2, J1.1, VSYS.1, VSYS.2
