MSTKMAD/battery-pack/02.Hardware/V1-ROVER-2K/Battery PCBs/SHIELD_TEST_DISP/SHIELD_TEST_DISP.sch

## EAGLE design 02.Hardware/V1-ROVER-2K/Battery PCBs/SHIELD_TEST_DISP/SHIELD_TEST_DISP.sch (2022-04-11)

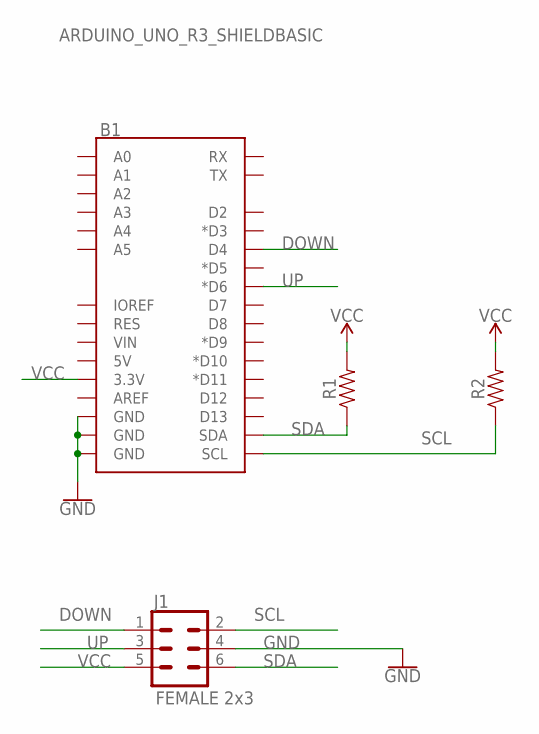
[picture p375: schematic SHIELD_TEST_DISP.sch]

Parts:
B1: ARDUINO_UNO_R3_SHIELDBASIC; UNO_R3_SHIELD
J1: FEMALE 2x3; 2X3
R1, R2: 0805

Connections:
DOWN: B1.D4, J1.1
GND: B1.GND@0 (GND), B1.GND@1 (GND), B1.GND@2 (GND), J1.4
SCL: B1.SCL, J1.2, R2.1
SDA: B1.SDA, J1.6, R1.1
UP: B1.D6 (*D6), J1.3
VCC: B1.3.3V, J1.5, R1.2, R2.2
