MSTKMAD/battery-pack/02.Hardware/V1-ROVER-2K/Battery PCBs/SHIELD_TEST_INPUT/SHIELD_TEST_INPUT_v2.sch

## EAGLE design 02.Hardware/V1-ROVER-2K/Battery PCBs/SHIELD_TEST_INPUT/SHIELD_TEST_INPUT_v2.sch (2022-04-11)

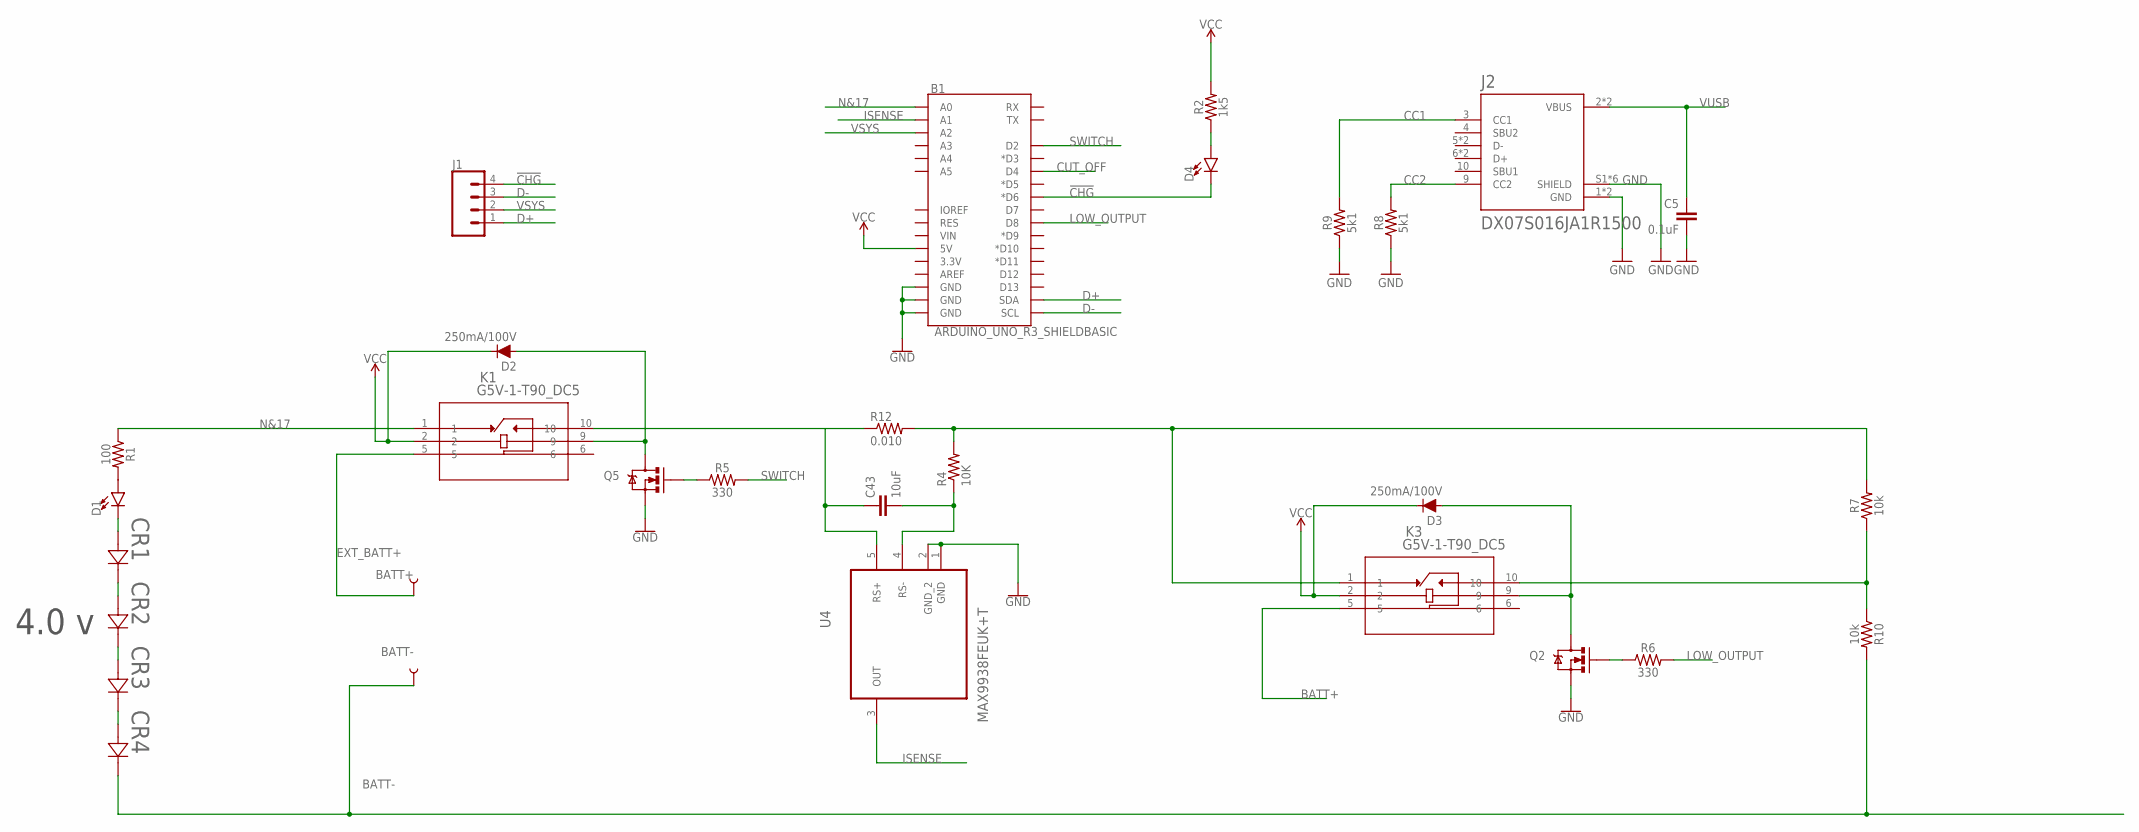
[picture p376: schematic SHIELD_TEST_INPUT_v2.sch]

Parts:
B1: ARDUINO_UNO_R3_SHIELDBASIC; UNO_R3_SHIELD
BATT+: TEST-POINT2; PAD.02X.02
BATT-: TEST-POINT2; PAD.02X.02
C5: 0.1uF; 0603
C43: 10uF; 1206
CR1, CR2, CR3, CR4: 1N4148WSF-7; SOD323F_DIO
D1, D4: LED0603; LED-0603
D2, D3: 250mA/100V; SOD-323
J1: CONN_04; 1X04
J2: DX07S016JA1R1500; JAE_DX07S016JA1R1500
K1, K3: G5V-1-T90_DC5; RELAY_G5V-1_OMR
Q2, Q5: 2N7002PW; SOT323
R1: 100; 0805
R2: 1k5; 0805
R4: 10K; 0805
R5, R6: 330; 0805
R7, R10: 10k; 0805
R8, R9: 5k1; 0805
R12: 0.010; 1206
U4: MAX9938FEUK+T; SOT95P280X145-5N

Connections:
!CHG: B1.D6 (*D6), D4.C, J1.4
BATT+: K3.5
BATT-: BATT-.P$1, CR4.1, R10.2
CC1: J2.3 (CC1), R9.2
CC2: J2.9 (CC2), R8.2
CUT_OFF: B1.D4
D+: B1.SDA, J1.1
D-: B1.SCL, J1.3
EXT_BATT+: BATT+.P$1, K1.5
EXT_BATT+1: K3.1, R4.2, R7.2, R12.2
GND: B1.GND@0 (GND), B1.GND@1 (GND), B1.GND@2 (GND), C5.2, J2.1 (GND), J2.S1 (SHIELD), Q2.2 (S), Q5.1 (G), Q5.2 (S), R5.1, R8.1, R9.1, U4.1 (GND), U4.2 (GND_2)
ISENSE: B1.A1, U4.3 (OUT)
LOW_OUTPUT: B1.D8, R6.2
unnamed: CR1.2, D1.C
unnamed: CR1.1, CR2.2
unnamed: D1.A, R1.2
unnamed: CR2.1, CR3.2
unnamed: D4.A, R2.1
unnamed: CR3.1, CR4.2
unnamed: D3.A, K3.9, Q2.3 (D)
unnamed: Q2.1 (G), R6.1
unnamed: C43.2, R4.1, U4.4 (RS-)
unnamed: D2.A, K1.9, Q5.3 (D)
N&17: B1.A0, K1.1, R1.1
SWITCH: B1.D2, R5.2
VCC: B1.5V, D2.C, D3.C, K1.2, K3.2, R2.2
VO_TPS: C43.1, K1.10, R12.1, U4.5 (RS+)
VO_TPS1: K3.10, R7.1, R10.1
VSYS: B1.A2, J1.2
VUSB: C5.1, J2.2 (VBUS)

Notes on the sheet:
4.0 v
