MSTKMAD/battery-pack/02.Hardware/V1-ROVER-2K/Battery PCBs/TEST_BED_BATT_BUTTONS/TEST_BED_BATT_BUTTONS.sch

## EAGLE design 02.Hardware/V1-ROVER-2K/Battery PCBs/TEST_BED_BATT_BUTTONS/TEST_BED_BATT_BUTTONS.sch (2022-06-28)

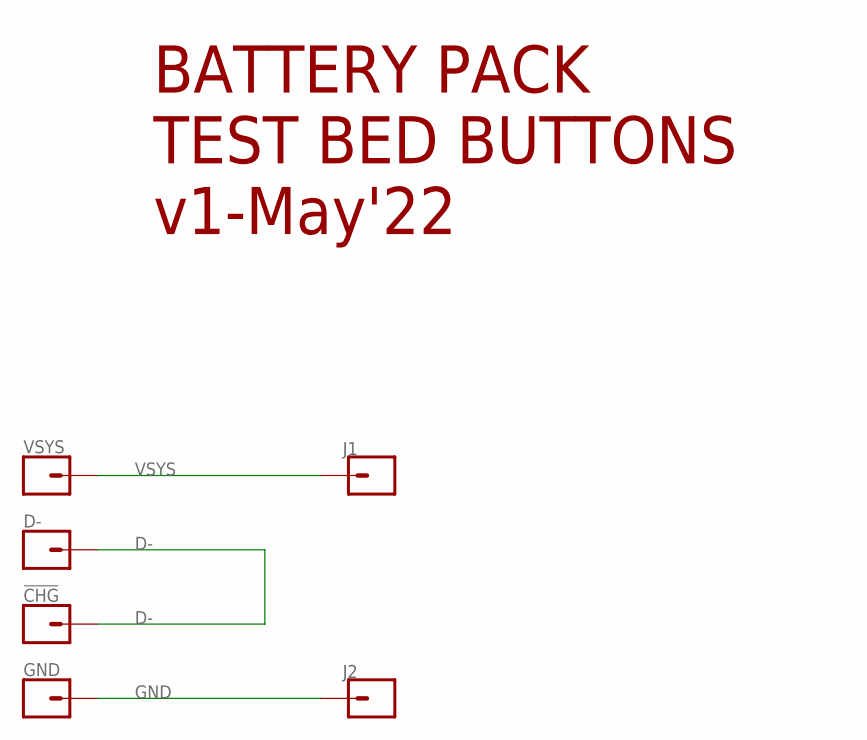
[picture p377: schematic TEST_BED_BATT_BUTTONS.sch]

Parts:
!CHG: CONN_01POGOPIN_HOLE_LARGE; 1X01_POGOPIN_HOLE_0.061_DIA
D-: CONN_01POGOPIN_HOLE_LARGE; 1X01_POGOPIN_HOLE_0.061_DIA
GND: CONN_01POGOPIN_HOLE_LARGE; 1X01_POGOPIN_HOLE_0.061_DIA
J1, J2: CONN_01PTH_2MM; 1X01_2MM
VSYS: CONN_01POGOPIN_HOLE_LARGE; 1X01_POGOPIN_HOLE_0.061_DIA

Connections:
D-: !CHG.2, D-.2
GND: GND.2, J2.1
VSYS: J1.1, VSYS.2

Notes on the sheet:
BATTERY PACK TEST BED BUTTONS v1-May'22
