MSTKMAD/battery-pack/02.Hardware/V1-ROVER-2K/Battery PCBs/TEST_BED_BATT_CPU/BATT_CPU_TEST_BED_V2.sch

## EAGLE design 02.Hardware/V1-ROVER-2K/Battery PCBs/TEST_BED_BATT_CPU/BATT_CPU_TEST_BED_V2.sch (2022-04-11)

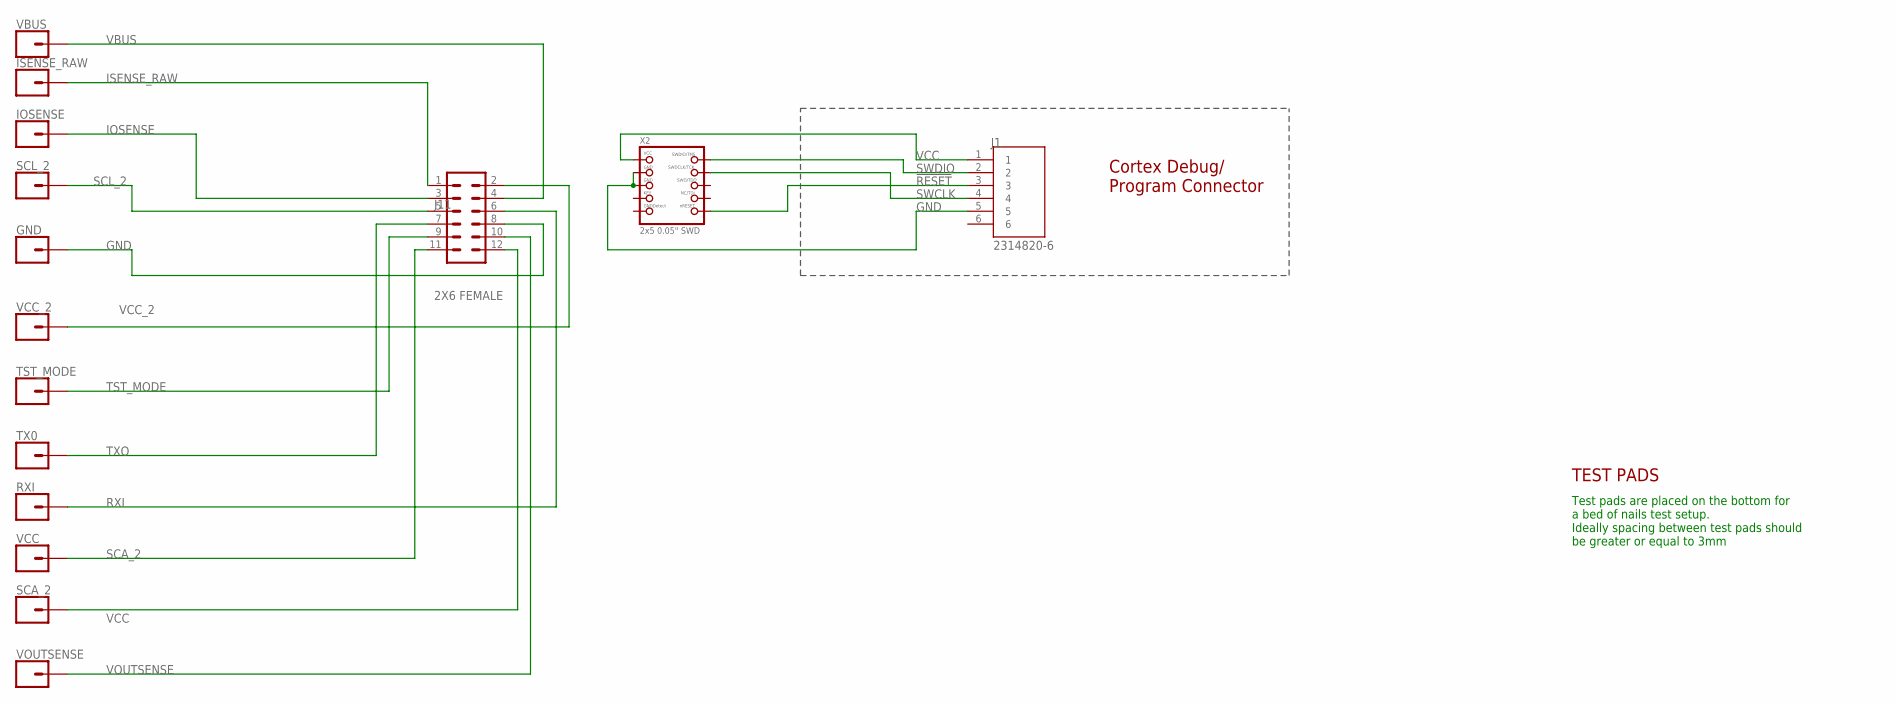
[picture p378: schematic BATT_CPU_TEST_BED_V2.sch]

Parts:
GND: CONN_01POGOPIN_HOLE_LARGE; 1X01_POGOPIN_HOLE_0.061_DIA
IOSENSE: CONN_01POGOPIN_HOLE_LARGE; 1X01_POGOPIN_HOLE_0.061_DIA
ISENSE_RAW: CONN_01POGOPIN_HOLE_LARGE; 1X01_POGOPIN_HOLE_0.061_DIA
J1: 2314820-6; TE_2314820-6
J11: 2X6 FEMALE; 2X6
RXI: CONN_01POGOPIN_HOLE_LARGE; 1X01_POGOPIN_HOLE_0.061_DIA
SCA_2: CONN_01POGOPIN_HOLE_LARGE; 1X01_POGOPIN_HOLE_0.061_DIA
SCL_2: CONN_01POGOPIN_HOLE_LARGE; 1X01_POGOPIN_HOLE_0.061_DIA
TST_MODE: CONN_01POGOPIN_HOLE_LARGE; 1X01_POGOPIN_HOLE_0.061_DIA
TX0: CONN_01POGOPIN_HOLE_LARGE; 1X01_POGOPIN_HOLE_0.061_DIA
VBUS: CONN_01POGOPIN_HOLE_LARGE; 1X01_POGOPIN_HOLE_0.061_DIA
VCC: CONN_01POGOPIN_HOLE_LARGE; 1X01_POGOPIN_HOLE_0.061_DIA
VCC_2: CONN_01POGOPIN_HOLE_LARGE; 1X01_POGOPIN_HOLE_0.061_DIA
VOUTSENSE: CONN_01POGOPIN_HOLE_LARGE; 1X01_POGOPIN_HOLE_0.061_DIA
X2: 2x5 0.05" SWD; 2X05_1.27MM_BOX_POSTS

Connections:
!RESET: J1.3, X2.10 (NRESET)
GND: GND.2, J1.5, J11.8, X2.3 (GND), X2.5 (GND)
IOSENSE: IOSENSE.2, J11.3
ISENSE_RAW: ISENSE_RAW.2, J11.1
RXI: J11.6, RXI.2
SCA_2: J11.12, SCA_2.2
SCL_2: J11.5, SCL_2.2
SWCLK: J1.4, X2.4 (SWDCLK)
SWDIO: J1.2, X2.2 (SWDIO)
TST_MODE: J11.9, TST_MODE.2
TXO: J11.7, TX0.2
VBUS: J11.4, VBUS.2
VCC: J1.1, J11.11, VCC.2, X2.1 (VCC)
VCC_2: J11.2, VCC_2.2
VOUTSENSE: J11.10, VOUTSENSE.2

Notes on the sheet:
Cortex Debug/ Program Connector
TEST PADS
Test pads are placed on the bottom for a bed of nails test setup. Ideally spacing between test pads should be greater or equal to 3mm
