MSTKMAD/battery-pack/02.Hardware/V1-ROVER-2K/Battery PCBs/TEST_BED_BATT_DCDC/BATT_DCDC_TEST_BED_V2.sch

## EAGLE design 02.Hardware/V1-ROVER-2K/Battery PCBs/TEST_BED_BATT_DCDC/BATT_DCDC_TEST_BED_V2.sch (2022-04-11)

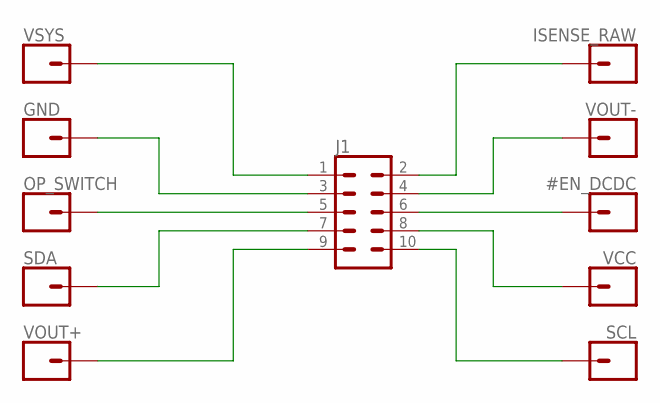
[picture p379: schematic BATT_DCDC_TEST_BED_V2.sch]

Parts:
#EN_DCDC: CONN_01POGOPIN_HOLE_LARGE; 1X01_POGOPIN_HOLE_0.061_DIA
GND: CONN_01POGOPIN_HOLE_LARGE; 1X01_POGOPIN_HOLE_0.061_DIA
ISENSE_RAW: CONN_01POGOPIN_HOLE_LARGE; 1X01_POGOPIN_HOLE_0.061_DIA
J1: CONN_05X2PTH; 2X5
OP_SWITCH: CONN_01POGOPIN_HOLE_LARGE; 1X01_POGOPIN_HOLE_0.061_DIA
SCL: CONN_01POGOPIN_HOLE_LARGE; 1X01_POGOPIN_HOLE_0.061_DIA
SDA: CONN_01POGOPIN_HOLE_LARGE; 1X01_POGOPIN_HOLE_0.061_DIA
VCC: CONN_01POGOPIN_HOLE_LARGE; 1X01_POGOPIN_HOLE_0.061_DIA
VOUT+: CONN_01POGOPIN_HOLE_LARGE; 1X01_POGOPIN_HOLE_0.061_DIA
VOUT-: CONN_01POGOPIN_HOLE_LARGE; 1X01_POGOPIN_HOLE_0.061_DIA
VSYS: CONN_01POGOPIN_HOLE_LARGE; 1X01_POGOPIN_HOLE_0.061_DIA

Connections:
GND: GND.2, J1.3
unnamed: #EN_DCDC.2, J1.6
unnamed: ISENSE_RAW.2, J1.2
unnamed: J1.4, VOUT-.2
unnamed: J1.8, VCC.2
unnamed: J1.10, SCL.2
unnamed: J1.5, OP_SWITCH.2
unnamed: J1.1, VSYS.2
unnamed: J1.7, SDA.2
unnamed: J1.9, VOUT+.2
