MSTKMAD/battery-pack/02.Hardware/V1-ROVER-2K/Battery PCBs/TEST_BED_BATT_DISP/TEST_BED_BATT_DISP.sch

## EAGLE design 02.Hardware/V1-ROVER-2K/Battery PCBs/TEST_BED_BATT_DISP/TEST_BED_BATT_DISP.sch (2022-04-11)

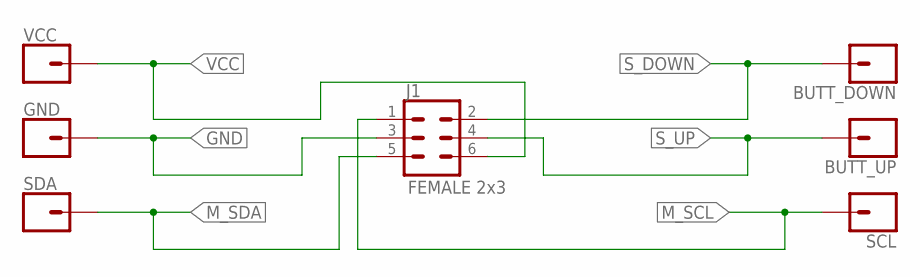
[picture p380: schematic TEST_BED_BATT_DISP.sch]

Parts:
BUTT_DOWN: CONN_01POGOPIN_HOLE_LARGE; 1X01_POGOPIN_HOLE_0.061_DIA
BUTT_UP: CONN_01POGOPIN_HOLE_LARGE; 1X01_POGOPIN_HOLE_0.061_DIA
GND: CONN_01POGOPIN_HOLE_LARGE; 1X01_POGOPIN_HOLE_0.061_DIA
J1: FEMALE 2x3; 2X3
SCL: CONN_01POGOPIN_HOLE_LARGE; 1X01_POGOPIN_HOLE_0.061_DIA
SDA: CONN_01POGOPIN_HOLE_LARGE; 1X01_POGOPIN_HOLE_0.061_DIA
VCC: CONN_01POGOPIN_HOLE_LARGE; 1X01_POGOPIN_HOLE_0.061_DIA

Connections:
GND: GND.2, J1.3
M_SCL: J1.1, SCL.2
M_SDA: J1.5, SDA.2
S_DOWN: BUTT_DOWN.2, J1.2
S_UP: BUTT_UP.2, J1.4
VCC: J1.6, VCC.2
