MSTKMAD/battery-pack/02.Hardware/V1-ROVER-2K/Battery PCBs/TEST_BED_BATT_INPUT/BATT_INPUT_TEST_BED_v3.sch

## EAGLE design 02.Hardware/V1-ROVER-2K/Battery PCBs/TEST_BED_BATT_INPUT/BATT_INPUT_TEST_BED_v3.sch (2022-04-11)

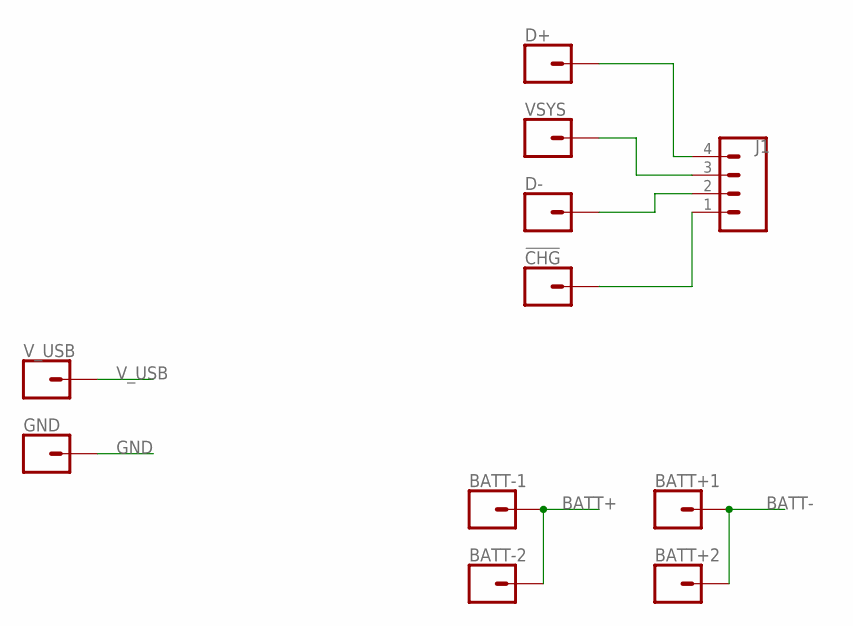
[picture p381: schematic BATT_INPUT_TEST_BED_v3.sch]

Parts:
!CHG!: CONN_01POGOPIN_HOLE_LARGE; 1X01_POGOPIN_HOLE_0.061_DIA
BATT+1, BATT+2: CONN_01POGOPIN_HOLE_LARGE; 1X01_POGOPIN_HOLE_0.061_DIA
BATT-1, BATT-2: CONN_01POGOPIN_HOLE_LARGE; 1X01_POGOPIN_HOLE_0.061_DIA
D+: CONN_01POGOPIN_HOLE_LARGE; 1X01_POGOPIN_HOLE_0.061_DIA
D-: CONN_01POGOPIN_HOLE_LARGE; 1X01_POGOPIN_HOLE_0.061_DIA
GND: CONN_01POGOPIN_HOLE_LARGE; 1X01_POGOPIN_HOLE_0.061_DIA
J1: FEMALE 2x3; 1X04
VSYS: CONN_01POGOPIN_HOLE_LARGE; 1X01_POGOPIN_HOLE_0.061_DIA
V_USB: CONN_01POGOPIN_HOLE_LARGE; 1X01_POGOPIN_HOLE_0.061_DIA

Connections:
BATT+: BATT-1.2, BATT-2.2
BATT-: BATT+1.2, BATT+2.2
GND: GND.2
unnamed: J1.3, VSYS.2
unnamed: D+.2, J1.4
unnamed: !CHG!.2, J1.1
unnamed: D-.2, J1.2
V_USB: V_USB.2
