MSTKMAD/battery-pack/02.Hardware/V1-ROVER-2K/Battery PCBs/BATT_CPU/History/BATT_CPU.sch

## EAGLE design 02.Hardware/V1-ROVER-2K/Battery PCBs/BATT_CPU/History/BATT_CPU.sch (2022-04-11)

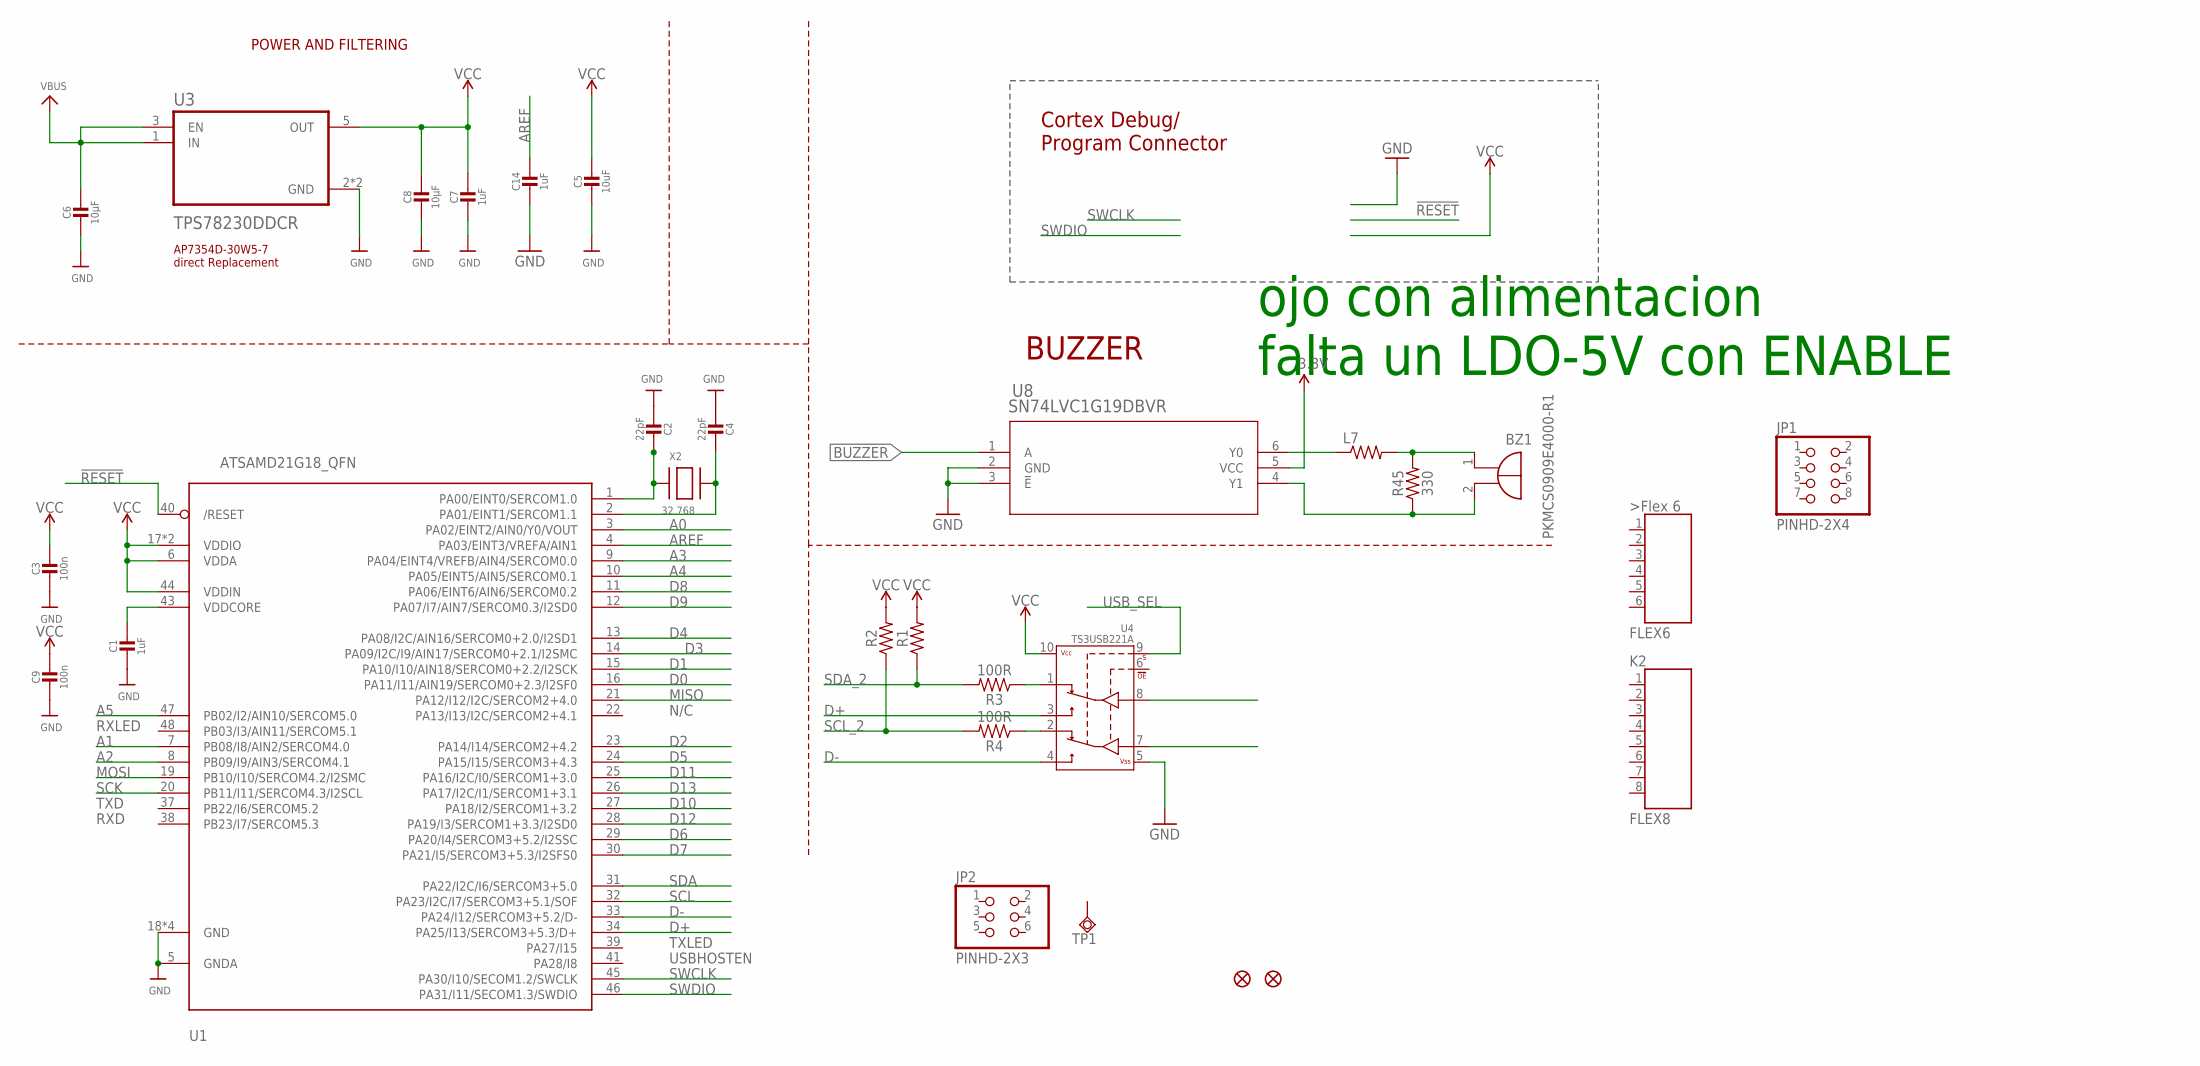
[picture p382: schematic BATT_CPU.sch]

Parts:
BZ1: PKMCS0909E4000-R1; PKMCS0909
C1, C7, C14: 1uF; 0603-NO
C2, C4: 22pF; 0603-NO
C3, C9: 100n; 0603-NO
C5: 10uF; 0805-NO
C6, C8: 10µF; 0805-NO
JP1: PINHD-2X4; 2X04
JP2: PINHD-2X3; 2X03
K1: FLEX6
K2: FLEX8
L7: MMZ2012Y202BT000; 0805
R1, R2: 0603
R3, R4: 100R; 0603
R45: 330; 0805
TP1: TESTPAD_TPSQB1,27; TESTPAD_B1,27
U1: ATSAMD21G18_QFN; TQFN48_7MM
U3: TPS78230DDCR; SOT95P280X110-5N
U4: TS3USB221A; QFN-10-RSE
U8: SN74LVC1G19DBVR; DBV6
U$34, U$35: FIDUCIAL""; FIDUCIAL_1MM
X2: 32.768; XTAL3215

Connections:
3.3V: U8.5 (VCC)
!RESET: U1.40 (/RESET)
A0: U1.3 (PA02/EINT2/AIN0/Y0/VOUT)
A1: U1.7 (PB08/I8/AIN2/SERCOM4.0)
A2: U1.8 (PB09/I9/AIN3/SERCOM4.1)
A3: U1.9 (PA04/EINT4/VREFB/AIN4/SERCOM0.0)
A4: U1.10 (PA05/EINT5/AIN5/SERCOM0.1)
A5: U1.47 (PB02/I2/AIN10/SERCOM5.0)
AREF: C14.1, U1.4 (PA03/EINT3/VREFA/AIN1)
BUZZER: U8.1 (A)
D0: U1.16 (PA11/I11/AIN19/SERCOM0+2.3/I2SF0)
D1: U1.15 (PA10/I10/AIN18/SERCOM0+2.2/I2SCK)
D2: U1.23 (PA14/I14/SERCOM2+4.2)
D3: U1.14 (PA09/I2C/I9/AIN17/SERCOM0+2.1/I2SMC)
D4: U1.13 (PA08/I2C/AIN16/SERCOM0+2.0/I2SD1)
D5: U1.24 (PA15/I15/SERCOM3+4.3)
D6: U1.29 (PA20/I4/SERCOM3+5.2/I2SSC)
D7: U1.30 (PA21/I5/SERCOM3+5.3/I2SFS0)
D8: U1.11 (PA06/EINT6/AIN6/SERCOM0.2)
D9: U1.12 (PA07/I7/AIN7/SERCOM0.3/I2SD0)
D10: U1.27 (PA18/I2/SERCOM1+3.2)
D11: U1.25 (PA16/I2C/I0/SERCOM1+3.0)
D12: U1.28 (PA19/I3/SERCOM1+3.3/I2SD0)
D13: U1.26 (PA17/I2C/I1/SERCOM1+3.1)
D+: U1.34 (PA25/I13/SERCOM3+5.3/D+), U4.3 (2D+)
D-: U1.33 (PA24/I12/SERCOM3+5.2/D-), U4.4 (2D-)
GND: C1.2, C2.2, C3.2, C4.2, C5.2, C6.2, C7.2, C8.2, C9.2, C14.2, U1.5 (GNDA), U1.18 (GND), U3.2 (GND), U4.5 (VSS), U8.2 (GND), U8.3 (!E)
MISO: U1.21 (PA12/I12/I2C/SERCOM2+4.0)
MOSI: U1.19 (PB10/I10/SERCOM4.2/I2SMC)
unnamed: R3.1, U4.1 (1D+)
unnamed: R4.1, U4.2 (1D-)
unnamed: C2.1, U1.1 (PA00/EINT0/SERCOM1.0), X2.P$1
unnamed: C4.1, U1.2 (PA01/EINT1/SERCOM1.1), X2.P$2
unnamed: L7.1, U8.6 (Y0)
unnamed: BZ1.1 (+), L7.2, R45.2
unnamed: BZ1.2 (-), R45.1, U8.4 (Y1)
SCK: U1.20 (PB11/I11/SERCOM4.3/I2SCL)
SCL: U1.32 (PA23/I2C/I7/SERCOM3+5.1/SOF)
SCL_2: R2.1, R4.2
SDA: U1.31 (PA22/I2C/I6/SERCOM3+5.0)
SDA_2: R1.1, R3.2
SWCLK: U1.45 (PA30/I10/SECOM1.2/SWCLK)
SWDIO: U1.46 (PA31/I11/SECOM1.3/SWDIO)
USB_SEL: U4.9 (S)
VBUS: C6.1, U3.1 (IN), U3.3 (EN)
VCC: C3.1, C5.1, C7.1, C8.1, C9.1, R1.2, R2.2, U1.6 (VDDA), U1.17 (VDDIO), U1.44 (VDDIN), U3.5 (OUT), U4.10 (VCC)
VDDCORE: C1.1, U1.43 (VDDCORE)

Notes on the sheet:
POWER AND FILTERING
N/C
TXLED
USBHOSTEN
RXLED
TXD
RXD
Cortex Debug/ Program Connector
BUZZER
AP7354D-30W5-7 direct Replacement
ojo con alimentacion falta un LDO-5V con ENABLE
