MSTKMAD/battery-pack/02.Hardware/V1-ROVER-2K/Battery PCBs/BATT_CPU/History/BATT_CPU_TEST.sch

## EAGLE design 02.Hardware/V1-ROVER-2K/Battery PCBs/BATT_CPU/History/BATT_CPU_TEST.sch (2022-04-11)

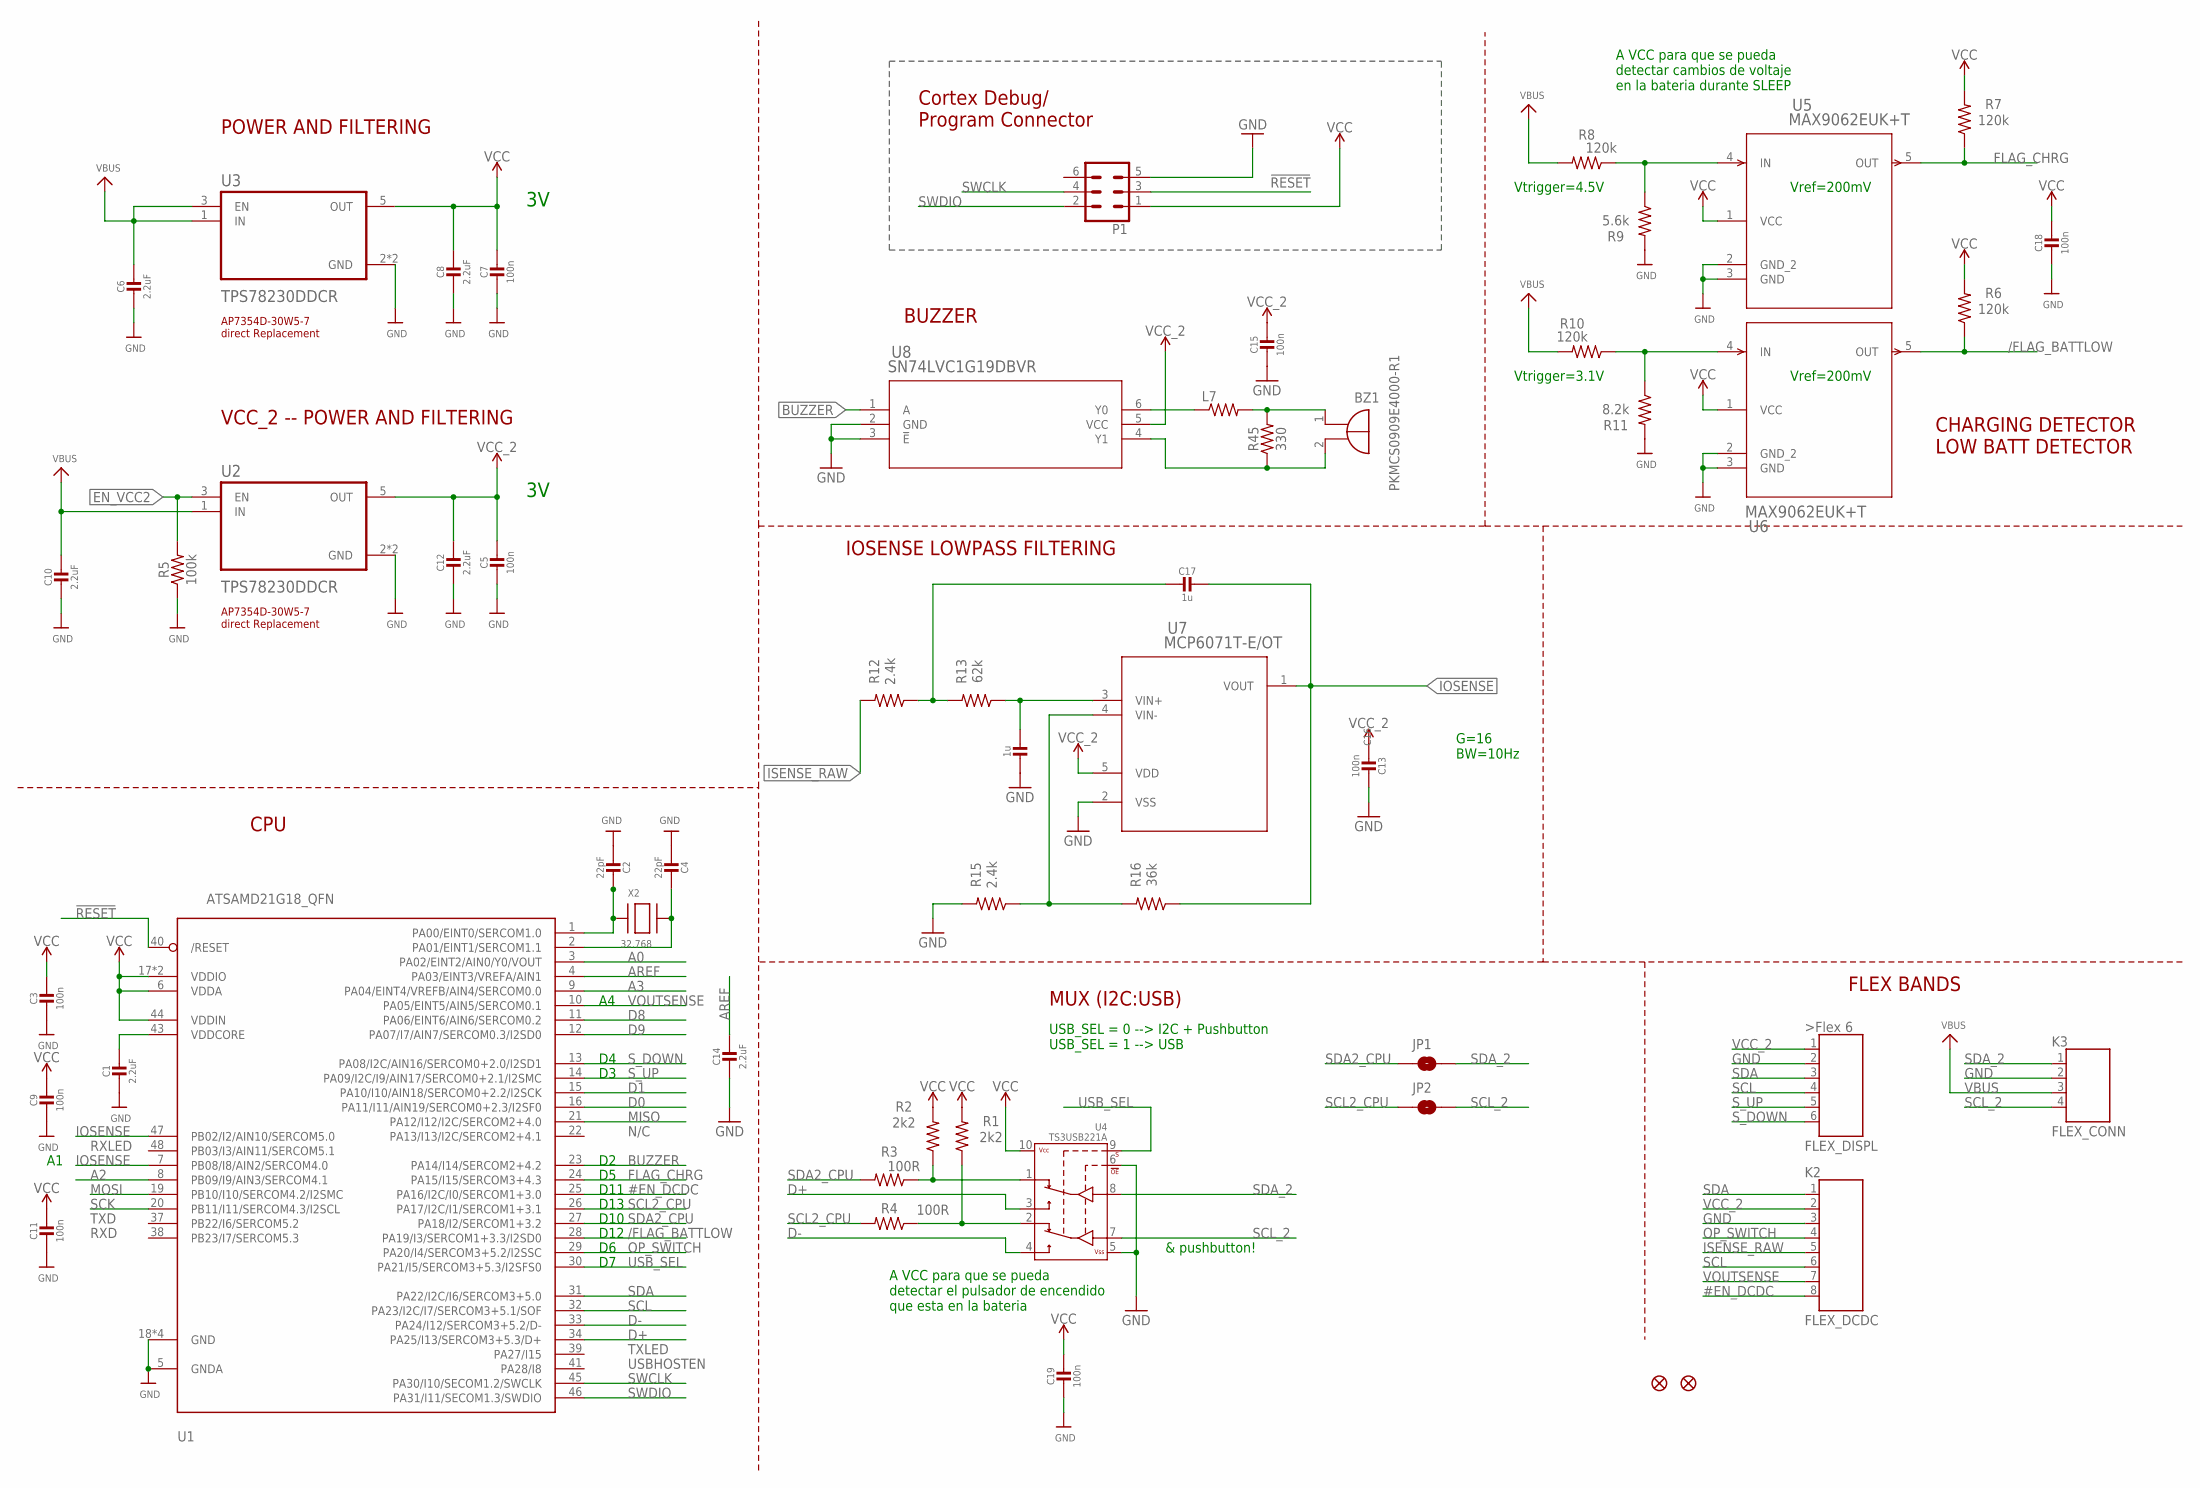
[picture p384: schematic BATT_CPU_TEST.sch]

Parts:
BZ1: PKMCS0909E4000-R1; PKMCS0909
C1, C14: 2.2uF; 0603-NO
C2, C4: 22pF; 0603-NO
C3, C5, C7, C9, C11, C13, C15, C18, C19: 100n; 0603-NO
C6, C8, C10, C12: 2.2uF; 0805-NO
C16, C17: 1u; 0603-NO
JP1, JP2: JUMPER-SMT_2_NO_SILK; SMT-JUMPER_2_NO_SILK
K1: FLEX_DISPL; FLEX6
K2: FLEX_DCDC; FLEX8
K3: FLEX_CONN; FLEX4
L7: MMZ2012Y202BT000; 0805
P1: CONN03X2-PROGRAM-POGO-SWD-1.27; 2X3-PROGRAM-POGO-SWD-1.27
R1, R2: 2k2; 0603
R3, R4: 100R; 0603
R5: 100k; 0603
R6, R7, R8, R10: 120k; 0603
R9: 5.6k; 0603
R11: 8.2k; 0603
R12, R15: 2.4k; 0603
R13: 62k; 0603
R16: 36k; 0603
R45: 330; 0603
U1: ATSAMD21G18_QFN; TQFN48_7MM
U2, U3: TPS78230DDCR; SOT95P280X110-5N
U4: TS3USB221A; QFN-10-RSE
U5, U6: MAX9062EUK+T; 21-0057F_MXM
U7: MCP6071T-E/OT; SOT-23-5_MC_MCH
U8: SN74LVC1G19DBVR; DBV6
U$34, U$35: FIDUCIAL""; FIDUCIAL_1MM
X2: 32.768; XTAL3215

Connections:
!RESET: P1.3, U1.40 (/RESET)
#EN_DCDC: K2.8, U1.25 (PA16/I2C/I0/SERCOM1+3.0)
/FLAG_BATTLOW: R6.1, U1.28 (PA19/I3/SERCOM1+3.3/I2SD0), U6.5 (OUT)
A0: U1.3 (PA02/EINT2/AIN0/Y0/VOUT)
A2: U1.8 (PB09/I9/AIN3/SERCOM4.1)
A3: U1.9 (PA04/EINT4/VREFB/AIN4/SERCOM0.0)
AREF: C14.1, U1.4 (PA03/EINT3/VREFA/AIN1)
BUZZER: U1.23 (PA14/I14/SERCOM2+4.2), U8.1 (A)
D0: U1.16 (PA11/I11/AIN19/SERCOM0+2.3/I2SF0)
D1: U1.15 (PA10/I10/AIN18/SERCOM0+2.2/I2SCK)
D8: U1.11 (PA06/EINT6/AIN6/SERCOM0.2)
D9: U1.12 (PA07/I7/AIN7/SERCOM0.3/I2SD0)
D+: U1.34 (PA25/I13/SERCOM3+5.3/D+), U4.3 (2D+)
D-: U1.33 (PA24/I12/SERCOM3+5.2/D-), U4.4 (2D-)
EN_VCC2: R5.2, U2.3 (EN)
FLAG_CHRG: R7.1, U1.24 (PA15/I15/SERCOM3+4.3), U5.5 (OUT)
GND: C1.2, C2.2, C3.2, C4.2, C5.2, C6.2, C7.2, C8.2, C9.2, C10.2, C11.2, C12.2, C13.2, C14.2, C15.2, C16.2, C18.2, C19.2, K1.2, K2.3, K3.2, P1.5, R5.1, R9.2, R11.2, R15.2, U1.5 (GNDA), U1.18 (GND), U2.2 (GND), U3.2 (GND), U4.5 (VSS), U4.6 (!OE), U5.2 (GND_2), U5.3 (GND), U6.2 (GND_2), U6.3 (GND), U7.2 (VSS), U8.2 (GND), U8.3 (!E)
IOSENSE: C17.2, R16.1, U1.7 (PB08/I8/AIN2/SERCOM4.0), U1.47 (PB02/I2/AIN10/SERCOM5.0), U7.1 (VOUT)
ISENSE_RAW: K2.5, R12.2
MISO: U1.21 (PA12/I12/I2C/SERCOM2+4.0)
MOSI: U1.19 (PB10/I10/SERCOM4.2/I2SMC)
unnamed: R15.1, R16.2, U7.4 (VIN-)
unnamed: R2.1, R3.1, U4.1 (1D+)
unnamed: R1.1, R4.1, U4.2 (1D-)
unnamed: C2.1, U1.1 (PA00/EINT0/SERCOM1.0), X2.P$1
unnamed: C4.1, U1.2 (PA01/EINT1/SERCOM1.1), X2.P$2
unnamed: C17.1, R12.1, R13.2
unnamed: R10.1, R11.1, U6.4 (IN)
unnamed: R8.1, R9.1, U5.4 (IN)
unnamed: C16.1, R13.1, U7.3 (VIN+)
unnamed: L7.1, U8.6 (Y0)
unnamed: BZ1.1 (+), L7.2, R45.2
unnamed: BZ1.2 (-), R45.1, U8.4 (Y1)
OP_SWITCH: K2.4, U1.29 (PA20/I4/SERCOM3+5.2/I2SSC)
SCK: U1.20 (PB11/I11/SERCOM4.3/I2SCL)
SCL: K1.4, K2.6, U1.32 (PA23/I2C/I7/SERCOM3+5.1/SOF)
SCL2_CPU: JP2.1, R4.2, U1.26 (PA17/I2C/I1/SERCOM1+3.1)
SCL_2: JP2.2, K3.4, U4.7 (D-)
SDA: K1.3, K2.1, U1.31 (PA22/I2C/I6/SERCOM3+5.0)
SDA2_CPU: JP1.1, R3.2, U1.27 (PA18/I2/SERCOM1+3.2)
SDA_2: JP1.2, K3.1, U4.8 (D+)
SWCLK: P1.4, U1.45 (PA30/I10/SECOM1.2/SWCLK)
SWDIO: P1.2, U1.46 (PA31/I11/SECOM1.3/SWDIO)
S_DOWN: K1.6, U1.13 (PA08/I2C/AIN16/SERCOM0+2.0/I2SD1)
S_UP: K1.5, U1.14 (PA09/I2C/I9/AIN17/SERCOM0+2.1/I2SMC)
USB_SEL: U1.30 (PA21/I5/SERCOM3+5.3/I2SFS0), U4.9 (S)
VBUS: C6.1, C10.1, K3.3, R8.2, R10.2, U2.1 (IN), U3.1 (IN), U3.3 (EN)
VCC: C3.1, C7.1, C8.1, C9.1, C11.1, C18.1, C19.1, P1.1, R1.2, R2.2, R6.2, R7.2, U1.6 (VDDA), U1.17 (VDDIO), U1.44 (VDDIN), U3.5 (OUT), U4.10 (VCC), U5.1 (VCC), U6.1 (VCC)
VCC_2: C5.1, C12.1, C13.1, C15.1, K1.1, K2.2, U2.5 (OUT), U7.5 (VDD), U8.5 (VCC)
VDDCORE: C1.1, U1.43 (VDDCORE)
VOUTSENSE: K2.7, U1.10 (PA05/EINT5/AIN5/SERCOM0.1)

Notes on the sheet:
POWER AND FILTERING
N/C
TXLED
USBHOSTEN
RXLED
TXD
RXD
Cortex Debug/ Program Connector
BUZZER
AP7354D-30W5-7 direct Replacement
VCC_2 -- POWER AND FILTERING
A VCC para que se pueda detectar el pulsador de encendido que esta en la bateria
D10
A VCC para que se pueda detectar cambios de voltaje en la bateria durante SLEEP
G=16 BW=10Hz
IOSENSE LOWPASS FILTERING
FLEX BANDS
MUX (I2C:USB)
CHARGING DETECTOR LOW BATT DETECTOR
CPU
Vref=200mV
Vtrigger=4.5V
Vtrigger=3.1V
D13
D11
USB_SEL = 0 --> I2C + Pushbutton USB_SEL = 1 --> USB
& pushbutton!
D12
