MSTKMAD/battery-pack/02.Hardware/V1-ROVER-2K/Battery PCBs/BATT_DCDC/History/BATT_DCDC_REVISION.sch

## EAGLE design 02.Hardware/V1-ROVER-2K/Battery PCBs/BATT_DCDC/History/BATT_DCDC_REVISION.sch (2022-04-11)

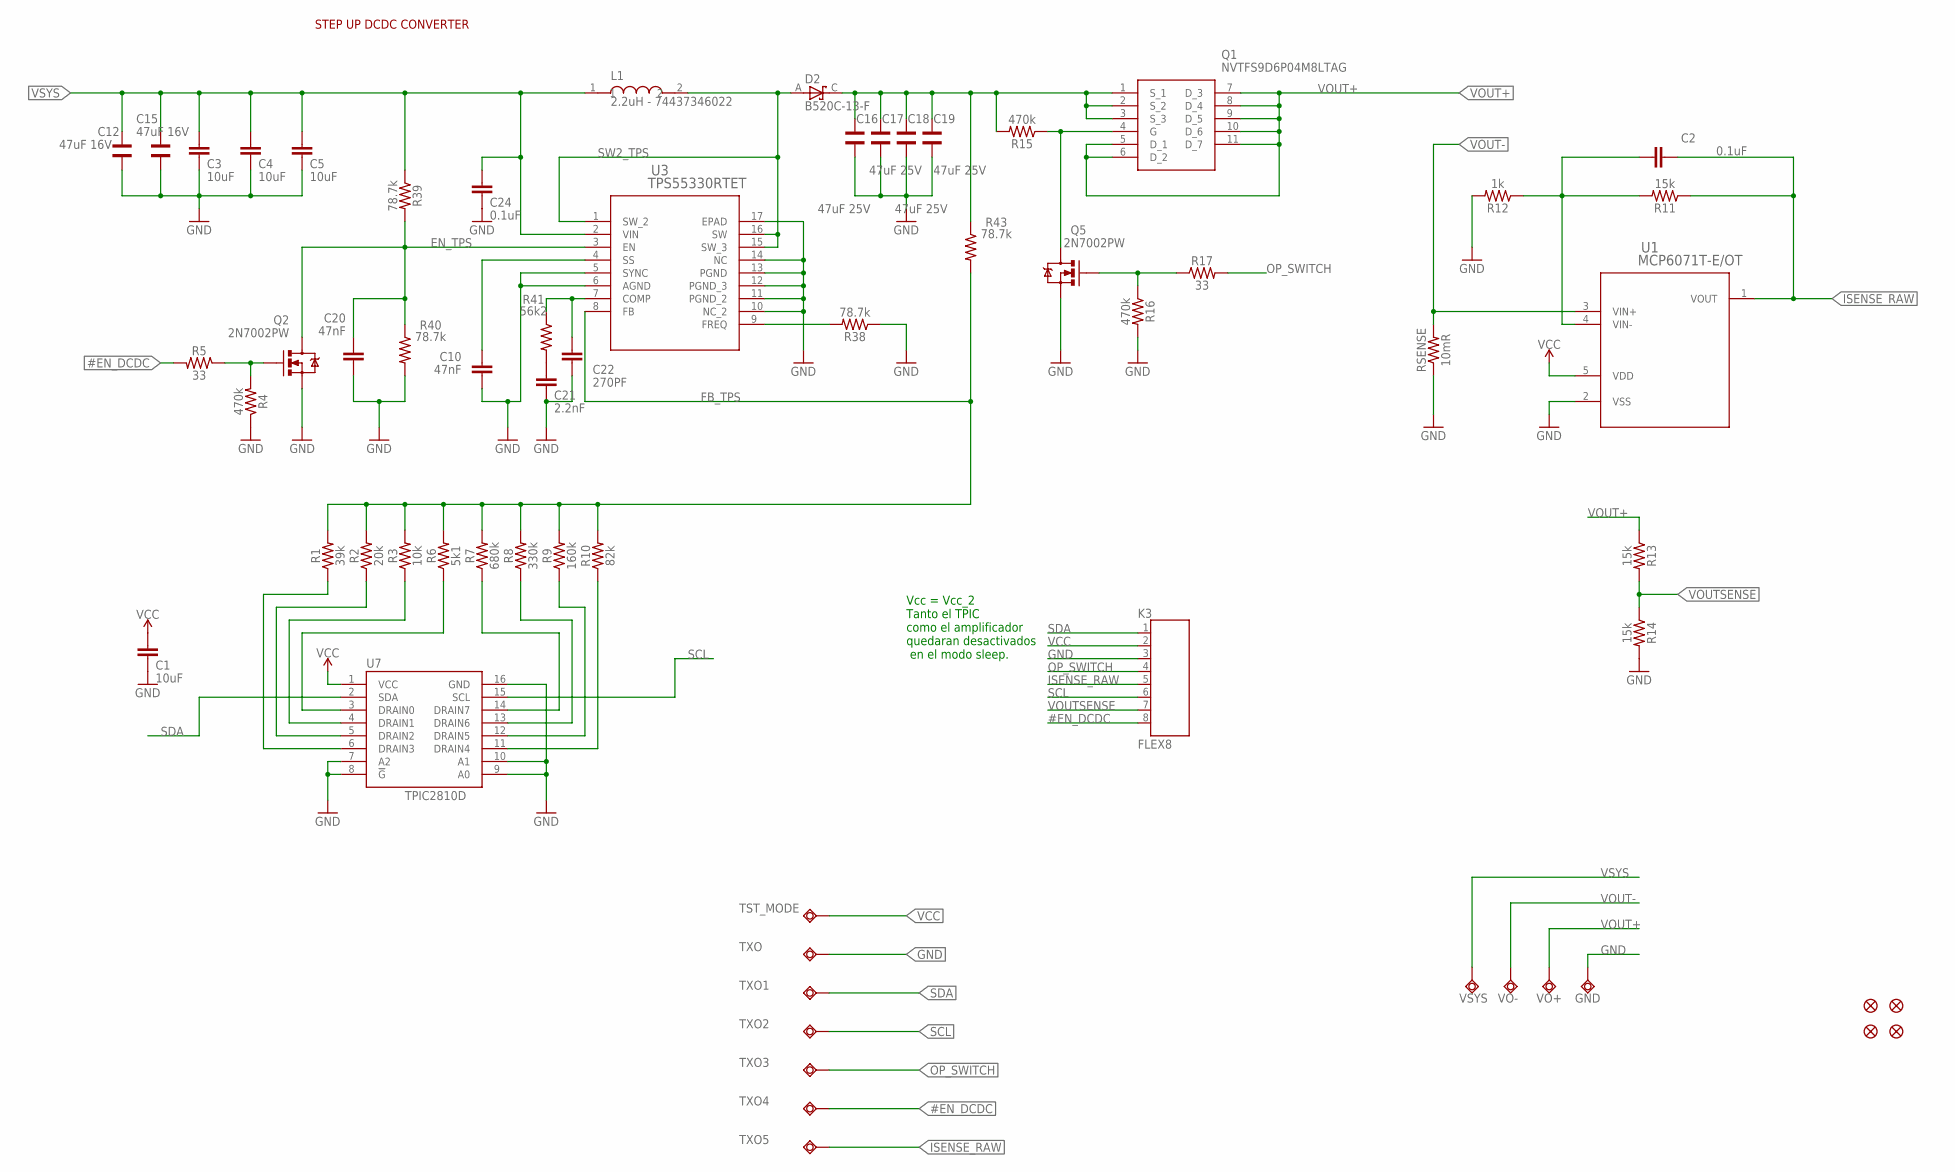
[picture p387: schematic BATT_DCDC_REVISION.sch]

Parts:
C1, C3, C4, C5: 10uF; 0805
C2, C24: 0.1uF; 0603
C10, C20: 47nF; 0603
C12, C15: 47uF 16V; WCAP-CSGP_1210
C16, C17, C18, C19: 47uF 25V; WCAP-CSGP_1210
C21: 2.2nF; 0603
C22: 270PF; 0603
D2: B520C-13-F; DIOM7959X250N
GND: TESTPAD_TPSQTP15SQ; TESTPAD_TP15SQ
K3: FLEX8
L1: 2.2uH - 74437346022; INDM7366X500
Q1: NVTFS9D6P04M8LTAG; NVTFS5124PLTWG
Q2, Q5: 2N7002PW; SOT323
R1: 39k; 0402
R2: 20k; 0402
R3: 10k; 0402
R4, R15, R16: 470k; 0402
R5, R17: 33; 0402
R6: 5k1; 0402
R7: 680k; 0402
R8: 330k; 0402
R9: 160k; 0402
R10: 82k; 0402
R11, R13, R14: 15k; 0402
R12: 1k; 0402
R38, R39, R40, R43: 78.7k; 0402
R41: 56k2; 0402
RSENSE: 10mR; 0603
TST_MODE: TESTPAD_TPSQB1,27; TESTPAD_B1,27
TXO, TXO1, TXO2, TXO3, TXO4, TXO5: TESTPAD_TPSQB1,27; TESTPAD_B1,27
U1: MCP6071T-E/OT; SOT-23-5_MC_MCH
U3: TPS55330RTET; RTE16_1P66X1P66_TEX
U7: TPIC2810D; SO16
U$1, U$2, U$34, U$35: FIDUCIAL""; FIDUCIAL_1MM
VO+: TESTPAD_TPSQTP15SQ; TESTPAD_TP15SQ
VO-: TESTPAD_TPSQTP15SQ; TESTPAD_TP15SQ
VSYS: TESTPAD_TPSQTP15SQ; TESTPAD_TP15SQ

Connections:
#EN_DCDC: K3.8, R5.2, TXO4.TP
COMP_TPS: C22.2, R41.1, U3.7 (COMP)
EN_TPS: C20.1, Q2.3 (D), R39.2, R40.1, U3.3 (EN)
FB_TPS: R1.2, R2.2, R3.2, R6.2, R7.2, R8.2, R9.2, R10.2, R43.2, U3.8 (FB)
FREQ_TPS: R38.2, U3.9 (FREQ)
GND: C1.1, C3.1, C4.1, C5.1, C10.2, C12.1, C15.1, C16.1, C17.1, C18.1, C19.1, C20.2, C21.1, C22.1, C24.1, GND.TP, K3.3, Q2.2 (S), Q5.2 (S), R4.1, R12.2, R14.2, R16.2, R38.1, R40.2, RSENSE.1, TXO.TP, U1.2 (VSS), U3.5 (SYNC), U3.6 (AGND), U3.10 (NC_2), U3.11 (PGND_2), U3.12 (PGND_3), U3.13 (PGND), U3.14 (NC), U3.17 (EPAD), U7.7 (A2), U7.8 (!G), U7.9 (A0), U7.10 (A1), U7.16 (GND)
ISENSE_RAW: C2.1, K3.5, R11.1, TXO5.TP, U1.1 (VOUT)
unnamed: C2.2, R11.2, R12.1, U1.4 (VIN-)
unnamed: R1.1, U7.6 (DRAIN3)
unnamed: R2.1, U7.5 (DRAIN2)
unnamed: Q2.1 (G), R4.2, R5.1
unnamed: R3.1, U7.4 (DRAIN1)
unnamed: R6.1, U7.3 (DRAIN0)
unnamed: R7.1, U7.14 (DRAIN7)
unnamed: Q1.4 (G), Q5.3 (D), R15.1
unnamed: R8.1, U7.13 (DRAIN6)
unnamed: R9.1, U7.12 (DRAIN5)
unnamed: R10.1, U7.11 (DRAIN4)
unnamed: Q5.1 (G), R16.1, R17.1
unnamed: C10.1, U3.4 (SS)
unnamed: C21.2, R41.2
OP_SWITCH: K3.4, R17.2, TXO3.TP
SCL: K3.6, TXO2.TP, U7.15 (SCL)
SDA: K3.1, TXO1.TP, U7.2 (SDA)
SW2_TPS: D2.A, L1.2, U3.1 (SW_2), U3.15 (SW_3), U3.16 (SW)
VCC: C1.2, K3.2, TST_MODE.TP, U1.5 (VDD), U7.1 (VCC)
VOUT+: Q1.5 (D_1), Q1.6 (D_2), Q1.7 (D_3), Q1.8 (D_4), Q1.9 (D_5), Q1.10 (D_6), Q1.11 (D_7), R13.1, VO+.TP
VOUT-: RSENSE.2, U1.3 (VIN+), VO-.TP
VOUTSENSE: K3.7, R13.2, R14.1
VSOURCE: C16.2, C17.2, C18.2, C19.2, D2.C, Q1.1 (S_1), Q1.2 (S_2), Q1.3 (S_3), R15.2, R43.1
VSYS: C3.2, C4.2, C5.2, C12.2, C15.2, C24.2, L1.1, R39.1, U3.2 (VIN), VSYS.TP

Notes on the sheet:
STEP UP DCDC CONVERTER
Vcc = Vcc_2 Tanto el TPIC como el amplificador quedaran desactivados en el modo sleep.
