MSTKMAD/battery-pack/02.Hardware/V1-ROVER-2K/Battery PCBs/TEST_BED_BATT_DCDC/History/BATT_DCDC_TEST_BED.sch

## EAGLE design 02.Hardware/V1-ROVER-2K/Battery PCBs/TEST_BED_BATT_DCDC/History/BATT_DCDC_TEST_BED.sch (2022-04-11)

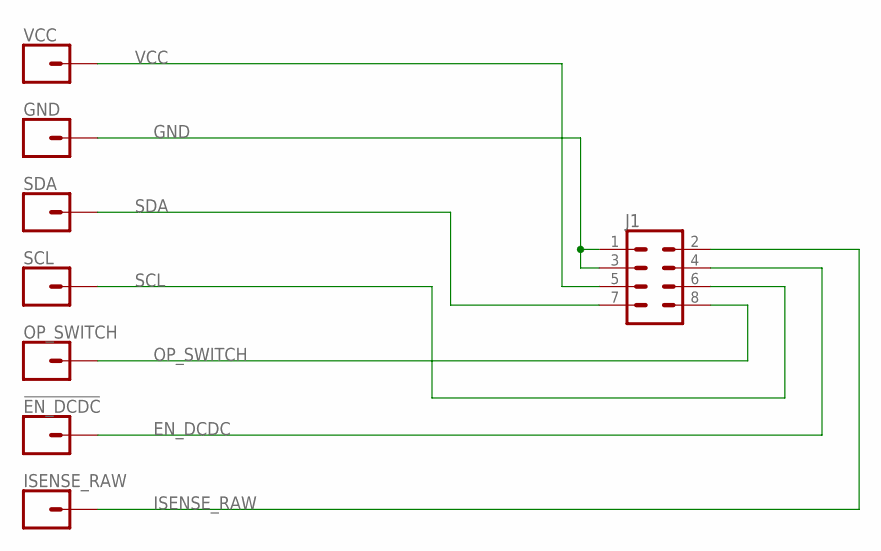
[picture p391: schematic BATT_DCDC_TEST_BED.sch]

Parts:
!EN_DCDC!: CONN_01POGOPIN_HOLE_LARGE; 1X01_POGOPIN_HOLE_0.061_DIA
GND: CONN_01POGOPIN_HOLE_LARGE; 1X01_POGOPIN_HOLE_0.061_DIA
ISENSE_RAW: CONN_01POGOPIN_HOLE_LARGE; 1X01_POGOPIN_HOLE_0.061_DIA
J1: CONN_04X2; 2X4
OP_SWITCH: CONN_01POGOPIN_HOLE_LARGE; 1X01_POGOPIN_HOLE_0.061_DIA
SCL: CONN_01POGOPIN_HOLE_LARGE; 1X01_POGOPIN_HOLE_0.061_DIA
SDA: CONN_01POGOPIN_HOLE_LARGE; 1X01_POGOPIN_HOLE_0.061_DIA
VCC: CONN_01POGOPIN_HOLE_LARGE; 1X01_POGOPIN_HOLE_0.061_DIA

Connections:
EN_DCDC: !EN_DCDC!.2, J1.4
GND: GND.2, J1.1, J1.3
ISENSE_RAW: ISENSE_RAW.2, J1.2
OP_SWITCH: J1.8, OP_SWITCH.2
SCL: J1.6, SCL.2
SDA: J1.7, SDA.2
VCC: J1.5, VCC.2
