MSTKMAD/battery-pack/02.Hardware/V1-ROVER-2K/Battery PCBs/TEST_BED_BATT_INPUT/History/BATT_INPUT_TEST_BED.sch

## EAGLE design 02.Hardware/V1-ROVER-2K/Battery PCBs/TEST_BED_BATT_INPUT/History/BATT_INPUT_TEST_BED.sch (2022-04-11)

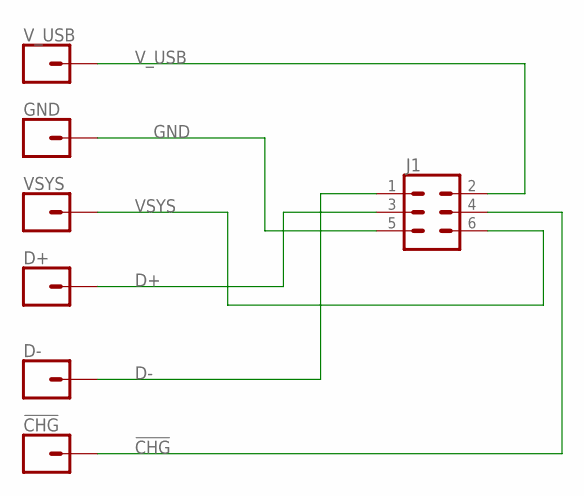
[picture p392: schematic BATT_INPUT_TEST_BED.sch]

Parts:
!CHG!: CONN_01POGOPIN_HOLE_LARGE; 1X01_POGOPIN_HOLE_0.061_DIA
D+: CONN_01POGOPIN_HOLE_LARGE; 1X01_POGOPIN_HOLE_0.061_DIA
D-: CONN_01POGOPIN_HOLE_LARGE; 1X01_POGOPIN_HOLE_0.061_DIA
GND: CONN_01POGOPIN_HOLE_LARGE; 1X01_POGOPIN_HOLE_0.061_DIA
J1: CONN_03X22X3_SILK_MALE_PTH; 2X3
VSYS: CONN_01POGOPIN_HOLE_LARGE; 1X01_POGOPIN_HOLE_0.061_DIA
V_USB: CONN_01POGOPIN_HOLE_LARGE; 1X01_POGOPIN_HOLE_0.061_DIA

Connections:
!CHG!: !CHG!.2, J1.4
D+: D+.2, J1.3
D-: D-.2, J1.1
GND: GND.2, J1.5
VSYS: J1.6, VSYS.2
V_USB: J1.2, V_USB.2
