MSTKMAD/battery-pack/02.HARDWARE/V2-ROVER R-1/03.TESTBOARDS/CIRULO_BOT/HISTORY/V1/TEST_BATT_BOT.sch

## EAGLE design 02.HARDWARE/V2-ROVER R-1/03.TESTBOARDS/CIRULO_BOT/HISTORY/V1/TEST_BATT_BOT.sch (2022-11-14)

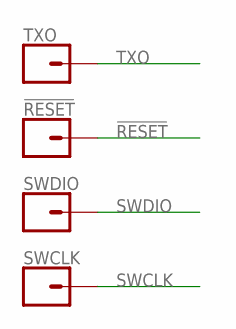
[picture p393: schematic TEST_BATT_BOT.sch]

Parts:
!RESET: CONN_01POGOPIN_HOLE_LARGE; 1X01_POGOPIN_HOLE_0.061_DIA
SWCLK: CONN_01POGOPIN_HOLE_LARGE; 1X01_POGOPIN_HOLE_0.061_DIA
SWDIO: CONN_01POGOPIN_HOLE_LARGE; 1X01_POGOPIN_HOLE_0.061_DIA
TXO: CONN_01POGOPIN_HOLE_LARGE; 1X01_POGOPIN_HOLE_0.061_DIA

Connections:
!RESET: !RESET.2
SWCLK: SWCLK.2
SWDIO: SWDIO.2
TXO: TXO.2
