MSTKMAD/battery-pack/03.Firmware/XXXX- MISC/Sound/ElPadrino/ElPadrino.ino

// Credit:
// Midi to Arduino Converter
//     - Andy Tran (extramaster), 2015
// https://www.extramaster.net/tools/midiToArduino/
//
// Process:
// Midi -> Midi tracks -> Note mappings -> Frequency
//
// CC0

// Set this to be the pin that your buzzer resides in. (Note that you can only have one buzzer actively using the PWM signal at a time).
int tonePin = 11;
void setup() {

}

void midi() {

    tone(tonePin, 195, 180.0);
    delay(200.0);
    tone(tonePin, 261, 180.0);
    delay(200.0);
    tone(tonePin, 311, 180.0);
    delay(200.0);
    delay(200.0);
    tone(tonePin, 293, 6.0);
    delay(6.66666666667);
    tone(tonePin, 1046, 171.0);
    delay(190.0);
    delay(3.33333333333);
    tone(tonePin, 311, 177.0);
    delay(196.666666667);
    delay(3.33333333333);
    tone(tonePin, 261, 177.0);
    delay(196.666666667);
    delay(3.33333333333);
    tone(tonePin, 293, 177.0);
    delay(196.666666667);
    delay(3.33333333333);
    tone(tonePin, 261, 240.0);
    delay(266.666666667);
    delay(66.6666666667);
    tone(tonePin, 207, 120.0);
    delay(133.333333333);
    tone(tonePin, 233, 120.0);
    delay(133.333333333);
    tone(tonePin, 195, 900.0);
    delay(1000.0);
    tone(tonePin, 195, 180.0);
    delay(200.0);
    tone(tonePin, 261, 177.0);
    delay(196.666666667);
    delay(3.33333333333);
    tone(tonePin, 311, 180.0);
    delay(200.0);
    tone(tonePin, 293, 177.0);
    delay(196.666666667);
    delay(3.33333333333);
    tone(tonePin, 261, 177.0);
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
    delay(3.33333333333);
    tone(tonePin, 195, 180.0);
    delay(200.0);
    tone(tonePin, 195, 180.0);
    delay(200.0);
    tone(tonePin, 246, 180.0);
    delay(200.0);
    tone(tonePin, 261, 1437.0);
    delay(1596.66666667);

}

void loop() {
    // Play midi
    midi();
}
