MSTKMAD/battery-pack/03.Firmware/XXXX- MISC/Sound/Paquito/Paquito.ino

// Credit:
// Midi to Arduino Converter
//     - Andy Tran (extramaster), 2015
// https://www.extramaster.net/tools/midiToArduino/
//
// Process:
// Midi -> Midi tracks -> Note mappings -> Frequency
//
// CC0

// Set this to be the pin that your buzzer resides in. (Note that you can only have one buzzer actively using the PWM signal at a time).
int tonePin = 11;
void setup() {

}

void midi() {

    tone(tonePin, 195, 135.0);
    delay(150.0);
    delay(170.0);
    tone(tonePin, 195, 135.0);
    delay(150.0);
    delay(160.0);
    tone(tonePin, 195, 135.0);
    delay(150.0);
    delay(1163.33333333);
    tone(tonePin, 311, 24.0);
    delay(26.6666666667);
    delay(13.3333333333);
    tone(tonePin, 329, 22.5);
    delay(25.0);
    delay(18.3333333333);
    tone(tonePin, 311, 22.5);
    delay(25.0);
    delay(11.6666666667);
    tone(tonePin, 329, 25.5);
    delay(28.3333333333);
    delay(16.6666666667);
    tone(tonePin, 311, 25.5);
    delay(28.3333333333);
    delay(10.0);
    tone(tonePin, 329, 21.0);
    delay(23.3333333333);
    delay(13.3333333333);
    tone(tonePin, 311, 25.5);
    delay(28.3333333333);
    delay(15.0);
    tone(tonePin, 329, 22.5);
    delay(25.0);
    delay(13.3333333333);
    tone(tonePin, 311, 24.0);
    delay(26.6666666667);
    delay(15.0);
    tone(tonePin, 329, 21.0);
    delay(23.3333333333);
    delay(18.3333333333);
    tone(tonePin, 311, 25.5);
    delay(28.3333333333);
    delay(10.0);
    tone(tonePin, 329, 22.5);
    delay(25.0);
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
    tone(tonePin, 138, 3.0);
    delay(3.33333333333);
    tone(tonePin, 65, 7.5);
    delay(8.33333333333);
    tone(tonePin, 92, 61.5);
    delay(68.3333333333);
    tone(tonePin, 116, 72.0);
    delay(80.0);
    delay(83.3333333333);
    delay(3.33333333333);
    tone(tonePin, 65, 69.0);
    delay(76.6666666667);
    tone(tonePin, 138, 3.0);
    delay(3.33333333333);
    delay(153.333333333);
    tone(tonePin, 92, 72.0);
    delay(80.0);
    delay(6.66666666667);
    delay(73.3333333333);
    tone(tonePin, 65, 6.0);
    delay(6.66666666667);
    tone(tonePin, 92, 66.0);
    delay(73.3333333333);
    delay(80.0);
    delay(18.3333333333);
    delay(13.3333333333);
    delay(1.66666666667);
    tone(tonePin, 116, 42.0);
    delay(46.6666666667);
    tone(tonePin, 73, 30.0);
    delay(33.3333333333);
    tone(tonePin, 138, 172.5);
    delay(191.666666667);
    tone(tonePin, 65, 30.0);
    delay(33.3333333333);

}

void loop() {
    // Play midi
    midi();
}
