MSTKMAD/battery-pack/03.Firmware/XXXX- MISC/TestSAMDE/TestSAMDE.ino

void setup() {
  // Initialize the LED pin as an output
  pinMode(2, OUTPUT);
  pinMode(3, OUTPUT);
  pinMode(4, OUTPUT);
  pinMode(5, OUTPUT);
  pinMode(16, OUTPUT);
  pinMode(17, OUTPUT);
  pinMode(6, OUTPUT);
  pinMode(10, OUTPUT);
  pinMode(9, OUTPUT);
  pinMode(11, OUTPUT);
  pinMode(7, OUTPUT);
}

void loop() {
  // Turn the LED on
  digitalWrite(2, HIGH);
  digitalWrite(3, HIGH);
  digitalWrite(4, HIGH);
  digitalWrite(5, HIGH);
  digitalWrite(16, HIGH);
  digitalWrite(17, HIGH);
  digitalWrite(6, HIGH);
  digitalWrite(10, HIGH);
  digitalWrite(9, HIGH);
  digitalWrite(11, HIGH);
  digitalWrite(7, HIGH);
  delay(500); // Wait for a second
  // Turn the LED off
  digitalWrite(2, LOW);
  digitalWrite(3, LOW);
  digitalWrite(4, LOW);
  digitalWrite(5, LOW);
  digitalWrite(16, LOW);
  digitalWrite(17, LOW);
  digitalWrite(6, LOW);
  digitalWrite(10, LOW);
  digitalWrite(9, LOW);
  digitalWrite(11, LOW);
  digitalWrite(7, LOW);
  delay(100); // Wait for a second
}
