MSTKMAD/battery-pack/(commit log)

2022-04-11 First Commit
    Unificacion y creacion del repositorio unico
    [Articulos Newsletter.xlsx, BATT_BUTTONS.sch, BATT_CHASIS_BOM.xlsx, BATT_CONN.sch, BATT_CONN_V2.sch, BATT_CPU (2).sch, BATT_CPU.sch, BATT_CPU_DRILL_REVISION.sch]
2022-04-11 Create battery-pack.code-workspace
2022-04-11 Cambio de nombres de los directorios raiz
    [Articulos Newsletter.xlsx, BATT_BUTTONS.sch, BATT_CHASIS_BOM.xlsx, BATT_CONN.sch, BATT_CONN_V2.sch, BATT_CPU (2).sch, BATT_CPU.sch, BATT_CPU_DRILL_REVISION.sch]
2022-04-12 Fix minor error form migration
    [cyclator.ino]
2022-04-21 Reorganizacion de directorios
    [Articulos Newsletter.xlsx, BATT_BUTTONS.brd, BATT_BUTTONS.sch, BATT_CHASIS_BOM.xlsx, BATT_CONN.brd, BATT_CONN.sch, BATT_CONN_V2.sch, BATT_CPU (2).brd]
2022-04-21 BOM ROVER 2k. Version 6
    [BATT_PCBS_BOM.xlsx]
2022-06-28 Cambios revisados con David
    Revision de los pcbs de la bateria.
    En el DCDC se añade un diode Clamp (bat54s) en la medicion de la tension de salida.
    Actualizacion de la BOM a v8.
    Documentos de Cambios de versiones
    [BATT_BUTTONS.sch, BATT_CPU.brd, BATT_CPU.sch, BATT_DCDC.brd, BATT_DCDC.sch, BATT_DISP.brd, BATT_DISP.sch, BATT_INPUT.brd]
2022-08-05 Documentos de Fabricacion
2022-08-05 Update Labview
    [Log Spreadsheet.csv, NumberSerial.csv]
2022-08-05 update BOMs
    [Tornilleria Bateria.xlsx]
2022-08-05 Fase de testeo de diseño
    Se descomenta la parte del test de diseño para si prueba.
    Actualizacion del calculo de la corriente de salida.
2022-09-28 Revision antes de Produccion
    r6, r7: 120k a 10k
    r45: no se monta
    se añaden notas
    [BATT_CPU.brd, BATT_CPU.sch]
2022-09-29 Review final antes de produccion
    -cambian valores de c10, r13, r15
    -se añaden notas
    [BATT_DCDC.brd, BATT_DCDC.sch]
2022-09-29 Review general antes de produccion
    Se modifica:
    R13 --> El sensado de vosense estaba tarado para 3.3v en vez de 3v de vsupply
    R15 --> Se baja el valor porque no hace falta que sea tan alta
    C10 --> Error de valor 470n en vez de 47n
    [BATT_INPUT.brd, BATT_INPUT.sch]
2022-09-29 review general antes de produccion
    R1, R2 --> Cambiamos valor de pullup para dejarlo igual que en EDCPSU
    R8 --> Se corrige el valor para dejarlo como recomienda en la nota de aplicacion. Comprobamos 4mA menos de consumo (de 21mA a 18mA)
    [BATT_DISP.sch]
2022-09-29 Revision general antes de produccion
    R1--> 330R (este era el valor real usado en las pruebas)
    [BATT_BUTTONS.brd, BATT_BUTTONS.sch]
2022-10-26 Se añade un directorio para la version 2 del rover.
    Se añade un directorio para la version 2 del rover.
    Se copia el fichero de DCDC en la nueva carpeta como version inicial de este nuevo diseño
    Se crea el arbol de directorios del nuevo diseño de Rover
    [BATT_BUTTONS.brd, BATT_BUTTONS.sch, BATT_CHASIS_BOM.xlsx, BATT_CONN.brd, BATT_CONN.sch, BATT_CPU (2).brd, BATT_CPU (2).sch, BATT_CPU.brd]
2022-10-27 Se añade directorios para Mecanica y se sube version v2 de mecanica
    [0. ROVER-1K_v2.stp, DCDC board.dxf, panel v2.stl, porta v2.stl, tapabot v2.stl, tapatop v2.stl]
2022-10-27 Primera version de emplazamiento de DCDC Board
    [BATT_DCDC.brd, BATT_DCDC.sch]
2022-10-27 Se alade primera version de CPU Board ROVER1K
    [BATT_CPU.brd, BATT_CPU.sch, pcb cpu.dxf]
2022-10-31 Trabajo dia 31 Oct. Update
    SOLO TRABAJO SOBRE ESQUEMATICO.
    - Inclusion pantalla 49".
    - Cambio en el diseño de la gestion de la laimentacion. Inclusion de transistor P comandado por 2 N (Boton de encendido y Señal digital CPU)
    - Multiplaxado del control del DCDC y del Switch de salida, entre las señales digitales de la CPU y el comparador.
    - Se añaden fajas place holder.
    [BATT_CPU.brd, BATT_CPU.sch, BATT_DCDC.brd, BATT_DCDC.sch]
2022-11-02 Modificacion Ruteado CPU
    Se añade la version 1 de las dimensiones del PCB y se posicionan los componentes sin ruteado.
    FALTA: Circuito acondicionamiento Display .
    [BATT_CPU.brd, BATT_CPU.sch]
2022-11-03 Update CPU PCB.
    Routeado terminado v1. PENDIENTE DE REVISION.
    [BATT_CPU.brd, BATT_CPU.sch]
2022-11-04 Update CPU
    Colocacion de transistor a la salida del comparador.
    "Multiplexado" de la señal del OP_SWITCH
    [BATT_CPU.brd, BATT_CPU.sch]
2022-11-04 Update DCDC
    Colocacion y Posicionamiento de los componentes en la tarjeta.
    Pendiente de Routeado.
    [BATT_DCDC.brd, BATT_DCDC.sch]
2022-11-04 Version 3 de la mecanica.
    Archivos pdf y step de las 6 piezas de la mecanica de la bateria.
    Archivos de la placa de cobre del top.
    [barril v3.step, copper contact.step, panel v3.step, porta v3.step, tapabot v3.step, tapabotjack v3.step, tapatop v3.step]
2022-11-07 Mecanica actualizada
    [0. ROVER-1K_v2_MINI JACK.stp, 0. ROVER-1K_v2_RCA-3.stp, EX-RV1K-02 BASTIDOR DE ELECTRONICA_31-10.stp, EX-RV1K-16 FAJA CPU.dxf, PCB DCDC v3 2.dxf, barril v3.step, boton v3.step, panel v3.step]
2022-11-07 Inclusion FLEX 4
    [BATT_DCDC.brd, BATT_DCDC.sch]
2022-11-07 Avances en el rutado
    [BATT_DCDC.brd, BATT_DCDC.sch]
2022-11-07 Update DCDC
    Ruteado inicial.
    Pendiente de Revision
    [BATT_DCDC.brd, BATT_DCDC.sch]
2022-11-07 revision inicial
    corregido rutado del display
    [BATT_CPU.brd, BATT_CPU.sch]
2022-11-07 DCDC Resitencia serie DAC
    [BATT_DCDC.brd, BATT_DCDC.sch]
2022-11-07 Errors Fix
    Polaridad PNP.
    Señal Rx cambio por TX.
    VDD cambio por VCC_2 Display.
    ERC y DRC Check
    [BATT_CPU.brd, BATT_CPU.sch]
2022-11-08 Revision de rutado (no final)
    [BATT_DCDC.brd, BATT_DCDC.sch]
2022-11-08 Se añade overlay
    [overlay v3.dxf]
2022-11-08 Fix errors
    DCDC
    Recolocacion de los canales RESET y SWCLK
    Colocacion resistencia en serie en la linea de RESET.
    Recolocacion por espaciado de tornilla.
    CPU
    Condensador desacoplo linea RESET.
    [BATT_CPU.brd, BATT_CPU.sch, BATT_DCDC.brd, BATT_DCDC.sch]
2022-11-08 Revision Silk y BOM
    [BATT_DCDC.brd, BATT_DCDC.sch]
2022-11-08 Silk and BOM Review
    [BATT_CPU.brd, BATT_CPU.sch]
2022-11-08 Revision 2 - Release candidate (v1)
    Se añade resistencia de FB que faltaba (R13)
    Se corrige el valor de R9
    Se separa la masa de señal (no potencia) de U3 a AGND
    Se añaden condensadores de desacoplo para U1 y U7
    Corregido el encapsulado de D1 a SOT323
    [BATT_DCDC.brd, BATT_DCDC.sch]
2022-11-08 Añadidos planos de Faja8 y Faja12
2022-11-09 Revision general
    [BATT_CPU.brd, BATT_CPU.sch]
2022-11-09 Update BATT_CPU.brd
    Fix Outline
    [BATT_CPU.brd]
2022-11-09 Update BATT_CPU.brd
    Subida del boton central 1mm para favorecer el mecanizado del silk screen dando margen en la parte inferior.
    [BATT_CPU.brd]
2022-11-09 Revision antes de enviar a SETI
    [BATT_CPU.brd, BATT_CPU.sch]
2022-11-09 Actualizacion git ignore, PCB FLEX, CONNECTOR y Carpeta BOM
    [BATT_CONNECTOR.brd, BATT_CONNECTOR.csv, BATT_CONNECTOR.sch, BATT_CONNECTOR.xlsx, BATT_CPU.xlsx, BATT_DCDC.xlsx, BATT_FLEXX.brd, BATT_FLEXX.sch]
2022-11-09 Release - SETI_PROTO
    [BATT_CONNECTOR.brd, BATT_CONNECTOR.sch]
2022-11-09 Release PROTO-SETI
    Se separan los flex en dos PCBs distintos: flex8 y flex12
    [BATT_FLEX12.brd, BATT_FLEX12.sch, BATT_FLEX8.brd, BATT_FLEX8.sch, DRILEGEND.CFG]
2022-11-10 Se desplaza el agujero del boton rojo 1mm hacia arriba
2022-11-10 Se sube 1mm el boton de encendido
    Hecho con SHARP3D.
    Avisar a Jose Luis para que lo actualice
    [panel v3.step]
2022-11-10 Subido 1mm el taladro para el pulsador de encendido
    [overlay v3.dxf]
2022-11-11 Actualizacion CPU y PROG_BATT
    [BATT_CPU.brd, BATT_CPU.sch, PROG_BATT.brd, PROG_BATT.sch]
2022-11-14 Modificaciones y correcciones (WIP)
    [PROG_BATT.brd, PROG_BATT.sch]
2022-11-14 Update PROG_BATT.brd
    Correcion de texto y colocación de jumper en TXO.
    [PROG_BATT.brd]
2022-11-14 Correcion de letering pre-lanazdo
    correcion de letras y Colocacion Pin Auxiliar TXO
    [PROG_BATT.brd, PROG_BATT.sch]
2022-11-14 Revision final (pedido a PCBWAY)
    Se cambia nombre de ficheros
    Cambios menores
    Generacion de gerber
    [BATT_CPUPROG.brd, BATT_CPUPROG.sch, PROG_BATT.sch]
2022-11-14 Creacion v1. PCB Programacion Produccion Testeo
    3 PCB:
    TEST_PROD_BATT_BOT
    TEST_PROD_BATT_TOP
    TEST_PROD_BATT_PANEL
    [TEST_PROD_BATT_BOT.brd, TEST_PROD_BATT_BOT.sch, TEST_PROD_BATT_PANEL.brd, TEST_PROD_BATT_PANEL.sch, TEST_PROD_BATT_TOP.brd, TEST_PROD_BATT_TOP.sch]
2022-11-14 Update BATT_CONNECTOR.brd
    Recolocacion de los pads para pogopins
    [BATT_CONNECTOR.brd]
2022-11-14 Revisado para PCBWAY
    Revisado para PCBWAY
    Se genera GERBER
    Se cambia nombre
    [TEST_BATT_BOT.brd, TEST_BATT_BOT.sch]
2022-11-14 Reubicado en Testboards
    [TEST_BATT_BOT.brd, TEST_BATT_BOT.sch]
2022-11-14 Revisado y listo para pedido PCBWAY
    Revision ultima antes de pedido de produccion
    Modificacion de nombres
    Cambio de directorio a TESTBOARDS
    [BATT_CPUPROG.brd, BATT_CPUPROG.sch, TEST_BATT_PANEL.brd, TEST_BATT_PANEL.sch, TEST_BATT_TOP.brd, TEST_BATT_TOP.sch, TEST_PROD_BATT_PANEL.sch]
2022-11-15 Se añade Assembly general y se incluyen tamaños de roscas en barril y panel
2022-12-01 Doc Fabricacion actualizada para SETI (Nov-22)
    Fabricacion de primer prototipo en SETI (4 juegos)
    [BATT_CONNECTOR.xlsx, BATT_CPU.xlsx, BATT_DCDC.xlsx]
2022-12-01 Project Plan Baseline añadido
    [Baseline Project-Plan - BATTERY.xlsx]
2022-12-01 Fichero de BOM enviado a SETI para fabricacion prototipo 1
2022-12-01 Imagenes para produccion prototipo SETI
2022-12-01 Cambio de faja por conector interPCB. Issue #1
    [BATT_CPU.brd, BATT_CPU.sch, BATT_DCDC.brd, BATT_DCDC.sch]
2022-12-01 Cierre ISSUE #3
    [TEST_BATT_TOP.brd]
2022-12-01 Issue #2
    [BATT_CONNECTOR.brd, BATT_CONNECTOR.sch, BATT_DCDC.brd]
2022-12-05 Cambios menores durante revision de proto_1 de SETI
    en el esquematico se incluye la frecuencia del FPB del sensado de corriente
    en la BRD se aumenta el ancho de la pista de resistencia del DAC
    [BATT_CONNECTOR.brd, BATT_DCDC.brd, BATT_DCDC.sch, Baseline Project-Plan - BATTERY.xlsx]
2022-12-07 Issue #3
    Correcion de la colocacion de los agujeros de tornillos y pogopines para consolidar diseños con el 3D.
    [TEST_BATT_BOT.brd, TEST_BATT_TOP.brd]
2022-12-22 Modificaciones despues de revisar 1er prototipo de SETI
    Se van añadiendo modificaciones, pero no están todas las que son necesarias.
    Este es el fichero que le paso a Javi para que comience con el resto de los cambios.
    [BATT_DCDC.brd, BATT_DCDC.sch]
2022-12-22 Ajustes finales CPU Javi. Pendiente Revision
    ISSUES: #11, #12,#10,#9,#8,#7,#4
    [BATT_CPU.brd, BATT_CPU.sch]
2022-12-23 Revision de cambios de Javi
    Despues de Integracion de prototipo 1 de SETI
    Se generan cambios
    Los implementa Javi, los revisa David
    [BATT_CPU.brd, BATT_CPU.sch]
2022-12-23 Cambios DCDC Javi Version Final. Pendiente de revision
    [BATT_DCDC.brd, BATT_DCDC.sch]
2022-12-23 Cambios Flex11 Javi Version Final. Pendiente de Revision
    [BATT_FLEX11.brd, BATT_FLEX11.sch]
2022-12-23 Cambios Connector Javi Version Final. Pendiente de Revision
    [BATT_CONNECTOR.brd, BATT_CONNECTOR.sch]
2022-12-23 Version 2 PCB_CPU y Version 3 BOM_CPU
    Cambios menores en el lettering del PCB.
    Cambios en la BOM para adecuarse a la version 2 de la CPU.
    [BATT_CPU.brd, BATT_CPU.sch, BATT_CPU.xlsx]
2022-12-27 Revision esquematico DCDC-release candidate para generar BOM 1ra produccion SETI
    Pendiente de revisar serigrafias
    [BATT_DCDC.sch]
2022-12-27 CPU sch y brd revisados y listos para produccion SETI
    [BATT_CPU.brd, BATT_CPU.sch]
2022-12-27 brd revisado para produccion SETI
    [BATT_DCDC.brd]
2022-12-27 DCDC sch y brd V1 history creado
    Para tener tracking de las versiones fabricadas
    [BATT_DCDC.brd, BATT_DCDC.sch]
2022-12-27 Mechanics v4 - primera produccion Wenext
    [Wenext - Quantity and color.xlsx, barril v4.step, boton v4.step, copper contact v4.step, overlay v4.dxf, overlay v4.step, panel v4.step, porta v4.step]
2022-12-27 Cambio del Componente del Boton. Pad de GND
    Se modifica el componente de los botones para incluir un pad de tierra para favorecer el aislamiento de estatica.
    [BATT_CPU.brd, BATT_CPU.sch]
2022-12-27 Ajuste de ancho de pista para lineas de potencias.
    [BATT_FLEX11.brd, BATT_FLEX11.sch]
2022-12-27 Revision para produccion SETI
    Faltaba el taladro para GND
    Se mueven los testpads para rutado
    Se hacen pistas mas gruesas
    Se añaden mas vias para facilitar circulacion corriente
    Se añaden y depuran las serigrafias
    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
    [BATT_CONNECTOR.brd, BATT_CONNECTOR.sch]
2022-12-27 Revision para produccion SETI (1er batch)
    Se añaden textos para facilitar el montaje
    [BATT_FLEX11.brd]
2022-12-27 Mejora para produccion
    Se engrosa el tamaño del landing VOUT+ de D1 (Transzorb) para que pueda disipar mejor la temperatura en el evento de un posible sobrevoltaje. Se añade cobre en capa Route2 y Route15
    [BATT_CONNECTOR.brd]
2022-12-27 Cambios menores antes de produccion y ficheros GERBER generados
    Se quitan las serigrafias de respaldo que se incluyeron en el pulsador para añadir el pad de GND
    Se generan los ficheros de montaje SMD
    Se genera el ZIP con los GERBER
    [BATT_CPU.brd, BATT_CPU.sch]
2022-12-27 ELIMINADO y sustituido por GERBER actualizado
    Se incluye ademas en el nuevo ZIP los ficheros de montaje SMD, el brd y el sch
2022-12-27 Ficheros de fabricacion para produccion 1 en SETI
    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
2022-12-27 Ficheros de 1 produccion en SETI
    Se elimina el ZIP con el GERBER solo y se sustituye por un ZIP con los ficheros de montaje SMD, el sch y el brd
2022-12-28 Produccion 1 SETI - Se mueven testpads
    Algunos testpads quedaban ocultos por el chasis.
    me he dado cuenta al hacer la testboard bot.
    Se mueven los testpads para que no queden ocultos.
    [BATT_CONNECTOR.brd, BATT_CONNECTOR.dxf]
2022-12-28 Pedido PCBWAY compatible con v2 de PCB CONN
    PCB CONN ha movido los testpoints y se añade RXI
    [TEST_BATT_BOT.brd, TEST_BATT_BOT.sch]
2022-12-28 Produccion 1 dic'22 - Se cambia RSENSE a 1206
    Se cambia encapsulado 0603 por 1206
    Se añaden más vias a la conexion de Rsense
    [BATT_DCDC.brd, BATT_DCDC.sch]
2023-01-02 Mantenimiento del folder de history
    [BATT_DCDC.brd, BATT_DCDC.sch]
2023-01-04 Añadido version HISTORY en directorio
    [BATT_CONNECTOR.brd, BATT_CONNECTOR.sch, BATT_CPU.brd, BATT_CPU.sch]
2023-01-05 BOM PCB Connector Actualizada y SCH
    Se actualiza la BOM con el nuevo transistor Q1 DMG3415U-7
    [BATT_CONNECTOR.brd, BATT_CONNECTOR.sch, BATT_CONNECTOR.xlsx]
2023-01-05 Versiones 1 de las pogopins de la CPU y la DCDC
    [POGO_CPU.brd, POGO_CPU.sch, POGO_DCDC.brd, POGO_DCDC.sch]
2023-01-05 BOM actualizadas para fabricacion 1ra SETI
    [BATT_CONNECTOR.xlsx, BATT_CPU.xlsx]
2023-01-05 BOM DCDC actualizada para 1ra produccion SETI 500uds
    [BATT_DCDC.xlsx]
2023-01-05 No necesitamos la CSV
    [BATT_CONNECTOR.csv]
2023-01-05 1ra produccion seti 500uds
    [BATT_DCDC.xlsx]
2023-01-05 Version1 pendiente de revision Test CPU
    [TEST_CPU.brd, TEST_CPU.sch]
2023-01-05 Test DCDC (Incompleto)
    [TEST_DCDC.brd, TEST_DCDC.sch]
2023-01-06 TESTBOARDS Pedido PCBWAY 6ENERO
    Revision antes de enviar a PCBWAY
    [POGO_DCDC.brd, TEST_CPU.brd, TEST_CPU.sch]
2023-01-06 wip previo a envio PCBWAY
    Queda revisar todavia y rutear
    [TEST_DCDC.brd, TEST_DCDC.sch]
2023-01-09 Version 1 pendiente de revision
    [TEST_DCDC.brd, TEST_DCDC.sch]
2023-01-09 Cambio en la alimentacion del conector.
    Cambio de Vcc en el conector de programacion a Vcc CPU.
    [TEST_CPU.brd, TEST_CPU.sch]
2023-01-09 Pedido PCBWAY Enero - Revision de cambios de Javi
    Se hacen cambios menores
    [TEST_CPU.brd]
2023-01-09 Versiones v2 pendientes de revision de conjunto de PCBs Cirulo programacion.
    [BATT_CPUPROG.brd, BATT_CPUPROG.sch, TEST_BATT_BOT.brd, TEST_BATT_BOT.sch, TEST_BATT_PANEL.brd, TEST_BATT_PANEL.sch, TEST_BATT_TOP.brd, TEST_BATT_TOP.sch]
2023-01-09 Cambio de nombre de placas
    [CIRULO_BOT.brd, CIRULO_BOT.sch, CIRULO_PANEL.brd, CIRULO_PANEL.sch, CIRULO_TOP.brd, CIRULO_TOP.sch]
2023-01-09 Pedido PCBWAY ene-23 - revision despues de diseño
    [TEST_DCDC.brd, TEST_DCDC.sch]
2023-01-10 Close Issue Test 3 #3
    [BATT_CONNECTOR.brd, BATT_CONNECTOR.dxf, BATT_CONNECTOR.sch, BATT_CONNECTOR.xlsx, BATT_CPU.brd, BATT_CPU.sch, BATT_CPU.xlsx, BATT_CPUPROG.brd]
2023-01-10 Close Issues #2 #3 #1
    [BATT_CONNECTOR.brd, BATT_CONNECTOR.dxf, BATT_CONNECTOR.sch, BATT_CONNECTOR.xlsx, BATT_CPU.brd, BATT_CPU.sch, BATT_CPU.xlsx, BATT_CPUPROG.brd]
2023-01-10 Closes #1, closes #3 , #2
    [BATT_CPU.brd, BATT_CPU.sch, BATT_DCDC.brd, BATT_DCDC.sch]
2023-01-12 Separacion por Carpetas. Renombre de la carpeta R-1
    [BATT_CONNECTOR.dxf, TEST_CPU.brd, TEST_DCDC.brd, TEST_DCDC.sch]
2023-01-12 Actualizacion de librerias para LCD de 49". Actualizacion del Logeo en EEPROM
2023-01-12 Ejemplo de control del DAC por PWM
2023-01-12 Creacion del ejemplo de la aplicacion de Naming
2023-01-12 Comprador de Buzzers
    [Comparador Buzzers.xlsx]
2023-01-12 Se quita del trakeo los archivos de guardado de excel
2023-01-12 curvas de carga descarga de la bateria EZFAN
    [TESTBATTERYEXFAN.xlsx]
2023-01-12 Documento de verificacion de la calibracion del DAC.
    [Calibracion DAC.xlsx]
2023-01-16 Archivo de resumen de la version del sistema.
    [BOM del Sistema.xlsx]
2023-01-17 Archvos de Compilacion de Hardward de la SAMD y modificacion de librerias de display
2023-01-18 Minor Fix y ultima version ejecutable Hex.
    [NAMING.ino]
2023-01-19 Version enviada a Wenext
    [ASM TEST_BATT.stp, EX-RV1K-14 TAPA CONECTOR 3.5.stp, porta v4.1.2.step]
2023-01-19 Archivos de produccion usados para testeo del grabado del numero de serie y modificacion de la libreria
2023-01-20 Close #14
    [CIRULO_PANEL.xlsx, TEST_CPU.brd, TEST_CPU.xlsx, TEST_DCDC.brd, TEST_DCDC.xlsx]
2023-01-24 Ampliacion a toda la eeprom de los datos enviados en el modod diagnostico.
2023-01-24 Asignacion de Valores a los componentes pasivos de las tarjetas de Testeo. Actualziacion de las BOMs.
    [CIRULO_PANEL.brd, CIRULO_PANEL.sch, CIRULO_PANEL.xlsx, TEST_CPU.brd, TEST_CPU.sch, TEST_CPU.xlsx, TEST_DCDC.brd, TEST_DCDC.sch]
2023-01-25 Creacion de carpeta de testeo de Rover 2k
    [Log Spreadsheet.csv, NumberSerial.csv]
2023-01-25 Creacion de archivo para RP2040 de verificacion de produccion
2023-01-26 Creacion del archivo de verificacion del DCDC v1
2023-01-26 Integracion Modo diagnostico durante el estado de Sleep.
2023-01-27 Fix del timer del boton central en la interrupcion del despertar.
    [B2.ino]
2023-01-27 Actualizacion del Gitignore para los archivos de progrmaacion.
2023-01-27 enviado a PCBWAY
2023-01-31 Test de los avisos de los errores
    [TEST_ERROR_SCREEN.ino]
2023-01-31 Eliminacion de libreria SAMD para facilitar compilacion con RP2040
2023-01-31 codigo de verificacion de fabricacion de las placas de testeo.
2023-02-01 version 5. se añaden los componentes correspondientes a los conectores interplaca.
    [BATT_CPU.xlsx, BATT_DCDC.xlsx]
2023-02-01 Calculo de los valores del DAC de 12 bits
    [Calibracion DAC.xlsx]
2023-02-01 Mensajes de aviso de errores. close #31
    [B2.ino, TEST_ERROR_SCREEN.ino]
2023-02-01 Repaso de Documentacion del codigo. 1/2/23
2023-02-09 Añadimos el clip de thunder al repositorio
    [CLIP THUNDER INCL-1.stp, Clip Thunder solid 2.step]
2023-02-09 POGOPIN BED añadido a repositorio
    [TEST DC-DC ROVER R1.stp]
2023-02-10 Version 1 PCB JACK
    [PCB_JACK.brd, PCB_JACK.sch]
2023-02-13 Connector Jack
    [PCB_JACK.brd, PCB_JACK.sch]
2023-02-15 Close issue #33
    Nuevo diseño para conector de Amphenol
2023-02-20 codigo de testeo para la fase de produccion version 1
2023-02-24 Version 2 de los codigos de verificacion de placas DCDC y CPU
2023-02-24 Cierra el issue #38
    Pin de VO+ desplazado
    [POGO_DCDC.brd]
2023-03-06 Funcion de Debugg
2023-03-06 Correccion de la limpieza de la superficie de la pantalla correspondiente al voltaje.
2023-03-06 Test Mode. Actualizacion de la EEPROM
2023-03-17 Ajuste del umbral de la proteccion de cortocircuito
    tras realizar una serie de pruebas se decide bajar de 3A a 1,9A.
    Al realizar un corto franco se observa que la batería mide cerca de 2A.
2023-03-17 Cambio en el formateo de VScode
2023-03-17 Ajuste del modo test.
    - Corrección de la salida del modo test para que todos los flags tengan el valor correcto.
    - Se añade comprobación del sensado de corriente y voltaje por pantalla,
    - Modificación de las velocidades de los trenes de pulso del Enable y del OP swtich.
    [B2.ino]
2023-03-17 Separacion de los diagramas por versiones.
2023-03-17 Cambio de nombre de la Bom del sistema
    [BOM del Sistema ROVER.xlsx, BOM del Sistema.xlsx]
2023-03-17 Release de los sistemas de testeo
2023-03-17 Actualizacion parcial de librerias
2023-03-17 documentación de Testeo
    [Arranque en corriente.xlsx]
2023-03-17 Auto stash before rebase of "refs/heads/develop"
    [BATT_CPU.brd]
2023-03-17 Deteccion del tipo de reset
    [B2.ino]
2023-03-21 Cambio de dinamico a fijo los valores de sensado druante el test
    Para poder realizar un logeo claro y sencillo se decide que una vez se realice la verificación, el valor se quede estático.
    Adicionalmente se aumentan las variables de uint16 a uin32 para evitar el rebosamiento durante la verificación.
2023-03-21 Close #45
    Se detecta el fallo al intentar comunicarse por I2C con la pantalla cuando esta no esta correctamente alimentada tras el despertar.
    Se incluye una inicialización al despertar.
    [B2.ino]
2023-03-21 Variables de Estado del WDT metiedas en EEPROM.
    Asistencia según el tipo de reset que sufre el sistema.
    Logeo de la variables relacionadas con el WDT en EEPROM.
    [B2.ino]
2023-03-22 Incorporacion de carpeta GFX modificada
2023-04-10 Ajuste de la posicion del numeo de serie en memoria
2023-04-11 Modificacion Conector Jack #37
    [PCB_JACK.brd, PCB_JACK.sch]
2023-04-12 Close #37
    [PCB_JACK.brd]
2023-04-13 Ajuste del incremento del modo boost
    Se decide ajustar a 0.3v el aumento que supone el modo boost.
    La linea de tensión en mas corta que en la MK y por tanto no es necesario un incremento tan grane
2023-04-17 Ajuste de formating
2023-04-17 Ajuste del WachtDog en el Naming
2023-04-25 Correccion protecciones close#44
    Se decide modificar el funcionamiento de las protecciones para ajustar al ciclo de programa y controlar los tiempos desde la construcción del Health Monitor exclusivamente.
2023-04-25 Libreria de Memoria RAM
2023-04-25 Ajuste del Logeo de Post mortem
    Se incluye el logue del power use y del Vin use.
    Además de arreglar el logeo del Work time y ajustar los tiempos de logeo cada 5 min del aviso del Low battery, al cual se le crea un contador separado.
    [B2.ino]
2023-04-25 Inclusion del puerto serie en alguos puntos
    Se cierra el puerto serie para agilizar el ciclo de programa
2023-04-25 Adicion de comentarios para clarificar el codigo.
2023-05-02 Cambio del control de tiempo de activacion del LOW BATT
2023-05-05 Close #55
    Solucion del error por Undervoltage.
    [B2.ino]
2023-05-16 Introducción de Supervisor de tensión con control de RESET 2,63.
    [BATT_CPU.brd, BATT_CPU.sch]
2023-05-16 Inclusion de Tests Pads
    [BATT_CPU.brd, BATT_CPU.sch]
2023-05-16 DRC Changes
    [BATT_CPU.brd]
2023-05-16 Serigrafia de version 3
    [BATT_CPU.brd, BATT_CPU.sch]
2023-05-16 Separacion de las vias de la zona de cobre descubierto en la resistencia de sensado
    [BATT_DCDC.brd]
2023-05-16 Actualizacion BOM v6
    [BATT_CPU.xlsx]
2023-05-16 Cambio en el encapsulado de 4 Resistencias para evitar que salten en el soldado.
    [BATT_DCDC.xlsx]
2023-05-16 Produccion 2 - Mecanica
    Actualizacion de la ficheros de mecanica para la segunda produccion
    [Barril v6.step, CLIP THUNDER INCL-1.stp, CLIP THUNDER INCL-2.stp, CLIP THUNDER INCL-3.stp, Clip Dankubin v2.step, Copa rca v5.step, EX-RV1K-14_v6 COPA 3.5.stp, boton rojo bateria v1.stp]
2023-05-16 ficheros GERBER de primer pedido (no salieron buenos)
    solo a 1 cara
    taladros demasiado grandes
2023-05-17 v7
    Issue #49, #59, #60 y #63
    [BATT_CPU.xlsx]
2023-05-17 Cierra issue #63 #59 #49 #32 #60
    [BATT_CPU.brd, BATT_CPU.sch]
2023-05-17 Cierra el issue #65
    Algunos cambios menores de rutado
    [BATT_DCDC.brd, BATT_DCDC.sch]
2023-05-18 SETI Batch_2
    Generacion de GERBER
    Generacion de MOUNTSMD Files
    [BATT_CPU.brd, BATT_CPU.sch]
2023-05-18 MOUNTSMD generado
2023-05-18 fichero movido a GERBER directory
2023-05-18 Se cambia el nombre de IC1 a U2 para el supervisor de tension (conforme a PCB)
    [BATT_CPU.xlsx]
2023-05-18 HISTORY updated
    [BATT_CPU.xlsx]
2023-05-18 Se crea el folder de PRODUCCION
    para tener identificado todos los ficheros enviados a proveedores y fabricantes
    [BATT_CONNECTOR.brd, BATT_CONNECTOR.sch, BATT_CONNECTOR.xlsx, BATT_CPU.brd, BATT_CPU.sch, BATT_CPU.xlsx, BATT_DCDC.brd, BATT_DCDC.sch]
2023-05-18 closes issue #61
    [Overlay v6.step, overlay v6.dxf]
2023-06-01 Fix Errors.
    Errores en los condensadores. C2 por C6.
    Errores en R20 y R21. Los valores estaban intercambiados.
    [BATT_CPU.xlsx]
2023-06-01 Inclusión de un sustitutivo del transistor de salida del DCDC
    #66
    [BATT_DCDC.xlsx]
2023-06-01 Diseño Clipcord PCB
    [Clipcord BOT.brd, Clipcord BOT.sch, Clipcord TOP.brd, Clipcord TOP.sch, clipcord.dxf]
2023-06-01 Tabla potencia-tiempo
    [Tabla potencia-tiempo.xlsx]
2023-06-20 Close #67. Post Mortem ajuste de Vout y Sensado en error
    [B2.ino]
2023-06-22 Correcion de la granularidad del power use
2023-06-30 Documentacion averias y Documentos tecnicos
    [Tabla potencia-tiempo.xlsx, Volcaldo de eeprom Trendy.csv]
2023-08-02 Ajuste de tiempos del test DCDC
2023-08-02 Diseño Dan Kubin version inicial
    [BATT_CONNECTOR INVERSOR.brd, BATT_CONNECTOR INVERSOR.sch, BATT_CONNECTOR.brd, BATT_CONNECTOR.dxf, BATT_CONNECTOR.sch, Clipcord TOP.brd]
2023-08-02 Correccion condensadores del LDO de entrada a 10uF. C6 y C8
    [BATT_CPU.brd, BATT_CPU.sch]
2023-08-03 Fix values en Test DCDC
    Ajuste de los valores de verificacion de corriente en el Test 3 de la DCDC
    [VerificacionProduccion.ino]
2023-08-21 primera version para DanKubin model - pedido a PCBWAY
    [BATT_CONNECTOR INVERSOR.brd, BATT_CONNECTOR INVERSOR.sch, Clip dankubin v1.step, Clipcord BOT.brd, Clipcord BOT.sch, Clipcord TOP.brd, Clipcord TOP.sch, Test Bench.brd]
2023-08-21 primera version
    [Util tapa v2.2.stl]
2023-08-21 Enviado a Adam Darklord
    Util para post o para demostraciones
2023-08-21 Primera version - Pedido a PCBWAY
    [PCB Connector UNIVERSAL.brd, PCB_ANILLO.brd, PCB_ANILLO.sch, PCB_GATO.brd, PCB_GATO.sch]
2023-08-24 se cambia la forma exterior (WIP)
    No esta terminado
    [Clipcord BOT.brd, Clipcord BOT.dxf]
2023-08-24 v2. Revisada.
    [Clipcord BOT.brd, Clipcord TOP.brd, Clipcord TOP.sch]
2023-08-25 Placa de Conexiones DCDC Pogo v2 + Placas Pinza
    [BATT_PINZA_DCDC_bot.brd, BATT_PINZA_DCDC_bot.dxf, BATT_PINZA_DCDC_bot.sch, BATT_PINZA_DCDC_mid.brd, BATT_PINZA_DCDC_mid.sch, BATT_PINZA_DCDC_top.brd, BATT_PINZA_DCDC_top.dxf, BATT_PINZA_DCDC_top.sch]
2023-08-25 PCBs Testbench DK Motor+Optos
    [Motor PPN7PA12C1 Test bench.brd, Motor PPN7PA12C1 Test bench.sch, Opto Testbench.brd, Opto Testbench.sch]
2023-09-02 Pedido PCBWAY - 1er pedido
2023-09-05 Cambios en libreria DCDC y adaptacion del codigo B2 al uso de PWM
    Se incluyen las carpetas de testeo y de codigos de ejemplo. Ademas de la libreria usada
2023-09-11 Issue #72
    [BATT_CPU.brd, BATT_CPU.sch, BATT_CPU.xlsx, BATT_DCDC.brd, BATT_DCDC.sch, BATT_DCDC.xlsx]
2023-09-19 Issue #73
    [BATT_CPU.brd, BATT_CPU.sch]
2023-09-19 Cambio del Nitro.
    El nitro por encima de 5v es una escalera hasta 4 voltios por encima del voltaje objetivo.
2023-09-19 Modificacion del Clipcord 3
    [Clipcord BOT.brd, clipcord finger v3.dxf]
2023-09-20 Commit anused PIN.
2023-09-20 Actualizacion de version de integracion
2023-09-20 Adaptacion placa CONECTORES a Universal
    [BATT_CONNECTOR.brd]
2023-09-21 Cambios menores antes de pedido
    [Clipcord BOT.brd]
2023-09-21 Issue #73. Generalizacion de la tarjeta CPU a todo el proyecto
    [BATT_CPU.brd, BATT_CPU.sch]
2023-09-21 Cambios menores antes de pedido + GERBER
    [BATT_CONNECTOR.brd]
2023-09-21 Creacion de la carpeta SW Low voltaje
2023-09-21 Cambios menores en esquematico
    Se corrigen valores de Resistencias para PWM
    Actualizado el titulo del esquematico
    Limpieza general
    [BATT_CPU.sch]
2023-09-21 GERBER para pedido SETI
2023-09-21 Se corrige señal IN a VSOURCE para que funcione como negador
    Se mueven algunos componentes para que no se solapen.
    [BATT_DCDC.brd, BATT_DCDC.sch]
2023-09-22 Adpatacion DCDC para compatibilidad.
    Adaptacion para compatibilidad de version standard y version Low Voltage.
2023-09-25 Revisión BOM previa envio SETI
    [BATT_CPU.xlsx, BATT_DCDC.xlsx]
2023-09-26 Fix error
    Solucion de inconsistencia de valores entre el BRD y el SCH
    [BATT_CPU.brd, BATT_CPU.sch]
2023-09-26 Revision previa a envio SETI produccion 3
    Se actualiza la columna de "NEW" que indica a SETI cambios en posiciones
    [BATT_CPU.xlsx]
2023-09-26 Revision antes de enviar a SETI 3ra produccion
    Se actuliza la columna NEW
    [BATT_DCDC.xlsx]
2023-09-26 Revision antes de 3ra produccion SETI
    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
    [BATT_CONNECTOR.xlsx]
2023-09-26 Revision antes de envio SETI 3ra produccion - SEP-23
    [BATT_DCDC.brd, BATT_DCDC.sch]
2023-09-26 Se generan ficheros de produccion para 3ra produccion SETI
    [BATT_CONNECTOR.brd, BATT_CONNECTOR.sch, BATT_CONNECTOR.xlsx, BATT_CPU.brd, BATT_CPU.sch, BATT_CPU.xlsx, BATT_DCDC.brd, BATT_DCDC.sch]
2023-09-26 Cambio de diseño de las placas de la univerasl
    v2
    [PCB_ANILLO.brd, PCB_ANILLO.dxf, PCB_ANILLO.sch, pcb pogo.brd]
2023-09-26 Ajuste del ancho del orificio del pogo
    [pcb pogo.brd]
2023-09-29 Se mueve el taladro del pin mas cerca del borde
    Se mueve el taladro del pin mas cerca del borde tras las pruebas en Intattoo Veritas porque se comprueba que para algunas máquinas de bobinas el agujero esta tan cerca del chasis que toca
    [Clipcord BOT.brd]
2023-09-29 Modificaciones en area de soldadura para que haya mas superficie (WIP)
    [pcb pogo.brd]
2023-09-29 Activacion del Nitro Por defecto
    [pcb pogo.brd]
2023-09-29 Revert "Activacion del Nitro Por defecto"
    This reverts commit 9dda1e81689fddb32595ea665b642b7bc7b6e64d.
    [pcb pogo.brd]
2023-10-02 Modificacion v3 Pogo pin universal
    [pcb pogo.brd]
2023-10-04 Modificacion de tStop y centrado.
    [PCB_ANILLO.brd]
2023-10-04 Produccion de GERBER para pedido JLCPCB W202310041757817
2023-10-17 Modificacion DCDC y Conector
    DCDC: Posible version exclusiva PMU
    Conector: Adatacion a cambio en produccion de un componente (SMJ)
    [BATT_CONNECTOR.brd, BATT_CONNECTOR.sch, BATT_DCDC.brd, BATT_DCDC.sch]
2023-10-25 Ajustes PCBs
    Cambio en el pcb de cheyenne para que entre en el adapatador de la universal.
    Cambio en el pcb del pogo para que se ajuste mejor a los adaptadores de la universal
    [PCB_JACK.brd, pcb pogo.brd]
2023-10-27 generacion de GERBER para pedido JLCPCB
2023-10-27 Retoque antes de generacion de GERBER para pedido JLCPCB
    Se apartan pistas del borde del PCB para alejarlas del labio de aluminio en mecanica
    [pcb_ala_pogo.brd]
2023-10-31 Version Low Voltage v1
2023-11-09 Correccion errores e inclusion Fiducial Marks en DCDC
    Se divide en 2 la RBalastro.
    Recolocación a parte superior.
    Inclusión 2 fiduciales en la parte del botom
    [BATT_DCDC.brd, BATT_DCDC.sch]
2023-11-09 Actualizacion de la BOM
    Esquema de resistencia de balastro,
    [BATT_DCDC.xlsx]
2023-11-15 Adiccion de Fiducidiales y actualizacion de Version
    [BATT_CONNECTOR.brd, BATT_CONNECTOR.sch, BATT_CPU.brd, BATT_CPU.sch, BATT_DCDC.brd, BATT_DCDC.sch]
2023-11-15 Revision y GERBER antes de enviar a SETI
    Ficheros para produccion 4ª de SETI (Dan Kubin y PMU compatible
    [BATT_CONNECTOR.brd, BATT_CONNECTOR.sch, BATT_CONNECTOR.xlsx, BATT_CPU.brd, BATT_CPU.sch, BATT_CPU.xlsx, BATT_DCDC.brd, BATT_DCDC.sch]
2023-11-16 Inclusion de la feature configuracion de nitro en la version Low Voltage
2023-11-16 Ajuste Array Velocidades
    Se adapta el array de velocidades para meter incrementos reales de velocidad en cada decimal de voltaje.
    Ajustes decrimento en 3,6 para abajo e incrmentales en 4,9.
2023-11-16 Inicio de version
2023-11-16 Ignore la carpte build
2023-11-16 Se deja de trackear esta carpeta
2023-11-16 Carpeta con proyecto Flash para desarrollo
2023-11-16 Correcion estado inicial nitro
    Se independiza la libreria diagnostic del modelo a compilar.
    Desde el main se controla el estado inicial del nitro segun el modelo.
2023-11-22 Listado pruebas regresion ante cambios menores de version
2023-11-22 Actualización de Gitignore
2023-11-22 Fix errors
    Cambios para facilitar el uso del script para comprobaciones del PWM.
    [PWMtest.ino]
2024-01-29 1º Version Rampas mejora de arranque
    Se introduce una rampa para el arrancado cuando el nitro esta desactivado
2024-01-29 Eliminacion del GAP de arranque cuando el nitro esta desactivado
2024-01-29 Fix error
    Por el desarrollo del ciclo de programa, ocurria que la salida se activaba con el voltaje deseado antes de que se realizara el arranque.
    [B2-LowVoltaje.ino]
2024-01-29 Raw Batterie Voltage step
    Paso inicial en el que el voltaje de salida es igual al voltaje de la celda durante 130 ms.
2024-01-30 Excel de control de Versiones de Sistema
    [Control de versiones de Sistema.xlsx]
2024-01-30 Fuera gap timer y espera previa al arrancado
2024-01-30 Integracion rampa de arrancado Sin Nitro
2024-01-30 Fix Errors
    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
    [B2.ino]
2024-01-30 Correcion de espaciados
2024-01-30 Versiones 3040 y 3004
    [Control de versiones de Sistema.xlsx]
2024-01-30 Documento de cambios de version 1.2.2
2024-01-30 Nomenclatura de versiones
    [BATT_CONNECTOR.sch, BATT_DCDC.xlsx, BATT_FLEX11.sch]
2024-02-07 Modulacion del voltaje de salida por Duty y por Voltaje
2024-02-08 Documento de control de compatibilidades
2024-02-09 v1PCB Adaptador Fk Irons
    [PCB_FK_CONN.brd, pcb fk v1.dxf]
2024-02-13 Version inicial de la 2º iteracion del clipcord
    [Clipcord v2.brd]
2024-02-13 Cierra issue #74
    Modificaciones para que el estaño no fluya por las vias a la cara vista
    [PCB_ANILLO.brd]
2024-02-16 Modificación de la dimension del PCB
    version 2
    [Clipcord v2.brd]
2024-02-16 Cambios en serigrafia
    [Clipcord v2.brd]
2024-02-27 Pedido y actualizacion
    [Barril v6.2(ERRONEO).step, Clipcord TOP.brd, PCB_FK_CONN.brd, overlay_pogo.brd, pcb gato.dxf]
2024-02-27 Modificaciones para solucionar issue #75 (WIP)
    Todavia pendiente de hacer mas cambios
    [pcb pogo.brd, pcb pogo.dxf]
2024-02-27 close issue #75
    [Clipcord v2.brd, pcb pogo.brd]
2024-02-27 ajuste y separacion de los taladros de soldadura
    [PCB_JACK.brd]
2024-02-29 Cierra issue #76 - Listo para pedido a PCBWAY
    Mejoras para que no toque con mecanica
    Mejora para evitar que se desuelden los cables por calentamiento del conecgtor
    [PCB_JACK.brd]
2024-02-29 Cambios menores antes de hacer pedido a PCBWAY
    250 uds
    [pcb pogo.brd]
2024-03-14 Issue #77
    [pcb pogo.brd]
2024-04-08 gitflow-feature-stash: CheyenneStep
    [Log Spreadsheet.csv, NumberSerial.csv]
2024-04-10 hotfix naming Close Issue #78
    Se actualizan los valores residuales de la funcion naming en las librerias de diagnostic y EEPROM_LUT
2024-04-10 Actualizacion de la version por el hotfix
2024-04-10 volcado de memoria en inerscion de pila
2024-04-10 Creacion de Version independiente de la RCA
    Se incluyen los cambios necesario para compatibilidad con la Solnova 2.0.
    Fork de la versión 122 de la RCA.
2024-04-10 Eliminacion temporal del Watchdog de todas las versiones y de todas las librerias
    Quedan supeditadas a una variables de definicion.
2024-04-10 Cambio de nombre del archivo B2 a B2-RCA
    Debido a la diferenciacion de los cambios con la version Cheyenne se generan separacion de versiones
2024-04-17 Sketch testeo de PWM, Duty y Voltaje de la PWM para PMU
2024-04-17 Documentos de Calibracion del DCDC con el DAC
    [Calibracion DAC.xlsx, DCDC Digital control DAC.xlsx]
2024-04-29 Cambios en las ressitencias R15 y R20 a 10Ohm
    [BATT_DCDC.brd, BATT_DCDC.sch, BATT_DCDC.xlsx]
2024-05-13 Cambio en el sistema de nomenclatura de versiones
    [Control de versiones de Sistema.xlsx]
2024-05-13 Correccion error en celda de version
    [BATT_CPU.xlsx]
2024-05-13 Sustitucion de B2 por B2-RCA
2024-05-17 Clipcord M v3. Cambio de nomclatura
    Se modifica la nomclatura para adecuarla a la paricion del Modelo L. mismo concepto pero mas grande
    [Clipcord M.brd]
2024-05-17 Clipcord L v1. Creacion
    Creacion del modelo de clipcord para el modelo L. Heredado de la version 2 del modelo M
    [Clipcord L.brd]
2024-05-17 Fix Error.
    La variable al ser de 8 bits, no se podían almacenar versiones por encima de 256.
2024-05-17 Actualizacion de Versiones
    [Control de versiones de Sistema.xlsx]
2024-05-28 Issue #82
    [BATT_DCDC.brd, BATT_DCDC.sch, BATT_DCDC.xlsx]
2024-05-28 Actualizacion de version
    [Control de versiones de Sistema.xlsx]
2024-05-29 Fix Error. Si daba Empt bateris no se podia apagar manualmente
    [B2-Cheyenne.ino, B2-LowVoltaje.ino, B2-RCA.ino]
2024-05-29 Version de Sistema Actualizada
    [Control de versiones de Sistema.xlsx]
2024-06-05 Revert "Merge pull request #84 from MSTKMAD/develop"
    This reverts commit 96fc117d3460fb5d771273194348358b85af1598, reversing
    changes made to 9bb4215ab554844daf6eea25f914757804df500a.
    [BATT_CPU.xlsx, Clipcord L.brd, Clipcord v2.brd]
2024-06-05 Actualizacion de Contro de versiones
    [Control de versiones de Sistema.xlsx]
2024-06-17 Connector Version named in HW
    [BATT_CONNECTOR.brd]
2024-07-22 Adiccion del control de software a produccion
    [Compatibilidad Producciones.xlsx, Control de versiones de Sistema.xlsx]
2024-07-23 Reconocimiento de producciones HW de forma visual
2024-07-29 PCB FK DIANA v2. se estrecha un poco el pcb pasra entrar mejor en la mecanica
    [PCB_FK_CONN.brd]
2024-09-03 Conflicto en la atencion a error con el aviso de low battery, #85.
    [B2-LowVoltaje.ino]
2024-09-05 Version Inicial del Tester de Cables.
    [Testboard_Cables.brd, Testboard_Cables.sch]
2024-09-05 Salto del compardor en arranques de alguna maquinas. #86
    [BATT_CPU.brd, BATT_CPU.sch, BATT_CPU.xlsx]
2024-09-09 Conflicto en la atención a error con el aviso de low battery, #85
    [B2-Cheyenne.ino, B2-RCA.ino]
2024-09-09 Correccion de errores menores en los comentarios del texto y los interlineados de algunas lineas.
    [B2-Cheyenne.ino, B2-LowVoltaje.ino, B2-RCA.ino]
2024-09-09 MOSFET de Salida cerrado permanentemente #87.
    [BATT_CONNECTOR.brd, BATT_CONNECTOR.sch, BATT_CONNECTOR.xlsx, BATT_DCDC.brd, BATT_DCDC.sch, BATT_DCDC.xlsx]
2024-09-09 Version Retocada del tester de Cables
    [Testboard_Cables.brd, Testboard_Cables.sch]
2024-09-09 Fallo en el sensado de VIN antes del apagado.
2024-09-09 Ultimos cambios pre fabricacion Testboard Cables. GERBER
    [Testboard_Cables.brd]
2024-09-17 Connectores. Se añaden PADs para señales de comunicacion.
    [BATT_CONNECTOR.brd, BATT_CONNECTOR.sch, BATT_CONNECTOR.xlsx]
2024-09-17 Union de salidas digitales a SWD. CPU
    [BATT_CPU.brd, BATT_CPU.sch]
2024-09-17 Incorporacion de Resistencia pull up R21 en SWCLK
    [BATT_DCDC.brd, BATT_DCDC.sch, BATT_DCDC.xlsx]
2024-09-17 Se añaden 2 anillos mas
    [PCB_4_ANILLOS.brd, PCB_4_ANILLOS.sch, PCB_ANILLO.dxf]
2024-09-17 Se modifica el tamaño para adaptar a la mecanica mejor (mas pequeño)
    [PCB FK v5.dxf, PCB_FK_CONN.brd]
2024-09-17 Retrofit a valores de tamaños adecuados a la mecanica. POGO
    [pcb pogo.brd]
2024-09-17 Placa con 4 pines.v1
    [pcb pogo 4 pin.brd, pcb pogo.dxf]
2024-09-17 Close #85, Close #86, Close #85
    [Compatibilidad Producciones.xlsx, Control de versiones de Sistema.xlsx]
2024-09-23 Add C11 y R22.
    [BATT_DCDC.brd, BATT_DCDC.sch, BATT_DCDC.xlsx]
2024-09-23 Fix minor issues.
    [BATT_CONNECTOR.brd]
2024-09-23 Ajuste de control de versiones
    [Control de versiones de Sistema.xlsx]
2024-10-21 Actualiuzacion de Resistencias y Pedido a Seti
    [BATT_CONNECTOR.brd, BATT_CONNECTOR.sch, BATT_CONNECTOR.xlsx, BATT_CPU.brd, BATT_CPU.sch, BATT_CPU.xlsx, BATT_DCDC.brd, BATT_DCDC.sch]
2024-10-21 Codigo Verificacion de Test Cable
2024-11-20 Ajuste de Voltaje para trbajar por DCDC hasta 4v
2024-11-20 Ajuste DCDC para trbajar hasta 4v sin PWM
2024-11-20 Cambio para albergar Versiones por encima de 255
2024-11-20 Archivos de Testeo
2024-11-20 Calculo para DAC rango 4-12v
    [Calibracion DAC.xlsx]
2024-11-20 Hotfix BOM CPU
    [BATT_CPU.xlsx]
2025-02-10 Actualizacion salida de Modelo univerasal
    [Compatibilidad Producciones.xlsx]
2025-02-10 Prueba de concepto con señales data e ID
2025-02-12 Hot Fix Pull up DCDC, Fix Bom CPU
    Se incluyeron como futura feature. Dieron problemas de montaje y a la hora de testearse insitu. Se pasan a no montar.
    En la CPU se corrije un error por el que no aparecia R22 (pull-down Enable LDO)
    [BATT_DCDC.xlsx, Control de versiones de Sistema.xlsx]
2025-02-21 Genaracion de .fab para seti
    [BATT_DCDC.brd]
2025-02-24 Desactivacion del modo nitro por defecto en el modelo universal
    [Control de versiones de Sistema.xlsx]
2025-03-11 Version 1.0 con PID incluido y funcion
    Se activa solo con RUN, pero se adapta cuando se sube y baja el voltaje.
2025-03-13 universial pid version 2
2025-03-17 Version PID v3
    Añadido control visual de la barra de potencia como idicador de activacion del PID
2025-04-21 Correcion de la barra de potencia y modificacion del modo motherfucker
2025-04-21 Modificacion del estado por defecto del nitro en TODAS las versiones de ROVER
2025-05-09 Cambio de version del display del modo mthr fckr
2025-05-15 pid and Display Hz
    [Calibracion DAC.xlsx]
2025-07-24 Primera version enviada a PCBWAY
    [BATT_CONNECTOR.brd, BATT_CONNECTOR.sch, BATT_CPU.brd, BATT_CPU.sch, BATT_DCDC.brd, BATT_DCDC.sch, BATT_FLEX9.brd, BATT_FLEX9.sch]
2025-09-23 Diana de 3 pines
    [PCB diana 3pin.dxf]
2025-09-23 Cradle Venus
    [cradle_venus.brd, cradle_venus.csv, cradle_venus.sch, cradle_venus.xlsx]
2025-09-23 Pogo pin 3
    [PCB_3_POGOS.brd, PCB_3_POGOS.sch, pcb_3_pogopins.brd]
2025-09-29 Creacion del la version VantaBlack
2025-09-29 Cambios DCDC
    [BATT_DCDC.xlsx]
2025-09-29 Salida a produccion de VantaBlack v500
2025-09-29 Nueva Release
    [Control de versiones de Sistema.xlsx]
2025-09-29 VantaBlack Update
    [Control de versiones de Sistema.xlsx]
2025-10-06 Fix bug. Fallo displayHZ
    Se estaban mostrando los HZ correspondientes al motor de 9v, cuando la Vantablack lleva el motor de 6v.
2025-11-27 Codigo para generar un temporizador de 15 min
2025-11-27 Grip design v1
    [Grip-Mother.brd, Grip-Mother.sch]
2025-11-27 Cradle Design v1 y v2
    [PCB con leds CRADLE VENUS.dxf, cradle_venus.brd, cradle_venus.csv, cradle_venus.sch, cradle_venus.xlsx]
2025-11-27 schema de attiny16
2026-01-07 Update Repo
    [Arranque en corriente.xlsx, BATT_CONNECTOR INVERSOR.brd, BATT_CONNECTOR INVERSOR.sch, BATT_CONNECTOR.brd, BATT_CONNECTOR.dxf, BATT_CONNECTOR.sch, BOM del Sistema ROVER.xlsx, Calibracion DAC.xlsx]
2026-01-07 Gestion salida y opcion en menu
    SE importa la gestion del switch de salida del modelo DK.
    Ademas se añade el manejo del menu para tener 2 opcion. Queda pendiente decidir si meter flecha o no y la inclusion de la variable en la memoria EEPROM
2026-01-07 Inclusion Variable Low Voltage en EEPROM
    Se modifican las liubrerias correspondientes para incluir el estado del modo Low Voltage en EEPROM.
2026-01-14 Documentacion del Codigo de la Universal y Librerias principales
2026-01-14 Documentacion de codigo. RCA
2026-01-14 Documentacion Codigo. Low Voltage Dan Kubin
